Spark-Concepts/xPro-V5/images/Spark-Concepts-6.png

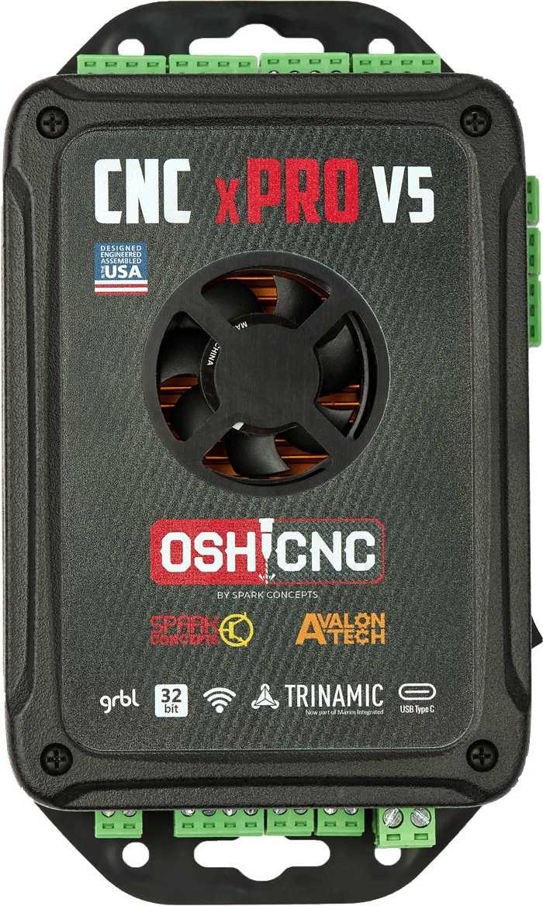
images/Spark-Concepts-6.png
