Spark-Concepts/xPro-V5/images/Hall_limits_wiring.jpg

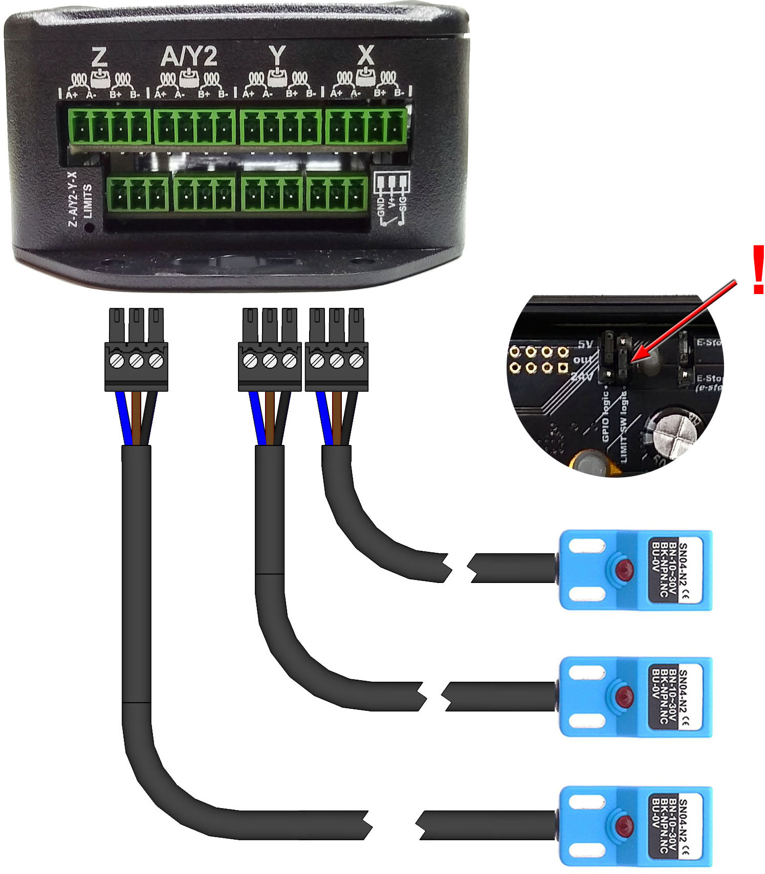
images/Hall_limits_wiring.jpg
