Spark-Concepts/xPro-V5/README.md

# xPro-V5
xPro-V5 CNC Motion Control System Documentation and User Information
theme: jekyll-theme-slate
