Spark-Concepts/xPro-V5/Firmware/Old Firmware/flash_download_tool/Programming ESP32 chip.pdf

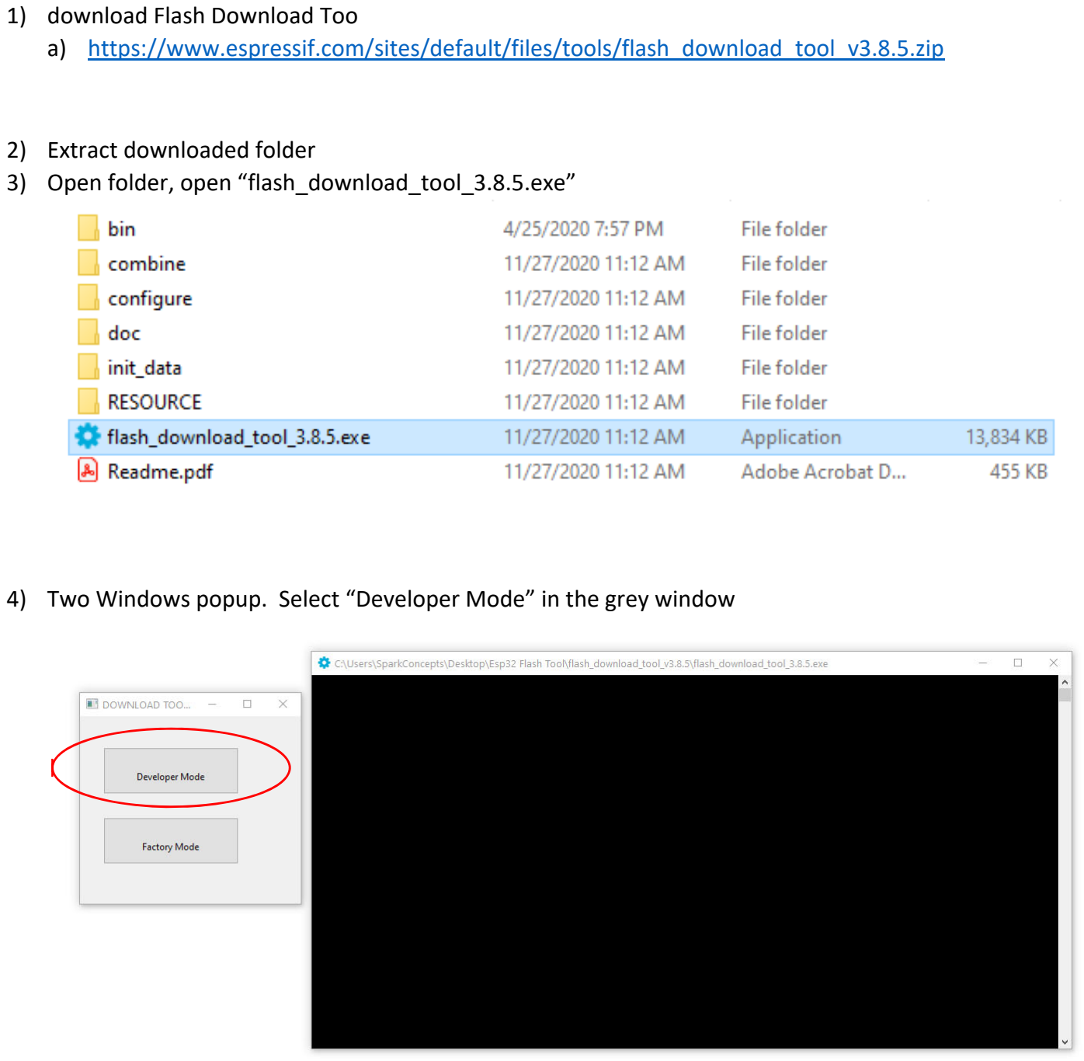
[picture p3: page 1]

1) download Flash Download Too
a) https://www.espressif.com/sites/default/files/tools/flash_download_tool_v3.8.5.zip
2) Extract downloaded folder
3) Open folder, open “flash_download_tool_3.8.5.exe”
4) Two Windows popup. Select “Developer Mode” in the grey window

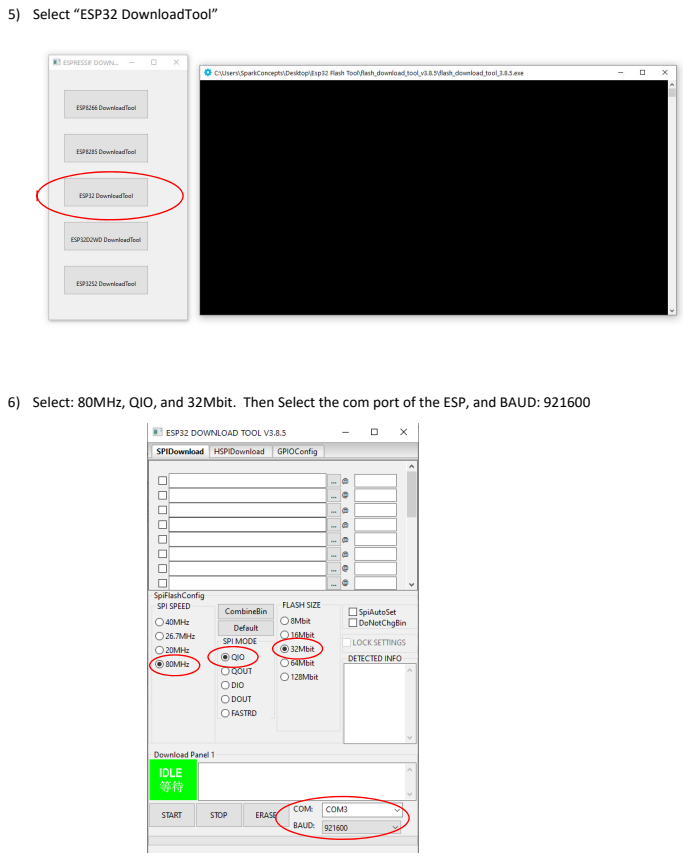
[picture p4: page 2]
5) Select “ESP32 DownloadTool”

6) Select: 80MHz, QIO, and 32Mbit. Then Select the com port of the ESP, and BAUD: 921600

7) Click the button shown here below and select the xPV5xyyz.bin file. Click on the empty field to the right of the @ sign and write 0. Make sure the check box next to the file name is marked, otherwise the file won’t be programmed.

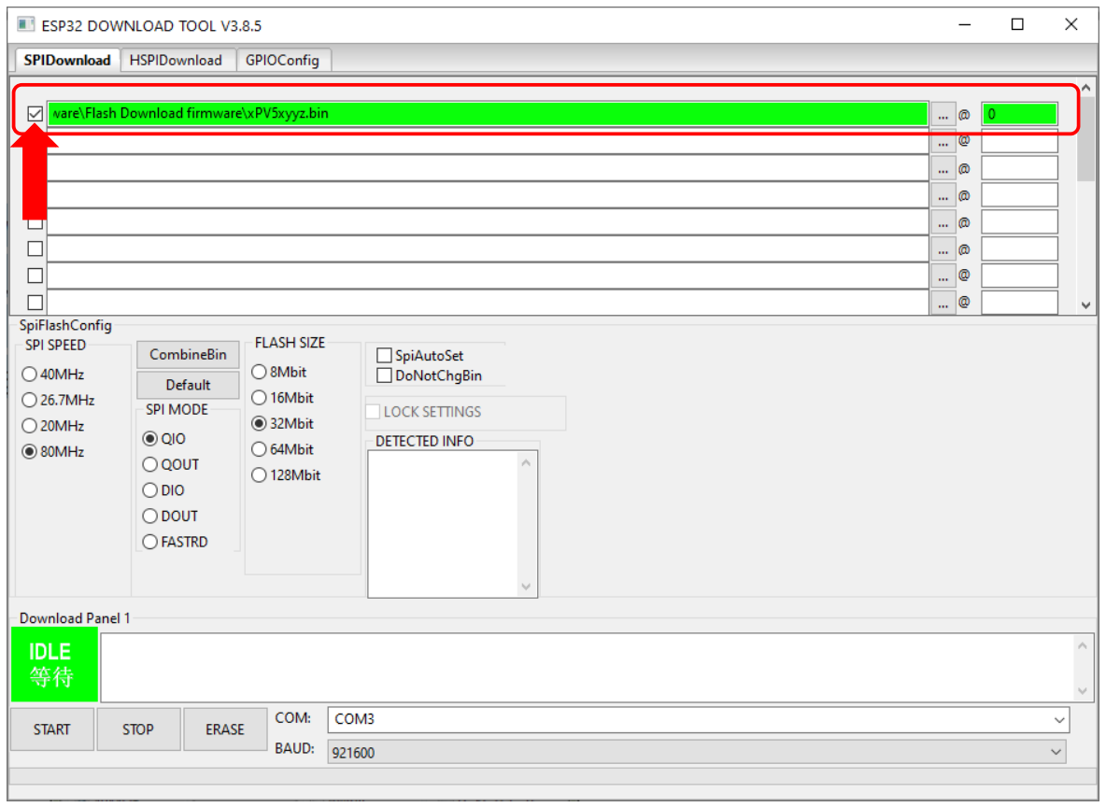
[picture p5: figure]
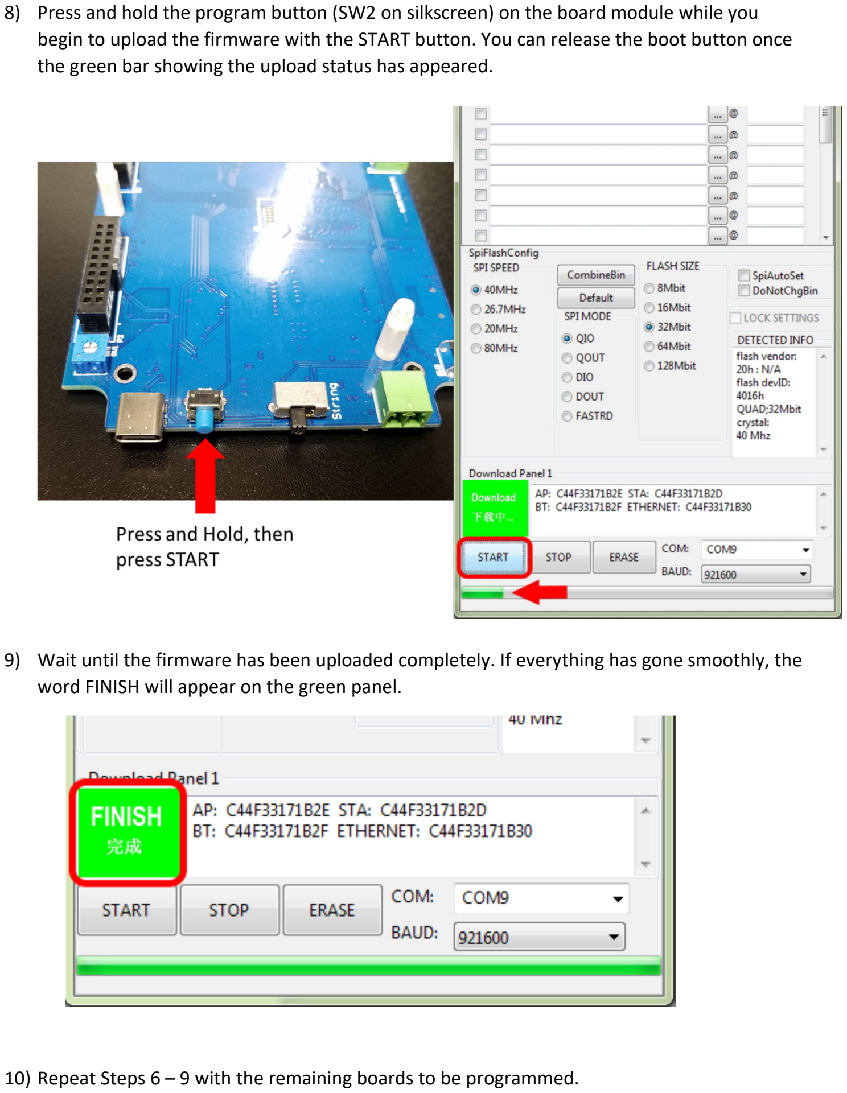
[picture p6: page 4]

8) Press and hold the program button (SW2 on silkscreen) on the board module while you begin to upload the firmware with the START button. You can release the boot button once the green bar showing the upload status has appeared.
9) Wait until the firmware has been uploaded completely. If everything has gone smoothly, the word FINISH will appear on the green panel.
10) Repeat Steps 6 – 9 with the remaining boards to be programmed.
