Spark-Concepts/xPro-V5/images/0-10v.jpg

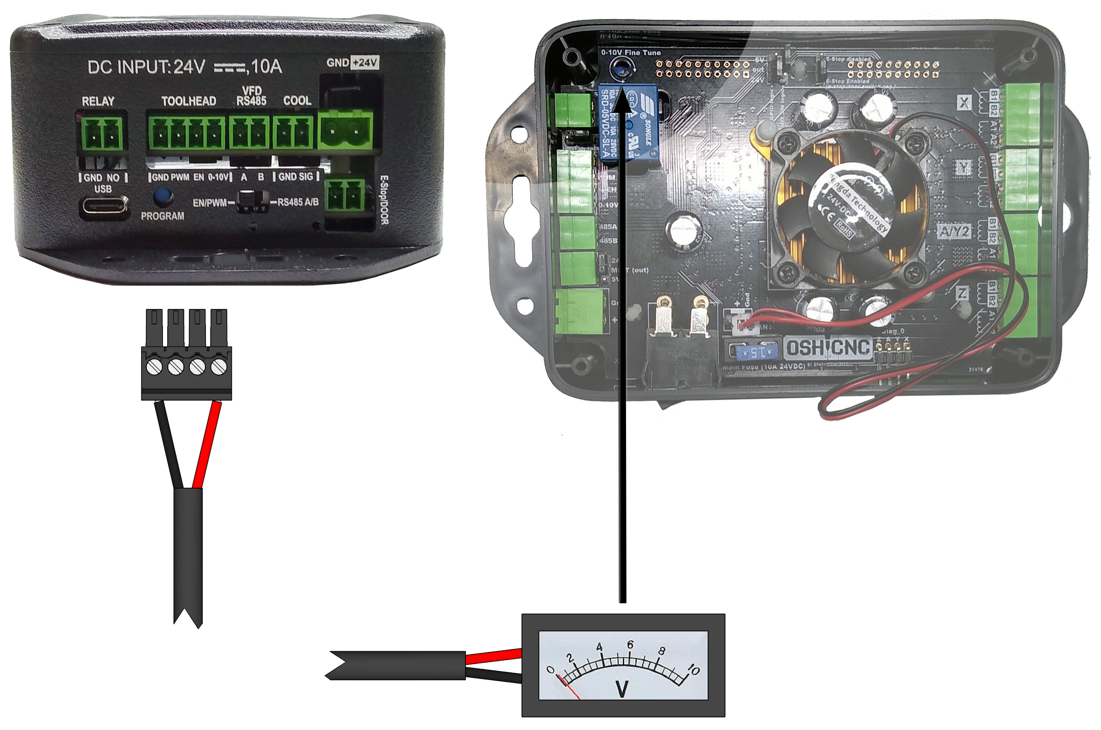
images/0-10v.jpg
