Spark-Concepts/xPro-V5/images/Analog_VFD.jpg

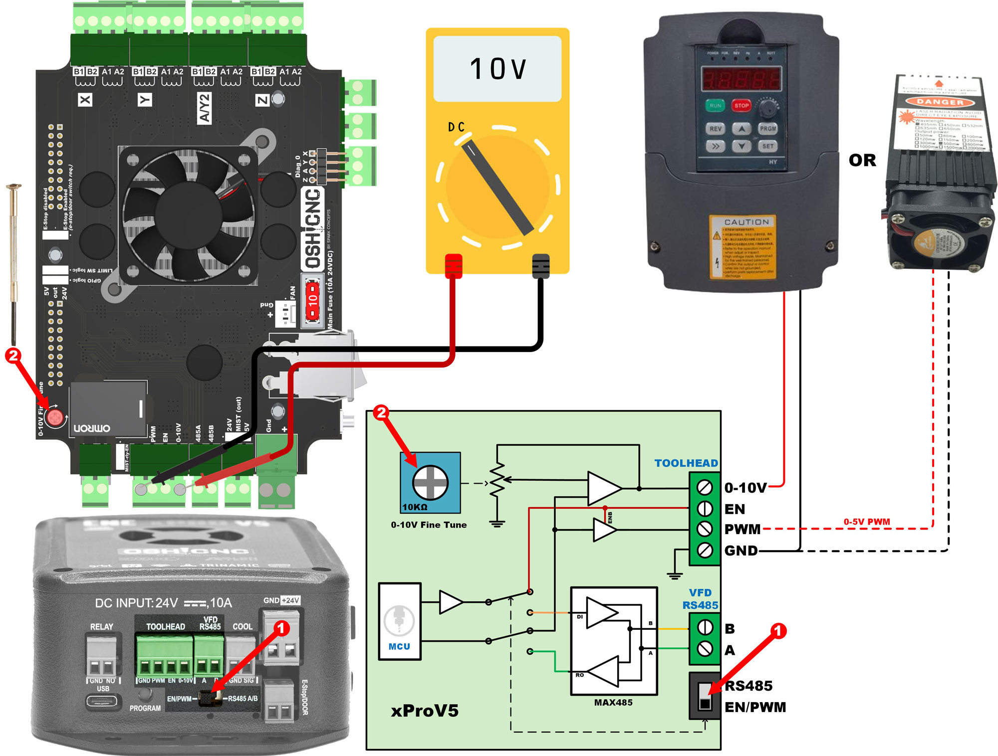
images/Analog_VFD.jpg
