Spark-Concepts/xPro-V5/images/BootlaoderMode.jpg

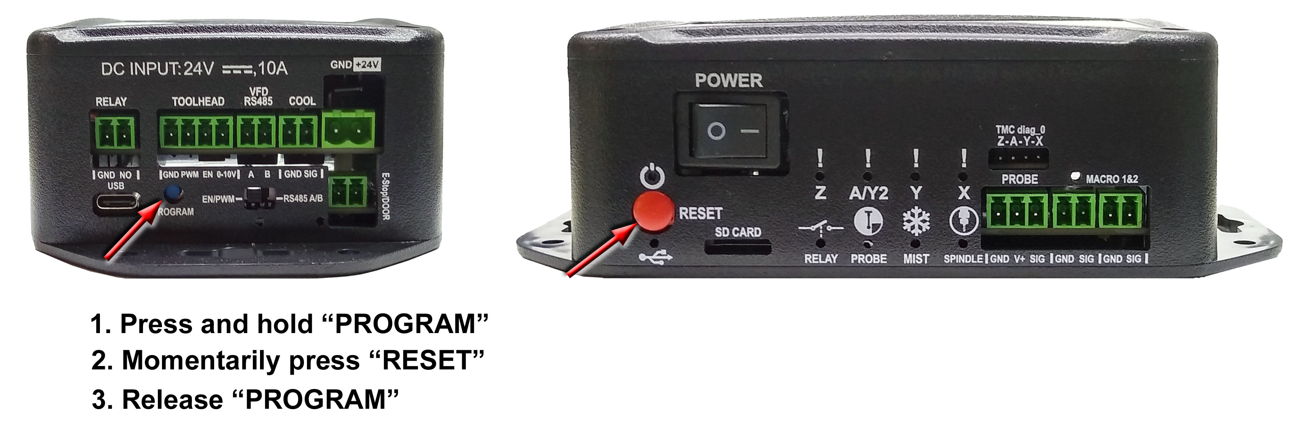
images/BootlaoderMode.jpg
