Spark-Concepts/xPro-V5/images/cncjs-overview-1.jpg

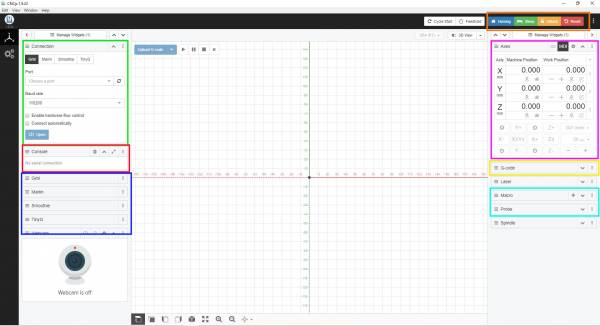
images/cncjs-overview-1.jpg
