Spark-Concepts/xPro-V5/images/cncjs_-_machine_sel.jpg

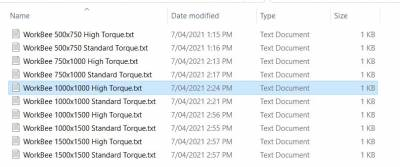
images/cncjs_-_machine_sel.jpg
