Spark-Concepts/xPro-V5/images/cncjs_-_widget_remove.jpg

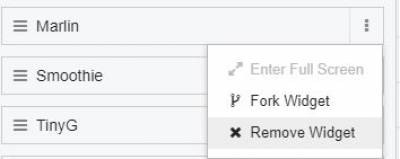
images/cncjs_-_widget_remove.jpg
