Spark-Concepts/xPro-V5/images/cncjs_-xpro-v5_master_config.jpg

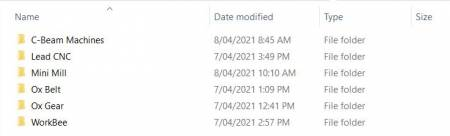
images/cncjs_-xpro-v5_master_config.jpg
