Spark-Concepts/xPro-V5/images/cncjs_connect_port.jpg

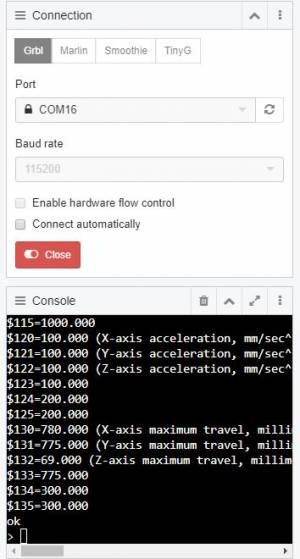
images/cncjs_connect_port.jpg
