Spark-Concepts/xPro-V5/images/cncjs_finish_macro.png

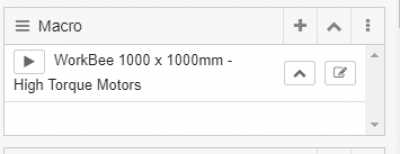
images/cncjs_finish_macro.png
