Spark-Concepts/xPro-V5/images/cncjs_refresh_port.jpg

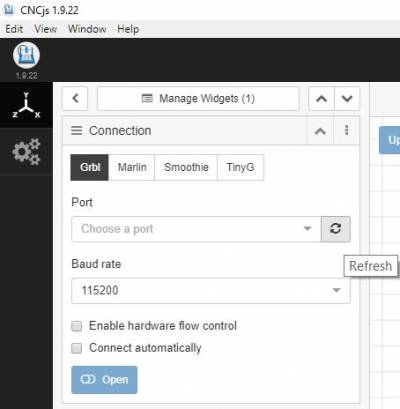
images/cncjs_refresh_port.jpg
