Spark-Concepts/xPro-V5/images/cncjs_run_macro.png

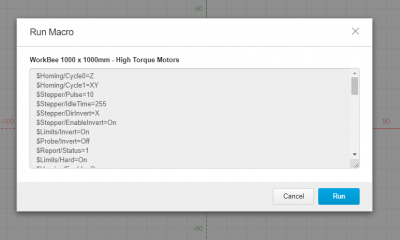
images/cncjs_run_macro.png
