Spark-Concepts/xPro-V5/images/cncjs_select_contents.png

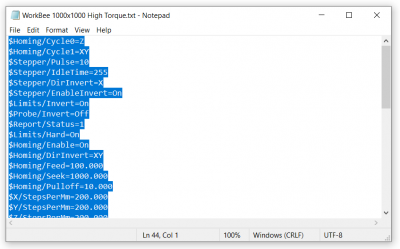
images/cncjs_select_contents.png
