Spark-Concepts/xPro-V5/images/cncjs_select_port.jpg

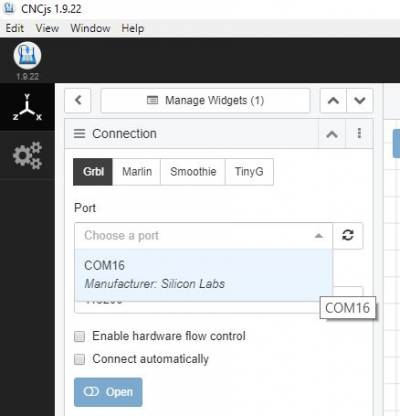
images/cncjs_select_port.jpg
