Spark-Concepts/xPro-V5/images/cncjs_successful_flash.png

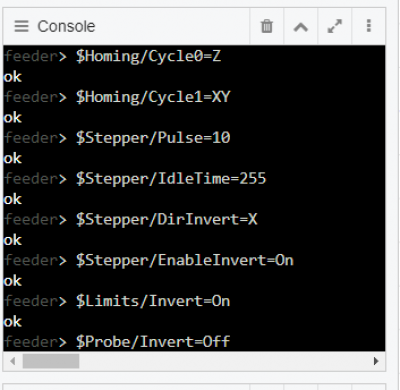
images/cncjs_successful_flash.png
