Spark-Concepts/xPro-V5/images/Cool_SS.jpg

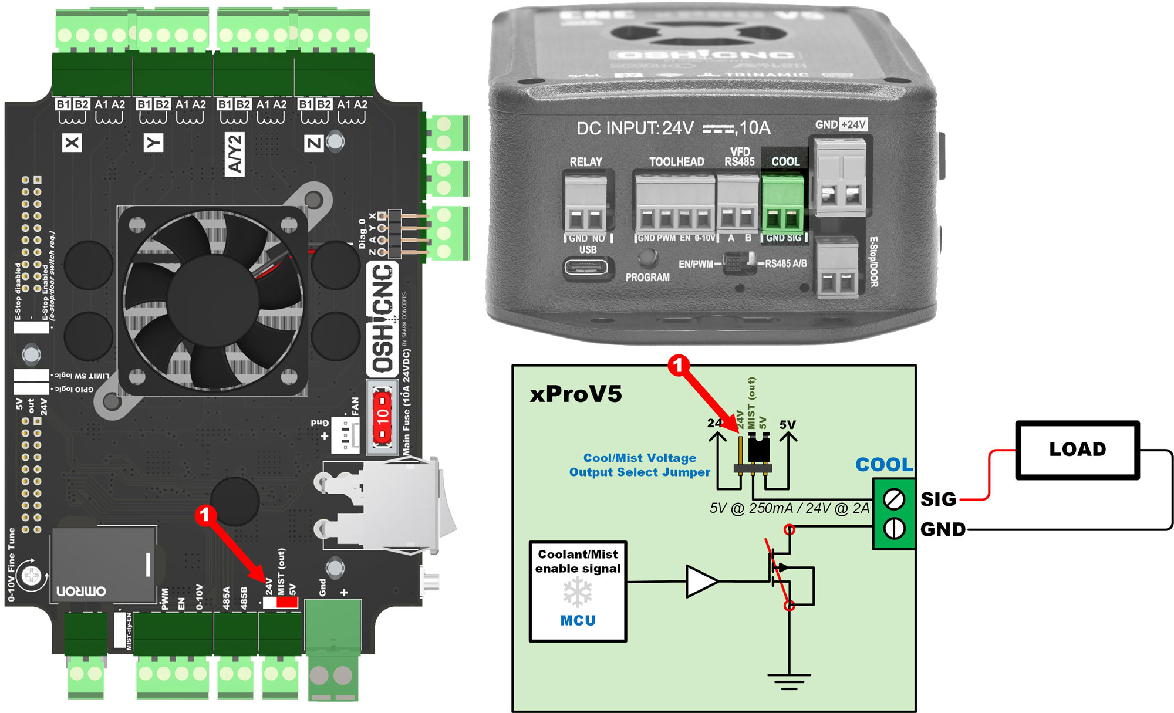
images/Cool_SS.jpg
