Spark-Concepts/xPro-V5/images/coolant-iot-vacuum.jpg

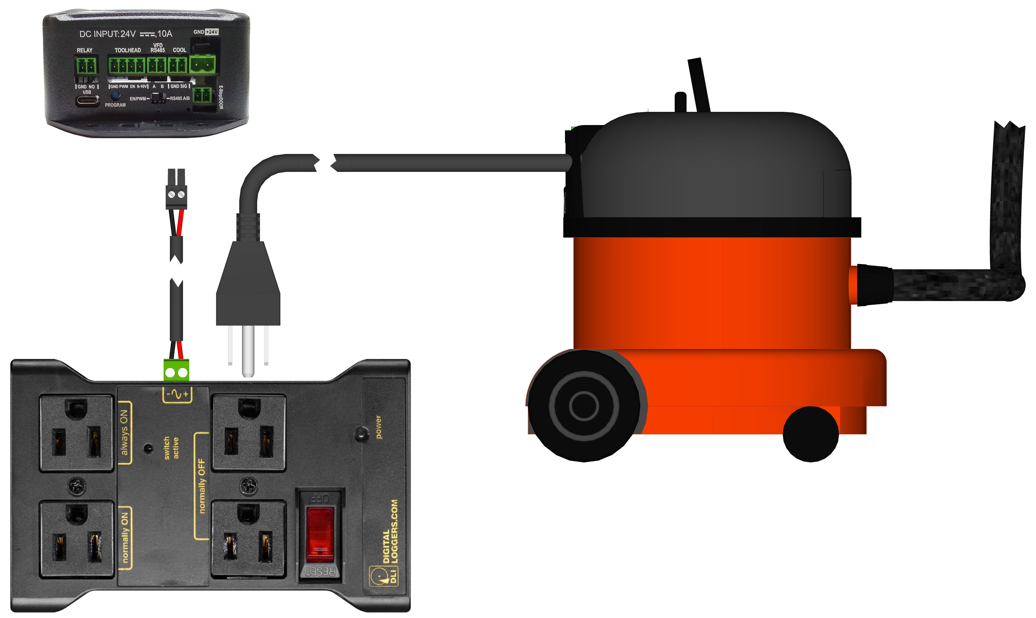
images/coolant-iot-vacuum.jpg
