Spark-Concepts/xPro-V5/images/coolant-led-ring.jpg

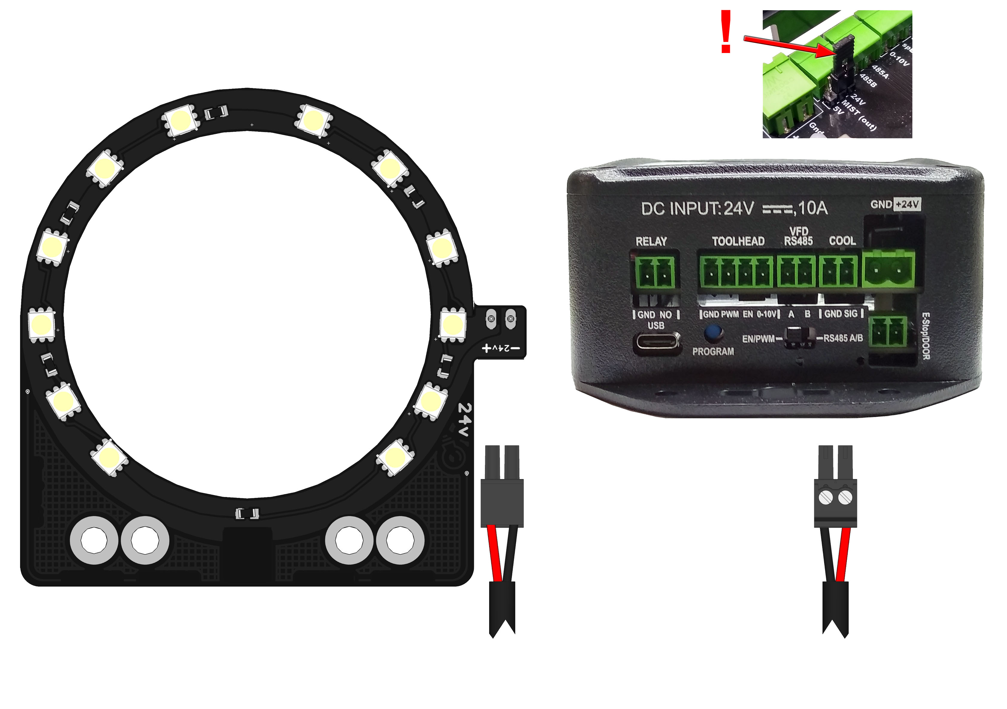
images/coolant-led-ring.jpg
