Spark-Concepts/xPro-V5/images/coolant-solenoid.jpg

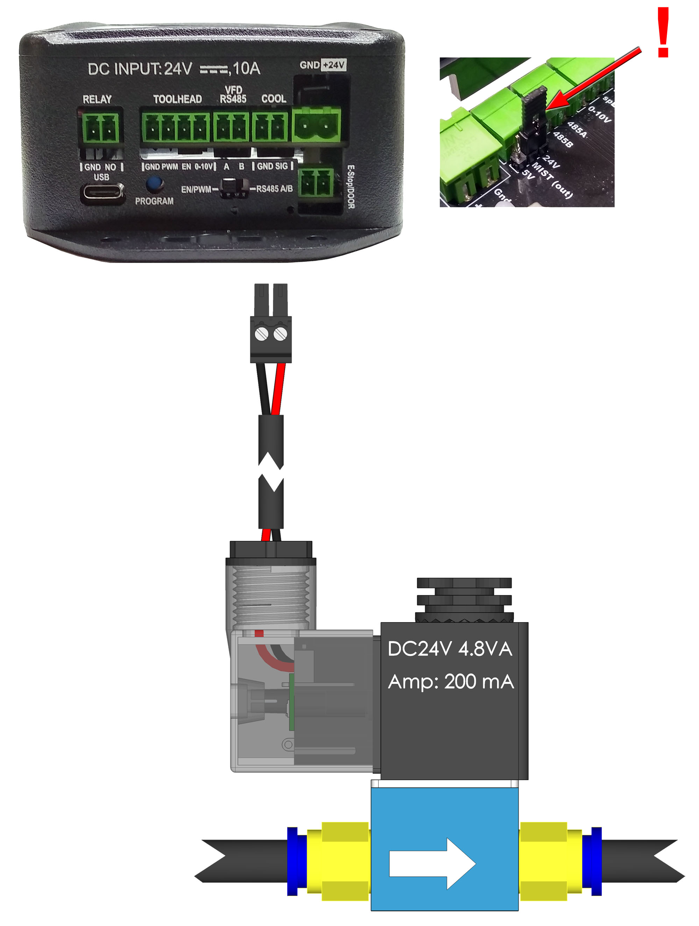
images/coolant-solenoid.jpg
