Spark-Concepts/xPro-V5/images/End copy.jpg

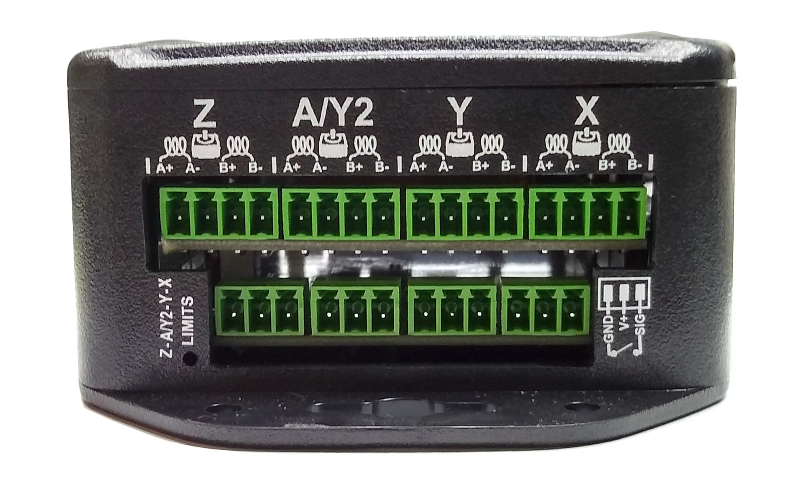
images/End copy.jpg
