Spark-Concepts/xPro-V5/images/Front copy.jpg

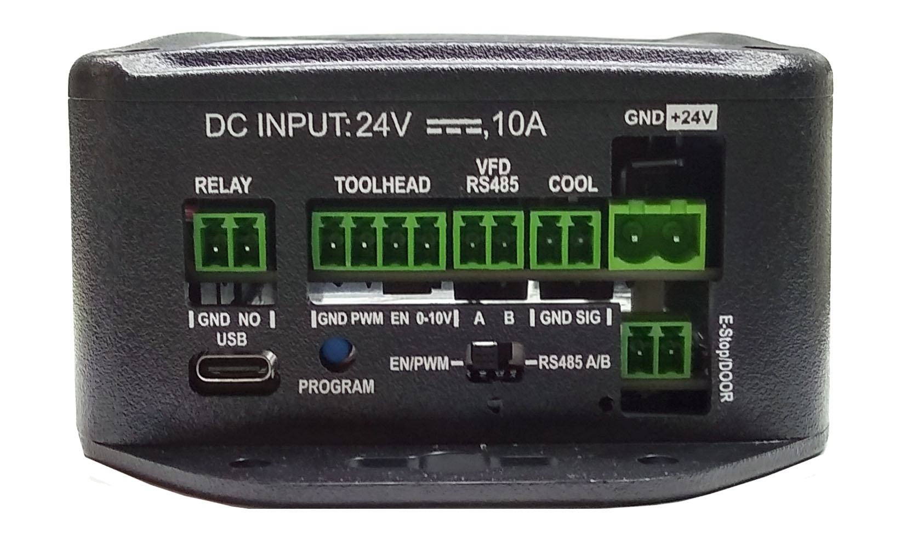
images/Front copy.jpg
