Spark-Concepts/xPro-V5/images/Front-plugs.jpg

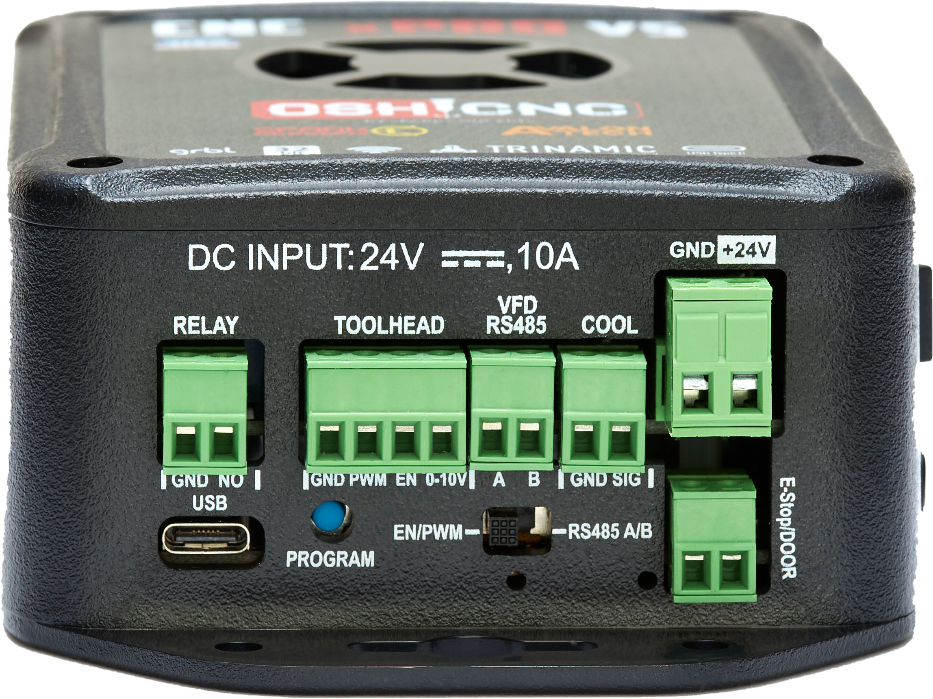
images/Front-plugs.jpg
