Spark-Concepts/xPro-V5/images/Front-plugs_Prog.jpg

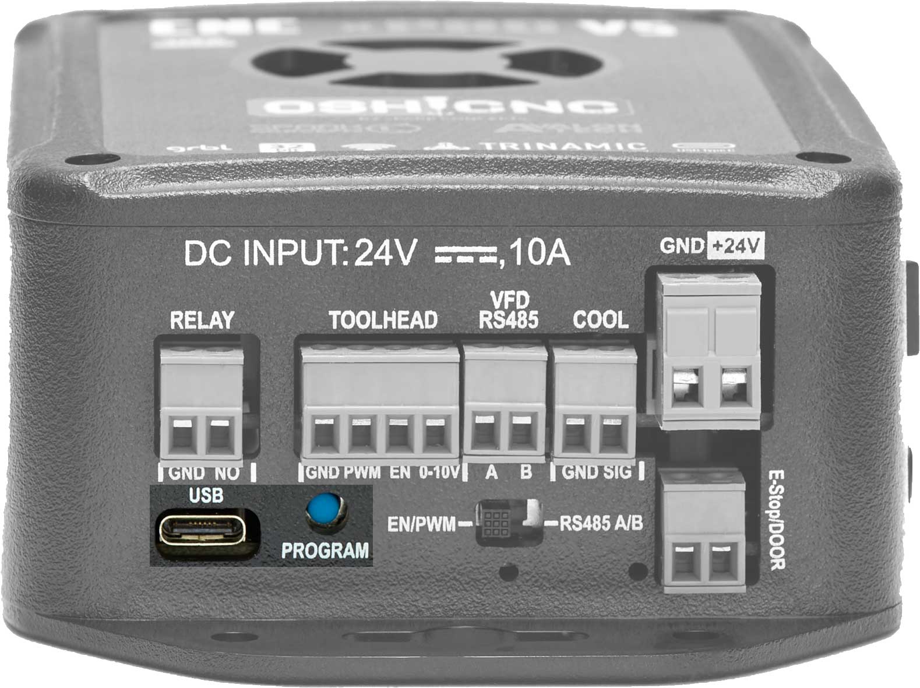
images/Front-plugs_Prog.jpg
