Spark-Concepts/xPro-V5/images/GPIO_plugs.jpg

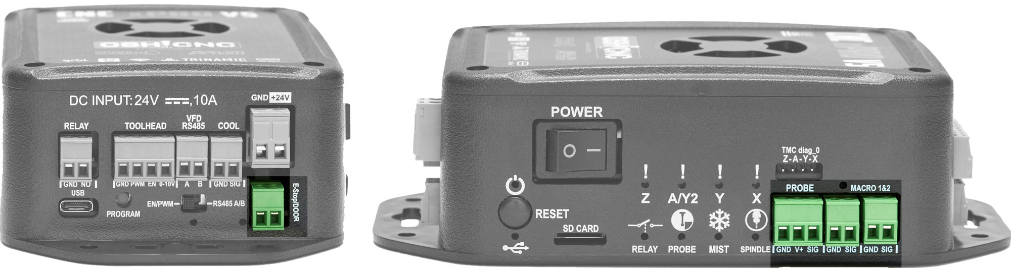
images/GPIO_plugs.jpg
