Spark-Concepts/xPro-V5/images/iotrelay.jpg

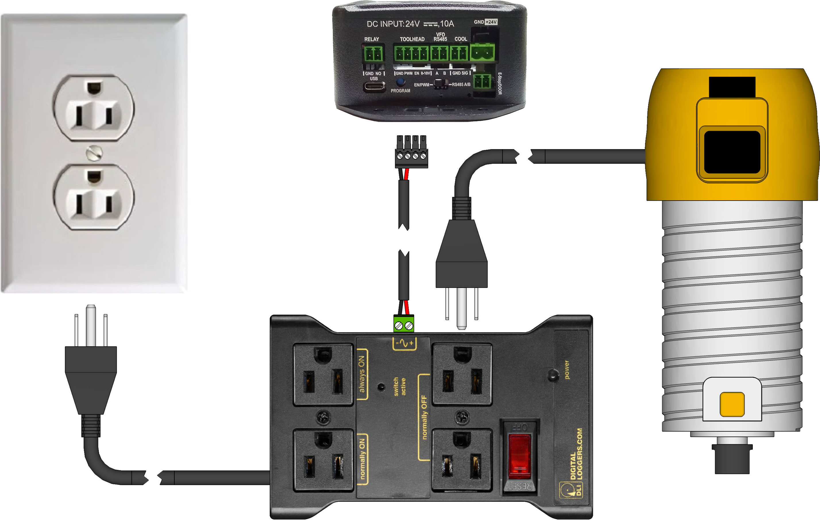
images/iotrelay.jpg
