Spark-Concepts/xPro-V5/images/LasPWM_1.jpg

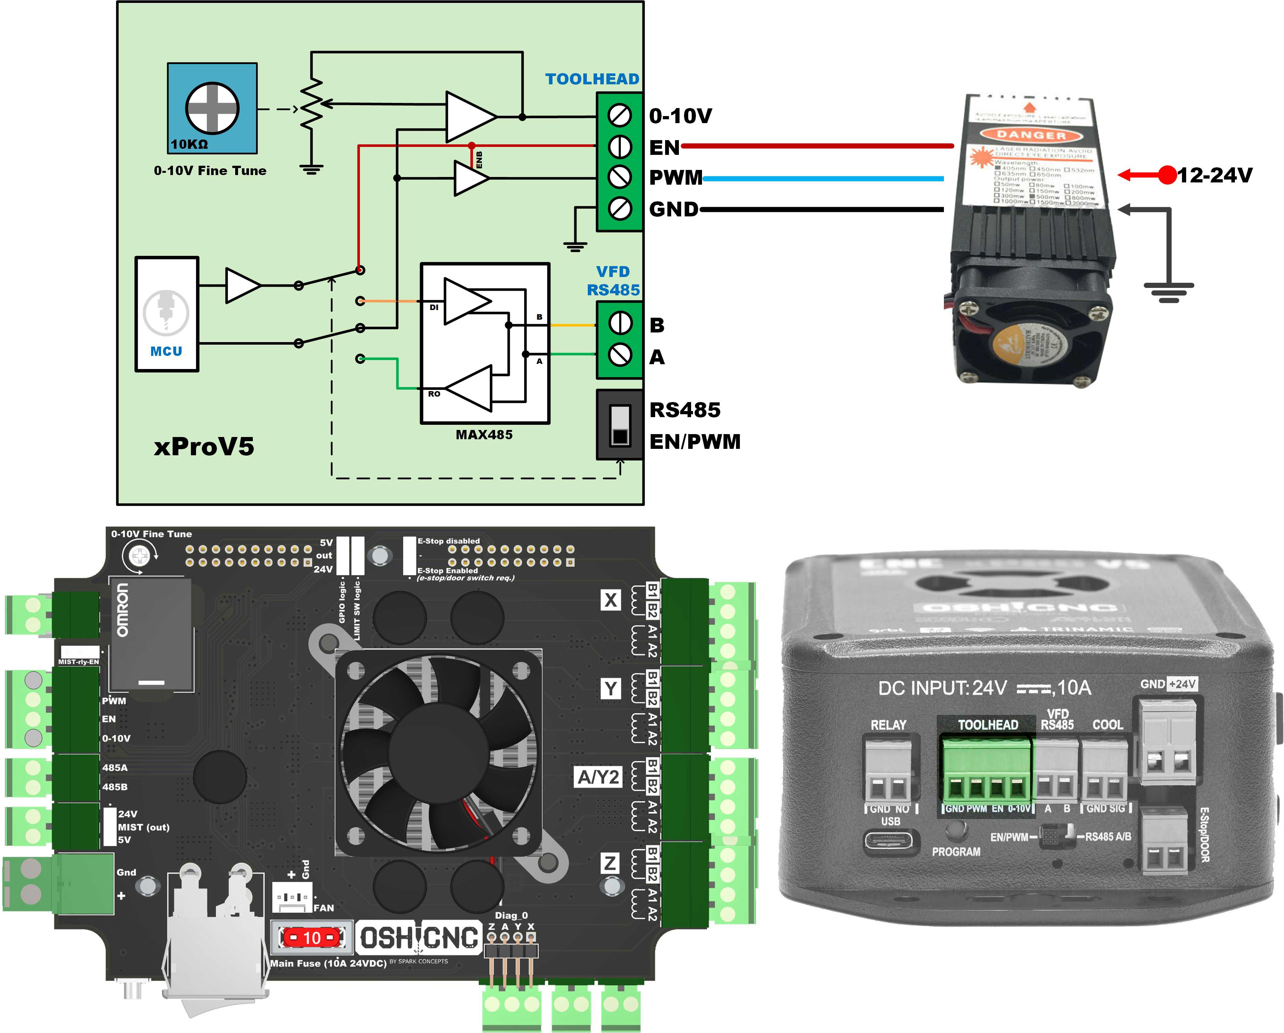
images/LasPWM_1.jpg
