Spark-Concepts/xPro-V5/images/LasPWM_2.jpg

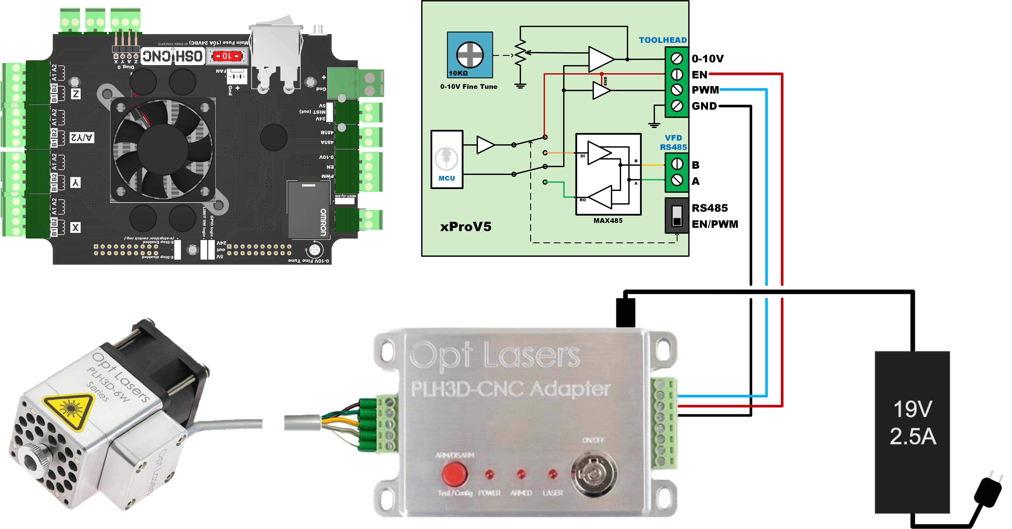
images/LasPWM_2.jpg
