Spark-Concepts/xPro-V5/images/LasPWM_3.jpg

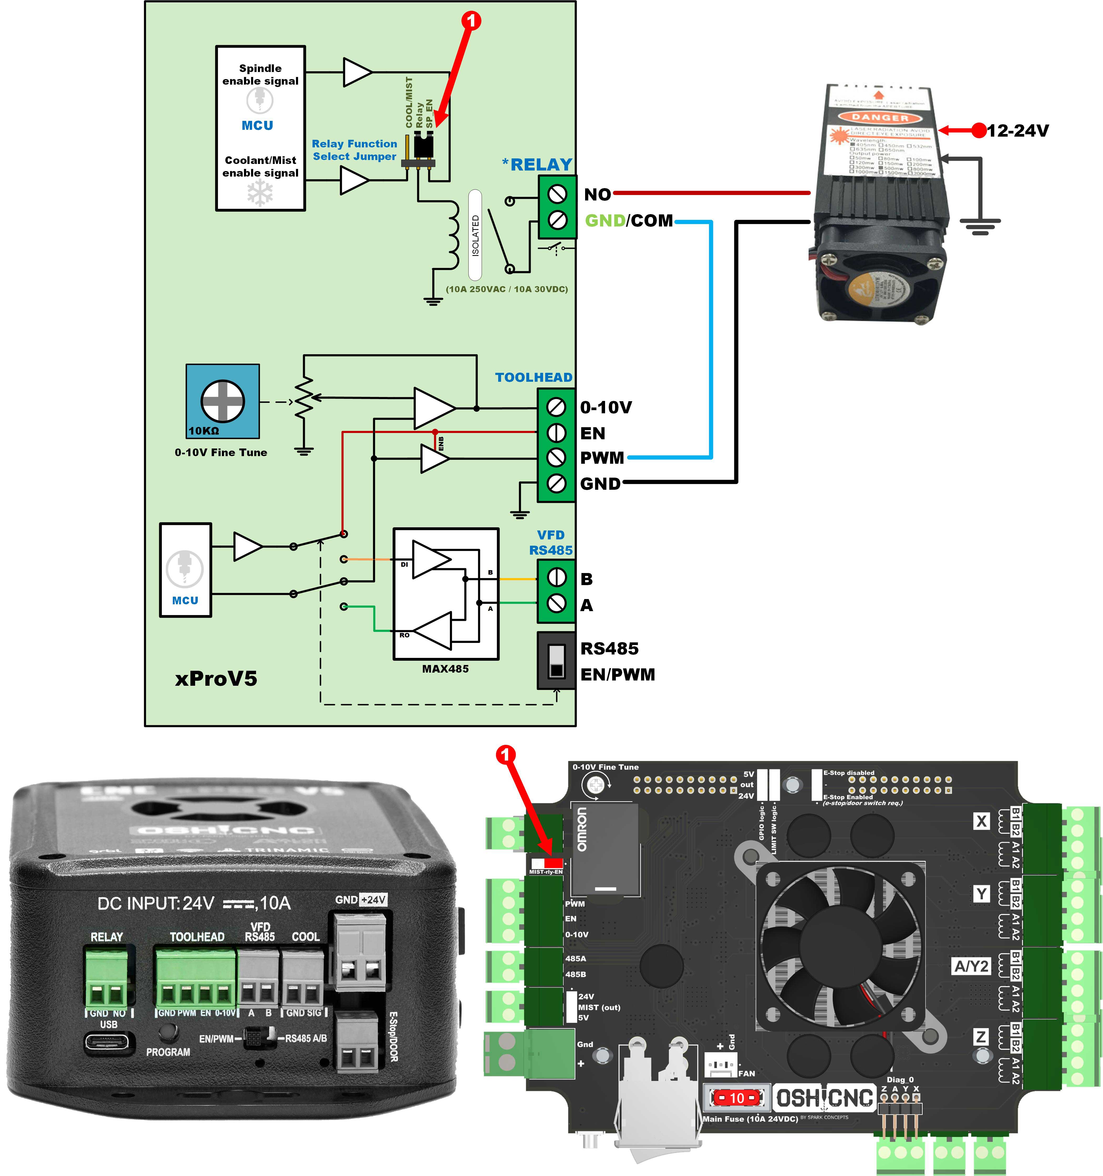
images/LasPWM_3.jpg
