Spark-Concepts/xPro-V5/images/Limit_Switch_Mech.jpg

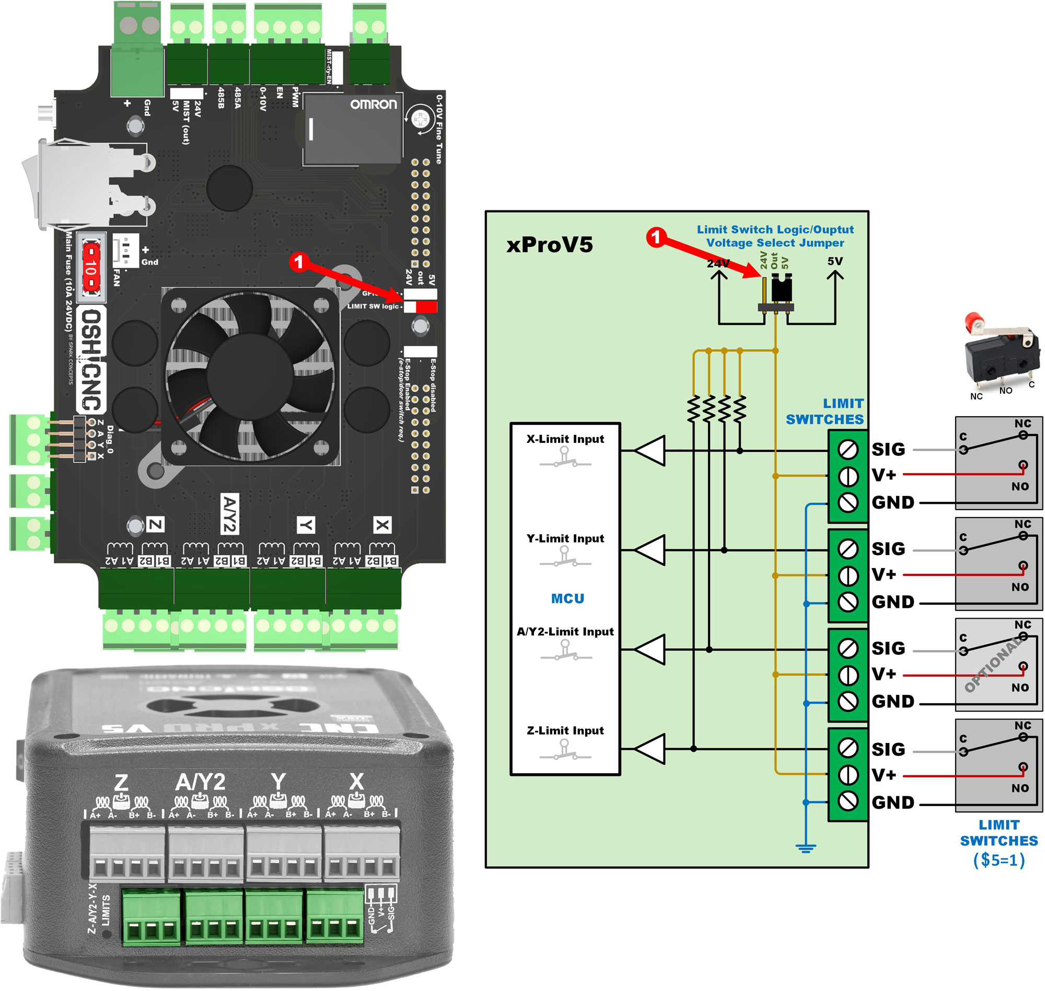
images/Limit_Switch_Mech.jpg
