Spark-Concepts/xPro-V5/images/Limit_Switch_SS.jpg

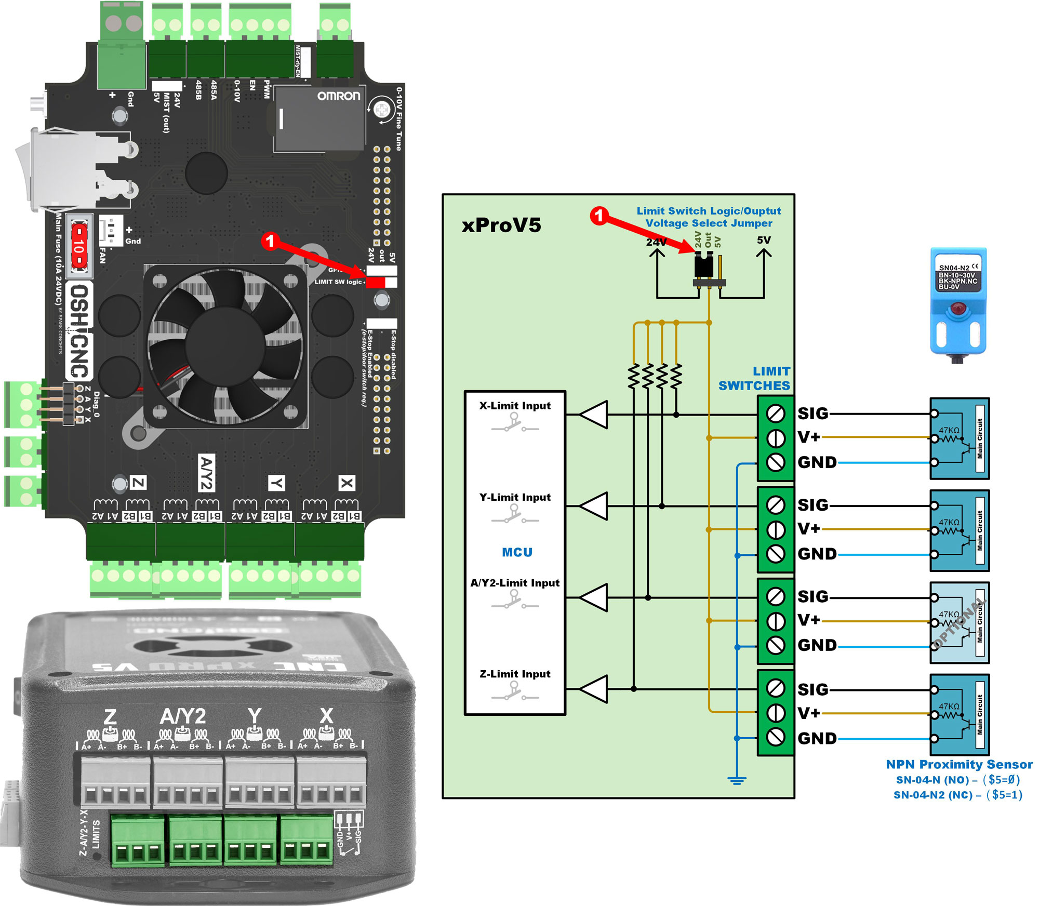
images/Limit_Switch_SS.jpg
