Spark-Concepts/xPro-V5/images/limit_wire.jpg

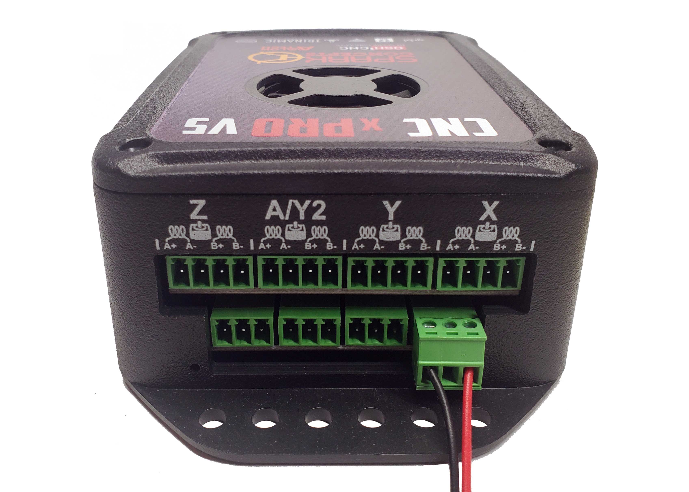
images/limit_wire.jpg
