Spark-Concepts/xPro-V5/images/login_err.png

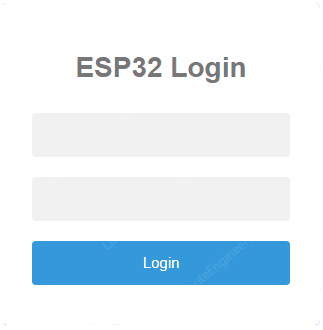
images/login_err.png
