Spark-Concepts/xPro-V5/images/meanwell-psu.png

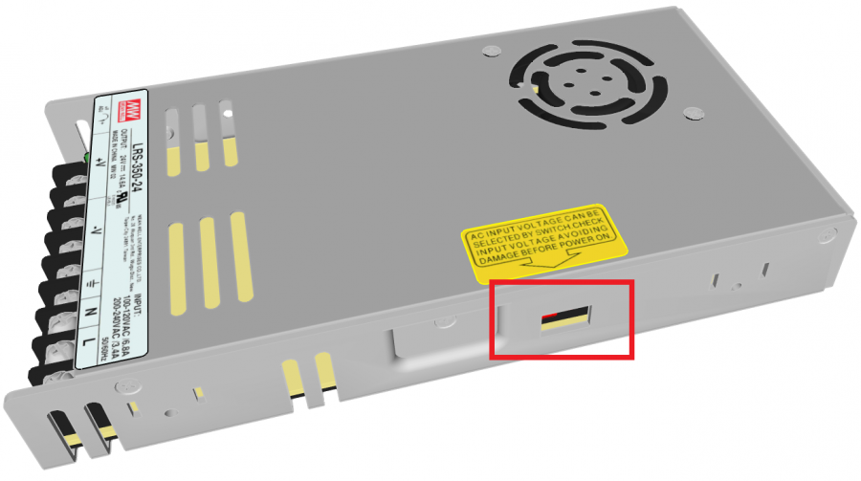
images/meanwell-psu.png
