Spark-Concepts/xPro-V5/images/meanwell.jpg

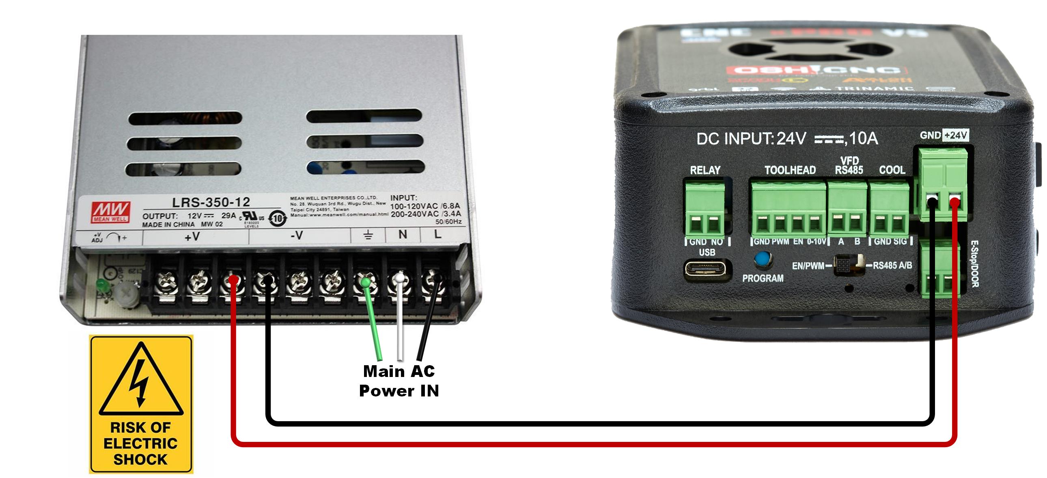
images/meanwell.jpg
