Spark-Concepts/xPro-V5/images/NC_Estop.jpg

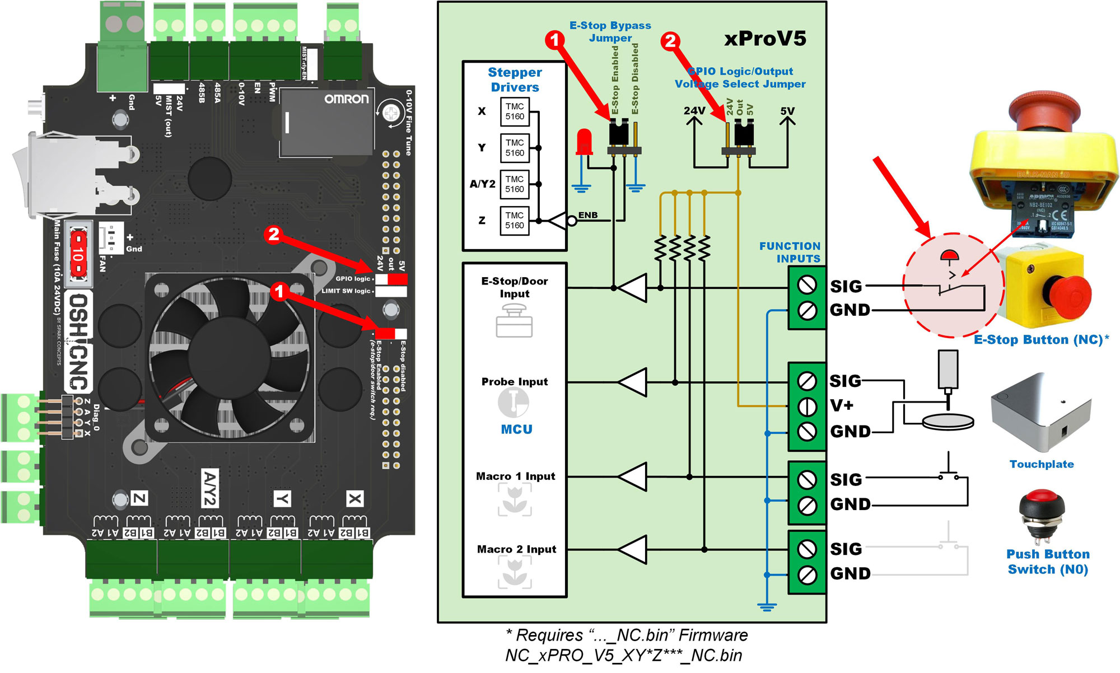
images/NC_Estop.jpg
