Spark-Concepts/xPro-V5/images/nema23-reversed-y2.jpg

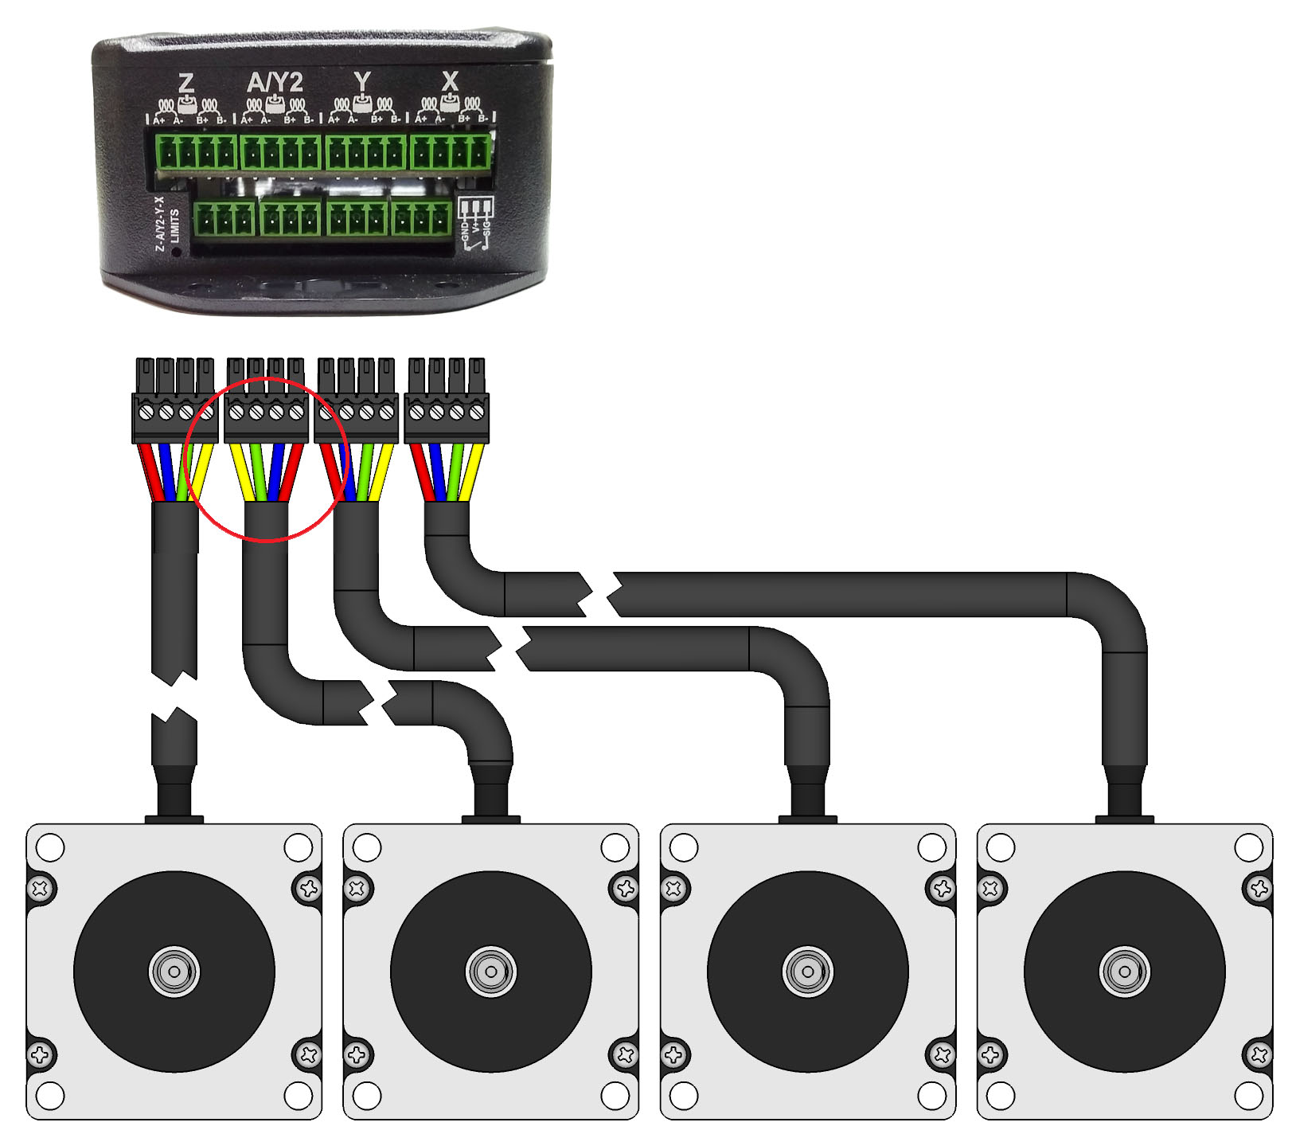
images/nema23-reversed-y2.jpg
