Spark-Concepts/xPro-V5/images/NO_Estop.jpg

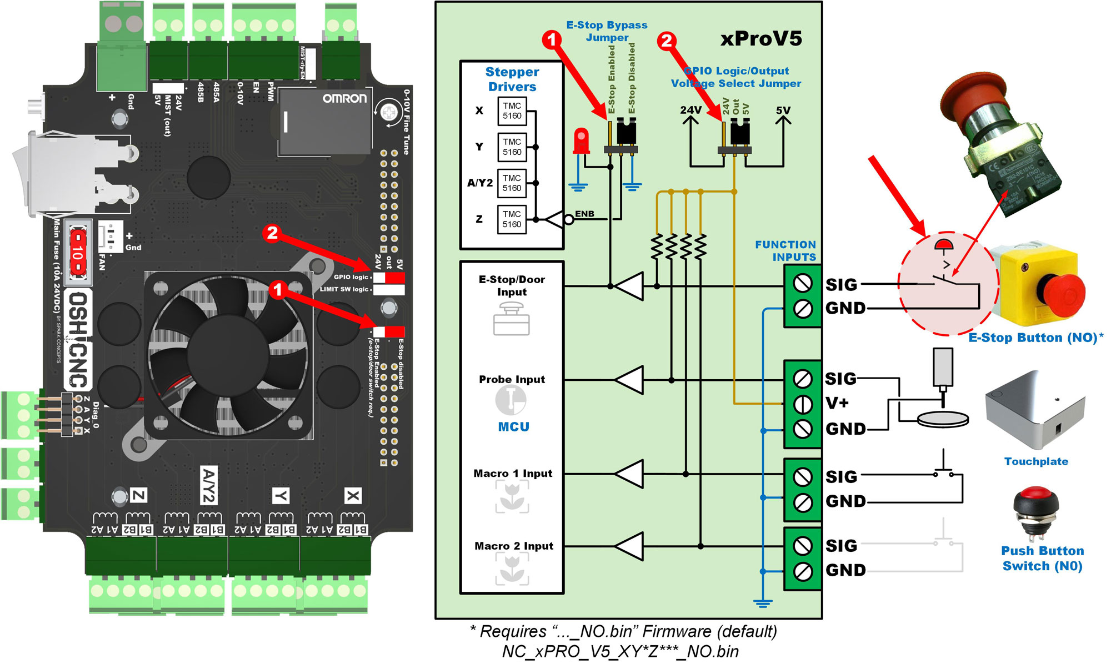
images/NO_Estop.jpg
