Spark-Concepts/xPro-V5/images/OTA1.png

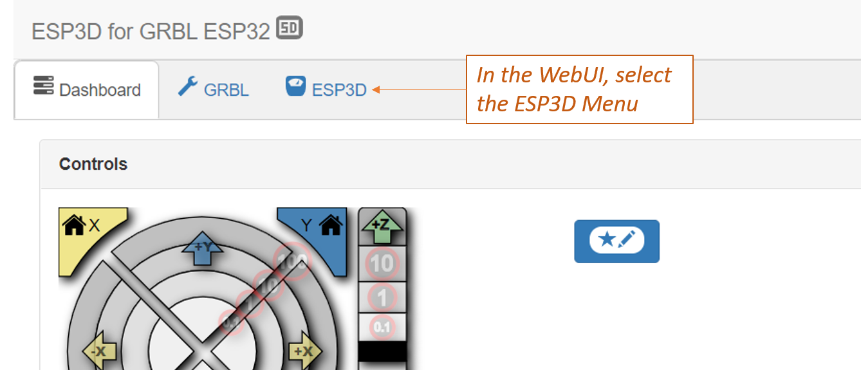
images/OTA1.png
