Spark-Concepts/xPro-V5/images/OTA2.png

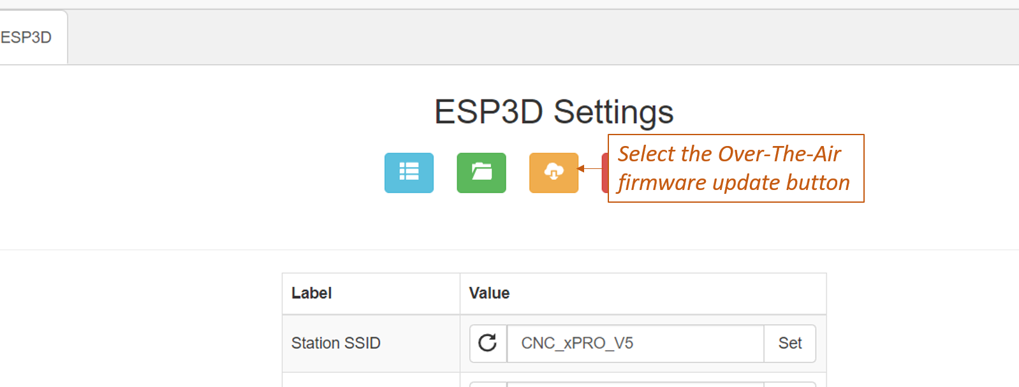
images/OTA2.png
