Spark-Concepts/xPro-V5/images/OTA3.png

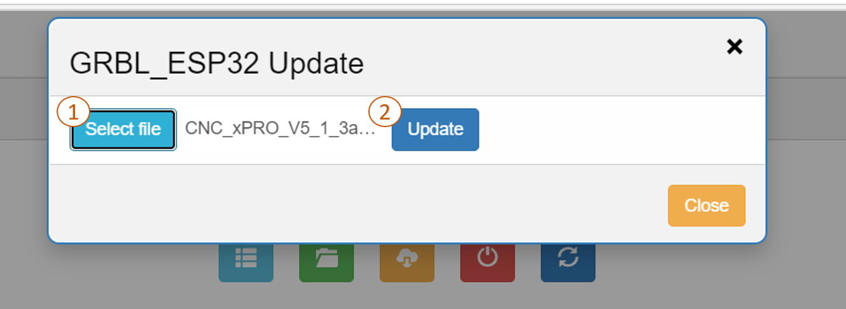
images/OTA3.png
