Spark-Concepts/xPro-V5/images/probe_non-powered.jpg

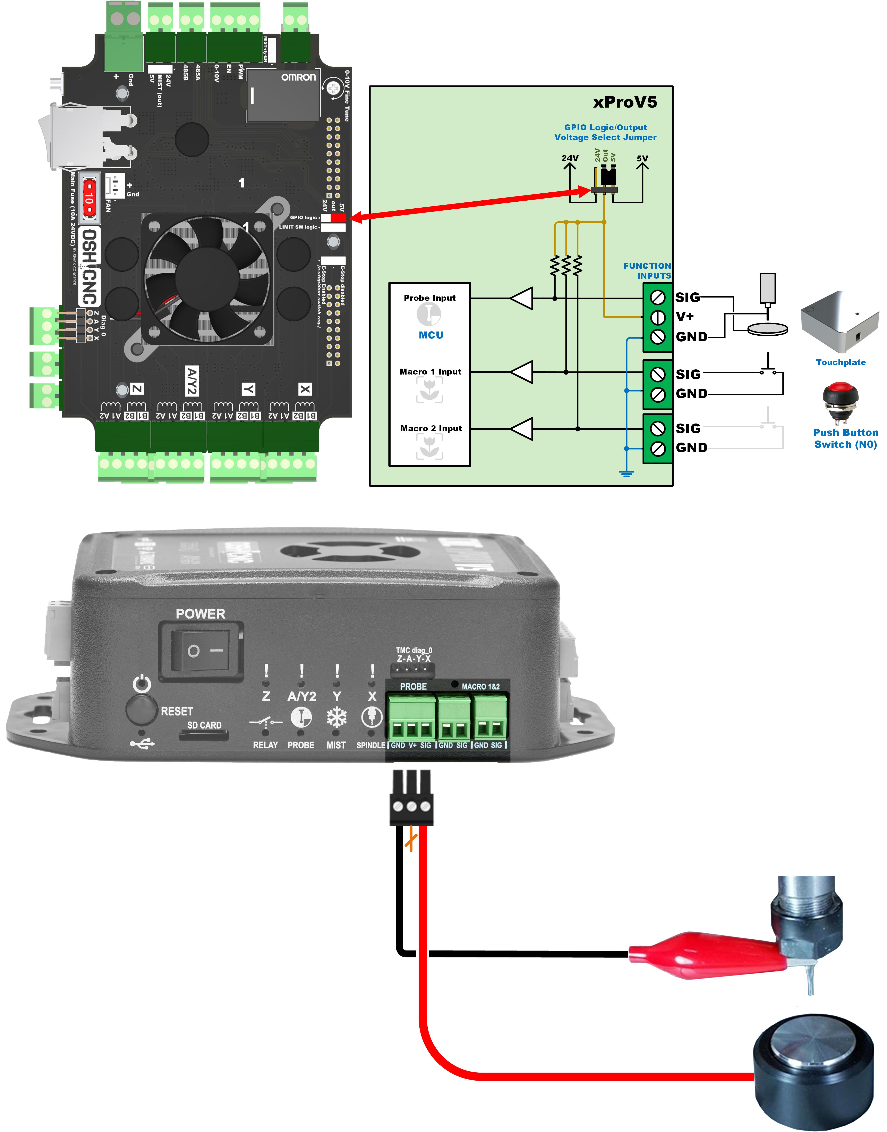
images/probe_non-powered.jpg
