Spark-Concepts/xPro-V5/images/probe_powered.jpg

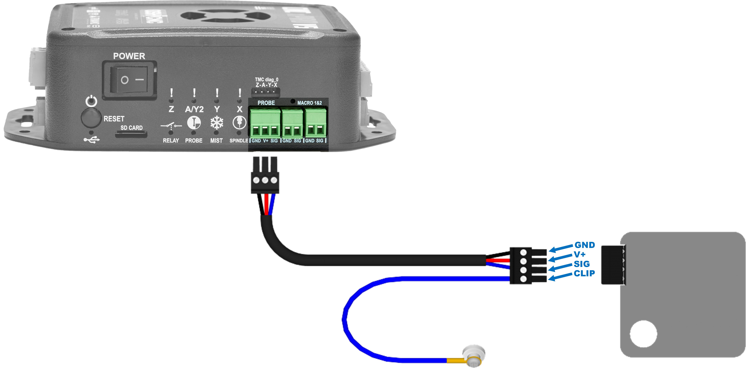
images/probe_powered.jpg
