Spark-Concepts/xPro-V5/images/probe_wire.jpg

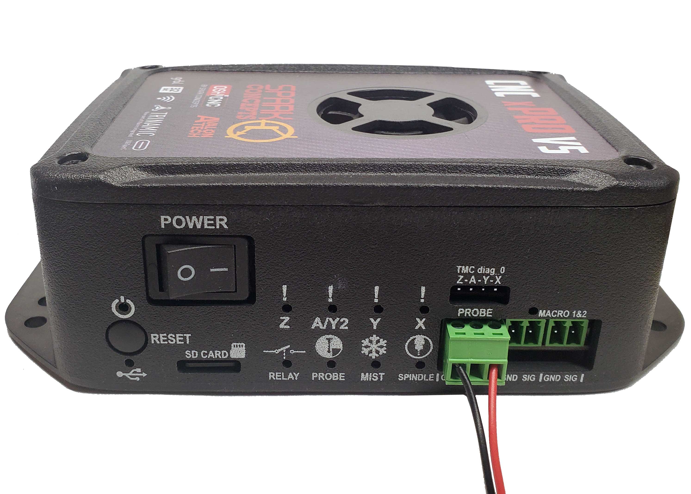
images/probe_wire.jpg
