Spark-Concepts/xPro-V5/images/QuickStart_FRONT.jpg

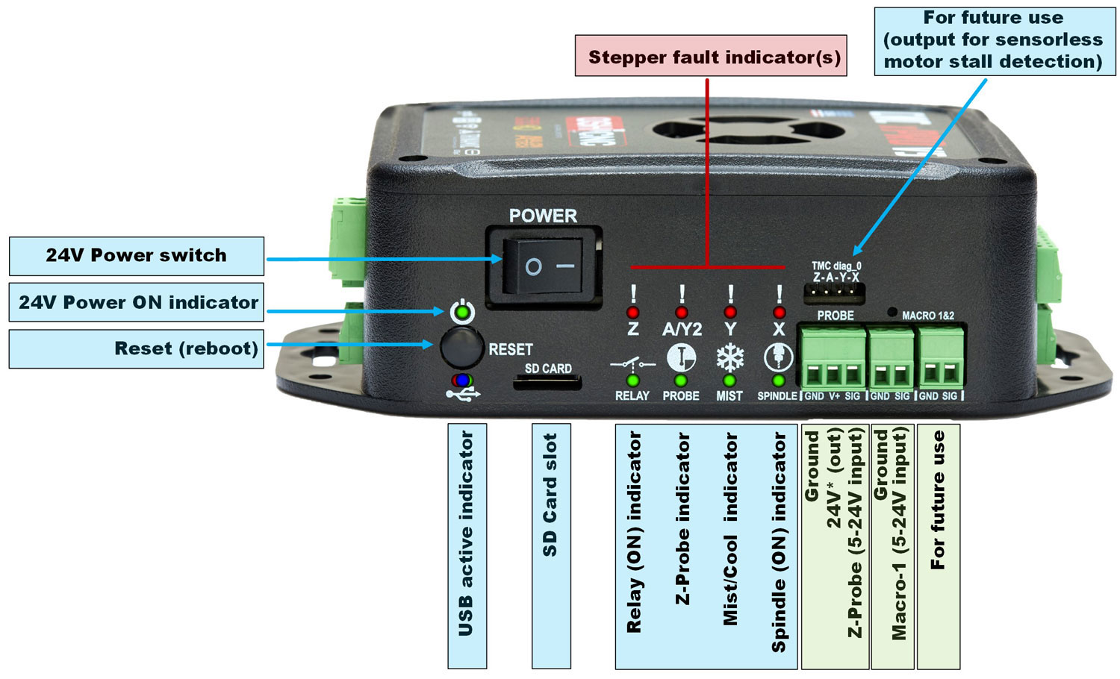
images/QuickStart_FRONT.jpg
