Spark-Concepts/xPro-V5/images/Rear-plgs.jpg

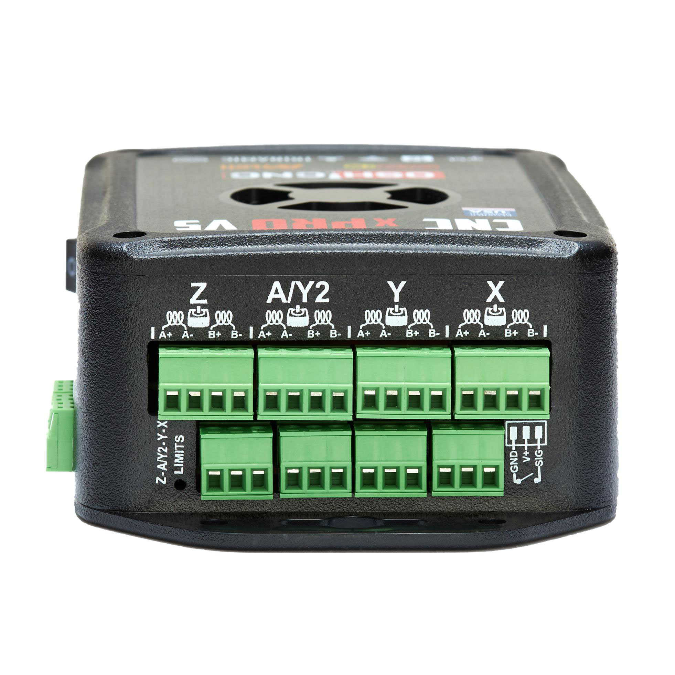
images/Rear-plgs.jpg
