Spark-Concepts/xPro-V5/images/regular-microswitches.jpg

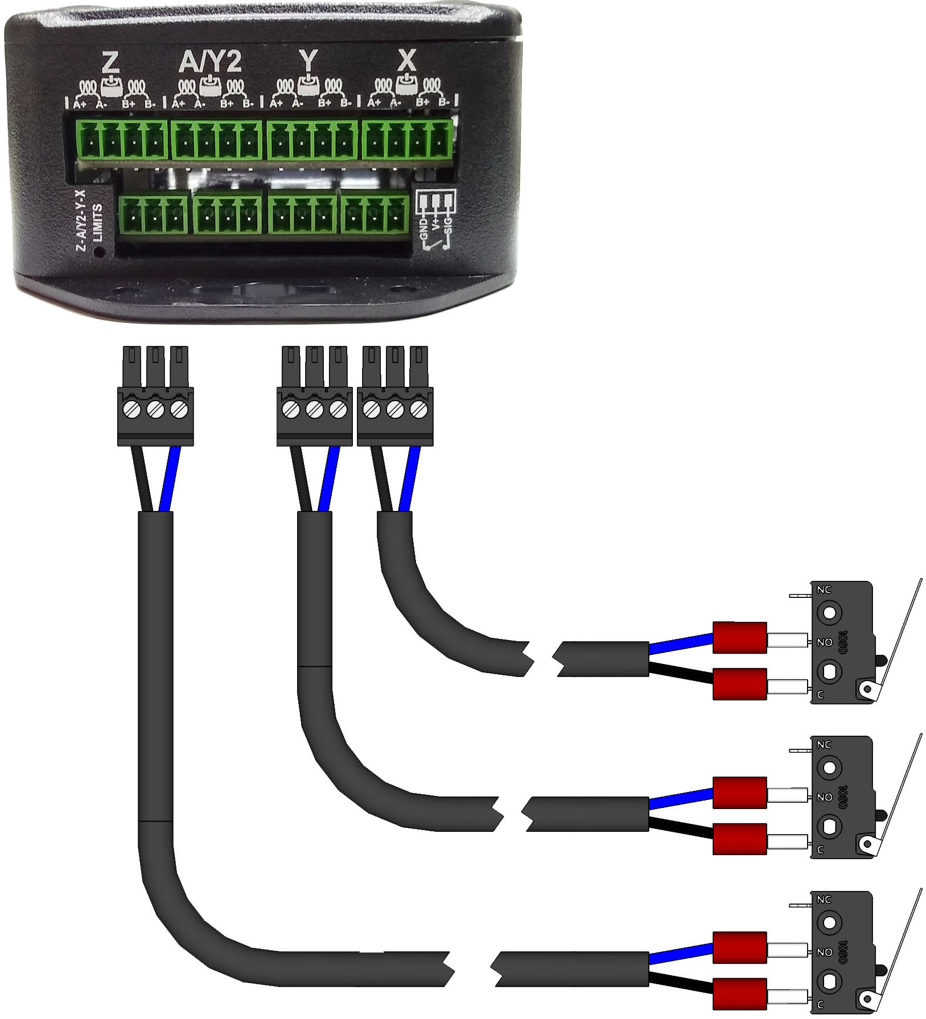
images/regular-microswitches.jpg
