Spark-Concepts/xPro-V5/images/Relay.jpg

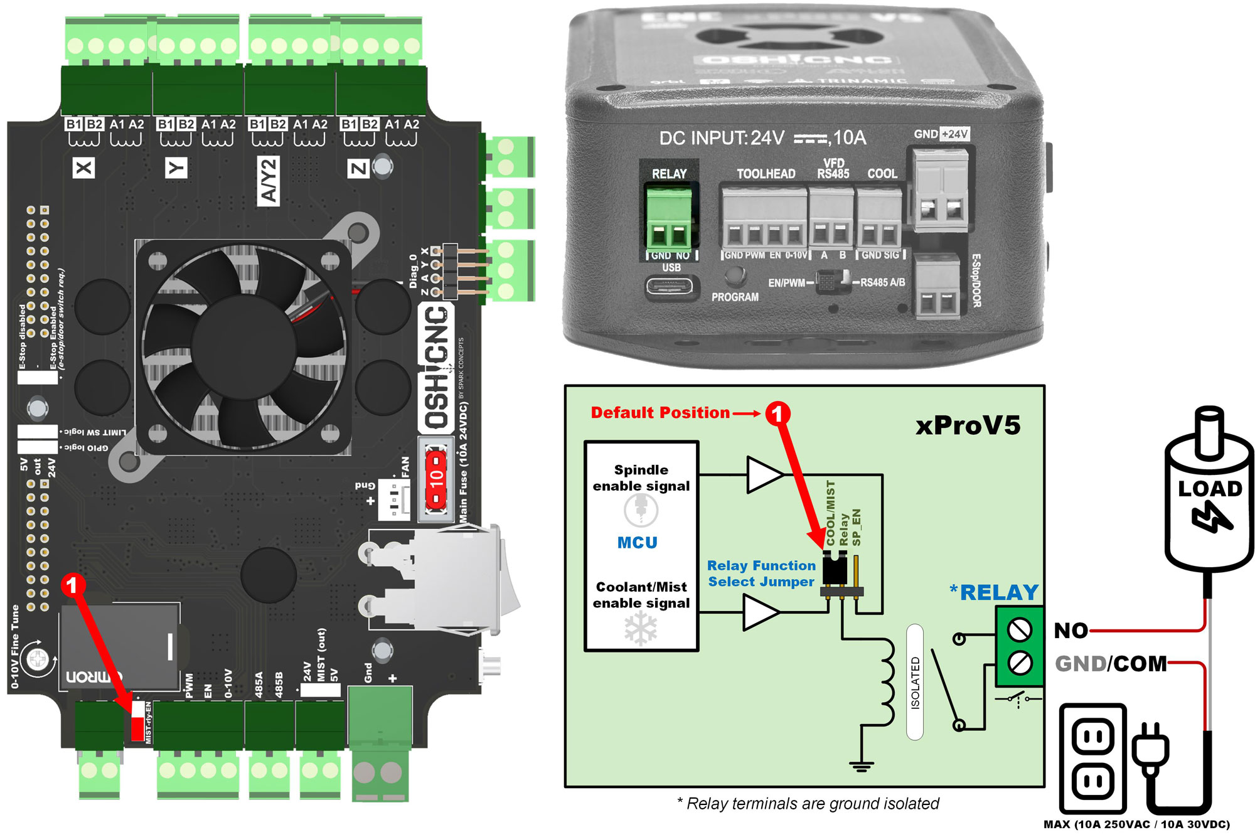
images/Relay.jpg
