Spark-Concepts/xPro-V5/images/reset_connection.jpg

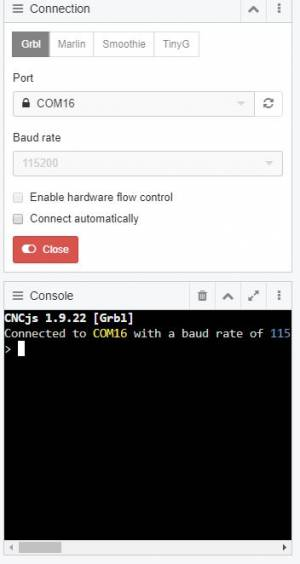
images/reset_connection.jpg
