Spark-Concepts/xPro-V5/images/Rly_Tool.jpg

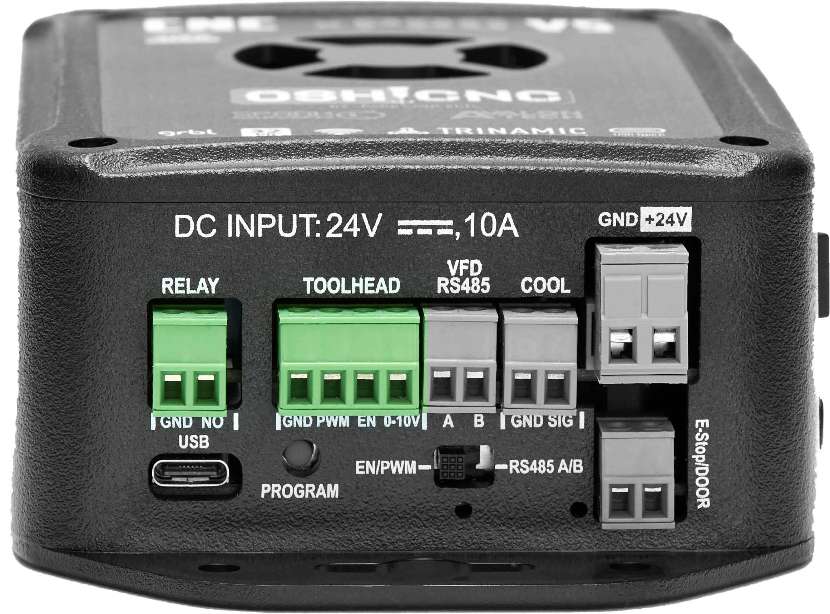
images/Rly_Tool.jpg
