Spark-Concepts/xPro-V5/images/Side copy.jpg

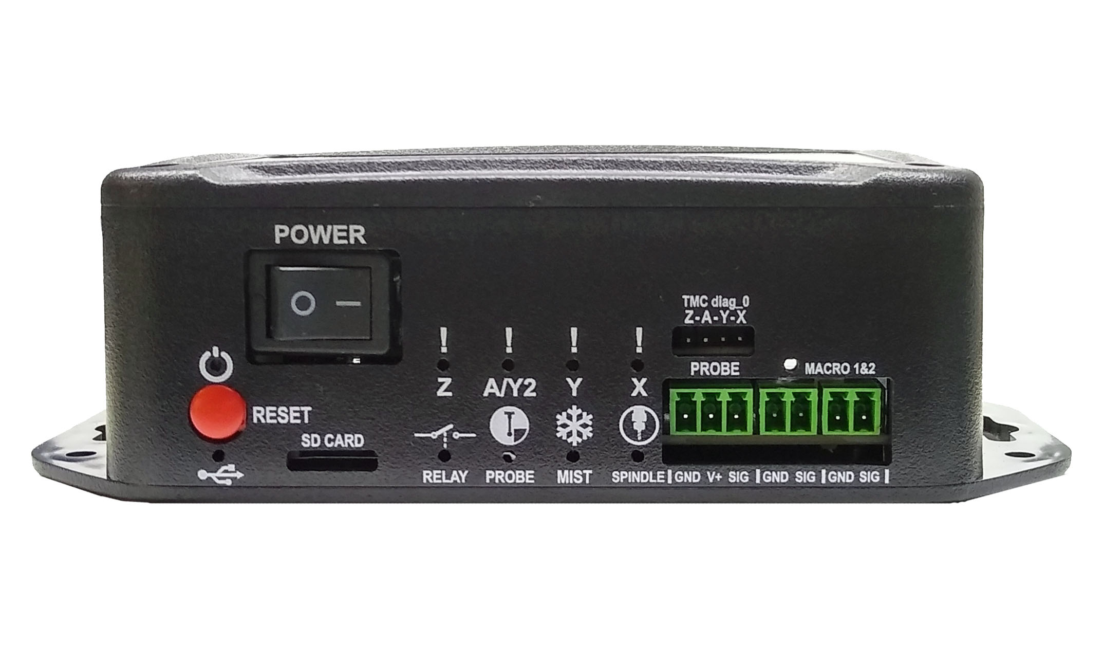
images/Side copy.jpg
