Spark-Concepts/xPro-V5/images/Side-plgs.jpg

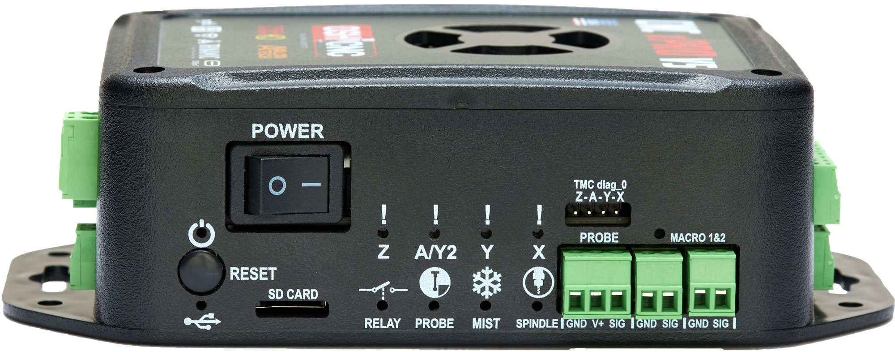
images/Side-plgs.jpg
