Spark-Concepts/xPro-V5/images/SpindlePWM_1.jpg

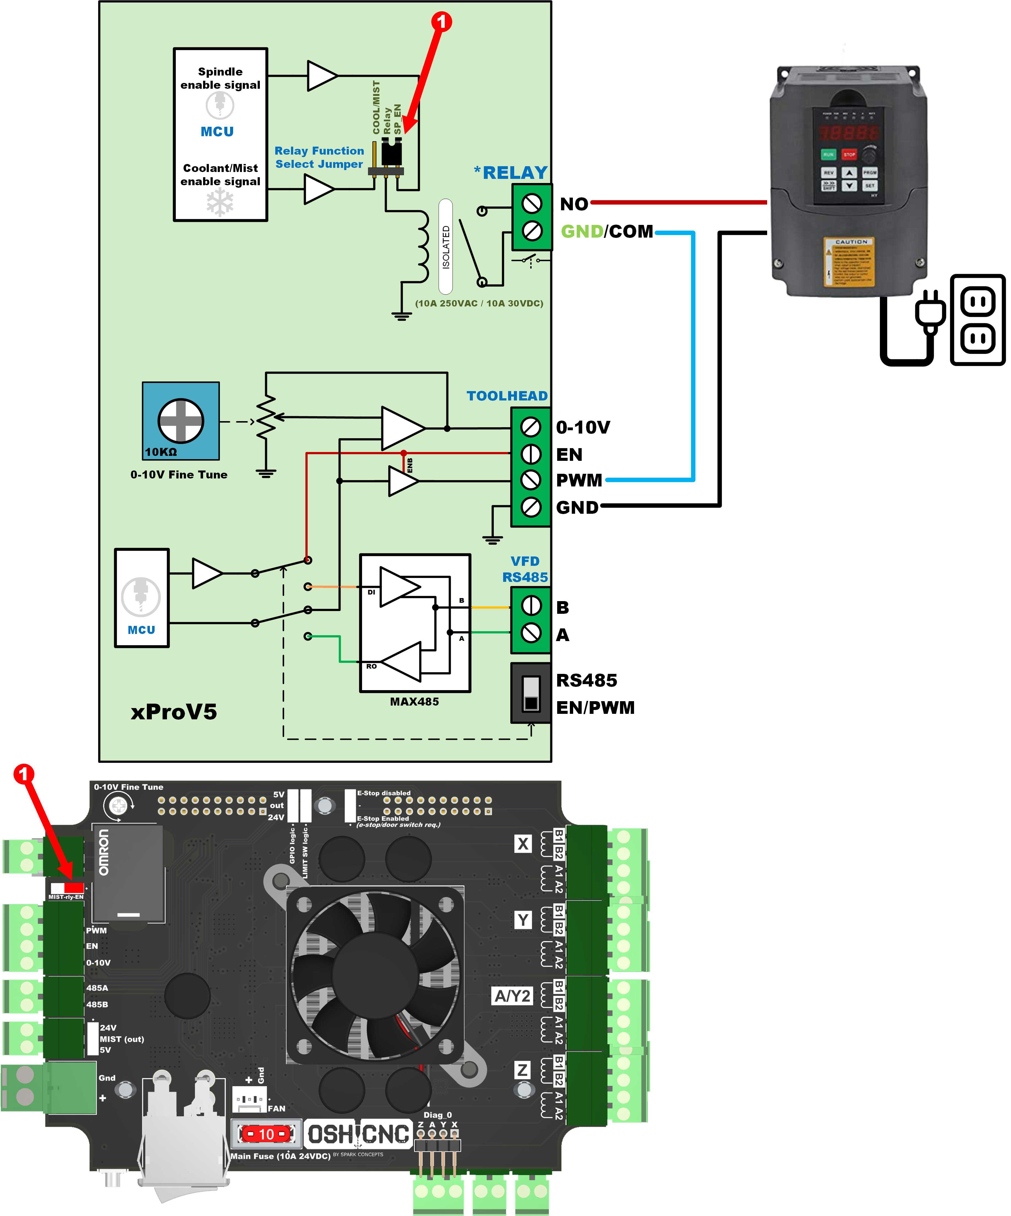
images/SpindlePWM_1.jpg
