Spark-Concepts/xPro-V5/images/Stepper_drw.jpg

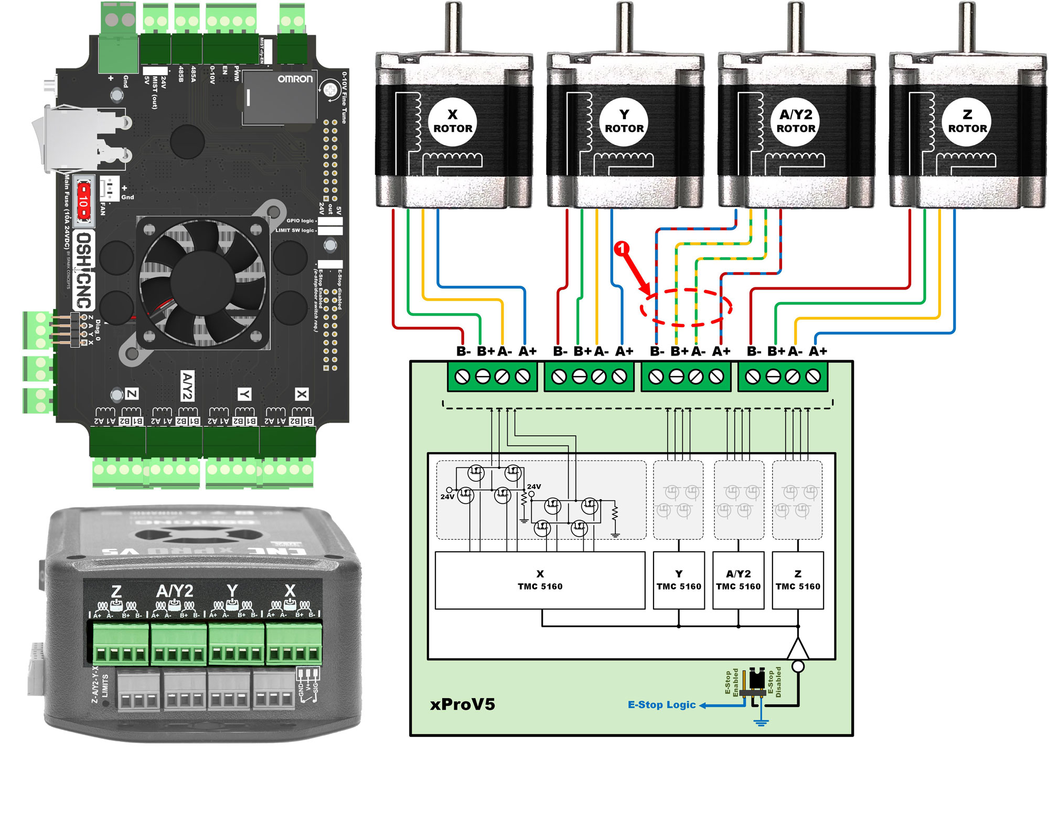
images/Stepper_drw.jpg
