Spark-Concepts/xPro-V5/images/Steppers.jpg

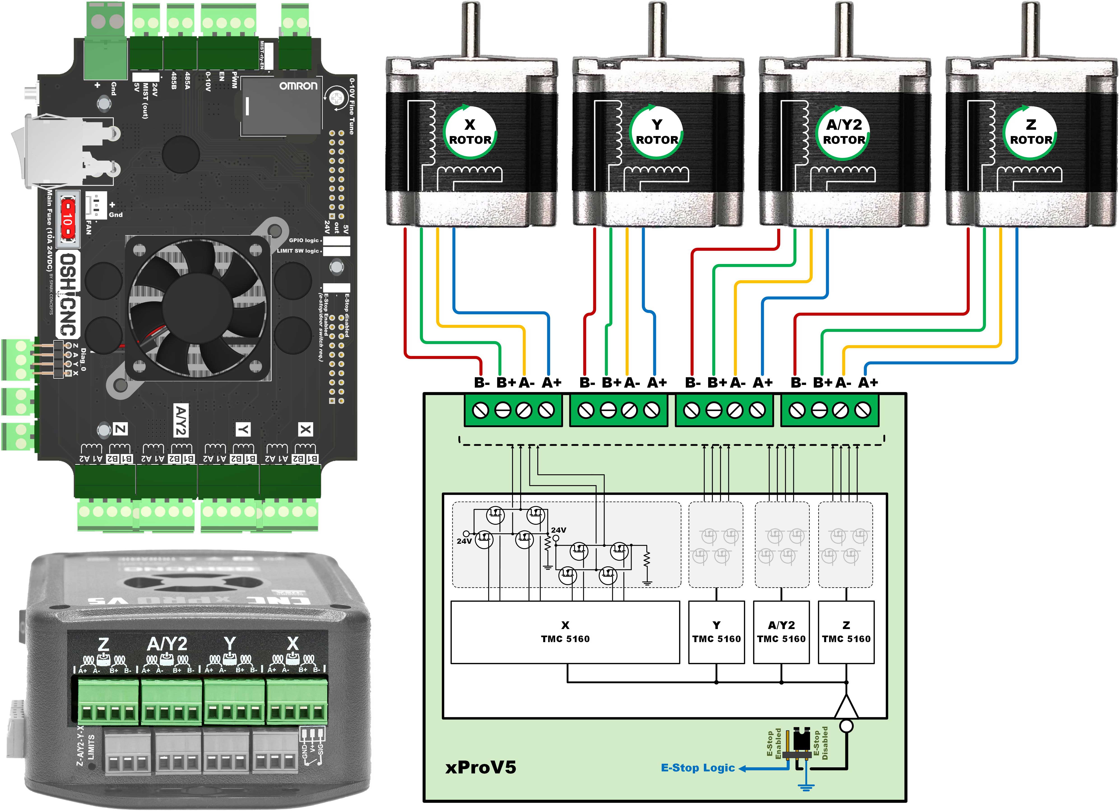
images/Steppers.jpg
