Spark-Concepts/xPro-V5/images/Steppers_inv.jpg

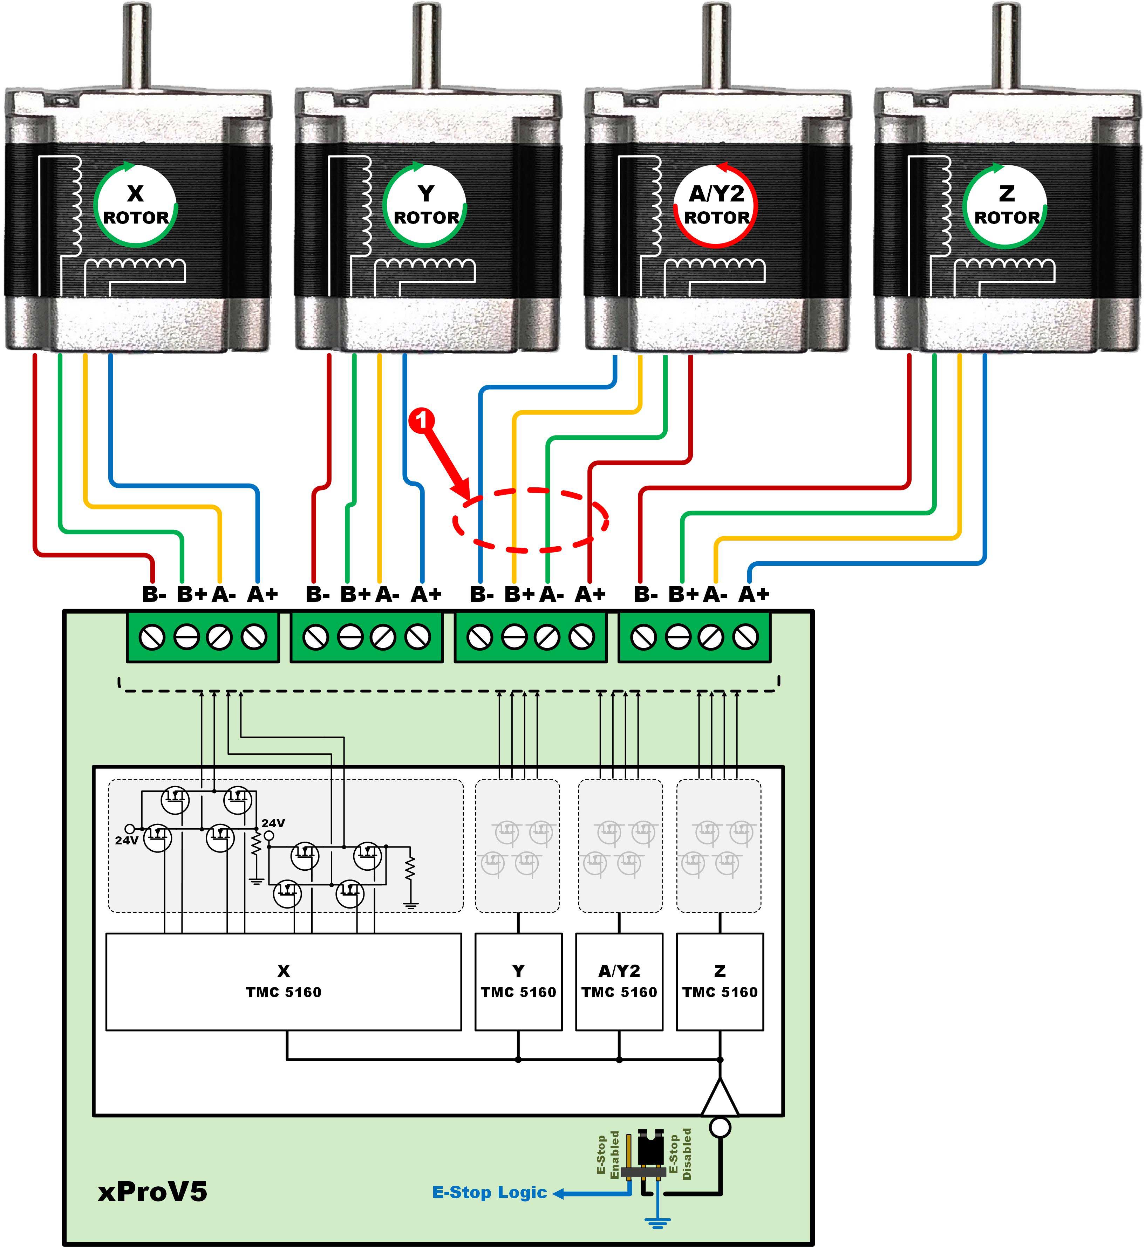
images/Steppers_inv.jpg
