Spark-Concepts/xPro-V5/images/toolhead.jpg

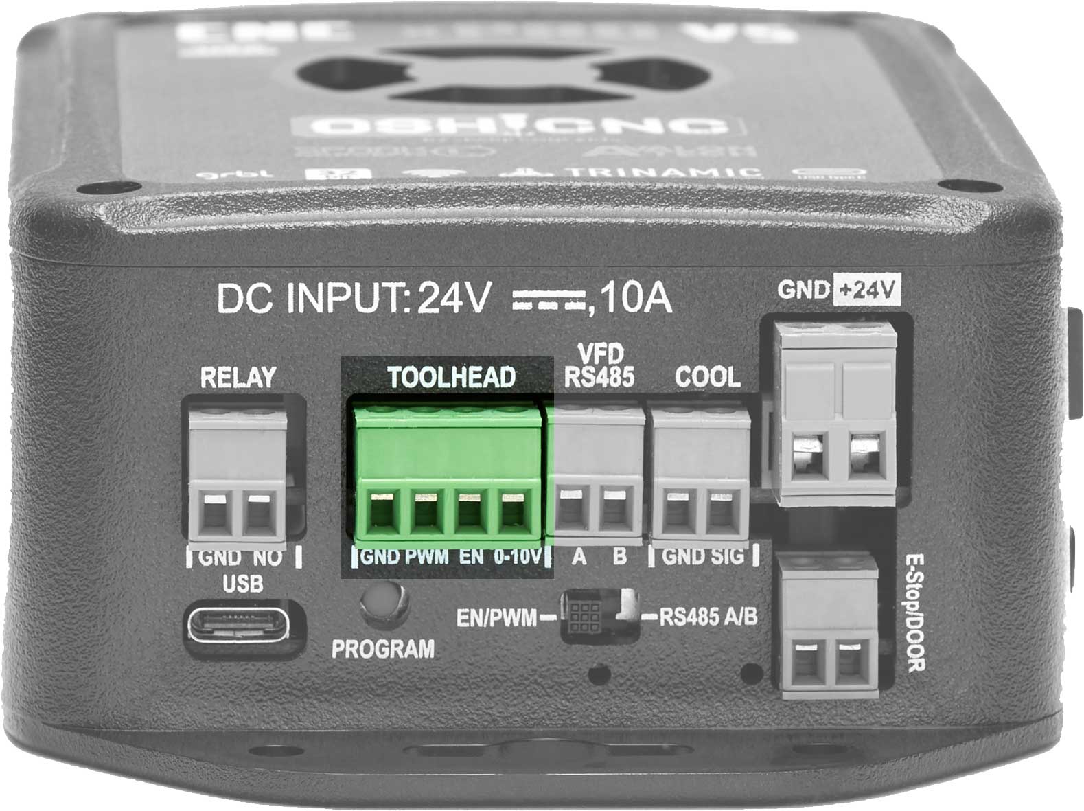
images/toolhead.jpg
