Spark-Concepts/xPro-V5/images/trinamic2.png

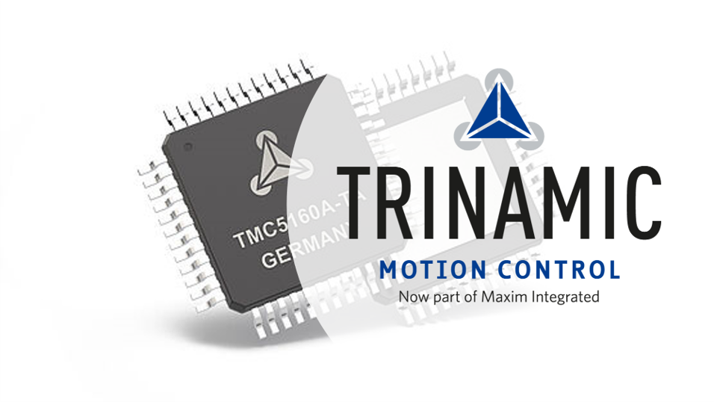
images/trinamic2.png
