Spark-Concepts/xPro-V5/images/warning.png

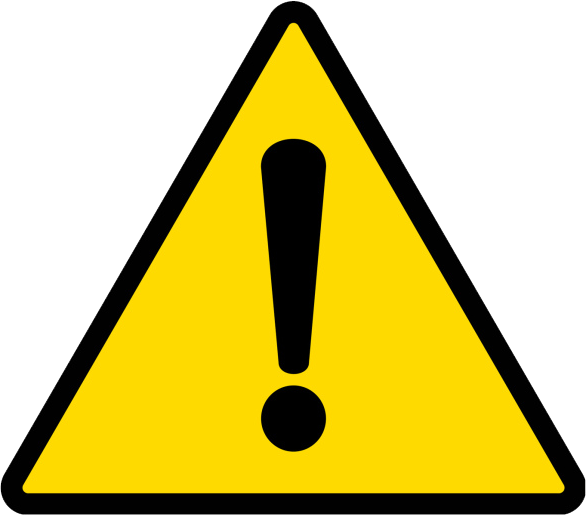
images/warning.png
