Spark-Concepts/xPro-V5/images/xPRO_SSR.jpg

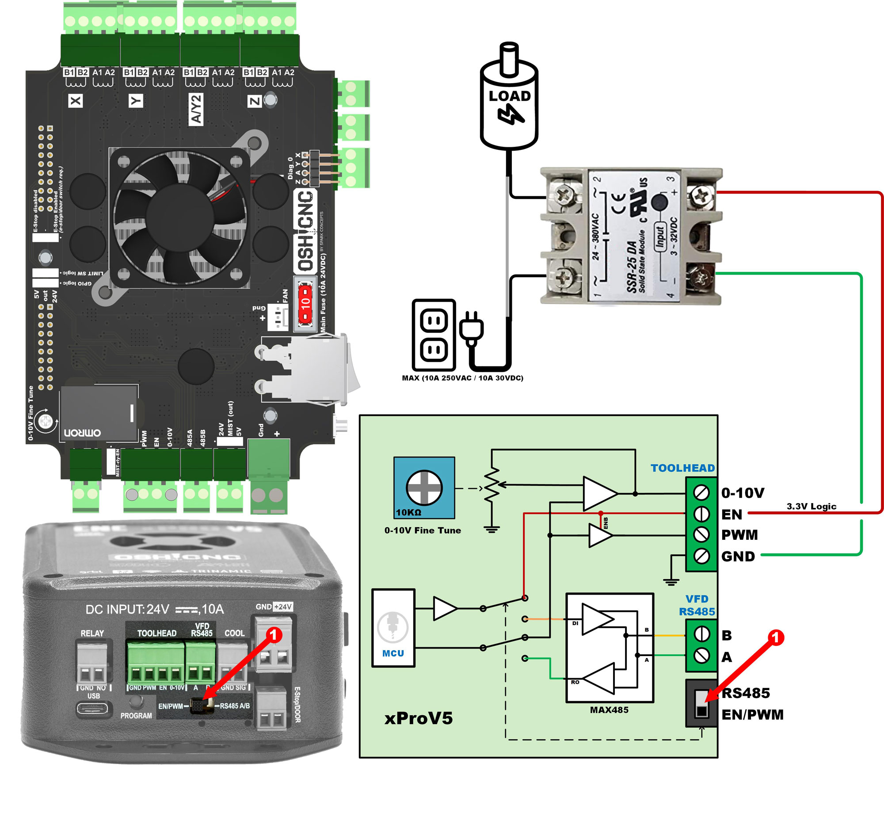
images/xPRO_SSR.jpg
