Spark-Concepts/xPro-V5/images/xProV5-GPIO_PinMap.jpg

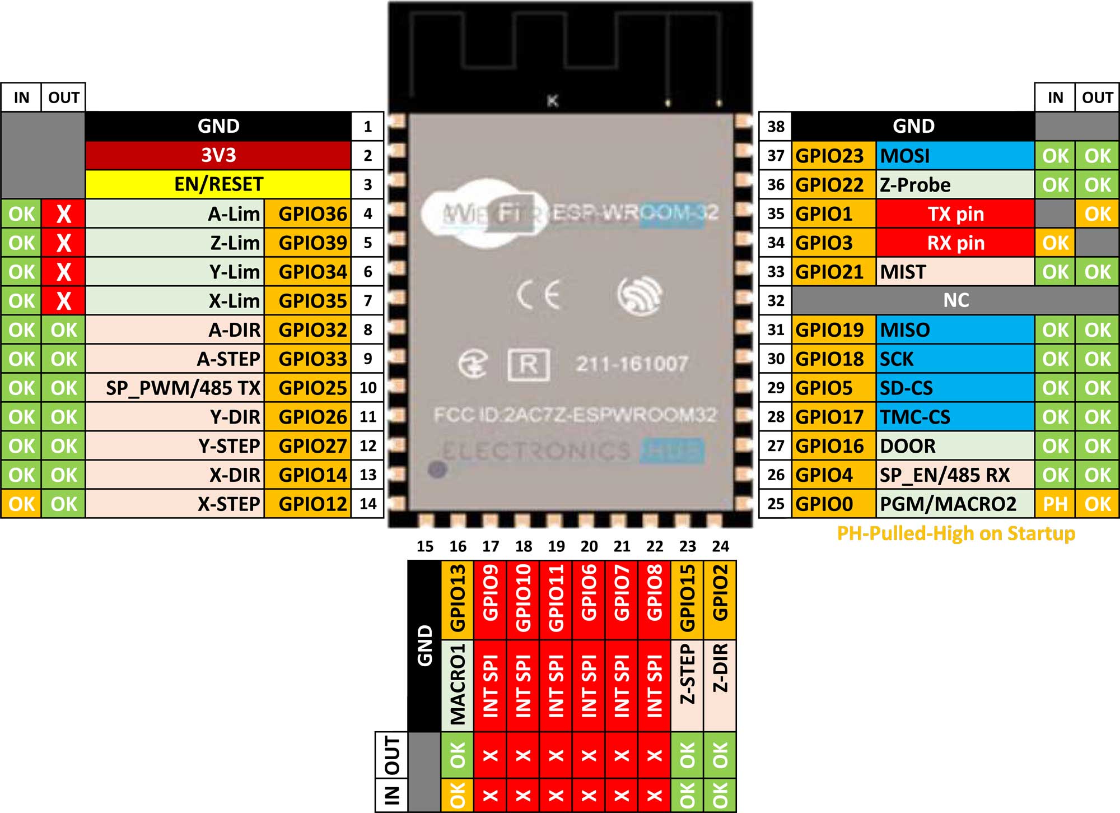
images/xProV5-GPIO_PinMap.jpg
