Spark-Concepts/xPro-V5/images/xproV5_iso.jpg

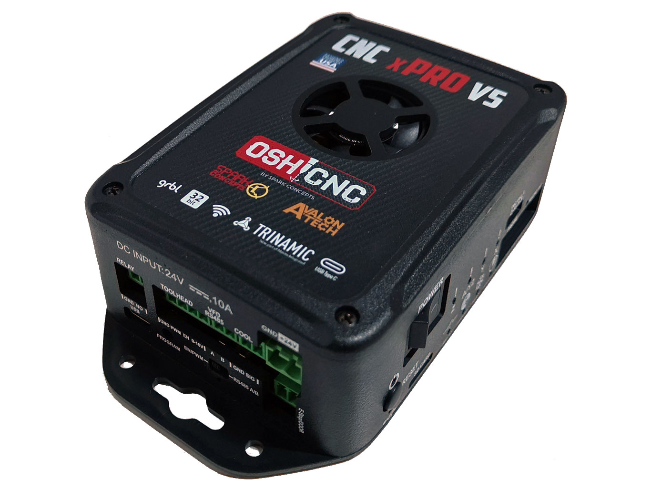
images/xproV5_iso.jpg
