Spark-Concepts/xPro-V5/images/z-touchplate2.jpg

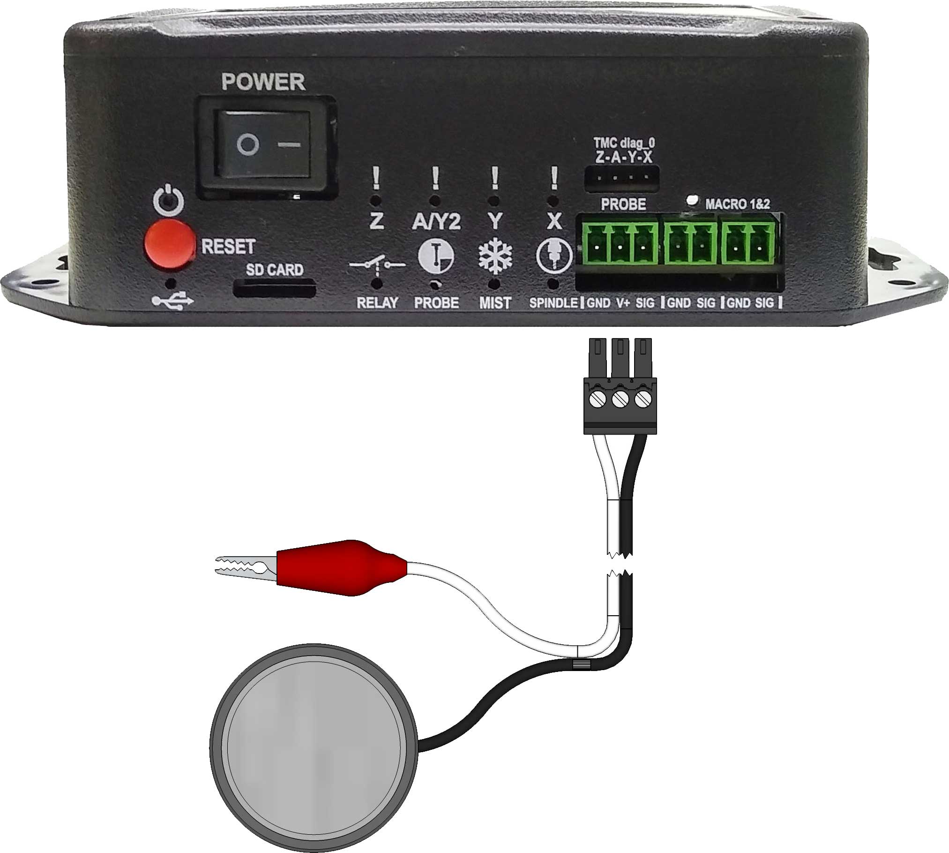
images/z-touchplate2.jpg
