Spark-Concepts/xPro-V5/images/z-touchplate.jpg

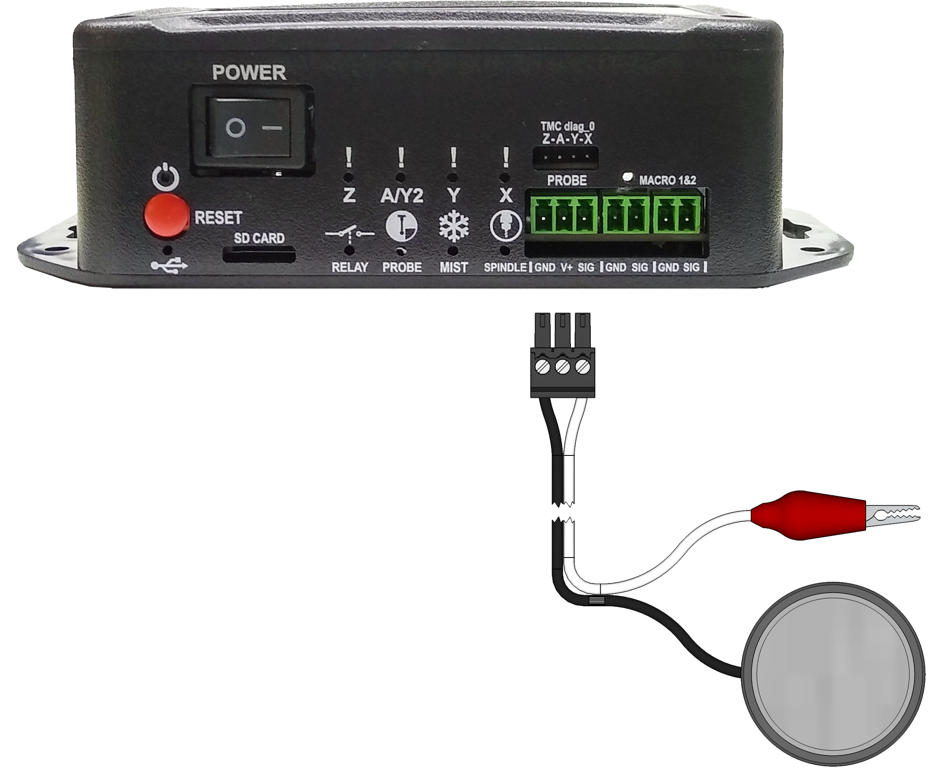
images/z-touchplate.jpg
