Spark-Concepts/xPro-V5/images/zprobe3.jpg

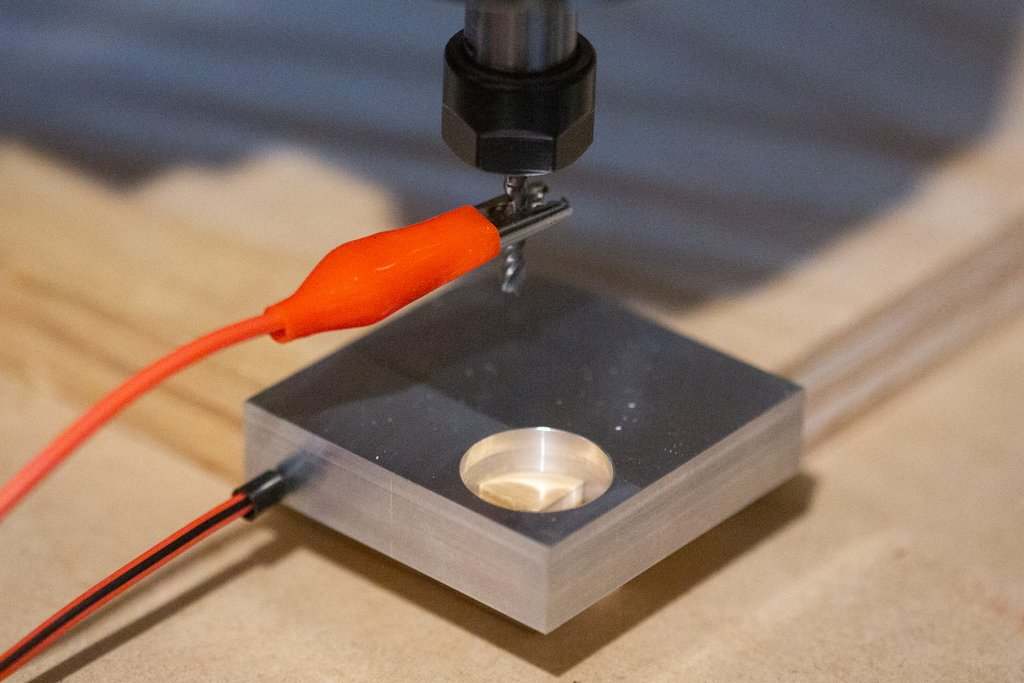
images/zprobe3.jpg
