Spark-Concepts/xPro-V5/FluidNC/Installing fluidNC on xPRO V5.pdf

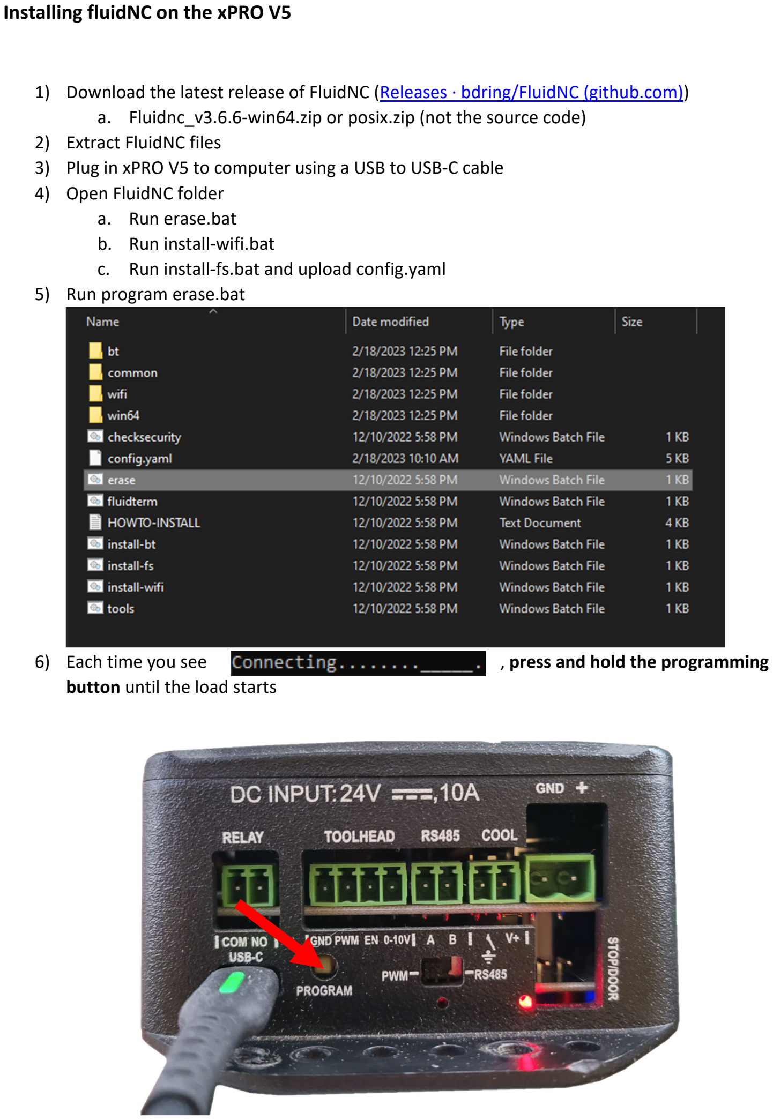
[picture p70: page 1]

Installing fluidNC on the xPRO V5

1) Download the latest release of FluidNC (Releases ∙ bdring/FluidNC (github.com))
a. Fluidnc_v3.6.6‐win64.zip or posix.zip (not the source code)
2) Extract FluidNC files
3) Plug in xPRO V5 to computer using a USB to USB‐C cable
4) Open FluidNC folder
a. Run erase.bat
b. Run install‐wifi.bat
c. Run install‐fs.bat and upload config.yaml
5) Run program erase.bat
6) Each time you see | , press and hold the programming
button until the load starts

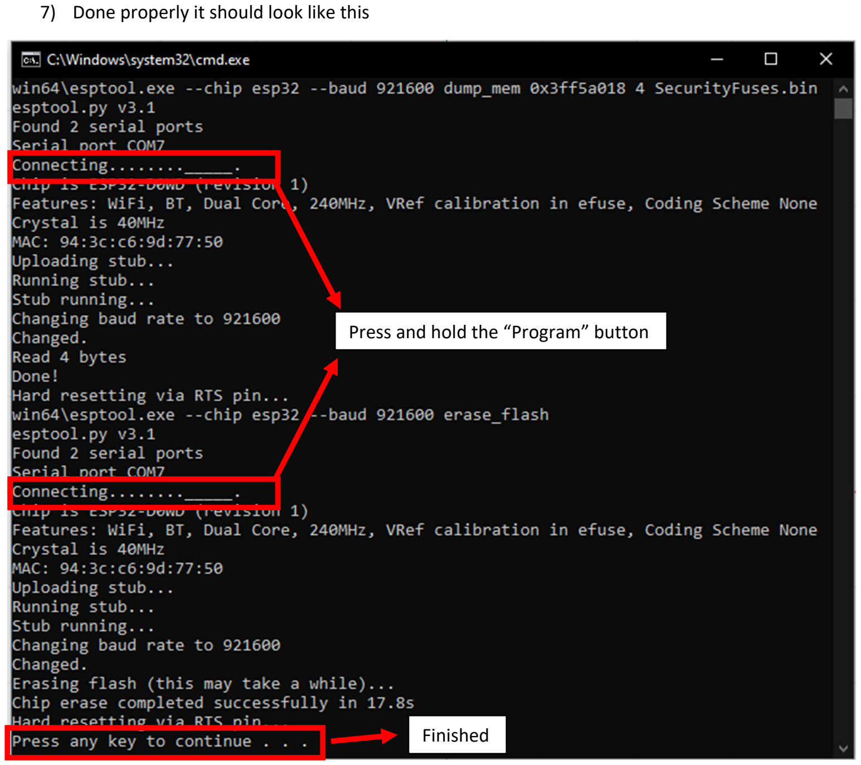
[picture p71: page 2]

7) Done properly it should look like this

Press and hold the “Program” button

Finished

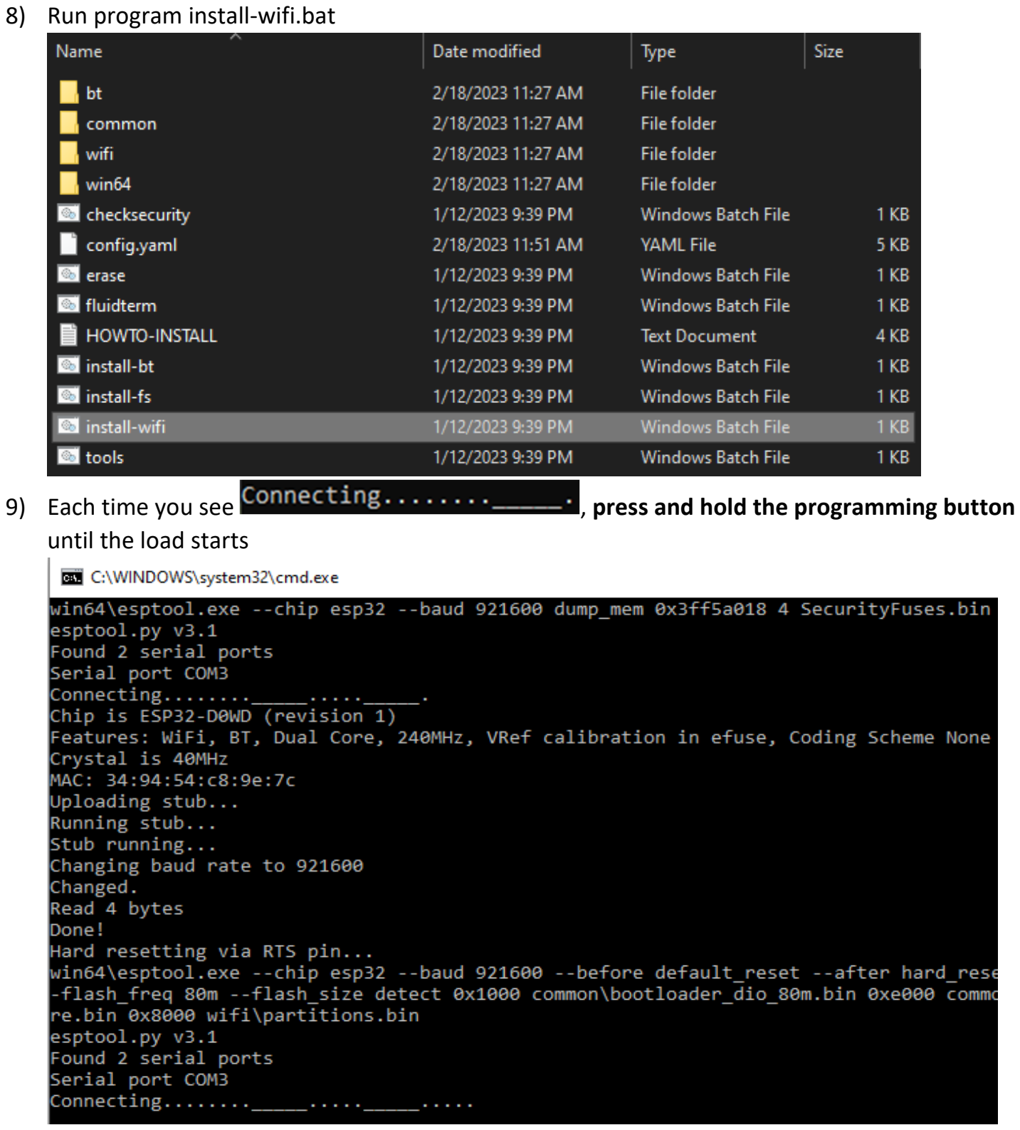
[picture p72: page 3]

8) Run program install‐wifi.bat
9) Each time you see | , press and hold the programming button
until the load starts

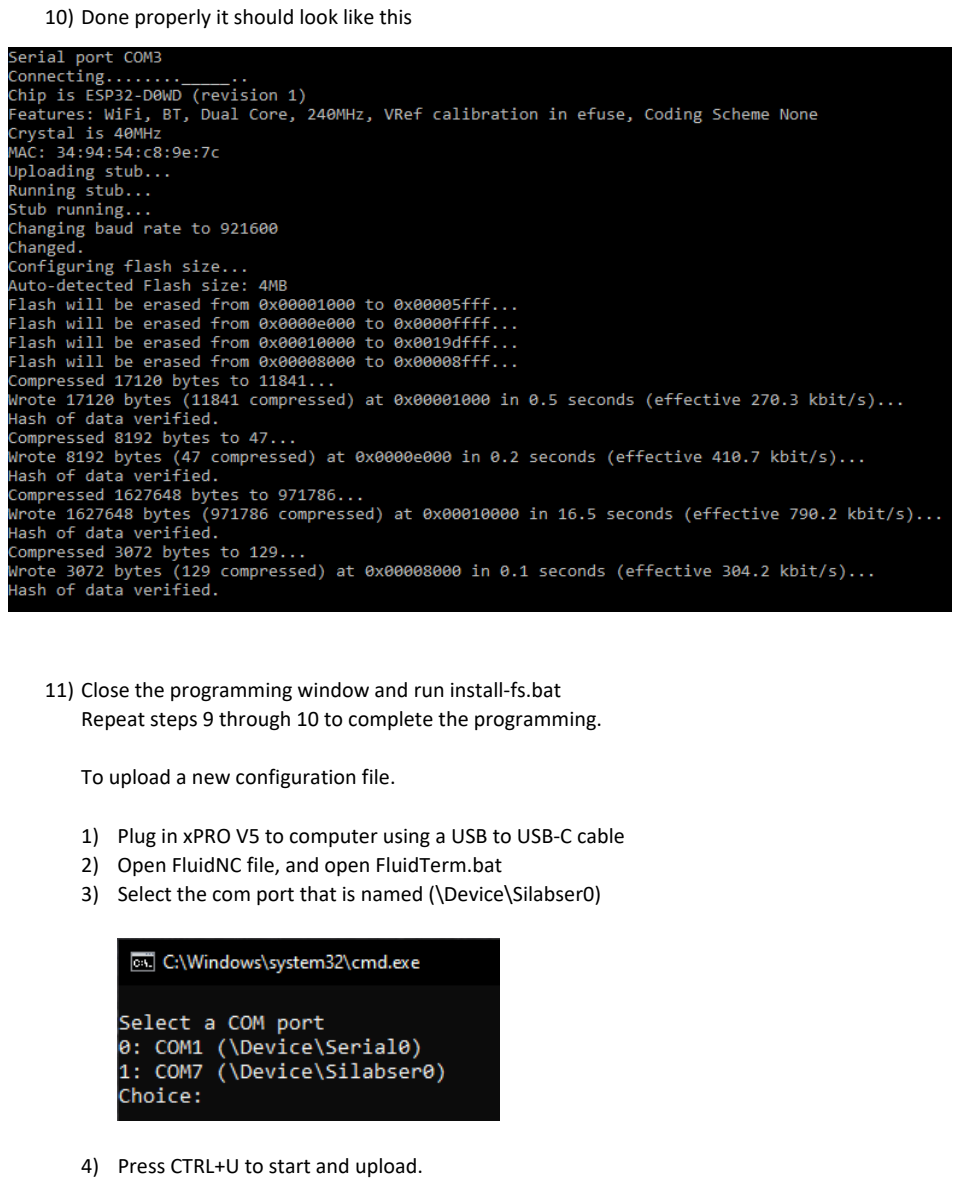
[picture p73: page 4]

10) Done properly it should look like this
11) Close the programming window and run install‐fs.bat Repeat steps 9 through 10 to complete the programming.

To upload a new configuration file.

1) Plug in xPRO V5 to computer using a USB to USB‐C cable
2) Open FluidNC file, and open FluidTerm.bat
3) Select the com port that is named (\Device\Silabser0)
4) Press CTRL+U to start and upload.

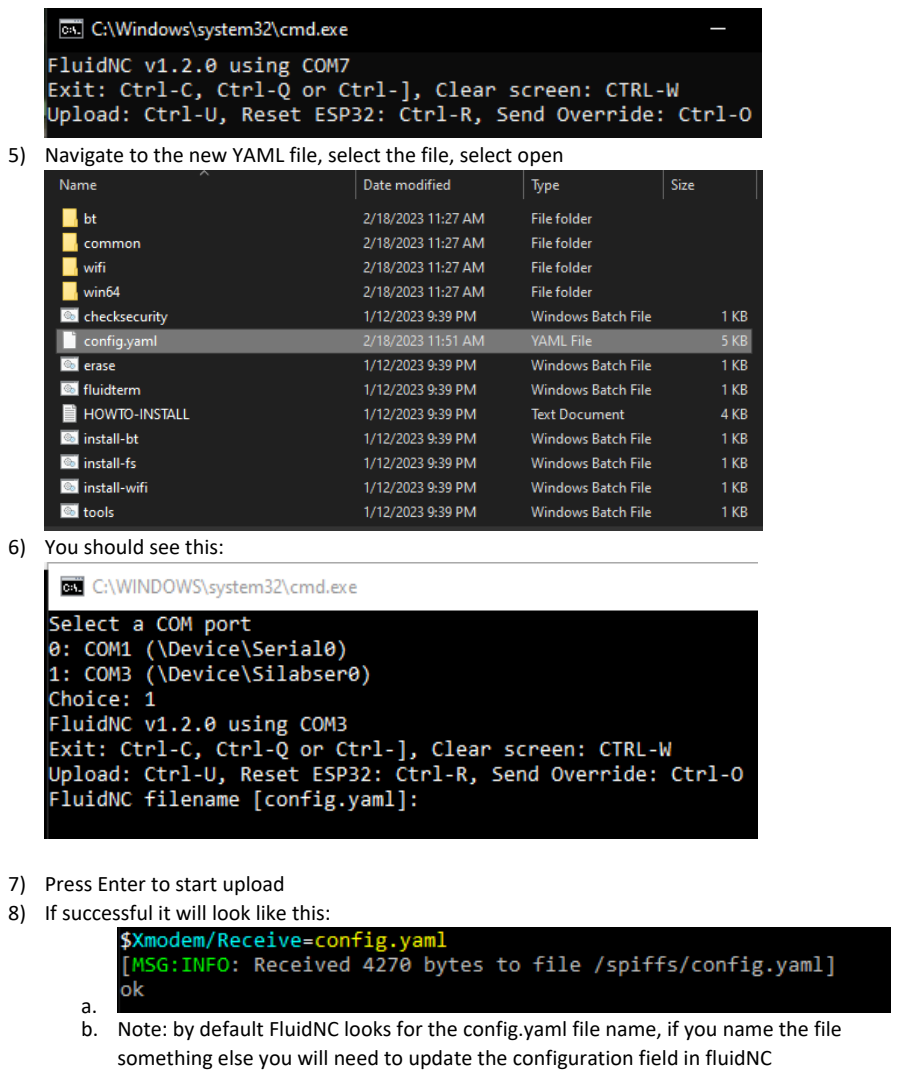
[picture p74: page 5]

5) Navigate to the new YAML file, select the file, select open
6) You should see this:
7) Press Enter to start upload
8) If successful it will look like this:

a.
b. Note: by default FluidNC looks for the config.yaml file name, if you name the file something else you will need to update the configuration field in fluidNC
