Spark-Concepts/xPro-V5/images/cncjs_setup_macro-2.png

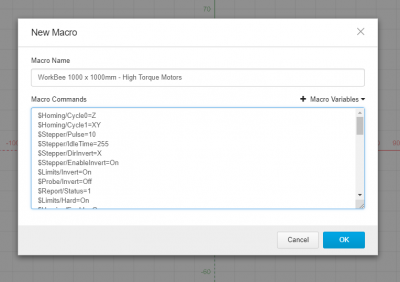
images/cncjs_setup_macro-2.png
