Spark-Concepts/xPro-V5/images/door-sensor-wiring.jpg

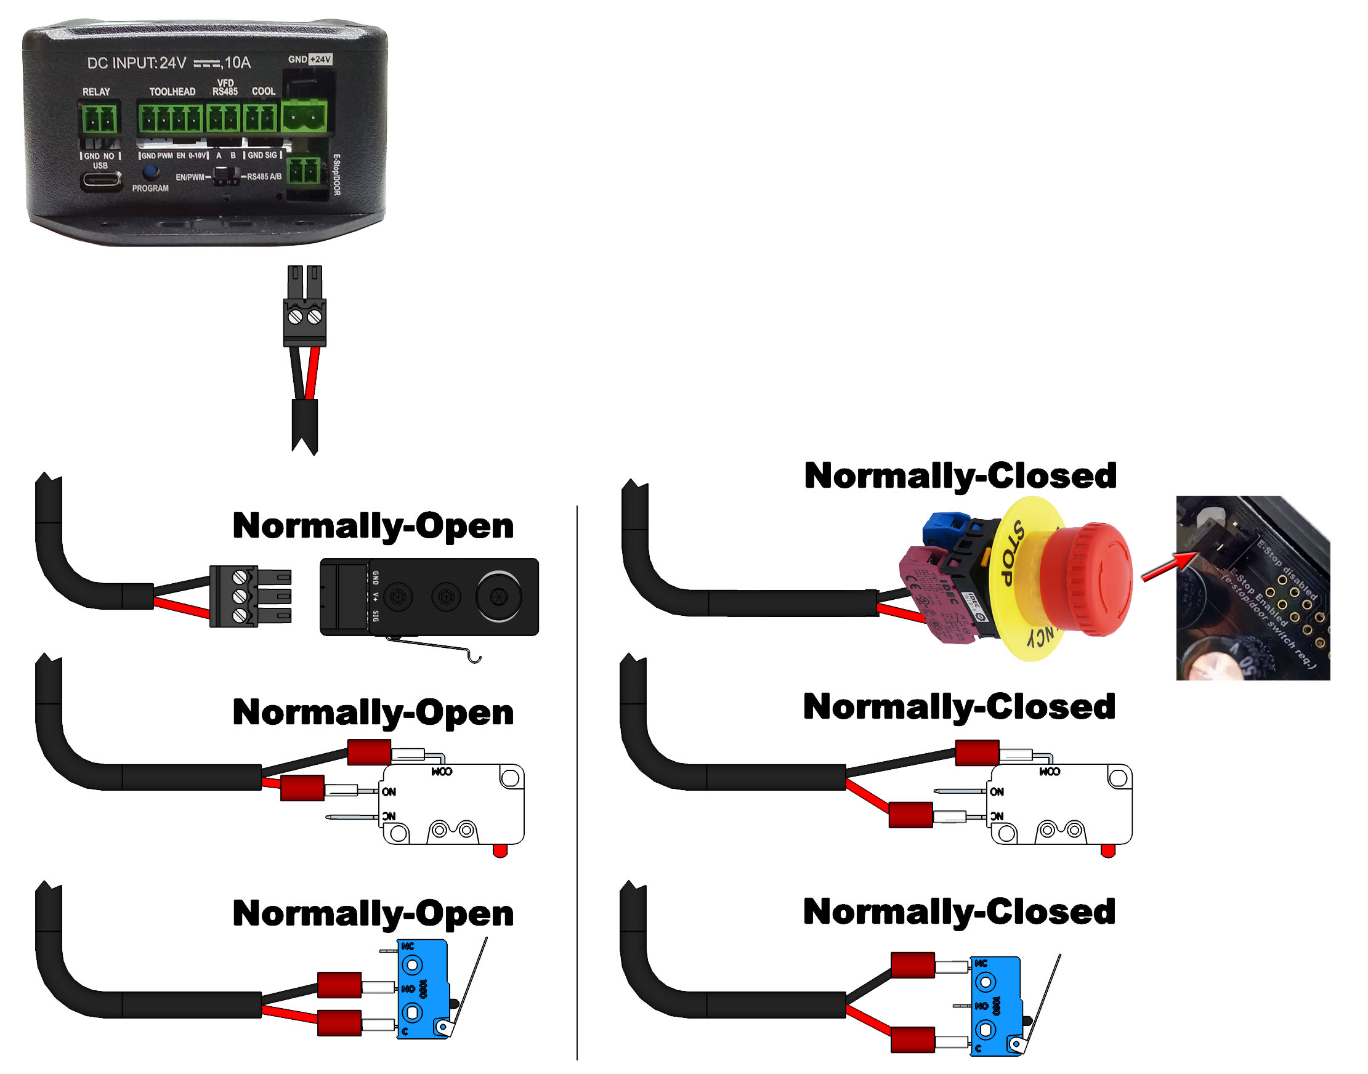
images/door-sensor-wiring.jpg
