Spark-Concepts/xPro-V5/images/plasma-wiring.jpg

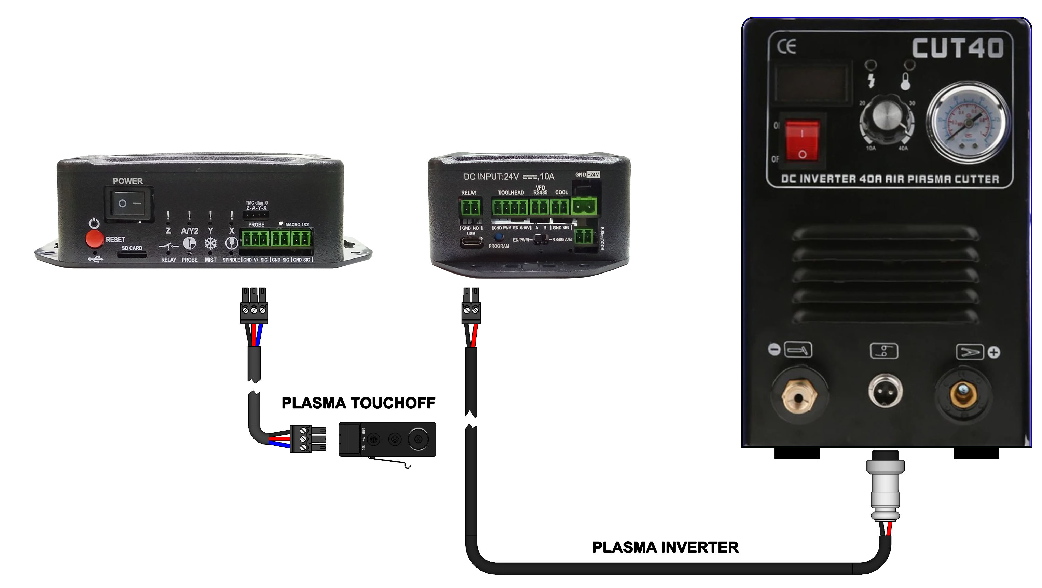
images/plasma-wiring.jpg
