Spark-Concepts/xPro-V5/images/xtension_limits_wiring.jpg

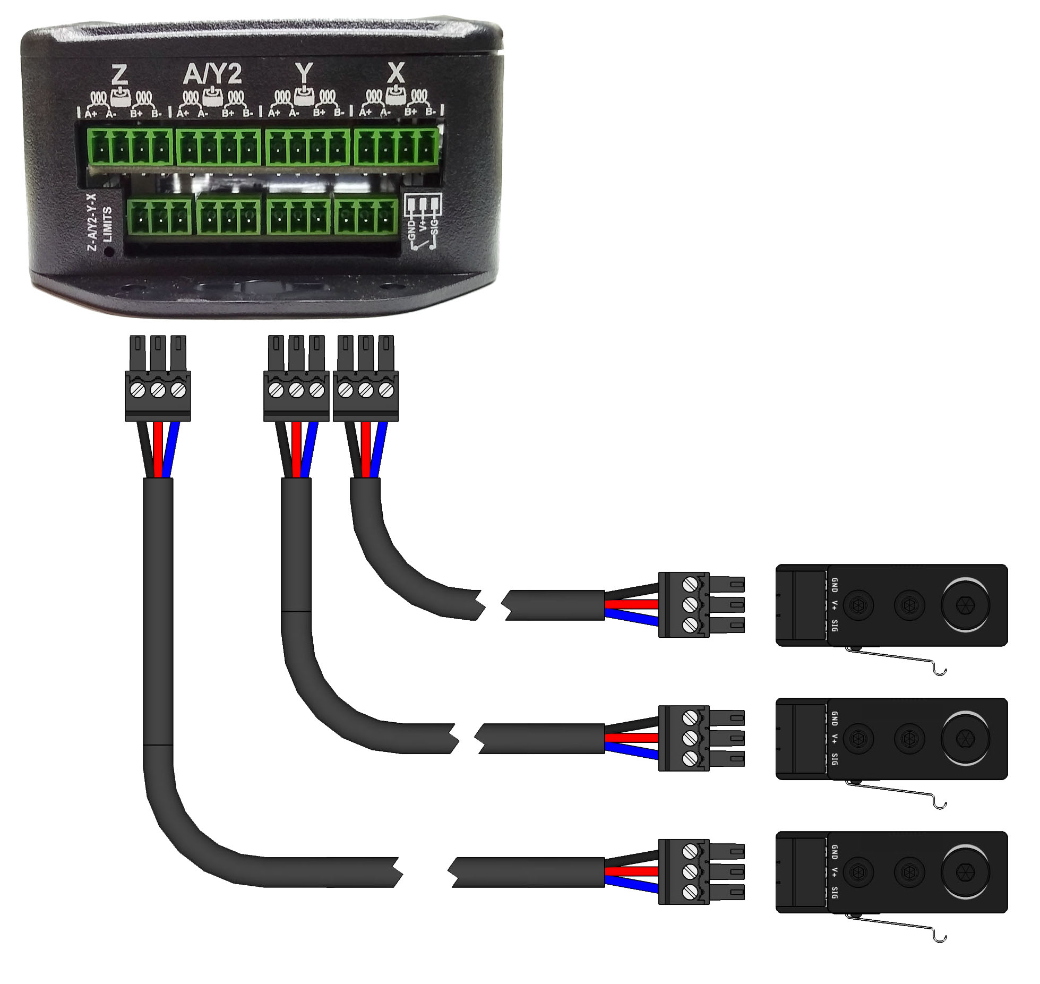
images/xtension_limits_wiring.jpg
