Spark-Concepts/xPro-V5/images/xyzprobe-wiring.jpg

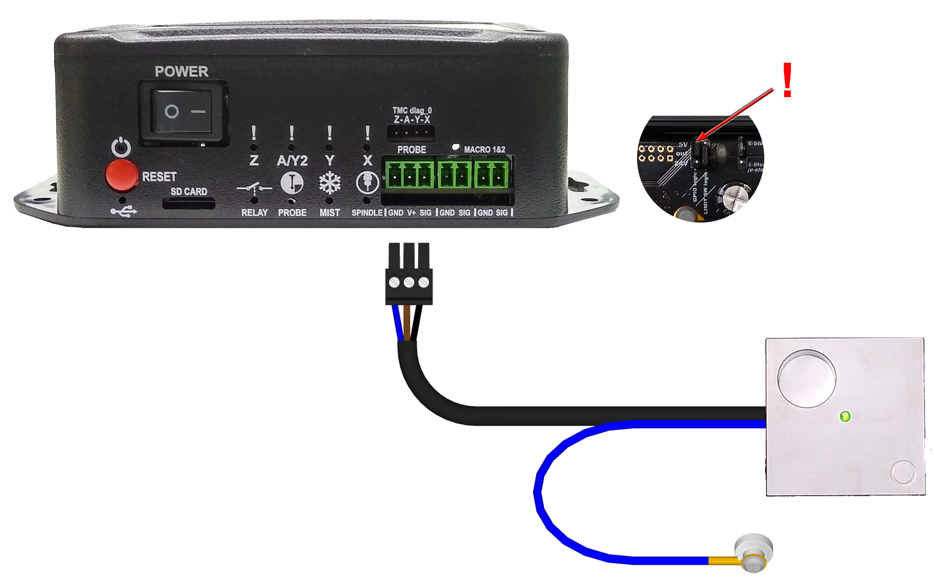
images/xyzprobe-wiring.jpg
