Spark-Concepts/xPro-V5/(threads)

Thread 4 (2021-01-17):

E-Stop issue

samwilt, 2021-01-17:
When using the E-Stop port and having changed the pins inside the unit, I cannot get any axis to move even when the E-Stop is not activated. When pressed, a red light comes up on the unit indicating that the E-Stop is activated and when releasing the E-Stop the unit then goes green.

Other issues such as not being able to activate spindles etc

Any comments?

Gezzunder, 2021-01-22:
Hi Sam,
I had the same issue.  Mike from Spark Concepts told me;
"there are some older pictures on the E-stop operation that had a mistake.  The Estop jumper needs to be in the Estop Disabled position, and the physical button needs to be wire N/O"

So try reverting to default jumper settings and, if you have a normally closed switch then push it in and it should work.  When you press the button (you'll need to change it to a normally open switch) it comes up as a door alarm, but everything stops

TRUDIM, 2021-03-30:
Hey,

I got a NC E-stop button and for the life of me cannot get it to work with the xPro V5. Anyone know a way of connecting it from the side of the button to the side of the xPro. Where should the jumper be?
I send an e-mail to Spark design, asking them these questions but they seem to be unavailable (or have no idea how to do it either...)

Anyone?

Spark-Concepts, 2021-03-30:
All - I'm getting ready to push a big update to the wiki - Please see the attached (you'll also need to update the binary also in the .zip)

[NC_e-stop-hooup&bin.zip](https://github.com/Spark-Concepts/xPro-V5/files/6232421/NC_e-stop-hooup.bin.zip)

TRUDIM, 2021-03-31:
Nice! Will give it a try later on today!

Spark-Concepts, 2021-03-31:
Absolutely not, please see the attached for NO E-stops:

[NO_e-stop-hookup&bin.zip](https://github.com/Spark-Concepts/xPro-V5/files/6236517/NO_e-stop-hookup.bin.zip)

philshel1, 2021-03-31:
Is there anything new in the firmware posted here that the rest of us should upgrade for?

Spark-Concepts, 2021-03-31:
Gezzunder,

The precompiled firmware is named to clearly identify specific compile time options - you can find the most ***up-to-date*** firmware here: https://github.com/Spark-Concepts/xPro-V5

CNC_xPRO_V5_  | MotoAssignment_ | SpindleType_ | DoorSwitchType.bin
------------- | -------------|------------- | -------------
" | XYYZ | PWM | NO
" | XYAZ | PWM | NO
" | XYYZ | PWM | NC
" | XYAZ | PWM | NC
" | XYYZ | 485 | NO
" | XYAZ | 485 | NO
" | XYYZ | 485 | NC
" | XYAZ | 485 | NC

**MotorAssignment:** *the options are XYYZ (3 axis, ganged Y) and XYAZ (4 axis)*

**SpindleType:** *the options are PWM which allows for 0-5V or 0-10V spindle (or laser) and 485 allows for the use of an RS485 enabled VFD* (only available for HY series VFDs)

 **DoorSwitchType** *controls whether or not the door/Estop switch is Normally Open (NO), or Normally Closed (NC)*

**NOTE:**
***selecting NC requires a Normally Closed switch to be attached at all times or the system will not run***
***selecting NO allows a Normal Open switch to be installed or not***

**Default firmware is:**  ***CNC_xPRO_V5_XYYZ_PWM_NO.bin*** *(this denoted a 3 axis dual Y motor machine, with a pwm spindle(0-5v, or 0-10v), and a normally open door switch)*

Mboss32, 2021-04-07:
> Is there anything new in the firmware posted here that the rest of us should upgrade for?

This release was primarily to push the precompiled options for XYZA, RS485, and NC door switches.  A few minor tweaks to the code but nothing major.

Closed 2021-04-07.

Thread 6 (2021-02-07):

motor burned up

IdahoCreator, 2021-02-07:
I have burned up a nema 23 2.8a stepper. All othe steppers are fine but were extremely hot. I cant find any info on wiki on how to adjust stepper voltage. I assume its in software. This occurred after I upgraded to the newest firmware as my controllercwas stopping in the middle of cut programs. That issue was resolved with firmware upgrade. Thanks for your help

Spark-Concepts, 2021-02-10:
Definitely sounds like your motor current is set high.  By default, we use a setting for 2.8A Nema23s - the current can be adjusted using these settings ( https://github.com/Spark-Concepts/xPro-V5/wiki/Changing-settings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).  Note the Trinamics work with RMS not MAX current.

IdahoCreator, 2021-02-13:
Ok I will adjust when I get my new motor. You may check the newest firmware as I didnt have this problem prior to the update.just verifing $140-143 are the adjustmemta I need to.make. i will set them at 2.4amps as I am running 2.8a nema 23.

Spark-Concepts, 2021-02-16:
We will definitely double check the firmware.  For a 2.8A motor, you will need to set the value to 1.9A or below.  The setting controls RMS current, so 0.707 * Max.  Would recommend a setting of around 1.8A for your motors to give a little overhead in the max current.

Closed 2021-04-07.

Thread 7 (2021-02-15):

question about setting up

Papapayana, 2021-02-15:
so im looking to ad the ability to use a laser engraver along with my cnc mill and was wondering if i wanted to use tinyurl.com/3s1ns3yc  would i be able to have it hooked up along with my VFD or would i have to find a differant way to do it?

wolfkabal, 2021-02-24:
I'm not an expert, but I think through the use of a splitter adapter from the "tool" plug, with an inline SPDT switch, you could then have both VFD and Laser both connected, and via the switch, control which is active.

https://docs.openbuilds.com/doku.php?id=docs:blackbox:iot-and-laser - here's a reference to what's used for a basic spindle (via IoT Relay) - but the same could be done for laser and vfd I'd presume.

Mboss32, 2021-04-07:
This should work perfectly fine.  I would argue that grabbing a second 4pin header plug then wire the PWM spindle to one plug,  the PWM Laser to the other.  Clearly mark the two and just swap them in the controller when needed.  Greatly simplifies things and avoids some potentially painful oops.

Closed 2021-04-07.

Thread 8 (2021-02-22):

Firmware Source?

wolfkabal, 2021-02-22:
Where is the firmware source located?

Documentation indicates in multiple locations "additional configuration in config.h". Is the xPro-V5 source available for custom compilation?

Spark-Concepts, 2021-03-31:
The precompiled firmware is named to clearly identify specific compile time options - you can find the most ***up-to-date*** firmware here: https://github.com/Spark-Concepts/xPro-V5

CNC_xPRO_V5_  | MotoAssignment_ | SpindleType_ | DoorSwitchType.bin
------------- | -------------|------------- | -------------
" | XYYZ | PWM | NO
" | XYAZ | PWM | NO
" | XYYZ | PWM | NC
" | XYAZ | PWM | NC
" | XYYZ | 485 | NO
" | XYAZ | 485 | NO
" | XYYZ | 485 | NC
" | XYAZ | 485 | NC

**MotorAssignment:** *the options are XYYZ (3 axis, ganged Y) and XYAZ (4 axis)*

**SpindleType:** *the options are PWM which allows for 0-5V or 0-10V spindle (or laser) and 485 allows for the use of an RS485 enabled VFD* (only available for HY series VFDs)

 **DoorSwitchType** *controls whether or not the door/Estop switch is Normally Open (NO), or Normally Closed (NC)*

**NOTE:**
***selecting NC requires a Normally Closed switch to be attached at all times or the system will not run***
***selecting NO allows a Normal Open switch to be installed or not***

**Default firmware is:**  ***CNC_xPRO_V5_XYYZ_PWM_NO.bin*** *(this denoted a 3 axis dual Y motor machine, with a pwm spindle(0-5v, or 0-10v), and a normally open door switch)*

Mboss32, 2021-04-13:
Hi Arthur,  I fully understand and appreciate your concern.  This repo "xPRO V5" is set up to push specific hardware/firmware updates and troubleshooting to the xPRO V5 hardware end-user, not firmware developers.  For those interested in firmware development, source code is freely available on our website as a download (with the appropriate licensing, and cautions).  With limited man-hours this allows us to keep this repo focus on hardware-specific information.

arthurwolf, 2021-04-13:
The source code *for those exact bins* is available on your website?
How do I know exactly what was compiled into each bin?
If I can't map a specific bin to an exact ensemble of source code, that's
obfuscation (even if it's not malicious).

It's generally good pratice to keep the source code packages/available
along with binary files.
If that's inconvenient, there are alternative solutions:
* You should at least have the bins accompanied by enough information (a
Readme?) to map specific bins to specific source code (or is it build
options in this case? That still needs to be explained/mapped )
* Similarly, the bins should be accompanied by their license file, or at
least a link/enough information to find said licensing information.

Essentially: It's an issue that coming here I can not find the source code
or any way to find the source code, I can not find a license or even know
what the license is, and I can not know what version/build option/diff of
the code was compiled into those bins.
It's not proper practice for Open-Source code publication.

Hope this helps.
Cheers.

On Tue, Apr 13, 2021 at 9:17 PM Spark Concepts ***@***.***>
wrote:

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

--

勇気とユーモア

nxperera, 2021-04-13:
Hi MBoss32,
I am interested in the source code for the firmware for the xPro V5 I bought last month, would you be able to let me know where I can down load it? I was looking at the website https://www.spark-concepts.com/ I can find anywhere I can download the source code.

Mboss32, 2021-04-14:
Hi nxperera, if you search the site for "firmware" it will popup as a free downloadable product. If you are still having trouble let me know and I will grab the link when I get back to a computer.

nxperera, 2021-04-14:
Mboss32, Thanks I was able to get it. Next is how to build this, hope platform io or Arduino environment would do it. Will post my update on the build here. Planing to load to a ESP32 controller first and see if I can get the WebUI running so that I can reload old firmware again in case :).

nxperera, 2021-04-15:
I was not able to build from CNC_xPRO_V5_20210318 code base as is yet but I compared the code to Bart Dring's Grbl_ESP32 code base which I am able to build and run on another ESP32, the both source bases are pretty similar very minimal customizations. Also looks like Spark didn't use platformIO so trying Arduino IDE to build but it keep failing on required libraries.
MBoss32 please let me know if you already know what I need to do to get this compiling, I know you guys are busy and the hardware is superb but the firmware code base (code organization at least) looks hackish, if you load it to GitHub people can help to clean it up.

Mboss32, 2021-04-16:
nxperera, the code is very similar to Bart's with customizations made for the specific hardware on the controller.   We do use Arduino IDE to program the controllers (directions here: https://github.com/bdring/Grbl_Esp32/wiki/Compiling-with-Arduino-IDE).  The code definitely needs a clean, what is posted is the in dev portion of it, the github repo for firmware is in progress.

nxperera, 2021-04-16:
Mboss32 thanks for the info I'll try again, It's wonderful to hear you are building the git repo for this.

nxperera, 2021-04-16:
Ok MBoss32, Thanks I was able to finally build it and load to an ESP32 lying around on my desk and yes it runs !!!

      ⸮ets Jun  8 2016 00:22:57

rst:0x1 (POWERON_RESET),boot:0x17 (SPI_FAST_FLASH_BOOT)
configsip: 0, SPIWP:0xee
clk_drv:0x00,q_drv:0x00,d_drv:0x00,cs0_drv:0x00,hd_drv:0x00,wp_drv:0x00
mode:DIO, clock div:1
load:0x3fff0018,len:4
load:0x3fff001c,len:1216
ho 0 tail 12 room 4
load:0x40078000,len:10944
load:0x40080400,len:6388
entry 0x400806b4

[MSG:Grbl_ESP32 Ver 1.3a Date 20210311]
[MSG:Compiled with ESP32 SDK:v3.3.5-1-g85c43024c]
[MSG:Using machine:CNC_xPRO_V5_XYYZ_PWM_NO]
[MSG:Axis count 3]
[MSG:RMT Steps]
[MSG:Door switch on pin GPIO(16)]
[MSG:Init Motors]
[MSG:TMCStepper Library Ver. 0x000701]
[MSG:X  Axis Trinamic TMC5160 Step:GPIO(12) Dir:GPIO(14) CS:GPIO(17) Disable:None Index:1 R:0.050 Limits(0.000,300.000)]
[MSG:X  Axis Trinamic driver test failed. Check motor power]
[MSG:Y  Axis Trinamic TMC5160 Step:GPIO(27) Dir:GPIO(26) CS:GPIO(17) Disable:None Index:2 R:0.050 Limits(0.000,300.000)]
[MSG:Y  Axis Trinamic driver test failed. Check motor power]
[MSG:Y2 Axis Trinamic TMC5160 Step:GPIO(33) Dir:GPIO(32) CS:GPIO(17) Disable:None Index:3 R:0.050 Limits(0.000,300.000)]
[MSG:Y2 Axis Trinamic driver test failed. Check motor power]
[MSG:Z  Axis Trinamic TMC5160 Step:GPIO(15) Dir:GPIO(2) CS:GPIO(17) Disable:None Index:4 R:0.050 Limits(-300.000,0.000)]
[MSG:Z  Axis Trinamic driver test failed. Check motor power]
[MSG:PWM spindle Output:GPIO(25), Enbl:GPIO(4), Dir:None, Freq:5000Hz, Res:13bits]
[MSG:BT Started with CNC_xPRO_V5]
[MSG:Mist coolant on pin GPIO(21)]
[MSG:X  Axis limit switch on pin GPIO(35)]
[MSG:Y  Axis limit switch on pin GPIO(34)]
[MSG:Z  Axis limit switch on pin GPIO(39)]
[MSG:Probe on pin GPIO(22)]

Grbl 1.3a ['$' for help]

brianredbeard, 2021-07-03:
As folks can see from the automated messages above I spent a moment unwinding the changes made to https://github.com/bdring/Grbl_Esp32.

I'll leave my commentary out of this issue.  For users who want to inspect the changes as a set of four unified diff patches, I've posted them as a gist: https://gist.github.com/brianredbeard/d682717a7fc4f4b3bb98a06bfdf44cc7.

These would be the patches needed to convert _from_ the zip file provided by Spark Concepts _to_ the sources provided in Grbl_Esp32... thus most users will want to watch https://github.com/bdring/Grbl_Esp32/pull/934 or simply retrieve the file `src/Machines/CNC_xPRO_V5_XYYZ_PWM_NO.h` from the pull-request.

brianredbeard, 2021-07-08:
Also, as an FYI, I've discovered that there are (seemingly) _some_ changes which were made for the RS-485 builds which are not reflected in the source bundle.  That assessment stems from the following:

In https://github.com/Spark-Concepts/xPro-V5/issues/18#issuecomment-815652827 we see the following console output:

```
...
[MSG:Initializing RS485 VFD spindle]
[MSG:Undefined VFD_RS485_RTS_PIN]
[MSG:VFD RS485 Tx:GPIO(4) Rx:GPIO(25) RTS:GPIO(0)]
...
```

This was a bit confusing, because even when building from both the supplied source bundle and the upstream code I was seeing the following output:

```
...
[MSG:Initializing RS485 VFD spindle]
[MSG:Undefined VFD_RS485_RTS_PIN]
An unexpected error was detected: [MSG:RS485 VFD spindle errors]
...
```

Based on the code at: [bdring/Grbl_Esp32#eaffb964/Grbl_Esp32/src/Spindles/VFDSpindle.cpp#L369](https://github.com/bdring/Grbl_Esp32/blame/eaffb964f7f1585336b3e354ea59dd544599b815/Grbl_Esp32/src/Spindles/VFDSpindle.cpp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) we see:

```c++
//Lines 366 - 371
#ifdef VFD_RS485_RTS_PIN
        _rts_pin = VFD_RS485_RTS_PIN;
#else
        grbl_msg_sendf(CLIENT_SERIAL, MsgLevel::Info, "Undefined VFD_RS485_RTS_PIN");
        pins_settings_ok = false;
#endif
```

We notice that on the next line that `pins_settings_ok` is set to `false`. This triggers an error state (which it _does_ in the upstream) when `VFD::init()` is called (checking the pin state on line 276) returns before it could then call `config_message()` on line 343.

```c++
        if (!get_pins_and_settings()) {  // line 276
            vfd_ok = false;
            grbl_msg_sendf(CLIENT_SERIAL, MsgLevel::Info, "RS485 VFD spindle errors");
            return;
        }
```

The sleight of hand here is that `config_message()` is clearly called in the first console output stanza above because we see `[MSG:VFD RS485 Tx:GPIO(4) Rx:GPIO(25) RTS:GPIO(0)]` and **_not_** the error on line 278 which appears in the second console output stanza.

As a hail mary (noting the diagnostic output `RTS:GPIO(0)`) I tried setting the following in the machine definition header:

```c++
#define VFD_RS485_RTS_PIN               GPIO_NUM_0
```

Which then reported the following console output:

```
...
[MSG:Initializing RS485 VFD spindle]
[MSG:VFD RS485  Tx:GPIO(4) Rx:GPIO(25) RTS:GPIO(0)]
...
```

After making this change I was able to start the spindle with `M3 S<RPM>`.

I'm not ruling out that _why_ RS-485 not working from the source bundle could be a red herring, but setting the RTS pin to gpio0 **_did_** get things working.

Spark-Concepts, 2021-07-10:
While we do use GRBL_ESP32 core, there are specific changes made throughout to match the specific hardware implemented on the xPRO V5.  Dev files can be downloaded here:  (https://github.com/Spark-Concepts/xPro-V5-Firmware)[https://github.com/Spark-Concepts/xPro-V5-Firmware]

Most options are defined in the CNC_xPRO_V5_Machine_Template.h, simply make changes here, recompile and upload.

mathojojo, 2022-08-07:
Hello,

I see that last sources modifications for the xPro V5 (here : [https://github.com/Spark-Concepts/xPro-V5-Firmware](https://github.com/Spark-Concepts/xPro-V5-Firmware)) were done 2021 November.

Your precompiled firmwares had 2 updates April and June :

April release Note :
- Minor bug fixes
- TMC5160 Tuning
- Fixes bug requiring double reset for Z motor

June release Note :
-  minor bug fixes and motor/current tuning

I successfully compiled the sources, with the your CNC_xPRO_V5_Machine_Template.h file without changing anything, just to see if I ws able to do that : successfully

Does my freshly compiled binary have the bugs you fixed in april and June ? (especially the bug with double reset on Z motor).

My thought is YES, I have thous bugs in my new binary, because I compiled with an old source. But can you confirm it ?

Thank you.

Closed 2021-08-11.

Thread 9 (2021-03-26):

Bluetooth pairing

stfarley, 2021-03-26:
Attempting to access with Bluetooth, the device is not found. I tried enabling “Bluetooth radio mode” now I can’t access it all. The Host WIFI network is not found as well as no Bluetooth device.

TRUDIM, 2021-03-30:
You could connect it via USB and change the settings back to WiFi.

stfarley, 2021-03-30:
Interestingly My MacBook and an android phone see the bluetooth device but not my iPhone or iPad. How does one connect via USB? I have a cable connected to it and the MacBook sees something. I imagine a driver and app are required.

stfarley, 2021-03-30:
I managed to get it recovered. Had to do the following.
Connect to a laptop with USB
Load CNCjs
Enter the command $Radio/Mode=AP
After reseting the network is working again in AP mode again.

stfarley, 2021-04-01:
BTW,
Bluetooth doesn't seem to work.
I can connect to the bluetooth target in CRCjs. The Console opens.
However I can't seem to control anything.

Mboss32, 2021-04-03:
Yep, Bluetooth is available not fully flushed out or advertised.  The plan for the BT connection is an app down the road, but for now it is Wifi or USB only.

philshel1, 2021-04-03:
I'm beginning to believe that most of the "features" are BS and not implemented yet.

Mboss32, 2021-04-03:
Like which ones?  I know there is framework buried for future upgrades but pretty sure all the advertised features are there and functioning.

philshel1, 2021-04-03:
Well, the main one is "Motor drivers can be dynamically assigned to axes, so a 4 motor XYZA controller could be converted to a XYYZ (dual motor Y axis) without any hardware changes."  That is not implemented and when ever someone questions when that will happen, you can hear the crickets.  Plus it appears there are issues with controlling spindles, and now the BT is "buried for future upgrades".  I know that I have not been able to get it to connect to my my network at all, it always reverts back to AP mode no matter how I set it up.  I suspect it' has to do to the radio only wanting to connect to 2.4 GHz like some other ESP32 radios. It may not be ready for primetime I fear.

Closed 2021-04-07.

Thread 10 (2021-04-01):

RS485 controlling a VFD

allistar, 2021-04-01:
The RS485 port has "A" and "B" plugs. How does that relate to the RS- and RS+ connectors on a Huanyang VFD?
I see there's a switch on the XPro V5 to enable the RS485 mode. Is that's all that's needed other than setting $30, $31? What should $Spindle/Type get set to?

stfarley, 2021-04-01:
I am trying to get the same config working. Made the same assumption about the connections. No luck controlling the VFD though.

stfarley, 2021-04-01:
I see there are firmware downloads that appear to have spindle options. I tried one that ended in 485 but still didn't work.

Spark-Concepts, 2021-04-02:
Connect the Huanyang VFD to the xProV5:
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
Using the procedure in the Huanyang manual, set the following register values:

Set PD000 to 0 - unlock parameters
Set PD001 to 2 - Command source is RS485
Set PD002 to 2 - Speed source is RS485
Set PD163 to 1 - Communications address 1
Set PD164 to 1 - 9600 b/s
Set PD165 to 3 - 8 Bit No Parity - RTU
Set PD000 to 1 - lock parameters
[Huanyang-VFD-manual.pdf](https://github.com/Spark-Concepts/xPro-V5/files/6247012/Huanyang-VFD-manual.pdf)

allistar, 2021-04-02:
Thank for the VFD config, I've made those changes. Can you confirm these settings:

- in the VFD do we leave the J1 jumper on the right hand two pins, or move it to the left hand two pins?
- on the XPro we move the little switch to the "RS485 A/B" setting?
- What do we set "$spindle/type" to? I notice that this is valid "$spindle/type=huanyang". Is that the correct one to use?
- What other "$spindle" settings do we need to change to get this to work?

When the VFD is powered on he display is flashing with F0000. I assume that's because it's waiting for commands from the RS485 input?

Thanks,
Allistar.

stfarley, 2021-04-02:
OK,
I tried this config with CNC_xPRO_V5_XYYZ_485_NC.bin
Still no luck with the VFD

If I send
S100
M23

I get and Invalid Gcode error.
The VFD just flashed 00000.

I also got an Alarm 10 at one point. Not sure what that is about.

stfarley, 2021-04-02:
BTW I took a look at the signalling with a scope. I see what appears to be some continuous messaging coming across the interface. Strangely though it appears that the signals on both the A and B lines are in the same phase. Should these not be differential? I also see a lot of common mode noise.
RS 485 protocol decoding seems to make sense although I don't know what data I should be seeing.

allistar, 2021-04-02:
I finally have this working. Here's what I did:
- follow the wiring instructions and VFD settings provided previously on the issue.
- download the latest firmware (CNC_xPRO_V5_XYYZ_485_NO.bin). Install that firmware.
- send this command to the XPro: "$spindle/type=huanyang"

Now an "M3" starts the spindle and "M5" stops it. I have my "max spindle speed" set to 3000 which I don't think is right because it doesn't match what the spindle can do. I need to double check the settings. But at least it's working now.

It would be good if the wiki docs mention the "huanyang" spindle/type setting. At the moment there isn't any spindle/type in the docs that seem to be for RS485.

allistar, 2021-04-02:
I believe I now have this working fully. I have no idea how fast the spindle is actually running but I can tell that the "S" Gcode speed commands matches the frequency I would expect. The second number is the frequency shown on the VFD:

S500 = 8.33
S1000 = 16.66
S3000 = 50
S10000 = 166.6
S20000 = 333.3

I didn't push it more than this, I flinch when it's going that fast!

I notice in the ESP3D web page that pressing the "spindle" button doesn't do anything. I would expect this to start and stop the spindle. The only way I can start it is with M3 and M5 Gcode code commands. Is there a trick to getting the spindle button working?

Mboss32, 2021-04-05:
the $spindle/type = " does need to be defined (this should be done by default in the 485 firmware, looking into that now).   Could you send command $I to your board and paste the response here?

The spindle button in the websender is an override stop - this is only an option when a gcode file has been paused.  You will need to send M3 and the speed number to turn on the spindle, M5 to turn off.  I would recommend defining a macro if this is something you want to do frequently.

allistar, 2021-04-05:
I have the spindle working well now. The $spindle/type is set to "huanyang". I've added buttons to the ESP32 interface to manually start and stop the spindle, this works well. I'm now only using ESP32 for GRBL configuration and am using CNCjs for running programs.

stfarley, 2021-04-06:
What I get is this
$I
[VER:1.3a.20201212:]
[OPT:MPHBSW]
[MSG:Using machine:CNC_xPRO_V5_XYYZ_RS485_NC]
[MSG:Mode=AP:SSDI=CNC_xPRO_V5:IP=192.168.0.1:MAC=3C-71-BF-DE-A8-6D]
[MSG:No BT]
ok

stfarley, 2021-04-06:
Also tried
$Spindle/type=h2a
Still get a Gcode error when I try and start the spindle

Mboss32, 2021-04-06:
What is the gcode statement you are sending?  What brand is your spindle - with 485 each VFD manufacturer has a different set of commands (so an H2A setting for an HY spindle will do weird things)

stfarley, 2021-04-06:
It is a Huanyang VFD controller.

Mboss32, 2021-04-06:
Good, you need to set "$spindle/type=huanyang"

How are you trying to start the spindle when you get the gcode error?  Are you using a button, sending an M3 command, etc

stfarley, 2021-04-06:
Ah My mistake. I thought I read somewhere M23 to start. Using the correct command works much better.
BTW I see you recommended 100 for Min speed. (Water cooled) This value is in Hz which corresponds to 6000RPM. Is that the expectation?

Mboss32, 2021-04-06:
you know, I saw M23 above but thought it was a typo for M3... should have caught that!  Glad to hear it is working now :)

For water-cooled spindles, the 100 min speed (6000RPM) is the general recommendation.  For a 4pole spindle you can go a bit slower. Note: these are generally accepted values/recommendations - each spindle manufacturer will vary, if you can find a datasheet for the spindle you purchased always follow that.

Closed 2021-04-07.

Thread 12 (2021-04-01):

How would I best square the X Axis on a dual Y machine

stfarley, 2021-04-01:
With two Y Axis motors I would expect that one would need to regularly square the X Axis.
The only process I can come up with for this is to run it close to one end, Turn off the controller and manually spin one stepper motor until both sides are the same distance from the end plate.

Any better ideas?

TRUDIM, 2021-04-02:
I am struggling squaring the frame as well. Had been following instructions to move the X axis all the way to the front until it hits the front support (on a LEAD 1515) and supposedly it will square it. Once i get the bolts tight on the front am moving the X axis to the back of the machine for it to be square and it all goes to hell.
Measuring diagonals I get a deviation of about 7-8mm. I did this procwdure several times using all kind of different approaches with no luck.
Decided on leaving it like that for now so that I could at least start using the cnc...

allistar, 2021-04-02:
I've just build a Lead 1515 and I got the X axis squared with Y using digital calipers. I move both Y gantries near the front of the machine and measured exactly how far away the gantry was from the end. I then turned the lead screws by hand which would move one gantry very slightly in the direction needed. I'd then measure it again. It's within 0.1mm which is good enough for me. The frame itself came out nearly perfectly square (when measuring diagonals).

I found squaring the dual X C-beams was much more difficult (I have the high-Z mod). That's now within 0.1mm across 1500m which is good enough for me.

stfarley, 2021-04-06:
I assume there will still be an issue any time a stepper slips though. This Manual process would need to be done pretty regularly. Is there a method that uses two limit switches that would allow it to re-square everything time you home.

allistar, 2021-04-06:
Yes, if a single Y stepper misses steps then it will put it out of square. I'm not sure with the XYYZ setup if it can control the two Y steppers independently. One approach could be to home it, then unplug the stepper that's in the correct position and then home again with just the other stepper plugged in. Though if the homing sequence moves 5mm that may be too much to force it out of square (5mm for my machine would be 1000 steps which is heaps).

Another approach is to mark on the Y rails alignment marks every 10mm or so so that at any time you can see if the gantry is square by lining it up one one side of the each Y gantry plate. This way squaring by hand becomes a lot easier. If my machine loses steps in the Y direction this is probably what I'll do.

tobyrobb, 2021-04-09:
I thought there was an option for dual homing y axis, but now i cant find it..

nxperera, 2021-04-13:
Here is what I do :  With xPro V5 I set $Homing/Squared=y and fixed additional limit switch on the second Y connect both parallel to Y limit switch input in controller. make sure line of two limit switches is perpendicular to Y axis.  And I use command $HY to home just Y axis first which will do squaring also.
(once you square like this once use 3-4-5 method to manually verify if the CNC is squared properly if you miss any alignments adjust the limit switch to compensate the miss alignment. This is a repetitive, trial and error process until you get it perfect. Obviously the accuracy/repeatability of  limit switch affect the accuracy of squaring, I find the 4mm Inductive Proximity Switch(SN04-N DC NPN)  works OK for me.)

stfarley, 2021-04-13:
In order to square up, wouldn't each switch need it's own input? If you parallel them the controller can only tell that one of them has hit it's limit (If they are NO) or that both have hit their limits (if they are NC). In order to square it the controller would  need to know when that one limit has been hit and keep moving the second one until it trips.

nxperera, 2021-04-15:
> In order to square up, wouldn't each switch need it's own input? If you parallel them the controller can only tell that one of them has hit it's limit (If they are NO) or that both have hit their limits (if they are NC). In order to square it the controller would need to know when that one limit has been hit and keep moving the second one until it trips.

Not really actually. The Squaring routine first back off both motors/rails (Y and A) and then it try homing one at a time. First Y motor then A motor. Yes both limit switches Y and A are connected to same Y limit input but it get triggered one at a time in final squaring. Let me explain step by step how it works for me:
1. run $Home/Y
2.  both Y and A motors rapid toward homing direction one or both ( depending on proximity) limits switches get triggered .
3. Then both Y and X bounce back by the amount given in $Homing/Pulloff
4. Seek Y motor until it triggers Y Limit, and bounce
5. Seek A motor until it triggers Y Limit, and bounce
6. Y machine zero is set

Mboss32, 2021-04-16:
great summary of the squaring routine nxperera!  Only note I would add is that NO switches must be wired in parallel on the Y axis limit plug, NC switch needs to be wired in series to the Y axis limit plug.  This way the controller can read a single switch trigger based on which motor, Y or Y2 is moving.  This is only as accurate as the placement, and sensing, of your switches though.  If your switches as 2mm off so will be the final squaring.

nxperera, can you give more detail on what went weird on the new firmware?

nxperera, 2021-04-16:
I'll reload NC_xPRO_V5_XYYZ_PWM_NO.bin tonight and confirm exact details but as I remember now what happened was it tried to seek Y and A at the same time and failed also what I noticed was the steppers were creeking too loud and felt something was so wrong.

allistar, 2021-05-21:
I see there's mention of squaring in the settings wiki page, but the link doesn't yet go anywhere. Is the $Homing/Squaring  functionality developed and just needs documenting, or is this still a work in progress?

allistar, 2021-08-10:
For this auto squaring solution to work I think we need to be able to set difference "bounce off" values for each Y axis. This means the limit switches don't need to be absolutely perfectly aligned. If one if offset from the other by 0.5mm then we could adjust that axis bounce value to be 0.5mm more (or less). Finding what this value should be would be pretty straight forward with some digital calipers.

I'm quite keen to get this functionality working. Do you entertain the possibility of letting other people submit pull requests to the controller code?

TRUDIM, 2021-08-10:
Yes, please! 😁

Spark-Concepts, 2021-08-11:
Absolutely would take a pull request.  sounds like a great addition to the squaring feature

allistar, 2021-08-11:
Should this be a change to the upstream GRBL32 code or is the XPro code base different enough that it should be only in the XPro code?

Spark-Concepts, 2021-08-12:
Good question, ideally push to the upstream GRBL32 code so more folks can use it.  Our changes are strictly for the hardware integration.  This would likely need to include the use of the Y2 limit pin, the current squaring routine checks only the Y and cannot differentiate between the Y1 or the Y2 sides.

allistar, 2021-08-12:
If both limits were connected as NC in series or NO in parallel then they could both be plugged into a single input on the controller. We don't need to differentiate which Y gantry trips the limit switch, only that one has. I'll investigate the upstream repo and discuss this with their maintainers.

allistar, 2021-08-12:
It looks like this feature is already implemented in Grbl_Esp32:
https://github.com/bdring/Grbl_Esp32/wiki/Motor-Ganging-and-Axis-Squaring
The code for this appears to be here:
https://github.com/bdring/Grbl_Esp32/blob/main/Grbl_Esp32/src/MotionControl.cpp#L353

If this is right, what will it take to get this into the XPro firmware source?

allistar, 2021-08-12:
The ability to set independent offsets for each limit switch has been implemented in a beta branch, the details of this are here:

https://github.com/bdring/Grbl_Esp32/issues/953

Spark-Concepts, 2021-08-12:
Nice thank you!  We are tracking the YAML development but wont implement it until it comes out of Beta and we get a chance to torture test it.

The general squaring routine is implemented, you can turn it on using  $Homing/Squared=Y, then executing command $Hy

allistar, 2021-08-12:
The new fluid homing supports homing the Y axis without forcing it out of square. It's nice that the XPro V5 has two Y limit switch inputs to support this.

AzionHzmilton, 2022-06-05:
Sorry - relatively new to this but I'm not clear base on the comments above if I need to still wire my limit switches in series or with the new fluid homing, I'd be just wiring up the second switch directly.  Is there a doc that outlines the wiring and process for multi switch squaring?

hellboytat, 2022-06-06:
Im also interested in this!

ImagineerNL, 2022-08-17:
@Spark-Concepts , would have been great if the [information given in the closed issue](https://github.com/Spark-Concepts/xPro-V5/issues/93#issuecomment-1003234085) would have been stated here as well as in the wiki.

> For axis squaring, this can be done with the default firmware using 2 switches on the Y limit port

So for Automatic squaring of your Y Axis:

1. Install a limit switch on both of the Y Axes, making sure both limit switches are positioned **exactly** the same distance from the start of the Axis.
2. Wire and plug both limit switches to the **same** Y limit switch port. ; this means that the Y2 limit switch is **NOT** connected to the A/Y2 port. Currently the A/Y2 limit switch port seems to be out of use.
3. power on the controller.
4. trigger the Y1 limit switch by hand. confirm it triggers.
5. reset and reconnect (if you have hard limits enabled)
6. trigger the Y2 limit switch by hand. confirm it triggers
7. reset and reconnect (if you have hard limits enabled)
8. in console: $Homing/Squared=Y
9. click on the Y home in the jogging panel or type $Hy in the console
10. watch the Y home closely while keeping your hands close to the emergency stop.

What should be happening.

1. Y Homes until it hits any of the 2 switches.
2. System will debounce both Y1 and Y2 motors
3. System will slowly move Y1 motor until it reaches the limit switch again and debounce a bit.
4. System will then slowly move Y2 motor until it reaches the limit switch and debounce a bit.

This should square out the system as long as you are 100% sure both limit switches are in exactly the same spot.

Thread 15 (2021-04-04):

Probe failure

allistar, 2021-04-04:
I have the probe hooked up but am getting an error when running a probe cycle: _Probe fail. Probe is not in the expected initial state before starting probe cycle._

I know that the wiring is good as I tested it with a multimeter. There is no short. However, when it's plugged into the xPRO the multimeter shows a connection between the probe plate and the little clamp. This connection is coming from inside the xPRO. It doesn't matter what $probe/invert is set to. When it's plugged in the little green probe light on the side of the xPRO turns on. When I touch the clamp to the probe plate the green light gets brighter.

Does anyone have any suggestions on how I diagnose this? Are there any internal jumpers I can change?
I'm running the latest "XYYZ, 485, NC" firmware.
Thanks.

Mboss32, 2021-04-05:
do you have an NO or NC probe?  If you unplug the probe from the xPRO, does the green probe light stay on?

allistar, 2021-04-05:
It's NO. When the probe isn't plugged in the light isn't on. The light on the side of the XPro works as expected - it lights up with the touch probe "touches" and turns off when it doesn't. But it doesn't work when actually running a touch sequence.

There's a possible cause of this issue which I will investigate after work: I'm using shielded 4 core stepper motor wire for both the touch probe and the E stop (both pairs run down the length of the machine together in a single insulated wire). The E-stop is NC which means that while the machine is powered on it has current running down it. I wonder whether this is interfering with the probe wires and giving a false positive reading. I'll try with separate wires to see if it fixes it.

Mboss32, 2021-04-06:
Let me know how the test goes - since the light on the xPRO goes off when you unplug the probe, the issue is somewhere in the plug, probe, or wiring.  One very common issue is wire strands crossing between slots on the plug-in connector - if you see any of these, remove the wires from the plug, and re-insert carefully, or twist and tin the wire before inserting.

allistar, 2021-04-08:
I finally figured it out. The probe worked always, just not when the clip was clamped to the bit in the spindle. The reason is that the wire connected to the spindle needs to go to the ground wire on the probe plug. I assume this is because the spindle is grounded. With it the other way around it wouldn't work. It was a simple problem in the end and the probe is now working well.
Thanks for your help with this.

tobyrobb, 2021-04-08:
My machine spindle is also grounded and so having the red "positive" conductor connected to the clip triggers the probe logic also..

Mboss32, 2021-04-08:
Thanks for letting us know, I'll make sure that an alternate wiring diagram is available for the grounded spindles/machines

Closed 2021-04-08.

Thread 16 (2021-04-05):

OpenBuilds Interface pendant

allistar, 2021-04-05:
Are UART pins exposed in some way so this can be plugged into the XPro?

https://docs.openbuilds.com/doku.php?id=docs:interface:start

Mboss32, 2021-04-06:
The UART pins are not exposed, however, and fire table (~$49) over WiFi gives many of the same features :)

allistar, 2021-04-06:
Thanks. Can you provide a link to the "Fire Table"? A google search doesn't reveal anything.

Mboss32, 2021-04-07:
Sorry, that was a typo - [Amazon Fire Tablet ](https://www.amazon.com/dp/B07FKR6KXF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)

connect to the wifi -> looks like this :)

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

Note: some android versions do not like the captive portal so you may need to open a browser and navigate to 192.168.0.1 (AP mode) or your designated station IP.

allistar, 2021-04-07:
Ah, I see! Thanks. My other machine uses LinuxCNC and I like the "continuous jog" feature (I use an xbox controller for this). Is this possible with a non realtime system like GRBL? It's annoying to have to nudge the axis 100mm at a time. Also, can I control ESP32 on a tablet while I'll running a program using CNCjs? Or does one prevent the use of the other?

Mboss32, 2021-04-08:
The ability for a continuous jogs is built into the firmware but very few of the sender programs have them implemented.  It is on the roadmap for the WebUI refresh but is further down the list, so for now, we are still in discrete jogging mode.

You can run the WebUI and a CNCjs at the same time.  Machine positions will track between the two as well.  Just start CNCjs first as it spits out a bunch of initialization statements at the start.  Also, don't initialize a USB connection during a cut from the SD card - the USB connection forces a restart of the firmware and you will lose your cut :).

allistar, 2021-04-09:
Is continuous jogging just a case of sending it a particular $ command to turn jogging on and then another command to turn it off?

Is there a way to get something like an XBox controller to allow the machine to be jogged by moving the joystick (up = y, left/right = X)? On Linux CNC it's a case of mapping the XBox inputs to key presses that the Axis UI responds to. I understand though that LinuxCNC is realtime while GRBL isn't.

Or is it the case with GRBL based systems that everyone jogs by repeatedly "nudging" it in fixed increments?

Closed 2021-09-16.

Thread 17 (2021-04-06):

Connecting router

TRUDIM, 2021-04-06:
What am I not connecting right as it seems that I am not able to turn my router on/off using M3/M5 commands? I can hear the relay inside the xPro click but the router does not turn on.
What I am using to connect the router to the xPro is an old power socket where the router is plugged in (did not wanted to cut the plug on the router) and that goes into the controller via TOOLHEAD's ground and power.

I see that there is an IoT relay used in the illustrations but is that the only way?!?

Mboss32, 2021-04-07:
Could you upload a picture of your setup?

TRUDIM, 2021-04-07:
There it is. It's just a temporaty setup until everything works as it should!

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

Mboss32, 2021-04-08:
Thanks - that connection is a 0-5V pwm output.  This is a control signal typically used to either trigger a relay (like the IoT) or to drive a DC speed controller or VFD.  This output will not be able to power a router.

Instead of the IoT Relay you could also use a Solid State Relay.

TRUDIM, 2021-04-08:
So in my understanding an SSR of this type will do the job?
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

Spark-Concepts, 2021-04-08:
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

TRUDIM, 2021-04-08:
At possition 1 on the SSR I have to hook it up to a power outlet? SSR controlls through ground or phase (don't think it matters)?
Does the higher current SSR means lower temperature?

Spark-Concepts, 2021-04-08:
Correct,

The SSRs are able to switch the "ON" and "OFF" state of the load very quickly through the electronic circuit, just like the function of traditional mechanical relays. Compared with the Electromechanical relay, there is no movable mechanical part inside the SSR, and there is also no mechanical action during the switching process of the SSR. Therefore, the Solid-State Relay is also called "non-contact switch". The main advantages of solid state relays are as follows:
- The semiconductor component acts as a switch for the relay, which is small in size (compact size) and long in life (long lifetime).

- Better Electro-Magnetic Compatibility than EMR - immunity to Radio Frequency Interference (RFI) and Electro-Magnetic Interference (EMI), low electromagnetic interference, and low electromagnetic radiation.

- No moving parts, no mechanical wear, no action noise, no mechanical failure, and high reliability.

- No spark, no arc, no burning, no contact bounce, and no wear between contacts.

- High sensitivity, low electrical level (3.3V) control signals (SSR can directly drive large current loads through the small current control signals), compatible with logic circuit (TTL, CMOS, DTL, HTL circuits), easy to implement multiple functions.

Your neutral (ground) wire from your power cord are left uncut as is; however, Position 1 and 2 connect in series with your 220VAC Line (or Phase) - when an isolated voltage is applied to position 3 and 4 (3.3V and Ground from the xPro), Position 1 and 2 essentially make contact thus providing power to your router. When the 3.3V is removed, Position 1 and 2 open effectively removing voltage from your router

Higher Amperage means lower ON resistance (thus less potential heat) - when the SSR is triggered "ON" - make sure its rated above what router is rated at. Also, make sure the minimum "Input" side is rated at 3.2V...otherwise the SSR wont trigger.

TRUDIM, 2021-04-09:
That's some great info! Thank you!
I'll get two SSR's right away! So in order to automate the dust extraction I have to do the same hook up but at COOL output?

Regards,
Dimitar

Spark-Concepts, 2021-04-10:
TRUDIM,

Yes to answer your question you would do the same hook up, but to the COOL output.
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

TRUDIM, 2021-04-13:
Allright!

I got the relays, made a quick setup to see if everything works and got an issue.
When I engage M3 or M7 the relays are both outputting 240V, oddly when I plug in the Roüter11 in any of the two EU sockets the router starts working on impulses. The whole thing just pulsates and is not running smoothly (like I am rapidly switching it on and off). If plugged in a normal wall socket it works as it should. This problem occurs with other tools but is barely noticeable!
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

Made a quick video for better illustration of the problem.
https://drive.google.com/file/d/1K5bbKMFTtgrnaZ7H0XmYZfkh5KdnADoF/view?usp=sharing

Spark-Concepts, 2021-04-15:
TRUDIM,

If you don't mind move the "MIST" jumper<sub>1</sub> over to 24V as shown below and see if you're still getting the pulsations when triggering on the COOL output.
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

TRUDIM, 2021-04-16:
Installed ine of these: https://www.google.com/amp/s/www.digchip.com/datasheets/parts/datasheet/2135/S14K385_amp.php

Didn't change the router behavior. Will try connecting it to the on board telay. Might also get a more expensive SSR. The one I got was really cheap conpared to others...

Closed 2021-04-21.

Thread 18 (2021-04-08):

Huanyang VFD Control Issue

Genza12, 2021-04-08:
Controller side - I've updated the firmare to the **CNC_xPRO_V5_XYYZ_485_NO.bin** firmware following th instructions in the wiki, but when i try to issue the command **$Spindle/Type=HUANYANG // RS485** or **$Spindle/Type=H2A // RS485** the console spits out **error:2 (Bad number format)**. When trying to start the spindle the console spits out **[MSG:Critical Spindle RS485 Unresponsive]
ALARM:10**.

VFD side - I have connected the A on the controller to RS+ on the VFD and the B to RS-. Pd001 and Pd002 have both been set to 2 and the jumper is attached to VI. The Baud rate setting on the VFD is set to 9600 but when changing it on the CNCjs software to anything but 115200 I get no response from the software to any command what so ever.

Any help would be greatly appreciated.

Genza12, 2021-04-08:
Update, Im now able to turn on the spindle using M3 but this is the error I now get.

**Guru Meditation Error: Core  1 panic'ed (Coprocessor exception)
Core 1 register dump:
PC      : 0x400df3cd  PS      : 0x00060431  A0      : 0x800defcf  A1      : 0x3ffbe800
A2      : 0x3ffd851c  A3      : 0x00000001  A4      : 0x000000ff  A5      : 0x00000000
A6      : 0x00000001  A7      : 0x3ffc7194  A8      : 0x00000001  A9      : 0x3ffbe8c0
A10     : 0x000000ff  A11     : 0x00000000  A12     : 0x3ffd8b68  A13     : 0x00000000
A14     : 0x00000000  A15     : 0x00000000  SAR     : 0x0000000b  EXCCAUSE: 0x00000004
EXCVADDR: 0x00000000  LBEG    : 0x4000c349  LEND    : 0x4000c36b  LCOUNT  : 0x00000000
Core 1 was running in ISR context:
EPC1    : 0x400df3cd  EPC2    : 0x00000000  EPC3    : 0x00000000  EPC4    : 0x4008866c
Backtrace: 0x400df3cd:0x3ffbe800 0x400defcc:0x3ffbe8f0 0x400d54fc:0x3ffbe920 0x40081f7b:0x3ffbe940 0x40082405:0x3ffbe960 0x40085e35:0x3ffbe980 0x4000bfed:0x3ffbcac0 0x40091242:0x3ffbcad0 0x4008fc60:0x3ffbcaf0 0x4008fdd9:0x3ffbcb30 0x40082dd1:0x3ffbcb50 0x4013b362:0x3ffbcb70 0x4013b3fd:0x3ffbcb90 0x4013b7bf:0x3ffbcbb0 0x400ee5f5:0x3ffbcbe0 0x400eb2c1:0x3ffbcc10 0x400eafa4:0x3ffbcc30 0x400daafc:0x3ffbcc50 0x4009030d:0x3ffbcc70
Rebooting...
ets Jun  8 2016 00:22:57
rst:0xc (SW_CPU_RESET),boot:0x17 (SPI_FAST_FLASH_BOOT)
configsip: 0, SPIWP:0xee
clk_drv:0x00,q_drv:0x00,d_drv:0x00,cs0_drv:0x00,hd_drv:0x00,wp_drv:0x00
mode:DIO, clock div:1
load:0x3fff0018,len:4
load:0x3fff001c,len:1216
ho 0 tail 12 room 4
load:0x40078000,len:9720
ho 0 tail 12 room 4
load:0x40080400,len:6352
entry 0x400806b8
[MSG:Grbl_ESP32 Ver 1.3a Date 20201212]
[MSG:Compiled with ESP32 SDK:v3.2.3-14-gd3e562907]
[MSG:Using machine:CNC_xPRO_V5_XYYZ_RS485_NO]
[MSG:Axis count 3]
[MSG:RMT Steps]
[MSG:Init Motors]
[MSG:TMCStepper Library Ver. 0x000701]
[MSG:X  Axis Trinamic TMC5160 Step:GPIO(12) Dir:GPIO(14) CS:GPIO(17) Disable:None Index:1 R:0.050 Limits(0.000,300.000)]
[MSG:X  Axis Trinamic driver test passed]
[MSG:Y  Axis Trinamic TMC5160 Step:GPIO(27) Dir:GPIO(26) CS:GPIO(17) Disable:None Index:2 R:0.050 Limits(0.000,300.000)]
[MSG:Y  Axis Trinamic driver test passed]
[MSG:Y2 Axis Trinamic TMC5160 Step:GPIO(33) Dir:GPIO(32) CS:GPIO(17) Disable:None Index:3 R:0.050 Limits(0.000,300.000)]
[MSG:Y2 Axis Trinamic driver test passed]
[MSG:Z  Axis Trinamic TMC5160 Step:GPIO(15) Dir:GPIO(2) CS:GPIO(17) Disable:None Index:4 R:0.050 Limits(-300.000,0.000)]
[MSG:Z  Axis Trinamic driver test passed]
[MSG:Initializing RS485 VFD spindle]
[MSG:Undefined VFD_RS485_RTS_PIN]
[MSG:VFD RS485  Tx:GPIO(4) Rx:GPIO(25) RTS:GPIO(0)]
[MSG:Local access point CNC_xPRO_V5 started, 192.168.0.1]
[MSG:Captive Portal Started]
[MSG:HTTP Started]
[MSG:TELNET Started 23]
[MSG:Flood coolant on pin GPIO(21)]
[MSG:Mist coolant on pin GPIO(21)]
[MSG:X  Axis limit switch on pin GPIO(35)]
[MSG:Y  Axis limit switch on pin GPIO(34)]
[MSG:Z  Axis limit switch on pin GPIO(39)]
[MSG:Probe on pin GPIO(22)]
Grbl 1.3a ['$' for help]
[MSG:Check limits]
[MSG:'$H'|'$X' to unlock]**

Genza12, 2021-04-08:
After Homing and trying to turn on the spindle I get an **ALARM:1 (Hard limit)**.

allistar, 2021-04-08:
Can you confirm you entered this command:
$Spindle/Type=HUANYANG
Without the "// RS485"at the end?

Also, when you type just "$spindle/type" what does it return? On mine it returns "Huanyang".

The baud rate in CNCjs is for the connection to the XPro, not the connection from the XPro and the VFD.
The Hard Limit seems related to the homing, not to the VFD. How are you trying to turn the VFD on? A "M3" should do it.

Genza12, 2021-04-08:
I have defined the spinfle type as huanyang without the // rs485.
When typing $spindle/type it returns huanyang.

when trying to turn the vfd on I issue an M3 command, it begins to start but straight away stops and throws up a hard limit alarm 1.

Genza12, 2021-04-08:
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

Genza12, 2021-04-08:
Update - So if I issue an M3 it will throw up all of that above but if I quickly issue a $X then another M3 S24000 then it will work and I will be able to change the speed and much as I want, when I then issue an M5 it will turn off but as soon as it stops its throws up all of those messages again. See Below.

**[MSG:Check limits]
[MSG:'$H'|'$X' to unlock]
> $x
[MSG:Caution: Unlocked]
ok
> m3
ok
> m3 s24000
ok
> m5
ok
Guru Meditation Error: Core  1 panic'ed (Coprocessor exception)
Core 1 register dump:
PC      : 0x400df3cd  PS      : 0x00060c31  A0      : 0x800defcf  A1      : 0x3ffbe800
A2      : 0x3ffd8524  A3      : 0x00000001  A4      : 0x000000ff  A5      : 0x00000000
A6      : 0x00000001  A7      : 0x3ffc7194  A8      : 0x00000001  A9      : 0x3ffbe8c0
A10     : 0x000000ff  A11     : 0x00000000  A12     : 0x3ffd8b70  A13     : 0x00000000
A14     : 0x00000000  A15     : 0x00000000  SAR     : 0x0000000b  EXCCAUSE: 0x00000004
EXCVADDR: 0x00000000  LBEG    : 0x4000c349  LEND    : 0x4000c36b  LCOUNT  : 0x00000000
Core 1 was running in ISR context:
EPC1    : 0x400df3cd  EPC2    : 0x00000000  EPC3    : 0x00000000  EPC4    : 0x4008866c
Backtrace: 0x400df3cd:0x3ffbe800 0x400defcc:0x3ffbe8f0 0x400d54fc:0x3ffbe920 0x40081f7b:0x3ffbe940 0x40082405:0x3ffbe960 0x40085e35:0x3ffbe980 0x400ddf76:0x3ffd9350 0x400de04d:0x3ffd9370 0x4009030d:0x3ffd93c0
Rebooting...
ets Jun  8 2016 00:22:57
rst:0xc (SW_CPU_RESET),boot:0x17 (SPI_FAST_FLASH_BOOT)
configsip: 0, SPIWP:0xee
clk_drv:0x00,q_drv:0x00,d_drv:0x00,cs0_drv:0x00,hd_drv:0x00,wp_drv:0x00
mode:DIO, clock div:1
load:0x3fff0018,len:4
load:0x3fff001c,len:1216
ho 0 tail 12 room 4
load:0x40078000,len:9720
ho 0 tail 12 room 4
load:0x40080400,len:6352
entry 0x400806b8
[MSG:Grbl_ESP32 Ver 1.3a Date 20201212]
[MSG:Compiled with ESP32 SDK:v3.2.3-14-gd3e562907]
[MSG:Using machine:CNC_xPRO_V5_XYYZ_RS485_NO]
[MSG:Axis count 3]
[MSG:RMT Steps]
[MSG:Init Motors]
[MSG:TMCStepper Library Ver. 0x000701]
[MSG:X  Axis Trinamic TMC5160 Step:GPIO(12) Dir:GPIO(14) CS:GPIO(17) Disable:None Index:1 R:0.050 Limits(0.000,300.000)]
[MSG:X  Axis Trinamic driver test passed]
[MSG:Y  Axis Trinamic TMC5160 Step:GPIO(27) Dir:GPIO(26) CS:GPIO(17) Disable:None Index:2 R:0.050 Limits(0.000,300.000)]
[MSG:Y  Axis Trinamic driver test passed]
[MSG:Y2 Axis Trinamic TMC5160 Step:GPIO(33) Dir:GPIO(32) CS:GPIO(17) Disable:None Index:3 R:0.050 Limits(0.000,300.000)]
[MSG:Y2 Axis Trinamic driver test passed]
[MSG:Z  Axis Trinamic TMC5160 Step:GPIO(15) Dir:GPIO(2) CS:GPIO(17) Disable:None Index:4 R:0.050 Limits(-300.000,0.000)]
[MSG:Z  Axis Trinamic driver test passed]
[MSG:Initializing RS485 VFD spindle]
[MSG:Undefined VFD_RS485_RTS_PIN]
[MSG:VFD RS485  Tx:GPIO(4) Rx:GPIO(25) RTS:GPIO(0)]
[MSG:Local access point CNC_xPRO_V5 started, 192.168.0.1]
[MSG:Captive Portal Started]
[MSG:HTTP Started]
[MSG:TELNET Started 23]
[MSG:Flood coolant on pin GPIO(21)]
[MSG:Mist coolant on pin GPIO(21)]
[MSG:X  Axis limit switch on pin GPIO(35)]
[MSG:Y  Axis limit switch on pin GPIO(34)]
[MSG:Z  Axis limit switch on pin GPIO(39)]
[MSG:Probe on pin GPIO(22)]
Grbl 1.3a ['$' for help]
[MSG:'$H'|'$X' to unlock]**

tobyrobb, 2021-04-08:
I'm also having trouble with rs485 on my VFD , any hints on debugging rs485? How do I see what's being sent out on the 485 serial? Or can tell tell me if it is connected via 485 ok? Or do l get out my USB to serial and snoop the 485?

Mboss32, 2021-04-08:
@Genza12, sounds like a lot going on here.  It sounds like you got the setup sorted out but could you confirm that the wiring and all the registers have been set as below?

Connect the Huanyang VFD to the xProV5:
 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
 Using the procedure in the Huanyang manual, set the following register values:

 Set PD000 to 0 - **unlock parameters**
 Set PD001 to 2 - **Command source is RS485**
 Set PD002 to 2 - **Speed source is RS485**
 Set PD163 to 1 - **Communications address 1**
 Set PD164 to 1 - **9600 b/s (3 - 38400)**
 Set PD165 to 3 - **8 Bit No Parity - RTU**
 Set PD000 to 1 - **lock parameters**
 [Huanyang-VFD-manual.pdf](https://github.com/Spark-Concepts/xPro-V5/files/6247012/Huanyang-VFD-manual.pdf)

 _Also verify the following settings (based on the values on the motor's nameplate)_

 PD004 **Base frequency as listed on spindle (typically 400)**
 PD005 **Maximum frequency Hz (typical value for spindles is 400)**
 PD011 **Min speed (Recommended Air-cooled=120 Water=100)**
 PD014 **Acceleration time** (Test to optimize)
 PD015 **Deceleration time** (Test to optimize)
 PD023 **Reverse run enabled (set to 1)**

 PD141 Spindle max rated voltage (Typically 220)
 PD142 **Max rated motor current (0.8kw=3.7, 1.5kw=7.0, 2.2kw=??)**
 PD143 Motor Poles **This parameter is set for the number of the motor’s pole according to the nameplate of the motor - I believe this is only used for the conversion of Hz to RPM (typically 2 or 4)**
 PD144 **Rated Motor Revolution at 50Hz (Typically 3000 @ 50Hz and 24000 @ 400Hz)**

Next Step:

Set **$Spindle/Type=HUANYANG** without the //RS485, that was placed as a comment but definitely see how it is confusing.

Now for the M3 command causing a Hard Limit trigger, since you are able to successfully home the machine without triggers, this is almost certainly noise caused by the VFD/spindle wire.   For a quick test set **$Limits/Hard=Off** then execute the M3 command.  Options from here are to keeping Homing Enabled but run the machine without the Hard limits (most common as most folks are really only using homing switch, not limit switches anyways), or upload a few pictures and we can start digging into noise isolation.

Mboss32, 2021-04-08:
@tobyrobb, check the setup on the comment directly above.

For debugging, the best route is to use CNCjs and check the start-up/initialization messaging that comes out over USB.
1) Power on your VFD, power on xPRO
2) Open CNCjs, connect to the Silicon Labs port
3) Hit the physical **Reset** button on the xPRO

This will spit out a bunch of information - you are looking for the spindle information (directly below the trinamic self-tests)
If there is an issue with the communication you will see something like this:
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

While a successful start will look like this:
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

If still unsuccessful a few things to check:
1) One of the RS485 specific firmwares are loaded (CNC_xPRO_V5_....**_485_**..)
2) The switch to select the EN/PWM or RS485 mode on the xPRO V5 uses a long actuator and will sometimes not fully seat.  Flip the switch back to the EN/PWM side then flip it to the RS485 side (use a small driver to make sure the base of the actuator has flipped fully)

tobyrobb, 2021-04-09:
@Mboss32  thanks for your help. The VFD is now working successfully.  BTW i am using the opencontrol software through the bluetooth serial and its working great, however, i have to reset the board each time to upload firmware via the webui. then set it back to BT and redo my settings. The GRBL settings page also does not allow me to save settings to the board but serial commands are doing it np.

tobyrobb, 2021-04-09:
@Mboss32 interestingly the Z axis was unresponsive when runinng the new CNC_xPRO_V5_XYYZ_485_NO.bin - working OK on CNC_xPRO_V5_XYYZ_RS485.bin

Genza12, 2021-04-09:
@Mboss32 All the parameters were set according to your instructions, I turned off hard limits and it seems to be working now.
When I turned it on, the Z axis was unresponsive at first as for some reason the stepper was not being powered, It seems to have been fixed by power cycling the controller. Thanks for your help, much appreciated.

VitaliiSadovshikov, 2022-11-14:
> For a quick test set **$Limits/Hard=Off** then execute the M3 command.

Sorry, can you elucidate a little bit more, what the console should spit out afterwards if the problem is caused by EMI, as you sayed.

In my case I get the same result (i.e. the message "ALARM:1 (Hard limit)" and as result stop my spindle) whether with $Limits/Hard=Off or $Limits/Hard=On. So, I should get such a result to ensure the problem originates from the noise caused by the VFD/spindle wire.

One more observation: if physically unplug all limit switch cables the message "ALARM:1 (Hard limit)" does NOT arise.

naseralariar, 2023-06-29:
[MSG:Initializing RS485 VFD spindle]
[MSG:Undefined VFD_RS485_TXD_PIN]
[MSG:Undefined VFD_RS485_RXD_PIN]
[MSG:Undefined VFD_RS485_RTS_PIN]
[MSG:RS485 VFD spindle errors]

i config evry thing but i dont khow what is problem ??

can anyone help me

Closed 2021-04-09.

Thread 19 (2021-04-09):

Error:120when updating ESP settings.

Slixxor, 2021-04-09:
We have a full management suite for Barts firmware and when trying to set network settings we're returning error:120 on your latest NO firmware advising SD job running.

Mboss32, 2021-04-09:
Hi slixxor, what software are you using to update the settings?  What setting is being updated and which of the NO firmware are you using?

Slixxor, 2021-04-13:
We are using our CNC3D Commander software and running your firmware on an ESP32 dev module (No SD attached which may be the issue). We have already done all of the ground work in our software as we are launching a similar controller to yours very soon.

A few users who have bulkman xpro V5's have reached out to us to see if it is compatible and yes indeed both of our controllers are identical in Command set (bar 2 that we have added separately).

We've set up our software to be a seemless integration with our Nighthawk Controller and automate things like firmware updates and settings.

Here is a screenshot of it connected:

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

Here is how the wifi list looks:

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

Here is where settings are done:

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

Here is how SD card files are displayed and accessible:
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

The issue we have is when you hit "Update connection settings" we begin the process of sending the values until we finally issue [ESP400] for reset. You seem to be confirming all the steps along the way but then throw the ERROR:81 (this time) and none of the settings seems to be retained at all despite the fact you 'ok' confirmed each one.

Please see command sequences top being oldest. "<<" indicates sent to chip, ">>" receivied from chip.

`<< [ESP100]Sharp Software
>> ok
<< [ESP101]12345678
>> ok
<< [ESP102]STATIC
>> ok
<< [ESP103] IP=192.168.1.133 MSK=0.0.0.0 GW=192.168.1.1
>> ok
<< [ESP105]CNC_xPRO_V5
>> ok
<< [ESP106]12345678
>> ok
<< [ESP107]192.168.0.1
>> ok
<< [ESP108]1
>> ok
<< [ESP110]AP
>> ok
<< [ESP112]CNC_xPRO_V5
>> ok
<< [ESP120]ON
>> ok
<< [ESP121]80
>> ok
<< [ESP130]ON
>> ok
<< [ESP131]23
>> ok
<< [ESP400]RESTART
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

We've tried power cycling and reconnecting but it does not retain a single setting at all. Can you advise if there is an extra command you need to "keep" the settings?

Mboss32, 2021-04-13:
Nice looking sender!  I just fired up one of the V5 and made all these edits within the CNCjs interface with no problem.  Settings stick and no errors.  Maybe double-check your hardware setup?

Slixxor, 2021-04-13:
>
>
> Nice looking sender! I just fired up one of the V5 and made all these edits within the CNCjs interface with no problem. Settings stick and no errors. Maybe double-check your hardware setup?

Thank you. it's been a full on project :)

We do not have a physical xPRO V5 to test with just an ESP32 dev module with firmware loaded. I suspect this may be the issue but i'm not sure. Do you have the command sequence output for it?

Slixxor, 2021-05-03:
Ok,

I've got the bottom of this.

Using a Dev board ESP32 and using old firmware caused the issue. Virtual EEPROM was offset. Also, needed to use newest version of esptool to load.

Closed 2021-05-03.

Thread 20 (2021-04-11):

Z limit switch does not work

WWKSeric, 2021-04-11:
I have the xPro V5, using the open builds control;

I am struggling to get the limit switches to work on my machine. Both the X and the Y work perfectly but Z will not.

Even with all the limit switches disconnected the Z shows on at all times. I tried plugging the Z into the Y port to confirm the switch works and it's fine. Also rings fine with my meter.

When I toggle the Z on the machine the LED light turns on the controller but does not lockout the machine, and nothing happens on the open builds program.

When I go into the trouble shoot tab on open builds the X and Y show "OFF" but the Z shows "ON". The Z will show on with the switch disconnected, connected, and when the switch is closed. It is a 2 wire limit switch wired as instructed.

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

Spark-Concepts, 2021-04-11:
Hmm, if you can please connect to the webui, then take a screen shot of the console stream (updates every 3 seconds).

Next, unplug all the limit switches and screen shot the console window.

WWKSeric, 2021-04-11:
This is what I get. Regardless of the switch being connected or disconnected

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

WWKSeric, 2021-04-11:
Could it be possible my Z pin is shorted on the board ?

Spark-Concepts, 2021-04-11:
It's possible... Is this a new problem, or was it like this from thw get-go?

First, try updating the firmware on your xPro - also
if you wouldn't mind, please post or email (bill@spark-concepts.com and mike@spark-concepts.com) when and who you purchased your xPro through.

Thx

WWKSeric, 2021-04-12:
From the get-go. I ordered the Workbee from Bulkman end of March, received it early April and assembled it last week. I have been able to run gcode successfully. The only thing that will not work is the Z limit.

Spark-Concepts, 2021-04-12:
Are you located in US?

WWKSeric, 2021-04-12:
I am located in Ontario, Canada.

I tried the update "CNC_xPRO_V5_XYYZ_485_NO.bin" and no change.

What would be my best course of action now ?

philshel1, 2021-04-12:
> From the get-go. I ordered the Workbee from Bulkman end of March, received it early April and assembled it last week. I have been able to run gcode successfully. The only thing that will not work is the Z limit.

Really?  I ordered one on Feb12 and still have not received it in California.

WWKSeric, 2021-04-12:
> > From the get-go. I ordered the Workbee from Bulkman end of March, received it early April and assembled it last week. I have been able to run gcode successfully. The only thing that will not work is the Z limit.
>
> Really? I ordered one on Feb12 and still have not received it in California.

Yup came pretty quick from Bulkman as a whole cnc kit. Other than this Z probe issue it's great !

philshel1, 2021-04-12:
Hmmm, I ordered the queen bee mechanical kit and as far as I can tell UPS is still waiting for it to hit stateside.

Spark-Concepts, 2021-04-12:
WWKSeric,

I'm sorry to hear you're having issues with your Z axis - that's certainly an odd issue you're having.

We're happy to assist - we have two options here:
1. We can send you updated firmware and reassign the Z limit to use the A limit pin - this would be an immediate fix (assuming there are no issues with the A axis limit pin). The downside would be, if you want to use 4 axis homing at some point (_note: most 4 axis machines don't home the 4<sup>th</sup> axis_).
2. Email us your address and we will send you a replacement along with a return label.

For the 1<sup>st</sup> option, we will gladly offer you an RNA# that can be used in the future should you decide to go 4 axis.

Please email mike@spark-concepts.com

Spark-Concepts, 2021-04-12:
> Hmmm, I ordered the queen bee mechanical kit and as far as I can tell UPS is still waiting for it to hit stateside.

Unfortunately the USA import process can take a while, especially lately. I'd suggest you reach out to Bulkman to get the status on your order.

philshel1, 2021-04-12:
> > Hmmm, I ordered the queen bee mechanical kit and as far as I can tell UPS is still waiting for it to hit stateside.
>
> Unfortunately the USA import process can take a while, especially lately. I'd suggest you reach out to Bulkman to get the status on your order.

Yes, I apologize for semi-hijacking this thread.  I just was a bit taken aback by the OP's time line.

WWKSeric, 2021-04-12:
> mike@spark-concepts.com

I have emailed you, thank you for helping

IlValeSocial, 2022-01-15:
Hi,

I have a similar issue, if I try to press limit switch of Z axis doesn't work, If I try to connect it to xpro board, led don't turn on

If I try to test pressing X limit switch and send "?" command I receive message:
<Idle|MPos:135.955,-12.500,24.410|F5:0,0|Pn:XZ|WCO:0.000,0.000,0.000>

IF i try with Z limit switch I display this:
<Idle|MPos:135.955,-12.500,24.410|F5:0,0|WCO:0.000,0.000,0.000>

I hope is PIN problem, How can I solve?

Thanks a lot for any help

Closed 2021-04-21.

Thread 21 (2021-04-16):

Updating firmware

Greylingad, 2021-04-16:
When Updating firmware to CNC_xPRO_V5_XYYZ_485_NC.bin, upon reboot, the unit asks for user and password authentication and asks whether the correct firmware was selected, this has been double checked and is correct. Any idea what the username and password would be/ whether Authentication is selected by default on this build?

Plottmania, 2021-04-16:
same problem here....CNC_xPRO_V5_XYYZ_PWM_NC.bin

Mboss32, 2021-04-16:
Hi folks,

The CNC_xPRO_xxxx_xxx_**NC**.bin firmware requires a normally closed door/estop switch to be attached at the time of boot or it will lock out like you are seeing.

Make sure you have an NC switch attached to the door input on the board, and that the switch is closed, then restart the controller.

Plottmania, 2021-04-16:
Nice.....works.Gesendet mit der mobilen Mail AppAm 16.04.21 um 16:24 schrieb Spark Concepts

                    Von: "Spark Concepts" ***@***.***>Datum: 16. April 2021An: "Spark-Concepts/xPro-V5" ***@***.***>Cc: "Comment" ***@***.***>,"Plottmania" ***@***.***>Betreff: Re: [Spark-Concepts/xPro-V5] Updating firmware (#21)

Hi folks,
The CNC_xPRO_xxxx_xxx_NC.bin firmware requires a normally closed door/estop switch to be attached at the time of boot or it will lock out like you are seeing.
Make sure you have an NC switch attached to the door input on the board, and that the switch is closed, then restart the controller.

—You are receiving this because you commented.Reply to this email directly, view it on GitHub, or unsubscribe.
[
{
***@***.***": "http://schema.org",
***@***.***": "EmailMessage",
"potentialAction": {
***@***.***": "ViewAction",
"target": "https://github.com/Spark-Concepts/xPro-V5/issues/21#issuecomment-821214063",
"url": "https://github.com/Spark-Concepts/xPro-V5/issues/21#issuecomment-821214063",
"name": "View Issue"
},
"description": "View this Issue on GitHub",
"publisher": {
***@***.***": "Organization",
"name": "GitHub",
"url": "https://github.com"
}
}
]

Plottmania, 2021-04-16:
Hallo,
very easy...thx.
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

I go and check my laser now : )

Mboss32, 2021-04-16:
Good to hear!

Make sure you follow the wiring instruction here (https://github.com/Spark-Concepts/xPro-V5/wiki/Front_Panel#spindletypelaser) depending on if you have a laser with Enable or not.

Plottmania, 2021-04-16:
I am using a SainSmart Laser 3wire....and Lightburn.Thx for your fast Replay and sorry for me Bad englisch.Retardation StephanGesendet mit der mobilen Mail AppAm 16.04.21 um 17:03 schrieb Spark Concepts

                    Von: "Spark Concepts" ***@***.***>Datum: 16. April 2021An: "Spark-Concepts/xPro-V5" ***@***.***>Cc: "Plottmania" ***@***.***>,"Comment" ***@***.***>Betreff: Re: [Spark-Concepts/xPro-V5] Updating firmware (#21)

Good to hear!
Make sure you follow the wiring instruction here (https://github.com/Spark-Concepts/xPro-V5/wiki/Front_Panel#spindletypelaser) depending on if you have a laser with Enable or not.

—You are receiving this because you commented.Reply to this email directly, view it on GitHub, or unsubscribe.
[
{
***@***.***": "http://schema.org",
***@***.***": "EmailMessage",
"potentialAction": {
***@***.***": "ViewAction",
"target": "https://github.com/Spark-Concepts/xPro-V5/issues/21#issuecomment-821240003",
"url": "https://github.com/Spark-Concepts/xPro-V5/issues/21#issuecomment-821240003",
"name": "View Issue"
},
"description": "View this Issue on GitHub",
"publisher": {
***@***.***": "Organization",
"name": "GitHub",
"url": "https://github.com"
}
}
]

Mboss32, 2021-04-16:
No worries, it probably does not have an enable - when in doubt it is best to use this wiring:
https://github.com/Spark-Concepts/xPro-V5/wiki/Front_Panel#wiring-lasers-without-enable-signals

Plottmania, 2021-04-16:
I think this is Not normal...No Connection to the webui and no connect via usb to lightburn or openbuildcontrolRegards StephanGesendet mit der mobilen Mail AppAm 16.04.21 um 17:13 schrieb Spark Concepts

                    Von: "Spark Concepts" ***@***.***>Datum: 16. April 2021An: "Spark-Concepts/xPro-V5" ***@***.***>Cc: "Comment" ***@***.***>,"Plottmania" ***@***.***>Betreff: Re: [Spark-Concepts/xPro-V5] Updating firmware (#21)

No worries, it probably does not have an enable - when in doubt it is best to use this wiring:
https://github.com/Spark-Concepts/xPro-V5/wiki/Front_Panel#wiring-lasers-without-enable-signals

—You are receiving this because you commented.Reply to this email directly, view it on GitHub, or unsubscribe.
[
{
***@***.***": "http://schema.org",
***@***.***": "EmailMessage",
"potentialAction": {
***@***.***": "ViewAction",
"target": "https://github.com/Spark-Concepts/xPro-V5/issues/21#issuecomment-821246894",
"url": "https://github.com/Spark-Concepts/xPro-V5/issues/21#issuecomment-821246894",
"name": "View Issue"
},
"description": "View this Issue on GitHub",
"publisher": {
***@***.***": "Organization",
"name": "GitHub",
"url": "https://github.com"
}
}
]

Mboss32, 2021-04-16:
Can you give a few more details, I'm not quite sure what's happening or the problem.

Plottmania, 2021-04-17:
Hello,
please excuse my bad english.
I have put some information and pictures online on my website.
It is in German but should be easy to translate.
I hope not to have destroyed the controller because I connected something wrong.
Many thanks to the support, really great and very fast.

Sincerely, Stephan

https://www.signtech.online/meine-controller/xpro-v5/firmware/

Spark-Concepts, 2021-04-17:
Plottmania,

Please try connecting to your xPro-V5 via [CNCjS](https://github.com/Spark-Concepts/xPro-V5/wiki/USB_guide#cncjs) or any ```Serial Terminal``` program. Refresh, select the applicable serial COM Port and press connect.  Once connected, press the reset button on the side of the xProV5 and please post a screenshot or paste the contents of the console window.

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

**MAXIMIZE** the console window and copy-paste the contents (it should look something like this)
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

Plottmania, 2021-04-18:
Hello,
I first connected the three cables and then as you described.
Under LightBurn I also hear how the relay switches but no reaction.
It is no longer possible to connect the controller.
As soon as I connect USB, LightBurn shows "Laser Ready" but waits for connection.
No matter if I press Restet, restart the port ... all without results.
OpenBiuldsControll shows me "wrong firmware" port closed.
I have some software here to send something to an Arduino, but to no avail.
The WebbUI cannot be started, I do not have a controller in the WiFi or the controller cannot be found.
The blue LED only flashes when I try to access the controller via USB.
Thank you for all the attempts to help but I think I killed the xPro V5 while trying to connect the laser.
Now it lies here dismantled and I think I have to buy a new one ... it's a nice part.
What LightBurn reports in between can be seen on the screen.
Anyway, I buy a new one and a laser from OptLasers.
I tinker the SainSmart Laser again on my WoodPecker 3.4 or DLC 2.0 and it is good.
Until the attempt, the update with the door opener worked flawlessly.
So my fault ..... and something like that happens when you tinker.

LightBurn showed the following in between:
G0, G0, G0, G0 ...... without being able to stop.
This as soon as I have connected to USB, even after RESET.

Many thanks for your help

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

Spark-Concepts, 2021-04-18:
Plottmania,

I'm sorry your having difficulty. We have some options for you; please send an email to mike@spark-concepts.com

Slixxor, 2021-05-02:
This is a common issue when uploading from earlier versions of firmware. You must have the 4 matching BIN files executed by esptool in the right sequence.. Simply having 1 bin file is not good enough. It can cause unpredictable results.

I might add an easy firmware update tool to our Commander software like I've done with our Nighthawk Controller for the xPRO v5.

The newest version I'm about to release supports the xPRO V5s extended features like SD file job running etc..

At present we do firmware updates very easily:
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

Mboss32, 2021-05-03:
Hi Slixxor, that is correct for a bare ESP module will need to instal the bin, an appropriate bootloader, etc.  The xPROs come with all that installed and the pre-compiled bin file is made to be uploaded via the WebUI following the official directions published [here](https://github.com/Spark-Concepts/xPro-V5/wiki/Checking_firmware_and_upgrading).

The issue initially experienced was due to the NC door switch not being installed at boot.  The latter issue was a result of some damaged hardware during disassembly.

Slixxor, 2021-05-03:
Thanks for clarifying.

I was always curious, what happens if the user sets up station mode and accidently enters the wrong password for their station router?

How can you recover that event easily?

lookhope, 2021-05-10:
after the firmware update.
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
what's the password? how to fix it?

DanVass1979, 2021-08-06:
Same issue but never got around it this has destroyed my cnc it's just a giant brick cause I apparently have the wrong firmware and spark concepts have found a way to make sure yiu can never upload any firmware to there unit but preventing yiu from ever connecting again

rhdhybrid, 2021-08-06:
So the NC firmware looks for a switch before it allows you to do anything, install any switch or bridge the connection with wire to act as a switch, then upload the NO firmware.

DanVass1979, 2021-08-06:
Good idea , tried it didn't work

Slixxor, 2021-08-06:
> Good idea , tried it didn't work

If interested I've made a standalone version of our firmware updater. It uses USB for reset and is not internally managed by the esp32 itself.

If interested let me know. I'll look at adding it into our Commander software which already supports the extended features of the xPRO.

DanVass1979, 2021-08-06:
So it can cha get the firmware on the xpro v 5 without needing to connect to it ? Cause there Re a lot of people having the same issue as me ?

Slixxor, 2021-08-07:
> So it can cha get the firmware on the xpro v 5 without needing to connect to it ? Cause there Re a lot of people having the same issue as me ?

It will flash the firmware via USB. This will work regardless of state. Likely it is how spark it sending out their units.

It's safe to do as it uses the internal bootloader. Even if it fails you can repeat the process.

Just connect usb and fire it up.

Spark-Concepts, 2021-08-11:
Quick comment before closing out this one - new firmware is available for upload.  This moves the safety lockout from the login screen to a simple DOOR:1 error in the WebUI giving a bit more detailed feedback on what needs to be fixed.  Note that this is still a safety lock and the controller will not proceed until the Door/Estop condition is met, and a reset triggered.  The new firmware adds a few nice features and fixes some minor bugs as well :)

For those following along, additional troubleshooting with DanVass was done via email, and it turned out there was a hardware error on his unit (bad FET or a short on the pcb) that made the NC door condition unreachable.

Closed 2021-08-11.

Thread 22 (2021-04-19):

Burned chip

TRUDIM, 2021-04-19:
Hi!

While putting back my XYZ touch probe back to where it rests the magnet touched somewhere on the touch probe board and smoke came out of the xPro. Here's a picture of the burned chip.
What is this chip for, can I fix it myself (I'll buy the part and give it to a professional to replace it)?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

Spark-Concepts, 2021-04-19:
TRUDIM,

Please email Bill@spark-concepts.com - I can give you a couple options

Closed 2021-04-21.

Thread 23 (2021-04-19):

PWM 5V on Constant - TTL Laser Control

rhdhybrid, 2021-04-19:
Hello, I hope I'm in the right place for some help, it seems my Toolhead PWM(0-5V) is at 5V constant, the 0-10V seems to be functioning properly. Limits are working properly. However there is a problem, when issuing M3 S3000, the spindle starts then stops with a hard limit alarm. Unplug limits and it works fine, removed spindle wiring from drag chains, routed away from all control cabling, plug in limits no go, starts then stops. unplug and works perfect. So I guess I have a few issues, the PWM has 5 Volta on it constant through it all though. which seems like a board problem. The Toolhead control is set to EN/PWM. Firmware is XYYZ/NC/PWM. Machine is a OX CNC Belt. Config from Makerhardware.net. Tweaked Axis directions but works perfect other than that. Seems like the Gcode does not take the M4 command in laser mode. Thats my list, I have been at it for days and days.

I'm running windows, cncj's all the latest version. Installed this morning. I didn't get anywhere with my mac, seems that VCP driver and CNCj's does not work, bugs. That I can't figure out.

Thank you,
Ken

Spark-Concepts, 2021-04-19:
Ken,

The issue you're having with the constant 5V on the 0-5V PWM, is something we've just recently been made aware of (this problem only affects a relatively small number of xPro's).

Unfortunately our PCB assembler incorrectly placed a pull-up resistor on the 0-5V PWM output... We will be posting more details on a resolution shortly....

The fix on this is relatively an easy one. Unfortunately this requires disassembling your xProV5.

**NOTE:** be sure to remove the SD card

rhdhybrid, 2021-04-19:
Thank you very much for the answer, I tried every wire configuration in the manual. I was going insane. Lol. Please keep me informed, I have work lined up for the machine. On the limit hard alarm, I seen in another closed issue that it can be turned off. Will this affect homing? Thank you again. I have my spindle cable pulled from the cabling so I don’t know where it could be getting noise. But I’ll go pull some screen shots of the console data in cncj’s. If that will help.

Spark-Concepts, 2021-04-19:
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

Re-assembly:
1. Insert USB board into the bottom of the case.   This is a tight fit.
   a.	Insert board at an angle with SW3 headed for the circular hole marked RESET on the case
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
   b.	Slide SW3 into the RESET hole.
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
   c. Grab the 4 Green connectors in the board, gently pull the board away from the USB connector and align the USB plug and the SW1 switch lever with the board slots marker “USB” and “EN/PWM- - RS485 A/B”.
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
   d.	At this point the board will slide down into the case.

rhdhybrid, 2021-04-19:
Thank you, I will remove the resistor tomorrow, I just went out and turned off the hard limits and everything seems to work normally now with the spindle. Thanks so much for the prompt comments. Thanks so much. Saved me.

Spark-Concepts, 2021-04-19:
To answer your initial question, which you've already verified; Yes, homing still works with hard limits disabled

rhdhybrid, 2021-04-20:
Just wanted to let you know the fix went as planned, the pwm pin provides the desired voltages as commanded with different spindle speeds. however, I think the damage is done to the laser controller, it turns on to full power, but after trying a program in light burn it started with the beam on full power, then it fizzled out, and now nothing. Anyway, thats my luck, the xpro is working as it should now. :)

Spark-Concepts, 2021-04-20:
What model laser are you using?

Double check the modulation frequency required for the laser _ e.g. "Bulkman 15W Laser Modulation frequency: ttl can be modulated, 0v-off,5 open, switching frequency <9 kHz"_

```$Spindle/PWM/Frequency (Spindle PWM Freq)```  _This sets the frequency of the PWM signal_
The default PWM modulation frequency setting on the xPro-V5 is ```$Spindle/PWM/Frequency 5000```

Also double check the $30 setting - go to **Edit** > **Device Settings** in LightBurn, **S-Value Max setting** should match the **$30** setting on the xPro (typically ```$30=1000```)

rhdhybrid, 2021-04-21:
Thank you very much for the info, I added the following commands to the start gcode in lightburn setting,  $32=1
$30=1000
$Spindle/PWM/Frequency=9

The end gcode is
$32=1
$30=24000
$Spindle/PWM/Frequency=5000

Returning the machine to the cnc configuration, I hope.

I believe my problem is with VR-1, the other variable resister clicks when turned clockwise, vR-1 does not. I believe this is the power control resistor. Correct me if I'm wrong. No documentation came with the laser, it is from bulkman 3D.

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

Thanks so much again.

Spark-Concepts, 2021-04-22:
While we do not fabricate or sell lasers - however, I am familiar with them.

To check the function of the laser itself, it's important to note that lasers require constant current not a set voltage.

Inside the laser housing, the laser diode itself typically consist of a three terminal device: ground, power (to the laser diode), and a photodiode (output for feedback). Since the Laser driver PCB above only has 2 wires to the LD; I would assume the device you have has either a built-in controller or is running in straight open-loop (uncontrolled and have no idea what your actual laser power output level is). This can shorten the life of your laser. Laser diodes are designed to be operated in closed-loop mode where the power supply senses the output level of the laser through that photodiode and adjusts its output current on the fly to keep the power output level where it is designed to be.

To test the Laser itself, if you keep the current constant and in a safe range for the laser diode, you won't hurt anything, If you have an adjustable power supply with a current limit adjustment, set the voltage at 3-4V and current limit adjustment to around 10mA. Slowly raise the current limit until the laser begins to lase (even at low current levels the laser should emit some light - just don't release the magic smoke.

Okay so the picture you sent me appears to be an open-loop power supply with two outputs and two inputs.
1. Fan Power (out)
2. Laser Diode Power fixed current (out) - with a current adjustment trimmer (VR1 or VR2?)
3. PWM 0-5V (input)
4. 12V or 24V? (input)

Let's say the laser diode checks out, I would look for and at the following components:
1. I would hope/assume there should be an opto-isolator close to or where the 0-5V PWM plugs in.
2. From there I would look at the power transistors (circled below)
3. Can you read the markings from the SO8 package
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
4. I would be surprised if you found the trimmer to be at fault - (to test it, you'll want to remove it from the PCB, then ohm it out with a multimeter) _there should be a 3 number marking on the trimmer first two digits followed by a digit representing how many zeros proceed; i.e. 103 =  10,000 Ohms_

Also, would you mind posting a picture of the underside...
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

rhdhybrid, 2021-04-22:
Thanks again for helping out. I understand trouble shooting someone else's product is typical. I really appreciate your knowledge. This is my first laser and second cnc machine. I was more excited for the laser then carving. Lol. So I had a look around. And took some pictures that hopefully will provide some info. I have checked the output on the LD wires and it's 12 volts. Changing the VR's does nothing, plugging in the ttl wires also doesn't change the voltage output.

Seems way to high as you stated to test at 3-4 volts. Nothing seems burned up though, Drivers look fine, nothing stands out.

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

I hope that's provides abit more info, on the AliExpress add it says that it power to full so I would assume that's 5ish volts on the meter.

Thanks again, I ran a cnc program last night and the controller worked great.

rhdhybrid, 2021-06-01:
Hello again, sorry to revive this old topic, but I recieved my replacement laser from bulk man 3D. So all is well. I still have a problem. I changed the  Spindle PWM frequency to 9000 as above. Enabled laser mode. But when I turn on the laser power it's again at full power. I probed the wires and did some experimenting, the pwm 5v pins shows 0.31volts at rest with laser power off. Turn laser power on it shows 2.31ish volts. Disconnect ttl wires at laser control box and the voltages drops to 0 so it's not a short and has to come from the laser controller. So I had light burn open so I manually fired the laser at 0.25% and the laser shuts off. XPros relay is latched. Turn off the laser in lightburn and it goes to full power. Relays disengages in the Xpro. When I turn the laser off the voltage returns to 0.31v on the PWM and the relay NO side has 0v. I think the problem lies in the rest voltage, with it wires through the relay it opens the circuit and the laser goes to 100% as Bulkman 3d says should happen. I just went out to double check the voltages, when light burn commands a setting say 10% to he pwm voltage is 0.10 which switches the laser off. I'll do abit more testing today when I get off. But maybe there's something I'm missing.

Mboss32, 2021-06-01:
Good testing, we have one of the Bulkman lasers headed our way for some testing here.  In the meantime, would you mind checking a few voltages?  (please note that "No" is an acceptable answer and we can measure them directly in the near future and provide more troubleshooting when the unit arrives).

If you disconnect the xPRO and the Laser control box -  power the laser control box and measure the TTL input pin on the laser control box.  Is there a voltage present?  Trying to decide if the laser control module has a floating input voltage when not actively pulled down.

rhdhybrid, 2021-06-01:
Ok so I did abit more testing. I have full function of the laser when I command a power percentage it outputs voltages that ascend and descend as expected. The laser will be off if commanded like this.
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

The output voltage is 0.07ish volts on the PWM pin.

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
When commanded off, with M5 through lightburn it turns the PWM pin off and it has the 2.31 volts which comes from the laser controller.

Laser mode is on, PWM Frequency is set to 9000. So not really sure where to go. I think the PWM pin needs to remain at 0.07 volts when off in order for the laser to be in the off state.

I have tried both directly into the tool head connector and through the relay as per the documentation with the ttl wiring. Neither way works.

rhdhybrid, 2021-06-01:
Sorry I was writing that last post and seen this. When the laser is disconnected from the xpro it floats at 2.33 volts. And if you need anything looked at please ask, I don't mind at all, I want this to work more then anyone.

Spark-Concepts, 2021-06-02:
Based off your test results it appears that the Bulkman laser may have a 2.3V low impedance offset when open. Currently the xPro-V5 has a fairly weak pull-down and may require a bit more assistance - in otherwords, you may need to add a resistor in parallel with the laser ourput signal  (~1K to 4.7K Ohms between PWM to Ground. ( I'll plan to add an illustration soon)

There's no harm in you adding a resistor yourself. Regardless we will perform thorough testing using the Bulkman laser (once received), and report our findings.

rhdhybrid, 2021-06-02:
Thank you for the response, I went out this morning and found a 3.3 Kohm resistor, direct with the ttl wires to the gnd and pwm in the tool head connector. With the 3.3 kohm resister between them. The laser worked better, it was still emitting some light but not enough to burn the waste board. I probed the output at rest and it is 0.10 volts. I ran a small program with light burn and it functioned as expected. I think we need to fine tune the resistor but it seems to work. Not sure if this affects the voltage delivered to the ttl wires because the engraving was at 100% but the burn was light. I'll run a few more tests hopefully this afternoon when I can get back to the shop.

rhdhybrid, 2021-07-10:
Just checking in to see if you guys recieved your bulkman 3D laser yet for testing. Mine is working as expected but I feel like I'm not quite getting full power. Don't get me wrong, it works, but I have to turn my federated way down to achieve a black burn, previous without the pull down resistor it seemed to have more power. Anyway, more so just checking back to see if there is a permanent tested fix.

Thanks again for your support. I couldn't be happier.

blakamin, 2021-07-13:
I'm having this issue with the exact same laser (came from makerstore.com.au)

Have there been any updates?

Spark-Concepts, 2021-07-13:
Mike

Uuhg

Bill

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

Mboss32, 2021-07-13:
Kick back to en relay wiring?

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

Spark-Concepts, 2021-07-13:
I'll reply later today

On Tue, Jul 13, 2021, 10:48 AM Spark Concepts ***@***.***>
wrote:

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

rhdhybrid, 2021-07-14:
I excellent guys, can't wait for your response.

Spark-Concepts, 2021-07-15:
I think we have a firmware update that will fix this - note this is untested with the specific BM3D laser.    If one of you would be willing to test it out and report, it would be appreciated.

Requires NO Estop, or no Estop.  This will make it so enable pin is always on, allowing the PWM pin to sink the voltage from the BM3D laser when the controller is powered on.  So, best practice would be to start the controller, then the laser, likely starting the two at the same time will be OK - just don't start the laser first

[CNCxPROv5_XYYZ_BM3D_NO.zip](https://github.com/Spark-Concepts/xPro-V5/files/6825718/CNCxPROv5_XYYZ_BM3D_NO.zip)

blakamin, 2021-07-15:
Extracted file is 1kb... Is that correct?

Mboss32, 2021-07-15:
it was indeed not.. let's try that again, this one is the compiled bin, uploads through the WebUI

[CNCxPROv5_XYYZ_BM3D_NO - correct.zip](https://github.com/Spark-Concepts/xPro-V5/files/6826338/CNCxPROv5_XYYZ_BM3D_NO.-.correct.zip)

blakamin, 2021-07-15:
No movement on any axis.
Makes a quick move on connection then...
[Lightburn Console.txt](https://github.com/Spark-Concepts/xPro-V5/files/6826405/Lightburn.Console.txt)

Lightburn showing the below txt

Spark-Concepts, 2021-07-15:
Send $RST=*, then power cycle the controller - this will reset all setting to the firmware default.

Do you have a door switch?

blakamin, 2021-07-15:
I do but it's NC so I disconnected it

blakamin, 2021-07-15:
That''s fixed it, Thanks... Now to try the laser (sorry if it takes awhile to respond, I'm at work)

blakamin, 2021-07-15:
Works! Thank you!

Spark-Concepts, 2021-07-16:
Well, getting closer - is there a specific error you are seeing? Can you provide a little more detail on what is going on?

blakamin, 2021-07-17:
I'll attach a pic of the error

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

rhdhybrid, 2021-07-19:
I think your error may be that lightburn is using M4 command, but the firmware doesn't recognize this, you can switch lightburn to use the M3 command instead. Mine did the same thing but once I switched it to the M3 command I have been working. I'm going to try out this firmware for myself today and will report back.

rhdhybrid, 2021-07-19:
I think your error may be that lightburn is using M4 command, but the firmware doesn't recognize this, you can switch lightburn to use the M3 command instead. Mine did the same thing but once I switched it to the M3 command I have been working. I'm going to try out this firmware for myself today and will report back.

blakamin, 2021-07-19:
> I think your error may be that lightburn is using M4 command, but the firmware doesn't recognize this, you can switch lightburn to use the M3 command instead. Mine did the same thing but once I switched it to the M3 command I have been working. I'm going to try out this firmware for myself today and will report back.

Won't that keep the laser on all the time though?

rhdhybrid, 2021-07-19:
No it shouldn't I'll head out know and give the firmware a go. But to use M3, you need to change the setting in lightburn to use this

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

It is the profile it uses to make the grbl output code.

blakamin, 2021-07-19:
My laser power is extremely low with GRBL-M3

rhdhybrid, 2021-07-19:
ok so I uploaded the new firmware through the web app, the update went fine, all my setting ported over. Tested with cncj's and homing and movement are normal. Lightburn loaded as normal, homed on startup. I ran couple of tests, seemed to work as intended, tried acouple of different feedrates with differing results but overall I think it has the rated power it should now, noticed some scorching on the line test which didn't happen with the same feedrates with the pull down resistor, I'll need to do some burn tests for couple of different materials but it doesn't stay on or is at lower power when it rest, so far I would call this a win. 👍 Great Job guys on the support. Got me wondering if there is a power difference using the M3 Vs M4 for laser control.

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

Spark-Concepts, 2021-07-20:
Thanks for testing out!  We have found the m4 command issue and are currently putting all of this into a firmware update.  Should be officially posted in the next few days.  We greatly appreciate the testing and reporting back :)

blakamin, 2021-07-20:
Awesome news

rhdhybrid, 2021-07-20:
That's awesome guys, thanks for the support. I look forward to testing out the new updated firmware.

Spark-Concepts, 2021-07-23:
Morning folks,

New firmware is ready if you are willing to test it out.  Zip attached is a BM3D specific version in XYYZ and NO or NC door switch options.  The new firmware will let you flip between different spindle types with out needing to recompile.

With the BM3D version of the firmware, choosing a PWM or Laser spindle type will driver the enable pin to always be ON, allowing the PWM output to sink the voltage offset from the Laser - i.e. no more unpowered firing (hopefully).  That said, make sure you turn on the xPRO and then the Laser, with the offset on the laser anytime it is powered up without a signal on the pwm, it will fire... please be careful.

To use this with the BM3D laser, load either the CNC_xPRO_V5_XYYZ_BM3D_NC or CNC_xPRO_V5_XYYZ_BM3D_NO .bin file, depending on your door switch.  Set the spindle type to laser and turn on laser mode:

$Spindle/Type=Laser
$Gcode/LaserMode=on

You should now be able to make M3 and M4 cuts using lightburn.
Thanks and let us know how the test goes!
[CNC_xPRO_V5 20210708.zip](https://github.com/Spark-Concepts/xPro-V5/files/6869329/CNC_xPRO_V5.20210708.zip)

rhdhybrid, 2021-07-23:
Thanks so much, I loaded the NC bin file and it loaded fine, all settings ported over, lightburn homing is correct. The laser doesn't power on as it should. I will do more testing on Sunday when I get back to the shop. Thanks for all the hard work.

blakamin, 2021-07-26:
Works great, Thanks guys!!

Closed 2021-04-21.

Thread 25 (2021-05-16):

Controller not working after limit switch experiment

Jncls, 2021-05-16:
In the limit switch part of the basic hookup section there is the following warning: "Warning: Incorrect wiring can short V+ to GND causing damage to your controller: Double check wiring before powering on"

I'm afraid that exactly this happened to my xPro V5 when experimenting with the limit switches.

When I now turn the controller on only the power on indicator lights up. I can't see the controller's wifi network nor are the steppers energized. Do you have any idea which component could have been damaged and needs to be replaced?

Spark-Concepts, 2021-05-16:
Hello,

First off I'm sorry you're having difficulty with your xPro.

I'm sorry you're having difficulty - unfortunately, on the earlier batches of xPro's one of the chips (U5B) on the underside of the top circuit board tends to release the magic smoke if/when 5V power is in a short circuit condition (despite the [XL1509](http://www.xlsemi.com/datasheet/XL1509%20datasheet.pdf)'s datasheet "Built in current limit function"). Fortunately, albeit unfortunately this issue has since been resolved.

You have a few options:
1. If you're in the US: contact mike@spark-concepts.com or bill@spark-concepts.com for repair options

2. Replace the chip yourself, which requires some SMD soldering skills - OEM p/n: XL1509-5.0E1; however, p/n: [AP1509-50SG-13](https://www.digikey.com/en/products/detail/diodes-incorporated/AP1509-50SG-13/1301328) actually current limits without destroying itself.

3. Quick DIY temporary (or permanent) solution:, Remove 'U5B' (XL1509 chip) and power 5V via USB (USB-C cord plugged into a USB power brick). Follow instructions below.

## Remove U5B
- To remove U5B without a hot air rework tool, I would recommend doing so by (very carefully) using a sharp E-XACTO knife or sharp razor blade.  Placing the blade flush along the sides of the IC body (see below). Applying light to moderate pressure while pulling the knife toward you. (note: you will need to make several passes on both sides... once you've cut through the legs on U5B, it should easily lift or slide right out).

- I recommend you measure resistance as shown below, if you're getting a resistance value above 90-100 Ohms with U5B removed you should be able to safely power your xPro using a USB-C cable and USB power brick. (note: UL certified USB power adaptors have built in Short circuit/Over current protection)

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

Jncls, 2021-05-17:
Thank you very much for the detailed explanation.

On your picture the U5B component looks damaged but in my case I can't see anything like this (image attached). Is there any chance to find out if it's damaged or not before cutting it out - e.g. by measuring some resistance values between certain pins? As I'm not in the US (Germany) I need to repair it by myself.

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

Spark-Concepts, 2021-05-17:
-  I've also seen U5B fail intact; U5B typically fails in a low resistance/short circuit condition...
 1.  Measure the resistance across D4B(+5V to GND): if the resistance should be greater than 50 Ohms.
 2.  Connect 12-24V to the top board and switch the board ON: very carefully measure the voltage across D4B (Voltage should read 4.9-5V).

If one or both conditions don't meet the criteria mentioned above, U5B is likely the culprit.

Jncls, 2021-05-17:
I've marked the points on the picture below where I measured resistance and voltage. Resistance is about 7 Ohms, voltage is 0V. Are these the correct spots where I should measure >50 Ohms and 5V? If yes, I will continue by removing the U5B and try to power it up over USB.

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

Spark-Concepts, 2021-05-17:
The points you marked work too - so yes, proceed in removing U5B

Jncls, 2021-05-17:
Yay, it's breathing again!

I think that I've found a shop in Germany where I can get the replacement component, but thank you very much for the offer.

After a quick data sheet check I'm a bit confused as it says "Operating Voltage up to 22V". Is it really the same and correct component?

https://www.diodes.com/assets/Datasheets/AP1509.pdf

Spark-Concepts, 2021-05-17:
Yes, you are correct regarding the Diodes  (p/n AP1509), hence why I mentioned "p/n: AP1509-50SG-13 will actually current limit without destroying itself (although it's more sensitive to input voltages above 24V)"... also note, subtract 500-700mV from the input 24, and that's what U5B See's  (~23.3V).

The AP1509 Datasheet specifies absolute max input of 24V... In which your right on that cusp. I can tell you that I've used the AP1509 when prototyping with 24V input applied and haven't had any issues.

From load testing the AP1509 at the rated 22V input, the output (5V) remained steady with an applied 2A load; however, with 24V applied, the output load was limited to ~1.5A before it begins thermally limit the output voltage. Also note: while in use, the typical current draw on the 5V is approximately a few hundred mA - if you're pulling over 1amp (1000mA) on the 5V output, something is wrong.

Basically, if you go with the AP1509 understand the long term affects are unknown and the current draw on the 5V rail will be limited to 1.5A vs the 2A, also make sure the input voltage doesn't exceed 24V.

That said, the XL1509 works great and is rated at a 40V for it's absolute maximum input ...as long as the 5V and Gnd aren't directly touching in a short circuit configuration.

Closed 2021-05-25.

Thread 26 (2021-05-17):

X and Y motors getting hot, system down now

rhdhybrid, 2021-05-17:
Hello, I'm wondering what the operating temperature should be for my ox cnc. The X and Y motors are getting hot, to hot to keep my fingers on them after about a hour of carving. I stopped the program as I was scared they would cook. Is there a way to turn down the current going to the motors? The motors are the supplied nema 23's from Bulkman 3D.

Thanks again for your hard work, my controller is producing some good work. Cncj's doesn't update when it's working but it does work good.

rhdhybrid, 2021-05-17:
Found a closed post with my solution. Going to give it a try this afternoon.

rhdhybrid, 2021-05-17:
I think I may have done something wrong. I changed all the $X through to $C/Current/Hold to 1.1 and the $X through to $C/Current/Run to 1.8. Now there is no Y/A movement, Y axis works but A is holding. And the Z does not work.

Could the $B/current/run and hold values be wrong now. Also the $144 is now set to 0.250. I have attached some photos of the console. If someone can let me know what the current run and hold values should be I think this is my new problem. 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

I hope someone can help me out, I have a piece to do and was hoping this would keep the motors cool so I could complete it.

Mboss32, 2021-05-17:
I think you have entered the command incorrectly to change the settings.  The command should have an "=" to set the value.  Example: "$X/Current/Hold = 1.5"

Try to reset your values back to default by sending the command "$RST=*" and let's see if that gets motion back to the machine.

rhdhybrid, 2021-05-17:
Thank you for the response, I performed the rst function, then entered all the configuration data again. Got everything homing and travelling in the right direction with the below current settings but the motors are still really hot on the x and z axis, the program was a parallel carve so it was heavy on these axis. Maybe I'm off somewhere but the motors were starting to stutter after ten minutes of use.

Everything seems to turn fine now that the power is off so I think everything is still ok. Just needs a cool down.

Maybe you have some setting suggestions.
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

Mboss32, 2021-05-18:
What is the current rating on your motors? The current set with $X/current/run or hold is an RMS current, not peak. Examples for how to set these properly are here:
[https://github.com/Spark-Concepts/xPro-V5/wiki/Changing-settings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](https://github.com/Spark-Concepts/xPro-V5/wiki/Changing-settings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)

rhdhybrid, 2021-05-18:
Thanks Moss for the comment, please find the attached motor specs taken from Bulkman 3D's add. It says they are 2.8A. I would think my 1.6A setting should be ok. I would think this machine and controller should be able to run for hours and hours as my cnc is 1500x1500 it should be able to conceivably carve a piece the size of the work area. Correct me if I'm wrong but that why I bought all of it. I have had a nice few problems so far, burned up my laser, xpro needed repairs to fix that, now I have a motor burned up.
Sorry this is breaking my heart, I need to order another motor from someone in Canada today, hopefully have it fixed next week. But please let me know if I can test anything to see if there is another problem with the xpro, maybe there is to much voltage to the motors?

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

rhdhybrid, 2021-05-18:
Even if I get replacements sent I'm going to order another set of motor, which of these three are recommended.

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

Thank you guys for all your help, your responses and customer service are excellent.

Mboss32, 2021-05-18:
You are correct in your assessment, these should run for hours on end with no issues.  The key thing is getting the current settings correct for your motors, the 1.6A (run) and 1.1A (hold) setting should be good for the motors shown.

A quick test, loosen/remove your flex coupler from the lead screw so that the motor can turn freely.  Loosen/remove all of them and try to move the motors again.  Do the motors turn again?  Can you move the gantries by hand the entire length, and tight spots, etc?

For replacement motors, all of the listed motors will work, I would probably go with the 267oz-in motors personally.  (**Greatly oversimplifying things** - generally, with higher oz-in ratings, you will see a lower top speed before stalls occur)

rhdhybrid, 2021-05-18:
Thanks Mboss, again your to the rescue, the gantry moves no issue, I unplugged my motors and moved the gantry around and it moves no issue. Doesn't bind or anything. Motors also turn by hand. But when operated they are stuttering and sound terrible. Z and X are rough, the Y axis sounds abit loud. The A motor seems ok. I'm going to order 4 motors right now and get them shipped but I can do some testing this afternoon when I get back to the shop.

rhdhybrid, 2021-05-18:
Motors are ordered. So hopefully we can get to the bottom of this before they arrive. :)

Mboss32, 2021-05-18:
I would recommend checking all of your wiring - at the motor pigtail and the controller.  A loose connection or swapped coil wires can cause the motors to run like that and behave poorly.

Could you also post your settings?  (send $S to the controller)

It looks like the X motor was unresponsive for a few clicks, could you repeat and see if you get a warning LED on the side of the case above the X label?

Mboss32, 2021-05-19:
Ok, looks like a few of the settings are not correct.  I *think* this may be the issue as they determine how the motors get driven.

Please try the following changes and check the motors again:
$0=4
$2=0
$4=0

rhdhybrid, 2021-05-19:
Ok, I'll give it a go when I get back in the shop this afternoon. :) thanks again for the reply.

rhdhybrid, 2021-05-20:
I still haven't had a chance to check out the settings but this is where I got all my configuration settings, I think they may be wrong in this guide.

http://makerhardware.net/wiki/doku.php?id=electronics:xpro_v5_motion_control_system

[Ox Belt 1500x1500 Standard Torque.txt](https://github.com/Spark-Concepts/xPro-V5/files/6518372/Ox.Belt.1500x1500.Standard.Torque.txt)

Halfway down the guide there is a link and discretion on how to set up a macro for the config. Perhaps they are wrong here.

Thanks again, it/'' be monday evening before I can try the settings now, and the new motors will be here next friday. Thank you again for your support.

rhdhybrid, 2021-05-24:
Hello again, I hope you all had a good weekend. :) I just went out and made the changes above, I ran the axis test's and the z and x are definitely shot. I ran the y/a axis back and forth for abit, let it stand then ran it back and forth again for abit. About 20 minutes or so. Checked the motor temps with a digital temp gun, 130-136 F for the y/a axis and 100 F for the z and x axis which were standing still for the entire time besides a quick test to see how they worked. So this seems abit high but correct me if I'm wrong.

My new motors will be here tomorrow, so I'll swap them and triple check all the wiring.

Thanks again for all your help. :)

rhdhybrid, 2021-05-27:
I installed the new 267 oz motors, everything runs fine, moved it around abit, motor were in the 60 deg range. So I then started the same parallel carve I used the last time, I ran it for about ten minutes, monitoring the motor temps with digital temp gun, then ran in the 80's for the Y axis, the z and x, which are in constant motion for up to 120 deg F. I shut it down. From the google searches I made this is on the upper range for a nema 23 motor. I'll lower the run current again and see if it makes a difference. I verified all the wiring and connections. It seems to function and move properly.

Is there a way to test the motor outputs to see if everything is outputting properly.

Thanks again.

Ken

rhdhybrid, 2021-06-01:
This can be closed up, I adjusted the current run down to 0.9 and the current hold to 0.5 and all is well. Motors run warm to touch. But not hot. I'm probably conservative on my numbers but I want this to operate reliably for years to come. Thank you so much for your help.

Mboss32, 2021-06-01:
Thanks Ken!  I would agree that is pretty conservative, we get a little worried around the 150F range.  However, as long as you are not missing steps there is no need to run hot.

Closed 2021-06-01.

Thread 29 (2021-06-13):

Power Switch not working?

jiangmf, 2021-06-13:
I'm very new to the world of CNC and wiring up circuits so forgive me if I'm making some kind of newbie mistake.

I have a very simple set up currently, just 4 motors, 24V power and USB connected. The power switch does not seem to be doing anything, even in the OFF position, the 24V indicator light is ON, and I'm able to spin the motors with CNCjs. Everything still works when the switch is in the ON position as well

Is this normal? if so, what do I need to do to get the power switch working?

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

Spark-Concepts, 2021-06-15:
Jiangmf,

That's an interesting one... The motors and green LED should not be operational while in O. F. F. mode. Most certainly sounds like a switch issue.

When toggled, does the switch detent feel loose -or- do you get a satisfying click?

jiangmf, 2021-06-17:
No the switch clicks and feels very firm in both positions.

Spark-Concepts, 2021-06-21:
My most sincere apologies  for not replying to your last comment.

If you wouldn't mind please post or email a picture of your current setup - mainly the wiring (motors, limit switches, power supply, etc...)

Post here, or email to bill@spark-concepts.com & mike@spark-concepts.com

Thanks!

Spark-Concepts, 2021-06-24:
Hmm, very odd, that's a first!

Please contact us at https://www.spark-concepts.com/contact-us-1/ for options

jiangmf, 2021-06-26:
Closing this issue as somehow the switch magically started working as I was putting everything together for a photo. Don't think I've made any changes to any of the connections other than maybe flashing the firmware to CNC_xPRO_V5_XYYZ_485_NC (don't recall if it started working before or after the flash)

Closed 2021-06-26.

Thread 30 (2021-06-13):

Using Yl620-A VFD with RS485?

Emanuelbastos1, 2021-06-13:
Is it possible to use a Yalang YL620-A VFD with RS485?
I believe a new firmware version is needed.
Thanks!

Spark-Concepts, 2021-06-21:
Emanuelbastos1,

You are correct and we look to include it with the next firmware update (coming soon). We are in the process of validating the stable RS485/ Yalang YL620 VFD Modbus operation.

In the meantime, I would recommend controlling your spindle using the 0-10V output.

Emanuelbastos1, 2021-06-21:
Dear Spark-Concepts,

I'm a little disappointed with the controller. I can't get any voltage from
the 0-10v anolg output.
Even if I type the command in the webui, as example, M3 S12000, when I
measure the voltage output it is 0V. With pwm, the same story.
I just sent an email to return the controller.
can you help me with this?
I would like to not return the controller, just to have it working
properly!

Thank you for your help,
Kind Regards

Emanuel Bastos

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

rhdhybrid, 2021-06-21:
Don't lose faith, I had a bunch of growing pains with mine as well, but the support here is great. And once I figured out the couple of issues I had, my machine is now working perfect. I found a number of videos on YouTube for configuring my spindle on youtube. If you want pwm you must flash the pwm firmware into the cnc xpro for the 0-10 volts to work properly. Then you must change acouple of settings in the VFD controller to use the 0-10v input. I found this info on youtube. As I run a different vfd I'm not help. But try here.

https://youtu.be/4T_4a2YgCgk

Emanuelbastos1, 2021-06-21:
I belive I did everything correctly. I flashed the firmware to the pwm
version. Even disconnected from the vfd, there is no voltage in the 0-10v
analog output. I send the command to activate the rotation and
nothing happens, 0v!
I will take some pictures and send it to you!

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

Emanuelbastos1, 2021-06-21:
The video with the problem.
I had all ready to return, so the connection is something for a quick test!
https://we.tl/t-rjGLbyoccD
The video is just 1 or 2 minutes.

Thanks

On Mon, 21 Jun 2021, 17:46 Emanuelfrancisco Carvalho, <
***@***.***> wrote:

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

Spark-Concepts, 2021-06-21:
Emanuel,

I'm more than happy to assist - Please see [https://github.com/Spark-Concepts/xPro-V5/issues/33](https://github.com/Spark-Concepts/xPro-V5/issues/33)

Emanuelbastos1, 2021-06-22:
![image](https://user-images.githubusercontent.com/85850044/122974510-4f0afd80-d38a-11eb-879f-2d7d2f90d464.pngIt
The switch is set to "EN/PWM"

Spark-Concepts, 2021-06-22:
Emanuel,

It looks like the spindle setting is configured for RS485 VFD...

That's an image of the startup screen - if you could, please enter `$S` in the command line then copy paste all settings here..
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

Emanuelbastos1, 2021-06-23:
That solved half of the problem. I changed the spindle type during my attempt to use the RS485 connection and I thought the firmware update would reset the settings I changed.

Now I changed the spindle type to PWM and, when I run the test2.nc file, I am getting the same 0 V in the 0-10 V output but the PWM output is working, and I'm getting 2.7 V.

What else is wrong?

Old settings:
$Sta/SSID=CNC_xPRO_V5
$Sta/Password=******
$Sta/IPMode=DHCP
$Sta/IP=0.0.0.0
$Sta/Gateway=0.0.0.0
$Sta/Netmask=0.0.0.0
$AP/SSID=CNC_xPRO_V5
$AP/Password=******
$AP/IP=192.168.0.1
$AP/Channel=1
$System/Hostname=CNC_xPRO_V5
$Http/Enable=ON
$Http/Port=80
$Telnet/Enable=ON
$Telnet/Port=23
$Radio/Mode=AP
$Bluetooth/Name=XPRO_V5_BT
$Notification/Type=NONE
$Notification/T1=
$Notification/T2=
$Notification/TS=
$User/Macro0=
$User/Macro1=
$User/Macro2=
$User/Macro3=
$Homing/Cycle0=Z
$Homing/Cycle1=XY
$Homing/Cycle2=
$Homing/Cycle3=
$Homing/Cycle4=
$Homing/Cycle5=
$Report/StallGuard=
$Stepper/Pulse=4
$Stepper/IdleTime=255
$Stepper/StepInvert=
$Stepper/DirInvert=
$Stepper/EnableInvert=Off
$Limits/Invert=On
$Probe/Invert=On
$Report/Status=1
$GCode/JunctionDeviation=0.010
$GCode/ArcTolerance=0.002
$Report/Inches=Off
$Firmware/Build=
$Limits/Soft=Off
$Limits/Hard=Off
$Homing/Enable=On
$Homing/DirInvert=XY
$Homing/Squared=
$Homing/Feed=200.000
$Homing/Seek=2000.000
$Homing/Debounce=250.000
$Homing/Pulloff=2.500
$GCode/MaxS=24000.000
$GCode/MinS=0.000
$Laser/FullPower=1000
$GCode/LaserMode=Off
$GCode/Line1=
$GCode/Line0=
$Spindle/Enable/Invert=Off
$Spindle/Enable/OffWithSpeed=Off
$Spindle/Delay/SpinDown=0.000
$Spindle/Delay/SpinUp=0.000
$Spindle/PWM/Invert=Off
$Spindle/PWM/Frequency=5000.000
$Spindle/PWM/Off=0.000
$Spindle/PWM/Min=0.000
$Spindle/PWM/Max=100.000
$Spindle/Type=H2A
$X/StepsPerMm=200.000
$Y/StepsPerMm=200.000
$Z/StepsPerMm=200.000
$A/StepsPerMm=200.000
$B/StepsPerMm=100.000
$C/StepsPerMm=100.000
$X/MaxRate=2500.000
$Y/MaxRate=2500.000
$Z/MaxRate=2500.000
$A/MaxRate=1000.000
$B/MaxRate=1000.000
$C/MaxRate=1000.000
$X/Acceleration=100.000
$Y/Acceleration=100.000
$Z/Acceleration=100.000
$A/Acceleration=200.000
$B/Acceleration=200.000
$C/Acceleration=200.000
$X/Home/Mpos=0.000
$Y/Home/Mpos=0.000
$Z/Home/Mpos=0.000
$A/Home/Mpos=0.000
$B/Home/Mpos=0.000
$C/Home/Mpos=0.000
$X/MaxTravel=770.000
$Y/MaxTravel=790.000
$Z/MaxTravel=90.000
$A/MaxTravel=300.000
$B/MaxTravel=300.000
$C/MaxTravel=300.000
$X/Current/Run=1.800
$Y/Current/Run=1.800
$Z/Current/Run=1.800
$A/Current/Run=1.800
$B/Current/Run=0.250
$C/Current/Run=0.250
$X/Current/Hold=1.250
$Y/Current/Hold=1.250
$Z/Current/Hold=1.250
$A/Current/Hold=1.250
$B/Current/Hold=0.125
$C/Current/Hold=0.125
$X/Microsteps=8
$Y/Microsteps=8
$Z/Microsteps=8
$A/Microsteps=16
$B/Microsteps=16
$C/Microsteps=16
$X/StallGuard=16
$Y/StallGuard=16
$Z/StallGuard=16
$A/StallGuard=16
$B/StallGuard=16
$C/StallGuard=16
$Errors/Verbose=Off

New settings:

$Sta/SSID=CNC_xPRO_V5
$Sta/Password=******
$Sta/IPMode=DHCP
$Sta/IP=0.0.0.0
$Sta/Gateway=0.0.0.0
$Sta/Netmask=0.0.0.0
$AP/SSID=CNC_xPRO_V5
$AP/Password=******
$AP/IP=192.168.0.1
$AP/Channel=1
$System/Hostname=CNC_xPRO_V5
$Http/Enable=ON
$Http/Port=80
$Telnet/Enable=ON
$Telnet/Port=23
$Radio/Mode=AP
$Bluetooth/Name=XPRO_V5_BT
$Notification/Type=NONE
$Notification/T1=
$Notification/T2=
$Notification/TS=
$User/Macro0=
$User/Macro1=
$User/Macro2=
$User/Macro3=
$Homing/Cycle0=Z
$Homing/Cycle1=XY
$Homing/Cycle2=
$Homing/Cycle3=
$Homing/Cycle4=
$Homing/Cycle5=
$Report/StallGuard=
$Stepper/Pulse=4
$Stepper/IdleTime=255
$Stepper/StepInvert=
$Stepper/DirInvert=
$Stepper/EnableInvert=Off
$Limits/Invert=On
$Probe/Invert=On
$Report/Status=1
$GCode/JunctionDeviation=0.010
$GCode/ArcTolerance=0.002
$Report/Inches=Off
$Firmware/Build=
$Limits/Soft=Off
$Limits/Hard=Off
$Homing/Enable=On
$Homing/DirInvert=XY
$Homing/Squared=
$Homing/Feed=200.000
$Homing/Seek=2000.000
$Homing/Debounce=250.000
$Homing/Pulloff=2.500
$GCode/MaxS=24000.000
$GCode/MinS=0.000
$Laser/FullPower=1000
$GCode/LaserMode=Off
$GCode/Line1=
$GCode/Line0=
$Spindle/Enable/Invert=Off
$Spindle/Enable/OffWithSpeed=Off
$Spindle/Delay/SpinDown=0.000
$Spindle/Delay/SpinUp=0.000
$Spindle/PWM/Invert=Off
$Spindle/PWM/Frequency=5000.000
$Spindle/PWM/Off=0.000
$Spindle/PWM/Min=0.000
$Spindle/PWM/Max=100.000
$Spindle/Type=H2A
$X/StepsPerMm=200.000
$Y/StepsPerMm=200.000
$Z/StepsPerMm=200.000
$A/StepsPerMm=200.000
$B/StepsPerMm=100.000
$C/StepsPerMm=100.000
$X/MaxRate=2500.000
$Y/MaxRate=2500.000
$Z/MaxRate=2500.000
$A/MaxRate=1000.000
$B/MaxRate=1000.000
$C/MaxRate=1000.000
$X/Acceleration=100.000
$Y/Acceleration=100.000
$Z/Acceleration=100.000
$A/Acceleration=200.000
$B/Acceleration=200.000
$C/Acceleration=200.000
$X/Home/Mpos=0.000
$Y/Home/Mpos=0.000
$Z/Home/Mpos=0.000
$A/Home/Mpos=0.000
$B/Home/Mpos=0.000
$C/Home/Mpos=0.000
$X/MaxTravel=770.000
$Y/MaxTravel=790.000
$Z/MaxTravel=90.000
$A/MaxTravel=300.000
$B/MaxTravel=300.000
$C/MaxTravel=300.000
$X/Current/Run=1.800
$Y/Current/Run=1.800
$Z/Current/Run=1.800
$A/Current/Run=1.800
$B/Current/Run=0.250
$C/Current/Run=0.250
$X/Current/Hold=1.250
$Y/Current/Hold=1.250
$Z/Current/Hold=1.250
$A/Current/Hold=1.250
$B/Current/Hold=0.125
$C/Current/Hold=0.125
$X/Microsteps=8
$Y/Microsteps=8
$Z/Microsteps=8
$A/Microsteps=16
$B/Microsteps=16
$C/Microsteps=16
$X/StallGuard=16
$Y/StallGuard=16
$Z/StallGuard=16
$A/StallGuard=16
$B/StallGuard=16
$C/StallGuard=16
$Errors/Verbose=Off

Mawg1, 2021-06-25:
Hi, I think what they are saying is you need to change the $Spindle/Type = PWM .
 Your "new settings" still have it set to H2A.  Hope this helps!

 Also, I found that using command "$RST=*" after loading new firmware will reset all the settings back to defaults.  Hope this helps!

Emanuelbastos1, 2021-06-25:
@Mawg1 Yes, you are rigth!
I paste the old settings two times, however I change it to PWM.
I edited the comment to match the correct settings!
Thank you!

Mawg1, 2021-06-25:
@Emanuelbastos1 - well that makes more sense that it was double pasted, but wanted to be sure.  I have been working on getting my YL620 operating and think I have the code correct.  If you want to give it a try, I have attached it here.  It loads through the webui just like the official bins.

You will need to set these registers on the YL:

 Configuration required for the YL620

    Parameter number        Description                     Value
    -------------------------------------------------------------------------------
    P00.00                  Main frequency                  400.00Hz (match to your spindle)
    P00.01                  Command source                  3

    P03.00                  RS485 Baud rate                 3 (9600)
    P03.01                  RS485 address                   1
    P03.02                  RS485 protocol                  2
    P03.08                  Frequency given lower limit     100.0Hz (match to your spindle cooling-type)

* had to wrap the .bin file in a zip, just extract and upload as normal.

[CNC_xPRO_V5_YL620_test.zip](https://github.com/Spark-Concepts/xPro-V5/files/6718105/CNC_xPRO_V5_YL620_test.zip)

Emanuelbastos1, 2021-07-03:
@Mawg1 I tried your code! My VFD is a YL&620-A and it worked perfectly!

I also changed the parameter shown below in the VFD, but I think that is not important.
Parameter number        Description                     Value
-------------------------------------------------------------------------------
P07.08                  First frequency source selection                  5

I can´t get the 0-10v output, but RS485 communication and PWM output are working!
I'm planning to install an emergency NC button. Can I still use your code?
Thanks!

Emanuelbastos1, 2021-07-18:
@Mawg1 and @Spark-Concepts
I am back again.
I burned a dc-dc regulator and I have a new controller. This time 0-10v output is working great!
Because I prefer to use the RS485 communication, I tried to use your firmware and this time it is not working properly.
When I connect it to the computer it says: "Undefined VFD rs485 RTS pin" in the CNCjs console.
When I send the command to move, it starts and doesn´t stop, and stays at maximum speed. It goes to alarm mode because it is reading -1 rpm.
Do you have any clue about the problem?

Spark-Concepts, 2021-07-21:
Emanuel,

Just to clarify - the new controllers dc-dc regulator is still good right?

Have you had any luck getting the rs485 working with your YL620?

"Undefined VFD rs485 RTS pin" is normal - the xPro automatically provides the RTS via hardware rather than from the ESP32 module (thus, the rs485 pin is undefined in the firmware)

1. Double check your [YL620 VFD settings](http://vancura.biz/files/Documents/CNC/YL620-A%20Setup%20table.pdf)
2. Also, double check your [VFD](https://github.com/Spark-Concepts/xPro-V5/wiki/Front_Panel#spindletypexx--rs485) wiring
3. Verify PWM/RS485 switch is toggled to RS485 (toggle switch to PWM then back to RS485)
4. If you're still having issues, please post a screenshot of your current settings (command `$S` or `$$`)

Emanuelbastos1, 2021-07-24:
Hi,

Yes, everything is good, including the dc-dc regulator!
I checked all the settings and verified everything twice.
I'm using a simple two-wire cable, without a shield, that I twisted myself with 30 cm. Can it be a noise problem?
It has the same behaviour, starts,  go to max speed and don´t even turn off.
The error: [MSG:Critical Spindle RS485 did not reach speed 2000. Reported speed is -1 rpm.]
My settings:
> $S
$Sta/SSID=CNC_xPRO_V5
$Sta/Password=******
$Sta/IPMode=DHCP
$Sta/IP=0.0.0.0
$Sta/Gateway=0.0.0.0
$Sta/Netmask=0.0.0.0
$AP/SSID=CNC_xPRO_V5
$AP/Password=******
$AP/IP=192.168.0.1
$AP/Channel=1
$System/Hostname=CNC_xPRO_V5
$Http/Enable=ON
$Http/Port=80
$Telnet/Enable=ON
$Telnet/Port=23
$Radio/Mode=AP
$Bluetooth/Name=xPRO_V5_BT
$Notification/Type=NONE
$Notification/T1=
$Notification/T2=
$Notification/TS=
$Message/Level=Info
$User/Macro0=
$User/Macro1=
$User/Macro2=
$User/Macro3=
$Homing/Cycle0=Z
$Homing/Cycle1=XY
$Homing/Cycle2=
$Homing/Cycle3=
$Homing/Cycle4=
$Homing/Cycle5=
$Report/StallGuard=
$Stepper/Enable/Delay=0
$Stepper/Direction/Delay=0
$Stepper/Pulse=4
$Stepper/IdleTime=255
$Stepper/StepInvert=
$Stepper/DirInvert=
$Stepper/EnableInvert=Off
$Limits/Invert=On
$Probe/Invert=On
$Report/Status=1
$GCode/JunctionDeviation=0.010
$GCode/ArcTolerance=0.002
$Report/Inches=Off
$Firmware/Build=
$Limits/Soft=Off
$Limits/Hard=Off
$Homing/Enable=On
$Homing/DirInvert=XY
$Homing/Squared=
$Homing/Feed=200.000
$Homing/Seek=2000.000
$Homing/Debounce=250.000
$Homing/Pulloff=2.500
$GCode/MaxS=24000.000
$GCode/MinS=0.000
$Laser/FullPower=1000
$GCode/LaserMode=Off
$GCode/Line1=
$GCode/Line0=
$Spindle/Enable/Invert=Off
$Spindle/Enable/OffWithSpeed=Off
$Coolant/Delay/TurnOn=1.000
$Spindle/Delay/SpinDown=0.000
$Spindle/Delay/SpinUp=0.000
$Spindle/PWM/Invert=Off
$Spindle/PWM/Frequency=5000.000
$Spindle/PWM/Off=0.000
$Spindle/PWM/Min=0.000
$Spindle/PWM/Max=100.000
$Spindle/Type=YL620
$X/StepsPerMm=200.000
$Y/StepsPerMm=200.000
$Z/StepsPerMm=200.000
$A/StepsPerMm=200.000
$B/StepsPerMm=100.000
$C/StepsPerMm=100.000
$X/MaxRate=2500.000
$Y/MaxRate=2500.000
$Z/MaxRate=2500.000
$A/MaxRate=1000.000
$B/MaxRate=1000.000
$C/MaxRate=1000.000
$X/Acceleration=100.000
$Y/Acceleration=100.000
$Z/Acceleration=100.000
$A/Acceleration=200.000
$B/Acceleration=200.000
$C/Acceleration=200.000
$X/Home/Mpos=0.000
$Y/Home/Mpos=0.000<Idle|MPos:0.000,0.000,0.000|FS:0,0>
$Z/Home/Mpos=0.000
$A/Home/Mpos=0.000
$B/Home/Mpos=0.000
$C/Home/Mpos=0.000
$X/MaxTravel=780.000
$Y/MaxTravel=785.000
$Z/MaxTravel=75.000
$A/MaxTravel=300.000
$B/MaxTravel=300.000
$C/MaxTravel=300.000
$X/Current/Run=1.800
$Y/Current/Run=1.800
$Z/Current/Run=1.800
$A/Current/Run=1.800
$B/Current/Run=0.250
$C/Current/Run=0.250
$X/Current/Hold=1.250
$Y/Current/Hold=1.250
$Z/Current/Hold=1.250
$A/Current/Hold=1.250
$B/Current/Hold=0.125
$C/Current/Hold=0.125
$X/Microsteps=8
$Y/Microsteps=8
$Z/Microsteps=8
$A/Microsteps=16
$B/Microsteps=16
$C/Microsteps=16
$X/StallGuard=16
$Y/StallGuard=16
$Z/StallGuard=16
$A/StallGuard=16
$B/StallGuard=16
$C/StallGuard=16
$Errors/Verbose=Off
ok
> $i
[VER:1.3a.20210424:]
[OPT:MPHBSW]
[MSG:Using machine:CNC_xPRO_V5_XYYZ_YL485_NO]
[MSG:Mode=AP:SSDI=CNC_xPRO_V5:IP=192.168.0.1:MAC=40-F5-20-A0-40-95]
[MSG:No BT]
ok

Thanks for the help!

Spark-Concepts, 2021-07-26:
Double check the following [YL620 VFD settings](http://vancura.biz/files/Documents/CNC/YL620-A%20Setup%20table.pdf)

    Configuration required for the YL620
    Parameter number        Description                     Value
    -------------------------------------------------------------------------------
    P00.00                  Main frequency                  400.00Hz (match to your spindle)
    P00.01                  Command source                  3

    P03.00                  RS485 Baud rate                 3 (9600)
    P03.01                  RS485 address                   1
    P03.02                  RS485 protocol                  2
    P03.08                  Frequency given lower limit     100.0Hz (match to your spindle cooling-type)

Spark-Concepts, 2021-08-05:
Have you had any success getting your YL620 VFD working via the RS485 without receiving `MSG:Critical Spindle RS485 did not reach speed 2000. Reported speed is -1 rpm` ?

Emanuelbastos1, 2021-08-07:
Unfortunately, I haven´t. I also triple-checked the settings and they are correct.
After I send the speed command, the spindle starts rotating, goes up until max speed, and stays at maximum speed until I cut the power of the vfd.

feeder> M3 S6000
feeder> M5
[MSG:Spindle RS485 Unresponsive 7]
[MSG:Critical Spindle RS485 did not reach speed 6000. Reported speed is -1 rpm.]
ok
ALARM:10

Radar224, 2021-08-14:
I also had lots of similar problems with this VFD. I gave up on it and purchased the HuanYang.
Works on the first try.

Closed 2021-09-16.

Thread 32 (2021-06-16):

Steppers only work after connecting twice

allistar, 2021-06-16:
I use CNCjs to control my XPro. When I start CNCjs I connect it to the XPro (using USB). I then run the homing cycle. The CNCjs display shows the Z axis moving but the stepper isn't doing anything. I then disconnect and reconnect after which it works as expected. My process now when starting CNCjs is to connect, disconnect, then connect before using the machine. This issue happens every single time. In both cases when I connect I hear the stepper power on (a slight "snapping" sound).

What explains the behaviour and is there anything that can be done to fix it? I'm running the latest XYYZ RS485 firmware.

Spark-Concepts, 2021-06-16:
After connecting the COM port in CNCjs, press the reset button on the side of the xPro-V5 to sync to CNCJS

allistar, 2021-06-16:
Thanks. Do I need to do that every time I start the computer and/or the XPro?

pacman171, 2021-06-17:
Hi Allistar, I have to do the same every time. I switch the vfd and xPro on, then about 30 sec later I have to press the reset button. Also whenever I startup, it always shows an alarm.

Spark-Concepts, 2021-06-18:
Before you connect to the serial port in CNCjs check the "Enable hardware flow control" - this should eliminate you having to manually press the reset every time you connect.

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

pacman171, 2021-06-18:
Works for me, thanks!

allistar, 2021-06-20:
I always have "Enable flow control" set. I think my issue is that I wasn't giving the XPro enough time to start up. Now I turn on the VFD and XPro, then the computer and by the time the PC has started up and I run CNCjs this issue doesn't occur. I'm reclosing this issue, thanks for the help.

Closed 2021-06-18.

Thread 33 (2021-06-19):

0-10 V not working

Emanuelbastos1, 2021-06-19:
I can´t get the 0-10 V analog output working!
Firstly when I sent the command M3 S1200 to the CNC Xpro V5 the voltage 0-10 V output didn´t stop until it reached the maximum value. Even when turning it off and on again, if I send the command M3 S500 the voltage kept going until the maximum. Later it didn´t give any value of voltage regarding any M3 SXXXX I type, and it is like that right now.
All the axis and limit switches are working great.
Anyone can help me?

Spark-Concepts, 2021-06-21:
Emmanuel,

Once again, my apologies for my delayed response - we had a slight family emergency over the weekend.

I see from your other post that you measured voltage 0-10V on the x-pro. Are you verifying this using a multimeter?

If possible, please check the following (disconnect everything except 24V power and USB (if using a serial sender)):
1. Ensure the switch on the xPro is set to EN/PWM if using PWM
2. Please download [test2.nc](https://github.com/Spark-Concepts/xPro-V5/blob/main/test2.nc)
3. Run test2.nc: using a multimeter - place the negative lead on the ground terminal on the front of the xPro - as soon as you hit play to run test2.nc - you should see ~2.5V on GND-and-PWM, and ~5V GND-and-0-10V
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

Please let me know if you're measuring voltage while test2.nc is running

Emanuelbastos1, 2021-06-22:
Yes, I'm verifying this using a multimeter.
I did exactly as you said and I still measure 0V at the 0-10V output and 5V
In the PWM. (Before I was reading 0V in the PWM output).

Spark ***@***.***> escreveu no dia terça, 22/06/2021 à(s)
00:20:

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

--

Emanuel Bastos

Mechanical Engineer

Faculty of Engineering of the University of Porto

m: + 351 917 734 998 | e: ***@***.***

  <http://www.linkedin.com/in/emanuel-bastos>
<http://www.linkedin.com/in/emanuel-bastos>
<https://www.facebook.com/efcbastos>

Emanuelbastos1, 2021-06-22:
This time I notice something different. After switching on the XPRO V5,
just connect to power, the PWM output is always 5V. (First I was getting 0V)
I runned the code test2.nc, only connected to 24V and usb connection. The
results were the same, 0v in the 0-10V output and 5V in the PWM output.
I did this previously without being connected, so I did it again and the
program was running correctly in the CNCJs desktop app.
Can I do something else?
Thank you for the support!

Emanuelfrancisco Carvalho ***@***.***> escreveu no dia
terça, 22/06/2021 à(s) 18:22:

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

--

Emanuel Bastos

Mechanical Engineer

Faculty of Engineering of the University of Porto

m: + 351 917 734 998 | e: ***@***.***

  <http://www.linkedin.com/in/emanuel-bastos>
<http://www.linkedin.com/in/emanuel-bastos>
<https://www.facebook.com/efcbastos>

Spark-Concepts, 2021-06-23:
I believe some (if not all) of your troubles may be software (setting) related - refer to https://github.com/Spark-Concepts/xPro-V5/issues/30#issuecomment-865413416

Once we've verified the correct firmware & spindle settings - once again, disconnect everything except 24V power and USB (if using a serial sender):

### NOTE: 24V must be connected and `ON` for this test...

1. Ensure the switch on the xPro is set to EN/PWM
2. Download, open, and run [`test2.nc`](https://github.com/Spark-Concepts/xPro-V5)
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

4. As soon as you hit run using a multimeter and the negative (black) lead to ⏚; as soon as you hit play to run `test2.nc`, measure "PWM" and "0-10V" on "TOOLHEAD" connector, you should measure the folloing:
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

Spark-Concepts, 2021-06-23:
If you're seeing ~2.5V on the `PWM`, but still not seeing anything on the `0-10V`

1. Remove the 4x screws on the lid and press firmly on the two area's as seen below to ensure the board-board connectors are positively engaged
2. Using a small flat head screw driver, adjust the potentiometer clockwise then counter clockwise
3. Follow the test procedure above
4. If voltage is present on `0-10V' while running `test2.nc', adjust the voltage to 5V ±.1V

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

Emanuelbastos1, 2021-06-24:
I'm doing everything as you say and I still don´t have any voltage in the 0-10 V output.
The PWM seems to be working properly.
I push in the areas you said to ensure the pins are connected.
I also made a video that you can download from the link bellow:
[https://we.tl/t-FExh48CNvU](url)
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

Anson90, 2022-03-20:
I have a similar issue where my voltage is stuck at 2.4v (0-10v pin) and the fine adjustment doesn’t do anything.

Closed 2021-07-18.

Thread 34 (2021-07-02):

USB problem

Radar224, 2021-07-02:
I wonder if there is anyone that could help me with this:

I recently acquired a XPo V5.
I installed it and after tweaking the settings it ran fine.  However, I did noticed that I had some intermittent issues with my axis.
After some troubleshooting I realized that if I unplug the USB cable to my computer the controller stops sending stepper outputs. Also, the radio AP is not visible without plugging in the usb cable.

When connected by USB I am able to connect through WiFi and access the miniSD card.

Just to be clear, since this might sound pretty confusing, I can run a program from my SD card, as long as it is plugged into a USB connection. Otherwise it stops to moment I disconnect the USB.

Please help!

Thanks
Marinus

Spark-Concepts, 2021-07-03:
Hey Marinus,

I see you've also submitted this question via [contact us](https://www.spark-concepts.com/contact-us-1/) through the [Spark-Concepts](https://www.spark-concepts.com/) website.  Please continue to coordinate via email directly if problem your persists. - please know this is a rare issue & one I haven't seen before. (note, you can also plug into a USB power brick instead of a PC...)

The Blue LED will illuminate upon plugging the xPro into a computer USB port or USB power brick... However, if you don't Open the COM Port via a GRBL sender or Serial terminal, the Blue LED will turn off after a few seconds... (this is normal)

That said, and given it's the weekend, and you're willing/able, lets try and check a few things.

1. Disconnect the USB cable and power attempt to power using your 24V power supply
2. Remove the lid (removing the four lid screws) to expose the top PCB
3. Turn your 24V power supply ON
4. Measure for 5 Volts as shown below (also check the remaining voltages as shown on the right)
5. Remove 24V or turn OFF 24V power supply
6. Plug in USB cable, and power via a PC or USB power brick
7. Re-Measure for 5V and 3.3V (24V should be OFF)
8. Please let me know your test results

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

Radar224, 2021-07-05:
Hi again,

I am not sure if you seen my email.

I have tested as per your request and found 0 volt at the 5v point you
indicated. This is with the unit powered up.

All the other voltages are as you described.

I am currently using a power brick to power the unit through USB.

Thanks much for your help!
Marinus Onos

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

Spark-Concepts, 2021-07-06:
Marinus,

Okay, for the time being I recommend you continue to use the USB power
brick.

We've noted a few issues where the XL1509 DC-DC converter chip has been
damaged.  This is primarily due to the user inadvertently short circuit 5V
to ground via a limit switch and/or z-probe output (not implying or saying
this is the cause in your case).   Ultimately we've noted slight variances
of this part's features where the "built in" over current protection has
failed; this often results in the permanent damage of the DC-DC regulator.

Fortunately, albeit unfortunately, this issue has been mitigated in the
current production of the xPro. As I mentioned, continuing the use of the
USB power brick - a perfectly valid workaround.  However, if this does
become an issue - I recommend contacting the vendor from which you
purchased your xPro to request a replacement (although, wait until the
vendor receives a new shipment of xPros).

V/r
Bill

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

Closed 2021-07-10.

Thread 39 (2021-08-12):

xPro-V5: Warning "Laser Output Pin Not Defined"

Untitledduke, 2021-08-12:
Hi,

Using the xPro on my Lead 1515 with the HUANYANG VFD so I set this up using the RS485 switch and applicable firmware. It works.

I am trying to connect a laser now but I get a warning "Laser Output Not Defined" when setting $Spindle/Type=Laser. Laser mode is enabled. I can't control the laser intensity at all and I assume it is because of the warning.

The laser has an On/Off button on it so I assume I have to connect it to the relay. It has three connection Pins namely +12V, GND and PWM.

Can somebody please assist? What am I missing?

Untitledduke, 2021-08-12:
Some additional information.

To note, the relay keeps switching if the jumper is in the position indicated in the documentation i.e. SP_EN. If kept in the default position, this does not happen. Regardless of the jumper position, the mentioned warning is received.

Is it possibly the case that the firmware for RS485 can not be used to control a laser also?

Spark-Concepts, 2021-08-12:
For the older firmware (everything before yesterdays upload) you need to upload RS485 or PWM specific firmware as they share pins.  with yesterdays upload you can change these real-time using the $Spindle/Type= commands and setting the PWM / RS485 switch on the front to the correct option.  The only caveat to this is the BM3D Lasers, these have a resting PWM offset and will require the CNC_xPRO_V5_XYYZ_BM3D_NO firmware to continually drive the laser low - also recommend starting the xPRO and then the laser with these modules.

Untitledduke, 2021-08-12:
Hi,
Thanks for the feedback.

To confirm, if I used CNC_xPRO_V5_XYYZ_485_NC, then I should use the new firmware CNC_xPRO_V5_XYYZ_NC uploaded yesterday?

My wiring I leave as is for using a VFD connected to the RS switch and laser connected to the relay, correct?

Let me know and then I will test and revert back.

Untitledduke, 2021-08-12:
Hi, Just ran the update and it looks fine but the laser keeps on at what seems to be full power.

As soon as i put the laser on using its onboard on switch, it fires up and does not shut off.

Is there a setting I am missing or is this a laser issue in your opinion?

Untitledduke, 2021-08-13:
I decided to send M3 S3 and this dimmed the laser and kept it dimmed until I moved the laser into position. As soon as i sent the command to move in the -X direction, the laser went back to the same intensity as it was as power on.

Not sure if the fault lies with the laser now or the controller?

Untitledduke, 2021-08-13:
Hello @Spark-Concepts

I decided to contact the xPro supplier here in South Africa (Neotronics) and did some further tests. They asked that I provide the details below to you.

We need your help please, not sure if the laser is faulty or the controller with new firmware is acting up.

Test process:

1. System switched on
2. Laser and controller confirmed to have power
3. Movements made in X and Y plane to position laser
4. M3 S3 command given, can hear relay switch in controller. Voltage measured between GND and PWM going to the laser - low value observed.
5. M5 command given, can hear relay switch in controller. +-5V measured at same point as above.

CNCJ's, Lightburn and LaserGRBL used to test and in all cases the laser does not switch on.

Kindly please confirm if the voltage outputs observed are correct i.e. this is the normal working or expected working of the controller.

Attached some setting details.
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

pacman171, 2021-08-13:
Hi Untitledduke, please could you contact me? I live in Cape Town, would be great to have a local person to bounce ideas off.
Cheers Paul (conlonfamily@gmail.com)

rhdhybrid, 2021-08-13:
Hello, I see your having a little issue with your laser, we have been experimenting with some firmware in this thread.

https://github.com/Spark-Concepts/xPro-V5/issues/23

I would give this a read and try out the firmware, worked great for me. I'm still testing as I feel like the power commanded does not quite reflect the power observed, however it still functions as expected.

Spark-Concepts, 2021-08-13:
Hi Untitledduke - could you post the manufacturer of your laser and a picture or two of the wiring between the controller and the laser?

Untitledduke, 2021-08-13:
> Hi Untitledduke - could you post the manufacturer of your laser and a picture or two of the wiring between the controller and the laser?

Thanks for the reply.

I read your reply, went back to the machine and started taking pictures of the connections. Decided to test wire connections (conductivity and voltage output) for the umpteenth time to be sure they go to where they must and then I noticed an odd fluctuation in the voltage reading and flickering on the laser while testing one of my 4 core wires. I decided to disconnect the wire and connected a new one...looks like I had a 4 core wire that was damaged somewhere and for some reason passed each of my previous tests.

At the moment I can do the following:

1. I have to switch on the xPro first and then go to the software (tested in lasergrbl and lightburn and these worked for this).
2. In the software I need to send M3 S0 which switches the relay.
3. Once the above has been done I have to manually switch on the laser with a button on the laser itself. Because of the M3 S0 command, my laser does not burn at this time.
4. At this point, sending an M5 command results in the relay to switch off and then the laser fires at full strength. I can send an M3 S0 and it will switch on the relay and in turn the laser stops firing at full power.

At the moment It is key that I not switch on the laser using its onboard on/off button before sending the M3 S0 command. If I don't send the command, it starts up at full power and burns whatever is close.

I am not sure if this is normal working procedure for the laser I have and still need to report back to the supplier. Laser in question - [40W Laser](https://neotronics.co.za/index.php?route=product/product&path=113_139&product_id=701). **_I am also not sure if this laser falls in the group you mentioned namely BM3D?_**

With this type of laser I run the risk of burning projects because I see most of the engraving/cutting gcode end with an M5 line and an M5 means my laser goes to full power due to the relay switching off as explained earlier. I still need to see what I can do to work around this if at all possible. I assume that the relay switching off is correct?

Thanks again

Untitledduke, 2021-08-13:
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

Thanks, will read through it.

Untitledduke, 2021-08-14:
> Hi Untitledduke - could you post the manufacturer of your laser and a picture or two of the wiring between the controller and the laser?

Hello @Spark-Concepts , trust you are all well.

Turns out

1. I had a faulty wire that has no visible damage but does not conduct all the time,
2. Laser I have is in the category described above i.e. BM3D - it keeps firing at full when switched on using the onboard on/off switch, M3S0 turns the intensity down but as soon as M5 or a cycle ends, it fires at full again. With no documentation on the laser, I had to run a couple of tests of which the last was changing firmware, switching on controller first then laser else it is a very unsafe situation.
3. Firmware for BM3D did the trick and I have not found any issues after the firmware change today.

Thanks for the support.

Closed 2021-08-20.

Thread 42 (2021-08-15):

P alarm and spindle control

dennis954rr01, 2021-08-15:
Hello, I'm very new to cnc and I'm having a terrible time getting my Xpro V5 to control the queenbee pro.  I've followed the RS485 directions to a T but I kept getting a P alarm when running on commander.  I've searched all over and can't figure out what  alarm is, is it EMI alarm?  I have shielded wire on everything and spindle completely seperate from the controller and limit switches but no luck.  Yesterday I cut off Hard limits and was able to get the spindle to fire up but could not control it via software only manually via the knob.  Today I can't even get the M3 and M5 codes to work.  =(  I enter M3 S6000 or M3 alone and nothing, it keeps showing Pn:P>.  I'm unsure what I'm doing wrong, any help would be so greatly appreciated.

Spark-Concepts, 2021-08-20:
Hi Dennis, for the 485 control, make sure you set the appropriate registers on your VFD and flip the PWM/485 switch on the front of the xPRO to the 485 side.  If you have loaded the latest firmware you will need to define your spindle type using the "$Spindle/Type = _option_" command.  If you open the controller in CNCjs, then press the manual resest button, you will see the 485 startup and/or error messages.

The Pn:P alarm means that your probe is being triggered.  Could you send a list of your $S settings?

dennis954rr01, 2021-08-21:
Thanks, I wound up getting the RS485 going and just unplugged the Probe so the alarm is still there but it's not stopping the operation of it.   So I had everything working perfectly then the next day my X gantry was going haywire when I would move it up and down the y.  Every 2-3 clicks on the Y in either direction and one stepper would spin up in a different direction causing everything to get out of alignment.  After hours of troubleshooting I found that it was not any of the cables I was using but the Y1 terminal of the xpro v5.  I unplugged everything else and no matter the cable or stepper it was connected to if it was on the Y1 it would spin randomly.  One minute in the Y+ direction the next in the Y- direction even though I was moving it in only one direction.  I thought it might be EMI but I have EVERYTHING properly shielded and grounded plus right now all I have connected is the Y, I put it to the x stepper just so I could show the behavior and I'll try and attach that video to this email.  So to clarify, I have everything good except I have zero idea why the Y is going nuts even when it's the only stepper connected and I've ensured both the stepper and cable work perfectly on all the other terminals.  Please help!  lol

Here are the setting.

$0 = 10    (Step pulse time, microseconds)
$1 = 255    (Step idle delay, milliseconds)
$2 = 0    (Step pulse invert, mask)
$3 = 0    (Step direction invert, mask)
$4 = 0    (Invert step enable pin, boolean)
$5 = 1    (Invert limit pins, boolean)
$6 = 0    (Invert probe pin, boolean)
$10 = 3    (Status report options, mask)
$11 = 0.010    (Junction deviation, millimeters)
$12 = 0.002    (Arc tolerance, millimeters)
$13 = 0    (Report in inches, boolean)
$20 = 0    (Soft limits enable, boolean)
$21 = 0    (Hard limits enable, boolean)
$22 = 1    (Homing cycle enable, boolean)
$23 = 5    (Homing direction invert, mask)
$24 = 100.000    (Homing locate feed rate, mm/min)
$25 = 500.000    (Homing search seek rate, mm/min)
$26 = 250.000    (Homing switch debounce delay, milliseconds)
$27 = 5.000    (Homing switch pull-off distance, millimeters)
$30 = 24000.000    (Maximum spindle speed, RPM)
$31 = 8000.000    (Minimum spindle speed, RPM)
$32 = 0    (Laser-mode enable, boolean)
$N1=
$N0=
$100 = 200.000    (X-axis travel resolution, step/mm)
$101 = 200.000    (Y-axis travel resolution, step/mm)
$102 = 200.000    (Z-axis travel resolution, step/mm)
$103 = 200.000
$104 = 100.000
$105 = 100.000
$110 = 4000.000    (X-axis maximum rate, mm/min)
$111 = 4000.000    (Y-axis maximum rate, mm/min)
$112 = 1500.000    (Z-axis maximum rate, mm/min)
$113 = 1000.000
$114 = 1000.000
$115 = 1000.000
$120 = 500.000    (X-axis acceleration, mm/sec^2)
$121 = 500.000    (Y-axis acceleration, mm/sec^2)
$122 = 100.000    (Z-axis acceleration, mm/sec^2)
$123 = 200.000
$124 = 200.000
$125 = 200.000
$130 = 1500.000    (X-axis maximum travel, millimeters)
$131 = 1500.000    (Y-axis maximum travel, millimeters)
$132 = 120.000    (Z-axis maximum travel, millimeters)
$133 = 300.000
$134 = 300.000
$135 = 300.000

Dennis Trisch
404-910-2249 mobile

________________________________
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

dennis954rr01, 2021-08-21:
Here is the video link.  I have the X stepper hooked up to the Y terminal only to show how it randomly moves the stepper in different directions.  Video wouldn't attach the the previous email due to size so here is a link to a cloud version.  Thanks for your help.  https://photos.app.goo.gl/B8eZNxRT2dHzSPLCA
[https://lh3.googleusercontent.com/01flB8a_TiDW2dqpjK-lHWEHC9uChYtdOshdtf9ZKHl964IGrMAnXVcbpSKjtZ0xp-Ao3CLKg4xhJV_7T8ztjHRMZMQQzP9gRFTxI6hsli2YLOPhtQfs8b2d8kVM8UQ2fhB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]<https://photos.app.goo.gl/B8eZNxRT2dHzSPLCA>
New video by Dennis Trisch<https://photos.app.goo.gl/B8eZNxRT2dHzSPLCA>
photos.app.goo.gl

Dennis Trisch
404-910-2249 mobile

________________________________
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

Spark-Concepts, 2021-08-23:
Hi Dennis - thank you for the video, definitely some strange behavior.  Per our emails, we are going to swap this unit out so we can investigate what is causing the directionality issue on the Y port.  We'll update here when we complete troubleshooting.  Thanks!

dennis954rr01, 2021-08-29:
Hello, so I received my new Xpro V5 in the mail today but sadly the problem is still exactly the same.  So that made me think my wiring might somehow be messed up but I had purchased a blackbox controller (dirty word I know) but I plugged it in and it's running perfectly.   I've got the same speeds, wiring, steppers, etc and the Xpro continually messes up on the Y2 no matter the configuration but the blackbox works with zero problems.

So I am totally confused as to what is going on with the xpro controller but unfortunately it won't do me much good given it won't work properly so my next question is if there is a way for me to return the Xpro and receive a refund if I bought it from Bulkman?  I'm going to attach a video to this email so that you can see the difference in performance when I swap them and get a visual of it.  I apologize for the length and amateur camera work but I hope it will illustrate the issue and you'll be able to see that it must be an issue with the controller.

Any help you could provide would be greatly appreciated, I'd love to use the controller but unfortunately I can't seem to get it to work.

https://photos.app.goo.gl/oJCCEd4bzNCVmEJh9
[https://lh3.googleusercontent.com/MLgMbNhPSyHz7uc8AX3KM_946dpXykJ0VtueBBNdB6QfCbyh8fQVD0d-ISBo8v_I_Bme75QywNR3Vax3yEB2la8uwqgRl5Z-o0YXVHnykNE6cJCgk9tJaCGPv28TKPm-t87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]<https://photos.app.goo.gl/oJCCEd4bzNCVmEJh9>
New video by Dennis Trisch<https://photos.app.goo.gl/oJCCEd4bzNCVmEJh9>
photos.app.goo.gl

Thanks

________________________________
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

Closed 2021-08-25.

Thread 43 (2021-08-22):

Y axes won't home

cdo1955, 2021-08-22:
I have a OSH xPRO v5and its set up on a Queenbee 1500x1500mm system. At first everything would work, but sporadically Y would not Home. After Z and x home normally Y just jumps 3mm in the positive direction and errors out with the message seen below. Now Y never homes and I don't know what has changed. The error says failed to clear Y limit switch but it never gets close to the limit switch to start with.
I have homing set to the front left corner. And I have tried with soft limits and had limits on and off. Its strange because some times it works. Can a help with this issue?

GRBL settings

>>> $H
[Error] An error was detected while sending '$H': (ALARM:8) Homing fail. Pull off travel failed to clear limit switch. Try increasing pull-off setting or check wiring. Streaming has been paused.
[Error] Error while processing response <An error was detected while sending '$H': (ALARM:8) Homing fail. Pull off travel failed to clear limit switch. Try increasing pull-off setting or check wiring. Streaming has been paused.>
[Error] Error while processing response <ok>: An unexpected command was completed by the controller.
Grbl 1.3a ['$' for help]
>>> $$
$0 = 4    (Step pulse time, microseconds)
$1 = 255    (Step idle delay, milliseconds)
$2 = 0    (Step pulse invert, mask)
$3 = 3    (Step direction invert, mask)
$4 = 0    (Invert step enable pin, boolean)
$5 = 1    (Invert limit pins, boolean)
$6 = 1    (Invert probe pin, boolean)
$10 = 1    (Status report options, mask)
$11 = 0.010    (Junction deviation, millimeters)
$12 = 0.002    (Arc tolerance, millimeters)
$13 = 0    (Report in inches, boolean)
$20 = 0    (Soft limits enable, boolean)
$21 = 0    (Hard limits enable, boolean)
$22 = 1    (Homing cycle enable, boolean)
$23 = 3    (Homing direction invert, mask)
$24 = 25.000    (Homing locate feed rate, mm/min)
$25 = 1000.000    (Homing search seek rate, mm/min)
$26 = 250.000    (Homing switch debounce delay, milliseconds)
$27 = 4.000    (Homing switch pull-off distance, millimeters)
$30 = 12000.000    (Maximum spindle speed, RPM)
$31 = 0.000    (Minimum spindle speed, RPM)
$32 = 0    (Laser-mode enable, boolean)
$N1=
$N0=
$100 = 200.000    (X-axis travel resolution, step/mm)
$101 = 200.000    (Y-axis travel resolution, step/mm)
$102 = 200.000    (Z-axis travel resolution, step/mm)
$103 = 200.000
$104 = 100.000
$105 = 100.000
$110 = 2500.000    (X-axis maximum rate, mm/min)
$111 = 2500.000    (Y-axis maximum rate, mm/min)
$112 = 2500.000    (Z-axis maximum rate, mm/min)
$113 = 1000.000
$114 = 1000.000
$115 = 1000.000
$120 = 100.000    (X-axis acceleration, mm/sec^2)
$121 = 100.000    (Y-axis acceleration, mm/sec^2)
$122 = 100.000    (Z-axis acceleration, mm/sec^2)
$123 = 200.000
$124 = 200.000
$125 = 200.000
$130 = 1250.000    (X-axis maximum travel, millimeters)
$131 = 1250.000    (Y-axis maximum travel, millimeters)
$132 = 120.000    (Z-axis maximum travel, millimeters)
$133 = 300.000
$134 = 300.000
$135 = 300.000

Spark-Concepts, 2021-08-23:
Hi this happens when you try to home and there is a trigger signal on the limit switch.

Send command "?" will query the status of the switches - you will see the line ending with Pn: ### if a switch is triggered (the ### will be replaced with XY and/or Z depending on what axis is triggered).  If you see that Y is triggered, check your wiring to make sure it is wired as NO, check that the switch is fully releasing, and check that the switch is not overly tight (for some reason the microlimit switches short out when overly tight).

cdo1955, 2021-08-24:
Thanks for your response, I try all the above.
 Carl

________________________________
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

cdo1955, 2021-09-02:
Can I ask you one more question?
I don't see how to land the control wires coming the xpro v5  to the Hungyang VFD for the 10VDC  to control the speed?
 What terminals inside the VFD would the  Ground abd 10 VDC line land on?
In the picture on the istructions page it just has the lines disappear inside a photo the VFD/
Can you enlighten me on this set up?
 Carl[cid:f02882b1-f1fa-44bb-a823-ade34cf1cd50]

________________________________
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

Closed 2021-09-15.

Thread 44 (2021-08-23):

RS485 issue?

ObbiPrime, 2021-08-23:
Hi,

I am trying to hook up my VFD using the RS485 connection but I seem to be having some issues.

Once I initialize the machine this is what happens :

CNCjs 1.9.22 [Grbl]
Connected to COM5 with a baud rate of 115200
PI_FAST_FLASH_BOOT)
configsip: 0, SPIWP:0xee
clk_drv:0x00,q_dr, clock div:1
load:0x3fff0018,len:4
load:0x3fff001c,len:1216
ho 0 tail 12 room 4
load:0x40078000,len:9720
ho 0 tail 12 room 4
load:0x40080400,len:6352
entry 0x400806b8
[MSG:Grbl_ESP32 Ver 1.3a Date 20201212]
[MSG:Compiled with ESP32 SDK:v3.2.3-14-gd3e562907]
[MSG:Using machine:CNC_xPRO_V5_XYYZ_RS485_NC]
[MSG:Axis count 3]
[MSG:RMT Steps]
[MSG:Init Motors]
[MSG:TMCStepper Library Ver. 0x000701]
[MSG:X  Axis Trinamic TMC5160 Step:GPIO(12) Dir:GPIO(14) CS:GPIO(17) Disable:None Index:1 R:0.050 Limits(0.000,1260.000)]
[MSG:X  Axis Trinamic driver test passed]
[MSG:Y  Axis Trinamic TMC5160 Step:GPIO(27) Dir:GPIO(26) CS:GPIO(17) Disable:None Index:2 R:0.050 Limits(0.000,1265.000)]
[MSG:Y  Axis Trinamic driver test passed]
[MSG:Y2 Axis Trinamic TMC5160 Step:GPIO(33) Dir:GPIO(32) CS:GPIO(17) Disable:None Index:3 R:0.050 Limits(0.000,1265.000)]
[MSG:Y2 Axis Trinamic driver test passed]
[MSG:Z  Axis Trinamic TMC5160 Step:GPIO(15) Dir:GPIO(2) CS:GPIO(17) Disable:None Index:4 R:0.050 Limits(0.000,120.000)]
[MSG:Z  Axis Trinamic driver test passed]
[MSG:Initializing RS485 VFD spindle]
[MSG:Undefined VFD_RS485_RTS_PIN]
[MSG:VFD RS485  Tx:GPIO(4) Rx:GPIO(25) RTS:GPIO(0)]
[MSG:Local access point CNC_xPRO_V5 started, 192.168.0.1]
[MSG:Captive Portal Started]
[MSG:HTTP Started]
[MSG:TELNET Started 23]
[MSG:Flood coolant on pin GPIO(21)]
[MSG:Mist coolant on pin GPIO(21)]
[MSG:X  Axis limit switch on pin GPIO(35)]
[MSG:Y  Axis limit switch on pin GPIO(34)]
[MSG:Z  Axis limit switch on pin GPIO(39)]
[MSG:Probe on pin GPIO(22)]
Grbl 1.3a ['$' for help]
client> $$
[MSG:'$H'|'$X' to unlock]
$0=4 (Step pulse time, microseconds)
$1=255 (Step idle delay, milliseconds)
$2=0 (Step pulse invert, mask)
$3=0 (Step direction invert, mask)
$4=0 (Invert step enable pin, boolean)
$5=0 (Invert limit pins, boolean)
$6=1 (Invert probe pin, boolean)
$10=1 (Status report options, mask)
$11=0.010 (Junction deviation, millimeters)
$12=0.002 (Arc tolerance, millimeters)
$13=0 (Report in inches, boolean)
$20=0 (Soft limits enable, boolean)
$21=0 (Hard limits enable, boolean)
$22=1 (Homing cycle enable, boolean)
$23=7 (Homing direction invert, mask)
$24=200.000 (Homing locate feed rate, mm/min)
$25=2000.000 (Homing search seek rate, mm/min)
$26=250.000 (Homing switch debounce delay, milliseconds)
$27=3.000 (Homing switch pull-off distance, millimeters)
$30=24000.000 (Maximum spindle speed, RPM)
$31=0.000 (Minimum spindle speed, RPM)
$32=0 (Laser-mode enable, boolean)
$N1=
$N0=
$100=200.000 (X-axis travel resolution, step/mm)
$101=200.000 (Y-axis travel resolution, step/mm)
$102=200.000 (Z-axis travel resolution, step/mm)
$103=200.000
$104=100.000
$105=100.000
$110=2500.000 (X-axis maximum rate, mm/min)
$111=2500.000 (Y-axis maximum rate, mm/min)
$112=2500.000 (Z-axis maximum rate, mm/min)
$113=1000.000
$114=1000.000
$115=1000.000
$120=100.000 (X-axis acceleration, mm/sec^2)
$121=100.000 (Y-axis acceleration, mm/sec^2)
$122=100.000 (Z-axis acceleration, mm/sec^2)
$123=200.000
$124=200.000
$125=200.000
$130=1260.000 (X-axis maximum travel, millimeters)
$131=1265.000 (Y-axis maximum travel, millimeters)
$132=120.000 (Z-axis maximum travel, millimeters)
$133=300.000
$134=300.000
$135=300.000
ok
>

I notice I get this message - [MSG:Undefined VFD_RS485_RTS_PIN]

I can start the spindle without an issue but I get this message as it runs -
feeder> M3 S5000
ok
[MSG:Spindle RS485 Unresponsive 7]
[MSG:Spindle RS485 Unresponsive 8]
[MSG:Spindle RS485 Unresponsive 8]
[MSG:Spindle RS485 Unresponsive 8]
[MSG:Spindle RS485 Unresponsive 8]
[MSG:Spindle RS485 Unresponsive 8]
feeder> M5
ok
[MSG:Spindle RS485 Unresponsive 6]
[MSG:Spindle RS485 Unresponsive 8]
>

I'm not sure what this means or what I should do about it ?
Does anyone have any suggestions ?

Thanks

FYI
> $s
$Sta/SSID=CNC_xPRO_V5
$Sta/Password=******
$Sta/IPMode=DHCP
$Sta/IP=0.0.0.0
$Sta/Gateway=0.0.0.0
$Sta/Netmask=0.0.0.0
$AP/SSID=CNC_xPRO_V5
$AP/Password=******
$AP/IP=192.168.0.1
$AP/Channel=1
$System/Hostname=CNC_xPRO_V5
$Http/Enable=ON
$Http/Port=80
$Telnet/Enable=ON
$Telnet/Port=23
$Radio/Mode=AP
$Bluetooth/Name=XPRO_V5_BT
$Notification/Type=NONE
$Notification/T1=
$Notification/T2=
$Notification/TS=
$User/Macro0=
$User/Macro1=
$User/Macro2=
$User/Macro3=
$Homing/Cycle0=XY
$Homing/Cycle1=
$Homing/Cycle2=
$Homing/Cycle3=
$Homing/Cycle4=
$Homing/Cycle5=
$Report/StallGuard=
$Stepper/Pulse=4
$Stepper/IdleTime=255
$Stepper/StepInvert=
$Stepper/DirInvert=
$Stepper/EnableInvert=Off
$Limits/Invert=Off
$Probe/Invert=On
$Report/Status=1
$GCode/JunctionDeviation=0.010
$GCode/ArcTolerance=0.002
$Report/Inches=Off
$Firmware/Build=
$Limits/Soft=On
$Limits/Hard=On
$Homing/Enable=On
$Homing/DirInvert=XYZ
$Homing/Squared=
$Homing/Feed=200.000
$Homing/Seek=2000.000
$Homing/Debounce=250.000
$Homing/Pulloff=3.000
$GCode/MaxS=24000.000
$GCode/MinS=0.000
$Laser/FullPower=1000
$GCode/LaserMode=Off
$GCode/Line1=
$GCode/Line0=
$Spindle/Enable/Invert=Off
$Spindle/Enable/OffWithSpeed=Off
$Spindle/Delay/SpinDown=0.000
$Spindle/Delay/SpinUp=0.000
$Spindle/PWM/Invert=Off
$Spindle/PWM/Frequency=5000.000
$Spindle/PWM/Off=0.000
$Spindle/PWM/Min=0.000
$Spindle/PWM/Max=100.000
$Spindle/Type=HUANYANG
$X/StepsPerMm=200.000<Idle|MPos:53.000,53.000,120.000|FS:0,0>
$Y/StepsPerMm=200.000
$Z/StepsPerMm=200.000
$A/StepsPerMm=200.000
$B/StepsPerMm=100.000
$C/StepsPerMm=100.000
$X/MaxRate=2500.000
$Y/MaxRate=2500.000
$Z/MaxRate=2500.000
$A/MaxRate=1000.000
$B/MaxRate=1000.000
$C/MaxRate=1000.000
$X/Acceleration=100.000
$Y/Acceleration=100.000
$Z/Acceleration=100.000
$A/Acceleration=200.000
$B/Acceleration=200.000
$C/Acceleration=200.000
$X/Home/Mpos=0.000
$Y/Home/Mpos=0.000
$Z/Home/Mpos=0.000
$A/Home/Mpos=0.000
$B/Home/Mpos=0.000
$C/Home/Mpos=0.000
$X/MaxTravel=1260.000
$Y/MaxTravel=1265.000
$Z/MaxTravel=120.000
$A/MaxTravel=300.000
$B/MaxTravel=300.000
$C/MaxTravel=300.000
$X/Current/Run=1.800
$Y/Current/Run=1.800
$Z/Current/Run=1.800
$A/Current/Run=1.800
$B/Current/Run=0.250
$C/Current/Run=0.250
$X/Current/Hold=1.250
$Y/Current/Hold=1.250
$Z/Current/Hold=1.250
$A/Current/Hold=1.250
$B/Current/Hold=0.125
$C/Current/Hold=0.125
$X/Microsteps=8
$Y/Microsteps=8
$Z/Microsteps=8
$A/Microsteps=16
$B/Microsteps=16
$C/Microsteps=16
$X/StallGuard=16
$Y/StallGuard=16
$Z/StallGuard=16
$A/StallGuard=16
$B/StallGuard=16
$C/StallGuard=16
$Errors/Verbose=Off
ok
>
> $i
[VER:1.3a.20201212:]
[OPT:MPHBSW]
[MSG:Using machine:CNC_xPRO_V5_XYYZ_RS485_NC]
[MSG:Mode=AP:SSDI=CNC_xPRO_V5:IP=192.168.0.1:MAC=98-CD-AC-5C-02-15]
[MSG:No BT]
ok
>

Spark-Concepts, 2021-08-23:
Could you post the full machine settings - command "$S" along with which VFD you are using

ObbiPrime, 2021-08-24:
> $S
$Sta/SSID=CNC_xPRO_V5
$Sta/Password=******
$Sta/IPMode=DHCP
$Sta/IP=0.0.0.0
$Sta/Gateway=0.0.0.0
$Sta/Netmask=0.0.0.0
$AP/SSID=CNC_xPRO_V5
$AP/Password=******
$AP/IP=192.168.0.1
$AP/Channel=1
$System/Hostname=CNC_xPRO_V5
$Http/Enable=ON
$Http/Port=80
$Telnet/Enable=ON
$Telnet/Port=23
$Radio/Mode=AP
$Bluetooth/Name=XPRO_V5_BT
$Notification/Type=NONE
$Notification/T1=
$Notification/T2=
$Notification/TS=
$User/Macro0=
$User/Macro1=
$User/Macro2=
$User/Macro3=
$Homing/Cycle0=XY
$Homing/Cycle1=
$Homing/Cycle2=
$Homing/Cycle3=
$Homing/Cycle4=
$Homing/Cycle5=
$Report/StallGuard=
$Stepper/Pulse=4
$Stepper/IdleTime=255
$Stepper/StepInvert=<Alarm|MPos:0.000,0.000,0.000|FS:0,0|Pn:Z>
$Stepper/DirInvert=
$Stepper/EnableInvert=Off
$Limits/Invert=Off
$Probe/Invert=On
$Report/Status=1
$GCode/JunctionDeviation=0.010
$GCode/ArcTolerance=0.002
$Report/Inches=Off
$Firmware/Build=
$Limits/Soft=Off
$Limits/Hard=Off
$Homing/Enable=On
$Homing/DirInvert=XYZ
$Homing/Squared=
$Homing/Feed=200.000
$Homing/Seek=2000.000
$Homing/Debounce=250.000
$Homing/Pulloff=3.000
$GCode/MaxS=24000.000
$GCode/MinS=0.000
$Laser/FullPower=1000
$GCode/LaserMode=Off
$GCode/Line1=
$GCode/Line0=
$Spindle/Enable/Invert=Off
$Spindle/Enable/OffWithSpeed=Off
$Spindle/Delay/SpinDown=0.000
$Spindle/Delay/SpinUp=0.000
$Spindle/PWM/Invert=Off
$Spindle/PWM/Frequency=5000.000
$Spindle/PWM/Off=0.000
$Spindle/PWM/Min=0.000
$Spindle/PWM/Max=100.000
$Spindle/Type=HUANYANG
$X/StepsPerMm=200.000
$Y/StepsPerMm=200.000
$Z/StepsPerMm=200.000
$A/StepsPerMm=200.000
$B/StepsPerMm=100.000
$C/StepsPerMm=100.000
$X/MaxRate=2500.000
$Y/MaxRate=2500.000
$Z/MaxRate=2500.000
$A/MaxRate=1000.000
$B/MaxRate=1000.000
$C/MaxRate=1000.000
$X/Acceleration=100.000
$Y/Acceleration=100.000
$Z/Acceleration=100.000
$A/Acceleration=200.000
$B/Acceleration=200.000
$C/Acceleration=200.000
$X/Home/Mpos=0.000
$Y/Home/Mpos=0.000
$Z/Home/Mpos=0.000
$A/Home/Mpos=0.000
$B/Home/Mpos=0.000
$C/Home/Mpos=0.000
$X/MaxTravel=1260.000
$Y/MaxTravel=1265.000
$Z/MaxTravel=120.000
$A/MaxTravel=300.000
$B/MaxTravel=300.000
$C/MaxTravel=300.000
$X/Current/Run=1.800
$Y/Current/Run=1.800
$Z/Current/Run=1.800
$A/Current/Run=1.800
$B/Current/Run=0.250
$C/Current/Run=0.250
$X/Current/Hold=1.250
$Y/Current/Hold=1.250
$Z/Current/Hold=1.250
$A/Current/Hold=1.250
$B/Current/Hold=0.125
$C/Current/Hold=0.125
$X/Microsteps=8
$Y/Microsteps=8
$Z/Microsteps=8
$A/Microsteps=16
$B/Microsteps=16
$C/Microsteps=16
$X/StallGuard=16
$Y/StallGuard=16
$Z/StallGuard=16
$A/StallGuard=16
$B/StallGuard=16
$C/StallGuard=16
$Errors/Verbose=Off
ok

I am using the Huanyang VFD from Bulkman3D in the QueenBee Pro kit. I believe the model is "HY02D223B". I'm also using a water cooled 2.2kw spindle.

Spark-Concepts, 2021-08-25:
Ok, so your settings look good and the fact that you can communicate until the spindle is running makes me think this is likely a noise issue.  Is your spindle to vfd cable near the 485 lines?  Also, recommend following the wiring suggestions from here: https://github.com/Spark-Concepts/xPro-V5/issues/30

Closed 2021-09-15.

Thread 46 (2021-08-24):

Motor Y Light Indicator

luisvelez25, 2021-08-24:
Hi
My problem is when I turn on the device the motor it never start, I checked the led indicator and the motor Y is red.
I tried with the motor is disconnected
I checked all connections are ok
I need your help

Thanks

Spark-Concepts, 2021-08-25:
Hi Luisvelez,

If you disconnect the motor from the Y terminal, and press the manual reset button.  Does the fault go away?  Generally the indicator faults show if there is a short, or the driver is overheating.

luisvelez25, 2021-08-25:
Hi,
Please check the video
https://user-images.githubusercontent.com/7698841/130806455-8ad72ad0-0f27-4d71-986c-fbad97438564.mp4
Even with the motor disconnected the problem it still happens.  Is there a way to unlock the motor?

Thanks

Closed 2021-09-14.

Thread 49 (2021-09-04):

Y-stepper driver not working.

StefanEric, 2021-09-04:
I'm new to CNC routers and I was just test driving my first build.
Testing with a pencil and I was just getting the hang of it, I've had a 3d-printer for a few years.
But suddenly during a drawing of a nice looking Goomba the Y-motor started sounding bad and stopped.
The machine crashed because Y2 continued to move for a while.
However after that I can't get the Y-stepper motor to run.
When I let it rest for a while and try to move the Y-axis the motor only sounds bad for a short while and then I get a red led on Y-motor indicator. If I press reset and try again I get a temp warning on Y-motor test (Axis Trinamic driver test).
I don't know if I measured correctly but it looks like it's giving about double the volt and amps compared to the other drivers.
Is there anything I can do?
I tried updating to latest firmware but didn't help.
Some setting I can do?

For now I'm running both Y-motors on Y2, don't know if that's OK?
But my Goomba turned out fine. :)

Hope someone can tell me what to do?

Spark-Concepts, 2021-09-07:
Hi StefanEric,  could you send a list of your $S settings?  Running both motors on Y2 is ok while we get things sorted out.

StefanEric, 2021-09-07:
$0 = 10    (Step pulse time, microseconds)
$1 = 25    (Step idle delay, milliseconds)
$2 = 0    (Step pulse invert, mask)
$3 = 0    (Step direction invert, mask)
$4 = 0    (Invert step enable pin, boolean)
$5 = 0    (Invert limit pins, boolean)
$6 = 0    (Invert probe pin, boolean)
$10 = 3    (Status report options, mask)
$11 = 0.010    (Junction deviation, millimeters)
$12 = 0.002    (Arc tolerance, millimeters)
$13 = 0    (Report in inches, boolean)
$20 = 0    (Soft limits enable, boolean)
$21 = 1    (Hard limits enable, boolean)
$22 = 1    (Homing cycle enable, boolean)
$23 = 3    (Homing direction invert, mask)
$24 = 100.000    (Homing locate feed rate, mm/min)
$25 = 500.000    (Homing search seek rate, mm/min)
$26 = 5.000    (Homing switch debounce delay, milliseconds)
$27 = 5.000    (Homing switch pull-off distance, millimeters)
$30 = 24000.000    (Maximum spindle speed, RPM)
$31 = 0.000    (Minimum spindle speed, RPM)
$32 = 0    (Laser-mode enable, boolean)
$100 = 200.000    (X-axis travel resolution, step/mm)
$101 = 200.000    (Y-axis travel resolution, step/mm)
$102 = 200.000    (Z-axis travel resolution, step/mm)
$103 = 200.000
$104 = 100.000
$105 = 100.000
$110 = 1500.000    (X-axis maximum rate, mm/min)
$111 = 1500.000    (Y-axis maximum rate, mm/min)
$112 = 1000.000    (Z-axis maximum rate, mm/min)
$113 = 1000.000
$114 = 1000.000
$115 = 1000.000
$120 = 20.000    (X-axis acceleration, mm/sec^2)
$121 = 20.000    (Y-axis acceleration, mm/sec^2)
$122 = 20.000    (Z-axis acceleration, mm/sec^2)
$123 = 200.000
$124 = 200.000
$125 = 200.000
$130 = 550.000    (X-axis maximum travel, millimeters)
$131 = 1050.000    (Y-axis maximum travel, millimeters)
$132 = 30.000    (Z-axis maximum travel, millimeters)
$133 = 300.000
$134 = 300.000
$135 = 300.000

Ok! Good to know it also works with Y2 only.
Because everything works fine otherwise.

Den tis 7 sep. 2021 kl 15:32 skrev Spark ***@***.***>:

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

Mawg1, 2021-09-08:
Hi Stefan, thanks for the settings.  Could you send command $S (second one is the letter S not the $ sign).  This will include all the driver specific settings.  Thanks!

StefanEric, 2021-09-08:
Aha! Sorry!
Here they are:
$Sta/SSID=CNC_xPRO_V5
$Sta/Password=******
$Sta/IPMode=DHCP
$Sta/IP=0.0.0.0
$Sta/Gateway=0.0.0.0
$Sta/Netmask=0.0.0.0
$AP/SSID=CNC_xPRO_V5
$AP/Password=******
$AP/IP=192.168.0.1
$AP/Channel=1
$System/Hostname=CNC_xPRO_V5
$Http/Enable=ON
$Http/Port=80
$Telnet/Enable=ON
$Telnet/Port=23
$Radio/Mode=AP
$Bluetooth/Name=xPRO_V5_BT
$Notification/Type=NONE
$Notification/T1=
$Notification/T2=
$Notification/TS=
$Message/Level=Info
$User/Macro0=
$User/Macro1=
$User/Macro2=
$Homing/Cycle0=Z
$Homing/Cycle1=XY
$Homing/Cycle2=
$Homing/Cycle3=
$Homing/Cycle4=
$Homing/Cycle5=
$Report/StallGuard=
$Stepper/Enable/Delay=0
$Stepper/Direction/Delay=0
$Stepper/Pulse=10
$Stepper/IdleTime=25
$Stepper/StepInvert=
$Stepper/DirInvert=
$Stepper/EnableInvert=Off
$Limits/Invert=Off
$Probe/Invert=Off
$Report/Status=3
$GCode/JunctionDeviation=0.010
$GCode/ArcTolerance=0.002
$Report/Inches=Off
$Firmware/Build=
$Limits/Soft=Off
$Limits/Hard=On
$Homing/Enable=On
$Homing/DirInvert=XY
$Homing/Squared=
$Homing/Feed=100.000
$Homing/Seek=500.000
$Homing/Debounce=5.000
$Homing/Pulloff=5.000
$GCode/MaxS=24000.000
$GCode/MinS=0.000
$Laser/FullPower=1000
$GCode/LaserMode=Off
$GCode/Line1=
$GCode/Line0=
$Spindle/Enable/Invert=Off
$Spindle/Enable/OffWithSpeed=Off
$Coolant/Delay/TurnOn=1.000
$Spindle/Delay/SpinDown=0.000
$Spindle/Delay/SpinUp=0.000
$Spindle/PWM/Invert=Off
$Spindle/PWM/Frequency=5000.000
$Spindle/PWM/Off=0.000
$Spindle/PWM/Min=0.000
$Spindle/PWM/Max=100.000
$Spindle/Type=NONE
$X/StepsPerMm=200.000
$Y/StepsPerMm=200.000
$Z/StepsPerMm=200.000
$A/StepsPerMm=200.000
$B/StepsPerMm=100.000
$C/StepsPerMm=100.000
$X/MaxRate=1500.000
$Y/MaxRate=1500.000
$Z/MaxRate=1000.000
$A/MaxRate=1000.000
$B/MaxRate=1000.000
$C/MaxRate=1000.000
$X/Acceleration=20.000
$Y/Acceleration=20.000
$Z/Acceleration=20.000
$A/Acceleration=200.000
$B/Acceleration=200.000
$C/Acceleration=200.000
$X/Home/Mpos=0.000
$Y/Home/Mpos=0.000
$Z/Home/Mpos=0.000
$A/Home/Mpos=0.000
$B/Home/Mpos=0.000
$C/Home/Mpos=0.000
$X/MaxTravel=550.000
$Y/MaxTravel=1050.000
$Z/MaxTravel=30.000
$A/MaxTravel=300.000
$B/MaxTravel=300.000
$C/MaxTravel=300.000
$X/Current/Run=1.800
$Y/Current/Run=1.800
$Z/Current/Run=1.800
$A/Current/Run=1.800
$B/Current/Run=0.250
$C/Current/Run=0.250
$X/Current/Hold=1.250
$Y/Current/Hold=1.250
$Z/Current/Hold=1.250
$A/Current/Hold=1.250
$B/Current/Hold=0.125
$C/Current/Hold=0.125
$X/Microsteps=8
$Y/Microsteps=8
$Z/Microsteps=8
$A/Microsteps=16
$B/Microsteps=16
$C/Microsteps=16
$X/StallGuard=16
$Y/StallGuard=16
$Z/StallGuard=16
$A/StallGuard=16
$B/StallGuard=16
$C/StallGuard=16

seaw14, 2021-09-10:
Yeah I've got two sitting on a self with this same thing. Randomly just dropped off. Nothing had changed in-between. Swapping controller fixed issue and it was on two separate machines.

Closed 2021-09-17.

Thread 51 (2021-09-11):

limit switches error issues

Reid-T, 2021-09-11:
I am new and building a workbee with a Xpro-V5 controller. I have issues with my limit switches.

First, my limits can be hard triggered manually. But sometimes I get an error when I do the manual trigger.
Second, I can jog into the limit to trigger a hard limit. But sometimes I get an error that resets.
Thirdly, homing worked a couple time but now always fails with hard crash.

I have double checked the limit wires and connections. I even made a second set of limit wires. The results are the same.
I am using CNCjs and I have the same issues when I use SourceRabbit.

I am including my settings and the reset error I am getting.
Hopefully someone can spot the problem or explain what I need to look at?

Thanks in advance for any help!

> $$
$0=5 (Step pulse time, microseconds)
$1=255 (Step idle delay, milliseconds)
$2=0 (Step pulse invert, mask)
$3=3 (Step direction invert, mask)
$4=0 (Invert step enable pin, boolean)
$5=1 (Invert limit pins, boolean)
$6=0 (Invert probe pin, boolean)
$10=1 (Status report options, mask)
$11=0.010 (Junction deviation, millimeters)
$12=0.002 (Arc tolerance, millimeters)
$13=0 (Report in inches, boolean)
$20=1 (Soft limits enable, boolean)
$21=1 (Hard limits enable, boolean)
$22=1 (Homing cycle enable, boolean)
$23=7 (Homing direction invert, mask)
$24=50.000 (Homing locate feed rate, mm/min)
$25=300.000 (Homing search seek rate, mm/min)
$26=25.000 (Homing switch debounce delay, milliseconds)
$27=8.000 (Homing switch pull-off distance, millimeters)
$30=12000.000 (Maximum spindle speed, RPM)
$31=100.000 (Minimum spindle speed, RPM)
$32=0 (Laser-mode enable, boolean)
$N1=
$N0=
$100=200.000 (X-axis travel resolution, step/mm)
$101=200.000 (Y-axis travel resolution, step/mm)
$102=200.000 (Z-axis travel resolution, step/mm)
$103=200.000
$104=100.000
$105=100.000
$110=2000.000 (X-axis maximum rate, mm/min)
$111=2000.000 (Y-axis maximum rate, mm/min)
$112=70.000 (Z-axis maximum rate, mm/min)
$113=2000.000
$114=1000.000
$115=1000.000
$120=150.000 (X-axis acceleration, mm/sec^2)
$121=150.000 (Y-axis acceleration, mm/sec^2)
$122=150.000 (Z-axis acceleration, mm/sec^2)
$123=150.000
$124=200.000
$125=200.000
$130=1300.000 (X-axis maximum travel, millimeters)
$131=1820.000 (Y-axis maximum travel, millimeters)
$132=43.000 (Z-axis maximum travel, millimeters)
$133=1270.000
$134=300.000
$135=300.000
ok
>
===== ===== =====
Guru Meditation Error: Core  1 panic'ed (Coprocessor exception)
Core 1 register dump:
PC      : 0x400df471  PS      : 0x00060031  A0      : 0x800df073  A1      : 0x3ffbe800
A2      : 0x3ffd8524  A3      : 0x00000001  A4      : 0x000000ff  A5      : 0x00000000
A6      : 0x00000010  A7      : 0x3ffc91d0  A8      : 0x00000001  A9      : 0x3ffbe8c0
A10     : 0x000000ff  A11     : 0x00000000  A12     : 0x800ef859  A13     : 0x3ffd41f0
A14     : 0x00000036  A15     : 0x00000000  SAR     : 0x0000000b  EXCCAUSE: 0x00000004
EXCVADDR: 0x00000000  LBEG    : 0x400014fd  LEND    : 0x4000150d  LCOUNT  : 0xfffffff0
Core 1 was running in ISR context:
EPC1    : 0x400df471  EPC2    : 0x00000000  EPC3    : 0x00000000  EPC4    : 0x4008866c
Backtrace: 0x400df471:0x3ffbe800 0x400df070:0x3ffbe8f0 0x400d54a0:0x3ffbe920 0x40081f7b:0x3ffbe940 0x40082405:0x3ffbe960 0x40085e35:0x3ffbe980 0x4008fc7b:0x3ffd4190 0x4018940e:0x3ffd41d0 0x401773d4:0x3ffd41f0 0x400ef856:0x3ffd4220 0x400f84d6:0x3ffd4260 0x400eb380:0x3ffd4280 0x400eb048:0x3ffd42a0 0x400daa54:0x3ffd42c0 0x4009030d:0x3ffd42e0
Rebooting...
ets Jun  8 2016 00:22:57
rst:0xc (SW_CPU_RESET),boot:0x13 (SPI_FAST_FLASH_BOOT)
configsip: 0, SPIWP:0xee
clk_drv:0x00,q_drv:0x00,d_drv:0x00,cs0_drv:0x00,hd_drv:0x00,wp_drv:0x00
mode:DIO, clock div:1
load:0x3fff0018,len:4
load:0x3fff001c,len:1216
ho 0 tail 12 room 4
load:0x40078000,len:9720
ho 0 tail 12 room 4
load:0x40080400,len:6352
entry 0x400806b8
[MSG:Grbl_ESP32 Ver 1.3a Date 20201212]
[MSG:Compiled with ESP32 SDK:v3.2.3-14-gd3e562907]
[MSG:Using machine:CNC_xPRO_V5_XYYZ_PWM_NC]
[MSG:Axis count 3]
[MSG:RMT Steps]
Guru Meditation Error: Core  1 panic'ed (LoadProhibited). Exception was unhandled.
Core 1 register dump:
PC      : 0x400d59f0  PS      : 0x00060031  A0      : 0x800820e3  A1      : 0x3ffbe930
A2      : 0x00000000  A3      : 0x00000000  A4      : 0x3ffc5c40  A5      : 0x00000000
A6      : 0x00000000  A7      : 0x00000003  A8      : 0x3ffd6dd0  A9      : 0x0000000c
A10     : 0x00000000  A11     : 0x3ffd6dd0  A12     : 0x80093262  A13     : 0x3ffd30c0
A14     : 0x00000001  A15     : 0x3ffd6dd0  SAR     : 0x00000000  EXCCAUSE: 0x0000001c
EXCVADDR: 0x00000000  LBEG    : 0x400014fd  LEND    : 0x4000150d  LCOUNT  : 0xfffffffb
Core 1 was running in ISR context:
EPC1    : 0x400d59f0  EPC2    : 0x00000000  EPC3    : 0x00000000  EPC4    : 0x4008866c
Backtrace: 0x400d59f0:0x3ffbe930 0x400820e0:0x3ffbe950 0x40085e35:0x3ffbe980 0x4000bfed:0x3ffd3130 0x40091479:0x3ffd3140 0x400ffdf2:0x3ffd3160 0x4018ef7a:0x3ffd31a0 0x40082045:0x3ffd31d0 0x400ded27:0x3ffd3210 0x400d4602:0x3ffd3230 0x400d2d73:0x3ffd3250 0x400fba97:0x3ffd3270 0x4009030d:0x3ffd3290
Rebooting...
ets Jun  8 2016 00:22:57
rst:0xc (SW_CPU_RESET),boot:0x13 (SPI_FAST_FLASH_BOOT)
configsip: 0, SPIWP:0xee
clk_drv:0x00,q_drv:0x00,d_drv:0x00,cs0_drv:0x00,hd_drv:0x00,wp_drv:0x00
mode:DIO, clock div:1
load:0x3fff0018,len:4
load:0x3fff001c,len:1216
ho 0 tail 12 room 4
load:0x40078000,len:9720
ho 0 tail 12 room 4
load:0x40080400,len:6352
entry 0x400806b8
[MSG:Grbl_ESP32 Ver 1.3a Date 20201212]
[MSG:Compiled with ESP32 SDK:v3.2.3-14-gd3e562907]
[MSG:Using machine:CNC_xPRO_V5_XYYZ_PWM_NC]
[MSG:Axis count 3]
[MSG:RMT Steps]
[MSG:Init Motors]
[MSG:TMCStepper Library Ver. 0x000701]
[MSG:X  Axis Trinamic TMC5160 Step:GPIO(12) Dir:GPIO(14) CS:GPIO(17) Disable:None Index:1 R:0.050 Limits(0.000,1300.000)]
[MSG:X  Axis Trinamic driver test passed]
[MSG:Y  Axis Trinamic TMC5160 Step:GPIO(27) Dir:GPIO(26) CS:GPIO(17) Disable:None Index:2 R:0.050 Limits(0.000,1820.000)]
[MSG:Y  Axis Trinamic driver test passed]
[MSG:Y2 Axis Trinamic TMC5160 Step:GPIO(33) Dir:GPIO(32) CS:GPIO(17) Disable:None Index:3 R:0.050 Limits(0.000,1820.000)]
[MSG:Y2 Axis Trinamic driver test passed]
[MSG:Z  Axis Trinamic TMC5160 Step:GPIO(15) Dir:GPIO(2) CS:GPIO(17) Disable:None Index:4 R:0.050 Limits(0.000,43.000)]
[MSG:Z  Axis Trinamic driver test passed]
[MSG:PWM spindle Output:GPIO(25), Enbl:GPIO(4), Dir:None, Freq:5000Hz, Res:13bits]
[MSG:Local access point CNC_xPRO_V5 started, 192.168.0.1]
[MSG:Captive Portal Started]
[MSG:HTTP Started]
[MSG:TELNET Started 23]
[MSG:Mist coolant on pin GPIO(21)]
[MSG:X  Axis limit switch on pin GPIO(35)]
[MSG:Y  Axis limit switch on pin GPIO(34)]
[MSG:Z  Axis limit switch on pin GPIO(39)]
[MSG:Probe on pin GPIO(22)]
Grbl 1.3a ['$' for help]
[MSG:Check limits]
[MSG:'$H'|'$X' to unlock]
>

Thanks in advance for any help!

Spark-Concepts, 2021-09-14:
Hi Reid-T,

What version of the firmware are you using?  Could you send commands "$i", "$s". and "?" and post the response?

Thanks

Reid-T, 2021-09-14:
Here is the output from $i, $s, and ?
> $i
[VER:1.3a.20201212:]
[OPT:MPHBSW]
[MSG:Using machine:CNC_xPRO_V5_XYYZ_PWM_NC]
[MSG:Mode=AP:SSDI=CNC_xPRO_V5:IP=192.168.0.1:MAC=98-CD-AC-6D-66-C1]
[MSG:No BT]
ok
> $s
$Sta/SSID=CNC_xPRO_V5
$Sta/Password=******
$Sta/IPMode=DHCP
$Sta/IP=0.0.0.0
$Sta/Gateway=0.0.0.0
$Sta/Netmask=0.0.0.0
$AP/SSID=CNC_xPRO_V5
$AP/Password=******
$AP/IP=192.168.0.1
$AP/Channel=1
$System/Hostname=CNC_xPRO_V5
$Http/Enable=ON
$Http/Port=80
$Telnet/Enable=ON
$Telnet/Port=23
$Radio/Mode=AP
$Bluetooth/Name=XPRO_V5_BT
$Notification/Type=NONE
$Notification/T1=
$Notification/T2=
$Notification/TS=<Idle|MPos:0.000,0.000,0.000|FS:0,0|Pn:PXYZ>
$User/Macro0=
$User/Macro1=
$User/Macro2=
$User/Macro3=
$Homing/Cycle0=Z
$Homing/Cycle1=XY
$Homing/Cycle2=
$Homing/Cycle3=
$Homing/Cycle4=
$Homing/Cycle5=
$Report/StallGuard=
$Stepper/Pulse=5
$Stepper/IdleTime=255
$Stepper/StepInvert=
$Stepper/DirInvert=Z
$Stepper/EnableInvert=Off
$Limits/Invert=On
$Probe/Invert=Off
$Report/Status=1
$GCode/JunctionDeviation=0.010
$GCode/ArcTolerance=0.002
$Report/Inches=Off
$Firmware/Build=
$Limits/Soft=On
$Limits/Hard=On
$Homing/Enable=On
$Homing/DirInvert=
$Homing/Squared=
$Homing/Feed=50.000
$Homing/Seek=50.000
$Homing/Debounce=25.000
$Homing/Pulloff=10.000
$GCode/MaxS=12000.000
$GCode/MinS=100.000
$Laser/FullPower=1000
$GCode/LaserMode=Off
$GCode/Line1=
$GCode/Line0=
$Spindle/Enable/Invert=Off
$Spindle/Enable/OffWithSpeed=Off
$Spindle/Delay/SpinDown=0.000
$Spindle/Delay/SpinUp=0.000
$Spindle/PWM/Invert=Off
$Spindle/PWM/Frequency=5000.000
$Spindle/PWM/Off=0.000
$Spindle/PWM/Min=0.000
$Spindle/PWM/Max=100.000
$Spindle/Type=PWM
$X/StepsPerMm=200.000
$Y/StepsPerMm=200.000
$Z/StepsPerMm=200.000
$A/StepsPerMm=200.000
$B/StepsPerMm=100.000
$C/StepsPerMm=100.000
$X/MaxRate=2000.000
$Y/MaxRate=2000.000
$Z/MaxRate=2000.000
$A/MaxRate=2000.000
$B/MaxRate=1000.000
$C/MaxRate=1000.000
$X/Acceleration=150.000
$Y/Acceleration=150.000
$Z/Acceleration=150.000
$A/Acceleration=150.000
$B/Acceleration=200.000
$C/Acceleration=200.000
$X/Home/Mpos=0.000
$Y/Home/Mpos=0.000
$Z/Home/Mpos=0.000
$A/Home/Mpos=0.000
$B/Home/Mpos=0.000
$C/Home/Mpos=0.000
$X/MaxTravel=1220.000
$Y/MaxTravel=1210.000
$Z/MaxTravel=30.000
$A/MaxTravel=1270.000
$B/MaxTravel=300.000
$C/MaxTravel=300.000
$X/Current/Run=1.950
$Y/Current/Run=1.950
$Z/Current/Run=1.950
$A/Current/Run=1.950
$B/Current/Run=0.250
$C/Current/Run=0.250
$X/Current/Hold=1.250
$Y/Current/Hold=1.250
$Z/Current/Hold=1.250
$A/Current/Hold=1.250
$B/Current/Hold=0.125
$C/Current/Hold=0.125
$X/Microsteps=8
$Y/Microsteps=8
$Z/Microsteps=8
$A/Microsteps=8
$B/Microsteps=16
$C/Microsteps=16
$X/StallGuard=16
$Y/StallGuard=16
$Z/StallGuard=16
$A/StallGuard=16
$B/StallGuard=16
$C/StallGuard=16
$Errors/Verbose=Off
ok
> ?
<Idle|MPos:0.000,0.000,0.000|FS:0,0|Pn:PXYZ>
ok

Spark-Concepts, 2021-09-14:
OK, so it looks like a few things could be happening here.

1) Let's get you to the latest firmware:  https://github.com/Spark-Concepts/xPro-V5/blob/main/Firmware/CNC_xPRO_V5_XYYZ_NC.bin (upload with following these directions: https://github.com/Spark-Concepts/xPro-V5/wiki/Checking_firmware_and_upgrading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)
*Take note of any specialized settings like steps/mm, direction invert, etc).  Push the default firmware settings using command $RST=*, then reapply specialized settings.  Reboot

2) It looks like your limit switches are NC.  You will need to set $Limits/Invert=0;

Reid-T, 2021-09-14:
I have download the firmware and I have connected to the Xpro-V5. When I attempt the update, I get a file write error. This is shown in the video I have attached.

https://user-images.githubusercontent.com/21341854/133323877-09132d1f-7e2b-4bc9-8a52-69cae617917f.mp4

Spark-Concepts, 2021-09-16:
Ok, we will need to revert to the original firmware over USB, and then push the upload of the newest firmware.

Attached are instructions for uploading the firmware over USB.  Unzip the programming folder, then unzip the .bin file.

Once reconnecting to the wifi, you will need to upload the index.html.gz (WebUI) again - also attached.

Alternatively, we can get this back to the shop and the techs will take care of it.  If you want to go this route, please submit a [contact us form](https://www.spark-concepts.com/contact-us-1/) with your name, order number, and address.

[Programming USB No Arduino.zip](https://github.com/Spark-Concepts/xPro-V5/files/7177513/Programming.USB.No.Arduino.zip)

[index.html.gz](https://github.com/Spark-Concepts/xPro-V5/files/7177508/index.html.gz)

Reid-T, 2021-09-16:
I'm following your instructions and in the pdf file named "Programming ESP32 chip.pdf" step 1. instructs to download this file:
https://www.espressif.com/sites/default/files/tools/flash_download_tool_v3.8.5.zip
but the hyperlink results in a browser 404 error file not found.

Can you help me locate the file I need to download?
Thank you.

Spark-Concepts, 2021-09-16:
https://www.espressif.com/en/support/download/other-tools
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

Reid-T, 2021-09-16:
Sorry, but the instructions say to use xPV5xyyz.bin file. That is not included in the download.
Can you help me locate that file?
Thank you

Spark-Concepts, 2021-09-16:
The xPV5xyyz.bin is wrapped in the xPV5xyyz.zip folder.  You will need to extract the folder to get to the .bin.

xPV5xyyz.zip included below as well.  (sorry, most systems dont play well with .bin files so we have to wrap them)

Note: this bin will only work with the USB flash tool.  Using it with the Over The Air update will cause issues.

[xPV5xyyz.zip](https://github.com/Spark-Concepts/xPro-V5/files/7179472/xPV5xyyz.zip)

Reid-T, 2021-09-16:
ok, I have flashed the xPro now.
Next step is : reconnecting to the wifi, you will need to upload the index.html.gz (WebUI) again - also attached.
When I try the  upload I get a file write error
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

Spark-Concepts, 2021-09-16:
Rather stubborn unit...

Connect to AP, navigate to: http://192.168.0.1/?forcefallback=yes

Hit the trash can button next to the index.html.gz

Hit Choose Files, select new index.html.gz file, hit upload.

Once uploaded, press manual reset on the controller.  Reconnect to AP.

Reid-T, 2021-09-17:
Thank you so very much for your help. My switches operate as expected and my homing works without crashing. Once Again Thank You.
- Reid

Spark-Concepts, 2021-09-17:
Great!

Closed 2021-09-17.

Thread 53 (2021-09-13):

Steppers don't work

Massoels, 2021-09-13:
Hi,

I can't get any of the stepper working. I'm using NEMA23 steppers and candle for control via usb. What could be wrong?
In candle, I get no errors and I can control the spindle.

Thanks,
Maarten

Spark-Concepts, 2021-09-14:
Hi Maarten,

A couple things to check.

1) Confirm you are sending 24V to the controller, wired for correctly polarity, and that the switch on the xPRO is in on position (...i know sorry, but it is obligatory to make sure we have power).
2) Confirm that you have the motors wired correctly.  *with the motor unplugged from the controller, remove the first two wires from the connector and press the stripped ends together (short them).  While shorted, try to turn the motor shaft, if it turns the coils are not wires correctly.  If it locks, the coils are correct*
3)  press the manual reset on the side of the controller to re-initialize the motor drivers
4) check for any red fault indicators on the side of the controller

Massoels, 2021-09-14:
Hi,

Thanks for the quick feedback.

The reset button seems to work, but when I press it, the motors start making a nioise (like they are turning), but there is no movement. When I move X,Y or Z in candle, they rotate, but they keep making a noise.
I also have to reset every time I start the controller.

Does this sound familiar to you, or is this a know issue (or fault from my side)?

The only red light on the controller is the one next to the STOP/DOOR, but I assume that's normal when there is no emergency button connected.

Thanks,
Maarten

Van: "Spark" ***@***.***>
Aan: "Spark-Concepts/xPro-V5" ***@***.***>
Cc: "maarten" ***@***.***>, "Author" ***@***.***>
Verzonden: Dinsdag 14 september 2021 03:39:01
Onderwerp: Re: [Spark-Concepts/xPro-V5] Steppers don't work (#53)

Hi Maarten,

A couple things to check.

    1. Confirm you are sending 24V to the controller, wired for correctly polarity, and that the switch on the xPRO is in on position (...i know sorry, but it is obligatory to make sure we have power).
    2. Confirm that you have the motors wired correctly. with the motor unplugged from the controller, remove the first two wires from the connector and press the stripped ends together (short them). While shorted, try to turn the motor shaft, if it turns the coils are not wires correctly. If it locks, the coils are correct
    3. press the manual reset on the side of the controller to re-initialize the motor drivers
    4. check for any red fault indicators on the side of the controller

—
You are receiving this because you authored the thread.
Reply to this email directly, [ https://github.com/Spark-Concepts/xPro-V5/issues/53#issuecomment-918722095 | view it on GitHub ] , or [ https://github.com/notifications/unsubscribe-auth/AVTTAG75B42USMGVKTAVDJTUB2RTLANCNFSM5D6QI2QQ | unsubscribe ] .
Triage notifications on the go with GitHub Mobile for [ https://apps.apple.com/app/apple-store/id1477376905?ct=notification-email&mt=8&pt=524675 | iOS ] or [ https://play.google.com/store/apps/details?id=com.github.android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 | Android ] .

Spark-Concepts, 2021-09-14:
There will be an audible noise from the chopping frequency when the motors are powered.  You can set $1=250 to remove power when they are idle.

In Candle, you will need to make sure you have hardware flow control turned on, or look for an option to reset the controller on port connection.  If Candle does not have this option, you will need to manual press the reset button once you connect to the port. (sorry, not familiar enough with Candle to point you to a specific setting)

Massoels, 2021-09-15:
Hi,

Thanks. I'm almost there. I changed $1 to 250 (was 255) and I could make the steppers spin. Although the sound is very odd. They make a sound before they start and after they stop.
I have a small cnc milling machine and those steppers sound 'normal'.

The other strange thing is that when I activate one axis, the other steppers make the same noise... (and don't spin of course)

I included a small video, so you can hear it.

Thanks in advance for your valuabale input.
Maarten

Van: "Spark" ***@***.***>
Aan: "Spark-Concepts" ***@***.***>
Cc: "maarten" ***@***.***>, "Author" ***@***.***>
Verzonden: Dinsdag 14 september 2021 20:58:22
Onderwerp: Re: [Spark-Concepts/xPro-V5] Steppers don't work (#53)

There will be an audible noise from the chopping frequency when the motors are powered. You can set $1=250 to remove power when they are idle.

In Candle, you will need to make sure you have hardware flow control turned on, or look for an option to reset the controller on port connection. If Candle does not have this option, you will need to manual press the reset button once you connect to the port. (sorry, not familiar enough with Candle to point you to a specific setting)

—
You are receiving this because you authored the thread.
Reply to this email directly, [ https://github.com/Spark-Concepts/xPro-V5/issues/53#issuecomment-919430770 | view it on GitHub ] , or [ https://github.com/notifications/unsubscribe-auth/AVTTAG2ATNX6SBHG5GAZS33UB6LM5ANCNFSM5D6QI2QQ | unsubscribe ] .
Triage notifications on the go with GitHub Mobile for [ https://apps.apple.com/app/apple-store/id1477376905?ct=notification-email&mt=8&pt=524675 | iOS ] or [ https://play.google.com/store/apps/details?id=com.github.android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 | Android ] .

Closed 2021-09-15.

Thread 54 (2021-09-14):

RS485 to Huanyang spindle not working

cdo1955, 2021-09-14:
I also can't get the spindle to responded to the RS485 signals. Pressing M3 or spindle buttons only gets me "0x9e."
I have read all the others with the same issue and have reset the switch, verified all my setting's in the VFD even reloaded the Firmware, but I still have the same issue.
Seems like a lot of folks have this issue, is it a glitch in the system?
Please give me any help you can in figuring this out
 The VFD values are below followed by the GRBl read out.

PD000=0
PD001=2
PD163=1
PD164=1
PD165=3
PD003=400
PD004=400
PD005=400
PD011=100
PD014=5
PD015=3
PD023=0
PD141=110
PD142=8.5
PD143=4
PD-144=3000

* Connected to COM3 @ 115200 baud ****
[MSG:Grbl_ESP32 Ver 1.3a Date 20201212]
[MSG:Compiled with ESP32 SDK:v3.2.3-14-gd3e562907]
[MSG:Using machine:CNC_xPRO_V5_XYYZ_RS485_NC]
[MSG:Axis count 3]
[MSG:RMT Steps]
[MSG:Init Motors]
[MSG:TMCStepper Library Ver. 0x000701]
[MSG:X  Axis Trinamic TMC5160 Step:GPIO(12) Dir:GPIO(14) CS:GPIO(17) Disable:None Index:1 R:0.050 Limits(0.000,1250.000)]
[MSG:X  Axis Trinamic driver test passed]
[MSG:Y  Axis Trinamic TMC5160 Step:GPIO(27) Dir:GPIO(26) CS:GPIO(17) Disable:None Index:2 R:0.050 Limits(0.000,1250.000)]
[MSG:Y  Axis Trinamic driver test passed]
[MSG:Y2 Axis Trinamic TMC5160 Step:GPIO(33) Dir:GPIO(32) CS:GPIO(17) Disable:None Index:3 R:0.050 Limits(0.000,1250.000)]
[MSG:Y2 Axis Trinamic driver test passed]
[MSG:Z  Axis Trinamic TMC5160 Step:GPIO(15) Dir:GPIO(2) CS:GPIO(17) Disable:None Index:4 R:0.050 Limits(-120.000,0.000)]
[MSG:Z  Axis Trinamic driver test passed]
[MSG:Initializing RS485 VFD spindle]
[MSG:Undefined VFD_RS485_RTS_PIN]
[MSG:VFD RS485  Tx:GPIO(4) Rx:GPIO(25) RTS:GPIO(0)]
[MSG:Local access point CNC_xPRO_V5 started, 192.168.0.1]
[MSG:Captive Portal Started]
[MSG:HTTP Started]
[MSG:TELNET Started 23]
[MSG:Flood coolant on pin GPIO(21)]
[MSG:Mist coolant on pin GPIO(21)]
[MSG:X  Axis limit switch on pin GPIO(35)]
[MSG:Y  Axis limit switch on pin GPIO(34)]
[MSG:Z  Axis limit switch on pin GPIO(39)]
[MSG:Probe on pin GPIO(22)]
Grbl 1.3a ['$' for help]
>>> $$
$0 = 4    (Step pulse time, microseconds)
$1 = 255    (Step idle delay, milliseconds)
$2 = 0    (Step pulse invert, mask)
$3 = 3    (Step direction invert, mask)
$4 = 0    (Invert step enable pin, boolean)
$5 = 1    (Invert limit pins, boolean)
$6 = 1    (Invert probe pin, boolean)
$10 = 1    (Status report options, mask)
$11 = 0.010    (Junction deviation, millimeters)
$12 = 0.002    (Arc tolerance, millimeters)
$13 = 0    (Report in inches, boolean)
$20 = 1    (Soft limits enable, boolean)
$21 = 1    (Hard limits enable, boolean)
$22 = 1    (Homing cycle enable, boolean)
$23 = 3    (Homing direction invert, mask)
$24 = 25.000    (Homing locate feed rate, mm/min)
$25 = 1000.000    (Homing search seek rate, mm/min)
$26 = 250.000    (Homing switch debounce delay, milliseconds)
$27 = 4.000    (Homing switch pull-off distance, millimeters)
$30 = 12000.000    (Maximum spindle speed, RPM)
$31 = 0.000    (Minimum spindle speed, RPM)
$32 = 0    (Laser-mode enable, boolean)
$N1=
$N0=
$100 = 200.000    (X-axis travel resolution, step/mm)
$101 = 200.000    (Y-axis travel resolution, step/mm)
$102 = 200.000    (Z-axis travel resolution, step/mm)
$103 = 200.000
$104 = 100.000
$105 = 100.000
$110 = 2500.000    (X-axis maximum rate, mm/min)
$111 = 2500.000    (Y-axis maximum rate, mm/min)
$112 = 2500.000    (Z-axis maximum rate, mm/min)
$113 = 1000.000
$114 = 1000.000
$115 = 1000.000
$120 = 100.000    (X-axis acceleration, mm/sec^2)
$121 = 100.000    (Y-axis acceleration, mm/sec^2)
$122 = 100.000    (Z-axis acceleration, mm/sec^2)
$123 = 200.000
$124 = 200.000
$125 = 200.000
$130 = 1250.000    (X-axis maximum travel, millimeters)
$131 = 1250.000    (Y-axis maximum travel, millimeters)
$132 = 120.000    (Z-axis maximum travel, millimeters)
$133 = 300.000
$134 = 300.000
$135 = 300.000
ok
>>> $G
[GC:G0 G54 G17 G21 G90 G94 M5 M9 T0 F0 S0]
ok
>>> $H
>>> $J=G21G91Y10F2000
>>> $J=G21G91Y10F2000
>>> $J=G21G91Y10F2000
ok
ok
ok
ok
>>> $J=G21G91X10Y10F2000
ok
>>> $J=G21G91X10Y10F2000
ok
>>> 0xa1
>>> 0x9e
>>> 0x9e

Spark-Concepts, 2021-09-14:
what software are you using to interface with the controller?  Could you send the full list of your settings ($S)?

I would recommend updating to the latest firmware: https://github.com/Spark-Concepts/xPro-V5/blob/main/Firmware/CNC_xPRO_V5_XYYZ_NC.bin

You will need to define $Spindle/Type = "whatever your VFD is" (HuanYang, H2A, YL620)

The VFDs are a special pain as most are poorly documented in terms of changes and register settings.  The 0-10V control is pretty simple but for the 485 to work the VFD settings need to be correct, the command set correct, and any induced noise limited/removed.

cdo1955, 2021-09-14:
Thanks for the reply.
The soft ware is  CNC_xPRO-V5_XYYZ_RS485_NO.
I have defined the spindle both ways first as $Spindle/Type =HUANGYANG then as $Spindle/Type =H2A.
The spindle settings and grbl are:

The VFD values are below followed by the GRBl read out.

PD000=0
PD001=2
PD163=1
PD164=1
PD165=3
PD003=400
PD004=400
PD005=400
PD011=100
PD014=5
PD015=3
PD023=0
PD141=110
PD142=8.5
PD143=4
PD-144=3000
Connected to COM3 @ 115200 baud ****
[MSG:Grbl_ESP32 Ver 1.3a Date 20201212]
[MSG:Compiled with ESP32 SDK:v3.2.3-14-gd3e562907]
[MSG:Using machine:CNC_xPRO_V5_XYYZ_RS485_NC]
[MSG:Axis count 3]
[MSG:RMT Steps]
[MSG:Init Motors]
[MSG:TMCStepper Library Ver. 0x000701]
[MSG:X Axis Trinamic TMC5160 Step:GPIO(12) Dir:GPIO(14) CS:GPIO(17) Disable:None Index:1 R:0.050 Limits(0.000,1250.000)]
[MSG:X Axis Trinamic driver test passed]
[MSG:Y Axis Trinamic TMC5160 Step:GPIO(27) Dir:GPIO(26) CS:GPIO(17) Disable:None Index:2 R:0.050 Limits(0.000,1250.000)]
[MSG:Y Axis Trinamic driver test passed]
[MSG:Y2 Axis Trinamic TMC5160 Step:GPIO(33) Dir:GPIO(32) CS:GPIO(17) Disable:None Index:3 R:0.050 Limits(0.000,1250.000)]
[MSG:Y2 Axis Trinamic driver test passed]
[MSG:Z Axis Trinamic TMC5160 Step:GPIO(15) Dir:GPIO(2) CS:GPIO(17) Disable:None Index:4 R:0.050 Limits(-120.000,0.000)]
[MSG:Z Axis Trinamic driver test passed]
[MSG:Initializing RS485 VFD spindle]
[MSG:Undefined VFD_RS485_RTS_PIN]
[MSG:VFD RS485 Tx:GPIO(4) Rx:GPIO(25) RTS:GPIO(0)]
[MSG:Local access point CNC_xPRO_V5 started, 192.168.0.1]
[MSG:Captive Portal Started]
[MSG:HTTP Started]
[MSG:TELNET Started 23]
[MSG:Flood coolant on pin GPIO(21)]
[MSG:Mist coolant on pin GPIO(21)]
[MSG:X Axis limit switch on pin GPIO(35)]
[MSG:Y Axis limit switch on pin GPIO(34)]
[MSG:Z Axis limit switch on pin GPIO(39)]
[MSG:Probe on pin GPIO(22)]
Grbl 1.3a ['$' for help]

$$
$0 = 4 (Step pulse time, microseconds)
$1 = 255 (Step idle delay, milliseconds)
$2 = 0 (Step pulse invert, mask)
$3 = 3 (Step direction invert, mask)
$4 = 0 (Invert step enable pin, boolean)
$5 = 1 (Invert limit pins, boolean)
$6 = 1 (Invert probe pin, boolean)
$10 = 1 (Status report options, mask)
$11 = 0.010 (Junction deviation, millimeters)
$12 = 0.002 (Arc tolerance, millimeters)
$13 = 0 (Report in inches, boolean)
$20 = 1 (Soft limits enable, boolean)
$21 = 1 (Hard limits enable, boolean)
$22 = 1 (Homing cycle enable, boolean)
$23 = 3 (Homing direction invert, mask)
$24 = 25.000 (Homing locate feed rate, mm/min)
$25 = 1000.000 (Homing search seek rate, mm/min)
$26 = 250.000 (Homing switch debounce delay, milliseconds)
$27 = 4.000 (Homing switch pull-off distance, millimeters)
$30 = 12000.000 (Maximum spindle speed, RPM)
$31 = 0.000 (Minimum spindle speed, RPM)
$32 = 0 (Laser-mode enable, boolean)
$N1=
$N0=
$100 = 200.000 (X-axis travel resolution, step/mm)
$101 = 200.000 (Y-axis travel resolution, step/mm)
$102 = 200.000 (Z-axis travel resolution, step/mm)
$103 = 200.000
$104 = 100.000
$105 = 100.000
$110 = 2500.000 (X-axis maximum rate, mm/min)
$111 = 2500.000 (Y-axis maximum rate, mm/min)
$112 = 2500.000 (Z-axis maximum rate, mm/min)
$113 = 1000.000
$114 = 1000.000
$115 = 1000.000
$120 = 100.000 (X-axis acceleration, mm/sec^2)
$121 = 100.000 (Y-axis acceleration, mm/sec^2)
$122 = 100.000 (Z-axis acceleration, mm/sec^2)
$123 = 200.000
$124 = 200.000
$125 = 200.000
$130 = 1250.000 (X-axis maximum travel, millimeters)
$131 = 1250.000 (Y-axis maximum travel, millimeters)
$132 = 120.000 (Z-axis maximum travel, millimeters)
$133 = 300.000
$134 = 300.000
$135 = 300.000
ok
$G
[GC:G0 G54 G17 G21 G90 G94 M5 M9 T0 F0 S0]
ok
$H
$J=G21G91Y10F2000
$J=G21G91Y10F2000
$J=G21G91Y10F2000
ok
ok
ok
ok
$J=G21G91X10Y10F2000
ok
$J=G21G91X10Y10F2000
ok
0xa1
0x9e
0x9e

Sent from Mail<https://go.microsoft.com/fwlink/?LinkId=550986> for Windo

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

Spark-Concepts, 2021-09-14:
This CNC_xPRO-V5_XYYZ_RS485_NO is older firmware, the one linked is the new firmware.  We also need to see the full xPRO settings using $S (note the second character is the letter S not a second $).  Also need to know what software you are using to interface with the controller (CNCjs, UGS, WebUI, etc).

cdo1955, 2021-09-14:
Ok gime me 1o minutes to get it booted up

Sent from Mail<https://go.microsoft.com/fwlink/?LinkId=550986> for Windows

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

cdo1955, 2021-09-14:
Here are the $S settings
>>> $s
$Sta/SSID=CNC_xPRO_V5
$Sta/Password=******
$Sta/IPMode=DHCP
$Sta/IP=0.0.0.0
$Sta/Gateway=0.0.0.0
$Sta/Netmask=0.0.0.0
$AP/SSID=CNC_xPRO_V5
$AP/Password=******
$AP/IP=192.168.0.1
$AP/Channel=1
$System/Hostname=CNC_xPRO_V5
$Http/Enable=ON
$Http/Port=80
$Telnet/Enable=ON
$Telnet/Port=23
$Radio/Mode=AP
$Bluetooth/Name=XPRO_V5_BT
$Notification/Type=NONE
$Notification/T1=
$Notification/T2=
$Notification/TS=
$User/Macro0=
$User/Macro1=
$User/Macro2=
$User/Macro3=
$Homing/Cycle0=Z
$Homing/Cycle1=XY
$Homing/Cycle2=
$Homing/Cycle3=
$Homing/Cycle4=
$Homing/Cycle5=
$Report/StallGuard=
$Stepper/Pulse=4
$Stepper/IdleTime=255
$Stepper/StepInvert=
$Stepper/DirInvert=XY
$Stepper/EnableInvert=Off
$Limits/Invert=On
$Probe/Invert=On
$Report/Status=1
$GCode/JunctionDeviation=0.010
$GCode/ArcTolerance=0.002
$Report/Inches=Off
$Firmware/Build=
$Limits/Soft=On
$Limits/Hard=On
$Homing/Enable=On
$Homing/DirInvert=XY
$Homing/Squared=
$Homing/Feed=25.000
$Homing/Seek=1000.000
$Homing/Debounce=250.000
$Homing/Pulloff=4.000
$GCode/MaxS=12000.000
$GCode/MinS=0.000
$Laser/FullPower=1000
$GCode/LaserMode=Off
$GCode/Line1=
$GCode/Line0=
$Spindle/Enable/Invert=Off
$Spindle/Enable/OffWithSpeed=Off
$Spindle/Delay/SpinDown=0.000
$Spindle/Delay/SpinUp=0.000
$Spindle/PWM/Invert=Off
$Spindle/PWM/Off=0.000
$Spindle/PWM/Min=0.000
$Spindle/PWM/Max=100.000
$Spindle/Type=HUANYANG
$X/StepsPerMm=200.000
$Y/StepsPerMm=200.000
$Z/StepsPerMm=200.000
$A/StepsPerMm=200.000
$B/StepsPerMm=100.000
$C/StepsPerMm=100.000
$X/MaxRate=2500.000
$Y/MaxRate=2500.000
$Z/MaxRate=2500.000
$A/MaxRate=1000.000
$B/MaxRate=1000.000
$C/MaxRate=1000.000
$X/Acceleration=100.000
$Y/Acceleration=100.000
$Z/Acceleration=100.000
$A/Acceleration=200.000
$B/Acceleration=200.000
$C/Acceleration=200.000
$X/Home/Mpos=0.000
$Y/Home/Mpos=0.000
$Z/Home/Mpos=0.000
$A/Home/Mpos=0.000
$B/Home/Mpos=0.000
$C/Home/Mpos=0.000
$X/MaxTravel=1250.000
$Y/MaxTravel=1250.000
$Z/MaxTravel=120.000
$A/MaxTravel=300.000
$B/MaxTravel=300.000
$C/MaxTravel=300.000
$X/Current/Run=1.800
$Y/Current/Run=1.800
$Z/Current/Run=1.800
$A/Current/Run=1.800
$B/Current/Run=0.250
$C/Current/Run=0.250
$X/Current/Hold=1.250
$Y/Current/Hold=1.250
$Z/Current/Hold=1.250
$A/Current/Hold=1.250
$B/Current/Hold=0.125
$C/Current/Hold=0.125
$X/Microsteps=8
$Y/Microsteps=8
$Z/Microsteps=8
$A/Microsteps=16
$B/Microsteps=16
$C/Microsteps=16
$X/StallGuard=16
$Y/StallGuard=16
$Z/StallGuard=16
$A/StallGuard=16
$B/StallGuard=16
$C/StallGuard=16
[Error] An error was detected while sending '$s': $Errors/Verbose=Off. Streaming has been paused.
[Error] Error while processing response <An error was detected while sending '$s': $Errors/Verbose=Off. Streaming has been paused.>
[Error] Error while processing response <ok>: An unexpected command was completed by the controller.

Sent from Mail<https://go.microsoft.com/fwlink/?LinkId=550986> for Windows

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

Spark-Concepts, 2021-09-14:
what program are you using to communicate with the controller?

cdo1955, 2021-09-14:
I am using UGS

Sent from Mail<https://go.microsoft.com/fwlink/?LinkId=550986> for Windows

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

cdo1955, 2021-09-14:
UGS

Sent from Mail<https://go.microsoft.com/fwlink/?LinkId=550986> for Windows

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

Spark-Concepts, 2021-09-14:
Try using CNCjs Desktop - https://cnc.js.org/docs/desktop-app/

cdo1955, 2021-09-14:
Do you want me to upgrade to the new firm ware now?

Sent from Mail<https://go.microsoft.com/fwlink/?LinkId=550986> for Windows

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

Thread 55 (2021-09-19):

Motor indicator light stays on.

IdahoCreator, 2021-09-19:
I noticed lately that the motor issue indicator lights are on even after cold start after disconnected over night. I also have issues with cutting files stop cutting in the middle of the project for no known issue. Even after cutting one completely and without issue. I even modified file and deleted prior cut order and still had problem in the same location. CNC works when I move stuff manually. controller is out in the open and runs on a 300 watt 24 volt power supply. Nema 23 steppers amperage set to 1.5 amps.

Spark-Concepts, 2021-09-20:
Hi IdahoCreator,

Could you plug in USB and pull the startup message using CNCjs or similar?

Start message will look like [this](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).  We want to see the motor self test results.

If you unplug the motors from the xpro, then press the manual reset button, do the fault indicators stay active?

Thanks

IdahoCreator, 2021-09-22:
CNCjs didnt give anything but yat did. Yat info listed below. Red lights are always on on all 4 motor locations I am running a 1x 2 y 1 z configuration. I did try new firmware but had to go back to original as the system would always lockup no matter which version of software I used. I had one great cut then the second one failed a little over half way through cut. Wifi constatnly drops from network so I have to use it in AP all the time.

From YAT
:0x13 (SPI_FAST_FLASH_BOOT)
configsip: 0, SPIWP:0xee
clk_drv:0x00,q_drv:0x00,d_drv:0x00,cs0_drv:0x00,hd_drv:0x00,wp_drv:0x00
mode:DIO, clock div:1
load:0x3fff0018,len:4
load:0x3fff001c,len:1216
ho 0 tail 12 room 4
load:0x40078000,len:9720
ho 0 tail 12 room 4
load:0x40080400,len:6352
entry 0x400806b8

[MSG:Grbl_ESP32 Ver 1.3a Date 20200929]
[MSG:Compiled with ESP32 SDK:v3.2.3-14-gd3e562907]
[MSG:Using machine:CNC_xPRO_V5_XYYZ]
[MSG:Axis count 3]
[MSG:RMT Steps]
[MSG:Init Motors]
[MSG:X  Axis Trinamic TMC5160 Step:GPIO(12) Dir:GPIO(14) CS:GPIO(17) Disable:None Index:1 Limits(0.000,0.000)]
[MSG:Y  Axis Trinamic TMC5160 Step:GPIO(27) Dir:GPIO(26) CS:GPIO(17) Disable:None Index:2 Limits(0.000,0.000)]
[MSG:Y2 Axis Trinamic TMC5160 Step:GPIO(33) Dir:GPIO(32) CS:GPIO(17) Disable:None Index:3 Limits(0.000,0.000)]
[MSG:Z  Axis Trinamic TMC5160 Step:GPIO(15) Dir:GPIO(2) CS:GPIO(17) Disable:None Index:4 Limits(0.000,0.000)]
[MSG:X  Trinamic driver test passed]
[MSG:Y  Trinamic driver test passed]
[MSG:Y2 Trinamic driver test passed]
[MSG:Z  Trinamic driver test passed]
[MSG:TMCStepper Library Ver. 0x000701]
[MSG:PWM spindle Output:GPIO(25), Enbl:GPIO(4), Dir:None, Freq:5000Hz, Res:13bits]
<LF>[MSG:Client Started]
[MSG:Connecting notyours]
[MSG:Connecting.]
[MSG:Connecting..]
[MSG:Connecting...]
[MSG:Connected with 192.168.1.89]
[MSG:Start mDNS with hostname:http://CNC_xPRO_V5.local/]
[MSG:SSDP Started]
[MSG:HTTP Started]
[MSG:TELNET Started 23]
[MSG:X  Axis limit switch on pin GPIO(35)]
[MSG:Y  Axis limit switch on pin GPIO(34)]
[MSG:Z  Axis limit switch on pin GPIO(39)]

Grbl 1.3a ['$' for help]

Spark-Concepts, 2021-09-22:
Thanks!

That's very strange behavior.  Would you be interested in doing an exchange so we can troubleshoot here?  If so, just send me shipping info here: https://www.spark-concepts.com/contact-us-1/

How far away is your controller from your home wifi - might need to move it closer or use a wifi extending to boost the signal (or run in AP mode).

Closed 2021-09-24.

Thread 59 (2021-09-23):

Connect Tools with IoT Relay not working

Reid-T, 2021-09-23:
question regarding my iot relay on xPro-V5:
Prior to the help you gave me on #51 https://github.com/Spark-Concepts/xPro-V5/issues/51 my iot relay was working fine. Now it is not.
I have the xPro-V5 flashed with CNC_xPRO_V5_XYYZ_NC.bin
M3 commands don't turn on the router (or anything plugged into the iot's normally off plugs)
I have attached images which show the wiring connection.
What do I have wrong?
Thanks
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

Spark-Concepts, 2021-09-23:
Have you defined the spindle type?

Looks like you will want to send command $Spindle/type = pwm

Reid-T, 2021-09-23:
Yes spindle type is pwm. I hear the controller when M3 is issued - but nothing is happening.
Here's my setup file

$Homing/Cycle0=Z
$Homing/Cycle1=XY
$Spindle/type = pwm
$0=4
$1=250
$2=0
$3=4
$4=0
$5=1
$6=0
$10=1
$11=0.010
$12=0.002
$13=0
$20=1
$21=1
$22=1
$23=7
$24=50.000
$25=600.000
$26=25.000
$27=8.000
$30=24000.000
$31=0.000
$32=0
$100=200.000
$101=200.000
$102=200.000
$103=200.000
$104=100.000
$105=100.000
$110=2000.000
$111=2000.000
$112=500.000
$113=1000.000
$114=1000.000
$115=1000.000
$120=50.000
$121=50.000
$122=50.000
$123=200.000
$124=200.000
$125=200.000
$130=1240.000
$131=1200.000
$132=28.000
$133=300.000
$134=300.000
$135=300.000

Reid-T, 2021-09-23:
I changed the wiring to pin EN and changed $Spindle/Type = RELAY
works now

Closed 2021-09-24.

Thread 60 (2021-09-23):

How To: Controlling HY VFD with RS485

Spark-Concepts, 2021-09-23:
We are starting to see a lot of questions on using RS485 for the HY VFDs.  Here is a quick guide on how to set those up, please pay special attention to the notes on placement and wire routing.  The VFD's AC and Spindle cables will induce a lot of noise on the RS485 lines if not separated.

 _Note: work in progress, feedback always welcomed :)_

[CNC xPRO V5 RS485 control for HuanYang VFD Spindle.pdf](https://github.com/Spark-Concepts/xPro-V5/files/7220315/CNC.xPRO.V5.RS485.control.for.HuanYang.VFD.Spindle.pdf)

MichaelMartinez, 2021-11-30:
Feedback:

1. I had to extend my rs485 cables to isolate/move my VFD as the noise was interfering with both the xPro and the dedicated computer I have running the xPro.
2. 8000 rpm is what I have my lower limit set to with PD011 set at 133.33 - The torque curve drops off markedly at lower frequencies and I have read in the manual this can cause premature wear and/or damage. So maybe use that for North American versions that run on 110v.
3. PD141 should probably be set to 110 for people in North America. My motor clearly states 110v 2.2kw on the side of the spindle which is funny because I couldn't get 2.2kw on a standard 110v 15amp circuit if I begged, borrowed or stole. Max is 1650watts... with a 20amp circuit, sure 2.2kw is possible, but there is zero head room for demand spikes. Play it safe.

General feedback, I don't think a lot of people know what they are actually setting up here. I have done a lot of reading and experimenting to get to this point. If you set PD142 to 10 or 12, for example, you should state the VFD should be the only thing plugged into that circuit. A standard 110v-15amp circuit should have 15 to 20% head room for appliances that use it.

Thread 62 (2021-09-26):

Questions on Stepper Motor Wiring - Different Schematics Shown

mschreib-il, 2021-09-26:
- there are 2 different wiring configurations shown in the Spark-Concepts documentation for the xPro V5 controller: https://github.com/Spark-Concepts/xPro-V5/wiki/Basic-hookup#connect-motors shows the wiring configuration for Y-Axis and Y2-Axis to be reversed while https://github.com/Spark-Concepts/xPro-V5/wiki/Rear_Panel#motor-connectors shows consistent wiring connections across all 4 stepper motors. Which is correct?  Incidentally, I'm not seeing any reason why Y-Axis and Y2-Axis should be reversed since the 2 axes should have identical operation.

- additionally, https://github.com/Spark-Concepts/xPro-V5/wiki/Basic-hookup#connect-motors  asks the user to identify separate wire coils from the stepper motors, but does not explain why this is necessary. I'm assuming that 1 coil is wired to "A" ports and the 2nd coil is wired to "B" ports: is this correct? If so, perhaps the documentation can be clarified? Thanks

Spark-Concepts, 2021-09-27:
Hi mschreib-il.

1) the different wiring is for reversing one of the Y motors as you noted.  This is for use on machines like the Workbee (belt) shapeokos etc.

2) Correct, the coils are wired across the A+ A- terminal, this is a little more clear is you look at the silkscreen on the controller.

We will clarify on the wiki as well

mschreib-il, 2021-09-28:
- OK: so for a thread-screw router where Y and Y2 are operating  in parallel, the same wiring is appropriate; for a belt-driven CNC where Y and Y2 are operating in  complementary motion, then the wirings need to be reversed. Please confirm that I'm understanding this correctly and I'll close this issue.

- probably a good idea to document this more clearly as well; for beginners such as myself these concepts are not intuitively obvious.

Thanks for the quick response.

Spark-Concepts, 2021-09-29:
1) You are correct, basically if the motors face in the same direction on a bound/slaved axis they get wired identically.  If the face opposite directions, one must turn counter to the other.

2) agreed, thank you for mentioning!

Closed 2021-09-29.

Thread 65 (2021-10-02):

Unable to Control VFD

sflom, 2021-10-02:
So I have been struggling getting my QueenBee 1515 with the CNC Xpro V5 to communicate with my HuanYang VFD - 2.2kw water cooled spindle via USB.  I can issue the M3 S6000 command and the spindle starts and the relay kicks on my water pump.  After a little while, I get the [MSG:Spindle RS485 Unresponsive 6]
[MSG:Critical Spindle RS485 Unresponsive]
ALARM:10
[MSG:Critical Spindle RS485 did not reach speed 6000. Reported speed is -1 rpm.]
ok
ALARM:10

I purchased an inline power filter, star grounding and ferrite chokes to help with interference.  I added these products and was able to get the spindle to start and run error free for one evening on the bench.  The next evening, I mocked up my electronics cabinet and added the parts where I thought they might fit and decided to verify it was still working.  But I started getting unresponsive messages and I can not turn off the spindle (again).

I seen the latest guide that Spark-Concepts wrote up for the RS485 spindle control but that hasn't helped me.  I've reset my VFD and reinstalled my firmware but still can't get past this.  I'm hoping it just a setting that I'm missing.

I'm also using CNCjs to communicate via USB. The $H works fine.

Any suggestions are great appreciated.

 ets Jun  8 2016 00:22:57
rst:0x1 (POWERON_RESET),boot:0x17 (SPI_FAST_FLASH_BOOT)
configsip: 0, SPIWP:0xee
clk_drv:0x00,q_drv:0x00,d_drv:0x00,cs0_drv:0x00,hd_drv:0x00,wp_drv:0x00
mode:DIO, clock div:1
load:0x3fff0018,len:4
load:0x3fff001c,len:1216
ho 0 tail 12 room 4
load:0x40078000,len:9720
ho 0 tail 12 room 4
load:0x40080400,len:6352
entry 0x400806b8
[MSG:Grbl_ESP32 Ver 1.3a Date 20210816]
[MSG:Compiled with ESP32 SDK:v3.2.3-14-gd3e562907]
[MSG:Using machine:CNC_xPRO_V5_XYYZ_NC]
[MSG:Axis count 3]
[MSG:RMT Steps]
[MSG:Door switch on pin GPIO(16)]
[MSG:Macro Pin 1 GPIO(13)]
[MSG:Macro Pin 2 GPIO(0)]
[MSG:Init Motors]
[MSG:TMCStepper Library Ver. 0x000703]
[MSG:X  Axis Trinamic TMC5160 Step:GPIO(12) Dir:GPIO(14) CS:GPIO(17) Disable:None Index:1 R:0.050 Limits(0.000,1300.000)]
[MSG:X  Axis Trinamic driver test passed]
[MSG:Y  Axis Trinamic TMC5160 Step:GPIO(27) Dir:GPIO(26) CS:GPIO(17) Disable:None Index:2 R:0.050 Limits(-1270.000,0.000)]
[MSG:Y  Axis Trinamic driver test passed]
[MSG:Y2 Axis Trinamic TMC5160 Step:GPIO(33) Dir:GPIO(32) CS:GPIO(17) Disable:None Index:3 R:0.050 Limits(-1270.000,0.000)]
[MSG:Y2 Axis Trinamic driver test passed]
[MSG:Z  Axis Trinamic TMC5160 Step:GPIO(15) Dir:GPIO(2) CS:GPIO(17) Disable:None Index:4 R:0.050 Limits(-106.000,0.000)]
[MSG:Z  Axis Trinamic driver test passed]
[MSG:Initializing RS485 VFD spindle]
[MSG:Auto-RTS in use]
[MSG:VFD RS485  Tx:GPIO(4) Rx:GPIO(25) RTS:None]
[MSG:Client Started]
[MSG:Connecting WIFI]
[MSG:Connecting.]
[MSG:VFD: VFD settings read: RPM Range(6000, 24000)]]
[MSG:Connecting..]
[MSG:Connecting...]
[MSG:Connecting....]
[MSG:Connected with 10.0.1.199]
[MSG:Connected with 10.0.1.199]
[MSG:Start mDNS with hostname:http://CNC_xPRO_V5.local/]
[MSG:SSDP Started]
[MSG:HTTP Started]
[MSG:TELNET Started 23]
[MSG:Mist coolant on pin GPIO(21)]
[MSG:X  Axis limit switch on pin GPIO(35)]
[MSG:Y  Axis limit switch on pin GPIO(34)]
[MSG:Z  Axis limit switch on pin GPIO(39)]
[MSG:Probe on pin GPIO(22)]
Grbl 1.3a ['$' for help]
[MSG:'$H'|'$X' to unlock]
> $S
$Sta/SSID=WIFI
$Sta/Password=******
$Sta/IPMode=Static
$Sta/IP=10.0.1.199
$Sta/Gateway=10.0.1.1
$Sta/Netmask=255.255.255.0
$AP/SSID=CNC_xPRO_V5<Alarm|MPos:0.000,0.000,0.000|FS:0,0|Pn:P>
$AP/Password=******
$AP/IP=192.168.0.1
$AP/Channel=1
$System/Hostname=CNC_xPRO_V5
$Http/Enable=ON
$Http/Port=80
$Telnet/Enable=ON
$Telnet/Port=23
$Radio/Mode=STA
$Bluetooth/Name=XPRO_V5_BT
$Notification/Type=NONE
$Notification/T1=
$Notification/T2=
$Notification/TS=
$Message/Level=Info
$User/Macro0=
$User/Macro1=
$User/Macro2=
$User/Macro3=
$Homing/Cycle0=Z
$Homing/Cycle1=XY
$Homing/Cycle2=
$Homing/Cycle3=
$Homing/Cycle4=
$Homing/Cycle5=
$Report/StallGuard=
$Stepper/Enable/Delay=0
$Stepper/Direction/Delay=0
$Stepper/Pulse=5
$Stepper/IdleTime=255
$Stepper/StepInvert=
$Stepper/DirInvert=
$Stepper/EnableInvert=Off
$Limits/Invert=On
$Probe/Invert=Off
$Report/Status=1
$GCode/JunctionDeviation=0.010
$GCode/ArcTolerance=0.002
$Report/Inches=Off
$Firmware/Build=
$Limits/Soft=On
$Limits/Hard=Off
$Homing/Enable=On
$Homing/DirInvert=X
$Homing/Squared=
$Homing/Feed=100.000
$Homing/Seek=1000.000
$Homing/Debounce=250.000
$Homing/Pulloff=10.000
$GCode/MaxS=24000.000
$GCode/MinS=0.000
$Laser/FullPower=1000
$GCode/LaserMode=Off
$GCode/Line1=
$GCode/Line0=
$Spindle/Enable/Invert=Off
$Spindle/Enable/OffWithSpeed=Off
$Coolant/Delay/TurnOn=1.000
$Spindle/Delay/SpinDown=0.000
$Spindle/Delay/SpinUp=0.000
$Spindle/PWM/Invert=Off
$Spindle/PWM/Frequency=5000.000
$Spindle/PWM/Off=0.000
$Spindle/PWM/Min=0.000
$Spindle/PWM/Max=100.000
$Spindle/Type=HUANYANG
$X/StepsPerMm=200.000
$Y/StepsPerMm=200.000
$Z/StepsPerMm=200.000
$A/StepsPerMm=200.000
$B/StepsPerMm=100.000
$C/StepsPerMm=100.000
$X/MaxRate=3000.000
$Y/MaxRate=3000.000
$Z/MaxRate=2500.000
$A/MaxRate=3000.000
$B/MaxRate=1000.000
$C/MaxRate=1000.000
$X/Acceleration=150.000
$Y/Acceleration=150.000
$Z/Acceleration=150.000
$A/Acceleration=150.000
$B/Acceleration=200.000
$C/Acceleration=200.000
$X/Home/Mpos=0.000
$Y/Home/Mpos=0.000
$Z/Home/Mpos=0.000
$A/Home/Mpos=0.000
$B/Home/Mpos=0.000
$C/Home/Mpos=0.000
$X/MaxTravel=1300.000
$Y/MaxTravel=1270.000
$Z/MaxTravel=106.000
$A/MaxTravel=1270.000
$B/MaxTravel=300.000
$C/MaxTravel=300.000
$X/Current/Run=1.950
$Y/Current/Run=1.950
$Z/Current/Run=1.950
$A/Current/Run=1.950
$B/Current/Run=0.250
$C/Current/Run=0.250
$X/Current/Hold=1.250
$Y/Current/Hold=1.250
$Z/Current/Hold=1.250
$A/Current/Hold=1.250
$B/Current/Hold=0.125
$C/Current/Hold=0.125
$X/Microsteps=8
$Y/Microsteps=8
$Z/Microsteps=8
$A/Microsteps=8
$B/Microsteps=16
$C/Microsteps=16
$X/StallGuard=16
$Y/StallGuard=16
$Z/StallGuard=16
$A/StallGuard=16
$B/StallGuard=16
$C/StallGuard=16
$Errors/Verbose=On
ok
> $+
$0=5 (Step pulse time, microseconds)
$1=255 (Step idle delay, milliseconds)
$2=0 (Step pulse invert, mask)
$3=0 (Step direction invert, mask)
$4=0 (Invert step enable pin, boolean)
$5=1 (Invert limit pins, boolean)
$6=0 (Invert probe pin, boolean)
$10=1 (Status report options, mask)
$11=0.010 (Junction deviation, millimeters)
$12=0.002 (Arc tolerance, millimeters)
$13=0 (Report in inches, boolean)
$20=1 (Soft limits enable, boolean)
$21=0 (Hard limits enable, boolean)
$22=1 (Homing cycle enable, boolean)
$23=1 (Homing direction invert, mask)
$24=100.000 (Homing locate feed rate, mm/min)
$25=1000.000 (Homing search seek rate, mm/min)
$26=250.000 (Homing switch debounce delay, milliseconds)
$27=10.000 (Homing switch pull-off distance, millimeters)
$30=24000.000 (Maximum spindle speed, RPM)
$31=0.000 (Minimum spindle speed, RPM)
$32=0 (Laser-mode enable, boolean)
$N1=
$N0=
$33=5000.000
$34=0.000
$35=0.000
$36=100.000
$100=200.000 (X-axis travel resolution, step/mm)
$101=200.000 (Y-axis travel resolution, step/mm)
$102=200.000 (Z-axis travel resolution, step/mm)
$103=200.000
$104=100.000
$105=100.000
$110=3000.000 (X-axis maximum rate, mm/min)
$111=3000.000 (Y-axis maximum rate, mm/min)
$112=2500.000 (Z-axis maximum rate, mm/min)
$113=3000.000
$114=1000.000
$115=1000.000
$120=150.000 (X-axis acceleration, mm/sec^2)
$121=150.000 (Y-axis acceleration, mm/sec^2)
$122=150.000 (Z-axis acceleration, mm/sec^2)
$123=150.000
$124=200.000
$125=200.000
$130=1300.000 (X-axis maximum travel, millimeters)
$131=1270.000 (Y-axis maximum travel, millimeters)
$132=106.000 (Z-axis maximum travel, millimeters)
$133=1270.000
$134=300.000
$135=300.000
$140=1.950
$141=1.950
$142=1.950
$143=1.950
$144=0.250
$145=0.250
$150=1.250
$151=1.250
$152=1.250
$153=1.250
$154=0.125
$155=0.125
$160=8
$161=8
$162=8
$163=8
$164=16
$165=16
$170=16
$171=16
$172=16
$173=16
$174=16
$175=16
ok
> $I
[VER:1.3a.20210816:]
[OPT:MPHBSW]
[MSG:Using machine:CNC_xPRO_V5_XYYZ_NC]
[MSG:Mode=STA:SSID=WIFI:Status=Connected:IP=10.0.1.199:MAC=98-CD-AC-6D-66-28]
[MSG:No BT]
ok
> M3 S6000
error: GCode cannot be executed in lock or alarm state
> $X
[MSG:Caution: Unlocked]
ok
> M3 S6000
[MSG:Spindle RS485 Unresponsive 6]
[MSG:Critical Spindle RS485 Unresponsive]
ALARM:10
[MSG:Critical Spindle RS485 did not reach speed 6000. Reported speed is -1 rpm.]
ok
ALARM:10
Grbl 1.3a ['$' for help]
[MSG:'$H'|'$X' to unlock]

Spark-Concepts, 2021-10-05:
Hi sflom,

Could you add some pictures of your controller inside your cabinet so we can see the wire routing etc?

What command are you using to turn on the relay to activate the coolant?

Form these messages:

[MSG:Initializing RS485 VFD spindle]
[MSG:Auto-RTS in use]
[MSG:VFD RS485 Tx:GPIO(4) Rx:GPIO(25) RTS:None]
[MSG:Client Started]
[MSG:Connecting WIFI]
[MSG:Connecting.]
[MSG:VFD: VFD settings read: RPM Range(6000, 24000)]]

You have bidirectional communication before powering the Spindle, so we are likely chasing a noise issue or a spin-up time issue.

sflom, 2021-10-10:
I went ahead and verified all my connections, set proper star grounding, routed the power lines away from motors and limit lines and installed everything back into my enclosure.  Now I can control the spindle as it should.

All is working as it should.

This case can be closed.

Thanks.

Scott

PS - I have an IOT power relay that the VFD switches on when the spindle starts. It starts my water pump for the spindle and shuts it off when the spindle turns off. Works pretty slick.

FB and 24w are jumped together and a line from FC and DCM runs down to the relay.

Sent from my iPad

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

Closed 2021-10-12.

Thread 66 (2021-10-05):

Unresponsive Z Motor Output

APG-77, 2021-10-05:
Hello! I'm running into some trouble with my CNC xPRO V5. I am unable to get the Z-Axis working. I have narrowed the problem down to the xPRO not outputting a signal to the Z motor. I know this because I switched the wiring between X and Z motors, and in both cases, the motors work when connected to the X axis pins, but not when connected to the Z axis pins. In fact, it appears the Z motor output is not supplying any power at all. I am using the default firmware and have reviewed the GRBL settings, but none seem relevant. Is there a setting or firmware version I should be using? Sorry if this is something obvious. I checked the Wiki but don't see anything either. Cheers and thanks!

Spark-Concepts, 2021-10-05:
This is definitely not normal operation.  Could you send command $i and $S for the controller and paste the responses here.

Spark-Concepts, 2021-10-06:
Thanks!  The A/Y2 limit switch port is disabled by default so no values should be showing up.

It looks like both of you have some older firmware, could you update to the latest push here:  https://github.com/Spark-Concepts/xPro-V5/tree/main/Firmware

Following these directions: https://github.com/Spark-Concepts/xPro-V5/wiki/Checking_firmware_and_upgrading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

Take note of any special settings that you have changed (direction inversions, homing inversions, steps/mm etc) prior to loading new firmware.  Once loaded send command $RST=* to default to the new firmware settings and then apply the custom settings you recorded.

If the issue persist, lets run a motor self-test:  Connect to the controller using USB, then open CNCjs and connect to the controller (make sure to check the "Enable hardware flow control" box in the com port area).  You will see a long output of diagnostics and settings -  look for these lines for each motor and paste them back here:

[MSG:X  Axis Trinamic TMC5160 Step:GPIO(12) Dir:GPIO(14) CS:GPIO(17) Disable:None Index:1 R:0.050 Limits(0.000,300.000)]

[MSG:X  Axis Trinamic driver test passed]

APG-77, 2021-10-08:
The update worked for me as well, problem solved. Have to say I'm impressed with the overall quality and UX of this project. You guys have done great. Thanks again!

Closed 2021-10-08.

Thread 69 (2021-10-09):

Y motor driver not working

Emanuelbastos1, 2021-10-09:
Hello,

The machine finished a job working properly, after that I went for dinner and when I came back and tried to move Y-axis the machine started to make horrible noises and move only the Y2 motor.
Al the other axis are moving correctly.
I noticed that in standby I can rotate the Y motor and I can´t rotate the others. I also switched cable connections in the controller and the problem changed to the Y2 motor. Finally, I put connections as before and the problem returned to Y motor and disappeared from Y2.
In the following video, you can see that the motor is not spinning and is making horrible noises.

https://user-images.githubusercontent.com/85850044/136675984-6b4b8c36-820a-4b19-b700-17c02b54641c.mp4

In case you need, my current settings:
> $S
$Sta/SSID=CNC_xPRO_V5
$Sta/Password=******
$Sta/IPMode=DHCP
$Sta/IP=0.0.0.0
$Sta/Gateway=0.0.0.0
$Sta/Netmask=0.0.0.0
$AP/SSID=CNC_xPRO_V5
$AP/Password=******
$AP/IP=192.168.0.1
$AP/Channel=1
$System/Hostname=CNC_xPRO_V5
$Http/Enable=ON
$Http/Port=80
$Telnet/Enable=ON
$Telnet/Port=23
$Radio/Mode=AP
$Bluetooth/Name=XPRO_V5_BT
$Notification/Type=NONE
$Notification/T1=
$Notification/T2=
$Notification/TS=
$User/Macro0=
$User/Macro1=
$User/Macro2=
$User/Macro3=
$Homing/Cycle0=Z
$Homing/Cycle1=XY
$Homing/Cycle2=<Idle|MPos:1.000,2.000,-1.000|FS:0,0>
$Homing/Cycle3=
$Homing/Cycle4=
$Homing/Cycle5=
$Report/StallGuard=
$Stepper/Pulse=4
$Stepper/IdleTime=255
$Stepper/StepInvert=
$Stepper/DirInvert=
$Stepper/EnableInvert=Off
$Limits/Invert=On
$Probe/Invert=On
$Report/Status=1
$GCode/JunctionDeviation=0.010
$GCode/ArcTolerance=0.002
$Report/Inches=Off
$Firmware/Build=
$Limits/Soft=On
$Limits/Hard=Off
$Homing/Enable=On
$Homing/DirInvert=XY
$Homing/Squared=
$Homing/Feed=200.000
$Homing/Seek=2000.000
$Homing/Debounce=250.000
$Homing/Pulloff=2.500
$GCode/MaxS=24000.000
$GCode/MinS=0.000
$Laser/FullPower=1000
$GCode/LaserMode=Off
$GCode/Line1=
$GCode/Line0=
$Spindle/Enable/Invert=Off
$Spindle/Enable/OffWithSpeed=Off
$Spindle/Delay/SpinDown=0.000
$Spindle/Delay/SpinUp=0.000
$Spindle/PWM/Invert=Off
$Spindle/PWM/Frequency=5000.000
$Spindle/PWM/Off=0.000
$Spindle/PWM/Min=0.000
$Spindle/PWM/Max=100.000
$Spindle/Type=PWM
$X/StepsPerMm=200.000
$Y/StepsPerMm=200.000
$Z/StepsPerMm=200.000
$A/StepsPerMm=200.000
$B/StepsPerMm=100.000
$C/StepsPerMm=100.000
$X/MaxRate=2500.000
$Y/MaxRate=2500.000
$Z/MaxRate=2500.000
$A/MaxRate=1000.000
$B/MaxRate=1000.000
$C/MaxRate=1000.000
$X/Acceleration=100.000
$Y/Acceleration=100.000
$Z/Acceleration=100.000
$A/Acceleration=200.000
$B/Acceleration=200.000
$C/Acceleration=200.000
$X/Home/Mpos=0.000
$Y/Home/Mpos=0.000
$Z/Home/Mpos=0.000
$A/Home/Mpos=0.000
$B/Home/Mpos=0.000
$C/Home/Mpos=0.000
$X/MaxTravel=780.000
$Y/MaxTravel=785.000
$Z/MaxTravel=90.000
$A/MaxTravel=300.000
$B/MaxTravel=300.000
$C/MaxTravel=300.000
$X/Current/Run=1.800
$Y/Current/Run=1.800
$Z/Current/Run=1.800
$A/Current/Run=1.800
$B/Current/Run=0.250
$C/Current/Run=0.250
$X/Current/Hold=1.250
$Y/Current/Hold=1.250
$Z/Current/Hold=1.250
$A/Current/Hold=1.250
$B/Current/Hold=0.125
$C/Current/Hold=0.125
$X/Microsteps=8
$Y/Microsteps=8
$Z/Microsteps=8
$A/Microsteps=16
$B/Microsteps=16
$C/Microsteps=16
$X/StallGuard=16
$Y/StallGuard=16
$Z/StallGuard=16
$A/StallGuard=16
$B/StallGuard=16
$C/StallGuard=16
$Errors/Verbose=Off
ok

I hope you can help me to solve this quickly,
Thanks!

Spark-Concepts, 2021-10-10:
First, please try reducing the value of $111 (i.e. `$111=2000.000`) and recheck Y axis moment.

Also, please post your $i response,

1. Did the Y axis fault LED illuminate red?
2. Using CNCjs via USB, reset xPro and note
3. Is this behavior all the time, intermittent, or only if the machine's been on for a period of time?

If the issue persist, lets run a motor self-test: Connect to the controller using USB, then open CNCjs and connect to the controller (make sure to check the "Enable hardware flow control" box in the com port area). You will see a long output of diagnostics and settings - look for these lines for each motor and paste them back here:

[MSG:X Axis Trinamic TMC5160 Step:GPIO(12) Dir:GPIO(14) CS:GPIO(17) Disable:None Index:1 R:0.050 Limits(0.000,300.000)]

[MSG:X Axis Trinamic driver test passed]

laufla, 2021-10-11:
here's the test :
CNCjs 1.9.22 [Grbl]
Connected to COM3 with a baud rate of 115200
un  8 2016 00:22:57
rst:0x1 (POWERON_RESET),boot:0x13 (SPI_FAST_FLASH_BOOT)
configsip: 0, SPIWP:0xee
clk_drv:0x00,q_drv:0x00,d_drv:0x00,cs0_drv:0x00,hd_drv:0x00,wp_drv:0x00
mode:DIO, clock div:1
load:0x3fff0018,len:4
load:0x3fff001c,len:1216
ho 0 tail 12 room 4
load:0x40078000,len:9720
ho 0 tail 12 room 4
load:0x40080400,len:6352
entry 0x400806b8
[MSG:Grbl_ESP32 Ver 1.3a Date 20201022]
[MSG:Compiled with ESP32 SDK:v3.2.3-14-gd3e562907]
[MSG:Using machine:CNC_xPRO_V5_XYYZ]
[MSG:Axis count 3]
[MSG:RMT Steps]
[MSG:Init Motors]
[MSG:TMCStepper Library Ver. 0x000701]
[MSG:X  Axis Trinamic TMC5160 Step:GPIO(12) Dir:GPIO(14) CS:GPIO(17) Disable:None Index:1 Limits(0.000,300.000)]
[MSG:X  Axis Trinamic driver test passed]
[MSG:Y  Axis Trinamic TMC5160 Step:GPIO(27) Dir:GPIO(26) CS:GPIO(17) Disable:None Index:2 Limits(0.000,300.000)]
[MSG:Y  Axis Trinamic driver test passed]
[MSG:Y2 Axis Trinamic TMC5160 Step:GPIO(33) Dir:GPIO(32) CS:GPIO(17) Disable:None Index:3 Limits(0.000,300.000)]
[MSG:Y2 Axis Trinamic driver test passed]
[MSG:Z  Axis Trinamic TMC5160 Step:GPIO(15) Dir:GPIO(2) CS:GPIO(17) Disable:None Index:4 Limits(-300.000,0.000)]
[MSG:Z  Axis Trinamic driver test passed]
[MSG:PWM spindle Output:GPIO(25), Enbl:GPIO(4), Dir:None, Freq:5000Hz, Res:13bits]
[MSG:Client Started]
[MSG:Connecting BBT]
[MSG:Connecting.]
[MSG:Connecting..]
[MSG:Connecting...]
[MSG:Connecting....]
[MSG:Connecting.]
[MSG:Connecting..]
[MSG:Connecting...]
[MSG:Connecting....]
[MSG:Connected with 192.168.1.95]
[MSG:Start mDNS with hostname:http://CNC_xPRO_V5.local/]
[MSG:SSDP Started]
[MSG:HTTP Started]
[MSG:TELNET Started 23]
[MSG:Flood coolant on pin GPIO(21)]
[MSG:Mist coolant on pin GPIO(21)]
[MSG:X  Axis limit switch on pin GPIO(35)]
[MSG:Y  Axis limit switch on pin GPIO(34)]
[MSG:Z  Axis limit switch on pin GPIO(39)]
[MSG:Probe on pin GPIO(22)]
Grbl 1.3a ['$' for help]
client> $$
$0=4 (Step pulse time, microseconds)
$1=255 (Step idle delay, milliseconds)
$2=0 (Step pulse invert, mask)
$3=15 (Step direction invert, mask)
$4=1 (Invert step enable pin, boolean)
$5=1 (Invert limit pins, boolean)
$6=1 (Invert probe pin, boolean)
$10=1 (Status report options, mask)
$11=0.010 (Junction deviation, millimeters)
$12=0.002 (Arc tolerance, millimeters)
$13=0 (Report in inches, boolean)
$20=0 (Soft limits enable, boolean)
$21=0 (Hard limits enable, boolean)
$22=0 (Homing cycle enable, boolean)
$23=3 (Homing direction invert, mask)
$24=200.000 (Homing locate feed rate, mm/min)
$25=2000.000 (Homing search seek rate, mm/min)
$26=250.000 (Homing switch debounce delay, milliseconds)
$27=2.500 (Homing switch pull-off distance, millimeters)
$30=24000.000 (Maximum spindle speed, RPM)
$31=0.000 (Minimum spindle speed, RPM)
$32=0 (Laser-mode enable, boolean)
$N1=
$N0=
$100=200.000 (X-axis travel resolution, step/mm)
$101=200.000 (Y-axis travel resolution, step/mm)
$102=200.000 (Z-axis travel resolution, step/mm)
$103=200.000
$104=100.000
$105=100.000
$110=2500.000 (X-axis maximum rate, mm/min)
$111=2500.000 (Y-axis maximum rate, mm/min)
$112=2500.000 (Z-axis maximum rate, mm/min)
$113=1000.000
$114=1000.000
$115=1000.000
$120=100.000 (X-axis acceleration, mm/sec^2)
$121=100.000 (Y-axis acceleration, mm/sec^2)
$122=100.000 (Z-axis acceleration, mm/sec^2)
$123=200.000
$124=200.000
$125=200.000
$130=300.000 (X-axis maximum travel, millimeters)
$131=300.000 (Y-axis maximum travel, millimeters)
$132=300.000 (Z-axis maximum travel, millimeters)
$133=300.000
$134=300.000
$135=300.000
ok
>

Emanuelbastos1, 2021-10-11:
Hi,

I reduced the value of $111 and, unfortunately  the motor behaves the same.

**$i**

[VER:1.3a.20210816:]
[OPT:MPHBSW]
[MSG:Using machine:CNC_xPRO_V5_XYYZ_NO]
[MSG:Mode=AP:SSDI=CNC_xPRO_V5:IP=192.168.0.1:MAC=40-F5-20-A0-40-95]
[MSG:No BT

**Did the Y axis fault LED illuminate red?**
No.
**Is this behavior all the time, intermittent, or only if the machine's been on for a period of time?**
Yes it is all the time.

**Drivers test**

[MSG:Grbl_ESP32 Ver 1.3a Date 20210816]
[MSG:Compiled with ESP32 SDK:v3.2.3-14-gd3e562907]
[MSG:Using machine:CNC_xPRO_V5_XYYZ_NO]
[MSG:Axis count 3]
[MSG:RMT Steps]
[MSG:Door switch on pin GPIO(16)]
[MSG:Macro Pin 1 GPIO(13)]
[MSG:Macro Pin 2 GPIO(0)]
[MSG:Init Motors]
[MSG:TMCStepper Library Ver. 0x000703]
[MSG:X  Axis Trinamic TMC5160 Step:GPIO(12) Dir:GPIO(14) CS:GPIO(17) Disable:None Index:1 R:0.050 Limits(0.000,780.000)]
[MSG:X  Axis Trinamic driver test passed]
[MSG:Y  Axis Trinamic TMC5160 Step:GPIO(27) Dir:GPIO(26) CS:GPIO(17) Disable:None Index:2 R:0.050 Limits(0.000,785.000)]
[MSG:Y  Axis Trinamic driver test passed]
[MSG:Y2 Axis Trinamic TMC5160 Step:GPIO(33) Dir:GPIO(32) CS:GPIO(17) Disable:None Index:3 R:0.050 Limits(0.000,785.000)]
[MSG:Y2 Axis Trinamic driver test passed]
[MSG:Z  Axis Trinamic TMC5160 Step:GPIO(15) Dir:GPIO(2) CS:GPIO(17) Disable:None Index:4 R:0.050 Limits(-90.000,0.000)]
[MSG:Z  Axis Trinamic driver test passed]

Thanks again!

Closed 2021-10-16.

Thread 72 (2021-10-15):

Error 13 Door

hellboytat, 2021-10-15:
I want to add a E stop button but am running into a few issues.

I have installed the NO firmware. I have checked the jumper cables ( Its on disable E-Stop and 5v).

If I add the 3.81mm connector without any wires I get no error and it works. If I add a wire coming out of the SIG pin that leads nowhere it triggers the error. I think there is a defect here

Any advice?

Spark-Concepts, 2021-10-16:
Does the board mounted 3.81 receptacle housing seem loose? It might be worth inspecting for debris/cold solder joint (try the steps below first - if your issues persist, please let me know)

Does it matter which terminal the wire is installed before triggering the error (right or left)? If you have a digital multimeter, please measure DC voltage across 3.81mm e-stop connector & let me know if you see a voltage reading of ~5V.

Also, please move the "GPIO logic" jumper to "24V" and "out" & re-test and re-measure voltage (you should see ~24V)

spidee601, 2022-05-21:
Make sure your Ebutton isn't already pushed down.  I spent about an hour trying to figure it out, only to find that I forgot to twist the ebutton to disengage it.

Closed 2022-08-08.

Thread 78 (2021-10-25):

BM3D laser and spindle issue

byronendleton, 2021-10-25:
Gday. i struggled to get the laser going but found the solution on here by updating to the correct firmware. it solved the laser issue but broke the spindle. when i switch back to spindle it turns slowly by itself and wont start when i hit the M4 comand. it does however spin when i hit the test fire laser button. laser is connected to the PWM output and spindle to the 0-10v. i swap plugs over when changing toolhead so they both go through the relay respectively. i have macros setup to change the frequency settings and laser enable etc. am i missing something?

byronendleton, 2021-11-05:
any fixes yet? I'm getting 3v on the EN pin when in spindle mode and nothing selected to run. and the relay doesn't click anymore with the laser firmware. I've reverted back to the other firmware to use the spindle.

minapieni, 2022-04-02:
I have issues too with XPro v5 and OPT laser with Lightburn. I can carve but laser won't stay off when moving between letters, curves etc. It will shut off when the carving is done but otherwise laser stays on when traveling. As far as I can understand, my settings are ok. I just don't get this. (My cheap 3018pro with laser  works just well with same settings in Lightburn). Any ideas how to fix this? Is Xpro GRBL in Lightburn settings?

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

Spark-Concepts, 2022-08-08:
Please try updating firmware to the latest release as of July 2022 - please repost if you are still having issues

Closed 2022-08-08.

Thread 80 (2021-11-02):

FluidNC

ahedderich, 2021-11-02:
Hi, i would like to try running FluidNC as firmware on the xPro V5.
to create a config file i would need to have a schematic of the gpio pins used.
alternatively could you provide a sample config yaml for the xpro like this:
https://github.com/bdring/FluidNC/blob/main/example_configs/6_pack_TMC5160.yaml

ahedderich, 2021-11-02:
i just found the pinout picture...
https://github.com/Spark-Concepts/xPro-V5/blob/main/images/xProV5-GPIO_PinMap.jpg

Spark-Concepts, 2021-11-02:
quick find!  If you would like help generating the config file feel free to post and let us know.

We are tracking the FluidNC development, if you have thoughts and experiences you would like to share please do!

ahedderich, 2021-11-03:
i will try it with this config on the weekend.
not super sure though about the 10V section.
since i have to output 10V to control spindle speed, thats my best guess going by the schematics on how the toolhead pinout work.
maybe for xPro V6 you could use the i2s protocol to add more stepper drivers. like bartons latest controller board.
it seems to have some benefits for connecting more things and synchronising with the stepping engine
i will give feedback if this config file works for me.
```
board: xPro V5
name: xPro V5 XYZ 3 motors
stepping:
  engine: RMT
  idle_ms: 250
  dir_delay_us: 1
  pulse_us: 2
  disable_delay_us: 0

axes:
  shared_stepper_disable_pin: NO_PIN
  x:
    steps_per_mm: 800.000
    max_rate_mm_per_min: 5000.000
    acceleration_mm_per_sec2: 100.000
    max_travel_mm: 300.000
    soft_limits: false
    homing:
      cycle: 2
      positive_direction: false
      mpos_mm: 150.000
      feed_mm_per_min: 100.000
      seek_mm_per_min: 200.000
      debounce_ms: 500
      seek_scaler: 1.100
      feed_scaler: 1.100

    motor0:
      limit_neg_pin: gpio.35:low
      limit_pos_pin: NO_PIN
      limit_all_pin: NO_PIN
      hard_limits: true
      pulloff_mm: 1.000
      tmc_5160:
        cs_pin: gpio.17
        spi_index: 1
        r_sense_ohms: 0.075
        run_amps: 1.75
        hold_amps: 0.50
        microsteps: 256
        stallguard: 0
        stallguard_debug: false
        toff_disable: 0
        toff_stealthchop: 5
        toff_coolstep: 3
        run_mode: CoolStep
        homing_mode: CoolStep
        use_enable: true
        step_pin: gpio.12
        direction_pin: gpio.14
        disable_pin: NO_PIN

  y:
    steps_per_mm: 800.000
    max_rate_mm_per_min: 5000.000
    acceleration_mm_per_sec2: 100.000
    max_travel_mm: 300.000
    soft_limits: false
    homing:
      cycle: 2
      positive_direction: true
      mpos_mm: 150.000
      feed_mm_per_min: 100.000
      seek_mm_per_min: 200.000
      debounce_ms: 500
      seek_scaler: 1.100
      feed_scaler: 1.100

    motor0:
      limit_neg_pin: gpio.34:low
      limit_pos_pin: NO_PIN
      limit_all_pin: NO_PIN
      hard_limits: true
      pulloff_mm: 1.000
      tmc_5160:
        cs_pin: gpio.17
        spi_index: 2
        r_sense_ohms: 0.075
        run_amps: 1.75
        hold_amps: 0.50
        microsteps: 256
        stallguard: 0
        stallguard_debug: false
        toff_disable: 0
        toff_stealthchop: 5
        toff_coolstep: 3
        run_mode: StealthChop
        homing_mode: StealthChop
        use_enable: true
        step_pin: gpio.27
        direction_pin: gpio.26
        disable_pin: NO_PIN

  z:
    steps_per_mm: 800.000
    max_rate_mm_per_min: 5000.000
    acceleration_mm_per_sec2: 100.000
    max_travel_mm: 300.000
    soft_limits: false
    homing:
      cycle: 1
      positive_direction: true
      mpos_mm: 150.000
      feed_mm_per_min: 100.000
      seek_mm_per_min: 800.000
      debounce_ms: 500
      seek_scaler: 1.100
      feed_scaler: 1.100

    motor0:
      limit_neg_pin: gpio.39
      limit_pos_pin: NO_PIN
      limit_all_pin: NO_PIN
      hard_limits: true
      pulloff_mm: 1.000
      tmc_5160:
        cs_pin: gpio.17
        spi_index: 3
        r_sense_ohms: 0.075
        run_amps: 1.750
        hold_amps: 0.50
        microsteps: 16256
        stallguard: 0
        stallguard_debug: false
        toff_disable: 0
        toff_stealthchop: 5
        toff_coolstep: 3
        run_mode: StealthChop
        homing_mode: StealthChop
        use_enable: true
        step_pin: gpio.15
        direction_pin: gpio.2
        disable_pin: NO_PIN

coolant:
  flood_pin: NO_PIN
  mist_pin: gpio.21
  delay_ms: 0

i2so:
  bck_pin: NO_PIN
  data_pin: NO_PIN
  ws_pin: NO_PIN

spi:
  miso_pin: gpio.19
  mosi_pin: gpio.23
  sck_pin: gpio.18

sdcard:
  card_detect_pin: NO_PIN
  cs_pin: gpio.5

control:
  safety_door_pin: gpio.16
  reset_pin: NO_PIN
  feed_hold_pin: NO_PIN
  cycle_start_pin: NO_PIN
  macro0_pin: gpio.13
  macro1_pin: gpio.0
  macro2_pin: NO_PIN
  macro3_pin: NO_PIN

probe:
  pin: gpio.22
  check_mode_start: false

macros:
  startup_line0:
  startup_line1:
  macro0:
  macro1:
  macro2:
  macro3:

user_outputs:
  analog0_pin: NO_PIN
  analog1_pin: NO_PIN
  analog2_pin: NO_PIN
  analog3_pin: NO_PIN
  analog0_hz: 5000
  analog1_hz: 5000
  analog2_hz: 5000
  analog3_hz: 5000
  digital0_pin: NO_PIN
  digital1_pin: NO_PIN
  digital2_pin: NO_PIN
  digital3_pin: NO_PIN

start:
  must_home: false

10V:
  forward_pin: NO_PIN
  reverse_pin: NO_PIN
  pwm_hz: 5000
  output_pin: gpio.25
  enable_pin: gpio.4
  direction_pin: NO_PIN
  disable_with_s0: false
  s0_with_disable: true
  spinup_ms: 0
  spindown_ms: 0
  tool_num: 0
  speed_map: 0=0.000% 1000=0.000% 24000=100.000%```

ahedderich, 2021-11-08:
so after a bit of testing i can say it works...
one issue so far is tmc driver initiation does not work properly when reseting while connected via usb. i wrote with bart on discord and he will investigate that behavior. if i find the time i will also have a look at the source why this happens but other than that everything works.
my config so far is as follows:
```
board: xPro V5
name: xPro V5 XYZA
stepping:
  engine: RMT
  idle_ms: 255
  pulse_us: 2
  dir_delay_us: 1
  disable_delay_us: 0

axes:
  shared_stepper_disable_pin: NO_PIN
  x:
    steps_per_mm: 800.000
    max_rate_mm_per_min: 9000.000
    acceleration_mm_per_sec2: 250.000
    max_travel_mm: 900.000
    soft_limits: false
    homing:
      cycle: 2
      positive_direction: false
      mpos_mm: 150.000
      feed_mm_per_min: 100.000
      seek_mm_per_min: 200.000
      seek_scaler: 1.100
      feed_scaler: 1.100

    motor0:
      limit_neg_pin: gpio.35:low
      limit_pos_pin: NO_PIN
      limit_all_pin: NO_PIN
      hard_limits: false
      pulloff_mm: 1.000
      tmc_5160:
        cs_pin: gpio.17
        spi_index: 1
        r_sense_ohms: 0.075
        run_amps: 2.8
        hold_amps: 0.60
        microsteps: 16
        stallguard: 0
        stallguard_debug: false
        toff_disable: 0
        toff_stealthchop: 5
        toff_coolstep: 3
        run_mode: CoolStep
        homing_mode: CoolStep
        use_enable: true
        step_pin: gpio.12
        direction_pin: gpio.14
        disable_pin: NO_PIN

  y:
    steps_per_mm: 660.000
    max_rate_mm_per_min: 2500.000
    acceleration_mm_per_sec2: 250.000
    max_travel_mm: 900.000
    soft_limits: false
    homing:
      cycle: 2
      positive_direction: false
      mpos_mm: 150.000
      feed_mm_per_min: 100.000
      seek_mm_per_min: 200.000
      seek_scaler: 1.100
      feed_scaler: 1.100

    motor0:
      limit_neg_pin: gpio.34:low
      limit_pos_pin: NO_PIN
      limit_all_pin: NO_PIN
      hard_limits: false
      pulloff_mm: 1.000
      tmc_5160:
        spi_index: 2
        r_sense_ohms: 0.075
        run_amps: 3.0
        hold_amps: 0.60
        microsteps: 16
        stallguard: 0
        stallguard_debug: false
        toff_disable: 0
        toff_stealthchop: 5
        toff_coolstep: 3
        run_mode: CoolStep
        homing_mode: CoolStep
        use_enable: true
        step_pin: gpio.27
        direction_pin: gpio.26
        disable_pin: NO_PIN

  a:
    steps_per_mm: 800.000
    max_rate_mm_per_min: 9000.000
    acceleration_mm_per_sec2: 250.000
    max_travel_mm: 900.000
    soft_limits: false
    homing:
      cycle: 2
      positive_direction: true
      mpos_mm: 150.000
      feed_mm_per_min: 100.000
      seek_mm_per_min: 200.000
      seek_scaler: 1.100
      feed_scaler: 1.100

    motor0:
      limit_neg_pin: gpio.36:low
      limit_pos_pin: NO_PIN
      limit_all_pin: NO_PIN
      hard_limits: false
      pulloff_mm: 1.000
      tmc_5160:
        cs_pin: NO_PIN
        spi_index: 3
        r_sense_ohms: 0.075
        run_amps: 2.8
        hold_amps: 0
        microsteps: 16
        stallguard: 0
        stallguard_debug: false
        toff_disable: 0
        toff_stealthchop: 5
        toff_coolstep: 3
        run_mode: CoolStep
        homing_mode: CoolStep
        use_enable: true
        step_pin: gpio.33
        direction_pin: gpio.32
        disable_pin: NO_PIN

  z:
    steps_per_mm: 800.000
    max_rate_mm_per_min: 4000.000
    acceleration_mm_per_sec2: 250.000
    max_travel_mm: 400.000
    soft_limits: false
    homing:
      cycle: 1
      positive_direction: true
      mpos_mm: 150.000
      feed_mm_per_min: 100.000
      seek_mm_per_min: 800.000
      seek_scaler: 1.100
      feed_scaler: 1.100

    motor0:
      limit_neg_pin: gpio.39:low
      limit_pos_pin: NO_PIN
      limit_all_pin: NO_PIN
      hard_limits: false
      pulloff_mm: 1.000
      tmc_5160:
        cs_pin: NO_PIN
        spi_index: 4
        r_sense_ohms: 0.075
        run_amps: 2.8
        hold_amps: 0.60
        microsteps: 16
        stallguard: 0
        stallguard_debug: false
        toff_disable: 0
        toff_stealthchop: 5
        toff_coolstep: 3
        run_mode: CoolStep
        homing_mode: CoolStep
        use_enable: true
        step_pin: gpio.15
        direction_pin: gpio.2
        disable_pin: NO_PIN

coolant:
  flood_pin: NO_PIN
  mist_pin: gpio.21
  delay_ms: 0

i2so:
  bck_pin: NO_PIN
  data_pin: NO_PIN
  ws_pin: NO_PIN

spi:
  miso_pin: gpio.19
  mosi_pin: gpio.23
  sck_pin: gpio.18

sdcard:
  card_detect_pin: NO_PIN
  cs_pin: gpio.5

control:
  safety_door_pin: gpio.16:low
  reset_pin: NO_PIN
  feed_hold_pin: NO_PIN
  cycle_start_pin: NO_PIN
  macro0_pin: gpio.13:low
  macro1_pin: gpio.0:low
  macro2_pin: NO_PIN
  macro3_pin: NO_PIN

probe:
  pin: gpio.22:low
  check_mode_start: false

macros:
  startup_line0:
  startup_line1:
  macro0:
  macro1:
  macro2:
  macro3:

user_outputs:
  analog0_pin: NO_PIN
  analog1_pin: NO_PIN
  analog2_pin: NO_PIN
  analog3_pin: NO_PIN
  analog0_hz: 5000
  analog1_hz: 5000
  analog2_hz: 5000
  analog3_hz: 5000
  digital0_pin: NO_PIN
  digital1_pin: NO_PIN
  digital2_pin: NO_PIN
  digital3_pin: NO_PIN

start:
  must_home: false

10V:
  forward_pin: NO_PIN
  reverse_pin: NO_PIN
  pwm_hz: 5000
  output_pin: gpio.25
  enable_pin: gpio.4
  direction_pin: NO_PIN
  disable_with_s0: false
  s0_with_disable: true
  spinup_ms: 0
  spindown_ms: 0
  tool_num: 0
  speed_map: 0=0.000% 1000=0.000% 24000=100.000%

```

Closed 2021-11-02.

Thread 81 (2021-11-08):

48V for tmc5160

ahedderich, 2021-11-08:
Hi,
is in any way possible with the current hardware and maybe some "hacking" to supply the trinamic drivers with a 48V input power, to drive higher impedance motors with higher speeds?
when opening up the top panel i don't see an easy way to get to the bottom part of the board.
is the bottom panel glued in place?

Spark-Concepts, 2021-11-13:
Hi Ahedderich, currently there is no easy way to split the motor voltage and the operating voltage.  It could be done but would require extensive modification to the controller.  The top board is held in place with 3 locking standoffs, you can see the white locking tips protruding through the top board.   Pinch the tops of these and pull the top board up out of the case (takes some wiggling to the the power switch out - also make sure ALL of the pluggable headers and the SD card are removed).  The bottom board is then held in with screws.

ahedderich, 2021-11-15:
i think that is a non starter. that seems to be too much hacking to make it work.

Closed 2021-11-15.

Thread 82 (2021-11-10):

Y Axis Trouble

Accufactor, 2021-11-10:
I seem to have a serious problem with the y axis, I have 1 wired into the Y port and 1 wired into the A/Y2. When I started a small job to test the machine for the first time, it ran for about 30 minutes just fine, then whenever the Y's had to move it made a horrible noise, I stopped the job with the estop, and tried to investigate the problem. Turns out the y axis is no longer moving in unison, one side seems to move before the other and it causes it to skew, I thought it might have had something to do with the machine not being square as it lifted at 1 point as I was trying to move the axis. So 1 rebuild later and the problem still persists, we even swapped out the stepper motor on that 1 side that is moving delayed to the other 1 and it still no change, I thought it might have been a setting so I updated with fresh firmware and used the $RST=* command still no luck.

Mawg1, 2021-11-11:
Hi Accufactor, Sorry to hear there is trouble.  Could you confirm that both motors are spinning but one is lagging the other?  Is the delay following the motor or the xPRO port when you swapped sides?

Accufactor, 2021-11-11:
it turns out that it is the Y port, not the A/Y2 port on the xpro v5, I did a simple test of disconnecting the leadscrew from the coupler to the stepper motor and attached some tape to the coupler to watch which direction, turns out the A/Y2 works as intended, however, the Y port attempts to work, then sort of freezes and tries to start again for the duration of the steps, I tested it multiple times with a single stepper motor to remove any uncertainty. For example if i decided i wanted to step the A/Y2 by 10 it would rotate smoothly, however the Y port would make a horrible noise like it is fighting itself and not moving.

Spark-Concepts, 2021-11-13:
Thanks for testing!  Let's get this fixed up, could you submit a contact form with order and shipping info  - [https://www.spark-concepts.com/contact-us-1/](https://www.spark-concepts.com/contact-us-1/)

Accufactor, 2021-11-13:
I have submitted the form and await your reply

Closed 2021-11-27.

Thread 85 (2021-11-18):

Y2 Limit Switch not registering

ausip, 2021-11-18:
I have an XYYZ machine with 24V NC limit switches on each axis, and limit switches on the both the Y Axis rails.

Y1 limit switch is working perfectly. Y2 is not registering. Below is my initialisation macro for CNC.JS

$Homing/Cycle0=Z
$Homing/Cycle1=X
$Homing/Cycle2=Y
$Stepper/Pulse=5
$Stepper/IdleTime=255
$Stepper/DirInvert=Y
$Stepper/EnableInvert=Off
$Limits/Invert=On
$Probe/Invert=Off
$Report/Status=1
$Limits/Hard=On
$Homing/Enable=On
$Homing/DirInvert=X
$Homing/Squared=Y
$Homing/Feed=100.000
$Homing/Seek=1000.000
$Homing/Pulloff=5.000
$X/StepsPerMm=200.000
$Y/StepsPerMm=200.000
$Z/StepsPerMm=200.000
$A/StepsPerMm=200.000
$X/MaxRate=3000.000
$Y/MaxRate=3000.000
$Z/MaxRate=2500.000
$A/MaxRate=3000.000
$X/Acceleration=150.000
$Y/Acceleration=150.000
$Z/Acceleration=150.000
$A/Acceleration=150.000
$X/MaxTravel=1250.00
$Y/MaxTravel=810.00
$Z/MaxTravel=210.00
$A/MaxTravel=810.00
$X/Current/Run=1.950
$Y/Current/Run=1.950
$Z/Current/Run=1.950
$A/Current/Run=1.950
$X/Current/Hold=1.250
$Y/Current/Hold=1.250
$Z/Current/Hold=1.250
$A/Current/Hold=1.250
$X/Microsteps=8
$Y/Microsteps=8
$Z/Microsteps=8
$A/Microsteps=8

Mboss32, 2021-11-23:
In the default firmware the Y2 limit is not active, this is to match most kit setups that run a single Y limit with either NO or NC.

The Y2 can be turned on by uncommenting it in the Machine file and compiling new firmware.   https://github.com/Spark-Concepts/xPro-V5-Firmware

ausip, 2021-11-23:
Thanks for the response. I have had a look through the following file and can't seem to find which commented line relates to the A or Y2 limit switch.

xPro-V5-Firmware/CNCxPROv5_20210708/src/Machines/CNC_xPRO_V5_Machine_Template.h

Is this the correct file?
Please specify which file and which line of code I need to remove the comment on?

Thanks

Mboss32, 2021-11-23:
That's correct,  change the A_Limit_pin declaration to Y2_LIMIT_PIN

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

ausip, 2021-11-23:
Thanks, I'll give it a go. Slightly off topic.

If I am using a Folinn VFD and wish to use RS485, do I need to make changes to this section when re-compiling? Or can this be taken care of using my initialisation script?

/*********** Spindle Setup******************/
//Default: PWM spindle control
#define SPINDLE_TYPE            SpindleType::PWM
#define SPINDLE_OUTPUT_PIN      GPIO_NUM_25
#define SPINDLE_ENABLE_PIN      GPIO_NUM_4
#define DEFAULT_SPINDLE_RPM_MAX     12000

//Option: RS485 spindle - comment out the PWM spindle block above, uncomment the below block .
//#define SPINDLE_TYPE            SpindleType::H2A // only one spindle at a time (HuanYang, YL620, or H2A)
//#define VFD_RS485_TXD_PIN		GPIO_NUM_4
//#define VFD_RS485_RXD_PIN		GPIO_NUM_25
//#define DEFAULT_SPINDLE_RPM_MAX     24000
/********************************************/

ausip, 2021-11-24:
Hi @Mboss32

I compiled the new firmware, but I had to use PlatformIO, as I was getting compiling errors in Arduino IDE.

The firmware compiled correctly and I have Y2 working perfectly. Now unfortunately when I fire up the spindle using an M3 command the console loops with a ton of messages and I cannot stop the spindle using an M5, I have to his the eStop. The only source change I made was changing the LimitSwitch from A to Y2 & changing the eStop from NO to NC.

Below is my initialization script I am running in CNC.JS and an extract of the console loop after running the M3 command. Using the pre-compiled firmware the spindle works perfectly.

CNC.JS init macro
`$Homing/Cycle0=Z
$Homing/Cycle1=X
$Homing/Cycle2=Y
$Stepper/Pulse=5
$Stepper/IdleTime=255
$Stepper/DirInvert=Y
$Stepper/EnableInvert=Off
$Limits/Invert=On
$Probe/Invert=On
$Report/Status=1
$Limits/Hard=On
$Homing/Enable=On
$Homing/DirInvert=X
$Homing/Squared=Y
$Homing/Feed=100.000
$Homing/Seek=1000.000
$Homing/Pulloff=5.000
$X/StepsPerMm=200.000
$Y/StepsPerMm=200.000
$Z/StepsPerMm=200.000
$A/StepsPerMm=200.000
$X/MaxRate=3000.000
$Y/MaxRate=3000.000
$Z/MaxRate=2500.000
$A/MaxRate=3000.000
$X/Acceleration=150.000
$Y/Acceleration=150.000
$Z/Acceleration=150.000
$A/Acceleration=150.000
$X/MaxTravel=1250.00
$Y/MaxTravel=810.00
$Z/MaxTravel=210.00
$A/MaxTravel=810.00
$X/Current/Run=1.950
$Y/Current/Run=1.950
$Z/Current/Run=1.950
$A/Current/Run=1.950
$X/Current/Hold=1.250
$Y/Current/Hold=1.250
$Z/Current/Hold=1.250
$A/Current/Hold=1.250
$X/Microsteps=8
$Y/Microsteps=8
$Z/Microsteps=8
$A/Microsteps=8
$Spindle/Type=PWM
$GCode/MaxS=24000
$GCode/MinS=8000`

Console log after running M3
`EXCVADDR: 0x00000000  LBEG    : 0x400014fd  LEND    : 0x4000150d  LCOUNT  : 0xfffffff7
Core 1 was running in ISR context:
EPC1    : 0x400912ce  EPC2    : 0x00000000  EPC3    : 0x00000000  EPC4    : 0x40092d48
Backtrace: 0x40092d48:0x3ffbe560 0x40091f20:0x3ffbe580 0x40090087:0x3ffbe5a0 0x4018bf61:0x3ffbe5e0 0x4018ca35:0x3ffbe620 0x400dfe6d:0x3ffbe650 0x400dacf2:0x3ffbe670 0x400d938e:0x3ffbe690 0x400d943e:0x3ffbe730 0x400dfbd2:0x3ffbe7f0 0x400dfceb:0x3ffbe920 0x400823c4:0x3ffbe940 0x400824c1:0x3ffbe960 0x40085e01:0x3ffbe980 0x40221cf7:0x3ffbda00 0x400fef4a:0x3ffbda20 0x40091b99:0x3ffbda40 0x400902d9:0x3ffbda60
Core 0 register dump:
PC      : 0x400912d9  PS      : 0x00060034  A0      : 0x80091bd1  A1      : 0x3ffbe300
A2      : 0x3ffbf658  A3      : 0x0000cdcd  A4      : 0xb33fffff  A5      : 0x00000001
A6      : 0x00060021  A7      : 0x0000abab  A8      : 0x0000abab  A9      : 0x3ffc9664
A10     : 0x00000003  A11     : 0x00060023  A12     : 0x00060021  A13     : 0x00000001
A14     : 0x00060520  A15     : 0x00000000  SAR     : 0x0000001d  EXCCAUSE: 0x00000006
EXCVADDR: 0x00000000  LBEG    : 0x00000000  LEND    : 0x00000000  LCOUNT  : 0x00000000
Backtrace: 0x400912d9:0x3ffbe300 0x40091bce:0x3ffbe330 0x400903c7:0x3ffbe350 0x40092bb9:0x3ffbe370 0x40085e0a:0x3ffbe380 0x40221cf7:0x3ffbd470 0x400fef4a:0x3ffbd490 0x40091b99:0x3ffbd4b0 0x400902d9:0x3ffbd4d0
Rebooting...
ets Jun  8 2016 00:22:57
rst:0xc (SW_CPU_RESET),boot:0x13 (SPI_FAST_FLASH_BOOT)
configsip: 0, SPIWP:0xee
clk_drv:0x00,q_drv:0x00,d_drv:0x00,cs0_drv:0x00,hd_drv:0x00,wp_drv:0x00
mode:DIO, clock div:1
load:0x3fff0018,len:4
load:0x3fff001c,len:1216
ho 0 tail 12 room 4
load:0x40078000,len:9720
ho 0 tail 12 room 4
load:0x40080400,len:6352
entry 0x400806b8
[MSG:Grbl_ESP32 Ver 1.3a Date 20210424]
[MSG:Compiled with ESP32 SDK:v3.2.3-14-gd3e562907]
[MSG:Using machine:CNC_xPRO_V5_Machine_Template]
[MSG:Axis count 3]
[MSG:RMT Steps]
[MSG:Door switch on pin GPIO(16)]
[MSG:Macro Pin 0 GPIO(13)]
[MSG:Macro User/Macro0 empty]
[MSG:MGuru Meditation Error: Core  1 panic'ed (Interrupt wdt timeout on CPU1)
Core 1 register dump:
PC      : 0x40092d42  PS      : 0x00060534  A0      : 0x80091f23  A1      : 0x3ffbe560
A2      : 0x3ffbbc7c  A3      : 0x3ffbb9f0  A4      : 0x00000001  A5      : 0x00000001
A6      : 0x00060523  A7      : 0x00000000  A8      : 0x3ffbb9f0  A9      : 0x3ffbb9f0
A10     : 0x00000018  A11     : 0x00000018  A12     : 0x00000001  A13     : 0x00000001
A14     : 0x00060521  A15     : 0x00000000  SAR     : 0x00000000  EXCCAUSE: 0x00000006
EXCVADDR: 0x00000000  LBEG    : 0x400014fd  LEND    : 0x4000150d  LCOUNT  : 0xfffffff7
Core 1 was running in ISR context:
EPC1    : 0x400912ce  EPC2    : 0x00000000  EPC3    : 0x00000000  EPC4    : 0x40092d42
Backtrace: 0x40092d42:0x3ffbe560 0x40091f20:0x3ffbe580 0x40090087:0x3ffbe5a0 0x4018c014:0x3ffbe5e0 0x4018ca35:0x3ffbe620 0x400dfe6d:0x3ffbe650 0x400dacf2:0x3ffbe670 0x400d938e:0x3ffbe690 0x400d943e:0x3ffbe730 0x400dfbd2:0x3ffbe7f0 0x400dfceb:0x3ffbe920 0x400823c4:0x3ffbe940 0x400824c1:0x3ffbe960 0x40085e01:0x3ffbe980 0x400824a1:0x3ffd3380 0x400d6a7e:0x3ffd33a0 0x400df837:0x3ffd33e0 0x400d4727:0x3ffd3410 0x400d2d8b:0x3ffd3430 0x400fbdcb:0x3ffd3450 0x400902d9:0x3ffd3470
Core 0 register dump:
PC      : 0x400912d9  PS      : 0x00060034  A0      : 0x80091bd1  A1      : 0x3ffbe300
A2      : 0x3ffbf658  A3      : 0x0000cdcd  A4      : 0xb33fffff  A5      : 0x00000001
A6      : 0x00060021  A7      : 0x0000abab  A8      : 0x0000abab  A9      : 0x3ffc9664
A10     : 0x00000003  A11     : 0x00060023  A12     : 0x00060021  A13     : 0x00000001
A14     : 0x00060520  A15     : 0x00000000  SAR     : 0x0000001d  EXCCAUSE: 0x00000006
EXCVADDR: 0x00000000  LBEG    : 0x00000000  LEND    : 0x00000000  LCOUNT  : 0x00000000
Backtrace: 0x400912d9:0x3ffbe300 0x40091bce:0x3ffbe330 0x400903c7:0x3ffbe350 0x40092bb9:0x3ffbe370 0x40085e0a:0x3ffbe380 0x40221cf7:0x3ffbd470 0x400fef4a:0x3ffbd490 0x40091b99:0x3ffbd4b0 0x400902d9:0x3ffbd4d0
Rebooting...
ets Jun  8 2016 00:22:57
rst:0xc (SW_CPU_RESET),boot:0x13 (SPI_FAST_FLASH_BOOT)
configsip: 0, SPIWP:0xee
clk_drv:0x00,q_drv:0x00,d_drv:0x00,cs0_drv:0x00,hd_drv:0x00,wp_drv:0x00
mode:DIO, clock div:1
load:0x3fff0018,len:4
load:0x3fff001c,len:1216
ho 0 tail 12 room 4
load:0x40078000,len:9720
ho 0 tail 12 room 4
load:0x40080400,len:6352
entry 0x400806b8
[MSG:Grbl_ESP32 Ver 1.3a Date 20210424]
[MSG:Compiled with ESP32 SDK:v3.2.3-14-gd3e562907]
[MSG:Using machine:CNC_xPRO_V5_Machine_Template]
[MSG:Axis count 3]
[MSG:RMT Steps]
[MSG:Door switch on pin GPIO(16)]
[MSG:Macro Pin 0 GPIO(13)]
[MSG:Macro Pin 1 GPIO(0)]
[MSG:Init MGuru Meditation Error: Core  1 panic'ed (Interrupt wdt timeout on CPU1)
Core 1 register dump:
PC      : 0x40092d42  PS      : 0x00060f34  A0      : 0x80091f23  A1      : 0x3ffbe560
A2      : 0x3ffd3564  A3      : 0x3ffd0200  A4      : 0x00000001  A5      : 0x00000001
A6      : 0x00060f23  A7      : 0x00000000  A8      : 0x3ffd0200  A9      : 0x3ffd0200
A10     : 0x00000019  A11     : 0x00000019  A12     : 0x00000001  A13     : 0x00000001
A14     : 0x00060f21  A15     : 0x00000000  SAR     : 0x00000000  EXCCAUSE: 0x00000006
EXCVADDR: 0x00000000  LBEG    : 0x400014fd  LEND    : 0x4000150d  LCOUNT  : 0xfffffff7
Core 1 was running in ISR context:
EPC1    : 0x400912ce  EPC2    : 0x00000000  EPC3    : 0x00000000  EPC4    : 0x40092d42
Backtrace: 0x40092d42:0x3ffbe560 0x40091f20:0x3ffbe580 0x40090087:0x3ffbe5a0 0x4018bf61:0x3ffbe5e0 0x4018ca35:0x3ffbe620 0x400dfe6d:0x3ffbe650 0x400dacf2:0x3ffbe670 0x400d938e:0x3ffbe690 0x400d943e:0x3ffbe730 0x400dfbd2:0x3ffbe7f0 0x400dfceb:0x3ffbe920 0x400823c4:0x3ffbe940 0x400824c1:0x3ffbe960 0x40085e01:0x3ffbe980 0x40221cf7:0x3ffbda00 0x400fef4a:0x3ffbda20 0x40091b99:0x3ffbda40 0x400902d9:0x3ffbda60
Core 0 register dump:
PC      : 0x400912ce  PS      : 0x00060034  A0      : 0x80091bd1  A1      : 0x3ffbe300
A2      : 0x3ffbf658  A3      : 0x0000cdcd  A4      : 0xb33fffff  A5      : 0x00000001
A6      : 0x00060021  A7      : 0x0000abab  A8      : 0x0000abab  A9      : 0x3ffc9664
A10     : 0x00000003  A11     : 0x00060023  A12     : 0x00060021  A13     : 0x00000001
A14     : 0x00400000  A15     : 0x00000000  SAR     : 0x0000001d  EXCCAUSE: 0x00000006
EXCVADDR: 0x00000000  LBEG    : 0x00000000  LEND    : 0x00000000  LCOUNT  : 0x00000000
Backtrace: 0x400912ce:0x3ffbe300 0x40091bce:0x3ffbe330 0x400903c7:0x3ffbe350 0x40092bb9:0x3ffbe370 0x40085e0a:0x3ffbe380 0x40221cf7:0x3ffbd470 0x400fef4a:0x3ffbd490 0x40091b99:0x3ffbd4b0 0x400902d9:0x3ffbd4d0
Rebooting...
ets Jun  8 2016 00:22:57
rst:0xc (SW_CPU_RESET),boot:0x13 (SPI_FAST_FLASH_BOOT)
configsip: 0, SPIWP:0xee
clk_drv:0x00,q_drv:0x00,d_drv:0x00,cs0_drv:0x00,hd_drv:0x00,wp_drv:0x00
mode:DIO, clock div:1
load:0x3fff0018,len:4
load:0x3fff001c,len:1216
ho 0 tail 12 room 4
load:0x40078000,len:9720
ho 0 tail 12 room 4
load:0x40080400,len:6352
entry 0x400806b8
[MSG:Grbl_ESP32 Ver 1.3a Date 20210424]
[MSG:Compiled with ESP32 SDK:v3.2.3-14-gd3e562907]
[MSG:Using machine:CNC_xPRO_V5_Machine_Template]
[MSG:Axis count 3]
[MSG:RMT Steps]
[MSG:Door switch on pin GPIO(16)]
[MSG:Macro Pin 0 GPIO(13)]
[MSG:Macro Pin 1 GPIO(0)]
[MSG:Init MGuru Meditation Error: Core  1 panic'ed (Interrupt wdt timeout on CPU1)
Core 1 register dump:
PC      : 0x40092d42  PS      : 0x00060f34  A0      : 0x80091f23  A1      : 0x3ffbe560
A2      : 0x3ffbbe00  A3      : 0x3ffd0200  A4      : 0x00000001  A5      : 0x00000001
A6      : 0x00060f23  A7      : 0x00000000  A8      : 0x3ffd0200  A9      : 0x3ffd0200
A10     : 0x00000019  A11     : 0x00000019  A12     : 0x00000001  A13     : 0x00000001
A14     : 0x00060f21  A15     : 0x00000000  SAR     : 0x00000000  EXCCAUSE: 0x00000006
EXCVADDR: 0x00000000  LBEG    : 0x400014fd  LEND    : 0x4000150d  LCOUNT  : 0xfffffff7
Core 1 was running in ISR context:
EPC1    : 0x400912ce  EPC2    : 0x00000000  EPC3    : 0x00000000  EPC4    : 0x40092d42
Backtrace: 0x40092d42:0x3ffbe560 0x40091f20:0x3ffbe580 0x40090087:0x3ffbe5a0 0x4018bf61:0x3ffbe5e0 0x4018ca35:0x3ffbe620 0x400dfe6d:0x3ffbe650 0x400dacf2:0x3ffbe670 0x400d938e:0x3ffbe690 0x400d943e:0x3ffbe730 0x400dfbd2:0x3ffbe7f0 0x400dfceb:0x3ffbe920 0x400823c4:0x3ffbe940 0x400824c1:0x3ffbe960 0x40085e01:0x3ffbe980 0x40221cf7:0x3ffbda00 0x400fef4a:0x3ffbda20 0x40091b99:0x3ffbda40 0x400902d9:0x3ffbda60
Core 0 register dump:
PC      : 0x400912d6  PS      : 0x00060034  A0      : 0x80091bd1  A1      : 0x3ffbe300
A2      : 0x3ffbf658  A3      : 0x0000cdcd  A4      : 0xb33fffff  A5      : 0x00000001
A6      : 0x00060021  A7      : 0x0000abab  A8      : 0x0000cdcd  A9      : 0x3ffc9664
A10     : 0x00000003  A11     : 0x00060023  A12     : 0x00060021  A13     : 0x00000001
A14     : 0x00060520  A15     : 0x00000000  SAR     : 0x0000001d  EXCCAUSE: 0x00000006
EXCVADDR: 0x00000000  LBEG    : 0x00000000  LEND    : 0x00000000  LCOUNT  : 0x00000000
Backtrace: 0x400912d6:0x3ffbe300 0x40091bce:0x3ffbe330 0x400903c7:0x3ffbe350 0x40092bb9:0x3ffbe370 0x40085e0a:0x3ffbe380 0x40221cf7:0x3ffbd470 0x400fef4a:0x3ffbd490 0x40091b99:0x3ffbd4b0 0x400902d9:0x3ffbd4d0
Rebooting...
ets Jun  8 2016 00:22:57
rst:0xc (SW_CPU_RESET),boot:0x13 (SPI_FAST_FLASH_BOOT)
configsip: 0, SPIWP:0xee
clk_drv:0x00,q_drv:0x00,d_drv:0x00,cs0_drv:0x00,hd_drv:0x00,wp_drv:0x00
mode:DIO, clock div:1
load:0x3fff0018,len:4
load:0x3fff001c,len:1216
ho 0 tail 12 room 4
load:0x40078000,len:9720
ho 0 tail 12 room 4
load:0x40080400,len:6352
entry 0x400806b8
[MSG:Grbl_ESP32 Ver 1.3a Date 20210424]
[MSG:Compiled with ESP32 SDK:v3.2.3-14-gd3e562907]
[MSG:Using machine:CNC_xPRO_V5_Machine_Template]
[MSG:Axis count 3]
[MSG:RMT Steps]
[MSG:Door switch on pin GPIO(16)]
[MSG:Macro Pin 0 GPIO(13)]
[MSG:Macro User/Macro0 empty]
[MSG:MaGuru Meditation Error: Core  1 panic'ed (Interrupt wdt timeout on CPU1)
Core 1 register dump:
PC      : 0x40092d42  PS      : 0x00060f34  A0      : 0x80091f23  A1      : 0x3ffbe560
A2      : 0x3ffbbe00  A3      : 0x3ffd0200  A4      : 0x00000001  A5      : 0x00000001
A6      : 0x00060f23  A7      : 0x00000000  A8      : 0x3ffd0200  A9      : 0x3ffd0200
A10     : 0x00000019  A11     : 0x00000019  A12     : 0x00000001  A13     : 0x00000001
A14     : 0x00060f21  A15     : 0x00000000  SAR     : 0x00000000  EXCCAUSE: 0x00000006
EXCVADDR: 0x00000000  LBEG    : 0x400014fd  LEND    : 0x4000150d  LCOUNT  : 0xfffffff7
Core 1 was running in ISR context:
EPC1    : 0x400912ce  EPC2    : 0x00000000  EPC3    : 0x00000000  EPC4    : 0x40092d42
Backtrace: 0x40092d42:0x3ffbe560 0x40091f20:0x3ffbe580 0x40090087:0x3ffbe5a0 0x4018bf61:0x3ffbe5e0 0x4018ca35:0x3ffbe620 0x400dfe6d:0x3ffbe650 0x400dacf2:0x3ffbe670 0x400d938e:0x3ffbe690 0x400d943e:0x3ffbe730 0x400dfbd2:0x3ffbe7f0 0x400dfceb:0x3ffbe920 0x400823c4:0x3ffbe940 0x400824c1:0x3ffbe960 0x40085e01:0x3ffbe980 0x40221cf7:0x3ffbda00 0x400fef4a:0x3ffbda20 0x40091b99:0x3ffbda40 0x400902d9:0x3ffbda60
Core 0 register dump:
PC      : 0x400912ce  PS      : 0x00060034  A0      : 0x80091bd1  A1      : 0x3ffbe300
A2      : 0x3ffbf658  A3      : 0x0000cdcd  A4      : 0xb33fffff  A5      : 0x00000001
A6      : 0x00060021  A7      : 0x0000abab  A8      : 0x0000abab  A9      : 0x3ffc9664
A10     : 0x00000003  A11     : 0x00060023  A12     : 0x00060021  A13     : 0x00000001
A14     : 0x00060520  A15     : 0x00000000  SAR     : 0x0000001d  EXCCAUSE: 0x00000006
EXCVADDR: 0x00000000  LBEG    : 0x00000000  LEND    : 0x00000000  LCOUNT  : 0x00000000
Backtrace: 0x400912ce:0x3ffbe300 0x40091bce:0x3ffbe330 0x400903c7:0x3ffbe350 0x40092bb9:0x3ffbe370 0x40085e0a:0x3ffbe380 0x40221cf7:0x3ffbd470 0x400fef4a:0x3ffbd490 0x40091b99:0x3ffbd4b0 0x400902d9:0x3ffbd4d0
Rebooting...
ets Jun  8 2016 00:22:57
rst:0xc (SW_CPU_RESET),boot:0x13 (SPI_FAST_FLASH_BOOT)
configsip: 0, SPIWP:0xee
clk_drv:0x00,q_drv:0x00,d_drv:0x00,cs0_drv:0x00,hd_drv:0x00,wp_drv:0x00
mode:DIO, clock div:1
load:0x3fff0018,len:4
load:0x3fff001c,len:1216
ho 0 tail 12 room 4
load:0x40078000,len:9720
ho 0 tail 12 room 4
load:0x40080400,len:6352
entry 0x400806b8
[MSG:Grbl_ESP32 Ver 1.3a Date 20210424]
[MSG:Compiled with ESP32 SDK:v3.2.3-14-gd3e562907]
[MSG:Using machine:CNC_xPRO_V5_Machine_Template]
[MSG:Axis count 3]
[MSG:RMT Steps]
[MSG:Door switch on pin GPIO(16)]
[MSG:Macro Pin 0 GPIO(13)]
[MSG:Macro User/Macro0 empty]
[MSG:MGuru Meditation Error: Core  1 panic'ed (Interrupt wdt timeout on CPU1)
Core 1 register dump:
PC      : 0x40092d48  PS      : 0x00060f34  A0      : 0x80091f23  A1      : 0x3ffbe560
A2      : 0x3ffbbe00  A3      : 0x3ffd0200  A4      : 0x00000001  A5      : 0x00000001
A6      : 0x00060f23  A7      : 0x00000000  A8      : 0x3ffd0200  A9      : 0x3ffd0200
A10     : 0x00000019  A11     : 0x00000019  A12     : 0x00000001  A13     : 0x00000001
A14     : 0x00060f21  A15     : 0x00000000  SAR     : 0x00000000  EXCCAUSE: 0x00000006
EXCVADDR: 0x00000000  LBEG    : 0x400014fd  LEND    : 0x4000150d  LCOUNT  : 0xfffffff7
Core 1 was running in ISR context:
EPC1    : 0x400912ce  EPC2    : 0x00000000  EPC3    : 0x00000000  EPC4    : 0x40092d48
Backtrace: 0x40092d48:0x3ffbe560 0x40091f20:0x3ffbe580 0x40090087:0x3ffbe5a0 0x4018bf61:0x3ffbe5e0 0x4018ca35:0x3ffbe620 0x400dfe6d:0x3ffbe650 0x400dacf2:0x3ffbe670 0x400d938e:0x3ffbe690 0x400d943e:0x3ffbe730 0x400dfbd2:0x3ffbe7f0 0x400dfceb:0x3ffbe920 0x400823c4:0x3ffbe940 0x400824c1:0x3ffbe960 0x40085e01:0x3ffbe980 0x40221cf7:0x3ffbda00 0x400fef4a:0x3ffbda20 0x40091b99:0x3ffbda40 0x400902d9:0x3ffbda60
Core 0 register dump:
PC      : 0x400912d9  PS      : 0x00060034  A0      : 0x80091bd1  A1      : 0x3ffbe300
A2      : 0x3ffbf658  A3      : 0x0000cdcd  A4      : 0xb33fffff  A5      : 0x00000001
A6      : 0x00060021  A7      : 0x0000abab  A8      : 0x0000abab  A9      : 0x3ffc9664
A10     : 0x00000003  A11     : 0x00060023  A12     : 0x00060021  A13     : 0x00000001
A14     : 0x00060520  A15     : 0x00000000  SAR     : 0x0000001d  EXCCAUSE: 0x00000006
EXCVADDR: 0x00000000  LBEG    : 0x00000000  LEND    : 0x00000000  LCOUNT  : 0x00000000
Backtrace: 0x400912d9:0x3ffbe300 0x40091bce:0x3ffbe330 0x400903c7:0x3ffbe350 0x40092bb9:0x3ffbe370 0x40085e0a:0x3ffbe380 0x40221cf7:0x3ffbd470 0x400fef4a:0x3ffbd490 0x40091b99:0x3ffbd4b0 0x400902d9:0x3ffbd4d0
Rebooting...
ets Jun  8 2016 00:22:57
rst:0xc (SW_CPU_RESET),boot:0x13 (SPI_FAST_FLASH_BOOT)
configsip: 0, SPIWP:0xee
clk_drv:0x00,q_drv:0x00,d_drv:0x00,cs0_drv:0x00,hd_drv:0x00,wp_drv:0x00
mode:DIO, clock div:1
load:0x3fff0018,len:4
load:0x3fff001c,len:1216
ho 0 tail 12 room 4
load:0x40078000,len:9720
ho 0 tail 12 room 4
load:0x40080400,len:6352
entry 0x400806b8
[MSG:Grbl_ESP32 Ver 1.3a Date 20210424]
[MSG:Compiled with ESP32 SDK:v3.2.3-14-gd3e562907]
[MSG:Using machine:CNC_xPRO_V5_Machine_Template]
[MSG:Axis count 3]
[MSG:RMT Steps]
[MSG:Door switch on pin GPIO(16)]
[MSG:Macro Pin 0 GPIO(13)]
[MSG:Macro User/Macro0 empty]
[MSG:MGuru Meditation Error: Core  1 panic'ed (Interrupt wdt timeout on CPU1)
Core 1 register dump:
PC      : 0x40092d42  PS      : 0x00060f34  A0      : 0x80091f23  A1      : 0x3ffbe560
A2      : 0x3ffd3564  A3      : 0x3ffd0200  A4      : 0x00000001  A5      : 0x00000001
A6      : 0x00060f23  A7      : 0x00000000  A8      : 0x3ffd0200  A9      : 0x3ffd0200
A10     : 0x00000019  A11     : 0x00000019  A12     : 0x00000001  A13     : 0x00000001
A14     : 0x00060f21  A15     : 0x00000000  SAR     : 0x00000000  EXCCAUSE: 0x00000006
EXCVADDR: 0x00000000  LBEG    : 0x400014fd  LEND    : 0x4000150d  LCOUNT  : 0xfffffff7
Core 1 was running in ISR context:
EPC1    : 0x400912ce  EPC2    : 0x00000000  EPC3    : 0x00000000  EPC4    : 0x40092d42
Backtrace: 0x40092d42:0x3ffbe560 0x40091f20:0x3ffbe580 0x40090087:0x3ffbe5a0 0x4018bf61:0x3ffbe5e0 0x4018ca35:0x3ffbe620 0x400dfe6d:0x3ffbe650 0x400dacf2:0x3ffbe670 0x400d938e:0x3ffbe690 0x400d943e:0x3ffbe730 0x400dfbd2:0x3ffbe7f0 0x400dfceb:0x3ffbe920 0x400823c4:0x3ffbe940 0x400824c1:0x3ffbe960 0x40085e01:0x3ffbe980 0x40221cf7:0x3ffbda00 0x400fef4a:0x3ffbda20 0x40091b99:0x3ffbda40 0x400902d9:0x3ffbda60
Core 0 register dump:
PC      : 0x400912d6  PS      : 0x00060034  A0      : 0x80091bd1  A1      : 0x3ffbe300
A2      : 0x3ffbf658  A3      : 0x0000cdcd  A4      : 0xb33fffff  A5      : 0x00000001
A6      : 0x00060021  A7      : 0x0000abab  A8      : 0x0000cdcd  A9      : 0x3ffc9664
A10     : 0x00000003  A11     : 0x00060023  A12     : 0x00060021  A13     : 0x00000001
A14     : 0x00400000  A15     : 0x00000000  SAR     : 0x0000001d  EXCCAUSE: 0x00000006
EXCVADDR: 0x00000000  LBEG    : 0x00000000  LEND    : 0x00000000  LCOUNT  : 0x00000000
Backtrace: 0x400912d6:0x3ffbe300 0x40091bce:0x3ffbe330 0x400903c7:0x3ffbe350 0x40092bb9:0x3ffbe370 0x40085e0a:0x3ffbe380 0x40221cf7:0x3ffbd470 0x400fef4a:0x3ffbd490 0x40091b99:0x3ffbd4b0 0x400902d9:0x3ffbd4d0
Rebooting...
ets Jun  8 2016 00:22:57
rst:0xc (SW_CPU_RESET),boot:0x13 (SPI_FAST_FLASH_BOOT)
configsip: 0, SPIWP:0xee
clk_drv:0x00,q_drv:0x00,d_drv:0x00,cs0_drv:0x00,hd_drv:0x00,wp_drv:0x00
mode:DIO, clock div:1
load:0x3fff0018,len:4
load:0x3fff001c,len:1216
ho 0 tail 12 room 4
load:0x40078000,len:9720
ho 0 tail 12 room 4
load:0x40080400,len:6352
entry 0x400806b8
[MSG:Grbl_ESP32 Ver 1.3a Date 20210424]
[MSG:Compiled with ESP32 SDK:v3.2.3-14-gd3e562907]
[MSG:Using machine:CNC_xPRO_V5_Machine_Template]
[MSG:Axis count 3]
[MSG:RMT Steps]
[MSG:Door switch on pin GPIO(16)]
[MSG:Macro Pin 0 GPIO(13)]
[MSG:Macro User/Macro0 empty]
[MSG:MGuru Meditation Error: Core  1 panic'ed (Interrupt wdt timeout on CPU1)
Core 1 register dump:
PC      : 0x40092d46  PS      : 0x00060b34  A0      : 0x80091f23  A1      : 0x3ffbe560
A2      : 0x3ffbbd0c  A3      : 0x3ffbba80  A4      : 0x00000001  A5      : 0x00000001
A6      : 0x00060b23  A7      : 0x00000000  A8      : 0x3ffbba80  A9      : 0x3ffbba80
A10     : 0x00000018  A11     : 0x00000018  A12     : 0x00000001  A13     : 0x00000001
A14     : 0x00060b21  A15     : 0x00000000  SAR     : 0x00000000  EXCCAUSE: 0x00000006
EXCVADDR: 0x00000000  LBEG    : 0x400014fd  LEND    : 0x4000150d  LCOUNT  : 0xfffffff7
Core 1 was running in ISR context:
EPC1    : 0x400912ce  EPC2    : 0x00000000  EPC3    : 0x00000000  EPC4    : 0x40092d46
Backtrace: 0x40092d46:0x3ffbe560 0x40091f20:0x3ffbe580 0x40090087:0x3ffbe5a0 0x4018c014:0x3ffbe5e0 0x4018ca35:0x3ffbe620 0x400dfe6d:0x3ffbe650 0x400dacf2:0x3ffbe670 0x400d938e:0x3ffbe690 0x400d943e:0x3ffbe730 0x400dfbd2:0x3ffbe7f0 0x400dfceb:0x3ffbe920 0x400823c4:0x3ffbe940 0x400824c1:0x3ffbe960 0x40085e01:0x3ffbe980 0x400824a1:0x3ffd2e10 0x40168bb6:0x3ffd3120 0x40168bf2:0x3ffd31b0 0x400d9386:0x3ffd31f0 0x400d943e:0x3ffd3290 0x400df84f:0x3ffd3350 0x400d4727:0x3ffd3380 0x400d2d8b:0x3ffd33a0 0x400fbdcb:0x3ffd33c0 0x400902d9:0x3ffd33e0
Core 0 register dump:
PC      : 0x400912ce  PS      : 0x00060034  A0      : 0x80091bd1  A1      : 0x3ffbe300
A2      : 0x3ffbf658  A3      : 0x0000cdcd  A4      : 0xb33fffff  A5      : 0x00000001
A6      : 0x00060021  A7      : 0x0000abab  A8      : 0x0000abab  A9      : 0x3ffc9664
A10     : 0x00000003  A11     : 0x00060023  A12     : 0x00060021  A13     : 0x00000001
A14     : 0x00400000  A15     : 0x00000000  SAR     : 0x0000001d  EXCCAUSE: 0x00000006
EXCVADDR: 0x00000000  LBEG    : 0x00000000  LEND    : 0x00000000  LCOUNT  : 0x00000000
Backtrace: 0x400912ce:0x3ffbe300 0x40091bce:0x3ffbe330 0x400903c7:0x3ffbe350 0x40092bb9:0x3ffbe370 0x40085e0a:0x3ffbe380 0x40221cf7:0x3ffbd470 0x400fef4a:0x3ffbd490 0x40091b99:0x3ffbd4b0 0x400902d9:0x3ffbd4d0
Rebooting...
ets Jun  8 2016 00:22:57
rst:0xc (SW_CPU_RESET),boot:0x13 (SPI_FAST_FLASH_BOOT)
configsip: 0, SPIWP:0xee
clk_drv:0x00,q_drv:0x00,d_drv:0x00,cs0_drv:0x00,hd_drv:0x00,wp_drv:0x00
mode:DIO, clock div:1
load:0x3fff0018,len:4
load:0x3fff001c,len:1216
ho 0 tail 12 room 4
load:0x40078000,len:9720
ho 0 tail 12 room 4
load:0x40080400,len:6352
entry 0x400806b8
[MSG:Grbl_ESP32 Ver 1.3a Date 20210424]
[MSG:Compiled with ESP32 SDK:v3.2.3-14-gd3e562907]
[MSG:Using machine:CNC_xPRO_V5_Machine_Template]
[MSG:Axis count 3]
[MSG:RMT Steps]
[MSG:Door switch on pin GPIO(16)]
[MSG:Macro Pin 0 GPIO(13)]
[MSG:Macro Pin 1 GPIO(0)]
[MSG:Macro UGuru Meditation Error: Core  1 panic'ed (Interrupt wdt timeout on CPU1)
Core 1 register dump:
PC      : 0x40092d42  PS      : 0x00060b34  A0      : 0x80091f23  A1      : 0x3ffbe560
A2      : 0x3ffbbc7c  A3      : 0x3ffbb9f0  A4      : 0x00000001  A5      : 0x00000001
A6      : 0x00060b23  A7      : 0x00000000  A8      : 0x3ffbb9f0  A9      : 0x3ffbb9f0
A10     : 0x00000018  A11     : 0x00000018  A12     : 0x00000001  A13     : 0x00000001
A14     : 0x00060b21  A15     : 0x00000000  SAR     : 0x00000000  EXCCAUSE: 0x00000006
EXCVADDR: 0x00000000  LBEG    : 0x400014fd  LEND    : 0x4000150d  LCOUNT  : 0xfffffff7
Core 1 was running in ISR context:
EPC1    : 0x400912ce  EPC2    : 0x00000000  EPC3    : 0x00000000  EPC4    : 0x40092d42
Backtrace: 0x40092d42:0x3ffbe560 0x40091f20:0x3ffbe580 0x40090087:0x3ffbe5a0 0x4018c014:0x3ffbe5e0 0x4018ca35:0x3ffbe620 0x400dfe6d:0x3ffbe650 0x400dacf2:0x3ffbe670 0x400d938e:0x3ffbe690 0x400d943e:0x3ffbe730 0x400dfbd2:0x3ffbe7f0 0x400dfceb:0x3ffbe920 0x400823c4:0x3ffbe940 0x400824c1:0x3ffbe960 0x40085e01:0x3ffbe980 0x40086049:0x3ffd3340 0x400860d9:0x3ffd3360 0x40086b21:0x3ffd3380 0x4000beaf:0x3ffd33a0 0x40205487:0x3ffd33c0 0x400df913:0x3ffd33e0 0x400d4727:0x3ffd3410 0x400d2d8b:0x3ffd3430 0x400fbdcb:0x3ffd3450 0x400902d9:0x3ffd3470
Core 0 register dump:
PC      : 0x400912d3  PS      : 0x00060034  A0      : 0x80091bd1  A1      : 0x3ffbe300
A2      : 0x3ffbf658  A3      : 0x0000cdcd  A4      : 0xb33fffff  A5      : 0x00000001
A6      : 0x00060021  A7      : 0x0000abab  A8      : 0x0000cdcd  A9      : 0x3ffc9664
A10     : 0x00000003  A11     : 0x00060023  A12     : 0x00060021  A13     : 0x00000001
A14     : 0x00060520  A15     : 0x00000000  SAR     : 0x0000001d  EXCCAUSE: 0x00000006
EXCVADDR: 0x00000000  LBEG    : 0x00000000  LEND    : 0x00000000  LCOUNT  : 0x00000000
Backtrace: 0x400912d3:0x3ffbe300 0x40091bce:0x3ffbe330 0x400903c7:0x3ffbe350 0x40092bb9:0x3ffbe370 0x40085e0a:0x3ffbe380 0x40221cf7:0x3ffbd470 0x400fef4a:0x3ffbd490 0x40091b99:0x3ffbd4b0 0x400902d9:0x3ffbd4d0
Rebooting...
ets Jun  8 2016 00:22:57
rst:0xc (SW_CPU_RESET),boot:0x13 (SPI_FAST_FLASH_BOOT)
configsip: 0, SPIWP:0xee
clk_drv:0x00,q_drv:0x00,d_drv:0x00,cs0_drv:0x00,hd_drv:0x00,wp_drv:0x00
mode:DIO, clock div:1
load:0x3fff0018,len:4
load:0x3fff001c,len:1216
ho 0 tail 12 room 4
load:0x40078000,len:9720
ho 0 tail 12 room 4
load:0x40080400,len:6352
entry 0x400806b8
[MSG:Grbl_ESP32 Ver 1.3a Date 20210424]
[MSG:Compiled with ESP32 SDK:v3.2.3-14-gd3e562907]
[MSG:Using machine:CNC_xPRO_V5_Machine_Template]
[MSG:Axis count 3]
[MSG:RMT Steps]
[MSG:Door switch on pin GPIO(16)]
[MSG:Macro Pin 0 GPIO(13)]
[MSG:Macro Pin 1 GPIO(0)]
[MSG:Init MoGuru Meditation Error: Core  1 panic'ed (Interrupt wdt timeout on CPU1)
Core 1 register dump:
PC      : 0x40092d42  PS      : 0x00060f34  A0      : 0x80091f23  A1      : 0x3ffbe560
A2      : 0x3ffbbe00  A3      : 0x3ffd0200  A4      : 0x00000001  A5      : 0x00000001
A6      : 0x00060f23  A7      : 0x00000000  A8      : 0x3ffd0200  A9      : 0x3ffd0200
A10     : 0x00000019  A11     : 0x00000019  A12     : 0x00000001  A13     : 0x00000001
A14     : 0x00060f21  A15     : 0x00000000  SAR     : 0x00000000  EXCCAUSE: 0x00000006
EXCVADDR: 0x00000000  LBEG    : 0x400014fd  LEND    : 0x4000150d  LCOUNT  : 0xfffffff7
Core 1 was running in ISR context:
EPC1    : 0x400912ce  EPC2    : 0x00000000  EPC3    : 0x00000000  EPC4    : 0x40092d42
Backtrace: 0x40092d42:0x3ffbe560 0x40091f20:0x3ffbe580 0x40090087:0x3ffbe5a0 0x4018bf61:0x3ffbe5e0 0x4018ca35:0x3ffbe620 0x400dfe6d:0x3ffbe650 0x400dacf2:0x3ffbe670 0x400d938e:0x3ffbe690 0x400d943e:0x3ffbe730 0x400dfbd2:0x3ffbe7f0 0x400dfceb:0x3ffbe920 0x400823c4:0x3ffbe940 0x400824c1:0x3ffbe960 0x40085e01:0x3ffbe980 0x40221cf7:0x3ffbda00 0x400fef4a:0x3ffbda20 0x40091b99:0x3ffbda40 0x400902d9:0x3ffbda60
Core 0 register dump:
PC      : 0x400912d6  PS      : 0x00060034  A0      : 0x80091bd1  A1      : 0x3ffbe300
A2      : 0x3ffbf658  A3      : 0x0000cdcd  A4      :
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

Thread 86 (2021-11-23):

Do these trinamic drivers overheat?

southsideboats, 2021-11-23:
Without fail, every time I run a toolpath that's longer than about 15 minutes,  my Z axis motor starts stalling out on me.... massively. I have the bulkman 3 amp steppers and have the $Z/Current/Run set to 2.7 and $Z/Current/Hold set to 1.0 amps. It's not my wiring, and it's not the motor itself...I have swapped all those things and still get the same issue every single time. Really, really frustrating. I left the microsteps stock at whatever it is and the max speed 3000 mm/min.  100 acceleration... I've done a lot of adjusting the settings and this problem keeps happening..... every single time. Also if I wait until the point where it's missing steps, and then disconnect the coupler from the motor, it STILL stalls, with no load on it.

Shutting it down for 20 minutes makes the stalling stop happening temporarily.. this is what's led me to believe this is an overheat issue with the tmc5160...

Oh, I will add that this is repeatable with two separate XPro V5's .

Mboss32, 2021-11-23:
Check your current setting for those motors.  The setting is for RMS current not max.  Discussed here:

https://github.com/Spark-Concepts/xPro-V5/wiki/Changing-settings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

southsideboats, 2021-11-23:
This can be marked as solved.... Totally the issue there.

Closed 2021-11-26.

Thread 87 (2021-11-23):

Won't complete a long toolpath.

southsideboats, 2021-11-23:
As the title states, the machine stops about a third of the way through the job... It's repeatable.. Even using CNC3D commander I'm getting the message "your job has completed successfully"... right on top of the bar that says it's like 29 percent of the way through.  I tried the sd card thing, formatted it as stated and switched to a cheap 4gb card... no change.

The spindle keeps spinning, it doesn't return to job zero or anything... just like you hit the pause button but the job clears from the GUI totally. Either on the WEBUI or CNC3D commander makes no difference.

southsideboats, 2021-11-24:
This one is really frustrating me.... I had decided that the issue was running the g-code from the SD Card... but today the issue reappeared and this time I was running via USB cable and the file on the computer. It stopped twice in the exact same spot... the countdown in UGS went from 1 hour and 30 minutes remaining to "completed in 10:23". No error messages or anything. Spindle still spinning in the spot it was when it froze.

Mboss32, 2021-11-25:
Can you post your gcode file and how you created it?

southsideboats, 2021-11-25:
> Can you post your gcode file and how you created it?

Here's the file below, created in Aspire. It's not been specific to this one though... I've had different files do the same thing, and one I am pretty sure came from the fusion 360.

https://drive.google.com/file/d/1rOBB0ufa5UX4Bev9fUTQopN3oxs7M9yj/view?usp=sharing

Mboss32, 2021-11-25:
What post processor did you use?

southsideboats, 2021-11-25:
>

Just the standard grbl post I thought.

southsideboats, 2021-11-26:
I have duplicated this issue with a second XPro V5 and the toolpath above.

southsideboats, 2021-11-26:
> Can you post your gcode file and how you created it?

Was there an issue with the G-Code I shared? Man, I have been through hell and back getting this whole machine working right.. Finally it's running as it's supposed to but won't finish the job... so it's still just a giant paperweight.

MichaelMartinez, 2021-11-30:
What are your machines GRBL settings? Your motor current settings may be to high, I have seen that a lot in other forums and message boards.  If the motors get too hot, they will shut down.

southsideboats, 2021-11-30:
I think we have confused something here or am I talking to two different
people? Indeed originally my current settings were too high, and bringing
them down to the neighborhood of 1 amp run, .8 amps hold fixed that
particular issue which was loss of steps, major loss of steps. I think they
were set to 2.8 and 1.5 amps respectively originally. That was confusing
for me because of the 3 amp steppers I have and the setting being RMS. I
suggest you make the wiki a bit more clear on that.

On Mon, Nov 29, 2021 at 8:55 PM Michael Martinez ***@***.***>
wrote:

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

southsideboats, 2021-11-30:
No, this is all great stuff. I was just wondering if I was talking to one
or two people. I had a bit of a rat's nest of wires, not as bad as the
picture looked, but really that was just because I was switching between
two separate XPro V5's on the fly, trying to eliminate my specific board
being the issue. And since I can duplicate this on both boards, chances of
that being the case is highly unlikely. I am about to hit send with the
spindle turned off and set to no spindle, and see if we can either rule out
or place blame on the RS485 Connection. I will report back. Thank you very
much.

On Tue, Nov 30, 2021 at 11:30 AM Michael Martinez ***@***.***>
wrote:

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

southsideboats, 2021-11-30:
Dammit all to hell. I guess that wasn't it.   Check out the output that I
screenshotted... Straight from Run at 6.41 percent completed, to Idle. I
didn't touch a thing.
[image: image.png]

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

southsideboats, 2021-11-30:
I saw that also about the SD card formatting, and I did that. In fact, the
SD card in there now is a 4gb microsd card that's older and slower, which I
also read might help. Anyways, I did use that exact software to format it.

Notice also that the Spindle speed stays at 12000... I had disabled it
completely that time with $Spindle/Type=none ... but this gives you an idea
of how the toolpaths are ending up... It just randomly stops, the spindle
keeps right on spinning.

So frustrating man.  CNC is a newer thing to me, but I'm not new to DiY
electronics and the like and I am not a total retard.  I feel a bit like a
beta tester at this point and I've just wasted so much time and gotten
nowhere. I know it's frustrating from the your end as well, that's not lost
on me.. and I do appreciate the help.. Hell, my wife is about to kick my
ass... she's all 'nice CNC, too bad it doesn't work' lol. So many hours
into this and nothing to show for it. I can't help at this point but wonder
where I would be if I had gone with the Mach3 controller instead of the
XPro. That's not personal at all... this is going to get me curses and
frankly I may very well be dead wrong.. I get it, the thing runs on your
test machine so what the hell is wrong with this dude (me)... I wish I
knew. I still can't get past the fact that it does this on two separate
XPro V5's . That would lend you to think I screwed up something on the
hardware side but man, I have been through it all.. and rewired it
several times already. I can jog that sucker all day and it's smooth as you
could want.

I think I'm gonna go to the liquor store now. Lol.

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
>>> I am jumping in as a bystander to try and help, I don't work for Spark
>>> Concepts... Just a happy customer. I totally understand having a problem
>>> and not knowing what to do about it. Going crazy sucks. I will stop
>>> offering ideas if you want, just ask. For now, I have a few thoughts,
>>> things to think about and questions...
>>>
>>> I looked at the gcode file and it is over 100,000 lines long. Nothing
>>> stands out to me as being bad in the file. Specifically around the 20,000
>>> to 40,000 line numbers AKA 29%... They are properly formatted and short
>>> gcode lines.
>>>
>>> Here are some potential ideas as to what may be happening;
>>>
>>>    1. Power spike - Does something on the same circuit kick on around
>>>    this time? Are you turning different things in your space on and off around
>>>    the time it stops working? Do you have multiple things connected to same
>>>    circuit? Is the circuit isolated? Is there a possibility of dirty power
>>>    going to the machine? - A good surge protector will eliminate power spikes.
>>>    2. Background task when using the computer? Is the computer a laptop
>>>    or desktop?
>>>    3. What do run for a spindle? If its a VFD, do you have the spindle
>>>    properly grounded? Is it on a separate circuit? Is the cable crossing the
>>>    stepper cables?
>>>    4. EMI from all the electronics being too close and/or not
>>>    isolated/grounded properly
>>>    5. Do you have a rats nest of cables crossing? Are your cables
>>>    shielded? If not, do you have ferrite on them?
>>>
>>> We don't have $250k machines and consequently... our machines are very
>>> sensitive to electricity and electronic noise. I suspect power is the
>>> problem here but I am admittedly not an expert.
>>>
>>> —
>>> You are receiving this because you modified the open/close state.
>>> Reply to this email directly, view it on GitHub
>>> <https://github.com/Spark-Concepts/xPro-V5/issues/87#issuecomment-982804091>,
>>> or unsubscribe
>>> <https://github.com/notifications/unsubscribe-auth/AF2QRSWVTVMVCHVC7NIDAX3UOT33HANCNFSM5IT6X3OQ>
>>> .
>>> Triage notifications on the go with GitHub Mobile for iOS
>>> <https://apps.apple.com/app/apple-store/id1477376905?ct=notification-email&mt=8&pt=524675>
>>> or Android
>>> <https://play.google.com/store/apps/details?id=com.github.android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>.
>>>
>>>
>>

MichaelMartinez, 2021-11-30:
I couldn't see your picture, I think you may be replying from email. There is an issue thread here: https://github.com/Spark-Concepts/xPro-V5/issues/87

How is the machine plugged in? I have mine on two circuits. One for the controller, computer, and power supply for the controller. Another circuit for my VFD/Spindle and water pump. There is nothing else on those circuits.

I also laid out my wires such that my VFD is about 3 feet away from the computer, xPro and power supply. My wifi was all screwed up on the computer that controls the xPro when the VFD was near it... that is when I discovered EMI problems. I didn't even consider that and it turns out these hobby machines are like EMI sponges while being EMI flame throwers at the same time.

southsideboats, 2021-11-30:
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

maybe you are onto something here with this. I've got a 3 way splitter coming out of a single outlet. and a 10 foot heavy duty extension cord lol. Water pump I haven't been turning on most of the time.. But I can confirm, even if shamefully, that I've had Xpro, VFD, and Laptop cable all hooked up to that one splitter. Nobody is perfect lol.

Mawg1, 2021-11-30:
>  EMI flame throwers

the most accurate description of VFDs I have ever seen!

southsideboats, 2021-11-30:
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

Tried her again.. Still via an extension cord to the power supply  for the XPro. But the VFD was not plugged in and I disabled the spindle in the firmware ($Spindle/Type=none) ...So I'm just moving the thing around in the air now.  Unsurprisingly, she quit on me again. Here's what I'm seeing in the WebUI.. You can see the change from Run to Idle.

<Run|MPos:214.125,125.615,-27.510|FS:1961,12000|WCO:103.000,103.000,-23.000|SD:4.52,/singlefile.gcode>
<Run|MPos:293.220,125.615,-45.870|FS:3000,12000|Ov:100,100,100|A:S|SD:4.57,/singlefile.gcode>
<Run|MPos:277.240,125.915,-45.870|FS:3000,12000|SD:4.57,/singlefile.gcode>
<Run|MPos:199.500,125.915,-28.530|FS:995,12000|SD:4.63,/singlefile.gcode>
<Run|MPos:144.930,125.915,-44.615|FS:751,12000|SD:4.72,/singlefile.gcode>
<Run|MPos:133.180,127.115,-45.870|FS:3000,12000|SD:5.32,/singlefile.gcode>
<Run|MPos:195.070,129.215,-28.820|FS:1337,12000|SD:6.31,/singlefile.gcode>
<Idle|MPos:170.470,129.515,-27.965|FS:0,12000>
<Idle|MPos:170.470,129.515,-27.965|FS:0,12000>
<Idle|MPos:170.470,129.515,-27.965|FS:0,12000>
<Idle|MPos:170.470,129.515,-27.965|FS:0,12000|WCO:103.000,103.000,-23.000>
<Idle|MPos:170.470,129.515,-27.965|FS:0,12000|Ov:100,100,100|A:S>
<Idle|MPos:170.470,129.515,-27.965|FS:0,12000>
<Idle|MPos:170.470,129.515,-27.965|FS:0,12000>
<Idle|MPos:170.470,129.515,-27.965|FS:0,12000>

Mawg1, 2021-11-30:
Maybe try pulling the gcode file from the SD card and then uploading it to NCviewer?  (https://ncviewer.com/)  take a look and see if anything strange is going on there?

How did you upload the file to the SD card - from the pc or through the WebUI?

southsideboats, 2021-11-30:
> Maybe try pulling the gcode file from the SD card and then uploading it to NCviewer? (https://ncviewer.com/) take a look and see if anything strange is going on there?
>
> How did you upload the file to the SD card - from the pc or through the WebUI?

Yeah I've been through that already. This is multiple different gcode files now... and the kicker is it also does the same exact thing if I skip the SD card altogether and run the code via USB and either CNCjs or UGS.

MichaelMartinez, 2021-11-30:
Dang.

What kind of machine is it? The reason I ask is because you have a FS of 3000. My max feedrate is 2000 set in GRBL. I have a Queenbee pro on linear rails with a lead screw.

Can you please post your GRBL settings as well? type $$ into your command line on the WebUI and copy/pasta that into here.

MichaelMartinez, 2021-12-01:
Did you try lowering the feedrate? Just a thought that maybe your program is outrunning the capability of the steppers torque and/or max rotational speed. There is a lot to digest when it comes to those variables. Ie. Critical speed, coefficient of friction, torque, Coefficient of Collar Friction, etc.

southsideboats, 2021-12-01:
I did just now, to no avail. Man, I went in today with a completely new
toolpath fresh out of Vectric Aspire, standard grbl post. Set the
machine at 2000 max all axes. Got about 8 percent through, stopped, "job
completed in (15) minutes".... It stops where it is in the toolpath and the
spindle keeps spinning (It's disconnected and unplugged but you can see the
"S11000" in the output window.)  ....thing is possessed I swear !

On Wed, Dec 1, 2021 at 3:36 PM Michael Martinez ***@***.***>
wrote:

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

MichaelMartinez, 2021-12-02:
Please post the GRBL setttings you are using...

southsideboats, 2021-12-02:
> Please post the GRBL setttings you are using...

$AP/Password=******
$AP/IP=192.168.0.1
$AP/Channel=1
$System/Hostname=CNC_xPRO_V5
$Http/Enable=ON
$Http/Port=80
$Telnet/Enable=ON
$Telnet/Port=23
$Radio/Mode=STA
$Bluetooth/Name=XPRO_V5_BT
$Notification/Type=NONE
$Notification/T1=
$Notification/T2=
$Notification/TS=
$Message/Level=Info
$User/Macro0=
$User/Macro1=
$User/Macro2=
$User/Macro3=
$Homing/Cycle0=
$Homing/Cycle1=
$Homing/Cycle2=
$Homing/Cycle3=
$Homing/Cycle4=
$Homing/Cycle5=
$Report/StallGuard=
$Stepper/Enable/Delay=0
$Stepper/Direction/Delay=0
$Stepper/Pulse=5
$Stepper/IdleTime=255
$Stepper/StepInvert=
$Stepper/DirInvert=
$Stepper/EnableInvert=Off
$Limits/Invert=Off
$Probe/Invert=On
$Report/Status=1
$GCode/JunctionDeviation=0.020
$GCode/ArcTolerance=0.002
$Report/Inches=Off
$Firmware/Build=
$Limits/Soft=Off
$Limits/Hard=Off
$Homing/Enable=On
$Homing/DirInvert=XY
$Homing/Squared=
$Homing/Feed=200.000
$Homing/Seek=2000.000
$Homing/Debounce=250.000
$Homing/Pulloff=3.000
$GCode/MaxS=24000.000
$GCode/MinS=0.000
$Laser/FullPower=1000
$GCode/LaserMode=Off
$GCode/Line1=
$GCode/Line0=
$Spindle/Enable/Invert=Off
$Spindle/Enable/OffWithSpeed=Off
$Coolant/Delay/TurnOn=1.000
$Spindle/Delay/SpinDown=0.000
$Spindle/Delay/SpinUp=0.000
$Spindle/PWM/Invert=Off
$Spindle/PWM/Frequency=5000.000
$Spindle/PWM/Off=0.000
$Spindle/PWM/Min=0.000
$Spindle/PWM/Max=100.000
$Spindle/Type=HUANYANG
$X/StepsPerMm=200.000
$Y/StepsPerMm=200.000
$Z/StepsPerMm=200.000
$A/StepsPerMm=200.000
$B/StepsPerMm=100.000
$C/StepsPerMm=100.000
$X/MaxRate=2000.000
$Y/MaxRate=2000.000
$Z/MaxRate=2000.000
$A/MaxRate=2000.000
$B/MaxRate=1000.000
$C/MaxRate=1000.000
$X/Acceleration=200.000
$Y/Acceleration=200.000
$Z/Acceleration=100.000
$A/Acceleration=200.000
$B/Acceleration=200.000
$C/Acceleration=200.000
$X/Home/Mpos=0.000
$Y/Home/Mpos=0.000
$Z/Home/Mpos=0.000
$A/Home/Mpos=0.000
$B/Home/Mpos=0.000
$C/Home/Mpos=0.000
$X/MaxTravel=1340.000
$Y/MaxTravel=1255.000
$Z/MaxTravel=135.000
$A/MaxTravel=1255.000
$B/MaxTravel=300.000
$C/MaxTravel=300.000
$X/Current/Run=1.000
$Y/Current/Run=1.000
$Z/Current/Run=1.100
$A/Current/Run=1.000
$B/Current/Run=0.250
$C/Current/Run=0.250
$X/Current/Hold=0.800
$Y/Current/Hold=0.800
$Z/Current/Hold=0.900
$A/Current/Hold=0.800
$B/Current/Hold=0.125
$C/Current/Hold=0.125
$X/Microsteps=8
$Y/Microsteps=8
$Z/Microsteps=8
$A/Microsteps=8
$B/Microsteps=16
$C/Microsteps=16
$X/StallGuard=16
$Y/StallGuard=16
$Z/StallGuard=16
$A/StallGuard=16
$B/StallGuard=16
$C/StallGuard=16
$Errors/Verbose=Off
Ok

southsideboats, 2021-12-03:
Ran it today with nothing connected... no motors, no spindle, just the emergency stop switch. Same thing happened... it would appear at the very least that this is something not related to my build. Only took me taking the whole thing apart three times to find this out lol.

MichaelMartinez, 2021-12-04:
I am not sure how you got those awesome settings in one shot... all I can manage to do are the GRBL numbers. In any case, we have some differences between our settings:

Of note... step pulse time for me is 4, idle delay is set to 250

My $X/Current/Run=1.8 and $X/Current/Hold=0.5
 these are the same  on X, Y and Z

[12:44:55] [ $$ ]$0=4 ;Step pulse time, microseconds

[12:44:55] [ $$ ] $1=250 ;Step idle delay, milliseconds

[12:44:55] [ $$ ] $2=3 ;Step pulse invert, mask

[12:44:55] [ $$ ] $3=3 ;Step direction invert, mask

[12:44:55] [ $$ ] $4=0 ;Invert step enable pin, boolean

[12:44:55] [ $$ ] $5=1 ;Invert limit pins, boolean

[12:44:55] [ $$ ] $6=1 ;Invert probe pin, boolean

[12:44:55] [ $$ ] $10=1 ;Status report options, mask

[12:44:55] [ $$ ] $11=0.010 ;Junction deviation, millimeters

[12:44:55] [ $$ ] $12=0.002 ;Arc tolerance, millimeters

[12:44:55] [ $$ ] $13=0 ;Report in inches, boolean

[12:44:55] [ $$ ] $20=0 ;Soft limits enable, boolean

[12:44:55] [ $$ ] $21=0 ;Hard limits enable, boolean

[12:44:55] [ $$ ] $22=1 ;Homing cycle enable, boolean

[12:44:55] [ $$ ] $23=0 ;Homing direction invert, mask

[12:44:55] [ $$ ] $24=100.000 ;Homing locate feed rate, mm/min

[12:44:55] [ $$ ] $25=300.000 ;Homing search seek rate, mm/min

[12:44:55] [ $$ ] $26=250.000 ;Homing switch debounce delay, milliseconds

[12:44:55] [ $$ ] $27=10.000 ;Homing switch pull-off distance, millimeters

[12:44:55] [ $$ ] $30=24000.000 ;Maximum spindle speed, RPM

[12:44:55] [ $$ ] $31=8000.000 ;Minimum spindle speed, RPM

[12:44:55] [ $$ ] $32=0 ;Laser-mode enable, boolean

[12:44:55] [ $$ ] $100=199.000 ;X-axis steps per millimeter

[12:44:55] [ $$ ] $101=200.000 ;Y-axis steps per millimeter

[12:44:55] [ $$ ] $102=200.000 ;Z-axis steps per millimeter

[12:44:55] [ $$ ] $103=200.000 ;undefined

[12:44:55] [ $$ ] $104=100.000 ;undefined

[12:44:55] [ $$ ] $110=2000.000 ;X-axis maximum rate, mm/min

[12:44:55] [ $$ ] $111=2000.000 ;Y-axis maximum rate, mm/min

[12:44:55] [ $$ ] $112=2000.000 ;Z-axis maximum rate, mm/min

[12:44:55] [ $$ ] $113=1000.000 ;undefined

[12:44:55] [ $$ ] $114=1000.000 ;undefined

[12:44:55] [ $$ ] $115=1000.000 ;undefined

[12:44:55] [ $$ ] $120=50.000 ;X-axis acceleration, mm/sec^2

[12:44:55] [ $$ ] $121=50.000 ;Y-axis acceleration, mm/sec^2

[12:44:55] [ $$ ] $122=50.000 ;Z-axis acceleration, mm/sec^2

[12:44:55] [ $$ ] $123=200.000 ;undefined

[12:44:55] [ $$ ] $124=200.000 ;undefined

[12:44:55] [ $$ ] $125=200.000 ;undefined

[12:44:55] [ $$ ] $130=940.000 ;X-axis maximum travel, millimeters

[12:44:55] [ $$ ] $131=1440.000 ;Y-axis maximum travel, millimeters

[12:44:55] [ $$ ] $132=110.000 ;Z-axis maximum travel, millimeters

[12:44:55] [ $$ ] $133=300.000 ;undefined

[12:44:55] [ $$ ] $134=300.000 ;undefined

[12:44:55] [ $$ ] $135=300.000 ;undefined

Mboss32, 2021-12-04:
$s to show all the extended settings,  $$ to show grbl settings

On Sat, Dec 4, 2021, 3:10 PM Michael Martinez ***@***.***>
wrote:

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

Thread 88 (2021-12-08):

One axis driver just makes a funny noise and doesn't turn motors

water-rhatt, 2021-12-08:
I just got my new xPro v5 and have been connecting the motors. Other than giving it wifi info, setting the spindle type to PWM and setting $Spindle/Enable/Invert=On, this is stock right out of the box. My Z drive just makes a little noise, but does not actually move.  I don't think it is my motors or wiring because I can connect the Z motor to any of the other axis and it works just fine.  Here is the output from PUTTY:

```
rst:0x1 (POWERON_RESET),boot:0x13 (SPI_FAST_FLASH_BOOT)
configsip: 0, SPIWP:0xee
clk_drv:0x00,q_drv:0x00,d_drv:0x00,cs0_drv:0x00,hd_drv:0x00,wp_drv:0x00
mode:DIO, clock div:1
load:0x3fff0018,len:4
load:0x3fff001c,len:1044
load:0x40078000,len:10124
load:0x40080400,len:5856
entry 0x400806a8

[MSG:Grbl_ESP32 Ver 1.3a Date 20210816]
[MSG:Compiled with ESP32 SDK:v3.2.3-14-gd3e562907]
[MSG:Using machine:CNC_xPRO_V5_XYYZ_NO]
[MSG:Axis count 3]
[MSG:RMT Steps]
[MSG:Door switch on pin GPIO(16)]
[MSG:Macro Pin 1 GPIO(13)]
[MSG:Macro Pin 2 GPIO(0)]
[MSG:Init Motors]
[MSG:TMCStepper Library Ver. 0x000703]
[MSG:X  Axis Trinamic TMC5160 Step:GPIO(12) Dir:GPIO(14) CS:GPIO(17) Disable:None Index:1 R:0.050 Limits(0.000,300.000)]
[MSG:X  Axis Trinamic driver test passed]
[MSG:Y  Axis Trinamic TMC5160 Step:GPIO(27) Dir:GPIO(26) CS:GPIO(17) Disable:None Index:2 R:0.050 Limits(0.000,300.000)]
[MSG:Y  Axis Trinamic driver test passed]
[MSG:Y2 Axis Trinamic TMC5160 Step:GPIO(33) Dir:GPIO(32) CS:GPIO(17) Disable:None Index:3 R:0.050 Limits(0.000,300.000)]
[MSG:Y2 Axis Trinamic driver test passed]
[MSG:Z  Axis Trinamic TMC5160 Step:GPIO(15) Dir:GPIO(2) CS:GPIO(17) Disable:None Index:4 R:0.050 Limits(-300.000,0.000)]
[MSG:Z  Axis Trinamic driver test failed. Check motor power]
[MSG:PWM spindle Output:GPIO(25), Enbl:GPIO(4), Dir:None, Freq:5000Hz, Res:13bits]

[MSG:Client Started]
[MSG:Connecting 849OAK]
[MSG:Connecting.]
[MSG:Connecting..]
[MSG:Connecting...]
[MSG:Connecting....]
[MSG:Connected with 192.168.1.199]
[MSG:Start mDNS with hostname:http://CNC_xPRO_V5.local/]
[MSG:SSDP Started]
[MSG:HTTP Started]
[MSG:TELNET Started 23]
[MSG:Mist coolant on pin GPIO(21)]
[MSG:X  Axis limit switch on pin GPIO(35)]
[MSG:Y  Axis limit switch on pin GPIO(34)]
[MSG:Z  Axis limit switch on pin GPIO(39)]
[MSG:Probe on pin GPIO(22)]

Grbl 1.3a ['$' for help]
[MSG:PWM spindle Output:GPIO(25), Enbl:GPIO(4), Dir:None, Freq:5000Hz, Res:13bits]
```

water-rhatt, 2021-12-13:
Bad board. Mike is replacing. Thanks Mike!

Closed 2021-12-13.

Thread 90 (2021-12-17):

System Crash When Running Program

rhdhybrid, 2021-12-17:
Hey guys, I'm not sure what is going on, I ran a pocket program yesterday on a set of valve covers, then powder coated them and setup to do my engraving today, never shut down the computer, just shut down the power as per normal, it crashed the bit into the valve cover, but homed and jogged fine previous. I'm after going to the old BD Laser firmware and the new BD Laser firmware. I have the log from the run, and the NC file.  I'm actually at a lose, I have tried CNCj's, UltimateCNC, and UGS. UGS has been giving me issues off and on, but CNCj's worked prefect but the DRU didn't update, but it worked. I'm sorry guys, I know you have a lot to deal with besides my issues, but I have been at it for hours, new config, new firmware, back to old, checked GRBL Settings, Only thing that seems to be bit new is on the newish BD Laser Firmware, seems to give Z axis alarms, checked all wiring, switch functions to box, go to the old Fix BD Laser Firmware the Z Axis Alarms go away but get the error in the TXT File
[error.txt](https://github.com/Spark-Concepts/xPro-V5/files/7737663/error.txt)
[Mike M Valve Cover Engrane Final.txt](https://github.com/Spark-Concepts/xPro-V5/files/7737669/Mike.M.Valve.Cover.Engrane.Final.txt)
.

rhdhybrid, 2021-12-18:
So I had another little go this morning, the issue seems to be related to the hard limits. Turning them off has fixed it. Is this related to noise I wonder? Either way it's back up and running thank god. :)

Closed 2021-12-21.

Thread 91 (2021-12-18):

Spindle speed changes during toolpath

ausip, 2021-12-18:
I am having issues with the spindle speed changing during cutting different elements of a toolpath. Spindle speed drops during arcs and ramping. The issue only occurs when using a spindle speed above 10000rpm. It's very noticeable at 24000rpm.

My VFD is connected via 0-10V and I have tested the output and the xPro is tuned to exactly 10v at 24000rpm.

Below are my init macro script etc. for CNC.js & the gcode I am using. gCode is created from Fusion360. I've tried both their included GRBL post processor as well as OpenBuilds post processor.

Here is a video demonstrating the issue.
[https://youtu.be/p8f5Kx_i-Gw](url)

CNC.js Init Script
`$Homing/Cycle0=Z
$Homing/Cycle1=X
$Homing/Cycle2=Y
$Stepper/Pulse=5
$Stepper/IdleTime=255
$Stepper/DirInvert=Y
$Stepper/EnableInvert=Off
$Limits/Invert=On
$Probe/Invert=On
$Report/Status=1
$Limits/Hard=On
$Homing/Enable=On
$Homing/DirInvert=X
$Homing/Squared=Y
$Homing/Feed=100.000
$Homing/Seek=1500.000
$Homing/Pulloff=2.500
$X/StepsPerMm=200.002
$Y/StepsPerMm=199.823
$Z/StepsPerMm=200.400
$A/StepsPerMm=199.823
$X/MaxRate=3000.000
$Y/MaxRate=3000.000
$Z/MaxRate=2500.000
$A/MaxRate=3000.000
$X/Acceleration=150.000
$Y/Acceleration=150.000
$Z/Acceleration=150.000
$A/Acceleration=150.000
$X/MaxTravel=1232.50
$Y/MaxTravel=830.00
$Z/MaxTravel=210.00
$A/MaxTravel=810.00
$X/Current/Run=1.950
$Y/Current/Run=1.950
$Z/Current/Run=1.950
$A/Current/Run=1.950
$X/Current/Hold=1.250
$Y/Current/Hold=1.250
$Z/Current/Hold=1.250
$A/Current/Hold=1.250
$X/Microsteps=8
$Y/Microsteps=8
$Z/Microsteps=8
$A/Microsteps=8
$Spindle/Type=PWM
$GCode/MaxS=24000
$GCode/MinS=8000`

GCode $$
`client> $$
$0=5 (Step pulse time, microseconds)
$1=255 (Step idle delay, milliseconds)
$2=0 (Step pulse invert, mask)
$3=2 (Step direction invert, mask)
$4=0 (Invert step enable pin, boolean)
$5=1 (Invert limit pins, boolean)
$6=1 (Invert probe pin, boolean)
$10=1 (Status report options, mask)
$11=0.010 (Junction deviation, millimeters)
$12=0.002 (Arc tolerance, millimeters)
$13=0 (Report in inches, boolean)
$20=0 (Soft limits enable, boolean)
$21=1 (Hard limits enable, boolean)
$22=1 (Homing cycle enable, boolean)
$23=1 (Homing direction invert, mask)
$24=100.000 (Homing locate feed rate, mm/min)
$25=1500.000 (Homing search seek rate, mm/min)
$26=250.000 (Homing switch debounce delay, milliseconds)
$27=2.500 (Homing switch pull-off distance, millimeters)
$30=24000.000 (Maximum spindle speed, RPM)
$31=8000.000 (Minimum spindle speed, RPM)
$32=0 (Laser-mode enable, boolean)
$100=200.002 (X-axis travel resolution, step/mm)
$101=199.823 (Y-axis travel resolution, step/mm)
$102=200.400 (Z-axis travel resolution, step/mm)
$103=199.823
$104=100.000
$105=100.000
$110=3000.000 (X-axis maximum rate, mm/min)
$111=3000.000 (Y-axis maximum rate, mm/min)
$112=2500.000 (Z-axis maximum rate, mm/min)
$113=3000.000
$114=1000.000
$115=1000.000
$120=150.000 (X-axis acceleration, mm/sec^2)
$121=150.000 (Y-axis acceleration, mm/sec^2)
$122=150.000 (Z-axis acceleration, mm/sec^2)
$123=150.000
$124=200.000
$125=200.000
$130=1232.500 (X-axis maximum travel, millimeters)
$131=830.000 (Y-axis maximum travel, millimeters)
$132=210.000 (Z-axis maximum travel, millimeters)
$133=810.000
$134=300.000
$135=300.000
ok`
[LeadTableBracketBase.txt](https://github.com/Spark-Concepts/xPro-V5/files/7739084/LeadTableBracketBase.txt)

Spark-Concepts, 2021-12-20:
I sounds like you are getting a little noise through the 0-10V line when under lots of motor loading.  If you put a capacitor on from the 0-10V terminal to the GND terminal on the toolhead connector it should clean up the signal.

ausip, 2021-12-20:
Any particular size capacitor?

From: Spark ***@***.***>
Reply to: Spark-Concepts/xPro-V5 ***@***.***>
Date: Monday, 20 December 2021 at 1:05 pm
To: Spark-Concepts/xPro-V5 ***@***.***>
Cc: Paul Mitchener ***@***.***>, Author ***@***.***>
Subject: Re: [Spark-Concepts/xPro-V5] Spindle speed changes during toolpath (Issue #91)

I sounds like you are getting a little noise through the 0-10V line when under lots of motor loading. If you put a capacitor on from the 0-10V terminal to the GND terminal on the toolhead connector it should clean up the signal.

—
Reply to this email directly, view it on GitHub<https://github.com/Spark-Concepts/xPro-V5/issues/91#issuecomment-997530290>, or unsubscribe<https://github.com/notifications/unsubscribe-auth/ADAGZEM4KG77UQN25EL6BSTUR2FPFANCNFSM5KKPSI6Q>.
Triage notifications on the go with GitHub Mobile for iOS<https://apps.apple.com/app/apple-store/id1477376905?ct=notification-email&mt=8&pt=524675> or Android<https://play.google.com/store/apps/details?id=com.github.android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>.
You are receiving this because you authored the thread.Message ID: ***@***.***>

PAUL MITCHENER
Director

Phone
1300 828 747
+61 3 7018 1000
Website
www.ausip.net.au

Mobile
0419 588 320
+61 419 588 320
Email
***@***.***
PO Box 447, Collins St West. VIC 8007

This communication is intended only for the person to whom it is addressed and may contain confidential material. If you received this communication in error, please inform the sender immediately and delete all copies.

 Please think of the environment before printing this email.

ausip, 2021-12-21:
@Spark-Concepts , thanks for the response. a 22uF capacitor across the input on the VFD fixed it.

I've ordered some ferrites and an AC noise filter to further clean up any other EMI issues.

Thanks heaps

Closed 2021-12-21.

Thread 92 (2021-12-21):

Y2 limit switch not working.

Ferdinandderoo, 2021-12-21:
Hello
i also have the problem, i tried your firmware but then my spindle stops working. It concerns the Huanyang via rs 485 If I enter $ Spindle/Type=HUANYANG, I get an error. I went back to the original firmware there everything works again except making Y axis square with two switches

"Thanks for clarification!

Let's try this firmware (unzip, and then upload the .bin like over the webUI)

CNCxPROv5_XYYZ_NC_Y2Lim.zip"

Ferdinand de Roo

Spark-Concepts, 2021-12-21:
what error do you get with $Spindle/Type = HuanYang?

Ferdinandderoo, 2021-12-22:
I'm very sorry I re update the firmware and everything is working the spindle and the limit switch y2 is working.
Don't no why but i have tried to get the spindle working with a lot of trouble and no success.
I only comment the homing/square=y and homing/cycle2=y
And all is working great didn't need to do everything to get the spindle working.

Spark-Concepts, 2021-12-22:
Great news!

Closed 2021-12-22.

Thread 93 (2021-12-23):

Can you add default firmware for Y2 limit switch?

water-rhatt, 2021-12-23:
Could you add a default firmware for Y2 limit switch? I can compile a custom firmware, but I love that this is as close to plug and play as there is. Updating the git to include a profile for machines with dual Y gantry/auto square/dual Y home switches would be a real help and I can see has come up as an issue several times.

Spark-Concepts, 2021-12-31:
Maybe, we are in the process of converting over to the FluidNC firmware, if that is going to be a long road we will look at pushing the Y2 limit firmware separately.  The big issue is folks using NC switches but only connecting the standard 3 switches will cause some trouble.

For axis squaring, this can be done with the default firmware using 2 switches on the Y limit port.  Reference info here: https://github.com/Spark-Concepts/xPro-V5/issues/12

water-rhatt, 2021-12-31:
Converting over to FluidNC will make all these machine definitions irrelevant, so I guess it doesn't make sense. I got tripped up on that thinking that maybe my sensor or wiring was faulty. Eventually I realized what was going on. I just thought having a couple of more common pre-compiled machine definitions would be easy enough to create and post and could save on some headaches and support requests. Again, no point if you are switching over to FluidNC.

Thanks.

Closed 2021-12-31.

Thread 95 (2021-12-28):

Possible to configure as XXYZ?

luckypants123, 2021-12-28:
Is it possible to flip the X and Y axis assignments somehow?

I assume I need to tweak something in the firmware and compile, just looking for pointers on the correct way to do this.
I can see in CNC_xPRO_V5_Machine_Template.h:
```
// X motor connects to the 1st driver, and the X port on the case
#define X_TRINAMIC_DRIVER       5160
#define X_RSENSE                0.05f
#define X_STEP_PIN              GPIO_NUM_12
#define X_DIRECTION_PIN         GPIO_NUM_14
#define X_CS_PIN                GPIO_NUM_17

// Y motor connects to the 2nd driver, and the Y port on the case
#define Y_TRINAMIC_DRIVER       5160
#define Y_RSENSE                0.05f
#define Y_STEP_PIN              GPIO_NUM_27
#define Y_DIRECTION_PIN         GPIO_NUM_26
#define Y_CS_PIN                X_CS_PIN

// Y2 motor connects to the 3rd driver, and the Y2/A port on the case
#define Y2_TRINAMIC_DRIVER       5160
#define Y2_RSENSE                0.05f
#define Y2_STEP_PIN              GPIO_NUM_33
#define Y2_DIRECTION_PIN         GPIO_NUM_32
#define Y2_CS_PIN                X_CS_PIN
```
Although I feel like I cant just swap X/Y/Y2 to Y/X/X2 and the limit switch assignments without changing whatever is using those variables...

Any help would be appreciated, thank you!

luckypants123, 2021-12-29:
I also found the below in GCode.cpp:
```
                     case 'X':
                        if (n_axis > X_AXIS) {
                            axis_word_bit               = GCodeWord::X;
                            gc_block.values.xyz[X_AXIS] = value;
                            axis_words |= bit(X_AXIS);

                        } else {
                            FAIL(Error::GcodeUnsupportedCommand);
                        }
                        break;
                    case 'Y':
                        if (n_axis > Y_AXIS) {
                            axis_word_bit               = GCodeWord::Y;
                            gc_block.values.xyz[Y_AXIS] = value;
                            axis_words |= bit(Y_AXIS);
                        } else {
                            FAIL(Error::GcodeUnsupportedCommand);
                        }
                        break;
```

Would swapping the axis assignments here have the desired effect as well?

Spark-Concepts, 2021-12-31:
you should do this in the Machine configuration file (first post).  Just change Y2 to X2, then you will have an X Y X2 Z setup so most of the silkscreen will still be correct

luckypants123, 2021-12-31:
Awesome, thank you!

lagnat, 2022-04-02:
@luckypants123 Where you successful swapping X and Y?  Did you have to rebuild the firmware?

luckypants123, 2022-04-02:
Yes, made the changes above and then compiled it following the directions in the wiki.
wasn’t too difficult and gave me an XXYZ machine.

lagnat, 2022-04-02:
What version of Esp32 did you install?  bdring/Grbl_Esp32 docs say 1.0.3 and nothing higher but it looks like they're at 2.0.2 so wondering if those are stale docs.

luckypants123, 2022-04-02:
I believe I used the source available from the Spark Concepts GitHub. It’s definitely behind in version, but I didn’t want to experiment with using the code from somewhere else.

lagnat, 2022-04-02:
The Spark Concepts README says to follow the instructions at the bdring/Grbl_Esp32 repo, however it also says to follow the instructions at https://github.com/espressif/arduino-esp32.  Can you check which version of Esp32  you used?

https://github.com/Spark-Concepts/xPro-V5-Firmware#compiling-firmware

luckypants123, 2022-04-02:
About 2 weeks after this the controller died, so that marked the end of my xProV5 adventure.

If I remember right though, you need to follow the instructions at both those places, as they each cover a different part of the process. However instead of using the source code from bdring/, I used it from the Spark Concepts GitHub, as that version of the Arduino sketch has all the pin assignments correct for the unit.

To be honest I don’t remember exactly, but I do remember it was not clear.

Closed 2021-12-31.

Thread 98 (2022-01-01):

Long programs stop partway through

luckypants123, 2022-01-01:
Just got my controller and I can't seem to get longer programs to complete.
If the program is short, everything works great... however if the program is longer, it just stops partway as if feed hold was pressed.
I'm pretty sure the controller is crashing somewhat as immediately after this happens the Web UI is unavailable.

I've tried running via SD Card and CNCjs, same result.

I thought it could be electrical interference, so I didn't run any ancillary equipment (vacuum), but same result.

It looks to me like [#87](https://github.com/Spark-Concepts/xPro-V5/issues/87)

My NC program:
[1001.txt](https://github.com/Spark-Concepts/xPro-V5/files/7798150/1001.txt)

My Settings:
```$0=10 (Step pulse time, microseconds)
$1=255 (Step idle delay, milliseconds)
$2=0 (Step pulse invert, mask)
$3=0 (Step direction invert, mask)
$4=0 (Invert step enable pin, boolean)
$5=0 (Invert limit pins, boolean)
$6=0 (Invert probe pin, boolean)
$10=1 (Status report options, mask)
$11=0.010 (Junction deviation, millimeters)
$12=0.002 (Arc tolerance, millimeters)
$13=0 (Report in inches, boolean)
$20=1 (Soft limits enable, boolean)
$21=0 (Hard limits enable, boolean)
$22=1 (Homing cycle enable, boolean)
$23=3 (Homing direction invert, mask)
$24=200.000 (Homing locate feed rate, mm/min)
$25=2000.000 (Homing search seek rate, mm/min)
$26=250.000 (Homing switch debounce delay, milliseconds)
$27=2.000 (Homing switch pull-off distance, millimeters)
$30=24000.000 (Maximum spindle speed, RPM)
$31=0.000 (Minimum spindle speed, RPM)
$32=0 (Laser-mode enable, boolean)
$N1=
$N0=
$33=5000.000
$34=0.000
$35=0.000
$36=100.000
$100=1600.000 (X-axis travel resolution, step/mm)
$101=1600.000 (Y-axis travel resolution, step/mm)
$102=1600.000 (Z-axis travel resolution, step/mm)
$103=1600.000
$104=1600.000
$105=1600.000
$110=2500.000 (X-axis maximum rate, mm/min)
$111=2500.000 (Y-axis maximum rate, mm/min)
$112=2500.000 (Z-axis maximum rate, mm/min)
$113=2500.000
$114=2500.000
$115=2500.000
$120=600.000 (X-axis acceleration, mm/sec^2)
$121=600.000 (Y-axis acceleration, mm/sec^2)
$122=600.000 (Z-axis acceleration, mm/sec^2)
$123=600.000
$124=600.000
$125=600.000
$130=265.000 (X-axis maximum travel, millimeters)
$131=535.000 (Y-axis maximum travel, millimeters)
$132=110.000 (Z-axis maximum travel, millimeters)
$133=300.000
$134=300.000
$135=300.000
$140=1.000
$141=1.000
$142=1.800
$143=1.800
$144=0.250
$145=0.250
$150=0.050
$151=0.050
$152=0.050
$153=0.500
$154=0.125
$155=0.125
$160=64
$161=64
$162=64
$163=64
$164=64
$165=64
$170=16
$171=16
$172=16
$173=16
$174=16
$175=16
```

Any advise would be most welcome!

Ian.

CraftyMyner, 2022-01-02:
I am also having similar issues. Both UGS and OpenBuilds Control lock up after a while of being connected, no more serial coms. I have to disconnect and reconnect via the button in the interface. It appears the controller didn't lose position so it must just be communication.

Running macOS, OpenBuilds Control, and UGS.

luckypants123, 2022-01-03:
Also not sure if its related or not (or something I don't quite yet understand about the controller), but occasionally on startup the Z axis will not move... other axes will.

I command homing, the readout shows the Z axis values moving positive, but the axis is stationary. After a few seconds an alarm is posted due to not finding the Z limit switch.

The only way I can fix it is to reboot the ESP32.

allistar, 2022-01-07:
I also have the "Z axis not responding on initial connection" issue and the only fix I've found is to disconnect and then reconnect.

For the issue with long programs crashing: I had a similar issue and it was caused by the USB connection dropping. The XPro doesn't like that. I replaced the cheap USB cable with a VR headset one and I also stopped running it alongside the 230V power cable. That made the issue go away.

CraftyMyner, 2022-01-07:
I added some ferrites on the USB cable and that seemed to do the trick for me. While attempting to fix the issue I tried getting FluidNC working for the xPro V5 but with only mild success. Would be good to get an official release from @Spark-Concepts going forward.

luckypants123, 2022-01-07:
> I also have the "Z axis not responding on initial connection" issue and the only fix I've found is to disconnect and then reconnect.
>
> For the issue with long programs crashing: I had a similar issue and it was caused by the USB connection dropping. The XPro doesn't like that. I replaced the cheap USB cable with a VR headset one and I also stopped running it alongside the 230V power cable. That made the issue go away.

I've had this issue both running over USB and also running of the internal SD Card. I can't remember if the USB cable was plugged in when I was running off the SD Card though. Are you saying that even when running off the SD Card, just the act of having the USB connected would cause it?

I did take the precautionary measure of isolating the USB cable from any high power sources as well.

luckypants123, 2022-01-07:
> I added some ferrites on the USB cable and that seemed to do the trick for me. While attempting to fix the issue I tried getting FluidNC working for the xPro V5 but with only mild success. Would be good to get an official release from @Spark-Concepts going forward.

I'll order some ferrites... hopefully that helps.
I saw on another closed issue they are looking at FluidNC but are waiting for it to mature a bit. I'm looking forward to that as apparently it has good support for squaring the gantry with 2 limit switches.

allistar, 2022-01-07:
I've never used the SD card before so I'm not sure on that. When I have the shop vac plugged in close to the computer it can cause the USB to momentarily disconnect. It would be good if the controller handled this scenario. Looking at the kernel panic it causes this could be at a lower level. I have also had the shop vac trip the limit switches which can be annoying because CNCjs doesn't let you restart the gcode from an arbitrary line like LinuxCNC does.

luckypants123, 2022-01-07:
That’s good info, thank you. I’ll do some experiments over the weekend with different USB cables, routing, ferrite, etc and see if I can isolate the issue.

CraftyMyner, 2022-01-07:
I tried to use the SD card for a 625 hole operation and it worked but about every 5 holes you would hear a slight studder like it was starved for the next move. Using the supplied SD card, haven't looked to see what speed it is but I don't think that's the issue.

luckypants123, 2022-01-07:
>

I haven't seen that so far - are you interpolating the bore helically with short linear moves maybe? Even so if it completes 1 hole without being data starved the time to rapid to the next hole would be plenty to refill the buffer. Granted my experience is with industrial controllers and I'm just starting with grbl, but I'd imagine the theory is the same.

CraftyMyner, 2022-01-07:
> I haven't seen that so far - are you interpolating the bore helically with short linear moves maybe? Even so if it completes 1 hole without being data starved the time to rapid to the next hole would be plenty to refill the buffer. Granted my experience is with industrial controllers and I'm just starting with grbl, but I'd imagine the theory is the same.

All holes are done with a G3, but fusion seems to have made them using about 20-30 commands per hole. The holes are very close together. Once I fixed the USB issue and used it instead of SD I had no issues with stuttering.

southsideboats, 2022-01-07:
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

I'm the one who was having this issue on the other thread....After 3 Xpro v5's all doing the same thing... stopping in the middle of long programs.

I spent a month trying everything imaginable and it just kept happening. For the time being, my solution was to use a shapeoko controller instead. I'm just trying to save you the hassle here... until something changes, this is an issue if you're trying to run long toolpaths. And a critical one.

luckypants123, 2022-01-07:
Ah well that’s not promising.
I thought from that thread it looked like a new board resolved it. :/

I’m going to do some experiments this weekend. Hopefully as mentioned above it is some type of sneaky EMI issue.

southsideboats, 2022-01-08:
> Ah well that’s not promising. I thought from that thread it looked like a new board resolved it. :/
>
> I’m going to do some experiments this weekend. Hopefully as mentioned above it is some type of sneaky EMI issue.

I thought the new board solved it, but it reared its ugly head again shortly thereafter.  Mine was even not finishing long toolpaths after I disconnected all the motors and spindle and ran it on the bare controller basically. I will follow along here.... You seem to be a bit more knowledgeable than me and maybe you can be the one that helps figure this out.

luckypants123, 2022-01-09:
Ok, well definitely some progress.

As @CraftyMyner suggested I went after the USB cable, and that seems like it is/was the problem.

I did 2 things:

1. Replaced the USB cable with a shorter one. Originally I was using whatever I had on hand (maybe a ~10ft cable?). I replaced with a 5ft that would just reach. Maybe the additional length was inducting noise like an antenna?
2. I added a decent clip-on size ferrite bead to both sides of the cable, right butt up to the connectors. The ones I used were 6mm ID, 29mm long. Similar to [these on Amazon](https://www.amazon.ca/iSKUKA-Pack-Ferrite-Beads-Clip/dp/B06XVR81CR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). I picked mine up local but basically the same thing.

Previously my longest runtimes were around 15min, less if the shop vac was running.

As a test I ran a long program (56min, 127k lines, helical boring, 24k RPM, 2500ipm). Completed successfully.
Then reran with shop vac on, and again completed successfully.

Not sure if it's 100% resolved yet, but I think @Spark-Concepts should definitely note in the setup wiki that ferrite beads on the USB cable are recommended.

I'll leave this issue open for another week or so just to verify and then hopefully can be closed.

CraftyMyner, 2022-01-09:
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

Good to hear,

I had given up on my machine as the longest job I was able to run was less than a few minutes. With the release of FluidNC, I thought I would take another stab at it. When testing the spindle at various RPM's I found the issue would show up, specifically at around 10k with an almost 100% fail rate with. I then threw a couple of ferrites on and didn't have the issue show up after 50 tests. I then ran a 2hr hole drilling program with an unrelated gcode failure (too low precision for arc commands). I think it's fixed for me but I am worried it might crop up if all the stars align. (Steppers, Spindle, Air Compressor, etc.)

Might give the inside of the case a spray of conductive paint or copper tape.

allistar, 2022-01-09:
Are your spindle cable and stepper motor cables all fully shielded? It's odd the issue seems related to spindle speed. My VFD is about 300mm away from the XPro and I use fully shielded spindle and stepper wires. I've run gcode files with > 1 million lines taking 12 hours. The only issue I have is every now and then the machine will pause for a few seconds, it's as if the controller is starved of commands but eventually it catches up.

CraftyMyner, 2022-01-09:
> Are your spindle cable and stepper motor cables all fully shielded? It's odd the issue seems related to spindle speed. My VFD is about 300mm away from the XPro and I use fully shielded spindle and stepper wires. I've run gcode files with > 1 million lines taking 12 hours. The only issue I have is every now and then the machine will pause for a few seconds, it's as if the controller is starved of commands but eventually it catches up.

@allistar

The cables are all fully shielded for the steppers, VFD, and limit switches. All shields are bonded to earth (I tried floating and bonded to the negative but no difference) The VDF is about 500mm away from the controller, the vfd and stepper cables run in the same cable chain with 2 waterlines in between. the USB cable takes a completely different route on the other side of the table to the laptop. Tried with laptop plugged (grounded) and unplugged.

luckypants123, 2022-01-09:
Not sure if that’s what you mean by the VFD cabling but I’ve run my spindle power cable and waterlines in its own cable chain on the opposite side of the gantry to keep it as far as possible from the low voltage stuff. Maybe that’s the cause?

allistar, 2022-01-09:
@CraftyMyner Your setup sounds similar to mine. Here's a picture of my Y axis drag chain. The water is running inside the Y axis chain but outside the X axis chain (there wasn't enough room). Other than that, all cables are running together in one drag chain. I've made sure the spindle cable shielding is wired to the earth in the VFD.
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

CraftyMyner, 2022-01-09:
Most spindles have a variable frequency drive (VFD) that chops up the AC to vary the speed of the spindle. The cheap Chinese ones are usually very electrically noisy and cause havoc with electronics. Shield cables are a must for the cable from the VFD to the spindle, also recommended the supply for the VFD takes another route from the low voltage cables.

CraftyMyner, 2022-01-09:
@allistar Yes, quite similar. I managed to get my waterline into my cable chains so I put it between the spindle cable and the stepper cables. I have the limit switches running with the stepper motor cables. I had to add an extra external pull-down resistor for the limit switches as I was getting false positives. I switched my Y axis to inductive type limit switches and don't need the pull-downs anymore on them.

allistar, 2022-01-09:
@CraftyMyner That's interesting, my electrically noisy shopvac is tripping one of my limit switches. My next step it to diagnose which one. I've assumed the static in the vac is causing a small current to form in the limit switch wiring which is causing the false positive. Can you explain (or send a pic or link) of how you used a pull-down resister to fix this?

CraftyMyner, 2022-01-09:
@allistar You can see the standard dry contact switch (Z) beside one of the inductive switches (Y2). I have a 10k pulldown resistor from signal to ground, the switch is connected to positive and signal on the controller and, Com and NC (normally closed) on the switch. The inductive switches did not seem to have a problem with false positives and I omitted the pulldown. If you are using NPN type inductive switches then you should use a pullup (resistor from signal to positive) instead. Inputs configured as NC.

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

allistar, 2022-01-10:
Hi @CraftyMyner , thanks very much for the information. I've got some testing to do to see if this fixes the issue.

luckypants123, 2022-01-26:
Well I've run a bunch and that specific issue seems to be gone for good after liberal use of ferrite beads on the USB cable. I'm calling this one solved.

Closed 2022-01-26.

Thread 99 (2022-01-04):

TROUBLE CONNECTING HUANYANG VFD WITH XPRO V5 CONTROLLER USING RS485 COMUNICATION

salcantarat, 2022-01-04:
I buy a Bulkman CNC QueenBee  with the CNC Xpro V5 controller and HUANYANG VFD to control a 2.2KW spindle water cooled.
Here is my Issue: When I start my spindle with M3 command, the spindle reach the velocity (I checked using a tachometer), but then the CNCjs send a error message and I'm not able to change the speed and continue to send g commands either.

> M3 S7000
error:9 (G-code lock)
> $X
[MSG:Caution: Unlocked]
ok
> M3 S7000
[MSG:Spindle RS485 Unresponsive 7]
[MSG:Critical Spindle RS485 did not reach speed 7000. Reported speed is -1 rpm.]
ok
ALARM:10
Grbl 1.3a ['$' for help]
[MSG:'$H'|'$X' to unlock]
error:9 (G-code lock)
[MSG:VFD: VFD settings read: RPM Range(6000, 24000)]]

How can I fix it?

*** In the following lines I explain my set up:
1.	Wiring VFD with Xpro V5
2.	HUANYANG VFD register settings
3.	Xpro V5 settings
4.	CNCJS g code sender, $$ , $S

**1 Wiring VFD with Xpro V5**

VFD R -> 220V neutron
VFD S -> none
VFD T -> 220V line
VFD U -> 2.2 KW spindle
VFD V -> 2.2 KW spindle
VFD W -> 2.2 KW spindle
*** EARTH WIRING NOT CONNECTED
*** JUMPER VFD HUANYANG IN VI POSITION
VFD RS485+ -> A Xpro V5 (with ferrite chokes)
VFD RS485- -> B Xpro V5 (with ferrite chokes)

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

**2 HUANYANG VFD register settings**

PD000   0
PD003   400
PD004   400
PD005   400
PD011   100
PD014   5
PD015   5
PD023   1
PD141   220
PD142   10
PD143   4
PD144   3000

PD001  2
PD002  2
PD163  1
PD164  1
PD165  3

**3 XPRO V5 SETTINGS**

Update Firmware with CNC_xPRO_V5_XYYZ_NC.bin following the instructions listed here: https://github.com/Spark-Concepts/xPro-V5/wiki/Checking_firmware_and_upgrading
Define the spindle with: $Spindle/type=HuanYang
Switch to RS485

**4 CNCJS g code sender, $$ , $S**

CNCjs 1.9.23 [Grbl]
Conectado al puerto COM3 con un baud rate de 115200
cro button only permitted in idle]
ets Jun  8 2016 00:22:57
rst:0x1 (POWERON_RESET),boot:0x17 (SPI_FAST_FLASH_BOOT)
configsip: 0, SPIWP:0xee
clk_drv:0x00,q_drv:0x00,d_drv:0x00,cs0_drv:0x00,hd_drv:0x00,wp_drv:0x00
mode:DIO, clock div:1
load:0x3fff0018,len:4
load:0x3fff001c,len:1216
ho 0 tail 12 room 4
load:0x40078000,len:9720
ho 0 tail 12 room 4
load:0x40080400,len:6352
entry 0x400806b8
[MSG:Grbl_ESP32 Ver 1.3a Date 20210816]
[MSG:Compiled with ESP32 SDK:v3.2.3-14-gd3e562907]
[MSG:Using machine:CNC_xPRO_V5_XYYZ_NC]
[MSG:Axis count 3]
[MSG:RMT Steps]
[MSG:Door switch on pin GPIO(16)]
[MSG:Macro Pin 1 GPIO(13)]
[MSG:Macro Pin 2 GPIO(0)]
[MSG:Init Motors]
[MSG:TMCStepper Library Ver. 0x000703]
[MSG:X  Axis Trinamic TMC5160 Step:GPIO(12) Dir:GPIO(14) CS:GPIO(17) Disable:None Index:1 R:0.050 Limits(0.000,750.000)]
[MSG:X  Axis Trinamic driver test passed]
[MSG:Y  Axis Trinamic TMC5160 Step:GPIO(27) Dir:GPIO(26) CS:GPIO(17) Disable:None Index:2 R:0.050 Limits(0.000,800.000)]
[MSG:Y  Axis Trinamic driver test passed]
[MSG:Y2 Axis Trinamic TMC5160 Step:GPIO(33) Dir:GPIO(32) CS:GPIO(17) Disable:None Index:3 R:0.050 Limits(0.000,800.000)]
[MSG:Y2 Axis Trinamic driver test passed]
[MSG:Z  Axis Trinamic TMC5160 Step:GPIO(15) Dir:GPIO(2) CS:GPIO(17) Disable:None Index:4 R:0.050 Limits(-100.000,0.000)]
[MSG:Z  Axis Trinamic driver test passed]
[MSG:Initializing RS485 VFD spindle]
[MSG:Auto-RTS in use]
[MSG:VFD RS485  Tx:GPIO(4) Rx:GPIO(25) RTS:None]
[MSG:VFD: VFD settings read: RPM Range(6000, 24000)]]
[MSG:Local access point CNC_xPRO_V5 started, 192.168.0.1]
[MSG:Captive Portal Started]
[MSG:HTTP Started]
[MSG:TELNET Started 23]
[MSG:Mist coolant on pin GPIO(21)]
[MSG:X  Axis limit switch on pin GPIO(35)]
[MSG:Y  Axis limit switch on pin GPIO(34)]
[MSG:Z  Axis limit switch on pin GPIO(39)]
[MSG:Probe on pin GPIO(22)]
Grbl 1.3a ['$' for help]

client> $$

[MSG:'$H'|'$X' to unlock]
$0=4 (Step pulse time, microseconds)
$1=250 (Step idle delay, milliseconds)
$2=0 (Step pulse invert, mask)
$3=0 (Step direction invert, mask)
$4=0 (Invert step enable pin, boolean)
$5=1 (Invert limit pins, boolean)
$6=1 (Invert probe pin, boolean)
$10=1 (Status report options, mask)
$11=0.010 (Junction deviation, millimeters)
$12=0.002 (Arc tolerance, millimeters)
$13=0 (Report in inches, boolean)
$20=0 (Soft limits enable, boolean)
$21=0 (Hard limits enable, boolean)
$22=1 (Homing cycle enable, boolean)
$23=3 (Homing direction invert, mask)
$24=200.000 (Homing locate feed rate, mm/min)
$25=2000.000 (Homing search seek rate, mm/min)
$26=250.000 (Homing switch debounce delay, milliseconds)
$27=2.500 (Homing switch pull-off distance, millimeters)
$30=24000.000 (Maximum spindle speed, RPM)
$31=0.000 (Minimum spindle speed, RPM)
$32=0 (Laser-mode enable, boolean)
$100=200.000 (X-axis travel resolution, step/mm)
$101=200.000 (Y-axis travel resolution, step/mm)
$102=200.000 (Z-axis travel resolution, step/mm)
$103=200.000
$104=100.000
$105=100.000
$110=1500.000 (X-axis maximum rate, mm/min)
$111=1500.000 (Y-axis maximum rate, mm/min)
$112=1500.000 (Z-axis maximum rate, mm/min)
$113=1000.000
$114=1000.000
$115=1000.000
$120=30.000 (X-axis acceleration, mm/sec^2)
$121=30.000 (Y-axis acceleration, mm/sec^2)
$122=30.000 (Z-axis acceleration, mm/sec^2)
$123=200.000
$124=200.000
$125=200.000
$130=750.000 (X-axis maximum travel, millimeters)
$131=800.000 (Y-axis maximum travel, millimeters)
$132=100.000 (Z-axis maximum travel, millimeters)
$133=300.000
$134=300.000
$135=300.000
ok

> $S

$Sta/SSID=CNC_xPRO_V5
$Sta/Password=******
$Sta/IPMode=DHCP
$Sta/IP=0.0.0.0
$Sta/Gateway=0.0.0.0
$Sta/Netmask=0.0.0.0
$AP/SSID=CNC_xPRO_V5
$AP/Password=******
$AP/IP=192.168.0.1
$AP/Channel=1
$System/Hostname=CNC_xPRO_V5
$Http/Enable=ON
$Http/Port=80
$Telnet/Enable=ON
$Telnet/Port=23
$Radio/Mode=AP
$Bluetooth/Name=XPRO_V5_BT
$Notification/Type=NONE
$Notification/T1=
$Notification/T2=
$Notification/TS=
$Message/Level=Info
$User/Macro0=
$User/Macro1=
$User/Macro2=
$User/Macro3=
$Homing/Cycle0=Z
$Homing/Cycle1=XY
$Homing/Cycle2=
$Homing/Cycle3=
$Homing/Cycle4=
$Homing/Cycle5=
$Report/StallGuard=
$Stepper/Enable/Delay=0
$Stepper/Direction/Delay=0
$Stepper/Pulse=4
$Stepper/IdleTime=250
$Stepper/StepInvert=
$Stepper/DirInvert=
$Stepper/EnableInvert=Off
$Limits/Invert=On
$Probe/Invert=On
$Report/Status=1
$GCode/JunctionDeviation=0.010
$GCode/ArcTolerance=0.002
$Report/Inches=Off
$Firmware/Build=
$Limits/Soft=Off
$Limits/Hard=Off
$Homing/Enable=On
$Homing/DirInvert=XY
$Homing/Squared=
$Homing/Feed=200.000
$Homing/Seek=2000.000
$Homing/Debounce=250.000
$Homing/Pulloff=2.500
$GCode/MaxS=24000.000
$GCode/MinS=0.000
$Laser/FullPower=1000
$GCode/LaserMode=Off
$GCode/Line1=
$GCode/Line0=
$Spindle/Enable/Invert=Off
$Spindle/Enable/OffWithSpeed=Off
$Coolant/Delay/TurnOn=1.000
$Spindle/Delay/SpinDown=0.000
$Spindle/Delay/SpinUp=0.000
$Spindle/PWM/Invert=Off
$Spindle/PWM/Frequency=5000.000
$Spindle/PWM/Off=0.000
$Spindle/PWM/Min=0.000
$Spindle/PWM/Max=100.000
$Spindle/Type=HUANYANG
$X/StepsPerMm=200.000
$Y/StepsPerMm=200.000
$Z/StepsPerMm=200.000
$A/StepsPerMm=200.000
$B/StepsPerMm=100.000
$C/StepsPerMm=100.000
$X/MaxRate=1500.000
$Y/MaxRate=1500.000
$Z/MaxRate=1500.000
$A/MaxRate=1000.000
$B/MaxRate=1000.000
$C/MaxRate=1000.000
$X/Acceleration=30.000
$Y/Acceleration=30.000
$Z/Acceleration=30.000
$A/Acceleration=200.000
$B/Acceleration=200.000
$C/Acceleration=200.000
$X/Home/Mpos=0.000
$Y/Home/Mpos=0.000
$Z/Home/Mpos=0.000
$A/Home/Mpos=0.000
$B/Home/Mpos=0.000
$C/Home/Mpos=0.000
$X/MaxTravel=750.000
$Y/MaxTravel=800.000
$Z/MaxTravel=100.000
$A/MaxTravel=300.000
$B/MaxTravel=300.000
$C/MaxTravel=300.000
$X/Current/Run=1.800
$Y/Current/Run=1.800
$Z/Current/Run=1.800
$A/Current/Run=1.800
$B/Current/Run=0.250
$C/Current/Run=0.250
$X/Current/Hold=0.500
$Y/Current/Hold=0.500
$Z/Current/Hold=0.500
$A/Current/Hold=0.500
$B/Current/Hold=0.125
$C/Current/Hold=0.125
$X/Microsteps=8
$Y/Microsteps=8
$Z/Microsteps=8
$A/Microsteps=16
$B/Microsteps=16
$C/Microsteps=16
$X/StallGuard=16
$Y/StallGuard=16
$Z/StallGuard=16
$A/StallGuard=16
$B/StallGuard=16
$C/StallGuard=16
$Errors/Verbose=Off
Ok

TTALON541, 2022-01-13:
Still nothing huh, i bought the same setup, Bulkma queen bee, xpro, etc, I'm 110v, the same problem, hopefully, it gets addresses

southsideboats, 2022-01-13:
> Still nothing huh, i bought the same setup, Bulkma queen bee, xpro, etc, I'm 110v, the same problem, hopefully, it gets addresses

I would forego the rs485 altogether if I were you and just go the pwm route instead. Save yourself the headache.

spydercnc, 2022-01-16:
Use the 485 firmware I used NO with a NO switch. A NC switch must be in place to use the NC firmware.
I battled for 3 days, changed the firmware and also changed the wire between the Xpro and the VFD and it all started working. The LED under the Xpro RS485 must flash green/red.
Switch the VFD on first and then the Xpro.

ColPaulR, 2022-01-22:
I had some problems with getting RS-485 to work as well. I finally have it going. The solution to my problems was to tie the 220V AC ground to the 24V power supply ground and to connect a digital ground (I used the toolhead gnd) to the Huanyang ACM. I verified that removing either of these connections and turning on the VFD creates enough EMI and ground float to cause the RS-485 to quit working. Not sure it will solve your -1 RPM problem but thought I'd give you something to try.

deverelo, 2022-01-26:
I had that exact error of the RS485 Unresponsive 7 and Spindle RS485 did not reach speed.
At that time I didn't have the shield of the spindle cable grounded. I attached the braid to the vfd ground, keeping this pigtail very short (30mm?) at the VFD side. The mains ground and spindle cable ground are also attached to this same terminal.
At the spindle side the connector housing is not attached to ground as it should be. So I exposed the shield and made it have contact with the outer spindle housing (I have 2.2kW air cooled model). Later I will get a small and large metal hose clamp to make a proper connection. Anyway just improving the cable shield fixed this - it is really important with VFDs.

ghalib1399, 2022-02-02:
> I had some problems with getting RS-485 to work as well. I finally have it going. The solution to my problems was to tie the 220V AC ground to the 24V power supply ground and to connect a digital ground (I used the toolhead gnd) to the Huanyang ACM. I verified that removing either of these connections and turning on the VFD creates enough EMI and ground float to cause the RS-485 to quit working. Not sure it will solve your -1 RPM problem but thought I'd give you something to try.

Dear can you show us image for your setup?

id192313, 2022-06-02:
Hi, able to resolve the issue?

Randall-Dev, 2022-06-13:
whats the pros and cons on using pwm or rs-485

Jennywhite2, 2022-07-16:
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

Hello, can someone share wiring diagram vfd with power supply,because i dont no how to put ac cable ,..need to put on vfd or power supply

Spark-Concepts, 2022-08-09:
Please see the following [https://github.com/Spark-Concepts/xPro-V5/issues/164#issuecomment-1208726453](https://github.com/Spark-Concepts/xPro-V5/issues/164#issuecomment-1208726453)

id192313, 2022-08-09:
edited
I have the same issues and implemented all the fixes that have suggested before. Some hit and missed. In the end the only thing that make it works is the resistor on the RS485 (both side) and using a Belkin surge protector. The moment I use a different extension without any grounding it failed. Hope this help.
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

Closed 2022-08-09.

Thread 101 (2022-01-15):

Always having to press the rest button to get started.

spydercnc, 2022-01-15:
Finally got my xPro V5 working with a HY VFD, using  CNC_xPRO_V5_XYYZ_485_NO.bin. on a Lillerbee machine.
When rest all works well, movement, etc is as it should be, connected via USB-C. The spindle turns on/off with the software as expected and machine limits are recognized.
I have the VFD wired separately that it does not run aimlessly when working on the workpiece or changing bits.

However, both when I switch the machine on or switch the VFD on later, I have to press the reset button on the xPro to connect to the killer bee or run the spindle. I understood that the VFD needs to be powered on first when initially setting everything up, but pressing the reset button and then rehoming the machine every time I need to change something, seems an unnecessary step.

spydercnc, 2022-01-16:
I was wondering if the Macro connections can be enabled to reset with a push-button switch?

sflom, 2022-01-17:
I would second the idea of a macro to reset the push-button switch.  I have to also press the reset button to get my machine to react like I would like it to often.

Spark-Concepts, 2022-01-20:
Using RS-485 there is a handshake with the VFD and controller, if the VFD is off on startup the handshake will be missed and not allow the spindle to function properly.  There is also a handshake between the drivers and the ESP32 module, if USB is applied before 24V is applied, the handshake will be missed and the ESP32 needs to be restarted.

Is your xPRO constantly plugged into USB, or the port left open?  In the sender programs, if you select the "Enable Hardware Flow Control" option, the xPRO will auto reset when the port is opened.

spydercnc, 2022-03-12:
Thank you that did work.

Closed 2022-08-09.

Thread 102 (2022-01-15):

Spindle error on my Queen Bee with CNC xPro V5 RS485 control

fredqbee, 2022-01-15:
In my startup message using CNCjs I get:
[MSG: Initializing RS485 VFD spindle]
[MSG: Undefined VFD_RS485_TXD_Pin]
[MSG: Undefined VFD_RS485_RXD_Pin]
[MSG: Undefined VFD_RS 485_RTS_Pin]
[MSG: RS485 VFD Spindle Error]
Are these missing settings in the HuanYang VFD or something else.
Can anybody help?

kongpop113, 2022-01-16:
Here is how I set it up.

1. Follow the wiring instruction on this [youtube link](https://www.youtube.com/watch?v=I2wec_L6j14).
2. Program VFD to establish RS485 communication [reference](https://buildyourcnc.com/FAQ/13383#:~:text=You%20will%20need%20to%20connect%20the%20VFD%20to,with%20mach3%20called%20the%20Huanyang%20VFD%20Mach3%20PlugIn.)
   PD001 - value 2 - Enables with communication aspect of the VFD
   PD002 - value 2 - Enables frequency control from the communcations port
   PD163 - value 1 - VFD address
   PD164 - value 1 - Baud rate of 9600 (speed of the communication)
   PD165 - value 3 - 8N1 RTU - 8 bits (that's the size of the word that gets communicated), N (No parity or no error checking) and 1 (1 stop bit)

Be aware of noise coupling from the spindle to the limit switches. However, connecting the limit switch shields to ground inputs of the V5 controller gets rid of this issue.

fredqbee, 2022-01-18:
Sorry it took so long to respond.I doubled checked the settings on the VFD and they were correct.Frustrated, I did a factory reset of the VFD and then did a bench test of the spindle.It hummed but didn't turn. I checked the wiring and was correct but 1 wire was loose.I tightened the wire and did the bench test. It ran fine.I reset the VFD setting, rechecked the wires to the xpro. All goodI checked the PWM/RS485 switch and flipped it back and forth.There was not much resistance between the two, more of a slide.I started backup and got the same error message.Defined the spindle again trying both HaunYang andH2A.Nothing. Checked the indicator light for the PWM/RS485 and it was very light red almost like a reflection of the door stop button.Flipped the switch to PWM And no difference. Flipped it back and pulled out the green connector and the green light came on just before it was completely out.I pushed it back in and the green light when out. Double checked the wire and they were fine.I could be wrong, but it seems that the PWM/RS485 Switch could be bad.Do you have any ideas?

    On Saturday, January 15, 2022, 09:54:40 PM EST, KP2 ***@***.***> wrote:

Here is how I set it up.

   - Follow the wiring instruction on this youtube link.
   - Program VFD to establish RS485 communication reference
PD001 - value 2 - Enables with communication aspect of the VFD
PD002 - value 2 - Enables frequency control from the communcations port
PD163 - value 1 - VFD address
PD164 - value 1 - Baud rate of 9600 (speed of the communication)
PD165 - value 3 - 8N1 RTU - 8 bits (that's the size of the word that gets communicated), N (No parity or no error checking) and 1 (1 stop bit)

Be aware of noise coupling from the spindle to the limit switches. However, connecting the limit switch shields to ground inputs of the V5 controller gets rid of this issue.

—
Reply to this email directly, view it on GitHub, or unsubscribe.
Triage notifications on the go with GitHub Mobile for iOS or Android.
You are receiving this because you authored the thread.Message ID: ***@***.***>

Spark-Concepts, 2022-01-20:
When you have the switch set to RS485, what color LEDs do you see underneath the switch?

fredqbee, 2022-01-20:
I n my previous response, I mention that the LED under the PWM/RS485 switch was a very light red. Almost like the E-stop LED was reflecting through. I hit the E-stop to shut that LED off and there is no light under the PWM/RS485 switch. Also, if I flip the switch to the PWM side I still have no light. The only time I get a light is when I pull out the connector about halfway then the light turns green.

    On Wednesday, January 19, 2022, 09:47:36 PM EST, Spark ***@***.***> wrote:

When you have the switch set to RS485, what color LEDs do you see underneath the switch?

—
Reply to this email directly, view it on GitHub, or unsubscribe.
Triage notifications on the go with GitHub Mobile for iOS or Android.
You are receiving this because you authored the thread.Message ID: ***@***.***>

Cyrill87, 2022-02-04:
I have the same setup and do have the same problem. For me the old firmware (containing 485 in name) is working

fredqbee, 2022-02-04:
That firmware is loaded On My Pro V5. I was able to view this when I was testing out CNC Commander. I am not able to view this on CNCjs. CNCjs just connects. It doesn't tell me which firmware it's using, nor do I know how to change it. Would this explain why I don't have a lit led under the PMW/485RS switch.

    On Friday, February 4, 2022, 08:55:50 AM EST, Cyrill Berger ***@***.***> wrote:

I have the same setup and do have the same problem. For me the old firmware (containing 485 in name) is working

—
Reply to this email directly, view it on GitHub, or unsubscribe.
Triage notifications on the go with GitHub Mobile for iOS or Android.
You are receiving this because you authored the thread.Message ID: ***@***.***>

sdom001, 2022-02-21:
I am having the same issue. I am getting this
[MSG:Initializing RS485 VFD spindle]
[MSG:Undefined VFD_RS485_TXD_PIN]
[MSG:Undefined VFD_RS485_RXD_PIN]
[MSG:Undefined VFD_RS485_RTS_PIN]
[MSG:RS485 VFD spindle errors]
I do have a green light under the Spindle spot on the side of the xpro v5.
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
Has anyone figured out what the issue is? I have checked all wiring and all seems fine. What guage wire should be used for the RS485 connection. I am using a small section left over from the limit switches, should it be thicker, does it matter?

sdom001, 2022-02-23:
ok update. I emailed Mike at Spark Concepts and he had me Run the $i command. It sent back this.
[VER:1.3a.20201022:]
[OPT:MPHBSW#]
[MSG:Using machine:CNC_xPRO_V5_XYYZ]
[MSG:Mode=AP:SSDI=CNC_xPRO_V5:IP=192.168.0.1:MAC=94-3C-C6-9D-74-55]
[MSG:No BT]
I sent it to him and his response was my Xpro v5 firmware was out of date and needed to be updated to use the RS485 with spindles. and to go here https://github.com/Spark-Concepts/xPro-V5/wiki/Checking_firmware_and_upgrading.
which then led me here https://github.com/Spark-Concepts/xPro-V5/tree/main/Firmware   to get the update
and here https://github.com/Spark-Concepts/xPro-V5/wiki/Checking_firmware_and_upgrading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 for the update instructions. I will post a follow up if it resolves the issue.

fredqbee, 2022-02-23:
Sorry to leave GitHub community in the dark. I contacted Spark Concepts directly and the got me up and running.I have been trying to upload our conversation so everybody can see. But it crashes or says it's too big. I will keep trying and then close this issue as solved

    On Wednesday, February 23, 2022, 10:19:36 AM EST, sdom001 ***@***.***> wrote:

ok update. I emailed Mike at Spark Concepts and he had me Run the $i command. It sent back this.
[VER:1.3a.20201022:]
[OPT:MPHBSW#]
[MSG:Using machine:CNC_xPRO_V5_XYYZ]
[MSG:Mode=AP:SSDI=CNC_xPRO_V5:IP=192.168.0.1:MAC=94-3C-C6-9D-74-55]
[MSG:No BT]
I sent it to him and his response was my Xpro v5 firmware was out of date and needed to be updated to use the RS485 with spindles. and to go here https://github.com/Spark-Concepts/xPro-V5/wiki/Checking_firmware_and_upgrading.
which then led me here https://github.com/Spark-Concepts/xPro-V5/tree/main/Firmware to get the update
and here https://github.com/Spark-Concepts/xPro-V5/wiki/Checking_firmware_and_upgrading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 for the update instructions. I will post a follow up if it resolves the issue.

—
Reply to this email directly, view it on GitHub, or unsubscribe.
Triage notifications on the go with GitHub Mobile for iOS or Android.
You are receiving this because you authored the thread.Message ID: ***@***.***>

fredqbee, 2022-02-23:
 

    On Wednesday, February 23, 2022, 10:19:36 AM EST, sdom001 ***@***.***> wrote:

ok update. I emailed
Spark ***@***.******@***.***, Jan 27 at 8:14 PMHi Fred, 
Sorry to hear there is trouble, our Github guy is out sick at the moment so we are a bit slow on the responses there - sorry! 
Could you send command $i to the controller and send me the response? Could you send command $s to the controller and send me the response? What VFD are you trying to connect to? could you send a picture of your setup? 

On Thu, Jan 27, 2022 at 11:13 AM Contact Form ***@***.***> wrote:

***@***.***' submitted the form from your 'Contact US' page

A user has submitted the contact form on your store.

Here are their details:

| Email Address: | ***@***.*** |
| Phone Number: | 13304170795 |
| Greetings, I am fredqbee on the GitHub site.
I have not seen a response from my last post, so I thought I would contact you direct. I have no light under the RS485 switch. I am assuming I have a faulty unit. Everything else works. Is there a way to check the signal from the xPro V5 to the VFD? Can I get a replacement? Where do I go from here? |

Spark Concepts
https://www.spark-concepts.com/
Spark Concepts is powered by BigCommerce. Launch your own store for free with BigCommerce.

|
|
|
|  |  |

 |

 |
|
|  |
Ecommerce for a New Era | BigCommerce

Learn how BigCommerce can fuel your business with all the capabilities of enterprise ecommerce—without the cost ...
 |

 |

 |

Mike at Spark Concepts and he had me Run the

 $i command. It sent back this.[VER:1.3a.20201022:]
[OPT:MPHBSW#]
[MSG:Using machine:CNC_xPRO_V5_XYYZ]
[MSG:Mode=AP:SSDI=CNC_xPRO_V5:IP=192.168.0.1:MAC=94-3C-C6-9D-74-55]
[MSG:No BT]
I sent it to him and his response was my Xpro v5 firmware was out of date and needed to be updated to use the RS485 with spindles. and to go here https://github.com/Spark-Concepts/xPro-V5/wiki/Checking_firmware_and_upgrading.
which then led me here https://github.com/Spark-Concepts/xPro-V5/tree/main/Firmware to get the update
and here https://github.com/Spark-Concepts/xPro-V5/wiki/Checking_firmware_and_upgrading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 for the update instructions. I will post a follow up if it resolves the issue.

—
Reply to this email directly, view it on GitHub, or unsubscribe.
Triage notifications on the go with GitHub Mobile for iOS or Android.
You are receiving this because you authored the thread.Message ID: ***@***.***>

fredqbee, 2022-02-23:
Hi Fred, 
I see part of the problem, you are using the PWM only firmware - you will need to push an update, please follow these instructions : Checking_firmware_and_upgrading · Spark-Concepts/xPro-V5 Wiki (github.com)
make sure to match the ending NO or NC to the type of limit switch you have when selecting a .bin to download and install. 
On Sat, Feb 5, 2022 at 10:59 ***@***.******@***.***> wrote:

hi MikePlease check your spam for my response.It probably ends up in spam because of attached filesThanks Fred

On Saturday, February 5, 2022, 07:58:45 AM EST, Spark Concepts ***@***.***> wrote:

Hi Fred, 
Sorry for the delay,  found this in spam for some reason.  
Quick question,  if you set the switch to RS 485 side,  unplug the 485 cable going to the VFD completely,  then set:
$Spindle/Type = HuanYang
Press the reset button on the side of the control and send me a picture of the output message that pops up in cncjs.  Please also note the color of the LED under the 485 switch with the cable unplugged
Thanks, Mike

On Fri, Jan 28, 2022, 9:46 ***@***.******@***.***> wrote:

Hi Mike,Sorry I am not up on the new way to share photos and screens. I can only attach files. I will give you a little background on my machine. I purchased a QueenBee Pro from Bulkman with your xPro V5 and the 2.2Kw water cooled spindle and the HaunYang VFD. Everything is moving, homes and spindle bench test works fine. I can't get the spindle to turn on with the xPro and Cncjs. Also, the LED under the PMW/RS485 is not lit in either mode, the switch is very loose and if I pull the connector out about halfway the LED does turn green. Checked the VFD settings, Wire connections, changed wire, and spread out all the components.

    On Wednesday, February 23, 2022, 10:19:36 AM EST, sdom001 ***@***.***> wrote:

ok update. I emailed Mike at Spark Concepts and he had me Run the $i command. It sent back this.
[VER:1.3a.20201022:]
[OPT:MPHBSW#]
[MSG:Using machine:CNC_xPRO_V5_XYYZ]
[MSG:Mode=AP:SSDI=CNC_xPRO_V5:IP=192.168.0.1:MAC=94-3C-C6-9D-74-55]
[MSG:No BT]
I sent it to him and his response was my Xpro v5 firmware was out of date and needed to be updated to use the RS485 with spindles. and to go here https://github.com/Spark-Concepts/xPro-V5/wiki/Checking_firmware_and_upgrading.
which then led me here https://github.com/Spark-Concepts/xPro-V5/tree/main/Firmware to get the update
and here https://github.com/Spark-Concepts/xPro-V5/wiki/Checking_firmware_and_upgrading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 for the update instructions. I will post a follow up if it resolves the issue.

—
Reply to this email directly, view it on GitHub, or unsubscribe.
Triage notifications on the go with GitHub Mobile for iOS or Android.
You are receiving this because you authored the thread.Message ID: ***@***.***>

fredqbee, 2022-02-23:
Hi Fred, 
The xPRO comes loaded with the stock firmware, which can run the spindle using a PWM or 0-10V signal.  To run the Spindle with the RS485 control new firmware needs to be loaded.  
For now ditch CNCcommander - you can come back to that when the firmware is loaded. 
turn on the controller, then open your computers wifi settings. You will see a CNC_xPRO_V5 access point available.  Connect to it, and the embedded Web interface on the controller will open.  
From there, follow these instructions to upload the .bin that you downloaded.  Instructions: Checking_firmware_and_upgrading · Spark-Concepts/xPro-V5 Wiki (github.com)
On Sun, Feb 6, 2022 at 2:11 ***@***.******@***.***> wrote:

Hi Mike,I am a little confused. When I bought the QueenBee, Bulkman said that the xPro V5 had all the firmware already installed on the SD card. I started using cncjs in the beginning, but axis didn't move correctly, the spindle didn't work, and it was a little confusing. After some research I switched to cnc3d commander. I was able to get my axis working and homed. I also was able to see what was on the (pics included) SD card. Unfortunately, I still couldn't run my spindle and cnc3d commander doesn't communicate with fusion 360. I switched back. Luckily, everything I did in cnc3d commander seamed to transfer over. I saw the firmware on the SD card but cncjs doesn't differentiate between firmware. It just loads. If I load another firmware on the SD card, will I be able to pick the correct firmware or will it just load. Why can't I pick the correct one now? Will I be able to upgrade to the WebUI? I am assuming I need to load the CNC_xPRO_V5_XYYZ_485_NO. I don't see any instructions on how to load this to the xPro V5

    On Wednesday, February 23, 2022, 10:19:36 AM EST, sdom001 ***@***.***> wrote:

ok update. I emailed Mike at Spark Concepts and he had me Run the $i command. It sent back this.
[VER:1.3a.20201022:]
[OPT:MPHBSW#]
[MSG:Using machine:CNC_xPRO_V5_XYYZ]
[MSG:Mode=AP:SSDI=CNC_xPRO_V5:IP=192.168.0.1:MAC=94-3C-C6-9D-74-55]
[MSG:No BT]
I sent it to him and his response was my Xpro v5 firmware was out of date and needed to be updated to use the RS485 with spindles. and to go here https://github.com/Spark-Concepts/xPro-V5/wiki/Checking_firmware_and_upgrading.
which then led me here https://github.com/Spark-Concepts/xPro-V5/tree/main/Firmware to get the update
and here https://github.com/Spark-Concepts/xPro-V5/wiki/Checking_firmware_and_upgrading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 for the update instructions. I will post a follow up if it resolves the issue.

—
Reply to this email directly, view it on GitHub, or unsubscribe.
Triage notifications on the go with GitHub Mobile for iOS or Android.
You are receiving this because you authored the thread.Message ID: ***@***.***>

fredqbee, 2022-02-23:
Best I could. Hope you can follow

sdom001, 2022-02-23:
Updating the firmware to the xpro v5 worked. I used the .NO file. spindle now works

fredqbee, 2022-02-23:
I used CNC_xPro_V5_XYYZ_No.Bin

sdom001, 2022-02-24:
I did as well thank you. The only issue I have now is the spindle spins counter clockwise when it should be turning clockwise.

Sent from my iPhone
Silvio Domingues

On Feb 23, 2022, at 6:48 PM, fredqbee ***@***.***> wrote:

I used CNC_xPro_V5_XYYZ_No.Bin

—
Reply to this email directly, view it on GitHub<https://github.com/Spark-Concepts/xPro-V5/issues/102#issuecomment-1049339493>, or unsubscribe<https://github.com/notifications/unsubscribe-auth/AX4ERHCKKDNYV2CWL2LAIP3U4VW3JANCNFSM5MBNH7PA>.
Triage notifications on the go with GitHub Mobile for iOS<https://apps.apple.com/app/apple-store/id1477376905?ct=notification-email&mt=8&pt=524675> or Android<https://play.google.com/store/apps/details?id=com.github.android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>.
You are receiving this because you commented.Message ID: ***@***.***>

sdom001, 2022-02-24:
thanks for the reply. I did a little more research and it is simply swapping any 2 wires from the vfd to the spindle.(u,v,w)

________________________________
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

Thread 103 (2022-01-16):

Z limit switch problem

IlValeSocial, 2022-01-16:
Hi,

I have a similar issue, if I try to press limit switch of Z axis doesn't work, If I try to connect it to xpro board, led don't turn on

If I try to test pressing X limit switch and send "?" command I receive message:
<Idle|MPos:135.955,-12.500,24.410|F5:0,0|Pn:XZ|WCO:0.000,0.000,0.000>

IF i try with Z limit switch I display this:
<Idle|MPos:135.955,-12.500,24.410|F5:0,0|WCO:0.000,0.000,0.000>

I hope is PIN problem, How can I solve?

Thanks a lot for any help

_Originally posted by @IlValeSocial in https://github.com/Spark-Concepts/xPro-V5/issues/20#issuecomment-1013753425_

IlValeSocial, 2022-01-25:
Hi, there is a solution to my issue?

Thanks a lot

Spark-Concepts, 2022-08-09:
Are you still having issues with your Z limit switch? If so, please re-post and I will be happy to assist :-)

Closed 2022-08-09.

Thread 104 (2022-01-18):

Relay problem

matus1504, 2022-01-18:
Hello.
I have problem with my relay.
I wanted it to turn on the vacuum cleaner when spindle works.
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
When the internal jumper i on the "mist signal" relay works on m7 command.
But when I change jumper on "spindle enable signal" and turn on spindle, relay will not work.

Spark-Concepts, 2022-01-20:
Have you defined a spindle type with setting:

$Spindle/Type =

Can you share your $s settings?

matus1504, 2022-01-20:
spindle type is Huanyang

$System/Hostname=CNC_xPRO_V5
$Http/Enable=ON
$Http/Port=80
$Telnet/Enable=ON
$Telnet/Port=23
$Radio/Mode=STA
$Bluetooth/Name=XPRO_V5_BT
$Notification/Type=NONE
$Notification/T1=
$Notification/T2=
$Notification/TS=
$Message/Level=Info
$User/Macro0=
$User/Macro1=
$User/Macro2=
$User/Macro3=
$Homing/Cycle0=Z
$Homing/Cycle1=XY
$Homing/Cycle2=
$Homing/Cycle3=
$Homing/Cycle4=
$Homing/Cycle5=
$Report/StallGuard=
$Stepper/Enable/Delay=0
$Stepper/Direction/Delay=0
$Stepper/Pulse=4
$Stepper/IdleTime=250
$Stepper/StepInvert=
$Stepper/DirInvert=
$Stepper/EnableInvert=Off
$Limits/Invert=On
$Probe/Invert=On
$Report/Status=1
$GCode/JunctionDeviation=0.010
$GCode/ArcTolerance=0.002
$Report/Inches=Off
$Firmware/Build=
$Limits/Soft=On
$Limits/Hard=On
$Homing/Enable=On
$Homing/DirInvert=
$Homing/Squared=
$Homing/Feed=100.000
$Homing/Seek=1500.000
$Homing/Debounce=250.000<Idle|MPos:-238.322,23.835,3.812|FS:0,0>
$Homing/Pulloff=3.000
$GCode/MaxS=24000.000
$GCode/MinS=8000.000
$Laser/FullPower=1000
$GCode/LaserMode=Off
$GCode/Line1=
$GCode/Line0=
$Spindle/Enable/Invert=Off
$Spindle/Enable/OffWithSpeed=Off
$Coolant/Delay/TurnOn=1.000
$Spindle/Delay/SpinDown=0.000
$Spindle/Delay/SpinUp=0.000
$Spindle/PWM/Invert=Off
$Spindle/PWM/Frequency=5000.000
$Spindle/PWM/Off=0.000
$Spindle/PWM/Min=0.000
$Spindle/PWM/Max=100.000
$Spindle/Type=HUANYANG
$X/StepsPerMm=400.000
$Y/StepsPerMm=400.000
$Z/StepsPerMm=400.000
$A/StepsPerMm=200.000
$B/StepsPerMm=100.000
$C/StepsPerMm=100.000
$X/MaxRate=2000.000
$Y/MaxRate=2000.000
$Z/MaxRate=2000.000
$A/MaxRate=1000.000
$B/MaxRate=1000.000
$C/MaxRate=1000.000
$X/Acceleration=300.000
$Y/Acceleration=300.000
$Z/Acceleration=300.000
$A/Acceleration=200.000
$B/Acceleration=200.000
$C/Acceleration=200.000
$X/Home/Mpos=0.000
$Y/Home/Mpos=0.000
$Z/Home/Mpos=0.000
$A/Home/Mpos=0.000
$B/Home/Mpos=0.000
$C/Home/Mpos=0.000
$X/MaxTravel=1305.000
$Y/MaxTravel=1285.000
$Z/MaxTravel=125.000
$A/MaxTravel=300.000
$B/MaxTravel=300.000
$C/MaxTravel=300.000
$X/Current/Run=2.500
$Y/Current/Run=2.500
$Z/Current/Run=2.500
$A/Current/Run=2.500
$B/Current/Run=0.250
$C/Current/Run=0.250
$X/Current/Hold=0.500
$Y/Current/Hold=0.500
$Z/Current/Hold=0.500
$A/Current/Hold=0.500
$B/Current/Hold=0.125
$C/Current/Hold=0.125
$X/Microsteps=16
$Y/Microsteps=16
$Z/Microsteps=16
$A/Microsteps=16
$B/Microsteps=16
$C/Microsteps=16
$X/StallGuard=16
$Y/StallGuard=16
$Z/StallGuard=16
$A/StallGuard=16
$B/StallGuard=16
$C/StallGuard=16
$Errors/Verbose=Off
ok
>

Spark-Concepts, 2022-02-06:
I see your using the RS485 to control your spindle. Unfortunately the "spindle enable signal" is consumed by the RS485 signal (see below)

A work-around as you mentioned would be to move the internal jumper to the "mist signal" - then add an M7 command at the beginning of your g-code to activate the relay for your vacuum.

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

Closed 2022-08-09.

Thread 105 (2022-01-23):

Loss of probe functionality after VFD run

ColPaulR, 2022-01-23:
I set the z-height to the spoil board using the probe, roughed my part, and attempted tool change. G38.2 always returns "Found" immediately even though probe signal is not present. "?" shows probe is not touching and probe light is off. Problem is repeatable.

In order to get my xPro and Huanyang VFD to talk over RS-485, I had to connect the VFD 220V AC ground to the xPro 28V gnd and the xPro digital ground to the VFD ACM. Removing either of these connections results in RS-485 failing to respond.

I was cutting a pinewood derby car today after finally getting the RS-485 working. When reseting the Z height with probe after a tool change, the G38.2 command always returns "Found" immediately. I did a "?" and the probe is not triggered. In addition, the probe light is off.

I'm assuming this has to be a software issue as the hardware is showing no conductivity with the probe.

ColPaulR, 2022-01-24:
Issue was user error. I misinterpreted the message "[MSG:Found]" as the probe contacting and stopping. The z-axis was moving too slowly for me to notice and dust collector masked the motor sound. Everything is (and was) working as it should, except me.

Closed 2022-01-24.

Thread 106 (2022-01-26):

Y1 driver dead :(

luckypants123, 2022-01-26:
Went to run another test program to try and confirm [#98](https://github.com/Spark-Concepts/xPro-V5/issues/98) is solved for me.....aaaand the Y axis driver is dead/dying.

Commanding it to do anything results in grinding noise as the motor pulses back and forth.

Swapped motors and confirmed its the Y1 driver.

It's brand new....think I've got about 4 hours of use out of this thing.

What's the warranty situation like? Can just the driver be replaced?

toonaoki, 2022-01-26:
It's a similar symptom.
It's been less than a month since I got it, but the Y1's motor driver isn't working properly.
I noticed that the settings and motors are exactly the same as the X-axis, but vibrations occur and the Motor fault indicators are lit.
I would like to know the means to turn off the indicator.

I hope it can be replaced with just the motor driver ...

Closed 2022-02-01.

Thread 107 (2022-01-26):

Laser mode no pwm signal

Nastyfast44, 2022-01-26:
I am trying to activate the laser using m3 commands. I am able to activate it with $spindle/type=pwm.  I send command m3s24000 and the laser turns on at what I expect is full power, as my max spindle speed is 24000.   The issue occurs when I change to $spindle/type=laser with $32 1. It’s states that laser_output_pin not defined. I send m3s24000 and I do not detect any voltage from pwm pin. Laser will not fire.

I’m using pwm firmware with a neje a40640 laser module. I am also using ugs to send commands.

Spark-Concepts, 2022-02-06:
You will need to use [$pindle/type=PWM](https://github.com/Spark-Concepts/xPro-V5/wiki/Front_Panel#spindletypepwm); on the xProV5's default firmware there is not a physical GPIO assigned to the "laser" $spindle/type

***Note: the $spindle/type sets which GPIO is currently active as well as if the signal is discrete(ON/OFF), analog(PWM), or RS485***

Regardless ***PWM*** and ***Laser*** Spindle Types are functionally the exact same.

Nastyfast44, 2022-02-07:
I got it to work. Thank you. I realized the newest firmware worked for both pwm and rs485. Switched and everything seems to be working as it should now. Thank you

Closed 2022-02-07.

Thread 108 (2022-01-26):

Laser and Rs485 switch

matus1504, 2022-01-26:
How can I choose between spindle and laser without touching the Rs485/Pwm switch?
"Changing between the different control options requires the appropriate firmware to be installed"
What do you mean about it?
I can't find a solution.

Nastyfast44, 2022-01-28:
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
Choose the file that relates to your emergency stop switch. The lever on your xpro will swap between the two (pwm& rs485). Don’t use anything on the old firmware page.  Don’t use the laser firmware either unless u have a bulkman laser.

Link to firmware in case pic doesn’t go through.

https://github.com/Spark-Concepts/xPro-V5/tree/main/Firmware

Nastyfast44, 2022-01-28:
To my knowledge which this fixed my issue 5 min ago. This is a cross between the two and works for both

Closed 2022-02-06.

Thread 109 (2022-02-03):

I have problem with HuanYang!!!

ghalib1399, 2022-02-03:
Hi ALL
when I do $spindle/type=huanyang
I receive:
[MSG:Initializing RS485 VFD spindle]
[MSG:Auto-RTS in use]
E (634349) uart: UART driver already installed
[MSG:VFD RS485  Tx:GPIO(4) Rx:GPIO(25) RTS:None]
ok

after that I do
M3 S8000
I get
[MSG:Spindle RS485 Unresponsive 6]
[MSG:Critical Spindle RS485 Unresponsive]
ALARM:10
[MSG:Critical Spindle RS485 did not reach speed 8000. Reported speed is 0 rpm.]
ok
ALARM:10

OR

[MSG:Spindle RS485 Unresponsive 7]
[MSG:Critical Spindle RS485 did not reach speed 8000. Reported speed is -1 rpm.]
ok
ALARM:10

then i have to  do unlock and stop the router from the vfd!!!
-----

I flow [https://github.com/Spark-Concepts/xPro-V5/wiki/Front_Panel#toolheadvfd-rs485](url)
but it not solve my problem

-----
> $$
$0=4 (Step pulse time, microseconds)
$1=250 (Step idle delay, milliseconds)
$2=0 (Step pulse invert, mask)
$3=4 (Step direction invert, mask)
$4=0 (Invert step enable pin, boolean)
$5=1 (Invert limit pins, boolean)
$6=1 (Invert probe pin, boolean)
$10=1 (Status report options, mask)
$11=0.010 (Junction deviation, millimeters)
$12=0.002 (Arc tolerance, millimeters)
$13=0 (Report in inches, boolean)
$20=0 (Soft limits enable, boolean)
$21=0 (Hard limits enable, boolean)
$22=1 (Homing cycle enable, boolean)
$23=0 (Homing direction invert, mask)
$24=200.000 (Homing locate feed rate, mm/min)
$25=2000.000 (Homing search seek rate, mm/min)
$26=250.000<Idle|MPos:0.000,0.000,0.000|FS:0,0> (Homing switch debounce delay, milliseconds)
$27=2.500 (Homing switch pull-off distance, millimeters)
$30=24000.000 (Maximum spindle speed, RPM)
$31=8000.000 (Minimum spindle speed, RPM)
$32=0 (Laser-mode enable, boolean)
$100=400.000 (X-axis travel resolution, step/mm)
$101=400.000 (Y-axis travel resolution, step/mm)
$102=400.000 (Z-axis travel resolution, step/mm)
$103=400.000
$104=100.000
$105=100.000
$110=4000.000 (X-axis maximum rate, mm/min)
$111=4000.000 (Y-axis maximum rate, mm/min)
$112=4000.000 (Z-axis maximum rate, mm/min)
$113=4000.000
$114=1000.000
$115=1000.000
$120=300.000 (X-axis acceleration, mm/sec^2)
$121=300.000 (Y-axis acceleration, mm/sec^2)
$122=300.000 (Z-axis acceleration, mm/sec^2)
$123=300.000
$124=200.000
$125=200.000
$130=1292.000 (X-axis maximum travel, millimeters)
$131=1205.000 (Y-axis maximum travel, millimeters)
$132=300.000 (Z-axis maximum travel, millimeters)
$133=300.000
$134=300.000
$135=300.000
ok

Cyrill87, 2022-02-04:
I do have the same Problem with the new Firmware and RS485

Nic-marangon, 2022-02-12:
Me too...how did you resolve?

ColPaulR, 2022-02-12:
> I do have the same Problem with the new Firmware and RS485

Maybe I'm reading into the above, but does the problem not exist with prior firmware? If so, which firmware works? I have the same issue and have switched to 0-10V plus relay control. I'd like to go back to RS485 if we can make it stable.

deverelo, 2022-02-16:
Use shielded 4 core cable for your spindle. Connect the earth and shield at BOTH ends. This is specific to vfds compared to other shielding

Spark-Concepts, 2022-08-09:
please check out the following: [https://github.com/Spark-Concepts/xPro-V5/issues/164#issuecomment-1208726453](https://github.com/Spark-Concepts/xPro-V5/issues/164#issuecomment-1208726453)

Closed 2022-08-09.

Thread 110 (2022-02-06):

Please advice - how to control brushless spindle motor (wiring)

wildfang, 2022-02-06:
Hello there,
I'm trying to make this brushless spindle motor work with automatic control:

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

https://www.amazon.de/KSTE-WS55-220-Brushless-Spindel-BLDC-Motortreiber-Controller/dp/B082563ZJD

It runs fine when controlled with the pot and switch, but I need to connect it to the controller so I can control it by GRBL.

For the manual control, the pot is connected to:
GND (black), 10v (red), SV (yellow)

The switch is connected to:
GND (black), F/R (blue)

I tried Spindle/10V, Spindle/PWM and Spindle/DAC.

I can get 5V signal from the output but no output on the 10v terminal. I can hear the relay clicking when sending M3 but the spindle does not move.

Any help on how to get it working? That would be great, thanks!

Kind regards

Spark-Concepts, 2022-02-06:
You will first need to configure the spindle as: $Spindle/Type=PWM

The pwm signal is activated by an M3 or M4 gcode statement. The value of the pwm signal is determined by the speed portion of the M3/M4 command – ex. M3 S500 will create a half max pwm signal output or 2.5V on the PWM terminal and 5V on the 0-10V on the terminal (assuming the default max spindle speed of 1,000rpm)...

***The max spindle speed setting is defined by setting $30 (typically $30-1000)***

See below for wiring (the switch controls the direction of the spindle - per the motor driver's datasheet):

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

wildfang, 2022-02-07:
Hi,

thank you very much for your reply. I wired it up via the diagram but I still don't get any output on the 10v terminal.
I can get 5V on the PWM terminal with S3 1000 but the 10v terminal measures at 0.075V.

Here is what I see when printing settings:

>
$Spindle/Enable/Invert=Off
$Spindle/Enable/OffWithSpeed=Off
$Coolant/Delay/TurnOn=1.000
$Spindle/Delay/SpinDown=0.000
$Spindle/Delay/SpinUp=0.000
$Spindle/PWM/Invert=Off
$Spindle/PWM/Frequency=5000.000
$Spindle/PWM/Off=0.000
$Spindle/PWM/Min=0.000
$Spindle/PWM/Max=100.000
$Spindle/Type=PWM

$30 is set to 1000

Do I need to do something further to enable the 10V terminal? I have not tried adjusting the internal pot because I think it can't be that far off from the factory, no?

Spark-Concepts, 2022-02-08:
If you are measuring 0-5V DC on the `PWM` output, you should also measure 0-10V DC on the `0-10V` output. Unless wiring was connected such that the 0-10V was short circuit to ground causing damage. If this was the case the 0-10V op-amp is likely bad and would need to be replaced.

***But before going there***; try manipulating the internal pot as it may be measuring a dead spot. If this doesn't fix your issue please contact us via https://www.spark-concepts.com/contact-us-1/

wildfang, 2022-02-08:
Hi,
thanks for your reply. I don't measure any current on the 0-10V.

However, as I was a little impatient, I just plopped a PWM to 0-10V converter board into my controller and everything works very well.

Is the 0-10v OP-amp some part I could change myself at a later stage, if I happen to need it?

Spark-Concepts, 2022-08-09:
You can - however if you live in the US we can replace it for you free of charge - use the Contact Us link on our Spark-Concepts.com website

Closed 2022-08-09.

Thread 111 (2022-02-06):

Cooling fan stopped working

mwipp66, 2022-02-06:
I think there may be something wrong with my controller. I previously had everything working as it should for the stepper motors and limit switches. While hooking up the spindle i was having some issues with the controller communicating with the VFD through rs485. Since i was having issues, i decided to reset everything (VFD settings, controller firmware and GRBL settings). After re-applying the firmware and re-setting GRBL settings, i started setting up my settings for my machine. As i was working on this i noticed the cooling fan on the controller was no longer spinning, when i got closer i also noticed a small amount of white smoke, so i shut everything down instantly.

Sparkconcepts, are you able to help me out here?

The controller was purchased through bulkman3d with my queenbee kit. Just received everything late January

Spark-Concepts, 2022-02-06:
***Note: the cooling fan is temperature controlled - therefore it's not always going to be ON (load dependent)***

That said, it's possible the magic smoke leaked out from the cooling fan.

If you're still having issues please reach out to us via:
https://www.spark-concepts.com/contact-us-1/

Closed 2022-02-06.

Thread 112 (2022-02-07):

Mist allows vacuum turn on during power up or reset

ColPaulR, 2022-02-07:
I have my dust collector controlled by the mist signal through an SSR. If I leave the dust collector switch in the on position, the Xpro V5 will turn on the dust collector until the end of its boot sequence. Same thing happens when I connect a USB. I'm assuming a soft reset on USB connect. I would STRONGLY suggest moving the initialization for this earlier in the startup sequence. Looking through the source code, it appears to me that the pin direction and initial value does not get set until near the end of the sequence. void loop->run_once()->reset_variables()->coolant_init(), which contains pinMode() and coolant_stop().

Maybe I'm reading the code wrong. If not, I suggest both the pinMode() and coolant_stop() be called as soon as possible. Seems like void setup()->grbl_init() would enable the GPIO to be set to a safe configuration right after i2s_out_init(). I don't have the schematic for the board, but I'm assuming the GPIO comes up in tri-state or input mode. Looking at [Cool_SS.jpg](https://github.com/Spark-Concepts/xPro-V5/raw/main/images/Cool_SS.jpg), I would assume a pull-up resistor on the pin would disable the MOSFET until the software could configure itself.

Spark-Concepts, 2022-02-07:
ColPaulR,

So in looking at the schematic, yes it appears GPIO (21) if tristate, would cause the MIST output FET to source ground (turn ON). As you can see below there there is an additional nFET (2N7002) which is level shifting the esp32's 3.3V logic to 5V applied to the gate of the larger nFET (Q2B).  This is because a 3.3V gate voltage is insufficient to allow Q2B to fully conduct.

We will take a look at the startup sequence to minimize the initialization period to not have GPIO 21 in tristate throughout the boot sequence.

Alternately if your Spindle Type is set to PWM you can use the EN output. The spindle enable "EN" is activated when the spindle is turned ON - Please note the output of EN is 3.3V (most SSR's control voltages are 3-32VDC).

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

ColPaulR, 2022-02-07:
Thanks for the rapid reply. I'll take a look at using the EN signal vs. mist as I'm using 10V plus relay (couldn't get RS-485 to reliably work). I added an "M7" plus a 2 second dwell to the post processor before M3 to allow the dust collector to turn on and get past the inrush before the spindle turns on and sinks current. The dust collector is 110V on a separate circuit but it is a 2HP and dims the lights a little when spooling up. Spindle/VFD is much better behaved in its init.

BTW, I'm in Washington Township OH. I noticed that Spark Concepts was Waynesville so we are neighbors!

Closed 2022-08-09.

Thread 114 (2022-02-17):

Spindle problem.

nonosapiens, 2022-02-17:
Hello,

I have a problem with VFD / PWN / Spindle speed.
When I send M3 the engine runs at 24,000 normally - keep sae speed
But when I send a gcode to Cnc, Spindle speed changes with big variations
When I measure the voltage at the Cnc pro V5 output, the voltage moves ( 9v... 8v.. 7V... )  during the cut
Its note the Gcode, each line have same Sxxxx

I use new firmware  CNCxPROv5_XYYZ_NO
Where can it come from ?

Thanks alot

nonosapiens, 2022-02-17:
$Homing/Cycle0=Z
$Homing/Cycle1=XY
$Stepper/Pulse=5
$Stepper/IdleTime=255
$Stepper/DirInvert=X
$Stepper/EnableInvert=Off
$Limits/Invert=On
$Probe/Invert=Off
$Report/Status=1
$Limits/Hard=On
$Homing/Enable=On
$Homing/DirInvert=XY
$Homing/Feed=100.000
$Homing/Seek=1500.000
$Homing/Pulloff=5.000
$X/StepsPerMm=26.84
$Y/StepsPerMm=26.78
$Z/StepsPerMm=199.100
$A/StepsPerMm=26.678
$X/MaxRate=9000.000
$Y/MaxRate=9000.000
$Z/MaxRate=800.000
$A/MaxRate=9000.000
$X/Acceleration=150
$Y/Acceleration=150
$Z/Acceleration=50
$A/Acceleration=150
$X/MaxTravel=1252.00
$Y/MaxTravel=2484.00
$Z/MaxTravel=80.00
$A/MaxTravel=2484.00
$X/Current/Run=1.9
$Y/Current/Run=1.9
$Z/Current/Run=1.9
$A/Current/Run=1.9
$X/Current/Hold=1.1
$Y/Current/Hold=1.1
$Z/Current/Hold=1.1
$A/Current/Hold=1.1
$X/Microsteps=8
$Y/Microsteps=8
$Z/Microsteps=8
$A/Microsteps=8
$Spindle/Type=PWM

bn1, 2022-08-16:
Hi @Ugilten , so how did you connected it? I have the same spindle and I'm about to connect it today. Just realized that I need that 10-26 V from somewhere, so I'm thinking about connecting it to the mist port, while changing the pin for the output power to 24 V. Am I thinking right about it? Should I connect and use both gnd slots in those both ports? Thank you for the inspiration! :)

Ugilten, 2022-08-16:
Hi @bn1 ,
I connected the tool GND to PSU GND and gave the spindle 24V from the PSU as well and that fixed it.

bn1, 2022-08-16:
Hi @Ugilten did you connected it directly to PSU, meaning there are 24 volts all the time? Not through the x5 pro and waiting for any signal? Huh, maybe an easier and more robust solution 😄

Ugilten, 2022-08-16:
Hi @bn1. Yes, the spindle is constantly on. I didn’t think about that before now 😬
Luckily the spindle has the ‘on’ button… but I keep forgetting it…

bn1, 2022-08-16:
@Ugilten Ah, cool, that works for me. I'm switching off power for my whole shop when I'm out, so this is no issue for me. Thank you for the resolution! 😉

Ugilten, 2022-08-16:
No problem @bn1 . Happy cutting 👍

bn1, 2022-08-19:
@Ugilten well, I have connected to mist port to be able to switch on/off spindle programatically. After few uses I have figured out that it is more practical to let in on all the time. I'm still able to switch the spindle off with the button on the spindle itself. So I ended up with your solution 😄 cheers 👌

Closed 2022-08-09.

Thread 116 (2022-02-26):

Spindle start but doesn't stop after firmware update

JosDrolkoppers, 2022-02-26:
Hi All,

I connected a NC emergency stop and had to update the firmware. Everything works, but I can only start the spindle (via RS458) in Candle, but I can't stop it.
$Spindle/type=HUANYANG.

Everything worked fine before the update.

Thanks for your thoughts.
BickyBurger

JosDrolkoppers, 2022-05-27:
Thanks for the advice. I tried the twisted pair, but I got the same result.
I noticed you updated the documentention and added a resistor. I'll try that.

KInd regards,
Maarten

id192313, 2022-06-02:
Hi, managed to get it solved?

Randall-Dev, 2022-06-13:
How did you do it?  and what country are you in?  I'm in Europe using 230v the emi is driving me nuts..

id192313, 2022-06-14:
Hi Randall, I started with not able to control the spindle fully. Kept giving unresponsive error after it start running. Than I followed all the fixes I found on GitHub and Reddit. Install new firmware (NC), separate spindle wire away from the rest, ground the spindle wire, put resistor on both of the rs485 end. Still doesn’t work.
Then I remove the the spindle ground on the VFD and move it to the body ground. Suddenly it works. Everything works. I did some test by moving the spindle cable next to the controller. Didn’t work. I thought I found the culprit but I was wrong cause I put everything back to the cable chain and even remove the ground. It still works. Only thing that did t work is the resistor.  Remove it and the this stop working.
Between these changes I found lose wire on those green connector and reinstall the firmware and reconfigure it. Now the only diff from the beginning is the resistor. That must definitely be part of it. I’m on 240v in Malaysia.

Hope this help.

Sent from my iPhone

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

Closed 2022-08-09.

Thread 118 (2022-03-02):

Overheated motors

Wilson-Diaz-V, 2022-03-02:
A question on how I can reduce the amperage, on circuit, that reaches my stepper motors, because they overheat too much when working, my motors consume only 3.8 amps., thanks

Spark-Concepts, 2022-03-02:
[$X/Current/Run thru $C/Current/Run $140 thru $145 – [X,Y,Z,A,B,C] Stepper Run Current (extended settings)](https://github.com/Spark-Concepts/xPro-V5/wiki/Changing-settings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)

This is the run current in amperes for Trinamic SPI stepper drivers. This is RMS current, not MAX current - to calculate this setting, looking up the maximum current for your motor and multiply by 0.707. Example: Most Nema23 motors are rated for 2.8Amax therefore this setting = 2.8 * 0.707 = 1.97. * *Note: it is not great to run motor at max current for extended periods, would recommend setting this to roughly 90% of the calculated RMS current - for our example we would set our standard Nema28, with a 2.8A max, to a value of 1.8 for this setting

e.g.
```
$140 = 1.8
$141 = 1.8
$142 = 1.8
$143 = 1.8
```

[$X/Current/Hold thru $C/Current/Hold or $150 thru $155 – [X,Y,Z,A,B,C]](https://github.com/Spark-Concepts/xPro-V5/wiki/Changing-settings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)

Stepper Idle Current (extended settings)
This is the hold current in amperes for Trinamic SPI stepper drivers. This is RMS current, not MAX current - generally, we recommend setting this to 50% to 75% of the Run current value - in our example, we would set this to 1.1
e.g.
```
$150 = 1.1
$151 = 1.1
$152 = 1.1
$153 = 1.1
```

Closed 2022-08-09.

Thread 119 (2022-03-06):

Probe issue

mwipp66, 2022-03-06:
So i have my machine fully setup and everything is operational except the probe. To this point i have been just visually setting the bit height, but wanted to setup my probe.

The probe is a simple NO probe and the setting and grbl have probe pin inverted. As soon as I plug in the probe, the probe indicates its triggered. So initially i assumed it was due to my probe wiring being unshielded (thought maybe some noise issues). So i rewired it with shielded wire (and grounded the shield), the issue still remained.

Only time i get get the probe light off is if its unplugged. During experimentation i plugged in a empty plug and tried measuring voltage at the signal pin. As soon as my multimeter probe touches the signal pin the light comes on.

So at this point i am stumped... any advice would be appreciated! I feel like im missing something

mwipp66, 2022-03-10:
I have been working with Bill at spark concepts and we believe we have identified an issue with my controller specifically. I am currently working with him to have it replaced or repaired. Closing issue

Closed 2022-03-10.

Thread 120 (2022-03-12):

Power connector burned

wildfang, 2022-03-12:
Hi.

My xPro-5 just stopped in the middle of a job. When I took a closer look, I noticed that the 24v connector melted.

I don't know how this happened, I used cables of proper weight with proper ferules that sit really tight. The connector itself was pressed into place like it should. It wasn't loose and it didn't wiggle.

I haven't used it more than 6 hours in total, so I'm not happy.

Can you please advice what to do?

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

Spark-Concepts, 2022-03-13:
Most likely a bad connector (potentially corrosion,  contamination,  or plastic injection molding flash); please contact us directly at https://www.spark-concepts.com/contact-us-1/ for resolution

Closed 2022-03-18.

Thread 122 (2022-03-17):

Controller has stopped responding, console claims no firmware

bandidobrent, 2022-03-17:
I swapped out my Endurance laser for my SainSmart (done this many times before) but now when I try to connect I get nothing. Tried connecting to the controller, only response I can get through any program is no firmware is present. No way to flash firmware, is my board fried?

Spark-Concepts, 2022-03-18:
**1. What senders (programs) are you using to connect to the xPro?**
**2. Do you see the xPro-V5's COM port present under device manager when you plug the controller in via USB?**
**3. Are you able to access the xPro-V5 WebUI via Wi-Fi?**

If you're controller is unresponsive via Wi-Fi and USB - is it possible that power (either 24V or USB) was connected while connecting your laser to the controller? If so, it's possible something may have accidentally shorted in the process.

That said, if you have a multimeter check a few things before we run down a rabbit hole...

1. Disconnect the USB cable and power only using your 24V power supply
5. Remove the lid by removing the four lid screws and expose the top PCB
6. Turn your 24V power supply ON
7. Measure for 5 Volts as shown below (also check the remaining voltages as shown on the right)
8. Remove 24V or turn OFF 24V power supply
9. Plug in USB cable, and power via a PC or USB power brick
10. Re-Measure for 5V and 3.3V (24V should be 0-ish)
11. Please let me know your test results (actual voltages measured)

| Voltage  | 24V PSU Only | USB Only |
| ------------- | ------------- | ------------- |
| 3.3V  | (value?)  | (value?) |
| 5V  | (value?)  | (value?) |
| 24V  | (value?)  | (value?) |

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

Also, if you have a USB multimeter (this step is not necessary - but may aid in troubleshooting), please check the Current draw with the USB connected (should be drawing 150-300mA @ ~5V)

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

bandidobrent, 2022-03-18:
Always good to be an electrician by trade when it comes to troubleshooting
these things, already had those numbers ready to go for ya.

PSU: 24v-23.9, 3.3-3.3, 5v-4.9
USB: 24v-0, 3.3-3.3, 5v-5
I cannot connect via WebUI. Tried via 192.168.0.1, asks for credentials.
Used the default login, no dice.
I usually just run LaserBurn. last night I ran through the list of senders
(LaserBurn, Candle, OpenBuilds, gSender, LaserGRBL) trying to get some kind
of usable data

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

Spark-Concepts, 2022-03-18:
Ok, so power looks good - you can try resetting the device to it's factory default firmware by using the [Flash Download Tool](https://github.com/Spark-Concepts/xPro-V5/tree/main/Firmware/Old%20Firmware/flash_download_tool)

It's important that you only use the firmware binary found in the same folder as the flash tool (be sure to read the Read-Me file)

bandidobrent, 2022-03-18:
The flashing tool has been running for over an hour now, pretty sure the controller isn't taking the firmware.... got anything else to try?

Spark-Concepts, 2022-03-18:
Be sure you hold down the button labeled "PGM" prior to clicking start on the flash tool...

If it doesn't automatically sync and begin uploading.. i.e. you see a message ```sync... ... ...```, you may need to nudge it into programming mode...

To manually enter programming mode do the following:
1. Hold down the recessed button labeled "PGM" next to the USB-C connector
2. While holding down the "PGM", toggle the "Reset" button next to the power switch
3. Keep holding down the the PGM until it begins uploading (you may need to toggle reset a few times - all the while holding the PGM button)

bandidobrent, 2022-03-18:
I tried that last night, no luck. Tried this morning, no luck.

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

Spark-Concepts, 2022-03-18:
Copy - please contact us directly at https://www.spark-concepts.com/contact-us-1/ for repair/replacment

bandidobrent, 2022-10-11:
The flashing tool has been running for over an hour now, pretty sure the
controller isn't taking the firmware.... got anything else to try?

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

Closed 2022-03-18.

Thread 123 (2022-03-20):

0-10v fine tune not working.

Anson90, 2022-03-20:
Hello.
I have connected my 1.5kw Folin vfd to the 0-10v and ground pins on the toolhead interface and also to the relay pins beside it (as per instructions).
switch on controller is on “pwm” and the spindle is set to pwm. Set my max and min speeds to 24000 and 8000 but when I hit command “M3S24000” I only get 2.4v instead of 10v and the fine tune does nothing. The Pwm input is 5v when I exicute the command of that helps at all 🤷‍♂️

I’ve set and reset my parameters three times now and am now thinking it may be a hardware issue?

Any ideas?

Spark-Concepts, 2022-03-22:
Also please copy and paste your settings ```$S```

Also, disconnect (unplug) EVERYTHING on your controller with the exception of 24V;
then enter ```M3 S24000``` and re-measure the 0-10V and PWM; what do you measure on each output?

Closed 2022-08-09.

Thread 124 (2022-03-22):

GRBL Travel distance issues

TTALON541, 2022-03-22:
I have been stuck on this for a couple of weeks. Calibration issues
Starting at the 0 positions, I move X 10in, however, it only moves 9.449 inches. with settings at 8 micro-steps and ``and 175 Step/mm.

Now if change the Steps/Mm ($100) to 200Steps/mm then I get the correct travel distance, but my motor ends up stalling out at long distances, so example, starting from 0, if I move 20inches it stalls towards the end, almost like stepper doesn't have enough power.

so 175steps/mm works just fine however the travel distance off by apx half in
or 200steps/mm stalls out but the distance is correct.
Current settings, 100$ I change back and fourth 175 to 200 bu3t the rest  are ggood
$+
$0=4 (Step pulse time, microseconds)
$1=255 (Step idle delay, milliseconds)
$2=0 (Step pulse invert, mask)
$3=1 (Step direction invert, mask)
$4=0 (Invert step enable pin, boolean)
$5=0 (Invert limit pins, boolean)
$6=0 (Invert probe pin, boolean)
$10=1 (Status report options, mask)
$11=0.010 (Junction deviation, millimeters)
$12=0.002 (Arc tolerance, millimeters)
$13=0 (Report in inches, boolean)
$20=0 (Soft limits enable, boolean)
$21=0 (Hard limits enable, boolean)
$22=1 (Homing cycle enable, boolean)
$23=3 (Homing direction invert, mask)
$24=200.000 (Homing locate feed rate, mm/min)
$25=2500.000 (Homing search seek rate, mm/min)
$26=250.000 (Homing switch debounce delay, milliseconds)
$27=2.500 (Homing switch pull-off distance, millimeters)
$30=24000.000 (Maximum spindle speed, RPM)
$31=0.000 (Minimum spindle speed, RPM)
$32=0 (Laser-mode enable, boolean)
$N1=
$N0=
$33=5000.000
$34=0.000
$35=0.000
$36=100.000
$100=175.000 (X-axis travel resolution, step/mm)
$101=175.000 (Y-axis travel resolution, step/mm)
$102=175.000 (Z-axis travel resolution, step/mm)
$103=175.000
$104=175.000
$105=175.000
$110=2500.000 (X-axis maximum rate, mm/min)
$111=2500.000 (Y-axis maximum rate, mm/min)
$112=2500.000 (Z-axis maximum rate, mm/min)
$113=2500.000
$114=2500.000
$115=2500.000
$120=200.000 (X-axis acceleration, mm/sec^2)
$121=200.000 (Y-axis acceleration, mm/sec^2)
$122=200.000 (Z-axis acceleration, mm/sec^2)
$123=200.000
$124=200.000
$125=200.000
$130=760.000 (X-axis maximum travel, millimeters)
$131=765.000 (Y-axis maximum travel, millimeters)
$132=150.000 (Z-axis maximum travel, millimeters)
$133=765.000
$134=300.000
$135=300.000
$140=1.800
$141=1.800
$142=1.800
$143=1.800
$144=1.800
$145=1.800
$150=0.125
$151=0.125
$152=0.125
$153=0.125
$154=0.125
$155=0.125
$160=8
$161=8
$162=8
$163=8
$164=8
$165=8
$170=16
$171=16
$172=16
$173=16
$174=16
$175=16

Spark-Concepts, 2022-08-09:
https://github.com/Spark-Concepts/xPro-V5/issues/162#issuecomment-1208752616

Closed 2022-08-09.

Thread 126 (2022-03-30):

0-5v output ttl not above 2.7v

TheFoxInBowen, 2022-03-30:
Since new i could not get a ssr relay to stay in, so i ran my router via the relay output.
I have now added a laser and want to use the ttl output to drive it.
In Lightburn I turn on constant power mode, 100% power, and the ttl output should be 5v approx and I get 2.6v.
Anyone had that issue?
Thanks
Trevor Fox

Spark-Concepts, 2022-05-16:
When you say ttl output are you referring to the terminal labeled "PWM"?

- performing the same test (at 100% power)
  1. measure the "0-10V"
      - do you measure ~5V or ~10V?
  2. power everything down and try toggling the "PWM - RS485" switch a few times to ensure it's indexed correctly and making good electrical contact (the PWM ttl signal routes through that switch).

Spark-Concepts, 2022-08-09:
Are you still having this issue?

Closed 2022-08-09.

Thread 127 (2022-04-03):

Y axis Stepper Motor stopped working during job. Red Light constantly on

Nepmuk, 2022-04-03:
I have a issue with my CNC xpro v5.

During a job on of the 2 y axis Stepper Motor stopped working and the x gantry got twisted.

The machine stopped and I tested the mechanics. Both y axis lead screws with the gantrys can be moved easily by hand. (I disconnected the motors from the leadscrew to test)
Now while jogging the y axis the y motor did not turn  smooth and also not in one direction. When switching the 2y axis motors the problem occures on the 2. Motor. So I think there is a problem with the stepper driver. Even after switching off and restarting the red indicator light on the y axis on the side of the cncpro is still constantly on.
Can u help me identify if it is a software or hardware problem? And hopefully we can solve it. The controller is around 6 month old and has only maybe 15 working hours and only with soft wood...

Thanks in advance

Jin454, 2022-04-11:
Hi. Did you solve the problem? I have the same issue + Motor connected to Y make loud noise when hold.

Nepmuk, 2022-04-11:
Unfortunately not. I hope to spark concept can step in with a idea.

Spark-Concepts, 2022-05-20:
Nepmuk, if you haven't already please contact us via https://www.spark-concepts.com/contact-us-1/

Closed 2022-05-20.

Thread 129 (2022-04-18):

Help, Y limit switch alarm shutting me down.

cdo1955, 2022-04-18:
When I first started using Xpro V5 the Y limit alarm would come in randomly. Mostly I could cut a project all the way through, but some times not before the alarm came in. The Y alarm shows on the screen using any of the G code senders, but the alarm light on the side of the controller never goes on. It happens constantly now and it never matters if the spindle is on or not. I'm wired with NO switches which I have verified are wired correctly. X and Z work perfectly. But Y alarm comes in all the time now. Without the Y limit switch alarm light ever coming on.
Below are my vitals:

ets Jun  8 2016 00:22:57
rst:0x1 (POWERON_RESET),boot:0x3 (DOWNLOAD_BOOT(UART0/UART1/SDIO_REI_REO_V2))
waiting for download
**** Connected to COM3 @ 115200 baud ****
**** Connection closed ****
ets Jun  8 2016 00:22:57
rst:0x1 (POWERON_RESET),boot:0x13 (SPI_FAST_FLASH_BOOT)
configsip: 0, SPIWP:0xee
clk_drv:0x00,q_drv:0x00,d_drv:0x00,cs0_drv:0x00,hd_drv:0x00,wp_drv:0x00
mode:DIO, clock div:1
load:0x3fff0018,len:4
load:0x3fff001c,len:1216
ho 0 tail 12 room 4
load:0x40078000,len:9720
ho 0 tail 12 room 4
load:0x40080400,len:6352
entry 0x400806b8
**** Connected to COM3 @ 115200 baud ****
[MSG:Grbl_ESP32 Ver 1.3a Date 20210816]
[MSG:Compiled with ESP32 SDK:v3.2.3-14-gd3e562907]
[MSG:Using machine:CNC_xPRO_V5_XYYZ_NC]
[MSG:Axis count 3]
[MSG:RMT Steps]
[MSG:Door switch on pin GPIO(16)]
[MSG:Macro Pin 1 GPIO(13)]
[MSG:Macro Pin 2 GPIO(0)]
[MSG:Init Motors]
[MSG:TMCStepper Library Ver. 0x000703]
[MSG:X  Axis Trinamic TMC5160 Step:GPIO(12) Dir:GPIO(14) CS:GPIO(17) Disable:None Index:1 R:0.050 Limits(0.000,1250.000)]
[MSG:X  Axis Trinamic driver test passed]
[MSG:Y  Axis Trinamic TMC5160 Step:GPIO(27) Dir:GPIO(26) CS:GPIO(17) Disable:None Index:2 R:0.050 Limits(0.000,1240.000)]
[MSG:Y  Axis Trinamic driver test passed]
[MSG:Y2 Axis Trinamic TMC5160 Step:GPIO(33) Dir:GPIO(32) CS:GPIO(17) Disable:None Index:3 R:0.050 Limits(0.000,1240.000)]
[MSG:Y2 Axis Trinamic driver test passed]
[MSG:Z  Axis Trinamic TMC5160 Step:GPIO(15) Dir:GPIO(2) CS:GPIO(17) Disable:None Index:4 R:0.050 Limits(-100.000,0.000)]
[MSG:Z  Axis Trinamic driver test passed]
[MSG:No spindle]
[MSG:Local access point CNC_xPRO_V5 started, 192.168.0.1]
[MSG:Captive Portal Started]
[MSG:HTTP Started]
[MSG:TELNET Started 23]
[MSG:Mist coolant on pin GPIO(21)]
[MSG:X  Axis limit switch on pin GPIO(35)]
[MSG:Y  Axis limit switch on pin GPIO(34)]
[MSG:Z  Axis limit switch on pin GPIO(39)]
[MSG:Probe on pin GPIO(22)]
Grbl 1.3a ['$' for help]
[MSG:'$H'|'$X' to unlock]
>>> $$
$0 = 4    (Step pulse time, microseconds)
$1 = 250    (Step idle delay, milliseconds)
$2 = 0    (Step pulse invert, mask)
$3 = 3    (Step direction invert, mask)
$4 = 0    (Invert step enable pin, boolean)
$5 = 1    (Invert limit pins, boolean)
$6 = 1    (Invert probe pin, boolean)
$10 = 1    (Status report options, mask)
$11 = 0.010    (Junction deviation, millimeters)
$12 = 0.002    (Arc tolerance, millimeters)
$13 = 0    (Report in inches, boolean)
$20 = 0    (Soft limits enable, boolean)
$21 = 0    (Hard limits enable, boolean)
$22 = 1    (Homing cycle enable, boolean)
$23 = 3    (Homing direction invert, mask)
$24 = 50.000    (Homing locate feed rate, mm/min)
$25 = 1000.000    (Homing search seek rate, mm/min)
$26 = 10.000    (Homing switch debounce delay, milliseconds)
$27 = 5.000    (Homing switch pull-off distance, millimeters)
$30 = 24000.000    (Maximum spindle speed, RPM)
$31 = 0.000    (Minimum spindle speed, RPM)
$32 = 0    (Laser-mode enable, boolean)
$100 = 200.000    (X-axis travel resolution, step/mm)
$101 = 200.000    (Y-axis travel resolution, step/mm)
$102 = 200.000    (Z-axis travel resolution, step/mm)
$103 = 200.000
$104 = 100.000
$105 = 100.000
$110 = 2500.000    (X-axis maximum rate, mm/min)
$111 = 2500.000    (Y-axis maximum rate, mm/min)
$112 = 2500.000    (Z-axis maximum rate, mm/min)
$113 = 1000.000
$114 = 1000.000
$115 = 1000.000
$120 = 50.000    (X-axis acceleration, mm/sec^2)
$121 = 50.000    (Y-axis acceleration, mm/sec^2)
$122 = 50.000    (Z-axis acceleration, mm/sec^2)
$123 = 200.000
$124 = 200.000
$125 = 200.000
$130 = 1250.000    (X-axis maximum travel, millimeters)
$131 = 1240.000    (Y-axis maximum travel, millimeters)
$132 = 100.000    (Z-axis maximum travel, millimeters)
$133 = 300.000
$134 = 300.000
$135 = 300.000
ok
>>> $G
[GC:G0 G54 G17 G21 G90 G94 M5 M9 T0 F0 S0]
ok
>>> $1=255
ok
>>> $120=100.000
ok
>>> $122=100.000
ok
>>> $121=100.000
ok
>>> $H
ok
**** Connection closed ****
ets Jun  8 2016 00:22:57
rst:0x1 (POWERON_RESET),boot:0x13 (SPI_FAST_FLASH_BOOT)
configsip: 0, SPIWP:0xee
clk_drv:0x00,q_drv:0x00,d_drv:0x00,cs0_drv:0x00,hd_drv:0x00,wp_drv:0x00
mode:DIO, clock div:1
load:0x3fff0018,len:4
load:0x3fff001c,len:1216
ho 0 tail 12 room 4
load:0x40078000,len:9720
**** Connected to COM3 @ 115200 baud ****
ho 0 tail 12 room 4
load:0x40080400,len:6352
entry 0x400806b8
[MSG:Grbl_ESP32 Ver 1.3a Date 20210816]
[MSG:Compiled with ESP32 SDK:v3.2.3-14-gd3e562907]
[MSG:Using machine:CNC_xPRO_V5_XYYZ_NC]
[MSG:Axis count 3]
[MSG:RMT Steps]
[MSG:Door switch on pin GPIO(16)]
[MSG:Macro Pin 1 GPIO(13)]
[MSG:Macro Pin 2 GPIO(0)]
[MSG:Init Motors]
[MSG:TMCStepper Library Ver. 0x000703]
[MSG:X  Axis Trinamic TMC5160 Step:GPIO(12) Dir:GPIO(14) CS:GPIO(17) Disable:None Index:1 R:0.050 Limits(0.000,1250.000)]
[MSG:X  Axis Trinamic driver test passed]
[MSG:Y  Axis Trinamic TMC5160 Step:GPIO(27) Dir:GPIO(26) CS:GPIO(17) Disable:None Index:2 R:0.050 Limits(0.000,1240.000)]
[MSG:Y  Axis Trinamic driver test passed]
[MSG:Y2 Axis Trinamic TMC5160 Step:GPIO(33) Dir:GPIO(32) CS:GPIO(17) Disable:None Index:3 R:0.050 Limits(0.000,1240.000)]
[MSG:Y2 Axis Trinamic driver test passed]
[MSG:Z  Axis Trinamic TMC5160 Step:GPIO(15) Dir:GPIO(2) CS:GPIO(17) Disable:None Index:4 R:0.050 Limits(-100.000,0.000)]
[MSG:Z  Axis Trinamic driver test passed]
[MSG:No spindle]
[MSG:Local access point CNC_xPRO_V5 started, 192.168.0.1]
[MSG:Captive Portal Started]
[MSG:HTTP Started]
[MSG:TELNET Started 23]
[MSG:Mist coolant on pin GPIO(21)]
[MSG:X  Axis limit switch on pin GPIO(35)]
[MSG:Y  Axis limit switch on pin GPIO(34)]
[MSG:Z  Axis limit switch on pin GPIO(39)]
[MSG:Probe on pin GPIO(22)]
Grbl 1.3a ['$' for help]
>>> $$
[MSG:'$H'|'$X' to unlock]
$0 = 4    (Step pulse time, microseconds)
$1 = 255    (Step idle delay, milliseconds)
$2 = 0    (Step pulse invert, mask)
$3 = 3    (Step direction invert, mask)
$4 = 0    (Invert step enable pin, boolean)
$5 = 1    (Invert limit pins, boolean)
$6 = 1    (Invert probe pin, boolean)
$10 = 1    (Status report options, mask)
$11 = 0.010    (Junction deviation, millimeters)
$12 = 0.002    (Arc tolerance, millimeters)
$13 = 0    (Report in inches, boolean)
$20 = 0    (Soft limits enable, boolean)
$21 = 0    (Hard limits enable, boolean)
$22 = 1    (Homing cycle enable, boolean)
$23 = 3    (Homing direction invert, mask)
$24 = 50.000    (Homing locate feed rate, mm/min)
$25 = 1000.000    (Homing search seek rate, mm/min)
$26 = 10.000    (Homing switch debounce delay, milliseconds)
$27 = 5.000    (Homing switch pull-off distance, millimeters)
$30 = 24000.000    (Maximum spindle speed, RPM)
$31 = 0.000    (Minimum spindle speed, RPM)
$32 = 0    (Laser-mode enable, boolean)
$100 = 200.000    (X-axis travel resolution, step/mm)
$101 = 200.000    (Y-axis travel resolution, step/mm)
$102 = 200.000    (Z-axis travel resolution, step/mm)
$103 = 200.000
$104 = 100.000
$105 = 100.000
$110 = 2500.000    (X-axis maximum rate, mm/min)
$111 = 2500.000    (Y-axis maximum rate, mm/min)
$112 = 2500.000    (Z-axis maximum rate, mm/min)
$113 = 1000.000
$114 = 1000.000
$115 = 1000.000
$120 = 100.000    (X-axis acceleration, mm/sec^2)
$121 = 100.000    (Y-axis acceleration, mm/sec^2)
$122 = 100.000    (Z-axis acceleration, mm/sec^2)
$123 = 200.000
$124 = 200.000
$125 = 200.000
$130 = 1250.000    (X-axis maximum travel, millimeters)
$131 = 1240.000    (Y-axis maximum travel, millimeters)
$132 = 100.000    (Z-axis maximum travel, millimeters)
$133 = 300.000
$134 = 300.000
$135 = 300.000
ok
>>> $G
[GC:G0 G54 G17 G21 G90 G94 M5 M9 T0 F0 S0]
ok
>>> $i
[VER:1.3a.20210816:]
[OPT:MPHBSW]
[MSG:Using machine:CNC_xPRO_V5_XYYZ_NC]
[MSG:Mode=AP:SSDI=CNC_xPRO_V5:IP=192.168.0.1:MAC=98-CD-AC-6D-67-45]
[MSG:No BT]
ok
>>> $s
$Sta/SSID=CNC_xPRO_V5
$Sta/Password=******
$Sta/IPMode=DHCP
$Sta/IP=0.0.0.0
$Sta/Gateway=0.0.0.0
$Sta/Netmask=0.0.0.0
$AP/SSID=CNC_xPRO_V5
$AP/Password=******
$AP/IP=192.168.0.1
$AP/Channel=1
$System/Hostname=CNC_xPRO_V5
$Http/Enable=ON
$Http/Port=80
$Telnet/Enable=ON
$Telnet/Port=23
$Radio/Mode=AP
$Bluetooth/Name=XPRO_V5_BT
$Notification/Type=NONE
$Notification/T1=
$Notification/T2=
$Notification/TS=
$Message/Level=Info
$User/Macro0=
$User/Macro1=
$User/Macro2=
$User/Macro3=
$Homing/Cycle0=Z
$Homing/Cycle1=XY
$Homing/Cycle2=
$Homing/Cycle3=
$Homing/Cycle4=
$Homing/Cycle5=
$Report/StallGuard=
$Stepper/Enable/Delay=0
$Stepper/Direction/Delay=0
$Stepper/Pulse=4
$Stepper/IdleTime=255
$Stepper/StepInvert=
$Stepper/DirInvert=XY
$Stepper/EnableInvert=Off
$Limits/Invert=On
$Probe/Invert=On
$Report/Status=1
$GCode/JunctionDeviation=0.010
$GCode/ArcTolerance=0.002
$Report/Inches=Off
$Firmware/Build=
$Limits/Soft=Off
$Limits/Hard=Off
$Homing/DirInvert=XY
$Homing/Squared=
$Homing/Feed=50.000
$Homing/Seek=1000.000
$Homing/Debounce=10.000
$Homing/Pulloff=5.000
$GCode/MaxS=24000.000
$GCode/MinS=0.000
$Laser/FullPower=1000
$GCode/LaserMode=Off
$GCode/Line1=
$GCode/Line0=
$Spindle/Enable/Invert=Off
$Spindle/Enable/OffWithSpeed=Off
$Coolant/Delay/TurnOn=1.000
$Spindle/Delay/SpinDown=0.000
$Spindle/Delay/SpinUp=0.000
$Spindle/PWM/Invert=Off
$Spindle/PWM/Frequency=5000.000
$Spindle/PWM/Off=0.000
$Spindle/PWM/Min=0.000
$Spindle/PWM/Max=100.000
$Spindle/Type=NONE
$X/StepsPerMm=200.000
$Y/StepsPerMm=200.000
$Z/StepsPerMm=200.000
$A/StepsPerMm=200.000
$B/StepsPerMm=100.000
$C/StepsPerMm=100.000
$X/MaxRate=2500.000
$Y/MaxRate=2500.000
$Z/MaxRate=2500.000
$A/MaxRate=1000.000
$B/MaxRate=1000.000
$C/MaxRate=1000.000
$X/Acceleration=100.000
$Y/Acceleration=100.000
$Z/Acceleration=100.000
$A/Acceleration=200.000
$B/Acceleration=200.000
$C/Acceleration=200.000
$X/Home/Mpos=0.000
$Y/Home/Mpos=0.000
$Z/Home/Mpos=0.000
$A/Home/Mpos=0.000
$B/Home/Mpos=0.000
$C/Home/Mpos=0.000
$X/MaxTravel=1250.000
$Y/MaxTravel=1240.000
$Z/MaxTravel=100.000
$A/MaxTravel=300.000
$B/MaxTravel=300.000
$C/MaxTravel=300.000
$X/Current/Run=1.800
$Y/Current/Run=1.800
$Z/Current/Run=1.800
$A/Current/Run=1.800
$B/Current/Run=0.250
$C/Current/Run=0.250
$X/Current/Hold=0.500
$Y/Current/Hold=0.500
$Z/Current/Hold=0.500
$A/Current/Hold=0.500
$B/Current/Hold=0.125
$C/Current/Hold=0.125
$X/Microsteps=8
$Y/Microsteps=8
$Z/Microsteps=8
$A/Microsteps=16
$B/Microsteps=16
$C/Microsteps=16
$X/StallGuard=16
$Y/StallGuard=16
$Z/StallGuard=16
$A/StallGuard=16
$B/StallGuard=16
$C/StallGuard=16
[Error] An error was detected while sending '$s': $Errors/Verbose=Off. Streaming has been paused.
[Error] Error while processing response <ok>: An unexpected command was completed by the controller.
>>> ?
ok

Mawg1, 2022-04-19:
It sounds like you might be getting noise...maybe?   What is the response to the '?' command?  If you turn off 24V supply then send the '?' command what is the response?

Generally, I would recommend NC switches as they much less susceptible to noise/interference  - even more so if you use a VFD

cdo1955, 2022-04-19:
Thanks for the response. Right now this Y limit alarm is coming on when the spindle is not even powered up.
I did try moving the wires to NC and changing the setting to invert limit switches but That did not fix the problem. So I returned to normal settings.
I have 5 VDC measured across the terminal of the Y switches (wired in parallel) and when one  closes the voltage drops to zero. Which is correct since it is now connected to common. But the light on the side of the controller never show on. I only get the alarm on UGS. Can the Y circuit inside the controller be damaged?

cdo1955, 2022-04-19:
I did not mean to close this Issue, I just hit the wrong button.

cdo1955, 2022-04-19:
The response to the "?" with power supply on is in the list above. I will have to try to night testing "?" when the 24 VDC is off.

Spark-Concepts, 2022-05-16:
How are your limit switches wired? (are you wiring using all three terminals as illustrated below)
- be sure to pay attention to the markings on your particular switches "NC" & "NO"
- you can also try moving the internal "Limit Switch Logic/Output Voltage Select Jumper" to 24V (this will decrease the limit switch trigger sensitivity"

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

cdo1955, 2022-05-17:
No, I was worried about you warning about doing it wrong and burn up the board.
I tried NO and NC. also 5 volt and 24 Volt option.
 X and Z work fine, never a moments problem with them.
 Y works for a while the comes in for no reason.

In the Three wire option you show on the  Gethub is ground thew actual earth ground from the circuit breaker board?
 carl Olsen
________________________________
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

cdo1955, 2022-05-17:
The NC option shows the alarms on the panel toggle correctly when I set $5 to the correct setting. But when i try to home
it does not responed to the switch closure. And it would crash if I let it. When I set it back to NO with the jumper set to 24 VDC it does the exact same thing. The only way it works in with 5 VDC and NO. I can home and start to run a cut but sooner or latter Y alarm drifts in and shuts down the system. If I have already Homed the system I can kill hard limits and run on soft limits to get something done.
Is the Y circuit damaged in some way?
 Carl Olsen
________________________________
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

Spark-Concepts, 2022-05-17:
cdo1955,

The internal ground is common within the board - you want to use the ground on the limit switch plug and not chassis or earth ground (don't daisy chain grounds either) otherwise you'll run into all kinds of issues with ground loops.

Does the limit switch LED illuminate for each of the limit switches when triggered?

If you can - please post a picture of your y limit switch wiring as well as the wiring to your xProV5.

cdo1955, 2022-05-17:
I never see the limit switch indicator lights come on. The alarm indication I'm talking about in on UGS or CNCj's panels. As for the pictures I'll do it soon, , at work now.
 Carl

cdo1955, 2022-05-18:
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
Attached are two photos of the Y wiring. I use Two Limit switches on the Y normally like I do on the X and Z. They are wired in parallel. For testing I disconnected the wires on the far Y limit switch. But that why there are dual wires going to the switch. On the photo of the Y limit wires landing in the XPro V5 I pulled the Y motor plug to show the Y limit plug. I have tried it with a small cap across the input but now for trouble shooting I removed it.

cdo1955, 2022-05-18:
The shield wire are all landed on a bus bar tied to the power supply ground.

Spark-Concepts, 2022-05-20:
I see a couple options you could try:
- connect shields on the first image and connect the shield closest to the xPro to the bus bar (terminate shield to ground at a single point)
- grounds can be a tricky thing - do not daisy chain grounds (this will create ground loops and issues)
- if you are picking up noise you can try adding 1K resistor on the Y limit plug between the center pin (Vcc) and the signal pin

If you tried these things or are uncertain - contact us via: https://www.spark-concepts.com/contact-us-1/ and we'd be happy to send you a shipping label and test/repair/replace your unit free of charge

cdo1955, 2022-06-01:
I rewired all the limit switch's as per the diagram you gave me in this post. Things are working fine now . No limit switch problems. But I did have to set $5=0. If it set to $5-1 all the alarms are in. It homes fine with $5=0. Also I had to give up the limit switches I had at the opposite ends of all the axis. Because it looks like there's no why to have two limits on the same line wired in parallel or series. which is one of the reasons I went with the two wire system in parallel in the first place. I enabled soft limits and test them out. So if things say the same I'm happy with the out come.

cdo1955, 2022-06-06:
ZY alarm us back. I will contact you to send it back for repair

cdo1955, 2022-06-07:
Problem is back. Ill send it in for repair

cdo1955, 2022-06-22:
After I received the replacement controller my issues went away. I have had only one day cutting but normally that would have shut down due to Y limit, so far so good. I'll close this help request

cdo1955, 2022-06-22:
done

Closed 2022-06-22.

Thread 132 (2022-04-22):

Unable to use to CNC xpro v5

szaghi, 2022-04-22:
Hi all,

I am trying to use a CNC xpro v5 controller (bought for a queenbee pro CNC), but I am failing (probably due to my inexperience). The board starts correctly, it creates its own WLAN and I am able to connect both directly via USB cable and also by wifi connection to its WLAN. However, neither with CNCJS (via USB) nor with its own web GUI (via wifi) I am able to obtain _any response_ : the connection with the board seems to happen right, but I am not able to run any command (homing, jog, etc...), even the console seems to be unresponsive (sending $i or $S for example returns no answer).

I am able to obtain a response only by pressing the physical reset button on the board: when I press the reset button I read in the console that the drivers are fine and the Z stepper tries to turn for a short while (with some noise), but after that I am still with a totally unresponsive board.

I have updated the firmware to the last one (NC version).

Can someone help me to _debug_ this situation? Without communicating with the board I am not able to understand what is going on (e.g. if there is a wiring issue).

Thank you in advance for any suggestions,
Stefano

spydercnc, 2022-04-22:
Have you got a NC switch connected? If not it will see it as a door being open.  You can't connect to Wi-Fi with the USB plugged in. Which spindle are you using and which method are you using to control the spindle, the firmware is different for a RS485 connection.

szaghi, 2022-04-22:
> Have you got a NC switch connected? If not it will see it as a door being open.  You can't connect to Wi-Fi with the USB plugged in. Which spindle are you using and which method are you using to control the spindle, the firmware is different for a RS485 connection. I am sure I am using the NO firmware though??
>

Hi @spydercnc , thanks for the quick support.

The limit switch should be correctly wired (over C and NC pins), tomorrow I can re-check the wiring and posting some pictures.

The tests with USB and wifi connection were made separately, I have not connected USB and wifi together.

The spindle is a 2.2KW water cooled and I was trying to connect by RS485, maybe this is the problem.

The firmware update (made using web UI) was smooth, but as I said I am currently not able to obtain any response from the board

In summary the first things I have to check are the wiring of limit switches and firmware for the spindle, right?

spydercnc, 2022-04-22:
Not the limit switches that may be the issue but the door switch and emergency switch needs to be NO.  To use the RS 485 see this: Setting up the CNC xPRO V5
1) Install the latest firmware
a. For Normally Open Door Switches (or no door switch): xProV5/CNCxPROv5_XYYZ_NO.bin at main · Spark-Concepts/xPro-V5 (github.com)
b. For Normally Closed Door Switches: xPro-V5/CNCxPROv5_XYYZ_NC.bin at main · SparkConcepts/xPro-V5 (github.com)
c. Load using these directions: Checking_firmware_and_upgrading · Spark-Concepts/xProV5 Wiki (github.com)

spydercnc, 2022-04-22:
[CNC.xPRO.V5.RS485.control.for.HuanYang.VFD.Spindle.pdf](https://github.com/Spark-Concepts/xPro-V5/files/8543206/CNC.xPRO.V5.RS485.control.for.HuanYang.VFD.Spindle.pdf)

szaghi, 2022-04-22:
Oh sorry for my misunderstanding, I was thinking to limit switches, not to the door and emergency stop, tomorrow I'll check them and I'll fix the firmware.

Thank you very much.

szaghi, 2022-04-23:
@spydercnc Thank you very much for the support, I found my error: I assumed to have NO emergency stop, but today I re-opened it and I found it is a NC. Flashing the CNCxPROv5_XYYZ_NC.bin firrmware I am now able to dialog with the board.

For now all seems to work as expected except for the second Y stepper: it seems there is a "delay" between the two Y steppers, one starts before the other. I have to dig it deeper, anyhow I am closing this issue (if I'll not be able to understand what is happening with the Y steppers I'll look for help).

Thank you again,
Stefano

Closed 2022-04-23.

Thread 133 (2022-04-24):

Problem with the Y-axis (x pro-V5)

M-a-K-A-R-o-N-k-A, 2022-04-24:
Hello!!!
There is a problem with the x pro-V5, namely on the Y axis the engine behaves incorrectly.
After checking the engine on the other axes X,Z,A/Y2. It turned out that it is serviceable and works normally.
What else do I need to provide you to speed up the resolution of this issue?
Ps: I'm new to this business
[Y problem](https://drive.google.com/file/d/11ggokg1jSniMxvOAmu_hxbrkAmdxh9ZA/view?usp=drivesdk)
> $I
[VER:1.3a.20210816:]
[OPT:MPHBSW]
[MSG:Using machine:CNC_xPRO_V5_XYYZ_NC]
[MSG:Mode=AP:SSDI=CNC_xPRO_V5:IP=192.168.0.1:MAC=40-F5-20-B5-67-F5]
[MSG:No BT]
ok

> $$
$0=4 (Step pulse time, microseconds)
$1=250 (Step idle delay, milliseconds)
$2=0 (Step pulse invert, mask)
$3=0 (Step direction invert, mask)
$4=0 (Invert step enable pin, boolean)
$5=1 (Invert limit pins, boolean)
$6=1 (Invert probe pin, boolean)
$10=1 (Status report options, mask)
$11=0.010 (Junction deviation, millimeters)
$12=0.002 (Arc tolerance, millimeters)
$13=0 (Report in inches, boolean)
$20=0 (Soft limits enable, boolean)
$21=0 (Hard limits enable, boolean)
$22=0 (Homing cycle enable, boolean)
$23=3 (Homing direction invert, mask)
$24=200.000 (Homing locate feed rate, mm/min)
$25=2000.000 (Homing search seek rate, mm/min)
$26=250.000 (Homing switch debounce delay, milliseconds)
$27=2.500 (Homing switch pull-off distance, millimeters)
$30=24000.000 (Maximum spindle speed, RPM)
$31=0.000 (Minimum spindle speed, RPM)
$32=0 (Laser-mode enable, boolean)
$100=200.000 (X-axis travel resolution, step/mm)
$101=200.000 (Y-axis travel resolution, step/mm)
$102=200.000 (Z-axis travel resolution, step/mm)
$103=200.000
$104=100.000
$105=100.000
$110=2500.000 (X-axis maximum rate, mm/min)
$111=2500.000 (Y-axis maximum rate, mm/min)
$112=2500.000 (Z-axis maximum rate, mm/min)
$113=1000.000
$114=1000.000
$115=1000.000
$120=50.000 (X-axis acceleration, mm/sec^2)
$121=50.000 (Y-axis acceleration, mm/sec^2)
$122=50.000 (Z-axis acceleration, mm/sec^2)
$123=200.000
$124=200.000
$125=200.000
$130=300.000 (X-axis maximum travel, millimeters)
$131=300.000 (Y-axis maximum travel, millimeters)
$132=300.000 (Z-axis maximum travel, millimeters)
$133=300.000
$134=300.000
$135=300.000
ok

> $+
$0=4 (Step pulse time, microseconds)
$1=250 (Step idle delay, milliseconds)
$2=0 (Step pulse invert, mask)
$3=0 (Step direction invert, mask)
$4=0 (Invert step enable pin, boolean)
$5=1 (Invert limit pins, boolean)
$6=1 (Invert probe pin, boolean)
$10=1 (Status report options, mask)
$11=0.010 (Junction deviation, millimeters)
$12=0.002 (Arc tolerance, millimeters)
$13=0 (Report in inches, boolean)
$20=0 (Soft limits enable, boolean)
$21=0 (Hard limits enable, boolean)
$22=0 (Homing cycle enable, boolean)
$23=3 (Homing direction invert, mask)
$24=200.000 (Homing locate feed rate, mm/min)
$25=2000.000 (Homing search seek rate, mm/min)
$26=250.000 (Homing switch debounce delay, milliseconds)
$27=2.500 (Homing switch pull-off distance, millimeters)
$30=24000.000 (Maximum spindle speed, RPM)
$31=0.000 (Minimum spindle speed, RPM)
$32=0 (Laser-mode enable, boolean)
$N1=
$N0=
$33=5000.000
$34=0.000
$35=0.000
$36=100.000
$100=200.000 (X-axis travel resolution, step/mm)
$101=200.000 (Y-axis travel resolution, step/mm)
$102=200.000 (Z-axis travel resolution, step/mm)
$103=200.000
$104=100.000
$105=100.000
$110=2500.000 (X-axis maximum rate, mm/min)
$111=2500.000 (Y-axis maximum rate, mm/min)
$112=2500.000 (Z-axis maximum rate, mm/min)
$113=1000.000
$114=1000.000
$115=1000.000
$120=50.000 (X-axis acceleration, mm/sec^2)
$121=50.000 (Y-axis acceleration, mm/sec^2)
$122=50.000 (Z-axis acceleration, mm/sec^2)
$123=200.000
$124=200.000
$125=200.000
$130=300.000 (X-axis maximum travel, millimeters)
$131=300.000 (Y-axis maximum travel, millimeters)
$132=300.000 (Z-axis maximum travel, millimeters)
$133=300.000
$134=300.000
$135=300.000
$140=1.800
$141=1.800
$142=1.800
$143=1.800
$144=0.250
$145=0.250
$150=0.500
$151=0.500
$152=0.500
$153=0.500
$154=0.125
$155=0.125
$160=8
$161=8
$162=8
$163=16
$164=16
$165=16
$170=16
$171=16
$172=16
$173=16
$174=16
$175=16
ok

szaghi, 2022-04-24:
Hi @M-a-K-A-R-o-N-k-A , I think I have the same issue, thus I would like to follow this issue.

possu911, 2022-05-02:
Hi,
Mine just started to do the same with Y1 (today May 1’ 22)
Received the xPro early Apr.
Stock Firmware.

JosDrolkoppers, 2022-05-27:
Hi, I have the exact same issue. I already purchased a new controller and I got the same problem after 30 minutes of running...
video : https://imgur.com/gallery/vNHIggC

Kind regards,
Maarten

Fcsteve777, 2022-05-31:
Spark concepts sent me another unit, hopefully this isn't a recurring issue. I did inquire if they know what is causing these issues.

Fcsteve777, 2022-06-03:
well same as Jos up there, got my replacement and a half hour later back to effed up....

shnads, 2022-06-11:
I am also having the same issue, purchased my Xpro V5 around two weeks ago, managed to get around two hours of use while setting up my machine, came back the next day and it has this problem. Beginning to regret going for the xPro as I can't just swap out a stepper driver, i now have to wait for replacement.

Spark-Concepts, 2022-08-09:
We are looking into several of these occurrences and are actively working with Trinamic to determine the root cause of this fault.  That said we are confident on an expedient resolution - firmware and/or hardware.

That said, this type of issue is still relatively rare in most cases:

Regardless, we are actively and rapidly working to determine a definitive solution and will make good on providing you a quality product.

We understand this may be extremely frustrating to all - in the meantime if you're seeing this issue with the Y axis specifically (and not Y2) please utilize the contact us  link on the spark-concepts.com homepage and let us know when and through who you purchased your xPro from (we're exploring all avenues as to why/how this issue is occurring)

In most all cases we can provide you a replacement - however, if at all possible I highly recommend an alternative (temporary) solution until we have a clear answer and resolution to this rare but frustrating occurrence:
In the meantime to resume use of your CNC you can run both Y steppers via the Y2 stepper output either in Series (higher torque but slower feed rates) or in parallel (lower torque but faster feed rates).

Regardless, if your having this specific issue please reach out to us directly via our [website](www.spark-concepts.com) Contact-Us tab and provide us as much detail as you can and we will reach back out to you with options

Closed 2022-08-09.

Thread 134 (2022-04-26):

xPro V5 Wifi problem

Monya0065, 2022-04-26:
When 24v power is on, there is no Wifi connection. Wifi turns on only when connected to a computer. How to fix it?

Spark-Concepts, 2022-05-16:
It sounds like you may have had something external cause a short circuit which can sometimes damage the xPro's 5V regulator.

If possible - can you run a few tests:

1. Disconnect the USB cable and power only using your 24V power supply
2. Remove the lid by removing the four lid screws and expose the top PCB
3. Turn your 24V power supply ON
4. Measure for 5 Volts as shown below (also check the remaining voltages as shown on the right)
5. Remove 24V or turn OFF 24V power supply
6. Plug in USB cable, and power via a PC or USB power brick
7. Re-Measure for 5V and 3.3V (24V should be 0-ish)
8. Please let me know your test results (actual voltages measured)

| Voltage  | 24V PSU Only | USB Only |
| ------------- | ------------- | ------------- |
| 3.3V  | (value?)  | (value?) |
| 5V  | (value?)  | (value?) |
| 24V  | (value?)  | (value?) |

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

Spark-Concepts, 2022-08-09:
Has this issue been resolved?

Closed 2022-08-09.

Thread 135 (2022-04-26):

The board (xPro v5) is not connected to the computer (CNCjs, Mach3 and other)

Monya0065, 2022-04-26:
The board stopped connecting to the computer. When connecting USB-C, CNCjs tries to connect but fails. Other programs do not determine the fee. Drivers are up to date. WiFi cannot be detected and connected.
How to fix it?

Spark-Concepts, 2022-05-16:
Do any of the LED's illuminate?

The first thing to look at would be power - if possible can you run a few tests found here: https://github.com/Spark-Concepts/xPro-V5/issues/134#issuecomment-1127978054

BungC, 2022-05-21:
I'm having similar problems with connecting, with CNCjs 1.9.23. The steppers "click" and connection appears to be ok, but I cannot issue any commands or get to "idle" state to be able to jog, etc. Universal G-code sender will talk, but only after a few resets of of both UGS or xPRO or both. CNC3D Commander (an ESP32 ?GRBL "1.3" sender" also behaves strangely and requires  a reset of the xPRO to work. I will try loading the new firmware, the current firmware is from September 2021.

Spark-Concepts, 2022-08-09:
Are you still having issues? - if not please repost. I'm assuming firmware should've fixed the reset issue.

Closed 2022-08-09.

Thread 140 (2022-05-07):

Y axis issue stepper is hissing and more

Pops1971, 2022-05-07:
After tuning the first short test cut. One of the y steppers started hissing and making video game noises. It’s also stuttering and jamming up the machine. It was running fine before the test cut. Box is not showing any lights. The stepper does not seem to get warm either. I have noticed the fan on the pro also does not work right. I have updated the firmware and have checked all setting and made sure machine is square. It’s barely 2 months old and I just got it hooked up over the last few days. I’m out of ideals and losing work. I’m a disabled person and sold my little cnc to get this bigger one. Any help would be greatly appreciated. Thank you

spydercnc, 2022-05-07:
Check that the wires are paired correctly and that the stepper is running in the correct direction. Make sure the axis is not jamming (unlikely)

Pops1971, 2022-05-08:
One thing I noticed is my power supply is only putting out 22v. Could this be causing some of the stepper issues?

Spark-Concepts, 2022-08-09:
Low voltage may effect it some, however I would suggest updating to the most current firmware as of July 2022 - If you are still having issues please reach out to us via our contact us link on our homepage www.spark-concepts.com

Closed 2022-08-09.

Thread 141 (2022-05-10):

Spindle/VFD communication error

NZBasher, 2022-05-10:
Hi, I have tried everything to get my spindle to run via RS485. This worked initially but has now stopped.
I note I do not get the same message on bootup as others I have seen on here
[MSG:Initializing RS485 VFD spindle]
[MSG:Undefined VFD_RS485_RTS_PIN]
[MSG:VFD RS485  Tx:GPIO(4) Rx:GPIO(25) RTS:GPIO(0)]

I notice I have no
[MSG:Auto-RTS in use]

After going back a firmware version, I can get the spindle to start with m3 command, an error then comes up but I can adjust speed and stop it with M5 (CNCjs used) If I try to restart the spindle starts to spool up and stops with unresponsive 6 etc. error shown below. I have to reset the spindle and VFD to get it to work again

I'm getting totally frustrated, any help appreciated.
Thank you
Paul

feeder> M3 S10000
ok
[MSG:Spindle RS485 Unresponsive 7]
feeder> M5
ok
feeder> M3 S10000
ok
[MSG:Spindle RS485 Unresponsive 6]
[MSG:Critical Spindle RS485 Unresponsive]
ALARM:10

other settings below for your reference

$0=4 (Step pulse time, microseconds)
$1=255 (Step idle delay, milliseconds)
$2=0 (Step pulse invert, mask)
$3=3 (Step direction invert, mask)
$4=0 (Invert step enable pin, boolean)
$5=1 (Invert limit pins, boolean)
$6=1 (Invert probe pin, boolean)
$10=1 (Status report options, mask)
$11=0.010 (Junction deviation, millimeters)
$12=0.002 (Arc tolerance, millimeters)
$13=0 (Report in inches, boolean)
$20=1 (Soft limits enable, boolean)
$21=0 (Hard limits enable, boolean)
$22=1 (Homing cycle enable, boolean)
$23=0 (Homing direction invert, mask)
$24=200.000 (Homing locate feed rate, mm/min)
$25=2000.000 (Homing search seek rate, mm/min)
$26=250.000 (Homing switch debounce delay, milliseconds)
$27=2.500 (Homing switch pull-off distance, millimeters)
$30=24000.000 (Maximum spindle speed, RPM)
$31=8000.000 (Minimum spindle speed, RPM)
$32=0 (Laser-mode enable, boolean)
$N1=
$N0=
$100=400.000 (X-axis travel resolution, step/mm)
$101=400.000 (Y-axis travel resolution, step/mm)
$102=400.000 (Z-axis travel resolution, step/mm)
$103=400.000
$104=100.000
$105=100.000
$110=3000.000 (X-axis maximum rate, mm/min)
$111=3000.000 (Y-axis maximum rate, mm/min)
$112=3000.000 (Z-axis maximum rate, mm/min)
$113=3000.000
$114=1000.000<Idle|MPos:0.000,0.000,0.000|FS:0,0|WCO:-780.322,-1231.843,-84.802>
$115=1000.000
$120=250.000 (X-axis acceleration, mm/sec^2)
$121=250.000 (Y-axis acceleration, mm/sec^2)
$122=300.000 (Z-axis acceleration, mm/sec^2)
$123=200.000
$124=200.000
$125=200.000
$130=1220.000 (X-axis maximum travel, millimeters)
$131=1270.000 (Y-axis maximum travel, millimeters)
$132=120.000 (Z-axis maximum travel, millimeters)
$133=300.000
$134=300.000
$135=300.000
ok
ets Jun  8 2016 00:22:57
rst:0x1 (POWERON_RESET),boot:0x17 (SPI_FAST_FLASH_BOOT)
configsip: 0, SPIWP:0xee
clk_drv:0x00,q_drv:0x00,d_drv:0x00,cs0_drv:0x00,hd_drv:0x00,wp_drv:0x00
mode:DIO, clock div:1
load:0x3fff0018,len:4
load:0x3fff001c,len:1216
ho 0 tail 12 room 4
load:0x40078000,len:9720
ho 0 tail 12 room 4
load:0x40080400,len:6352
entry 0x400806b8
[MSG:Grbl_ESP32 Ver 1.3a Date 20201212]
[MSG:Compiled with ESP32 SDK:v3.2.3-14-gd3e562907]
[MSG:Using machine:CNC_xPRO_V5_XYYZ_RS485_NC]
[MSG:Axis count 3]
[MSG:RMT Steps]
[MSG:Init Motors]
[MSG:TMCStepper Library Ver. 0x000701]
[MSG:X  Axis Trinamic TMC5160 Step:GPIO(12) Dir:GPIO(14) CS:GPIO(17) Disable:None Index:1 R:0.050 Limits(-1220.000,0.000)]
[MSG:X  Axis Trinamic driver test passed]
[MSG:Y  Axis Trinamic TMC5160 Step:GPIO(27) Dir:GPIO(26) CS:GPIO(17) Disable:None Index:2 R:0.050 Limits(-1270.000,0.000)]
[MSG:Y  Axis Trinamic driver test passed]
[MSG:Y2 Axis Trinamic TMC5160 Step:GPIO(33) Dir:GPIO(32) CS:GPIO(17) Disable:None Index:3 R:0.050 Limits(-1270.000,0.000)]
[MSG:Y2 Axis Trinamic driver test passed]
[MSG:Z  Axis Trinamic TMC5160 Step:GPIO(15) Dir:GPIO(2) CS:GPIO(17) Disable:None Index:4 R:0.050 Limits(-120.000,0.000)]
[MSG:Z  Axis Trinamic driver test passed]
[MSG:Initializing RS485 VFD spindle]
[MSG:Undefined VFD_RS485_RTS_PIN]
[MSG:VFD RS485  Tx:GPIO(4) Rx:GPIO(25) RTS:GPIO(0)]
[MSG:Local access point CNC_xPRO_V5 started, 192.168.0.1]
[MSG:Captive Portal Started]
[MSG:HTTP Started]
[MSG:TELNET Started 23]
[MSG:Flood coolant on pin GPIO(21)]
[MSG:Mist coolant on pin GPIO(21)]
[MSG:X  Axis limit switch on pin GPIO(35)]
[MSG:Y  Axis limit switch on pin GPIO(34)]
[MSG:Z  Axis limit switch on pin GPIO(39)]
[MSG:Probe on pin GPIO(22)]
Grbl 1.3a ['$' for help]
[MSG:'$H'|'$X' to unlock]
> $soindle
error:3 (Invalid statement)
> $spindle
$Spindle/Enable/Invert=Off
$Spindle/Enable/OffWithSpeed=Off
$Spindle/Delay/SpinDown=20.000
$Spindle/Delay/SpinUp=20.000
$Spindle/PWM/Invert=Off
$Spindle/PWM/Frequency=5000.000
$Spindle/PWM/Off=0.000
$Spindle/PWM/Min=0.000
$Spindle/PWM/Max=100.000
$Spindle/Type=HUANYANG

NZBasher, 2022-05-11:
Help please

Spark-Concepts, 2022-05-20:
Please take a look at the updated wiring guidance found here:
https://github.com/Spark-Concepts/xPro-V5/wiki/Front_Panel#spindletypexx--rs485

_(most all VFD communications errors are due to noise emitted by the VFD/Spindle; therefore, special wiring considerations need to be taken to help mitigate communication errors)_

id192313, 2022-06-02:
Hi, did you manage to get it solved?

NZBasher, 2022-06-03:
Hi,

Thanks for getting in touch,

I haven’t tried to get the RS485 going again yet. I have the 2 resisters and some shielded twisted pair and will change firmware and try it this weekend.

I’m currently setting speed on the vfd and using the relay for start/stop

I have tried PWM which works fine until I start moving the machine and I get varying voltages which causes the spindle to speed up and slow down constantly. There seems to be a lot of voltage variation. I have had a multi-meter on it and its definitely varying, I note that it speeds up when I touch the voltage sensor to the contacts! Seems a bit stramge, I can only get about 5.7 volts when the spindle is connected but get 12 when its not. So not sure what’s going on there, but its unusable.

I’m not sure if the PWM and the RS485 issues are connected. The silly thing is that it all worked fine when I first assembled the machine, it wasn’t till my electrician found my shed wasn’t earth bonded so the RCD system wasn’t working (bit dangerous) after that RS485 wasn’t working, even putting the earth back as it was didn’t work, so not sure if that was just a coincidence.

I’ll let you know how I get on.

Regards

Paul McBreen

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

id192313, 2022-06-03:
Hi Paul,
Thanks for replying. Been working on it for the past 2 days and was wondering how u did the connection using PWM. I have tried PWM setting today. Can’t even get the spindle to start.
Is these how u set it up previously?

-xPro v5, HY02D223B, Spindle 2.2kw 220v Air Cooled
-VFD setting same as the one mactec54 posted.
-xpro Switch EN/PWM
-xpro 0-10v to VFD VI
 xpro GND to VFD ACM
 xpro Relay NO to VFD DCM
 xpro Relay GND/COM to VFD FOR
-xpro Relay jumper Spindle Enable/SP_EN (the relay kept on and off the whole time)

Thank you.

Sent from my iPhone

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

Spark-Concepts, 2022-08-09:
Have you been able to resolve this issue?

https://github.com/Spark-Concepts/xPro-V5/issues/164#issuecomment-1208726453

NZBasher, 2022-08-09:
Not yet,

I have been using the relay for start stop of the spindle and manually setting speed. I will try the new method as soon as I get time.

I tried using PWM 0-10v but the voltage is inconsistent so the spindle speeds up and slows down, making it unusable. I’m not sure my Xpro is working correctly

Regards

Paul McBreen

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

Spark-Concepts, 2022-08-09:
Sounds good Paul - take a look at Issue #164 - and please feel free to reach back out if you sill aren't having any luck. I'm assuming you're running a 220-240V VFD?

NZBasher, 2022-08-09:
Yes 220volt, we have a very clean supply here as well, mix of solar and oversized grid supply due to allowance for future expansion of housing.

Regards

Paul McBreen

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

Closed 2022-08-09.

Thread 142 (2022-05-21):

New install.  All stepper motors error

spidee601, 2022-05-21:
Ok, I just assembled my Ultimate Bee 1500x1500 ball screw.  It has 4 Nema23 steppers.  I updated the firmware to CNC_xPRO_V5_XYYZ_BM3D_NC because I have the emergency stop button. When I try to move any of the steppers, they make a "clicking" sound then the xPro error light turn on for that stepper.  I've tried several different things I've read on other threads but nothing seems to work.  Below are my specs, I know I'll have to change some of the perimeters for my bed size, but it's one step at time. They don't move at all over wifi, but they respond with the click when using CNCJS.

 Grbl 1.3a ['$' for help]
> $$
$0=4 (Step pulse time, microseconds)
$1=255 (Step idle delay, milliseconds)
$2=0 (Step pulse invert, mask)
$3=0 (Step direction invert, mask)
$4=0 (Invert step enable pin, boolean)
$5=1 (Invert limit pins, boolean)
$6=1 (Invert probe pin, boolean)
$10=1 (Status report options, mask)
$11=0.010 (Junction deviation, millimeters)
$12=0.002 (Arc tolerance, millimeters)
$13=0 (Report in inches, boolean)
$20=0 (Soft limits enable, boolean)
$21=0 (Hard limits enable, boolean)
$22=1 (Homing cycle enable, boolean)
$23=3 (Homing direction invert, mask)
$24=200.000 (Homing locate feed rate, mm/min)
$25=2000.000 (Homing search seek rate, mm/min)
$26=250.000 (Homing switch debounce delay, milliseconds)
$27=2.500 (Homing switch pull-off distance, millimeters)
$30=12000.000 (Maximum spindle speed, RPM)
$31=0.000 (Minimum spindle speed, RPM)
$32=0 (Laser-mode enable, boolean)
$N1=
$N0=
$100=200.000 (X-axis travel resolution, step/mm)
$101=200.000 (Y-axis travel resolution, step/mm)
$102=200.000 (Z-axis travel resolution, step/mm)
$103=200.000
$104=100.000
$105=100.000
$110=2500.000 (X-axis maximum rate, mm/min)
$111=2500.000 (Y-axis maximum rate, mm/min)
$112=2500.000 (Z-axis maximum rate, mm/min)
$113=1000.000
$114=1000.000
$115=1000.000
$120=100.000 (X-axis acceleration, mm/sec^2)
$121=100.000 (Y-axis acceleration, mm/sec^2)
$122=100.000 (Z-axis acceleration, mm/sec^2)
$123=200.000
$124=200.000
$125=200.000
$130=300.000 (X-axis maximum travel, millimeters)
$131=500.000 (Y-axis maximum travel, millimeters)
$132=500.000 (Z-axis maximum travel, millimeters)
$133=300.000
$134=300.000
$135=300.000<Idle|MPos:0.000,0.000,0.000|FS:0,0>

ets Jun  8 2016 00:22:57
rst:0x1 (POWERON_RESET),boot:0x13 (SPI_FAST_FLASH_BOOT)
configsip: 0, SPIWP:0xee
clk_drv:0x00,q_drv:0x00,d_drv:0x00,cs0_drv:0x00,hd_drv:0x00,wp_drv:0x00
mode:DIO, clock div:1
load:0x3fff0018,len:4
load:0x3fff001c,len:1216
ho 0 tail 12 room 4
load:0x40078000,len:9720
ho 0 tail 12 room 4
load:0x40080400,len:6352
entry 0x400806b8
[MSG:Grbl_ESP32 Ver 1.3a Date 20220403]
[MSG:Compiled with ESP32 SDK:v3.2.3-14-gd3e562907]
[MSG:Using machine:CNC_xPRO_V5_XYYZ_BM3D_NC]
[MSG:Axis count 3]
[MSG:RMT Steps]
[MSG:Door switch on pin GPIO(16)]
[MSG:Macro Pin 1 GPIO(13)]
[MSG:Macro Pin 2 GPIO(0)]
[MSG:Init Motors]
[MSG:TMCStepper Library Ver. 0x000703]
[MSG:X  Axis Trinamic TMC5160 Step:GPIO(12) Dir:GPIO(14) CS:GPIO(17) Disable:None Index:1 R:0.050 Limits(0.000,300.000)]
[MSG:X  Axis Trinamic driver test passed]
[MSG:Y  Axis Trinamic TMC5160 Step:GPIO(27) Dir:GPIO(26) CS:GPIO(17) Disable:None Index:2 R:0.050 Limits(0.000,300.000)]
[MSG:Y  Axis Trinamic driver test passed]
[MSG:Y2 Axis Trinamic TMC5160 Step:GPIO(33) Dir:GPIO(32) CS:GPIO(17) Disable:None Index:3 R:0.050 Limits(0.000,300.000)]
[MSG:Y2 Axis Trinamic driver test passed]
[MSG:Z  Axis Trinamic TMC5160 Step:GPIO(15) Dir:GPIO(2) CS:GPIO(17) Disable:None Index:4 R:0.050 Limits(-300.000,0.000)]
[MSG:Z  Axis Trinamic driver test passed]
[MSG:No spindle]
[MSG:Local access point CNC_xPRO_V5 started, 192.168.0.1]
[MSG:Captive Portal Started]
[MSG:HTTP Started]
[MSG:TELNET Started 23]
[MSG:Mist coolant on pin GPIO(21)]
[MSG:X  Axis limit switch on pin GPIO(35)]
[MSG:Y  Axis limit switch on pin GPIO(34)]
[MSG:Z  Axis limit switch on pin GPIO(39)]
[MSG:Probe on pin GPIO(22)]
Grbl 1.3a ['$' for help]

I would appreciate any assistance in getting this up and running.

Thanks in advance!

Spark-Concepts, 2022-05-22:
Make sure your emergency stop switch is pulled out (and verify it's configured Normally Closed when pulled out).

Also, please copy-paste a ```$S``` vs a ```$$``` so we can look at all of your settings - thanks!

spidee601, 2022-05-22:
Thanks for the response.  Yes, the E-button is pulled out

> $S
$Sta/SSID=CNC_xPRO_V5
$Sta/Password=******
$Sta/IPMode=DHCP
$Sta/IP=0.0.0.0
$Sta/Gateway=0.0.0.0
$Sta/Netmask=0.0.0.0
$AP/SSID=CNC_xPRO_V5
$AP/Password=******
$AP/IP=192.168.0.1
$AP/Channel=1
$System/Hostname=CNC_xPRO_V5
$Http/Enable=ON
$Http/Port=80
$Telnet/Enable=ON
$Telnet/Port=23
$Radio/Mode=AP
$Bluetooth/Name=xPRO_V5_BT
$Notification/Type=NONE
$Notification/T1=
$Notification/T2=
$Notification/TS=
$Message/Level=Info
$User/Macro0=
$User/Macro1=
$User/Macro2=
$User/Macro3=
$Homing/Cycle0=Z
$Homing/Cycle1=XY
$Homing/Cycle2=
$Homing/Cycle3=
$Homing/Cycle4=
$Homing/Cycle5=
$Report/StallGuard=
$Stepper/Enable/Delay=0
$Stepper/Direction/Delay=0
$Stepper/Pulse=4
$Stepper/IdleTime=255
$Stepper/StepInvert=
$Stepper/DirInvert=
$Stepper/EnableInvert=Off
$Limits/Invert=On
$Probe/Invert=On
$Report/Status=1
$GCode/JunctionDeviation=0.010
$GCode/ArcTolerance=0.002
$Report/Inches=Off
$Firmware/Build=
$Limits/Soft=Off
$Limits/Hard=Off
$Homing/Enable=On
$Homing/DirInvert=XY
$Homing/Squared=
$Homing/Feed=200.000
$Homing/Seek=2000.000
$Homing/Debounce=250.000
$Homing/Pulloff=2.500
$GCode/MaxS=24000.000
$GCode/MinS=0.000
$Laser/FullPower=1000
$GCode/LaserMode=Off
$GCode/Line1=
$GCode/Line0=
$Spindle/Enable/Invert=Off
$Spindle/Enable/OffWithSpeed=Off
$Coolant/Delay/TurnOn=1.000
$Spindle/Delay/SpinDown=0.000
$Spindle/Delay/SpinUp=0.000
$Spindle/PWM/Invert=Off
$Spindle/PWM/Frequency=5000.000
$Spindle/PWM/Off=0.000
$Spindle/PWM/Min=0.000
$Spindle/PWM/Max=100.000
$Spindle/Type=NONE
$X/StepsPerMm=200.000
$Y/StepsPerMm=200.000
$Z/StepsPerMm=200.000
$A/StepsPerMm=200.000
$B/StepsPerMm=100.000
$C/StepsPerMm=100.000
$X/MaxRate=2500.000
$Y/MaxRate=2500.000
$Z/MaxRate=2500.000
$A/MaxRate=1000.000
$B/MaxRate=1000.000
$C/MaxRate=1000.000
$X/Acceleration=100.000
$Y/Acceleration=100.000
$Z/Acceleration=100.000
$A/Acceleration=200.000
$B/Acceleration=200.000
$C/Acceleration=200.000
$X/Home/Mpos=0.000
$Y/Home/Mpos=0.000
$Z/Home/Mpos=0.000
$A/Home/Mpos=0.000
$B/Home/Mpos=0.000
$C/Home/Mpos=0.000
$X/MaxTravel=300.000
$Y/MaxTravel=300.000
$Z/MaxTravel=300.000
$A/MaxTravel=300.000
$B/MaxTravel=300.000
$C/MaxTravel=300.000
$X/Current/Run=1.800
$Y/Current/Run=1.800
$Z/Current/Run=1.800
$A/Current/Run=1.800
$B/Current/Run=0.250
$C/Current/Run=0.250
$X/Current/Hold=1.250
$Y/Current/Hold=1.250
$Z/Current/Hold=1.250
$A/Current/Hold=1.250
$B/Current/Hold=0.125
$C/Current/Hold=0.125
$X/Microsteps=8
$Y/Microsteps=8
$Z/Microsteps=8
$A/Microsteps=16
$B/Microsteps=16
$C/Microsteps=16
$X/StallGuard=16
$Y/StallGuard=16
$Z/StallGuard=16
$A/StallGuard=16
$B/StallGuard=16
$C/StallGuard=16
$Errors/Verbose=Off
ok

spidee601, 2022-05-22:
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

Ok I think I found the issue.  I wired them as directed on your diagram, but the wiring should be Red, Green, Blue, Yellow.  Once I did that the stepper motors fire up, grant it I'll have to figure out the right settings for my ball screw drive, but they seem to be working now.

Since you have all of my settings any advice on what the other settings should be on a 1500x1500 ball screw Ultimate Bee?

Thread 144 (2022-05-23):

Y driver issue

Fcsteve777, 2022-05-23:
Hello,
My machine was running swimmingly over a couple of days then 2 issues started which now has me dead in the water after finally getting everything ready to go.

Although i did not change any settings my X axis stepper was becoming very hot ~120c before i stopped the machine. I re checked my amp limits which were still where i left them.

The other issue is that one of the y drivers seems faulty and now the stepper is making massive amounts of noise when on the machine. I swapped motors and drivers and the noise always follows the driver. it started after running an hour or so the other day but on startup it was doing the same thing.

Videos:
https://drive.google.com/file/d/1HnIgDp35-XVLFc52DLajtfe9ngFjktYK/view?usp=sharing
https://drive.google.com/file/d/1Hpwh1PZrVfcIXKb0-OjnDbcs6bZaz7d7/view?usp=sharing

Today i updated the firmware as i saw some driver tuning was noted but there was no change.

I tried slowing my speeds and the frequency just changes, no error lights illuminate

Driver self test results:
[MSG:TMCStepper Library Ver. 0x000703]
[MSG:X  Axis Trinamic TMC5160 Step:GPIO(12) Dir:GPIO(14) CS:GPIO(17) Disable:None Index:1 R:0.050 Limits(0.000,508.000)]
[MSG:X  Axis Trinamic driver test passed]
[MSG:Y  Axis Trinamic TMC5160 Step:GPIO(27) Dir:GPIO(26) CS:GPIO(17) Disable:None Index:2 R:0.050 Limits(0.000,782.000)]
[MSG:Y  Axis Trinamic driver test passed]
[MSG:Y2 Axis Trinamic TMC5160 Step:GPIO(33) Dir:GPIO(32) CS:GPIO(17) Disable:None Index:3 R:0.050 Limits(0.000,782.000)]
[MSG:Y2 Axis Trinamic driver test passed]
[MSG:Z  Axis Trinamic TMC5160 Step:GPIO(15) Dir:GPIO(2) CS:GPIO(17) Disable:None Index:4 R:0.050 Limits(-140.000,0.000)]
[MSG:Z  Axis Trinamic driver test passed]

Settings are:
$0=4
$1=250
$2=0
$3=6
$4=0
$5=1
$6=1
$10=1
$11=0.010
$12=0.002
$13=0
$20=1
$21=0
$22=1
$23=3
$24=200.000
$25=2000.000
$26=250.000
$27=2.500
$30=24000.000
$31=8000.000
$32=0
$100=159.860
$101=160.150
$102=401.600
$103=200.000
$104=100.000
$105=100.000
$110=3000.000
$111=3000.000
$112=2250.000
$113=1000.000
$114=1000.000
$115=1000.000
$120=80.000
$121=80.000
$122=50.000
$123=200.000
$124=200.000
$125=200.000
$130=508.000
$131=782.000
$132=140.000
$133=300.000
$134=300.000
$135=300.000

Fcsteve777, 2022-06-03:
Update,
Received replacement unit and installed with the same settings.

Ran great for a half hour then noticed one of my y steppers stopped working. Everything ohmed out on the motors between 1.6 and 1.8 ohms. After re setting everything its back to buzzing the hell out of one of the steppers....

This is a 230$ letdown so far.

Spark-Concepts, 2022-08-09:
We are actively working with Trinamic to determine the root cause of these issues - please use the contact-us link on the Spark-concepts.com site for resolution

Closed 2022-08-09.

Thread 145 (2022-05-24):

xPro-V5 not responsive

RidwaanN, 2022-05-24:
Hi I have my xPro-V5 just under 2months now, it's been working fine all the time.
I last cut 2 weeks ago Friday. Monday passed i switched everything on as normal. Plugged in the controller via USB-C cable as usual and opened CNCJs.
As usual I clicked on Reset and Unlock. Where i would usually get all my configurations printed out on the left column - Nothing. The port is open, xPro V5 is powered on (Green light is on and blue usb light is on). It wont unlock or reset. Common response to anything is $X
I have tried closing the port and CNCJs, even restarting laptop and also tried connecting via LaserGRBL which will not connect successfully.

I have tried to connect to the xPro-V5s wifi network however not network is being found.

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

RidwaanN, 2022-05-25:
Hi. It appears to be in my device manager...
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

RidwaanN, 2022-05-25:
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

Mboss32, 2022-05-27:
Try opening the port in CNCjs, then pressing the "reset" button on the side of the controller

RidwaanN, 2022-05-28:
> Try opening the port in CNCjs, then pressing the "reset" button on the side of the controller

I have tried that. I even held it in for +/- 20 seconds with no response.

Jennywhite2, 2022-07-16:
> > Try opening the port in CNCjs, then pressing the "reset" button on the side of the controller
>
> I have tried that. I even held it in for +/- 20 seconds with no response.

Hello RidwaanN,may i know,where u come from,,malaysia?

Spark-Concepts, 2022-08-09:
Has this issue been resolved?

Jennywhite2, 2022-08-26:
![Uploading IMG_20220819_221215.jpg…]()

Jennywhite2, 2022-08-26:
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

Closed 2022-08-09.

Thread 146 (2022-05-27):

Y  Axis Driver Short Coil

manicresin, 2022-05-27:
Machine was working fine for a few days and I progressed through my build.
Yesterday the Y-Axis stopped working.

I disconnected all terminal blocks except for power and used a known good motor only connected to the Y axis with no change.
The same motor work on X and Z axis without issues.
I upgraded to the latest firmware also with no change.

```
>>> $g
[GC:G0 G54 G17 G21 G90 G94 M5 M9 T0 F0 S0]
ok
ets Jun  8 2016 00:22:57
rst:0x1 (POWERON_RESET),boot:0x13 (SPI_FAST_FLASH_BOOT)
configsip: 0, SPIWP:0xee
clk_drv:0x00,q_drv:0x00,d_drv:0x00,cs0_drv:0x00,hd_drv:0x00,wp_drv:0x00
mode:DIO, clock div:1
load:0x3fff0018,len:4
load:0x3fff001c,len:1216
ho 0 tail 12 room 4
load:0x40078000,len:9720
ho 0 tail 12 room 4
load:0x40080400,len:6352
entry 0x400806b8
[MSG:Grbl_ESP32 Ver 1.3a Date 20220403]
[MSG:Compiled with ESP32 SDK:v3.2.3-14-gd3e562907]
[MSG:Using machine:CNC_xPRO_V5_XYYZ_NO]
[MSG:Axis count 3]
[MSG:RMT Steps]
[MSG:Door switch on pin GPIO(16)]
[MSG:Hold switch on pin GPIO(13)]
[MSG:Start switch on pin GPIO(0)]
[MSG:Init Motors]
[MSG:TMCStepper Library Ver. 0x000703]
[MSG:X  Axis Trinamic TMC5160 Step:GPIO(12) Dir:GPIO(14) CS:GPIO(17) Disable:None Index:1 R:0.050 Limits(0.000,300.000)]
[MSG:X  Axis Trinamic driver test passed]
[MSG:Y  Axis Trinamic TMC5160 Step:GPIO(27) Dir:GPIO(26) CS:GPIO(17) Disable:None Index:2 R:0.050 Limits(0.000,300.000)]
[MSG:Y  Axis Driver Short Coil a:Y b:N]
[MSG:Y  Axis Driver Short vsa:Y vsb:N]
[MSG:Y2 Axis Trinamic TMC5160 Step:GPIO(33) Dir:GPIO(32) CS:GPIO(17) Disable:None Index:3 R:0.050 Limits(0.000,300.000)]
[MSG:Y2 Axis Trinamic driver test passed]
[MSG:Z  Axis Trinamic TMC5160 Step:GPIO(15) Dir:GPIO(2) CS:GPIO(17) Disable:None Index:4 R:0.050 Limits(-300.000,0.000)]
[MSG:Z  Axis Trinamic driver test passed]
[MSG:No spindle]
[MSG:Local access point CNC_xPRO_V5 started, 192.168.0.1]
[MSG:Captive Portal Started]
[MSG:HTTP Started]
[MSG:TELNET Started 23]
[MSG:Mist coolant on pin GPIO(21)]
[MSG:X  Axis limit switch on pin GPIO(35)]
[MSG:Y  Axis limit switch on pin GPIO(34)]
[MSG:Z  Axis limit switch on pin GPIO(39)]
[MSG:Probe on pin GPIO(22)]
Grbl 1.3a ['$' for help]
>>> $+
$0 = 4    (Step pulse time, microseconds)
$1 = 255    (Step idle delay, milliseconds)
$2 = 0    (Step pulse invert, mask)
$3 = 0    (Step direction invert, mask)
$4 = 0    (Invert step enable pin, boolean)
$5 = 1    (Invert limit pins, boolean)
$6 = 1    (Invert probe pin, boolean)
$10 = 1    (Status report options, mask)
$11 = 0.010    (Junction deviation, millimeters)
$12 = 0.002    (Arc tolerance, millimeters)
$13 = 0    (Report in inches, boolean)
$20 = 0    (Soft limits enable, boolean)
$21 = 0    (Hard limits enable, boolean)
$22 = 0    (Homing cycle enable, boolean)
$23 = 3    (Homing direction invert, mask)
$24 = 200.000    (Homing locate feed rate, mm/min)
$25 = 2000.000    (Homing search seek rate, mm/min)
$26 = 250.000    (Homing switch debounce delay, milliseconds)
$27 = 2.500    (Homing switch pull-off distance, millimeters)
$30 = 24000.000    (Maximum spindle speed, RPM)
$31 = 0.000    (Minimum spindle speed, RPM)
$32 = 0    (Laser-mode enable, boolean)
$N1=
$N0=
$33 = 5000.000
$34 = 0.000
$35 = 0.000
$36 = 100.000
$100 = 200.000    (X-axis travel resolution, step/mm)
$101 = 200.000    (Y-axis travel resolution, step/mm)
$102 = 200.000    (Z-axis travel resolution, step/mm)
$103 = 200.000
$104 = 100.000
$105 = 100.000
$110 = 2500.000    (X-axis maximum rate, mm/min)
$111 = 2500.000    (Y-axis maximum rate, mm/min)
$112 = 2500.000    (Z-axis maximum rate, mm/min)
$113 = 1000.000
$114 = 1000.000
$115 = 1000.000
$120 = 50.000    (X-axis acceleration, mm/sec^2)
$121 = 50.000    (Y-axis acceleration, mm/sec^2)
$122 = 50.000    (Z-axis acceleration, mm/sec^2)
$123 = 200.000
$124 = 200.000
$125 = 200.000
$130 = 300.000    (X-axis maximum travel, millimeters)
$131 = 300.000    (Y-axis maximum travel, millimeters)
$132 = 300.000    (Z-axis maximum travel, millimeters)
$133 = 300.000
$134 = 300.000
$135 = 300.000
$140 = 1.800
$141 = 1.800
$142 = 1.800
$143 = 1.800
$144 = 0.800
$145 = 0.800
$150 = 0.500
$151 = 0.500
$152 = 0.500
$153 = 0.500
$154 = 0.400
$155 = 0.400
$160 = 8
$161 = 8
$162 = 8
$163 = 16
$164 = 16
$165 = 16
$170 = 16
$171 = 16
$172 = 16
$173 = 16
$174 = 16
$175 = 16
ok
```

jaybay-77, 2022-06-02:
I've just sent mine back to makerstore here in Australia where I bought it. We did some remote troubleshooting and it definitely looks like an issue with the Y port. They are going to test it and replace if it's faulty. This seems to be fairly common issue and it's pretty slack that spark don't monitor and repond to their own customers.

Spark-Concepts, 2022-08-09:
jaybay,

Our customer interaction is handled directly via our contact us via our homepage Spark-Concepts.com - we are happy to assist. If you attempted to use the contact us and don't get a response within 1-2 business days please try again as on occasion some emails get sent directly to spam for "content"; astounding the number of pornographic and explicit spam emails on a daily basis that our spam filter blocks; unfortunately sometimes that includes legit emails too.

Regarding the Y axis issue - albeit somewhat relatively rare we are actively working with Trinamic to determine the root cause of the uptick with this particular issue.  We are confident in an expedient resolution. We take the upmost pride in our product and will stand by it.

Again, if you are having the specific issue in that the Y axis (specifically) is faulting, I urge you use the contact us link on our homepage and provide us as much detail at to the issue your seeing and when/and through whom you purchased your xPro from - we're exploring all avenues from firmware to hardware and manufacture/supply chain.

manicresin, 2022-08-09:
It was functioning normally then it was powered off and when powered back on it was not functioning at all and reported and error on that driver.

Spark-Concepts, 2022-08-09:
Thanks Manicresin,  have you recievd a replacement unit?

jaybay-77, 2022-08-09:
Same here, unit was working fine but then when powered up to run a job the error occurred.

manicresin, 2022-08-11:
> Thanks Manicresin, have you recievd a replacement unit?

No, I was ask for shipping details but never received a replacement or further instructions.

Closed 2022-08-09.

Thread 147 (2022-06-01):

Xpro v5 y axis fault

jaybay-77, 2022-06-01:
As of yesterday my y axis stepper fault indicator is on. The controller has been fine until my second job yesterday. The y axis now doesn't run correctly, it makes an awful grinding sound and doesn't move properly. If I switch the y2 motor over to the y port it also does the same thing, and the y motor runs fine when connected to the y2 port. To me this indicates a fault in the controller. Please have a look at the video and grbl settings and let me know how to fix this. It's only a year old and I am now unable to do anything until I get this resolved.
[Video](https://photos.app.goo.gl/g99Kdnhw7dHCTGkA9) [Grbl settings](https://drive.google.com/file/d/1-a6slgBp1NLDKgP5pNwxNvG62gNtUdYH/view?usp=drivesdk)

jaybay-77, 2022-06-02:
This has been sent back to Makerstore here in Australia for a fault test. Connecting the y motors directly to the controller proved that there is an issue with the y port:[Running a test grbl fiule form maker store on just the y axis](https://photos.app.goo.gl/SEkFU2SZrSgpYLmr7)

Appreciate an update from Spark on this issue as it seems to be very common. Maybe faulty hardware in the controller which they should be advising us about???

jaybay-77, 2022-06-08:
This unit was deemed faulty and replaced by Makerstor. Spark Concepts obviously don't bother checking their issues list so this is more for any users who may come across this issue.

Spark-Concepts, 2022-08-09:
We are actively working with Trinamic to determine the root cause of these type of issues - Please use the contact-us link on the Spark-concepts.com site for resolution

danatomy, 2022-11-22:
I have the same issue. Have contacted sparks.

Closed 2022-08-09.

Thread 148 (2022-06-02):

Y limits not working

Wolfpackcustoms, 2022-06-02:
im having issues with the Y and Y2(B) limit switches. I have tested both switches from the xpro connections to the switches and both test the same as the X and Z axis switches.

I have updated the Xpro with the xPV5xyyz.bin as per the forums and installed the CNC_xPRO_V5_XYYZ_NC.bin as the software file. In CNCjs (1.9.22) i can get it to register the z and x axis as hard limits but neither of the Y will register as a hard limit.

Can you advise as to how i can resolve this issue?

Its fitted on a custom built CNC plasma table (belt drive y and x with lead screw Z)

Spark-Concepts, 2022-07-12:
Are you still having issues with the Y hard limits? If so, please post your settings $S - also provide a picture of your limit switch wiring on your xPro

Closed 2022-08-09.

Thread 149 (2022-06-03):

G38.2 probe causes lockup in macros

NeonHorizon, 2022-06-03:
Hardware: CNC xPRO V5
ESP3D-WebUI: 2.1b52
GRBL-ESP32:  1.3a
Firmware: CNCxPROv5_XYYZ_NC.bin (20220403)

If I enter the following commands in the WebUI interface they work perfectly every time:
```
G10 L2 X0 Y0 Z0      ; Set the working coordinates to match the machine coordinates
G90                  ; Use absolute positioning
G38.2 Z7 F50         ; Probe Z, dont go closer than 7mm from Z0 as the touch plate is 7mm
G91                  ; Use relative movements
G0 Z1                ; Clear the touch plate by 1mm
```

The mill descends, touches the plate and backs off as expected.

However when the exact same code is placed in a WebUI macro, the probe moves downwards at 50mm/min, touches the plate then CONTINUES to descend but at a much much slower rate indefinitely pushing the bit into the touch plate and ignoring the gcode placed after the G38.2. The WebUI interface also becomes non responsive and the XPro has to be power cycled to be usable again.

The probe has been checked and is functioning perfectly.

UPDATE 1 - I've just been testing and noticed exactly the same behaviour can be observed using the following simple one liner in a macro:
```G38.2 Z5.0 F50```
There's a 50mm/min descent and instead of stopping after touching it drives the bit hard into the touch plate at a very low speed.

UPDATE 2 - I just tried the following code in a macro:
```
G91
G38.2 Y5 F50
G0 Z1
```
It moves towards the touch plate at 50mm/m on the Y axis as expected, touches the plate then continues to move at a very slow speed and again WebUI is locked up until a power cycle.

It appears as if G38.2 has issues when used in WebUI macros?
At least on my set up?

Thanks

NeonHorizon, 2022-06-08:
Just an update on this, if you upload the code to the SD card and run it as if its a regular job it works fine. So its literally a macro issue.

haksko, 2023-02-07:
I have the same problem. Is there a solition to this?

Thread 151 (2022-06-08):

Connect Xpro V5 to wifi network

jaybay-77, 2022-06-08:
Given there is ZERO documentation on doing this, can **Spark** please provide some clear instructions on how to do this?

Spark-Concepts, 2022-07-12:
Default Settings
The first time you power up the ESP32 with Grbl_ESP32 it cannot connect to your WiFi network because it does not know the SSID and password for your network. It will a create its own Wifi access point with the following settings.

- SSID: GRBL_ESP
- Password: 12345678
- IP Address: 192.168.0.1

Connect your PC, Tablet, etc to this network. Most computers will automatically launch a browser to connect to Grbl_ESP32 after connecting via Wifi. If it does not, simply enter http://192.168.0.1/ for the address in your browser.

This is very convenient if you are just getting started or there is no existing network to connect to. Unfortunately, this typically causes your computer to lose its Internet connection, so you probably want to setup Grbl_ESP32 to use your WiFi network.

# Method 1: Using the WebUi

Generally, we recommend using the Access Point just for network security purposes.  If you can accept that risk, or have a local network you can change the behavior of the wifi connection with the below settings.

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

The first two are hopefully obvious.  For the Station IP Mode, choosing a static IP will keep the xPRO from being re-assigned so select a Station Static IP that you know is on your network and free.  Add your gateway address (192.168.1.1 is fairly typical) and add the network mask (255.255.255.0 is also fairly typical).

Make sure you click the "SET" button for each of these entries before moving on.

Lastly, change your Radio Mode to Station.

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

Click "Set".  Reboot the controller and connect your computer to your network, open a browser, and type in the assigned static IP.

_note: if you need to reset the network settings back to default: Send command `"$Radio/Mode=AP"` through the command terminal in CNCjs and restart the controller to reset the Wifi to Access Point mode_

# Method 2: Using a serial terminal

Send the following command through the command terminal in CNCjs and restart the controller

`$Sta/SSID=YourSSID`
`$Sta/Password=YourPassword`
`$Radio/Mode=STA`

markcagatandavis, 2022-11-08:
This doesn't do anything..

jaybay-77, 2022-11-08:
Agreed. I gave up on this after following these instructions and getting nowhere.

markcagatandavis, 2022-11-08:
> Agreed. I gave up on this after following these instructions and getting nowhere.

I managed to get it working after 3-hours... If you want to give it a try:

1. Set your IP configurations using the WebUI is fine (Station Static IP, Station Static Gateway, Station Static Mask).
2. Don't use the webUI for the bellow, it doesn't work\save your settings.
3. Connect using USB-A to USB-C cable
4. In CNCJS console:

$Sta/SSID=Your WiFi SSID Name (case sensitive I found)
$Sta/Password=Your WiFi password
$Radio/Mode=STA

NOTE: For some stupid reason, when you add a value to the $Sta/ you can only add one at a time, and then you need to reboot the xPro in between each. Otherwise, the value doesn't save.

Once all the values have been done and rebooted in-between each configuration, make sure you power off the xPro from the wall. Since it uses a sperate power supply, it must keep the capacitors live or something? Give it 5min and authentication should work, and you can connect to the IP from your normal network.

I tested this a few times to see if I just needed a single power drain, but it seems to be required after setting each value. I also noticed when you enter the values via console, it doesn't give you an OK to let you know it's done... this is why a reboot is required after each value has been set.

markcagatandavis, 2022-11-09:
UPDATE: I wouldn't bother with WiFi... Turns out it's pretty unstable and drops out a lot. I am pretty much next to the router, so it would either be EMI or the wifi controller/driver is not great.  :)

Thread 154 (2022-06-17):

More VFD issues after firmware update. :(

spydercnc, 2022-06-17:
Using xPro5 with a 1.5 water-cooled VFD. Got the system working in January via RS485 and it has worked well, seamless for the most part actually. There were a few connection issues that required a reset nearly every time I switched the xPro5 on, decided to load the newer debug firmware. Eventually managed to get the WebUI working and flashed it using the over air function.     The spindle was loaded in GRBL, and communicated with the expected messages and then with a error message and no RX response. GRBL now runs a continuous loop of error messages and will not allow me to enter any new $ lines. I reloaded/entered the VFD codes and double checked, all wiring was shielded and installed and as above was working. I have fitted two 120K resistors to both ends of the RS485 wires. There is a red light flashing on the xPro but no alternating green light. Suggestions welcome. :(

spydercnc, 2022-06-17:
Update and a shoutout for CNC3D Commander. Used their update tool, downgraded the firmware to the previous RS485 NO.Bin file, added the $spindle /type and a little green light started flashing  with everything springing into life. Life can be simple at times-begs the question why it had to be complicated then??

Spark-Concepts, 2022-08-09:
Try installing the latest firmware as of July 2022 - If you're still having issues read https://github.com/Spark-Concepts/xPro-V5/issues/164#issuecomment-1208726453

Closed 2022-08-09.

Thread 155 (2022-06-20):

Can a X proV5 firmware be set to Grbl 1.1  ?

ice-tii, 2022-06-20:
Hello there!

I have an problem of comunicating between Picsender and my xpro V5.
I found out that grbl1.1 is the highest compatibel version for picsender,
so now i want to flash grbl 1.1 on it.

Is it possible and if yes, what would be the best way?

Thank you guys!

 Timo from Austria!

lagnat, 2022-06-24:
You might look into https://github.com/bdring/FluidNC, however stick with v3.4.4 for the time being.

Spark-Concepts, 2022-08-09:
No unfortunately GRBL1.1 is ported to a Atmel 328 processor and the xProV5 is a ported version based on GRBL 1.1 to an ESP32 processor module (with expanded capability)

I have several xPro V3's and 4's that are true GRBL 1.1 you could have for free if you pay shipping from the US to Austria lol

Do you currently have an xPro V5? It should work, however, I can't confirm without testing. Was there a specific reason you were looking at Picsender? There are many other sender programs that are very good like universal G-code sender and CNCJS

ice-tii, 2022-08-09:
Hello there!

Well that answer shure took a while :-)

I bought a v5 from Ratrig.com and i will send it back because the V+ 10V for spindel control raises and lowers the Voltage when i do a job.

But everything else works fine.

With Picsender you can go up to 2 millions lines, so for my topo Lanscapes, which sometimes go in that direktion,

picsender really does the job, without having issuses. 

At first i worked with ugs and after several hours, the z axis, plunged suddendly in the material and ruined my router and the HDU Material.

Then i came across a guy from the us which said that picsender is specially for big files and now that i work with that i am so happy and no problem at all.

Since i want to do Workshops with young and old people, that they can get in touch with Cnc and learn step by step on how to do that,

i would take your offer to ship the v3 v4.

In that case could you find out what shipping would cost? 

Here in my area we dont rally work with grlb, more with mach3 and i want to introduce people in the world of grbl and the workbee cnc kit.

Thank you for your answer!

Mit freundlichen grüßen

Timo Helder
3D WELTEN
Ö/Vorarlberg
6943 Riefensberg
Riebinger 136

+43 6763632706
www.3d-welten.at

ATU74032806

Gesendet: Dienstag, 09. August 2022 um 04:54 Uhr
Von: "Spark" ***@***.***>
An: "Spark-Concepts/xPro-V5" ***@***.***>
Cc: "ice-tii" ***@***.***>, "Author" ***@***.***>
Betreff: Re: [Spark-Concepts/xPro-V5] Can a X proV5 firmware be set to Grbl 1.1 ? (Issue #155)

No unfortunately GRBL1.1 is ported to a Atmel 328 processor and the xProV5 is a ported version based on GRBL 1.1 to an ESP32 processor module (with expanded capability)

I have several xPro V3's and 4's that are true GRBL 1.1 you could have for free if you pay shipping from the US to Austria lol

Do you currently have an xPro V5? It should work, however, I can't confirm without testing. Was there a specific reason you were looking at Picsender? There are many other sender programs that are very good like universal G-code sender and CNCJS

—
Reply to this email directly, view it on GitHub, or unsubscribe.
You are receiving this because you authored the thread.Message ID: ***@***.***>

Spark-Concepts, 2022-08-09:
Timo,

I'm the one from Spark-Concepts who monitors the github - unfortunately back in early June I had to tend to a family emergency and was unable to give github the love it requires. All is good now, however, I'm catching up on answering questions.

First off regarding xPro's PWM output raising and lowering, I've heard a couple folks having a similar issue. My hunch is that it may be a grounding issue on your VFD (most are). Especially if you've tried running your VFD over RS485 with similar issues.

Since we're based in the US, we've only been able to fully test the 110V VFD's using the xPro - we really haven't had any issues like what you're seeing (either it works or it doesn't)...  oddly enough, 98% of folks reporting VFD issues are running 220-240V VFD's. That said, we recently purchased a 110 to 240 voltage converter and are awaiting delivery of a 220/240V VFD - you'd think they'd be relatively similar in design, apparently they are different animals.  That said I plan to evaluate the VFD design and look for any design aspects that may be influencing issues like what you are seeing. Please keep me in the loop as to the status of your VFD controller once your new controller arrives.

Now, regarding the V3's and V4's... how many V3's do you want?, I found a box full of them - I'm not sure I if I have any V4's. Regardless, I will have Mike take a look at cost of shipping to Austria and will reply back to you later today.

Cheers Bill

ice-tii, 2022-08-10:
Hello Bill!

ok so i have the peorson to thank for all that good work, with Github!

I can speak for People around the Globe, thank you! Without your work it would be way more difficult to come into the World of printing and cnc.

So enought of that honey talk :-)

Time to get serios!

I can ashure you that it wasnt a grounding Problem. I have grounded every singele wire all on 1 ground just like a Technischian would do.

There where a lot of trouble because of me not knowing to ground wires, but my Father was there and showed me how to, hes IT spezialist!

So after i have grounded every singel Motor wire, the maschine and the Spindel, the only thing was still the PWM controll.

So i put a pwm converter outside to work like that and it worked just like with my v3, perfectly.

Then i shut of the spindel and pulled the plug from the v5 and messured the pwm and it was still going up and down.

My Dad said, that he likes the v5 but said thaqt some parts like the pwm converter sometimes might intervire with the rest of the electronics, so 

putting everything in one box can cause trouble. I even had troubel with the steps when i put 1/16 microstepping, just the z axis worked, but not Y and X.

I crashed my maschine to find that out :-)

I now have ordered the black box which i wanted to get in first place, becuase now i have to send the v5 back to Spain, have to pay the shipping and some reduce of the price,

because of me using it. So for myself, i dont want to put any more money on that, because if i will get a nother one which does the same i can go trough that process again

and lose time and money. And Shipping cost are exploding these days! :-)

So with the V3 you have, if you dont really need them and you want to get that box out of your way, i would take the box if the shipping is not to high.

The only thing for me is that the v3 is rated to 2,5 A for the steppermotors, which can cause problem, with loosing stepps will a job, especially, when you go to 1/16 microstepping.

But for beginners, thazt could be a good start, because i worked with the V3 now 2,5 Years and am doing amasing stuff. 

Mit freundlichen grüßen

Timo Helder
3D WELTEN
Ö/Vorarlberg
6943 Riefensberg
Riebinger 136

+43 6763632706
www.3d-welten.at

ATU74032806

Gesendet: Dienstag, 09. August 2022 um 17:15 Uhr
Von: "Spark" ***@***.***>
An: "Spark-Concepts/xPro-V5" ***@***.***>
Cc: "ice-tii" ***@***.***>, "Author" ***@***.***>
Betreff: Re: [Spark-Concepts/xPro-V5] Can a X proV5 firmware be set to Grbl 1.1 ? (Issue #155)

Timo,

I'm the one from Spark-Concepts who monitors the github - unfortunately back in early June I had to tend to a family emergency and was unable to give github the love it requires. All is good now, however, I'm catching up on answering questions.

First off regarding xPro's PWM output raising and lowering, I've heard a couple folks having a similar issue. My hunch is that it may be a grounding issue on your VFD (most are). Especially if you've tried running your VFD over RS485 with similar issues.

Since we're based in the US, we've only been able to fully test the 110V VFD's using the xPro - we really haven't had any issues like what you're seeing (either it works or it doesn't)... oddly enough, 98% of folks reporting VFD issues are running 220-240V VFD's. That said, we recently purchased a 110 to 240 voltage converter and are awaiting delivery of a 220/240V VFD - you'd think they'd be relatively similar in design, apparently they are different animals. That said I plan to evaluate the VFD design and look for any design aspects that may be influencing issues like what you are seeing. Please keep me in the loop as to the status of your VFD controller once your new controller arrives.

Now, regarding the V3's and V4's... how many V3's do you want?, I found a box full of them - I'm not sure I if I have any V4's. Regardless, I will have Mike take a look at cost of shipping to Austria and will reply back to you later today.

Cheers Bill

—
Reply to this email directly, view it on GitHub, or unsubscribe.
You are receiving this because you authored the thread.Message ID: ***@***.***>

Spark-Concepts, 2022-08-13:
Timo,

Would you mind emailing me at bill@spark-concepts.com

Closed 2022-08-09.

Thread 157 (2022-06-23):

Limit switch /vfd issue

Bentowle, 2022-06-23:
I have been having a issue with my vfd, if I unplug the z axis limit from the control box I have no problems, when I move the limit switch near the box the spindle rpm error happens .

Staggeble, 2022-06-23:
I fixed this issue by connecting the shielding of the limit switch to the ground.

Staggeble, 2022-06-23:
I used this guide for my setup. https://wiki.printnc.info/spindle_settings.pdf

Bentowle, 2022-07-11:
i ended up needing to add chokes.

Closed 2022-08-09.

Thread 159 (2022-07-11):

macro buttons

Bentowle, 2022-07-11:
im kinda confused how to setup the macros the way i want to.

i want 1 as start/resume and the other as pause/hold .     what are the line of code do i enter todo this?

will the start button start the program after i load  the file? like a cycle start does on a haas?      would pause hold work the same as a haas ie i can press the feed hold and the program pause , can blow chips out etc then hit the cycle start/resume again?

Bentowle, 2022-07-11:
i understand $User/Macro0= and $User/Macro1=   are the two codes i need to enter.   i dont know what they should equal or if i need to equal a few things.

Spark-Concepts, 2022-08-08:
I'm assuming this has been resolved - if not, please re-open this issue...

I believe the latest firmware revision has this defined already [CNC_xPRO_V5_XYYZ_NO.bin](https://github.com/Spark-Concepts/xPro-V5/blob/main/Firmware/CNC_xPRO_V5_XYYZ_NO.bin)

Otherwise you'll need to do the following:

This setting be made in the  in the ESP32Grbl [source code](https://github.com/Spark-Concepts/xPro-V5-Firmware/tree/main/CNCxPROv5_20220808/src) prior to compilation - the firmware would be done when compiled: [_How to Compile via Arduino_](https://github.com/bdring/Grbl_Esp32/wiki/Compiling-with-Arduino-IDE)

Assuming the default machine config (normal XYYZ with a normally open e-stop switch) :
Changes made to [CNC_xPRO_V5_XYYZ_NO.h](https://github.com/Spark-Concepts/xPro-V5-Firmware/blob/main/CNCxPROv5_20220808/src/Machines/CNC_xPRO_V5_XYYZ_NO.h)
```cpp
/***********   Input Pins  ******************/
#define PROBE_PIN               GPIO_NUM_22
#define X_LIMIT_PIN             GPIO_NUM_35
#define Y2_LIMIT_PIN            GPIO_NUM_36
#define Y_LIMIT_PIN             GPIO_NUM_34
#define Z_LIMIT_PIN             GPIO_NUM_39

// Comment out the two lines below
// #define MACRO_BUTTON_1_PIN      GPIO_NUM_13
// #define MACRO_BUTTON_2_PIN      GPIO_NUM_0

// Then add the following two lines
#define CONTROL_FEED_HOLD_PIN      GPIO_NUM_13
#define CONTROL_CYCLE_START_PIN      GPIO_NUM_0

#define CONTROL_SAFETY_DOOR_PIN GPIO_NUM_16
/********************************************/
```

Make sure to define the machine type on the [Machine.h](https://github.com/Spark-Concepts/xPro-V5-Firmware/blob/main/CNCxPROv5_20220808/src/Machine.h) file:

```cpp
// Find and Comment out the line below
//  #    include "Machines/CNC_xPRO_V5_XYYZ_NC_Y2Lim.h"

// Add the line below
#    include "Machines/[CNC_xPRO_V5_XYYZ_NO.h"
```

_note: change "CNC_xPRO_V5_XYYZ_NO.h" to whatever your machine type is if it's not the standard default load... i.e. CNC_xPRO_V5_XYYZ_NC.h_

Closed 2022-08-08.

Thread 162 (2022-07-12):

Unable to set steps per mm

scifunk909, 2022-07-12:
I've tried numerous equations to get the axis travel correct but nothing is working.

Spark-Concepts, 2022-08-08:
If your screw goes 2mm per revolution. You would divide the number of steps per rev by that. So 200 steps/2mm.... eg 100 steps/mm

What machine are you configuring - also, belt or screw?

Spark-Concepts, 2022-08-09:
if this helps...

You will need to change the following settings:
```
$100= (x, step/mm)
$101= (y, step/mm)
$102= (z, step/mm)
```
Type $$ in the command window and make note of the following micro step settings
```
$160 = (x, microsteps)
$161 = (y, microsteps)
$162 = (z, microsteps)
```

... and will depend on the stepper motor your using - for example: typical NEMA 17 motors are rated at 200 steps per revolution and you will need to do some math:
1. Move each axis by rotating the  the applicable stepper motor 1 revolution and measure the displacement in mm
2. Divide 200 by the displacement in mm you determined in step 1
3. Multiply and record the value from step 2 above with the applicable axis microstep value (this will be your $100, $101, and $102 value(s)

for example (x axis):
- NEMA 17 motors are rated at 200 steps per revolution
- ex. $160 = 8
- ex. 20mm per x stepper revolution
- 200-steps/revolution ÷ 20mm/revolution = 10-steps/mm
- 10-steps/mm x 8-microsteps = 80-steps/mm
- Type ```$100=80``` in command window
- You will do this for each axis

Closed 2022-08-08.

Thread 163 (2022-07-16):

Hello,,im using xprov5

Jennywhite2, 2022-07-16:
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
Did my wiring is correct,,im put Ac power to power supply then loop/jump to vfd,, im using xpro v5,,,can some one sharing wiring diagram xprov5,,,because on github im not clear about wiring..

RoboDaRock, 2022-07-30:
The photos are not clear enough to make out. Can you take some close up shots.

spydercnc, 2022-07-30:
The other issue I had originally is that I used 4 core wire. Using a twisted pair, shielded, wire sorted that out as well. I have also put a 100ohm resistor over the terminals, although it was working without it.

RoboDaRock, 2022-07-31:
Hi spydercnc can you email me the firmware file you used my email roccoszabo@gmail.com thanks in advance

RoboDaRock, 2022-07-31:
Hi spydercnc  any chance you could email me the firmware you use  thanks in
advance

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

Spark-Concepts, 2022-08-09:
RoboDaRock,

Were you able to sort things out? If not please post a more clear image of your current wiring - also please review
 https://github.com/Spark-Concepts/xPro-V5/issues/164#issuecomment-1208726453

Spark-Concepts, 2022-08-09:
RoboDaRock,

That was my mistake, that last comment requesting images was directed toward Jennywhite2. I see you re-posted on the other issues thread. I totally get and don't blame you for being frustrated.

I believe we are shipping you a new unit which I personally tested on our rig via multiple 3hr test jobs running a rs485 spindle while monitoring and verifying all system functions before packaging and shipping.

Closed 2022-11-09.

Thread 164 (2022-07-28):

Problem connecting VFD spindle 2.2 kw water cooled to xprov5

Nmfinest, 2022-07-28:
Hello everyone I'm having a problem getting my cncj software to recognize or to get my spindle to turn on I've tried to update firmware reset VFD resetting my xprov5 I'm at a lost and have been using my spindle manually which isn't bad just would like it run right so if any one has any suggestions please let me know thank you

RoboDaRock, 2022-07-30:
Hi yes I'm having the same problem. It worked for me for about 2 hours then nothing. First of all check Wether the light under the pwm/rs485 switch is flashing green as well as red. This way you know that they are both talking to each other . Set up the vfd prg 1 is set to 2 and prg 2 is set to 2.  Foll ow the setup guide for other settings for the vfd.    If this does not work and you can spend alot of time trying to fix this issue like me. I downloaded a small program called spindle talker.  I bought a cheap usb to rs485 converter . Downloaded and installed the driver for spindle talker . Once I did this the program spindle talker controlled the spindle no problems. So this only leaves one thing. Since the vfd is working properly over rs485 through spindle talker that only leaves a faulty xpro. I've literally wasted months trying to source the problem. At least now I know the xpro is not working.  I'm just not sure a new one will fix it.

spydercnc, 2022-07-30:
I am using cnc3D commander. Used that to reinstall the original firmware to xPro and it worked, after stopping with the new firmware.

Craig Mclaren

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

RoboDaRock, 2022-07-30:
Yes I checked out cnc3d.  Wow leaves cncjs for dead.  I'll give the old firmware a go tomorrow let you know how I go. Thanks for the tip

Nmfinest, 2022-07-30:
Where did you get the USB to rs485

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

RoboDaRock, 2022-07-31:
Ebay

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

RoboDaRock, 2022-07-31:
Can you give me a link to the firmware you used. I tried changing the firmware with no luck. Used cnc3d commander no problems. Beats cncjs by a country mile.    Thanks in advance

Nmfinest, 2022-07-31:
How do u connect cnc3d to xprov5

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

RoboDaRock, 2022-07-31:
It uses the same drivers as cncjs and just press connect button

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

Nmfinest, 2022-08-02:
How do u connect cnc3d to xprov5 same way as cncj and then how did you get
you spindle working once you connected to the cnc3d

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

RoboDaRock, 2022-08-02:
I still haven't got the spindle working. To connect to cnc3d is the same as
cncjs only a bit easier.  I can only get the spindle working through
spindle talker. Sparks is sending me a new controller  I'm suspecting the
controller is faulty

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

Spark-Concepts, 2022-08-08:
All,

Please read below in it's entirety (also for 220V VFD user please see note at the end of this post) - also, if at any point I'm not clear or what I'm saying doesn't make sense, please repost and I will do my best to explain in more detail.

we're seeing a-lot of issues regarding RS485 communication errors.... most all issues regarding this revolve around folks with 220VAC mains and 90% of the issues are related to ground loops, RF coupling and/or faulty wiring or misplaced grounds/neutrals. These can sometimes be extremely frustrating and often difficult to troubleshoot . Some folks have also used RS485 to USB converters to test communications between the VFD without issue - in this situation your computer's power supply is typically isolated from mains power; in other words  you eliminate the potential for ground loop disturbances on the RS485 signal path.

RS485 is a differential pair, meaning the differential voltage between RS485A and RS458B _and not with referenced to ground_); this means common mode noise (noise the the same on both A and B and can dance around in sync if measured with an oscilloscope relative to ground - however if measured differentially (voltage on A - B) you should get a nice clean square wave... again this all falls short when coupled to ground.

 - RS485 is also bi-directional, meaning it sends and receives on the same set of wires

A few things to check first:
- ensure your [firmware](https://github.com/Spark-Concepts/xPro-V5/tree/main/Firmware) is up-to-date
- RS485 wiring is less than 1 meter in length, twisted, and connected properly (resistors are optional)
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
- Verify the **PWM-RS485** switch<sub>(1)</sub> is set to **RS485**
- Sometimes the PWM-RS485 switch contacts may be contaminated with flux as received from manufacturing; try using contact cleaner or applying 99% isopropyl alcohol with a dropper to the switch (working it back an forth a few times) _ONLY USE (99% IPA - ANYTHING LESS THAT IS DILUTED WITH WATER AND WILL HAVE THE ADVERSE EFFECT)_
- verify the spindle type is defined - on the command window send the following: ```$Spindle/Type=HUANYANG``` if that doesn't work, try ```$Spindle/Type=H2A```
- Verify your VFD is configured properly using the procedure in the [Huanyang-VFD-manual](https://github.com/Spark-Concepts/xPro-V5/files/6247012/Huanyang-VFD-manual.pdf) _PLEASE REFER TO THE MANUAL SPECIFIC TO YOUR MODEL VFD; not all VFD's are the same despite the name on it_

Set the following register values via the VFD touchpad (should be the same on most VFD's - VERIFY ON YOUR SPECIFIC MODEL VFD):
| Register  | Value | Description |
| :-------: | :-----: | ------------- |
 | PD000 | 0 | **unlock parameters** |
 | PD001 | 2 | **Command source is RS485** |
 | PD002 | 2 | **Speed source is RS485** |
 | PD163 | 1 | **Communications address 1** |
 | PD164 | 1 | **9600 b/s** |
 | PD165 | 3 | **8 Bit No Parity - RTU** |
 | PD000 | 1 | **lock parameters** |

 _Also check the following settings (these will setting will vary based on the values indicated on the motor's nameplate and your mains voltage 110VAC vs 220VAC)_

| Register  | Description |
| :-------: | ----- |
| PD004 | **Base frequency as listed on spindle** _(typically 400)_ |
| PD005 | **Maximum frequency Hz** _(typical value for spindles is 400)_ |
| PD011 | **Min speed** _(recommended air-cooled=120 water=100)_ |
| PD014 | **Acceleration time** _(test to optimize)_ |
| PD015 | **Deceleration time** _(test to optimize)_ |
| PD023 | **Reverse run enabled** _(set to 1)_ |
| PD141 | **Spindle max rated voltage** _(typically 220)_ |
| PD142 | **Max rated motor current** _(0.8kw=3.7, 1.5kw=7.0, 2.2kw=??)_ |
| PD143 | **Motor poles** _(typically 2 or 4)_ |
| PD144 | **Rated motor revolution at 50Hz** _(typically 3000 @ 50Hz and 24000 @ 400Hz)_ |

_as a side note, we (Spark Concepts) seldom run into issues with VFD's running on 110V mains.  Since we are US based (110V mains), it's impossible to test the 220V 100% representative. Therefore we are in the process of acquiring a 220V voltage converter and 220V VFD since the 220V model VFD is different from the 120V version_

 - Our to-do plan: reverse engineer the RS485 signal path on the most popular 220V model VFD's and will determine if/where coupling may be occurring and  try to reproduce/isolate any potential issues, and provide potential solutions.

RoboDaRock, 2022-08-09:
I haven't been able to get this thing working properly I've followed installation instructions to a T.  I've got 2 ferrite chokes on the wires as  shown. I've wasted months on this thing.  I'm totally fed up with trying to get  this thing to work properly.
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
![Uploading 20220809_142752.jpg…]()

id192313, 2022-08-09:
I have the same issue but managed to get it to work after implementing all the fixes that have suggested before. In the end the only thing that make it works is the resistor on the RS485 (both side) and using a Belkin surge protector. The moment I use a different extension without any grounding it failed. Hope this help.
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

mattydboom, 2022-08-09:
Is there any reason not to use a **Metal film resistor** rather than a Carbon film type (which looks to be shown in the diagram)?

I can easily get hold of the Metal Film type in both 100 & 120 ohm... so am looking to get confirmation on the type and which of these two ratings would be optimal before ordering. Thanks in advance for anyone's better knowledge on this!

Spark-Concepts, 2022-08-09:
Either metal film or carbon film is perfectly fine.

Nmfinest, 2022-08-09:
You and me both I have mine set up just like yours and I have had this
issue for months also don't know what to do I hit up a guy from sparks and
he said he would help me out on this issue but hasn't responded yet but
when he does and we get this taken care of I'll pass the info on to you and
you vise versa thanks

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

Spark-Concepts, 2022-08-09:
Nmfinest, did you use the contact us link on the Spark-Concepts.com site? If not, please use the contact us method to email us. Unfortunately if we were to throw our emails out to the entire internet, we'd be bombarded with spam email. Sometimes customers personal email's will get marked as spam and you think we're ignoring you. I promise that's not the case.

If you sent us a message and it's been more than 2 business days and one of us hasn't responded, please use the contact us to poke us for status (sometimes personal emails get marked as spam and we miss them). In the meantime will talk with mike to see if he's aware of your situation.

Spark-Concepts, 2022-08-18:
If you've tried everything and are still having EMI issues (unreliable communication between the xPro and your VFD).  You may try installing an isolated RS-485 repeater **(with this device RS485 communication is completely isolated and provides additional ESD protection)**

~$15US via ebay/Amazon
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

RoboDaRock, 2022-08-18:
That is ironic that you should suggest this . I hooked up the xpro to the
rs485 adapter and it sprung into action. Red and Green lights going off.
This clearly shows the xpro is working fine. It wouldn't talk to the
Spindle talker program because it's configured as a master not a slave .
The common denominator in this is the isolation of the laptop I'm using to
drive the rs485 usb adapter.  I'm not going to get too excited yet. I've
ordered special rs485 cable from China and when it arrives I'll rig it up
and see how it goes. The main thing out of this is Sparks being proactive
to find a solution.

Cheers

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

Spark-Concepts, 2022-08-25:
1. Placing an Oscilloscope at the RS485 output signal from the xPro ```DISCONNECTED from VFD```:
    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

2. Measuring RS485 signal at the 220V VFD while connected to the xPro ```WITHOUT RS485 isolation```:
    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

3. Measuring RS485 signal at the VFD while connected to the xPro ```WITH RS485 isolation and twisted pair```:
   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

VossAero, 2022-08-25:
Is the second example with or w/o twisted pair? The twist is doing a lot.
What about resistors? not used at all?
Shielding? Not used?
What is the difference between the three graphs? What are they?

Spark-Concepts, 2022-08-26:
The second example is not using a twisted pair or resistors. You are accurate, the twist does improve the signal quality, but not nearly the amount the isolator does (difference is illustrated between image 2 and image 3 above). Also note, even with the degraded signal quality (image 2),  I was still able to communicate with the spindle.

***NOTE: The resistors were minimally effective  in reducing noise with cable lengths less than 1-meter long***

Ultimately, the Huanyang VFD's due to the nature of how they are constructed, share a common ground and can unintentionally create ground loops thus permitting radiated noise to degrade the rs485 signal despite all best efforts.
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
Ultimately to mitigate this scenario I reccomend implementing an RS485 isolator as shown above.

I will post a much more extensive write-up this weekend illustrating the effects of each wiring scheme along with actual pictures showing the configuration of each.

VossAero, 2022-09-13:
I have ordered and installed the RS485 isolator/repeater. Unfortunately it does not help me.
In the beginning it works fine - leds on XproV5 and repeater show frequent communication. As soon as I start spindle rotation the communication breaks down >> communication leds blinking frequency goes down. No response messages in CNCjs until Alarm message. Never reacts to a M5 command. That all stops when I turn off the spindle by the STOP button on the VDF front panel.

I have the RS485 wire a twisted pair, I have resisitors, I have a 220V home supply, I have the spindle cable shielded and shield grounded to the VDF. I have VDF settings as instructed. No more ideas...

RoboDaRock, 2022-09-14:
I finally got my rs485 isolator wired it up. Reconfigured everything And
away it went. I'm hoping that this is a permanent fix.  Thanks for the help
Mike and the crew at sparks. Cheers

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

leadsmkt, 2022-09-15:
For me, same config  and same problem than @VossAero  with this RS485 repeater : https://amzn.eu/d/32Xcsbg

VossAero, 2022-09-15:
> For me, same config and same problem than @VossAero with this RS485 repeater : https://amzn.eu/d/32Xcsbg

What you bought is the wrong product. It is a repeater only but not an isolator - the isolator function is the important one I understand.

VossAero, 2022-10-07:
I have my solution!
I was really trying everything. Including ferrits and so on. Also just putting the RS485 repeater/isolater did not bring any change.
I still was also using different wires and when I tried the last wire I had for test - surprisingly it started to work correctly. It is a audio cable with two drolled lines and a metallic shielding. The wire gauge is fairly small.
I removed all things that should help to solve my issues and found out that finally this specific wire together with the repeater/isolator box is doing the job. Nothing else needed, nothing else helping.
Now I can concentrate on using my router... great, but EMI is difficult game.

VitaliiSadovshikov, 2023-01-23:
I have ordered and installed the RS485 isolator/repeater (in accordance with the scheme attached in this thread), but the controller doesn't show communication (the controller led flashes with red light). When I connect the VFD and controller simply just with a cable the connection works. Does someone have the proble with connection of the RS485 isolator/repeater?

cdo1955, 2023-03-08:
I have the same set up with the RS 485 isolator. It was still sporadic until I put the spindle controller in a electrical box and grounded the box. The box has a slot on the bottom I left open for air flow. Ever since everything is working fine. My wave forms look much cleaner now that the source of the EMF in in a metal box. box type listed below.
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

Thread 167 (2022-08-07):

Are sources up to date for compiling ?

mathojojo, 2022-08-07:
Hello,

I see that last sources modifications for the xPro V5 (here : [https://github.com/Spark-Concepts/xPro-V5-Firmware](https://github.com/Spark-Concepts/xPro-V5-Firmware)) were modified on 2021 November.

Your precompiled firmwares had 2 updates April and June :

April release Note :
- Minor bug fixes
- TMC5160 Tuning
- Fixes bug requiring double reset for Z motor

June release Note :
- minor bug fixes and motor/current tuning

I successfully compiled the sources, with your CNC_xPRO_V5_Machine_Template.h file without changing anything, just to see if I was able to do that (I never compiled anything up to now) : successfully, a good point.
My goal is to adapt it to my motors (run an hold currents, in a first step).

But :
Bugs (and optimizations) were fixed in April and June 2022, but I compiled from sources from 2021 november.

Do my self-compiled binary still suffer from the bugs described above, or not ?? (no TMC5160 tuning, no fix for the double Z motor reset, no motor current tuning, and no optimizations )
 If yes, you should really considere to update your sources, because they become unusable and useless if they are blocked in a buggy state.

Thank you for your consideration and help.

Spark-Concepts, 2022-08-07:
mathjojo, good catch & thank you for the heads-up.

You are correct, the source files do not match the most up to date compiled bin files - I will post the most current source code here very shortly (I'm not at my computer at the moment).  I will re-comment on this issue once I've posted the update source code

mathojojo, 2022-08-07:
Thank you very much, it's greatly appreciated.

Maybe you can in the same time answer a question:
On the [GRBL_ESP32](https://github.com/bdring/Grbl_Esp32/wiki/Compiling-with-Arduino-IDE#compiling-firmware) documentation, they say we should use the v1.03 version, because the 1.04 and above have a bug. But many versions have been published, and now we have the 2.04 available.

Do you still use 1.03 to compile your precompiled firmwares, or is it now possible with last versions ?

Thank you again.

Spark-Concepts, 2022-08-08:
mathojojo,

The most up-to date source code files have been posted on the [https://github.com/Spark-Concepts/xPro-V5-Firmware](https://github.com/Spark-Concepts/xPro-V5-Firmware). Download the files found [here](https://github.com/Spark-Concepts/xPro-V5-Firmware/tree/main/CNCxPROv5_20220808) into a folder and add as a library to Arduino.

To answer your question use esp32 board libraries version is **v1.03** - as of May 2022 the latest release is still buggy.  My co-engineer at Spark (Mike) prefers to use the Arduino IDE - whereas I prefer PlaformIO & VS Code ([PlatformIO](https://platformio.org/) microcontroller compilation system, coupled with the [Visual Studio Code](https://code.visualstudio.com/) (VSCode) editing system.

That said, use the one you're more familiar with...

Bart has some good resources over on his github page regarding compiling via Arduino-[(here)](https://github.com/bdring/Grbl_Esp32/wiki/Compiling-with-Arduino-IDE) and PlatformIO/VS Code-[(here)](https://github.com/bdring/Grbl_Esp32/wiki/Compiling-with-PlatformIO)

mathojojo, 2022-08-08:
Thank you for everything.

Closed 2022-08-07.

Thread 169 (2022-08-10):

4 axis setup. Changing A axis microsteps affects Z axis.

pjackson5, 2022-08-10:
Hi,
Ive just updated to the latest firmware. Im trying to set up a 4 axis machine.

These are the settings im using when i type $+ -

```
$0=5 (Step pulse time, microseconds)
$1=255 (Step idle delay, milliseconds)
$2=0 (Step pulse invert, mask)
$3=0 (Step direction invert, mask)
$4=0 (Invert step enable pin, boolean)
$5=1 (Invert limit pins, boolean)
$6=1 (Invert probe pin, boolean)
$10=1 (Status report options, mask)
$11=0.010 (Junction deviation, millimeters)
$12=0.002 (Arc tolerance, millimeters)
$13=0 (Report in inches, boolean)
$20=1 (Soft limits enable, boolean)
$21=1 (Hard limits enable, boolean)
$22=1 (Homing cycle enable, boolean)
$23=1 (Homing direction invert, mask)
$24=100.000 (Homing locate feed rate, mm/min)
$25=1000.000 (Homing search seek rate, mm/min)
$26=250.000 (Homing switch debounce delay, milliseconds)
$27=10.000 (Homing switch pull-off distance, millimeters)
$30=24000.000 (Maximum spindle speed, RPM)
$31=0.000 (Minimum spindle speed, RPM)
$32=0 (Laser-mode enable, boolean)
$N1=
$N0=
$33=5000.000
$34=0.000
$35=0.000
$36=100.000
$100=800.000 (X-axis travel resolution, step/mm)
$101=800.000 (Y-axis travel resolution, step/mm)
$102=800.000 (Z-axis travel resolution, step/mm)
$103=5.926
$104=100.000
$105=100.000
$110=3000.000 (X-axis maximum rate, mm/min)
$111=3000.000 (Y-axis maximum rate, mm/min)
$112=3000.000 (Z-axis maximum rate, mm/min)
$113=50.000
$114=1000.000
$115=1000.000
$120=600.000 (X-axis acceleration, mm/sec^2)
$121=600.000 (Y-axis acceleration, mm/sec^2)
$122=600.000 (Z-axis acceleration, mm/sec^2)
$123=600.000
$124=200.000
$125=200.000
$130=120.000 (X-axis maximum travel, millimeters)
$131=181.000 (Y-axis maximum travel, millimeters)
$132=88.000 (Z-axis maximum travel, millimeters)
$133=100000.000
$134=300.000
$135=300.000
$140=1.950
$141=1.950
$142=1.950
$143=1.950
$144=0.800
$145=0.800
$150=1.250
$151=1.250
$152=1.250
$153=1.250
$154=0.400
$155=0.400
$160=32
$161=32
$162=32
$163=32
$164=16
$165=16
$170=16
$171=16
$172=16
$173=16
$174=16
$175=16
```

So I have these loaded. Then i type $163=16 to change the microsteps on the A axis from 32 to 16. Not changing anything on the Z axis, it was already set up correctly.

I reset/turn it on and off again, check that $163 is set to 16

And now my **Z** axis moves twice as far. It moved 10mm before, now it moves 20mm. If all im doing is changing **A** axis microsteps it shouldnt do this right?

Spark-Concepts, 2022-08-13:
Would you mind pasting the link OR providing the name of the 4 axis firmware .bin file you are currently using.

pjackson5, 2022-08-13:
Hi Spark-Concepts, yes I should have specified im using -
CNC_xPRO_V5_XYAZ_NO.bin
Downloaded on the 9th

Spark-Concepts, 2022-08-17:
Pjackson5,

We're currently looking into this, I'll keep you posted

pjackson5, 2022-08-26:
Hi @Spark-Concepts thanks for looking into this. Were you able to reproduce the problem?

Jennywhite2, 2022-08-26:
@pjackson5 sir,you have Facebook or other social media, can you share your 4axis cnc router..🤗🤗

MattChristianNZ, 2022-11-28:
Any updates? I'm having the same problem.

Thread 170 (2022-08-11):

Error stepper fault indicator "Y"

MakarBondInc, 2022-08-11:
Hello, I am have problem with motor driver axis "Y".
When all motors are disconnected from the controller, the axis Y error indicator does not light red. If you connect a motor to any axis X, Y, Y1, or Z of the controller, the error LED of the motor driver on the axis Y lights red.
Diagnostic log:

CNCjs 1.9.26 [Grbl]
Connected to /dev/tty.SLAB_USBtoUART with a baud rate of 115200
ets Jun  8 2016 00:22:57
rst:0x1 (POWERON_RESET),boot:0x13 (SPI_FAST_FLASH_BOOT)
configsip: 0, SPIWP:0xee
clk_drv:0x00,q_drv:0x00,d_drv:0x00,cs0_drv:0x00,hd_drv:0x00,wp_drv:0x00
mode:DIO, clock div:1
load:0x3fff0018,len:4
load:0x3fff001c,len:1216
ho 0 tail 12 room 4
load:0x40078000,len:9720
ho 0 tail 12 room 4
load:0x40080400,len:6352
entry 0x400806b8
[MSG:Grbl_ESP32 Ver 1.3a Date 20220621]
[MSG:Compiled with ESP32 SDK:v3.2.3]
[MSG:Using machine:CNC_xPRO_V5_XYYZ_NC]
[MSG:Axis count 3]
[MSG:RMT Steps]
[MSG:Door switch on pin GPIO(16)]
[MSG:Macro Pin 1 GPIO(13)]
[MSG:Macro Pin 2 GPIO(0)]
[MSG:Init Motors]
[MSG:TMCStepper Library Ver. 0x000701]
[MSG:X  Axis Trinamic TMC5160 Step:GPIO(12) Dir:GPIO(14) CS:GPIO(17) Disable:None Index:1 R:0.050 Limits(-535.000,0.000)]
[MSG:X  Axis Trinamic driver test passed]
[MSG:Y  Axis Trinamic TMC5160 Step:GPIO(27) Dir:GPIO(26) CS:GPIO(17) Disable:None Index:2 R:0.050 Limits(-495.000,0.000)]
[MSG:Y  Axis Trinamic driver test passed]
[MSG:Y2 Axis Trinamic TMC5160 Step:GPIO(33) Dir:GPIO(32) CS:GPIO(17) Disable:None Index:3 R:0.050 Limits(-495.000,0.000)]
[MSG:Y2 Axis Trinamic driver test passed]
[MSG:Z  Axis Trinamic TMC5160 Step:GPIO(15) Dir:GPIO(2) CS:GPIO(17) Disable:None Index:4 R:0.050 Limits(-45.000,0.000)]
[MSG:Z  Axis Trinamic driver test passed]
[MSG:Relay spindle Output:GPIO(25), Enbl:GPIO(4), Dir:None]
[MSG:Local access point CNC_xPRO_V5 started, 192.168.0.1]
[MSG:Captive Portal Started]
[MSG:HTTP Started]
[MSG:TELNET Started 23]
[MSG:Mist coolant on pin GPIO(21)]
[MSG:X  Axis limit switch on pin GPIO(35)]
[MSG:Y  Axis limit switch on pin GPIO(34)]
[MSG:Z  Axis limit switch on pin GPIO(39)]
[MSG:Probe on pin GPIO(22)]
Grbl 1.3a ['$' for help]
client> $$
[MSG:'$H'|'$X' to unlock]
>

Spark-Concepts, 2022-08-13:
Can you paste the diagnostic log when the Y axis LED is illuminating (ONLY Y-axis motor connected) - and with no motors connected (no red lights)… do you ever see a fault indicating on the diagnostic log referencing a fault on the y-axis?

Also, when did this behavior begin... from the get-go or after running for a while?

Closed 2022-11-09.

Thread 171 (2022-08-12):

Stepper enable pin or other way to control a Z axis stepper motor brake

matthewfallshaw, 2022-08-12:
TL;DR: How to energise/disable a stepper motor brake when the Z axis stepper is powered / enabled, and de-energise/enable the brake when the stepper is unpowered / disabled?

Background:
As is probably the case with many others, my spindle is heavy enough that when the Z axis stepper loses power ('cos, for example, I smashed the E-stop button in a state of level 1 terror) my Z axis starts plummeting downwards (initiating level 2 terror, as the still rapidly spinning tool plunges towards my workpiece). Preferring less terror in my life, I'd love to replace my Z axis stepper with a braked stepper motor (something like [this](https://www.aliexpress.com/item/4001208869788.html?spm=a2g0o.order_list.0.0.7302180202LIKg)), and the most sensible way (I think) to control the stepper motor brake would seem to be from a relay connected to the enable pin of the stepper driver (so that if the stepper is enabled and presumed to be offering holding torque to prevent the axis from moving, then the brake should disengage, and if the stepper driver is *dis*abled, then the brake should engage).

My question:
Can anyone help me find the Z axis stepper enable pin on the Xpro V5 board, so that I can use it to drive a relay?
Alternatively, can anyone offer a better way of knowing whether the Z axis stepper is enabled?
… or a better way of otherwise reducing the level 2 terror in my life?

Spark-Concepts, 2022-08-13:
By default the hard wired stepper enable signals (active low) are set to always to remain enabled (check jumper labeled ```1``` in the last image below - this jumper should be set to "e-stop disabled" regardless of NO or NC estop switch configuration). Stepper drivers are enabled when pulled low

Then the stepper behavior is determined by the stepper idle time delay setting:

all you'll need to do to keep all axes always enabled: verify ```$Stepper/IdleTime=255```

Run ```$S``` to check/verify $Stepper/IdleTime setting...

_Every time your steppers complete a motion and come to a stop, Grbl will delay disabling the steppers by the value of $Stepper/IdleTime (Step idle delay, milliseconds) OR, you can always keep your axes enabled (powered so as to hold position) by setting this value to the maximum 255 milliseconds. Again, just to repeat, you can keep all axes always enabled by setting $Stepper/IdleTime=255_

There are effectively two enable methods actively employed on the xProV5 - the **hardware enable** signal on the Trinamic steppers and **serially controlled enable** -the ESP32 controls the Stepper enable along with micro-step and other configuration settings via the SPI serial bus:

Basic control interface schematic for the xPro (ESP32 controller to the Trinamic Stepper motor driver IC's).
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

matthewfallshaw, 2022-08-14:
I have now learned a lot more, and I am very grateful for the detail and the rapid response (thank you!)… and I'm still struggling to work out how to achieve my goal.

There are four situations in which the Z axis needs to be prevented from moving:
1. [SOLVED] When the whole system is powered down (either just powered down, or after interrupting power with an E-stop on the power supply); [if the brake is powered from anything downstream of the power supply then it'll engage when power is lost]
2. [UGLY SOLVED] When I break the E-stop/Door SIG-GND connection with xPro jumper set to "E-Stop Enabled" (only NC firmware scenario considered, because I am not brave (is that the right word? 🧐) enough to rely on an E-Stop that will fail silently if a single connection fails); [I don't know how to detect that this occurred from the xPro, but I could use a double channel E-stop button and run the brake power through it]
3. [UGLY SOLVED] When I break the E-stop/Door SIG-GND connection with xPro jumper set to "E-Stop Disabled" (only NC firmware considered, as above); [either rely on the motor remaining powered and holding in position, or wire E-Stop as above — I'm a little terrified of this scenario because, when I first set up my xPro I set it up this way, and at that time hitting the E-Stop caused the xPro to *finish the current GCODE instruction, **then** stop*… which is very not what I want an E-Stop button to do!! Playing with this yesterday (using [OpenBuilds Control](https://software.openbuilds.com/) instead of CNCjs, in case that's relevant) it seemed like this now achieved the obviously desired outcome of *immediately* stopping all axes and powering down the spindle… but I'm still feeling nervous.]
4. [NOT SOLVED] When I `$SLP` the xPro. [After staring at your schematic for some time I don't see how to logically detect this, so my best idea is something *super* ugly like trying to sense current in the motor wires]

Is there some way (that I've failed to work out from your schematic) that I can read a logic level somewhere to notice that the xPro has been `$SLP`'d?
Is there some way I can have the xPro run an extra script every time it's `$SLP`'d? (And other one every time it resets?)
Any other ideas?

----

If no one has a better idea, perhaps my best bet is the somewhat elaborate plan:
1. Build an [ESPHome](https://www.esphome.io/) device acting as an HTTP endpoint controlled relay for the brake;
2. Use a GCODE sender (like OpenBuilds Control) in which I can implement a macro (in OB Control that'd be a Javascript macro) that will tell my ESPHome device to engage the brake, then send `$SLP` to the xPro… and try to never send a bare `$SLP`;
3. … and keep thinking about how I'm going to make sure the ESPHome device disengages the brake whenever the xPro is reset (like have the GCODE sender notice resets? — no good ideas here yet).
… so, really, that's only half of a plan.

(Again, thank you for all of the detail in your last reply.)

matthewfallshaw, 2022-08-21:
@Spark-Concepts ? Any further help to offer?
(If no further advice, then thank you again for the detail above, and feel free to close this ticket (or I will in a few days).)

Spark-Concepts, 2022-08-25:
Matthew, to be clear there is NO discrete "brake" signal to the stepper motors...

A PWM signal from the xPro's microcontroller commands the TMC5160 driver chips which each drive two H bridge's that control the stepper motors two coils... which in-turn cause the stepper to HOLD (brake) or MOVE (forward or reverse)... by moving the jumper to "e-stop disabled" you are relying on software to stop motion.  I would recommend 1 of 2 solutions:

1. Wire an e-stop button or switch in-line to the outlets powering both the 24V Power Supply and VFD:
    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

and/or

2. Add an anti-backlash nut to your Z axis to prevent it from dropping. ([How to Choose an Anti-Backlash Lead Screw Nut](https://www.helixlinear.com/blog/lead-screws/how-to-choose-an-anti-backlash-lead-screw-nut/))

Thread 172 (2022-08-15):

Settings do not persist

g1kw, 2022-08-15:
I have what appears to be an obscure issue.

Every time I power on my xPro or hit a hard limit or press reset in cncjs, I need to do a little dance of erasing and reapplying my settings for the cnc to work again.

If I do not perform the following steps every time the motors wont engage for any axis.

Step 1 - Send $NVX and $RST
Step 2 - Press reset button on xPro-V5
Step 3 - Apply my configuration through cncjs
Now it will work until power off, hard limit or soft reset in cncjs.

I am hoping I am missing something obvious. Any ideas?

Spark-Concepts, 2022-08-15:
What version of CNCJS are you using? If you are using a more recent version CNCjs, I would suggest rolling back to the most stable version [1.9.22](https://github.com/cncjs/cncjs/releases/tag/v1.9.22)

spydercnc, 2022-08-15:
Use CNC 3D Commander as your sender. It stores the machine settings and a lot easier to set the xPro..

Craig

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

g1kw, 2022-08-17:
I reinstalled cncjs to 1.9.22 and tried again. Same obscure result whereby settings need to erase non-volitile memory and then reset.

I also noted this time that a job ran and I had left the machine, it must have gone in to standby/sleep state, the only way to get it "awake" again was to erase non-volatile memory and reset as above in my original post.

I will try out CNC Commander and verify the result is same or different.

Spark-Concepts, 2022-08-17:
Once you've applied all your settings, please provide the following:
1. Send ```$S``` - copy & paste the entire response
2. Send ```$V``` - also copy & paste the response

g1kw, 2022-08-17:
$S / $V shown below.

I did try CNC Commander as well and same result.

> $S
$Sta/SSID=CNC_xPRO_V5
$Sta/Password=******
$Sta/IPMode=DHCP
$Sta/IP=0.0.0.0
$Sta/Gateway=0.0.0.0
$Sta/Netmask=0.0.0.0
$AP/SSID=CNC_xPRO_V5
$AP/Password=******
$AP/IP=192.168.0.1
$AP/Channel=1
$System/Hostname=CNC_xPRO_V5
$Http/Enable=ON
$Http/Port=80
$Telnet/Enable=ON
$Telnet/Port=23
$Radio/Mode=AP
$Bluetooth/Name=xPRO_V5_BT
$Notification/Type=NONE
$Notification/T1=
$Notification/T2=
$Notification/TS=
$Message/Level=Info
$User/Macro0=
$User/Macro1=
$User/Macro2=
$User/Macro3=
$Homing/Cycle0=Z
$Homing/Cycle1=XY
$Homing/Cycle2=
$Homing/Cycle3=
$Homing/Cycle4=
$Homing/Cycle5=
$Report/StallGuard=
$Stepper/Enable/Delay=0
$Stepper/Direction/Delay=0
$Stepper/Pulse=4
$Stepper/IdleTime=255
$Stepper/StepInvert=
$Stepper/DirInvert=Y
$Stepper/EnableInvert=On
$Limits/Invert=On
$Probe/Invert=On
$Report/Status=1
$GCode/JunctionDeviation=0.010
$GCode/ArcTolerance=0.002
$Report/Inches=Off
$Firmware/Build=
$Limits/Soft=Off
$Limits/Hard=On
$Homing/Enable=On
$Homing/DirInvert=XY
$Homing/Squared=
$Homing/Feed=100.000
$Homing/Seek=1000.000
$Homing/Debounce=250.000
$Homing/Pulloff=10.000
$GCode/MaxS=24000.000
$GCode/MinS=8000.000
$Laser/FullPower=1000
$GCode/LaserMode=Off
$GCode/Line1=
$GCode/Line0=
$Spindle/Enable/Invert=Off
$Spindle/Enable/OffWithSpeed=Off
$Coolant/Delay/TurnOn=1.000
$Spindle/Delay/SpinDown=0.000
$Spindle/Delay/SpinUp=0.000
$Spindle/PWM/Invert=Off
$Spindle/PWM/Frequency=5000.000
$Spindle/PWM/Off=0.000
$Spindle/PWM/Min=0.000
$Spindle/PWM/Max=100.000
$Spindle/Type=PWM
$X/StepsPerMm=200.622
$Y/StepsPerMm=32.272
$Z/StepsPerMm=200.000
$A/StepsPerMm=32.272
$B/StepsPerMm=100.000
$C/StepsPerMm=100.000
$X/MaxRate=2500.000
$Y/MaxRate=2500.000
$Z/MaxRate=2500.000
$A/MaxRate=1000.000
$B/MaxRate=1000.000
$C/MaxRate=1000.000
$X/Acceleration=50.000
$Y/Acceleration=50.000
$Z/Acceleration=50.000<Idle|MPos:-995.065,-35.449,13.800|FS:0,0>
$A/Acceleration=200.000
$B/Acceleration=200.000
$C/Acceleration=200.000
$X/Home/Mpos=0.000
$Y/Home/Mpos=0.000
$Z/Home/Mpos=0.000
$A/Home/Mpos=0.000
$B/Home/Mpos=0.000
$C/Home/Mpos=0.000
$X/MaxTravel=300.000
$Y/MaxTravel=300.000
$Z/MaxTravel=300.000
$A/MaxTravel=300.000
$B/MaxTravel=300.000
$C/MaxTravel=300.000
$X/Current/Run=1.800
$Y/Current/Run=1.800
$Z/Current/Run=1.800
$A/Current/Run=1.800
$B/Current/Run=0.800
$C/Current/Run=0.800
$X/Current/Hold=0.250
$Y/Current/Hold=0.250
$Z/Current/Hold=0.250
$A/Current/Hold=0.250
$B/Current/Hold=0.400
$C/Current/Hold=0.400
$X/Microsteps=8
$Y/Microsteps=8
$Z/Microsteps=8
$A/Microsteps=16
$B/Microsteps=16
$C/Microsteps=16
$X/StallGuard=16
$Y/StallGuard=16
$Z/StallGuard=16
$A/StallGuard=16
$B/StallGuard=16
$C/StallGuard=16
$Errors/Verbose=Off
ok

> $V
[MSG: NVS Used: 225 Free: 405 Total: 630]
ok

Spark-Concepts, 2022-08-17:
You have ```$Limits/Hard=On``` this setting uses the limit switches to "Alarm" and stop the machine in the event of an axis overrun..

If your using the limit switches for homing ```$Limits/Hard=Off```

g1kw, 2022-08-17:
Thanks for that tip. I do not use Homing generally, but I will additionally try this setting.

Would that explain that when in an Alarm state that I need to erase non-volatile, hit the reset switch on the xPro, and then reapply my settings?

Something I also noted whilst testing today is that the motors do not appear to be in their "hold" state (ie there is no slight buzz sound from the motors)  when the power to the xPro is turned on until reset button on the xPro is hit.

Spark-Concepts, 2022-08-17:
With $Limits/Hard=On, the switches are used to stop Grbl if it hits a limit switch. This is a good fail safe setup, but it does an immediate uncontrolled stop and you must rehome before you can use the machine again.

Spark-Concepts, 2022-08-17:
Also, if you haven't already, I would suggest updating with the latest firmware [CNC_xPRO_V5_XYYZ_NO.bin](https://github.com/Spark-Concepts/xPro-V5/blob/main/Firmware/CNC_xPRO_V5_XYYZ_NO.bin)

Also update the webUI... see https://github.com/Spark-Concepts/xPro-V5/issues/166#issuecomment-1207468602

**note: click the green folder icon to update the index.html file**

g1kw, 2022-08-25:
None of the above actually fixed the issue. I just gave up and do my reset dance every time I use the machine. It sucks.

Closed 2022-08-25.

Thread 173 (2022-08-18):

xPro V5 and Huanyang VFD with 0-10V speed control

tomtonia, 2022-08-18:
Hi All,

I'm trying to setup Huanyang spindle control with 0-10V line coming out of the xPro V5 controller.

I had VFD setup for manual control and it worked fine and then I have first followed these instructions
[(https://github.com/Spark-Concepts/xPro-V5/wiki/Front_Panel#toolheadrs485)]
changed
`$Spindle/Type=PWM`
`$GCode/MaxS=24000`
and now between GND and 0-10V on the Toolhead port I get current roughly relating to speed selected so for M3 S24000 it's close to 10v for M3 S12000 ~5V
on the Huanyang VFD I have moved the jumper to the VI position and connected cables coming out of the Toolhead port to the VI(+) and ACM(GND) pins.
Like I said spindle was working fine with manual controls and the only VFD settings I have changed are below
PD001 - 0 (some say to change it to 1 but this requires additional input on FOR pin or bridging FOR and DCM to start the spindle)
PD002 - 1
PD070 - 0 (0-10V)
PD072 - 400 (Higher analog frequency) - my understanding is that this is the speed/frequency relating to max (10V) input
PD073 - 0 (Lower analog frequency) - as above but for 0V input

With all those changes I can control the spindle speed but it never stops. When I send M5 multimeter still reads 0.47V on the xPro Toolhead output which translates to ~1050RPM on the VFD
Basically 0-10V output never drops to 0V
I have already tried using fine tune pot but it doesn't make any difference to M5(OFF) state voltage and it always stays above 0.4V

It there something wrong with my setup or am I missing something?

Any help will be appreciated.

Thanks

ImagineerNL, 2022-08-19:
not sure if you are the same person as on the RatRig Facebook group yesterday where i posted this answer.

I have been struggling with this same issue with my Kress/AMB Digital spindle and managed to fix it for me today.
What you have to do is actually the same as is mentioned in the wiki ([Point 4 regarding PWM](https://github.com/Spark-Concepts/xPro-V5/wiki/Front_Panel#toolheadrs485).)

1. $Spindletype=PWM
2. Make sure the relay jumper inside the box is set to Spindle Enable (not Mist)
3. Wire the 0-10V pinout through the Relay to your 0-10V spindle wire.
4. I have the Kress 10-26V wired directly to the PSU, but with your VFD that might be different)
5. now, whenever you send an M3 Sxxxx command, the relay (Spindle enable) is opened. This ONLY applies when you send a speed as well (grbl safety)
6. When sending M3 S0 the signal wil remain on and the spindle wil keep having the 0.5V which is my lowest. So S0 is actually not zero. (Not sure if it helps when you set spindleMin to 3500 in my case)
7. Sending an M5 command closes the relay(spindle enable). I have this as one of my Macro's.

I will write a more extensive howto on a later time.
This is the only way i can get my AMB Digital spindle working through the xPro; for a VFD the RS485 option might be the best way to go; keeping in mind that for that route the relay is suggested to be used as well as a safety feature.

tomtonia, 2022-08-19:
Thanks for your reply.
No, I'm a different person :-)

Your solution is something I was going to try today after seeing it somewhere else this morning while looking for a solution.
It kinda makes sense to use that relay for enabling/disabling the VFD. I would rather keep it available for something else but this workaround might have to do for now.

This way of connecting VFD is suggested in the documentation but because this is suggestion you would think that your spindle should work without it.

> For SAFETY and unintentional actuation of the spindle when a PWM signal isn't being commanded, it is suggested that you wire the PWM through the relay and move the relay jumper(1) to SP_EN as illustrated below

ImagineerNL, 2022-08-19:
youre welcome.

There might be cases where the minimum voltage is low enough to not power on, but mine takes a minimum of 0.5V to power on, and i get 0.515 :(

Take note of the issue i just opened ( #174 ) when going this route.

Emsand1, 2023-02-04:
I know you said you wanted to avoid RS485 and I'm relatively new to this, but I haven't experienced any spindle related issues using RS485 and my Huanyang 1.5kw water-cooled spindle. It's performed well.

Thread 175 (2022-08-19):

0-10V signal minimum of 0.5V

ImagineerNL, 2022-08-19:
As per title; the 0-10V signal is never 0.
I resolved this by using the relay to enable (M3 Sxxxx) or disable (M5).
However, when issuing an M3 S0 the spindle should actually stop, but it doesnt, as theres still 0.5V remaining. And the relay doesnt shut goes to disable state.

SpindleType=PWM
Spindle used: Kress AMB 1400 FME-P DI digital spindle with a 0-10V steering.
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

If i tune the voltage to below 0.5V with the tuning screw, the 10V is never reached, so this is not workable.

ImagineerNL, 2022-08-19:
basically a copy of #173

Closed 2022-08-19.

Thread 178 (2022-09-14):

XPro-V5 laser still running on S0

Mmmeng20, 2022-09-14:
Hi, recently added a laser to my Queenbee Pro, controlled by the XPro-V5. I'm slowly getting things figured out but am still having problems with the laser not completely turning off with an S0 speed input. The laser is wired through the relay so an M0 or M5 command is the only way to completely turn it off. This is fine for cutting but ruins any engravings. After doing some research on here it seems that S0 will still produce a 0.5V signal, which is what I'm seeing. The laser is a Sculpfun S9 and works perfectly with the gantry/controller it came with. Any suggestions? Thanks!

ImagineerNL, 2022-09-15:
What is the max signal it can have?
The 0-10V is tuneable with a screw inside the controller.
You can tune the output to be about 0.2V, but then you wont be able to reach the 10V, which is useless for a spindle with a full 0.5-10V range, but might be okay for your laser

Mmmeng20, 2022-09-15:
I am using the 0-5V PWM pin. With no load (laser not hooked up) I get an output of (0.5-0.7)-4.71V and (0.35-0.4)-4.71V with the laser hooked up. The output at S0 is pretty unstable, hence the range listed at the low end.

I wasn't sure if adjustment screw changed the 0-5V PWM output at all but I tried it anyway yesterday and found that it didn't change the voltage at all.

I also tested out the controller that came with the laser and it outputs a 1.4mV-4.97V signal

Thread 180 (2022-09-18):

Laser & Huanyang Spindle

Pepoch, 2022-09-18:
I have a CNC router with Xpro-v5 and I'm trying connect a laser module, I still have the spindle working, and I want to add a laser and use one or other just by programming or controlling with cncjs
Does anybody know how to do the wiring and programming ?

Spark-Concepts, 2022-11-09:
Have you had any luck with this?

* Which laser and spindle are you using?
* Your configuration can be established assuming your VFD is connected via rs485 and selected by flipping the PWM/RS485 switch on the side as well as definging the spindle type as ```$spindle/type= huanyang``` or ```$spindle/type=pwm```

I've closed this issue for now, however please feel free to reopen this issue if you still need assistance.

Closed 2022-11-09.

Thread 183 (2022-10-02):

Stepper motors not responding using xPro-V5

JRVDWALT, 2022-10-02:
Hi everyone,

I recently (2 months ago) bought the QueenBee Pro 1000x1000 from Bulkman which included the xPro-V5 controller.
I have managed to set everything up and everything was working like it should. I went on holiday and I reconfigured the speed of the stepper motors (lower) and try to jog the machine, but nothing happens. I have checked all the stepper motors and they are working. I have uninstalled everything and reinstalled but still nothing.

It seems like the motors is not getting power from the controller. The controller switches on and can connect via WIFI or USB.
No red light on the controller so I am a bit stuck. I use CNCjs and here is the configuration below:

$$
$0=4 (Step pulse time, microseconds)
$1=255 (Step idle delay, milliseconds)
$2=0 (Step pulse invert, mask)
$3=1 (Step direction invert, mask)
$4=1 (Invert step enable pin, boolean)
$5=1 (Invert limit pins, boolean)
$6=1 (Invert probe pin, boolean)
$10=1 (Status report options, mask)
$11=0.020 (Junction deviation, millimeters)
$12=0.002 (Arc tolerance, millimeters)
$13=0 (Report in inches, boolean)
$20=0 (Soft limits enable, boolean)
$21=0 (Hard limits enable, boolean)
$22=1 (Homing cycle enable, boolean)
$23=0 (Homing direction invert, mask)
$24=50.000 (Homing locate feed rate, mm/min)
$25=635.000 (Homing search seek rate, mm/min)
$26=250.000 (Homing switch debounce delay, milliseconds)
$27=2.500 (Homing switch pull-off distance, millimeters)
$30=24000.000 (Maximum spindle speed, RPM)
$31=0.000 (Minimum spindle speed, RPM)
$32=0 (Laser-mode enable, boolean)
$100=314.961 (X-axis travel resolution, step/mm)
$101=314.961 (Y-axis travel resolution, step/mm)
$102=314.961 (Z-axis travel resolution, step/mm)
$103=200.000
$104=100.000
$105=100.000
$110=2000.000 (X-axis maximum rate, mm/min)
$111=2000.000 (Y-axis maximum rate, mm/min)
$112=2000.000 (Z-axis maximum rate, mm/min)
$113=1000.000
$114=1000.000
$115=1000.000
$120=150.000 (X-axis acceleration, mm/sec^2)
$121=150.000 (Y-axis acceleration, mm/sec^2)
$122=150.000 (Z-axis acceleration, mm/sec^2)
$123=200.000
$124=200.000
$125=200.000
$130=782.000 (X-axis maximum travel, millimeters)
$131=752.000 (Y-axis maximum travel, millimeters)
$132=300.000 (Z-axis maximum travel, millimeters)
$133=300.000
$134=300.000
$135=300.000
ok

and here is some more

$S
$Sta/SSID=CNC_xPRO_V5
$Sta/Password=******
$Sta/IPMode=DHCP
$Sta/IP=0.0.0.0
$Sta/Gateway=0.0.0.0
$Sta/Netmask=0.0.0.0
$AP/SSID=CNC_xPRO_V5
$AP/Password=******
$AP/IP=192.168.0.1
$AP/Channel=1
$System/Hostname=CNC_xPRO_V5
$Http/Enable=ON
$Http/Port=80
$Telnet/Enable=ON
$Telnet/Port=23
$Radio/Mode=AP
$Bluetooth/Name=xPRO_V5_BT
$Notification/Type=NONE
$Notification/T1=
$Notification/T2=
$Notification/TS=
$Message/Level=Info
$User/Macro0=
$User/Macro1=
$User/Macro2=
$User/Macro3=
$Homing/Cycle0=Z
$Homing/Cycle1=XY
$Homing/Cycle2=
$Homing/Cycle3=
$Homing/Cycle4=
$Homing/Cycle5=
$Report/StallGuard=
$Stepper/Enable/Delay=0
$Stepper/Direction/Delay=0
$Stepper/Pulse=4
$Stepper/IdleTime=255
$Stepper/StepInvert=
$Stepper/DirInvert=X
$Stepper/EnableInvert=On
$Limits/Invert=On
$Probe/Invert=On
$Report/Status=1
$GCode/JunctionDeviation=0.020
$GCode/ArcTolerance=0.002
$Report/Inches=Off
$Firmware/Build=
$Limits/Soft=Off
$Limits/Hard=Off
$Homing/Enable=On
$Homing/DirInvert=
$Homing/Squared=
$Homing/Feed=50.000
$Homing/Seek=635.000
$Homing/Debounce=250.000
$Homing/Pulloff=2.500
$GCode/MaxS=24000.000
$GCode/MinS=0.000
$Laser/FullPower=1000
$GCode/LaserMode=Off
$GCode/Line1=
$GCode/Line0=
$Spindle/Enable/Invert=Off
$Spindle/Enable/OffWithSpeed=Off
$Coolant/Delay/TurnOn=1.000
$Spindle/Delay/SpinDown=0.000
$Spindle/Delay/SpinUp=0.000
$Spindle/PWM/Invert=Off
$Spindle/PWM/Frequency=5000.000
$Spindle/PWM/Off=0.000
$Spindle/PWM/Min=0.000
$Spindle/PWM/Max=100.000
$Spindle/Type=NONE
$X/StepsPerMm=314.961
$Y/StepsPerMm=314.961
$Z/StepsPerMm=314.961
$A/StepsPerMm=200.000
$B/StepsPerMm=100.000
$C/StepsPerMm=100.000
$X/MaxRate=2000.000
$Y/MaxRate=2000.000
$Z/MaxRate=2000.000
$A/MaxRate=1000.000
$B/MaxRate=1000.000
$C/MaxRate=1000.000
$X/Acceleration=150.000
$Y/Acceleration=150.000
$Z/Acceleration=150.000
$A/Acceleration=200.000
$B/Acceleration=200.000
$C/Acceleration=200.000
$X/Home/Mpos=0.000
$Y/Home/Mpos=0.000
$Z/Home/Mpos=0.000
$A/Home/Mpos=0.000
$B/Home/Mpos=0.000
$C/Home/Mpos=0.000
$X/MaxTravel=782.000
$Y/MaxTravel=752.000
$Z/MaxTravel=300.000
$A/MaxTravel=300.000
$B/MaxTravel=300.000
$C/MaxTravel=300.000
$X/Current/Run=1.800
$Y/Current/Run=1.800
$Z/Current/Run=1.800
$A/Current/Run=1.800
$B/Current/Run=0.800
$C/Current/Run=0.800
$X/Current/Hold=0.250
$Y/Current/Hold=0.250
$Z/Current/Hold=0.250
$A/Current/Hold=0.250
$B/Current/Hold=0.400
$C/Current/Hold=0.400
$X/Microsteps=16
$Y/Microsteps=16
$Z/Microsteps=16
$A/Microsteps=16
$B/Microsteps=16
$C/Microsteps=16
$X/StallGuard=16
$Y/StallGuard=16
$Z/StallGuard=16
$A/StallGuard=16
$B/StallGuard=16
$C/StallGuard=16
$Errors/Verbose=Off
ok

I am fairly new to CNC so if it was something simple, I will apologise in advance.
I would appreciate any help thank you

Spark-Concepts, 2022-10-04:
I know this soulds silly, but please confirm you have 24V applied to the xPro and the power switch is (ON); the green power LED should also be illuminated.

If that checks good, connect via USB using CNCjs then press the "Reset" button, and copy & paste the response.

JRVDWALT, 2022-10-04:
Hi Guys,

Thank you for the response. And yes 24v is applied to the xPro :-) with a green power LED

I have done what you asked and pressed the reset button and here is the response:

ets Jun  8 2016 00:22:57
rst:0x1 (POWERON_RESET),boot:0x17 (SPI_FAST_FLASH_BOOT)
configsip: 0, SPIWP:0xee
clk_drv:0x00,q_drv:0x00,d_drv:0x00,cs0_drv:0x00,hd_drv:0x00,wp_drv:0x00
mode:DIO, clock div:1
load:0x3fff0018,len:4
load:0x3fff001c,len:1216
ho 0 tail 12 room 4
load:0x40078000,len:9720
ho 0 tail 12 room 4
load:0x40080400,len:6352
entry 0x400806b8
[MSG:Grbl_ESP32 Ver 1.3a Date 20220621]
[MSG:Compiled with ESP32 SDK:v3.2.3]
[MSG:Using machine:CNC_xPRO_V5_XYYZ_NC]
[MSG:Axis count 3]
[MSG:RMT Steps]
[MSG:Door switch on pin GPIO(16)]
[MSG:Macro Pin 1 GPIO(13)]
[MSG:Macro Pin 2 GPIO(0)]
[MSG:Init Motors]
[MSG:TMCStepper Library Ver. 0x000701]
[MSG:X  Axis Trinamic TMC5160 Step:GPIO(12) Dir:GPIO(14) CS:GPIO(17) Disable:None Index:1 R:0.050 Limits(-782.000,0.000)]
[MSG:X  Axis Trinamic driver test passed]
[MSG:Y  Axis Trinamic TMC5160 Step:GPIO(27) Dir:GPIO(26) CS:GPIO(17) Disable:None Index:2 R:0.050 Limits(-752.000,0.000)]
[MSG:Y  Axis Trinamic driver test passed]
[MSG:Y2 Axis Trinamic TMC5160 Step:GPIO(33) Dir:GPIO(32) CS:GPIO(17) Disable:None Index:3 R:0.050 Limits(-752.000,0.000)]
[MSG:Y2 Axis Trinamic driver test passed]
[MSG:Z  Axis Trinamic TMC5160 Step:GPIO(15) Dir:GPIO(2) CS:GPIO(17) Disable:None Index:4 R:0.050 Limits(-300.000,0.000)]
[MSG:Z  Axis Trinamic driver test passed]
[MSG:Initializing RS485 VFD spindle]
[MSG:Using Auto-RTS]
[MSG:VFD RS485  Tx:GPIO(4) Rx:GPIO(25) RTS:None]
[MSG:Local access point CNC_xPRO_V5 started, 192.168.0.1]
[MSG:Captive Portal Started]
[MSG:HTTP Started]
[MSG:TELNET Started 23]
[MSG:Mist coolant on pin GPIO(21)]
[MSG:X  Axis limit switch on pin GPIO(35)]
[MSG:Y  Axis limit switch on pin GPIO(34)]
[MSG:Z  Axis limit switch on pin GPIO(39)]
[MSG:Probe on pin GPIO(22)]
Grbl 1.3a ['$' for help]
client> $$
[MSG:'$H'|'$X' to unlock]
$0=10 (Step pulse time, microseconds)
$1=255 (Step idle delay, milliseconds)
$2=0 (Step pulse invert, mask)
$3=1 (Step direction invert, mask)
$4=1 (Invert step enable pin, boolean)
$5=1 (Invert limit pins, boolean)
$6=1 (Invert probe pin, boolean)
$10=1 (Status report options, mask)
$11=0.020 (Junction deviation, millimeters)
$12=0.002 (Arc tolerance, millimeters)
$13=0 (Report in inches, boolean)
$20=0 (Soft limits enable, boolean)
$21=0 (Hard limits enable, boolean)
$22=1 (Homing cycle enable, boolean)
$23=0 (Homing direction invert, mask)
$24=50.000 (Homing locate feed rate, mm/min)
$25=635.000 (Homing search seek rate, mm/min)
$26=250.000 (Homing switch debounce delay, milliseconds)
$27=2.500 (Homing switch pull-off distance, millimeters)
$30=24000.000 (Maximum spindle speed, RPM)
$31=8000.000 (Minimum spindle speed, RPM)
$32=0 (Laser-mode enable, boolean)
$100=314.961 (X-axis travel resolution, step/mm)
$101=314.961 (Y-axis travel resolution, step/mm)
$102=314.961 (Z-axis travel resolution, step/mm)
$103=200.000
$104=100.000
$105=100.000
$110=2000.000 (X-axis maximum rate, mm/min)
$111=2000.000 (Y-axis maximum rate, mm/min)
$112=2000.000 (Z-axis maximum rate, mm/min)
$113=1000.000
$114=1000.000
$115=1000.000
$120=150.000 (X-axis acceleration, mm/sec^2)
$121=150.000 (Y-axis acceleration, mm/sec^2)
$122=150.000 (Z-axis acceleration, mm/sec^2)
$123=200.000
$124=200.000
$125=200.000
$130=782.000 (X-axis maximum travel, millimeters)
$131=752.000 (Y-axis maximum travel, millimeters)
$132=300.000 (Z-axis maximum travel, millimeters)
$133=300.000
$134=300.000
$135=300.000
ok
[MSG:Spindle RS485 Unresponsive 8]

I was troubleshooting and tried to connect the VFD Huang Yang last night to see if CNCjs will allow it to Spin but with no result.

Thank you again for your time and looking forward to hear back from the team.

Spark-Concepts, 2022-11-09:
We're you able to resolve your issue?... and yes, since the RS485 (spindle) is unresponsive the machine will be in a constant alarm state... RS485 operation

1. Have you updated to the latest firmware?
2. In addition you'll need to confirm your VFD is properly configured: https://github.com/Spark-Concepts/xPro-V5/issues/60

I've closed this issue, however please feel free to reopen if you're still having troubles

Closed 2022-11-09.

Thread 184 (2022-10-04):

Xpro V5 stops at 25% and says job complete

Todderbod, 2022-10-04:
Xpro v5 When I run my Gcode that I used aspire to make it get right around 25% and says job complete. The spindle is still running but is says job complete. This is only the second project I have tried the first one completed with no problem. This is a bigger file I'm not sure if that is the issue any help would be greatly appreciated

Spark-Concepts, 2022-10-04:
Are you saving the job file to the xPro's SD card via the WebUI? If so, please download the cut file to your PC and compare it to the original file (ensure it didn't get corrupted during the transfer). Please let me know what you find.

Todderbod, 2022-10-06:
The file is exactly the same . I would really like to figure this out it sucks spending this kind of money to have a paper weight

Spark-Concepts, 2022-10-07:
Todderbod,

Please post your settings and build information here (```$S``` and ```$I```). Also, what are you using to generate your .NC gcode cut files as this is most often the culprit?

Also, cnc3d commander is not a sender maintained by Spark-Concepts. I would ask that you attempt to run the job via the native xProV5 web-ui(wi-fi) and/or via CNCjs(USB) and monitor for similar issues (unplug the stepper outputs connectors while running the gcode file)?

For additional troubleshooting please use the contact-us link found here at www.spark-concepts.com
...from here we can evaluate your gcode, and monitor the job on our test rig and provide you feedback (findings and solutions)

spydercnc, 2022-10-09:
Wow, I find the comment about CNC3D quite astounding to say the least. It may not be supported by SC but then again neither are many many of its clients/buyers. At least CNC3D do try (usually successfully)  to support people with the ongoing problems with the xPro 5, especially in regards to getting it to talk to a VFD.
I am still waiting for a response from yourselves about a problem with my unit, where updating the firmware on the the Xpro, basically bricked my machine. The Webui, is at best pretty useless and it takes multiple attempt to connect to it -again still waiting for help with that from months ago.

Todderbod, 2022-10-10:
Spydercnc Does cnc3d have a firmware for the xpro5 that works better.  I think my whole problem is noise interference. Im going to redo all my setup and see what happens my controller is pretty close to my vfd. If I redo everything and I still have these problems I guess I'm going to try a new controller. Im rather new to cnc and getting pretty frustrated. I made a whole new gcode with aspire and ran it through cncjs now it stops spindle keeps going and computer still says its moving but its not. I watched a video that said a surge protector would work. Well guess what not for me same issue. Thats why Im going to redo my wiring job and get the vfd as far away from the xpro as I can.

spydercnc, 2022-10-11:
No it is just sender software, but was easier to reload an older version of firmware for the VFD, that worked.

Spark-Concepts, 2022-10-11:
@spyder - I was simply stating that we do not test and confirm compatibility with commander.   That's all,  we test and confirm CNCjs so that is what's suggest for troubleshooting to eliminate variables.   Have you submitted a support form on your unit (link to contact us page)

Closed 2022-11-09.

Thread 185 (2022-10-09):

Y Stepper Output Malfunctioning

Emsand1, 2022-10-09:
CNC xPro_v5 recently purchased. Set up and was running fine with several projects completed. Was homing the machine before my next job and the Y stepper motor locked up. It sounded like it was fighting itself.
Ton of troubleshooting including:
1.	Checking and swapping new wire leads.
2.	Checked belt tension.
3.	Checked extrusion for debris, damage.
4.	Disassembled motor/pulleys/wheels/brackets.
5.	Swapped motor with known working motor.
6.	Re-flashed XYYZ NO firmware.
7.	Swapped Y & A (y2) motor connections at box for testing the pair and each separately.

Any motor run from the Y connection port did the same locking. The replacement Y motor worked fine on A/y2 connection port but not Y connection port. I tested out with a multi-meter, but I think I read that isn’t accurate. Either way, It looked like A/y2 output was 24v on one phase and 4-5 volts on the other. Y connection had 24v & .9 volts. I tested with the leads connected to the box, motors unhooked, and running Y jogging of 700mm.

No fault indicator lit up and it didn't prompt an alarm.

$Sta/SSID=Sandel
$Sta/Password=******
$Sta/IPMode=Static
$Sta/IP=192.168.68.59
$Sta/Gateway=192.168.68.1
$Sta/Netmask=255.255.254.0
$AP/SSID=CNC_xPRO_V5
$AP/Password=******
$AP/IP=192.168.0.1
$AP/Channel=1
$System/Hostname=CNC_xPRO_V5
$Http/Enable=ON
$Http/Port=80
$Telnet/Enable=ON
$Telnet/Port=23
$Radio/Mode=STA
$Bluetooth/Name=xPRO_V5_BT
$Notification/Type=NONE
$Notification/T1=
$Notification/T2=
$Notification/TS=
$Message/Level=Info
$User/Macro0=
$User/Macro1=
$User/Macro2=
$User/Macro3=
$Homing/Cycle0=Z
$Homing/Cycle1=XY
$Homing/Cycle2=
$Homing/Cycle3=
$Homing/Cycle4=
$Homing/Cycle5=
$Report/StallGuard=
$Stepper/Enable/Delay=0
$Stepper/Direction/Delay=0
$Stepper/Pulse=10
$Stepper/IdleTime=255
$Stepper/StepInvert=
$Stepper/DirInvert=
$Stepper/EnableInvert=Off
$Limits/Invert=Off
$Probe/Invert=On
$Report/Status=1
$GCode/JunctionDeviation=0.010
$GCode/ArcTolerance=0.002
$Report/Inches=Off
$Firmware/Build=
$Limits/Soft=Off
$Limits/Hard=On
$Homing/Enable=On
$Homing/DirInvert=XY
$Homing/Squared=
$Homing/Feed=100.000
$Homing/Seek=1000.000
$Homing/Debounce=250.000
$Homing/Pulloff=4.000
$GCode/MaxS=24000.000
$GCode/MinS=0.000
$Laser/FullPower=1000
$GCode/LaserMode=Off
$GCode/Line1=
$GCode/Line0=
$Spindle/Enable/Invert=Off
$Spindle/Enable/OffWithSpeed=Off
$Coolant/Delay/TurnOn=1.000
$Spindle/Delay/SpinDown=0.000
$Spindle/Delay/SpinUp=0.000
$Spindle/PWM/Invert=Off
$Spindle/PWM/Frequency=5000.000
$Spindle/PWM/Off=0.000
$Spindle/PWM/Min=0.000
$Spindle/PWM/Max=100.000
$Spindle/Type=NONE
$X/StepsPerMm=80.000
$Y/StepsPerMm=80.000
$Z/StepsPerMm=320.000
$A/StepsPerMm=80.000
$B/StepsPerMm=80.000
$C/StepsPerMm=80.000
$X/MaxRate=2000.000
$Y/MaxRate=2000.000
$Z/MaxRate=2000.000
$A/MaxRate=2000.000
$B/MaxRate=2000.000
$C/MaxRate=2000.000
$X/Acceleration=300.000
$Y/Acceleration=300.000
$Z/Acceleration=300.000
$A/Acceleration=300.000
$B/Acceleration=300.000
$C/Acceleration=300.000
$X/Home/Mpos=0.000
$Y/Home/Mpos=0.000
$Z/Home/Mpos=0.000
$A/Home/Mpos=0.000
$B/Home/Mpos=0.000
$C/Home/Mpos=0.000
$X/MaxTravel=780.000
$Y/MaxTravel=775.000
$Z/MaxTravel=65.000
$A/MaxTravel=775.000
$B/MaxTravel=300.000
$C/MaxTravel=300.000
$X/Current/Run=2.500
$Y/Current/Run=2.500
$Z/Current/Run=2.800
$A/Current/Run=2.500
$B/Current/Run=0.800
$C/Current/Run=0.800
$X/Current/Hold=0.500
$Y/Current/Hold=0.500
$Z/Current/Hold=0.500
$A/Current/Hold=0.500
$B/Current/Hold=0.400
$C/Current/Hold=0.400
$X/Microsteps=16
$Y/Microsteps=16
$Z/Microsteps=16
$A/Microsteps=16
$B/Microsteps=16
$C/Microsteps=16
$X/StallGuard=16
$Y/StallGuard=16
$Z/StallGuard=16
$A/StallGuard=16
$B/StallGuard=16
$C/StallGuard=16
$Errors/Verbose=Off

$$
$0=10
$1=255
$2=0
$3=0
$4=0
$5=0
$6=1
$10=1
$11=0.010
$12=0.002
$13=0
$20=0
$21=1
$22=1
$23=3
$24=100.000
$25=1000.000
$26=250.000
$27=4.000
$30=24000.000
$31=0.000
$32=0
$100=80.000
$101=80.000
$102=320.000
$103=80.000
$104=80.000
$105=80.000
$110=2000.000
$111=2000.000
$112=2000.000
$113=2000.000
$114=2000.000
$115=2000.000
$120=300.000
$121=300.000
$122=300.000
$123=300.000
$124=300.000
$125=300.000
$130=780.000
$131=775.000
$132=65.000
$133=775.000
$134=300.000
$135=300.000

markcagatandavis, 2022-10-22:
I have the exact same problem! I got a complete unit replacement because of this issue. I ran a job for 4 min on the replacement unit and it occurred again. Y-axis port only...

I had a sparky check all the wiring and nothing should be shorting out. Reading through forums, this is apparently really common with xPro v5. What's the go? Can this be fixed, or is the port fried and need a replacement unit?

markcagatandavis, 2022-10-22:
ets Jun  8 2016 00:22:57
rst:0x1 (POWERON_RESET),boot:0x13 (SPI_FAST_FLASH_BOOT)
configsip: 0, SPIWP:0xee
clk_drv:0x00,q_drv:0x00,d_drv:0x00,cs0_drv:0x00,hd_drv:0x00,wp_drv:0x00
mode:DIO, clock div:1
load:0x3fff0018,len:4
load:0x3fff001c,len:1216
ho 0 tail 12 room 4
load:0x40078000,len:9720
ho 0 tail 12 room 4
load:0x40080400,len:6352
entry 0x400806b8
[MSG:Grbl_ESP32 Ver 1.3a Date 20220621]
[MSG:Compiled with ESP32 SDK:v3.2.3]
[MSG:Using machine:CNC_xPRO_V5_XYYZ_NC]
[MSG:Axis count 3]
[MSG:RMT Steps]
[MSG:Door switch on pin GPIO(16)]
[MSG:Macro Pin 1 GPIO(13)]
[MSG:Macro Pin 2 GPIO(0)]
[MSG:Init Motors]
[MSG:TMCStepper Library Ver. 0x000701]
[MSG:X  Axis Trinamic TMC5160 Step:GPIO(12) Dir:GPIO(14) CS:GPIO(17) Disable:None Index:1 R:0.050 Limits(-780.000,0.000)]
[MSG:X  Axis Trinamic driver test passed]
[MSG:Y  Axis Trinamic TMC5160 Step:GPIO(27) Dir:GPIO(26) CS:GPIO(17) Disable:None Index:2 R:0.050 Limits(0.000,780.000)]
[MSG:Y  Axis Trinamic driver test passed]
[MSG:Y2 Axis Trinamic TMC5160 Step:GPIO(33) Dir:GPIO(32) CS:GPIO(17) Disable:None Index:3 R:0.050 Limits(0.000,780.000)]
[MSG:Y2 Axis Trinamic driver test passed]
[MSG:Z  Axis Trinamic TMC5160 Step:GPIO(15) Dir:GPIO(2) CS:GPIO(17) Disable:None Index:4 R:0.050 Limits(-110.000,0.000)]
[MSG:Z  Axis Trinamic driver test passed]
[MSG:PWM spindle Output:GPIO(25), Enbl:GPIO(4), Dir:None, Freq:5000Hz, Res:13bits]
[MSG:Client Started]
[MSG:Connecting Enter The Muktrix_2.GHz]
[MSG:Connecting.]
[MSG:Connecting..]
[MSG:Connecting...]
[MSG:Connected with 192.168.20.155]
[MSG:Connected with 192.168.20.155]
[MSG:Start mDNS with hostname:http://CNC_xPRO_V5.local/]
[MSG:SSDP Started]
[MSG:HTTP Started]
[MSG:TELNET Started 23]
[MSG:Mist coolant on pin GPIO(21)]
[MSG:X  Axis limit switch on pin GPIO(35)]
[MSG:Y  Axis limit switch on pin GPIO(34)]
[MSG:Z  Axis limit switch on pin GPIO(39)]
[MSG:Probe on pin GPIO(22)]
Grbl 1.3a ['$' for help]
[MSG:'$H'|'$X' to unlock]
>

markcagatandavis, 2022-10-24:
Do they respond to this?

Spark-Concepts, 2022-11-09:
Please use the contact us link found here & we'll take care of this issue: https://www.spark-concepts.com/contact-us-1/

Closed 2022-11-09.

Thread 186 (2022-10-28):

Limit switch leds always on

Ynitial, 2022-10-28:
I can't get my Openbuilds limit switches to work. The leds are always on and nothing happens when I trigger them manually. I've tried the different `$Limits/Invert` settings but that doesn't change anything. If I'm correct, the limit switch logic jumper should be on 5V.

These are my settings. Does anyone have any advice?

```
$0=4 (Step pulse time, microseconds)
$1=255 (Step idle delay, milliseconds)
$2=0 (Step pulse invert, mask)
$3=0 (Step direction invert, mask)
$4=0 (Invert step enable pin, boolean)
$5=0 (Invert limit pins, boolean)
$6=1 (Invert probe pin, boolean)
$10=1 (Status report options, mask)
$11=0.010 (Junction deviation, millimeters)
$12=0.002 (Arc tolerance, millimeters)
$13=0 (Report in inches, boolean)
$20=0 (Soft limits enable, boolean)
$21=0 (Hard limits enable, boolean)
$22=0 (Homing cycle enable, boolean)
$23=3 (Homing direction invert, mask)
$24=200.000 (Homing locate feed rate, mm/min)
$25=2000.000 (Homing search seek rate, mm/min)
$26=250.000 (Homing switch debounce delay, milliseconds)
$27=2.500 (Homing switch pull-off distance, millimeters)
$30=24000.000 (Maximum spindle speed, RPM)
$31=0.000 (Minimum spindle speed, RPM)
$32=0 (Laser-mode enable, boolean)
$100=200.000 (X-axis travel resolution, step/mm)
$101=200.000 (Y-axis travel resolution, step/mm)
$102=200.000 (Z-axis travel resolution, step/mm)
$103=200.000
$104=100.000
$105=100.000
$110=2500.000 (X-axis maximum rate, mm/min)
$111=2500.000 (Y-axis maximum rate, mm/min)
$112=2500.000 (Z-axis maximum rate, mm/min)
$113=1000.000
$114=1000.000
$115=1000.000
$120=50.000 (X-axis acceleration, mm/sec^2)
$121=50.000 (Y-axis acceleration, mm/sec^2)
$122=50.000 (Z-axis acceleration, mm/sec^2)
$123=200.000
$124=200.000
$125=200.000
$130=300.000 (X-axis maximum travel, millimeters)
$131=300.000 (Y-axis maximum travel, millimeters)
$132=300.000 (Z-axis maximum travel, millimeters)
$133=300.000
$134=300.000
$135=300.000
```

ImagineerNL, 2022-10-28:
You havent enabled softlimits: $20=1
Also, on my setup (ratrig killerbee) the homing direction invert mask $21=1

```
$0=4  ;  Step pulse time, microseconds
$1=255  ;  Step idle delay, milliseconds
$2=0  ;  Step pulse invert, mask
$3=2  ;  Step direction invert, mask
$4=0  ;  Invert step enable pin, boolean
$5=1  ;  Invert limit pins, boolean/mask
$6=1  ;  Invert probe pin, boolean
$10=1  ;  Status report options, mask
$11=0.010  ;  Junction deviation, millimeters
$12=0.002  ;  Arc tolerance, millimeters
$13=0  ;  Report in inches, boolean
$20=1  ;  Soft limits enable, boolean
$21=0  ;  Hard limits enable, boolean
$22=1  ;  Homing cycle enable, boolean
$23=1  ;  Homing direction invert, mask
$24=100.000  ;  Homing locate feed rate, mm/min
$25=1000.000  ;  Homing search seek rate, mm/min
$26=250.000  ;  Homing switch debounce delay, milliseconds
$27=5.000  ;  Homing switch pull-off distance, millimeters
$30=25000.000  ;  Maximum spindle speed, RPM
$31=300.000  ;  Minimum spindle speed, RPM
$32=0  ;  Laser-mode enable, boolean
$100=200.000  ;  X-axis steps per millimeter
$101=200.000  ;  Y-axis steps per millimeter
$102=200.000  ;  Z-axis steps per millimeter
$103=200.000  ;  unknown
$104=100.000  ;  unknown
$105=100.000  ;  unknown
$110=2600.000  ;  X-axis maximum rate, mm/min
$111=2400.000  ;  Y-axis maximum rate, mm/min
$112=1500.000  ;  Z-axis maximum rate, mm/min
$113=2400.000  ;  unknown
$114=1000.000  ;  unknown
$115=1000.000  ;  unknown
$120=200.000  ;  X-axis acceleration, mm/sec^2
$121=200.000  ;  Y-axis acceleration, mm/sec^2
$122=200.000  ;  Z-axis acceleration, mm/sec^2
$123=200.000  ;  unknown
$124=200.000  ;  unknown
$125=200.000  ;  unknown
$130=530.000  ;  X-axis maximum travel, millimeters
$131=740.000  ;  Y-axis maximum travel, millimeters
$132=120.000  ;  Z-axis maximum travel, millimeters
$133=740.000  ;  unknown
$134=300.000  ;  unknown
$135=300.000  ;  unknown
```

Ynitial, 2022-11-03:
I managed to solve it through PB with @ImagineerNL, thanks! Was nothing software related. I mirrored all emergency switch cables by accident. When I connected them correctly, the issue was gone.

Closed 2022-11-03.

Thread 187 (2022-11-05):

XPro V5 stuck in a boot loop when trying to connect to a Raspberry Pi Zero 2

synman, 2022-11-05:
I am the developer of an Octoprint plugin that provides a fully functional GRBL emulation / support layer for it (https://github.com/synman/Octoprint-Bettergrblsupport/wiki).

I suspect there is something between the XPro V5 and Rasbian (Octoprint typically runs on a Raspberry Pi) that is triggering the XPro to enter a boot loop upon USB connection to the Pi.

After a bit of controlled rebooting... tends require the XPro to be rebooted / power toggled and then the pi rebooted afterwards, I'm able to (painfully) get a connection reestablished.

One thing I noticed is SPI_FAST_FLASH_BOOT showing up in the boot loop log output (shown below).  Is it possible the XPro is getting put into a bootloader mode?   If so, is there a jumper or something via software I can configure on it to not allow it to enter the bootloader and proceed with a clean boot?

Any help is greatly appreciated.  I can provide whatever further details you require to assist with resolution.

```
Recv: <Idle|MPos:-5.000,-5.000,-5.000|FS:0,0|WCO:-405.000,-405.000,-55.000>
Recv: ok
Connection closed, closing down monitor
Changing monitoring state from "Operational" to "Offline"
Changing monitoring state from "Offline" to "Opening serial connection"
Connecting to port /dev/ttyUSB0, baudrate 115200
Changing monitoring state from "Opening serial connection" to "Connecting"
Connected to: Serial<id=0x69c4ab30, open=True>(port='/dev/ttyUSB0', baudrate=115200, bytesize=8, parity='N', stopbits=1, timeout=10.0, xonxoff=False, rtscts=False, dsrdtr=False), starting monitor
Send:

 ?
Send:

 ?
Recv: )
Recv: configsip: 0, SPIWP:0xee
Recv: clk_dòets Jun  8 2016 00:22:57
Recv:
Recv: rst:0x1 (POWERON_RESET),boot:0x17 (SPI_FAST_FLASH_BOOT)
Recv: configsip: 0, SPIWP:0xee
Recv: clk_drv:0x00,q_drv:0x00,d_drv:0x00,cs0_drv:0x00,hd_drv:0x00,wp_drv:0x00
Recv: mode:DIO, clock div:1
Recv: load:0x3fff0018,len:4
Recv: load:0x3fff001c,len:1216
Recv: ho 0 tail 12 room 4
Recv: load:0x40078000,len:9720
Recv: ho 0 tail 12 room 4
Recv: load:0x40080400,len:6352
Recv: entry 0x400806b8
Recv:
Recv: [MSG:Grbl_ESP32 Ver 1.3a Date 20220621]
Recv: [MSG:Compiled with ESP32 SDK:v3.2.3]
Recv: [MSG:Using machine:CNC_xPRO_V5_XYYZ_NC]
Send: ?
Send: ?
Send: ?
Recv: [MSG:Axis count 3]
Send: ?
Recv: [MSG:RMT Steps]
Send: ?
Recv: [MSG:Door switch on pin GPIO(16)]
Send: ?
Recv: [MSG:Macro Pin 1 GPIO(13)]
Send: ?
Recv: [MSG:Macro Pin 2 GPIO(0)]
Send: ?
Recv: [MSG:Init Motors]
Send: ?
Recv: <Idle|MPos:0.000,0.000,0.000|FS:0,0|Pn:XYZ|WCO:0.000,0.000,0.000>
Recv: Guru Meditation Error: Core  1 panic'ed (LoadProhibited). Exception was unhandled.
Recv: Core 1 register dump:
Recv: PC      : 0x400da9ee  PS      : 0x00060430  A0      : 0x800db033  A1      : 0x3ffd5820
Recv: A2      : 0x00000000  A3      : 0x3ffc6fd4  A4      : 0x00000009  A5      : 0x3ffd5980
Recv: A6      : 0x3ffcaee4  A7      : 0x00000003  A8      : 0x800da9e9  A9      : 0x3ffd5800
Recv: A10     : 0x00000000  A11     : 0x3ffd583c  A12     : 0x000000a0  A13     : 0x00000000
Recv: A14     : 0x00000000  A15     : 0x00000003  SAR     : 0x00000016  EXCCAUSE: 0x0000001c
Recv: EXCVADDR: 0x00000000  LBEG    : 0x400014fd  LEND    : 0x4000150d  LCOUNT  : 0xffffffff
Recv:
Recv: Backtrace: 0x400da9ee:0x3ffd5820 0x400db030:0x3ffd59a0 0x400db2aa:0x3ffd59c0 0x4008faad:0x3ffd59e0
Recv:
Recv: Rebooting...
Recv: ets Jun  8 2016 00:22:57
Recv:
Recv: rst:0xc (SW_CPU_RESET),boot:0x17 (SPI_FAST_FLASH_BOOT)
Recv: configsip: 0, SPIWP:0xee
Recv: clk_drv:0x00,q_drv:0x00,d_drv:0x00,cs0_drv:0x00,hd_drv:0x00,wp_drv:0x00
Recv: mode:DIO, clock div:1
Recv: load:0x3fff0018,len:4
Recv: load:0x3fff001c,len:1216
Recv: ho 0 tail 12 room 4
Recv: load:0x40078000,len:9720
Recv: ho 0 tail 12 room 4
Recv: load:0x40080400,len:6352
Recv: entry 0x400806b8
Recv:
Recv: [MSG:Grbl_ESP32 Ver 1.3a Date 20220621]
Send: ?
Recv: [MSG:Compiled with ESP32 SDK:v3.2.3]
Send: ?
Recv: [MSG:Using machine:CNC_xPRO_V5_XYYZ_NC]
Send: ?
Recv: [MSG:Axis count 3]
Send: ?
Recv: [MSG:RMT Steps]
Send: ?
Recv: [MSG:Door switch on pin GPIO(16)]
Send: ?
Recv: [MSG:Macro Pin 1 GPIO(13)]
Send: ?
Recv: [MSG:Macro Pin 2 GPIO(0)]
Send: ?
Recv: [MSG:Init Motors]
Send: ?
Recv: <Idle|MPos:0.000,0.000,0.000|FS:0,0|Pn:XYZ|WCO:0.000,0.000,0.000>
Recv: [MSG:TMCStepper Library Ver. 0x000701]
Recv: [MSG:X  Axis TrinGuru Meditation Error: Core  1 panic'ed (LoadProhibited). Exception was unhandled.
Recv: Core 1 register dump:
Recv: PC      : 0x400da9ee  PS      : 0x00060430  A0      : 0x800db033  A1      : 0x3ffd5820
Recv: A2      : 0x00000000  A3      : 0x3ffc6fd4  A4      : 0x00000009  A5      : 0x3ffd5980
Recv: A6      : 0x3ffcaee4  A7      : 0x00000003  A8      : 0x800da9e9  A9      : 0x3ffd5800
Recv: A10     : 0x00000000  A11     : 0x3ffd583c  A12     : 0x000000a0  A13     : 0x00000000
Recv: A14     : 0x00000000  A15     : 0x00000003  SAR     : 0x00000016  EXCCAUSE: 0x0000001c
Recv: EXCVADDR: 0x00000000  LBEG    : 0x400014fd  LEND    : 0x4000150d  LCOUNT  : 0xffffffff
Recv:
Recv: Backtrace: 0x400da9ee:0x3ffd5820 0x400db030:0x3ffd59a0 0x400db2aa:0x3ffd59c0 0x4008faad:0x3ffd59e0
Recv:
Recv: Rebooting...
```

synman, 2022-11-05:
https://docs.espressif.com/projects/esp-idf/en/latest/esp32/api-guides/fatal-errors.html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

Guessing this doesn't have anything to do with an attempted bootloader mode.  Maybe RTS/CTS flow control?   I did read something about reboots being triggered to enable hardware flow control.

Odd too... EXCVADDR: 0x00000000  is a weird address to be reading.  My guess is there's something going sideways above this execution wise.

synman, 2022-11-08:
Bueller?

Spark-Concepts, 2022-11-09:
Sunman,

This it could possibly be a flow control issue.
The xPro uses the CP2102 UART bridge. I'm assuming you've installed the arropriate drivers?

The esp module shouldn't be going into bootloader mode - GPIO 0 is only asserted Low when the recessed switch on the side if the xPro is physically depressed.

I'll have to do some experimentation & let you know.

If it turns out to be a flow control issue - we may be able to tweak some setting on the CU2102 uart bridge itself

 some experimentation

synman, 2022-11-09:
Thanks for the update.  It's my understanding the CP2110 drivers are baked into the kernel.  All reports indicate it just works.

The pi is enumerating the port just fine as far as I can tell.

Will need some pointers if there is something to tweak on the XPro V5 side of this.

synman, 2022-11-28:
I think we can close this, although I learned quite a bit in the process.

The first thing I do when connecting is issue a soft reset (/x18) as a means of handshaking.  The XPro V5 then sends its flood of startup messages (I think the key piece here is initializing the TMC stepper driver).

If I immediately start querying the machine (?), it panics and reboots.

What I found is if I sleep for a second after sending that initial handshake before sending anything else, the XPro has enough time to initialize the TMC driver and things go smoothly.

Why do I think it is the TMC driver?  Very simple.  If I try to connect to XPro with the main 24V power line to the XPro powered off, I do not experience the kernel panic reboot loop -- but the TMC Driver initialization fails.

That was fun.

synman, 2022-11-28:
Here's what my comm log looks like now:

```
Changing monitoring state from "Offline" to "Opening serial connection"
Connecting to port /dev/ttyUSB0, baudrate 115200
Changing monitoring state from "Opening serial connection" to "Connecting"
Connected to: Serial<id=0x7f702a2a30, open=True>(port='/dev/ttyUSB0', baudrate=115200, bytesize=8, parity='N', stopbits=1, timeout=10.0, xonxoff=False, rtscts=False, dsrdtr=False), starting monitor
Send:

\x18
Recv: ,d_drv:0x00,cs0_drv:0x00,hd_drv:0x00,wøets Jun  8 2016 00:22:57
Recv:
Recv: rst:0x1 (POWERON_RESET),boot:0x17 (SPI_FAST_FLASH_BOOT)
Recv: configsip: 0, SPIWP:0xee
Recv: clk_drv:0x00,q_drv:0x00,d_drv:0x00,cs0_drv:0x00,hd_drv:0x00,wp_drv:0x00
Recv: mode:DIO, clock div:1
Recv: load:0x3fff0018,len:4
Recv: load:0x3fff001c,len:1044
Recv: load:0x40078000,len:10124
Recv: load:0x40080400,len:5856
Recv: entry 0x400806a8
Recv:
Recv: [MSG:Grbl_ESP32 Ver 1.3a Date 20221127]
Recv: [MSG:Compiled with ESP32 SDK:v4.4.2]
Recv: [MSG:Using machine:CNC_xPRO_V5_XYYZ_NC]
Recv: [MSG:Axis count 3]
Recv: [MSG:RMT Steps]
Recv: [MSG:Door switch on pin GPIO(16)]
Recv: [MSG:Macro Pin 1 GPIO(13)]
Recv: [MSG:Macro Pin 2 GPIO(0)]
Recv: [MSG:Init Motors]
Recv: [MSG:TMCStepper Library Ver. 0x000703]
Recv: [MSG:X  Axis Trinamic TMC5160 Step:GPIO(12) Dir:GPIO(14) CS:GPIO(17) Disable:None Index:1 R:0.050 Limits(-505.000,0.000)]
Recv: [MSG:X  Axis Trinamic driver test passed]
Recv: [MSG:Y  Axis Trinamic TMC5160 Step:GPIO(27) Dir:GPIO(26) CS:GPIO(17) Disable:None Index:2 R:0.050 Limits(-505.000,0.000)]
Recv: [MSG:Y  Axis Trinamic driver test passed]
Recv: [MSG:Y2 Axis Trinamic TMC5160 Step:GPIO(33) Dir:GPIO(32) CS:GPIO(17) Disable:None Index:3 R:0.050 Limits(-505.000,0.000)]
Recv: [MSG:Y2 Axis Trinamic driver test passed]
Recv: [MSG:Z  Axis Trinamic TMC5160 Step:GPIO(15) Dir:GPIO(2) CS:GPIO(17) Disable:None Index:4 R:0.050 Limits(-105.000,0.000)]
Recv: [MSG:Z  Axis Trinamic driver test passed]
Recv: [MSG:Initializing RS485 VFD spindle]
Recv: [MSG:Using Auto-RTS]
Recv: [MSG:VFD RS485  Tx:GPIO(4) Rx:GPIO(25) RTS:None]
Recv:
Recv: [MSG:Client Started]
Recv: [MSG:Connecting SHELLWLAN]
Recv: [MSG:Connecting.]
Recv: [MSG:VFD: VFD settings read: RPM Range(0, 24000)]]
Recv: [MSG:Connecting..]
Recv: [MSG:Connected with 10.151.51.23]
Recv: [MSG:Start mDNS with hostname:http://CNC_xPRO_V5.local/]
Recv: [MSG:SSDP Started]
Recv: [MSG:HTTP Started]
Recv: [MSG:TELNET Started 23]
Recv: [MSG:Mist coolant on pin GPIO(21)]
Recv: [MSG:X  Axis limit switch on pin GPIO(35)]
Recv: [MSG:Y  Axis limit switch on pin GPIO(34)]
Recv: [MSG:Z  Axis limit switch on pin GPIO(39)]
Recv: [MSG:Probe on pin GPIO(22)]
Recv:
Recv: Grbl 1.3a ['$' for help]
Changing monitoring state from "Connecting" to "Operational"
Recv: [MSG:'$H'|'$X' to unlock]
Send: $+
Recv: $0=4
Recv: $1=255
Recv: $2=0
Recv: $3=3
Recv: $4=0
Recv: $5=1
Recv: $6=1
Recv: $10=1
Recv: $11=0.010
Recv: $12=0.002
Recv: $13=0
Recv: $20=1
Recv: $21=0
Recv: $22=1
Recv: $23=0
Recv: $24=200.000
Recv: $25=2000.000
Recv: $26=1000.000
Recv: $27=5.000
Recv: $30=24000.000
Recv: $31=0.000
Recv: $32=0
Recv: $N1=
Recv: $N0=
Recv: $33=5000.000
Recv: $34=0.000
Recv: $35=0.000
Recv: $36=100.000
Recv: $100=200.000
Recv: $101=200.000
Recv: $102=200.000
Recv: $103=200.000
Recv: $104=100.000
Recv: $105=100.000
Recv: $110=3000.000
Recv: $111=3000.000
Recv: $112=450.000
Recv: $113=1000.000
Recv: $114=1000.000
Recv: $115=1000.000
Recv: $120=300.000
Recv: $121=300.000
Recv: $122=300.000
Recv: $123=200.000
Recv: $124=200.000
Recv: $125=200.000
Recv: $130=505.000
Recv: $131=505.000
Recv: $132=105.000
Recv: $133=300.000
Recv: $134=300.000
Recv: $135=300.000
Recv: $140=2.121
Recv: $141=2.121
Recv: $142=2.121
Recv: $143=1.800
Recv: $144=0.800
Recv: $145=0.800
Recv: $150=1.000
Recv: $151=1.000
Recv: $152=1.000
Recv: $153=0.250
Recv: $154=0.400
Recv: $155=0.400
Recv: $160=8
Recv: $161=8
Recv: $162=8
Recv: $163=16
Recv: $164=16
Recv: $165=16
Recv: $170=16
Recv: $171=16
Recv: $172=16
Recv: $173=16
Recv: $174=16
Recv: $175=16
Recv: ok
Send: ?
```

synman, 2022-12-07:
Appears to be the same issue being reported by others.

Happened while doing my first real job.

See here for more details (I made a video): https://github.com/Spark-Concepts/xPro-V5/issues/194#issuecomment-1340426029

Please help!

Shell

Closed 2022-11-29.

Thread 192 (2022-11-10):

Undefined VFD_RS485_RTS_PIN

Rakishaa, 2022-11-10:
Hope you are well .

I have the issue connecting xpro V5 with vfd hy02d223b .
Have separated RS cable from rest of the cables to avoid interference .
Spindle can be controlled manually but not via RS485 port.
Would be grateful for any kind of advice.
Many thanks .

Settings on VFD:
pd1=2
pd2=2
pd5=400
pd163=1
pd164=1
pd165=3

rst:0x1 (POWERON_RESET),boot:0x17 (SPI_FAST_FLASH_BOOT)
configsip: 0, SPIWP:0xee
clk_drv:0x00,q_drv:0x00,d_drv:0x00,cs0_drv:0x00,hd_drv:0x00,wp_drv:0x00
mode:DIO, clock div:1
load:0x3fff0018,len:4
load:0x3fff001c,len:1216
ho 0 tail 12 room 4
load:0x40078000,len:9720
ho 0 tail 12 room 4
load:0x40080400,len:6352
entry 0x400806b8
[MSG:Grbl_ESP32 Ver 1.3a Date 20201212]
[MSG:Compiled with ESP32 SDK:v3.2.3-14-gd3e562907]
[MSG:Using machine:CNC_xPRO_V5_XYYZ_RS485_NO]
[MSG:Axis count 3]
[MSG:RMT Steps]
[MSG:Init Motors]
[MSG:TMCStepper Library Ver. 0x000701]
[MSG:X  Axis Trinamic TMC5160 Step:GPIO(12) Dir:GPIO(14) CS:GPIO(17) Disable:None Index:1 R:0.050 Limits(0.000,740.000)]
[MSG:X  Axis Trinamic driver test passed]
[MSG:Y  Axis Trinamic TMC5160 Step:GPIO(27) Dir:GPIO(26) CS:GPIO(17) Disable:None Index:2 R:0.050 Limits(0.000,1240.000)]
[MSG:Y  Axis Trinamic driver test passed]
[MSG:Y2 Axis Trinamic TMC5160 Step:GPIO(33) Dir:GPIO(32) CS:GPIO(17) Disable:None Index:3 R:0.050 Limits(0.000,1240.000)]
[MSG:Y2 Axis Trinamic driver test passed]
[MSG:Z  Axis Trinamic TMC5160 Step:GPIO(15) Dir:GPIO(2) CS:GPIO(17) Disable:None Index:4 R:0.050 Limits(-100.000,0.000)]
[MSG:Z  Axis Trinamic driver test passed]
[MSG:Initializing RS485 VFD spindle]
[MSG:Undefined VFD_RS485_RTS_PIN]
[MSG:VFD RS485  Tx:GPIO(4) Rx:GPIO(25) RTS:GPIO(0)]
[MSG:Spindle RS485 Unresponsive 8]
[MSG:Critical Spindle RS485 Unresponsive]
[MSG:Local access point CNC_xPRO_V5 started, 192.168.0.1]
[MSG:Captive Portal Started]
[MSG:HTTP Started]
[MSG:TELNET Started 23]
[MSG:Flood coolant on pin GPIO(21)]
[MSG:Mist coolant on pin GPIO(21)]
[MSG:X  Axis limit switch on pin GPIO(35)]
[MSG:Y  Axis limit switch on pin GPIO(34)]
[MSG:Z  Axis limit switch on pin GPIO(39)]
[MSG:Probe on pin GPIO(22)]
Grbl 1.3a ['$' for help]
[MSG:Check limits]
[MSG:'$H'|'$X' to unlock]
> $$
$0=4 (Step pulse time, microseconds)
$1=25 (Step idle delay, milliseconds)
$2=0 (Step pulse invert, mask)
$3=0 (Step direction invert, mask)
$4=0 (Invert step enable pin, boolean)
$5=0 (Invert limit pins, boolean)
$6=1 (Invert probe pin, boolean)
$10=1 (Status report options, mask)
$11=0.010 (Junction deviation, millimeters)
$12=0.002 (Arc tolerance, millimeters)
$13=0 (Report in inches, boolean)
$20=0 (Soft limits enable, boolean)
$21=1 (Hard limits enable, boolean)
$22=0 (Homing cycle enable, boolean)
$23=3 (Homing direction invert, mask)
$24=200.000 (Homing locate feed rate, mm/min)
$25=500.000 (Homing search seek rate, mm/min)
$26=250.000 (Homing switch debounce delay, milliseconds)
$27=2.500 (Homing switch pull-off distance, millimeters)
$30=24000.000 (Maximum spindle speed, RPM)
$31=24000.000 (Minimum spindle speed, RPM)
$32=0 (Laser-mode enable, boolean)
$N1=
$N0=
$100=402.000 (X-axis travel resolution, step/mm)
$101=400.000 (Y-axis travel resolution, step/mm)
$102=200.580 (Z-axis travel resolution, step/mm)
$103=200.000
$104=100.000
$105=100.000
$110=4000.000 (X-axis maximum rate, mm/min)
$111=4000.000 (Y-axis maximum rate, mm/min)
$112=2500.000 (Z-axis maximum rate, mm/min)
$113=1000.000
$114=1000.000
$115=1000.000
$120=300.000 (X-axis acceleration, mm/sec^2)
$121=300.000 (Y-axis acceleration, mm/sec^2)
$122=100.000 (Z-axis acceleration, mm/sec^2)
$123=200.000
$124=200.000
$125=200.000
$130=740.000 (X-axis maximum travel, millimeters)
$131=1240.000 (Y-axis maximum travel, millimeters)
$132=100.000 (Z-axis maximum travel, millimeters)
$133=300.000
$134=300.000
$135=300.000
ok
>

FlyerLife22, 2022-11-11:
Share some pictures of your wiring?  The wiring on the HY manual is backwards for the RS+ and RS- , follow the ones here.

What lights are blinking under the PWM - RS485 switch?  Red is xPRO talking,  Green is VFD talking

The undefined RTS is ok, this controller uses an auto-RTS control.

Spark-Concepts, 2022-11-12:
Rakishaa,

The first things first... let's do a few things:
- Update your [firmware](https://github.com/Spark-Concepts/xPro-V5/tree/main/Firmware) to [CNC_xPRO_V5_XYYZ_NO.bin](https://github.com/Spark-Concepts/xPro-V5/blob/main/Firmware/CNC_xPRO_V5_XYYZ_NO.bin)
- Once updated, set the spindle type _(spindle type will have been set to "none" after update)_ - in the command window send the following: ```$Spindle/Type=HUANYANG``` if that doesn't work, try ```$Spindle/Type=H2A```
- Ensure RS485 wiring is less than 1 meter in length, twisted, and connected properly (resistors are optional)
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
- Verify the **PWM-RS485** switch<sub>(1)</sub> is set to **RS485**
- Verify both the red and green LED's below the PWM-RS485 switch are flashing periodically
- Verify your VFD is configured properly using the procedure in the [Huanyang-VFD-manual](https://github.com/Spark-Concepts/xPro-V5/files/6247012/Huanyang-VFD-manual.pdf) _PLEASE REFER TO THE MANUAL SPECIFIC TO YOUR MODEL VFD; not all VFD's are the same despite the name on it_

Set the following register values via the VFD touchpad (should be the same on most VFD's - VERIFY ON YOUR SPECIFIC MODEL VFD):
| Register  | Value | Description |
| :-------: | :-----: | ------------- |
 | PD000 | 0 | **unlock parameters** |
 | PD001 | 2 | **Command source is RS485** |
 | PD002 | 2 | **Speed source is RS485** |
 | PD163 | 1 | **Communications address 1** |
 | PD164 | 1 | **9600 b/s** |
 | PD165 | 3 | **8 Bit No Parity - RTU** |
 | PD000 | 1 | **lock parameters** |

 _Also check the following settings (these will setting will vary based on the values indicated on the motor's nameplate and your mains voltage 110VAC vs 220VAC)_

| Register  | Description |
| :-------: | ----- |
| PD004 | **Base frequency as listed on spindle** _(typically 400)_ |
| PD005 | **Maximum frequency Hz** _(typical value for spindles is 400)_ |
| PD011 | **Min speed** _(recommended air-cooled=120 water=100)_ |
| PD014 | **Acceleration time** _(test to optimize)_ |
| PD015 | **Deceleration time** _(test to optimize)_ |
| PD023 | **Reverse run enabled** _(set to 1)_ |
| PD141 | **Spindle max rated voltage** _(typically 220)_ |
| PD142 | **Max rated motor current** _(0.8kw=3.7, 1.5kw=7.0, 2.2kw=??)_ |
| PD143 | **Motor poles** _(typically 2 or 4)_ |
| PD144 | **Rated motor revolution at 50Hz** _(typically 3000 @ 50Hz and 24000 @ 400Hz)_ |

- If you're still believe your having issues and trying to narrow down ground loop or issues otherwise (partial messages received etc..), load the following RS485 debug firmware: [CNC_xPRO_V5_XYYZ_NO_485_debug.bin](https://github.com/Spark-Concepts/xPro-V5/blob/main/Firmware/CNC_xPRO_V5_XYYZ_NO_485_debug.bin)
  - The RS485 Debug bin file is for debugging VFD RS-485 communication issues and requires USB connection and CNCJS or USB serial sender program
  - this firmware assumes/requires a NO (normally open) e-stop (unplug estop button after debug firmware is loaded)
  - Once connected to the X-Pro using CNCJS will echo commands sent to and from the VFD via RS-485
  - The terminal window will display messages from the X-Pro as Tx:....... and messages recieved from the VFD as Rx:........

In some rare cases where VFD noise is particularly severe (typically only encountered with VFD's on 220V mains); you may need to install an RS485 isolator - see https://github.com/Spark-Concepts/xPro-V5/issues/164#issuecomment-1219037733
   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

cdo1955, 2023-03-08:
I followed the above step with the RS 485 amplifier and still had intermittent issues controlling the spindle.
Until I put the Spindle controller in an metal electrical box and grounded the exterior of the box. The box has a slot opening
in the bottom I left open for air flow. Everything works now for the first time. The box is listed below.
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

Yolvan, 2023-03-30:
Herewith my setup with the twisted wire and the RS485 isolation module (see attached photos). Also attached are screenshots of the errors when I try and run the spindle with the M3 command. The spindle does not start from the current setup.
Please advise what to do next.

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

Thread 193 (2022-11-22):

spindle rs485 unresponsive 8

ghalib1399, 2022-11-22:
Hi all
when I send file to run, its working for 1 minute then spindle stop moving but the head still running! with (spindle rs485 unresponsive 8) message.
I press pause then I press run againe , its moving  again then stop ...

can any one help me ?

Spark-Concepts, 2022-11-23:
This is typically a noise issue via the VFD:
- Ensure RS485 wiring is less than 1 meter in length, twisted, and connected properly (resistors are likely needed in your case)
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

In cases where VFD noise is particularly severe (typically only encountered with VFD's on 220V mains); you may need to install an RS485 isolator - see https://github.com/Spark-Concepts/xPro-V5/issues/164#issuecomment-1219037733
   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

ghalib1399, 2022-11-23:
Thank you for your help. my problem was from usb cable connecting laptop to  xPro-V5.

Spark-Concepts, 2022-11-24:
Gotcha, I'm glad you got it working!

Closed 2022-11-24.

Thread 194 (2022-11-25):

Y axis faulty

danatomy, 2022-11-25:
Seems to be a recurring issue but posting here again as I'm not getting any repsonse from Sparks.

Just been testing my newly built Queenbee pro.

The Y axis doesn't seem to function properly on my controller. Stepper makes a loud crunching noise and doesn't turn on properly therefore jamming the machine as the Y2 axis does work.

I have ruled the stepper being faulty as I have plugged it into another port and it works perfectly. Any stepper that is plugged into this port does them same thing.

I have checked all the wiring and thats fine. There is no fault light on. Updated the firmware too.

I'm at a loss as what to do. Having trsted and read previous issues, I can't really see that it can be anything other than a fault with the controller.

I would really appreciate a reponse from Spark concepts on this.

Sly75012, 2022-11-26:
I have the same issue, pls help to solve!

laufla, 2022-11-26:
Hi,
i had the same problem a few weeks after i received my box.

My contact at Spark was Mike  : ***@***.***

Le ven. 25 nov. 2022 à 15:19, danatomy ***@***.***> a écrit :

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

Deneteus, 2022-11-28:
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

Typically if the firmware settings for the axis are right if there is a loud grinding noise on only one axis then that means the stepper driver was damaged. Unplugging a stepper in the midst of it running will do that and so will moving an axis manually while a stepper is still plugged in. Always test each stepper on a known good axis. Its hard to kill a stepper but very easy to kill a driver.

danatomy, 2022-11-28:
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

I didnt do either of these things.

ImagineerNL, 2022-12-03:
I have had this exact issue and had contact with Mike as well, through the above contact.

It MIGHT have something to do with issue #121 which is still unfixed ; What was your Current/Run set to?

Ynitial, 2022-12-03:
I'm currently finishing my build and found out my controller shows the same defect. I switched the stepper motors to double check that if the fault is in the controller and not the stepper motors. Used yellow and blue tape for clarity: https://photos.app.goo.gl/dnYzhLRggw9JCcms7

@ImagineerNL, my current/hold = 1.1 and current/run = 1.8, exactly as default by Spark wiki.

danatomy, 2022-12-04:
I'm now in contact with Mike. My current/run is the same, 1.8. Will see if we can resolve it.

synman, 2022-12-07:
Wouldn't ya know it, the exact same thing just happened to me, while in the middle of a job!

https://user-images.githubusercontent.com/1299716/206103446-869d8390-040a-41f7-93aa-ed9cae5a58fd.mp4

deviousdexter-original, 2022-12-08:
Hi - i have the same issue on a Ultimate Bee and am not getting anything from Mike after the initial response. Has anyone had any updates or resolutions to this matter?
many thanks

synman, 2022-12-08:
I emailed them (@Spark-Concepts ) at the same time I posted here -- and have not heard back from them (him).

I screwed up on my initial email which is why you see the completely unrelated issue tagged here.

I've also reached out to Bulkman 3D as they were the reseller.  They asked I wait for Spark to respond and if I don't hear back to let them know.

ImagineerNL, 2022-12-08:
I have mailed Ratrig Sales in the beginning of October with this issue; They directed me to @Spark-Concepts to speed up the issue-finding.
After some back and forth I have received a new controller.
I have had some follow-up questions (e.g. 'what can I do to make sure this doesnt happen again?' and some other github-issue related questions), but it has been a radio silence since then, even after multiple requests.

Currently my new controller works flawless (and seemingly even better, but that can also be due to a lot of tweaking and tuning of the gantries while trying to pinpoint the issue).
I'm just hoping my current controller doesnt bug on me again.

synman, 2022-12-08:
Tagging other occurrences of this (I stopped after page #2):

#185
#152
#147
#146
#144
#140
#139
#133
#127

MikeDMFC, 2022-12-19:
Same fault. Brand new. Y axis port started stalling, really great for twisting rails this is. Waiting response. I cant trust this xpro v5.

synman, 2022-12-22:
I have yet to hear a word from Spark and am in contact with Bulkman3d to see if I can get a replacement through them.

synman, 2022-12-22:
now I feel bad.   I had a box from Spark Concepts waiting for me in my mailbox tonight.

MikeDMFC, 2022-12-22:
> now I feel bad. I had a box from Spark Concepts waiting for me in my mailbox tonight.

Give it a good hard test run and let me know, i am sceptical of the reliability, on a dual axis it can be so damaging. I am waiting bulkman's managers response on mine

synman, 2022-12-22:
yeah.. that's part of my problem.  I am already running a different controller and am not in a hurry to reproduce the crash that happened on my Y axis when the xpro v5 gave up the ghost.

I may use it on a much smaller scale laser rig I run.

I also grabbed one of these:  https://github.com/zapta/simple_stepper_motor_analyzer

so I'm whole again, at least no worse than I was when all this started.  And I have a means to monitor current coming out of this thing now too.

Too bad it bit me and I went else where.  I was really excited about this controller when I first saw it.

Spark-Concepts, 2023-01-11:
This issue has been resolved - in the meantime, if you are having this issue please use the contact-us link found [here](https://www.spark-concepts.com/contact-us-1/)

Please note we are currently in the process of completely restructuring our support team and engineering staff to make many much needed improvements in order to drastically improve customer support and response.

synman, 2023-01-11:
What was done to actually resolve this issue?  I understand replacement units have been provided, but what was root cause and is this something we still have to watch out for?

I have zero trust in this controller right now.  Any info you can provide regarding the underlying issue would be greatly appreciated.  I do not see a new firmware or anything like that available so I'm kinda at a loss as to what was done to fix it.

Ynitial, 2023-01-13:
> What was done to actually resolve this issue?  I understand replacement units have been provided, but what was root cause and is this something we still have to watch out for?
>
> I have zero trust in this controller right now.  Any info you can provide regarding the underlying issue would be greatly appreciated.  I do not see a new firmware or anything like that available so I'm kinda at a loss as to what was done to fix it.

For me, it was fixed by moving to a Blackbox X32.

RatRig (reseller) sent my email address to Spark Concepts weeks ago, which Spark asked because they apparently wanted to talk to me about this issue. Haven't heard from them at all.

Glad I moved to something else! This lack of communication and response to issues bothers me a lot. Even if they are in the dark with this: just let people know what's happening!

Closed 2023-01-11.

Thread 197 (2022-12-16):

xPro V5 - Lost Connection

Yotapower, 2022-12-16:
Hi all,

I have a workbee cnc that I originally purchased with an NVUM controller, I was having issues with it and opted to switch to an xPro when it was released. I've had it about a 9 months, set it up and confirmed it was working but haven't used the machine very much until recently. I ran a profile cut to surface my spoilboard the other day and had no issues at all. Last night I ran a pocketing toolpath with no issue, but when I went to run the next toolpath, the spindle started but would not continue with the rest of the path. I wasn't able to pause or shut off the spindle, even with the E-stop.

I was never able to get the wifi to connect to it and use the WebUI, so I just use the USB cable.

I'm not able to zero my work coordinates or jog the machine, it's like it's not even connected. I tried upgrading to the latest version of CNCJS, restarting everything and even a new usb cable. When it locked up initially, I was getting messages about RS485 unresponsive.

Right after it happened when I loaded up CNCJS, I get the following in the command window:

CNCjs 1.9.27 [Grbl]
Connected to COM4 with a baud rate of 115200
ets Jun  8 2016 00:22:57
rst:0x1 (POWERON_RESET),boot:0x17 (SPI_FAST_FLASH_BOOT)
configsip: 0, SPIWP:0xee
clk_drv:0x00,q_drv:0x00,d_drv:0x00,cs0_drv:0x00,hd_drv:0x00,wp_drv:0x00
mode:DIO, clock div:1
load:0x3fff0018,len:4
load:0x3fff001c,len:1216
ho 0 tail 12 room 4
load:0x40078000,len:9720
ho 0 tail 12 room 4
load:0x40080400,len:6352
entry 0x400806b8
[MSG:Grbl_ESP32 Ver 1.3a Date 20210816]
[MSG:Compiled with ESP32 SDK:v3.2.3-14-gd3e562907]
[MSG:Using machine:CNC_xPRO_V5_XYYZ_NC]
[MSG:Axis count 3]
[MSG:RMT Steps]
[MSG:Door switch on pin GPIO(16)]
[MSG:Macro Pin 1 GPIO(13)]
[MSG:Macro Pin 2 GPIO(0)]
[MSG:Init Motors]
[MSG:TMCStepper Library Ver. 0x000703]
[MSG:X  Axis Trinamic TMC5160 Step:GPIO(12) Dir:GPIO(14) CS:GPIO(17) Disable:None Index:1 R:0.050 Limits(-1290.000,0.000)]
[MSG:X  Axis Trinamic driver test passed]
[MSG:Y  Axis Trinamic TMC5160 Step:GPIO(27) Dir:GPIO(26) CS:GPIO(17) Disable:None Index:2 R:0.050 Limits(-1290.000,0.000)]
[MSG:Y  Axis Trinamic driver test passed]
[MSG:Y2 Axis Trinamic TMC5160 Step:GPIO(33) Dir:GPIO(32) CS:GPIO(17) Disable:None Index:3 R:0.050 Limits(-1290.000,0.000)]
[MSG:Y2 Axis Trinamic driver test passed]
[MSG:Z  Axis Trinamic TMC5160 Step:GPIO(15) Dir:GPIO(2) CS:GPIO(17) Disable:None Index:4 R:0.050 Limits(-92.000,0.000)]
[MSG:Z  Axis Trinamic driver test passed]
[MSG:Initializing RS485 VFD spindle]
[MSG:Auto-RTS in use]
[MSG:VFD RS485  Tx:GPIO(4) Rx:GPIO(25) RTS:None]
[MSG:Client Started]
[MSG:Connecting TP-Link_A9A2]
[MSG:Connecting.]
[MSG:Connecting..]
[MSG:VFD: VFD settings read: RPM Range(7999, 24000)]]
[MSG:Connecting...]
[MSG:Connected with 192.168.0.174]
[MSG:Start mDNS with hostname:http://CNC_xPRO_V5.local/]
[MSG:SSDP Started]
[MSG:HTTP Started]
[MSG:TELNET Started 23]
[MSG:Mist coolant on pin GPIO(21)]
[MSG:X  Axis limit switch on pin GPIO(35)]
[MSG:Y  Axis limit switch on pin GPIO(34)]
[MSG:Z  Axis limit switch on pin GPIO(39)]
[MSG:Probe on pin GPIO(22)]
Grbl 1.3a ['$' for help]
client> $$
[MSG:'$H'|'$X' to unlock]
client> $X
client>
client> $X

When I tried to updated CNCJS, I just downloaded the newest version and ran the .exe file while I was connected to the xPro via USB. Am I not doing this correctly?

Now when I open CNCJS, it will not automatically connect. When I try selecting COM4 (Silicon Labs) from the port list, nothing happens. There is no blue light on on the xPro.

I'm desperately trying to finish up some Christmas presents on my machine and this has really thrown a wrench in my plans. I have reached out to Mike @ Spark Concepts but figured I would also post here while waiting to hear back from him.

Any assistance is greatly appreciated, thanks in advance!

synman, 2022-12-23:
I don't see anything wrong here.  Those messages are the standard startup messages the xPro spits out when you connect to it via USB and/or restart it.

As a matter of fact, the xPro is connecting just fine to your TP-Link_A9A2 access point / wireless router and is assigned the ip address 192.168.0.174.

You should be able to access it on our local network as http://192.168.0.174

If your computer supports mDNS (Windows w/ apple drivers installed, all Macs) it should be as simple as connecting to http://CNC_xPRO_V5.local

Beyond that, I'm seeing all of the stepper drivers initialize fine and your VFD's RS485 connection looks good too.

You are definitely going about connecting to the xPro V5 w/ CNCjs correctly.  It only supports USB connections.

After connecting successfully with CNCjs, have you tried hitting the red reset button?  Often times CNCjs needs a grbl reset to start polling the connected machine.

Yotapower, 2022-12-23:
Unfortunately, I can no longer get those start up messages to come up. It's set to start up automatically, but now nothing happens when I open CNCjs and when I select silicon labs from the com port drop down nothing happens.

I have never actually been able to use the wireless connection, I can't remember the specifics of it as I gave up trying.

I have tried rebooting, resetting, unlocking and pressing the e-stop button many times in various combinations with no improvement.

Thanks for the assistance, I got a response from Mike @ spark concepts today but no resolution. Hopefully he can figure something out.

SylvainBD, 2023-04-05:
Hello @Yotapower
I have a similar problem with my xprov5 card. Not possible to connect it. Did you find an issue ?
Thanks for answer

Yotapower, 2023-04-05:
@SylvainBD No, I never figured it out. I purchased a OpenBuilds X32 to replace it and haven't had any issues since.
I did find that +/- power terminals going into the box were all melted even though I was using 16ga wiring from the power supply, I'm guessing something shorted internally, I will be sending the box back to Spark Concepts for inspection and hopefully a refund. Generally pretty disappointing.

Thread 207 (2023-04-11):

Cannot Get Spindle To Turn On with RS485 and VFD

Volks1, 2023-04-11:
Hello,

I am having an issue with getting the spindle to turn on with M3 S8000 command via the X-Pro Controller. I can get it to run fine in manual mode off the VFD, but I get this error message when I send the command:

CNCjs 1.9.22 [Grbl]
Connected to COM3 with a baud rate of 115200
ets Jun  8 2016 00:22:57
rst:0x1 (POWERON_RESET),boot:0x17 (SPI_FAST_FLASH_BOOT)
configsip: 0, SPIWP:0xee
clk_drv:0x00,q_drv:0x00,d_drv:0x00,cs0_drv:0x00,hd_drv:0x00,wp_drv:0x00
mode:DIO, clock div:1
load:0x3fff0018,len:4
load:0x3fff001c,len:1216
ho 0 tail 12 room 4
load:0x40078000,len:9720
ho 0 tail 12 room 4
load:0x40080400,len:6352
entry 0x400806b8
[MSG:Grbl_ESP32 Ver 1.3a Date 20220621]
[MSG:Compiled with ESP32 SDK:v3.2.3]
[MSG:Using machine:CNC_xPRO_V5_XYYZ_NC]
[MSG:Axis count 3]
[MSG:RMT Steps]
[MSG:Door switch on pin GPIO(16)]
[MSG:Macro Pin 1 GPIO(13)]
[MSG:Macro Pin 2 GPIO(0)]
[MSG:Init Motors]
[MSG:TMCStepper Library Ver. 0x000701]
[MSG:X  Axis Trinamic TMC5160 Step:GPIO(12) Dir:GPIO(14) CS:GPIO(17) Disable:None Index:1 R:0.050 Limits(0.000,740.000)]
[MSG:X  Axis Trinamic driver test passed]
[MSG:Y  Axis Trinamic TMC5160 Step:GPIO(27) Dir:GPIO(26) CS:GPIO(17) Disable:None Index:2 R:0.050 Limits(0.000,740.000)]
[MSG:Y  Axis Trinamic driver test passed]
[MSG:Y2 Axis Trinamic TMC5160 Step:GPIO(33) Dir:GPIO(32) CS:GPIO(17) Disable:None Index:3 R:0.050 Limits(0.000,740.000)]
[MSG:Y2 Axis Trinamic driver test passed]
[MSG:Z  Axis Trinamic TMC5160 Step:GPIO(15) Dir:GPIO(2) CS:GPIO(17) Disable:None Index:4 R:0.050 Limits(-80.000,0.000)]
[MSG:Z  Axis Trinamic driver test passed]
[MSG:Initializing RS485 VFD spindle]
[MSG:Using Auto-RTS]
[MSG:VFD RS485  Tx:GPIO(4) Rx:GPIO(25) RTS:None]
[MSG:Client Started]
[MSG:Connecting FiOS-TJQMJ]
[MSG:Connecting.]
[MSG:Connecting..]
[MSG:Connected with 192.168.1.232]
[MSG:Start mDNS with hostname:http://cnc_xpro_v5.local/]
[MSG:SSDP Started]
[MSG:HTTP Started]
[MSG:TELNET Started 23]
[MSG:Mist coolant on pin GPIO(21)]
[MSG:X  Axis limit switch on pin GPIO(35)]
[MSG:Y  Axis limit switch on pin GPIO(34)]
[MSG:Z  Axis limit switch on pin GPIO(39)]
[MSG:Probe on pin GPIO(22)]
Grbl 1.3a ['$' for help]
client> $$
[MSG:'$H'|'$X' to unlock]
$0=4 (Step pulse time, microseconds)
$1=255 (Step idle delay, milliseconds)
$2=0 (Step pulse invert, mask)
$3=1 (Step direction invert, mask)
$4=0 (Invert step enable pin, boolean)
$5=1 (Invert limit pins, boolean)
$6=1 (Invert probe pin, boolean)
$10=1 (Status report options, mask)
$11=0.010 (Junction deviation, millimeters)
$12=0.002 (Arc tolerance, millimeters)
$13=0 (Report in inches, boolean)
$20=0 (Soft limits enable, boolean)
$21=0 (Hard limits enable, boolean)
$22=1 (Homing cycle enable, boolean)
$23=3 (Homing direction invert, mask)
$24=2000.000 (Homing locate feed rate, mm/min)
$25=2000.000 (Homing search seek rate, mm/min)
$26=250.000 (Homing switch debounce delay, milliseconds)
$27=5.000 (Homing switch pull-off distance, millimeters)
$30=24000.000 (Maximum spindle speed, RPM)
$31=8000.000 (Minimum spindle speed, RPM)
$32=0 (Laser-mode enable, boolean)
$100=400.000 (X-axis travel resolution, step/mm)
$101=400.000 (Y-axis travel resolution, step/mm)
$102=400.000 (Z-axis travel resolution, step/mm)
$103=400.000
$104=100.000
$105=100.000
$110=4000.000 (X-axis maximum rate, mm/min)
$111=4000.000 (Y-axis maximum rate, mm/min)
$112=4000.000 (Z-axis maximum rate, mm/min)
$113=4000.000
$114=1000.000
$115=1000.000
$120=300.000 (X-axis acceleration, mm/sec^2)
$121=300.000 (Y-axis acceleration, mm/sec^2)
$122=300.000 (Z-axis acceleration, mm/sec^2)
$123=300.000
$124=200.000
$125=200.000
$130=740.000 (X-axis maximum travel, millimeters)
$131=740.000 (Y-axis maximum travel, millimeters)
$132=80.000 (Z-axis maximum travel, millimeters)
$133=740.000
$134=740.000
$135=740.000
ok
client> $X
[MSG:Caution: Unlocked]
ok
[MSG:Spindle RS485 Unresponsive 10]
feeder> M3 S8000
[MSG:Critical Spindle RS485 did not reach speed 8000. Reported speed is -1 rpm.]
ok
ALARM:10
Grbl 1.3a ['$' for help]
[MSG:'$H'|'$X' to unlock]
>

I have grounded the RS485 cable with the 100ohm resistors as stated in other fixes, and it is also grounded from the wire shielding. I tried a twisted pair of shielded Cat6 and that did not work either in the same setup. I have attached photos of the resistor and wiring setup. I have tried this with the debug and standrad firmware. Same issue either way also. I have also attached my VFD and CNC Settings in a Google Doc so I didn't make this message a mile long.

Thank you for any assistance, I am pulling my hair our for a few weeks now :)

- Paul

[CNC Settings.xlsx](https://github.com/Spark-Concepts/xPro-V5/files/11199049/CNC.Settings.xlsx)
[VFD Controller.xlsx](https://github.com/Spark-Concepts/xPro-V5/files/11199050/VFD.Controller.xlsx)
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

Volks1, 2023-04-11:
Hello,

It is a 2.2kw water cooled spindle. Min speed is 8000, or so it stated to set the spindle speed too.

Okay, I am open to trying any software to get some success. However why would one program make it work vs another if it wont turn on to begin with with the M3 command?

Volks1, 2023-04-11:
Okay I have the machine set up with CNC3D Commander. Very cool program, will definitely be using it going forward.

Have uploaded the queen bee settings from thiprogram, and motion is fine but again the spindle does not turn on with any commands. Using the program on function and also sending an M3 code

spydercnc, 2023-04-11:
Have you changed the settings on the VFD to control it other than the controls on the VFD itself. There are a few lines of coding that need to be altered.

Volks1, 2023-04-11:
I have attached my VFD settings in an excel sheet in the original post

audiopavillon, 2023-04-17:
Hi Volks1

I think you must set the VI / VR VFD Jumper to VI !

Vi / VR Jumper is here
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

audiopavillon, 2023-04-17:
>  Would this be a noise issue then?

It seems so, try to keep the RS485 cable as far as possible from the spindle cable.

Thread 213 (2023-06-01):

RS485 Undefined - Spindle errors

johnhaytko, 2023-06-01:
This is typically a noise issue generated by the VFD:
- Ensure RS485 wiring is less than 1 meter in length, twisted, and connected properly (resistors are likely needed in your case)
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

In cases where VFD noise is particularly severe (typically only encountered with VFD's on 220V mains); you may need to install an RS485 isolator - see https://github.com/Spark-Concepts/xPro-V5/issues/164#issuecomment-1219037733
   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

_Originally posted by @Spark-Concepts in https://github.com/Spark-Concepts/xPro-V5/issues/193#issuecomment-1324432964_

johnhaytko, 2023-06-16:
I finally got the RS485 isolator installed. Issue is resolved. I
believe the integrators and resellers of these systems need to just ship
this $15.00 part with the product. The amount of time and aggravation with
this issue is ludicris.

<https://www.avast.com/sig-email?utm_medium=email&utm_source=link&utm_campaign=sig-email&utm_content=webmail>
Virus-free.www.avast.com
<https://www.avast.com/sig-email?utm_medium=email&utm_source=link&utm_campaign=sig-email&utm_content=webmail>
<#DAB4FAD8-2DD7-40BB-A1B8-4E2AA1F9FDF2>

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

Crypton10, 2024-10-16:
> I finally got the RS485 isolator installed. Issue is resolved. I believe the integrators and resellers of these systems need to just ship this $15.00 part with the product. The amount of time and aggravation with this issue is ludicris. <https://www.avast.com/sig-email?utm_medium=email&utm_source=link&utm_campaign=sig-email&utm_content=webmail> Virus-free.[www.avast.com](http://www.avast.com) <https://www.avast.com/sig-email?utm_medium=email&utm_source=link&utm_campaign=sig-email&utm_content=webmail> <#DAB4FAD8-2DD7-40BB-A1B8-4E2AA1F9FDF2>
> […](#)
> On Tue, Jun 13, 2023 at 8:40 AM kmtaylor ***@***.***> wrote: If you're running FluidNC - the RS485 pin descriptions are backwards in the example config.yaml file. If you're running the previous firmware then it will be something else. — Reply to this email directly, view it on GitHub <[#213 (comment)](https://github.com/Spark-Concepts/xPro-V5/issues/213#issuecomment-1589231187)>, or unsubscribe <https://github.com/notifications/unsubscribe-auth/BAIDHLEN3XRS4L7CA3XE2U3XLBNSHANCNFSM6AAAAAAYXQ3QXA> . You are receiving this because you authored the thread.Message ID: ***@***.***>

Its a disgrace so many people having this issue Im still fighting with mine and cant get it to work . Sparks Concepts refuses to offer any support its been days since i contacted them with no answer. I have heard this from others it seems they no longer support this product . No one should buy this controller moving forward

Thread 223 (2023-07-12):

Limit switches and vfd

Tpaulachak, 2023-07-12:
Hello I'm new to cnc and am having issues with the final stages. I have a 2.2kw vfd connected ro 220 outlet. The xpro is on 110.

The rs485 blinks red all the time connected or not. The vfd functions on its own to control the spindle but after switching it to be controlled via rs485 it doesn't do anything.

The limit switches are another headache. I have a green light when I have the switches connected. Pressing manually does nothing unless only one switch is installed the. The light blinks but the cmd window doesn't report anything happening. When I go to the web ui it's a long log of alarm for the limit switches and still doesn't register that I'm clicking.

Homing does not work either if a switch is connected. Cncjs says alarm 10 and the web ui says alarm 8.

Please let me know what information you need from me so we can figure this out. Thanks

Tpaulachak, 2023-07-13:
Update.
Turns out one of the switches was bad so that's working now.

I swapped rs485 wiring with a twisted cable and went a to rs- and b to rs+. Now I get a solid green light. Still doesn't work.

Tpaulachak, 2023-07-17:
Another update.
Wired the xpros psu to the same 220 circuit. No change.

Installed 100 ohm resistors. The light blinks red

Installed the rs485 isolator. Light is solid green. Tried swapping a and b like one person said that made the lights blink red.

I'm really starting to regret choosing this controller.

Thread 227 (2023-07-28):

I face a problem in the x axis path

ghalib1399, 2023-07-28:
Hi All
When using the CNC machine, I face a problem in the x axis path, when the machine start to move, the machine gets stuck (freeze) for few seconds or less then continues the path, this freezing changes the x axis path and therefor the work is wrong. This problem always occurs in the x axis but sometime in the y axis as well. What is the solution ?

*QueenBee PRO
*CNC xPRO v5

https://github.com/Spark-Concepts/xPro-V5/assets/98682791/c0b2c191-357d-4b4e-912d-f23425da42fd

spydercnc, 2023-07-28:
Slow the feed down.
Make sure the machine is square and parallel. I actually had the two Y-axis about 10mm out of alignment and it solved my issue.
Remove the VFD wires from the drag chain, as it causes issues.
Make sure that the extractor is earthed.
Put Ferrite chokes on everything to prevent RFI (interference)

ghalib1399, 2023-07-28:
>

Can you explain what you mean by (put Ferrite chokes on everything to prevent RFI) everything= every wire?X,Y,Z ....

spydercnc, 2023-07-28:
All the power wires mainly, including the VFD, main incoming power cable, extractor, coolant pump etc.

ghalib1399, 2023-07-29:
Thank you for your help
I think I found the problem ! LeadScrews was loosen so I tighten it then the freezing gone

ghalib1399, 2023-07-31:
the problem not from LeadScrews :(

Thread 234 (2024-10-16):

What a huge mistake buying a XproV5

Crypton10, 2024-10-16:
Has numerous issues, and company no longer supports it. Anyone looking to buy this garbage please beware. first problem tickets sent in 4 days ago then sent another 2 days ago with no answer

spydercnc, 2024-10-16:
Join CNC Commander on FB. their software supports the Xpro.

Crypton10, 2024-10-16:
I have been getting some help from CNC commander they are great people and i am using their software but the xprov5 will not control the spindle and Im pretty sure its a hardware issue since i tried both rs485 and running with the 10v connection, Ill get the multi meter on it and see what the v5 is actually producing

Spark-Concepts, 2024-10-16:
Hi Crypton10,

Thank you for reaching out, and we apologize for the frustration you’ve experienced. Please note that all customer support issues have been moved to a dedicated platform, which you can access here: [spark-concepts.com/xpro-support](https://www.spark-concepts.com/xpro-support/) or at [ x-solutions.net](https://x-solutions.net/).

Unfortunately, the issues posted on GitHub are no longer actively monitored and are kept for informational purposes only.
You can also view your current tickets by navigating to [MakerStore.help](https://www.makerstore.help/) and entering your email address. This will give you access to your past inquiries and responses from our dedicated support team.

Additionally, you can find the support link on our main website: https://www.spark-concepts.com/.

We encourage you to submit your support request through the provided link so we can assist you directly and resolve any issues you’re facing as quickly as possible.

Thank you for your understanding,
Bill
Spark Concepts Support Team

Crypton10, 2024-10-17:
Hi Bill thank you and Tawanda for the reply its very much appreciated ,I finally got the xprov5 to turn the spindle on in the software using the 10v instructions you provided only problem I seem to be having is its not recognising any of my speed input controls so when I start it up even though I have speed set at 8000 it ramps up to 24000 and it will not go down with any commands but I can turn it off, I checked the Voltage at the 10 v with the potentiometer  and Im only getting 1v dc on my multimeter Im using a fluke so I know its pretty accurate. Not sure if thats part of the problem ? All my cables are sheilded , sheild drained and grounded I also have ferrite on both ends of each cable to minimise any EMI just fopr reference
Anthony Magrini
    On Wednesday, October 16, 2024 at 06:11:02 PM CDT, Spark ***@***.***> wrote:

Hi Crypton10,

Thank you for reaching out, and we apologize for the frustration you’ve experienced. Please note that all customer support issues have been moved to a dedicated platform, which you can access here: spark-concepts.com/xpro-support or at  x-solutions.net.

Unfortunately, the issues posted on GitHub are no longer actively monitored and are kept for informational purposes only.
You can also view your current tickets by navigating to MakerStore.help and entering your email address. This will give you access to your past inquiries and responses from our dedicated support team.

Additionally, you can find the support link on our main website: https://www.spark-concepts.com/.

We encourage you to submit your support request through the provided link so we can assist you directly and resolve any issues you’re facing as quickly as possible.

Thank you for your understanding,
Bill
Spark Concepts Support Team

—
Reply to this email directly, view it on GitHub, or unsubscribe.
You are receiving this because you authored the thread.Message ID: ***@***.***>
