Spark-Concepts/xPro-V5/(commit log)

2020-10-07 Adding PSU setting
    PSU input voltage selection
2020-10-10 Firmware 1.3a2
    Defaults homing cycle to Z, then X and Y combined.
2021-03-31 Add files via upload
    The precompiled firmware is named to clearly identify specific compile time options.
    The format is "CNC_xPRO_V5_MotorAssignment_SpindleType_DoorSwitchType"
    -For MotorAssignment, the options are XYYZ (3 axis, ganged Y) and XYAZ (4 axis)
    -For SpindleType, the options are PWM which allows for 0-5V or 0-10V spindle (or laser) and 485 allows for the use of an RS485 enabled VFD (only available for HY series VFDs).
    -Lastly, DoorSwitchType controls whether or not the door/Estop switch is Normally Open (NO), or Normally Closed (NC). NOTE: selecting NC requires a Normally Closed switch to be attached at all times or the system will not run. **note: selecting NO a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
2021-04-05 Limit switch
    Updated images
2021-04-16 Delete SpindlePWM_1.jpg
    s
2021-08-11 Add files via upload
    New firmware binaries - allows for change between Laser, PWM, and RS485 spindles without loading new firmware using "$Spindle/Type = ***" setting. Opened door/estop switch will now allow entrance into the WebUI but display DOOR:1 error, locking the system until the door switch is corrected and the controller reset. Addressed a few minor bugs as well. Includes specialized firmware for the BM3D lasers - CNC_xPRO_V5_XYYZ_BM3D_NC.bin (normally closed door switch), and CNC_xPRO_V5_XYYZ_BM3D_NO.bin (normally open, or no door switch).
2021-09-16 Add files via upload
    Release Note:
    1) Additional tuning to decrease Idle stepper noise
    2) Implementation of the Macro1 and Macro2 buttons - store commands using the $User/Macro1=xxx settings, separate lines of gcode with '&' character. Requires NO switch.
    3) Minor bug fixes
2021-09-16 Add files via upload
    New Index.html.gz:
    1) added useful buttons to the jog panel
    2) better formatting for mobile device
2022-05-22 Add files via upload
    add 120ohm termination resistors
2022-05-22 Add files via upload
    added termination resistors
2022-06-27 Add files via upload
    minor bug fixes and motor/current tuning
2023-08-18 Update config.yaml to correct Huanyang spindle config
    Corrected tx pin to be 4, rx pin to be 25, (they were opposite and incorrect). Also corrected overall config adding uart1 as stand alone along with Huanyang and uart_num: 1 which was missing. Please note, the data between the comments labeled start and end is what you need for this to run on XPro V5.
    [config.yaml]
